Maeswoon/UNHSEDS/Engineering/2020-2021_PHANTOM/Propulsion/Banshee V1/simulation_results.JPG

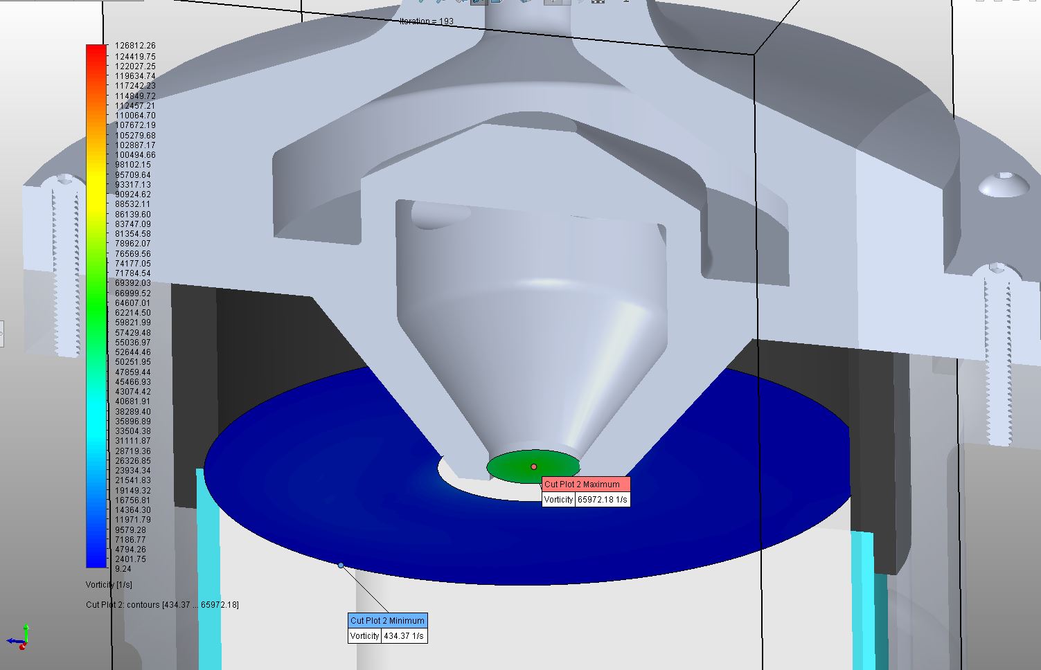
Engineering/2020-2021_PHANTOM/Propulsion/Banshee V1/simulation_results.JPG
