Maeswoon/UNHSEDS/Engineering/2019-2020_USURPER/Avionics/Board Files/Electronics Parts Render-00.JPG

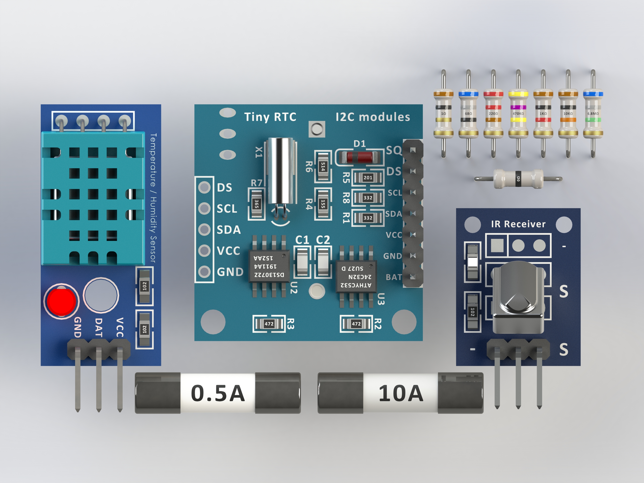
Engineering/2019-2020_USURPER/Avionics/Board Files/Electronics Parts Render-00.JPG
