Maeswoon/UNHSEDS/Engineering/2022-2023 Rocket/Avionics/README.md

# Avionics TODO (version-to-version)

- More robust connectors
- Eliminate buck converter / diagnose ramp-up issue
- Add buzzer
- Ground connection for arming switch
- Reverse-voltage protection on pyros
- Integrated pyro resistors
- Neater PCB layout
