Maeswoon/UNHSEDS/Reports and Presentations/Presentations/2019-2020/Workshops/Welding.pptx

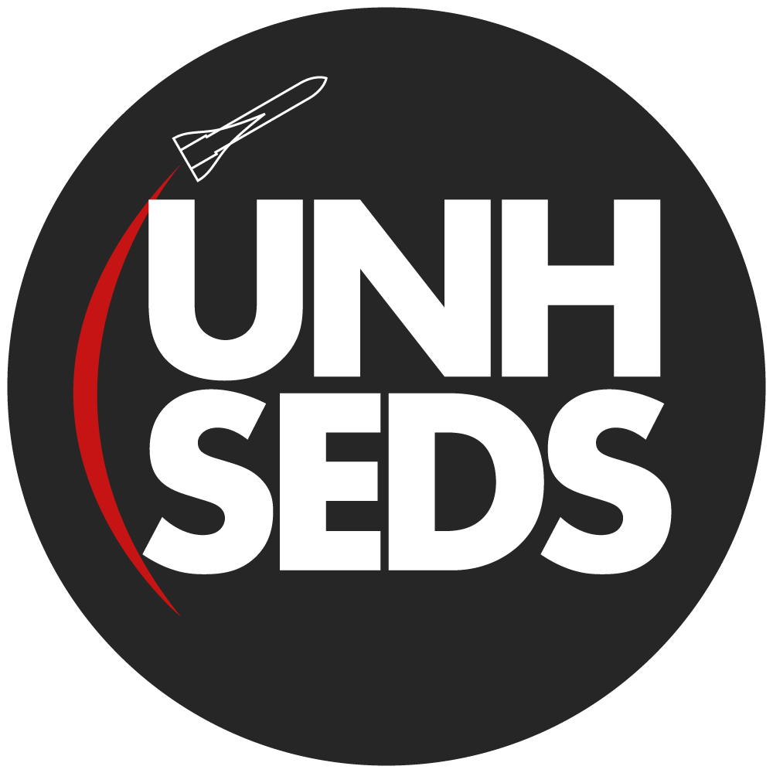
[picture p4: figure]

CEPS Engineering Organization
Welding

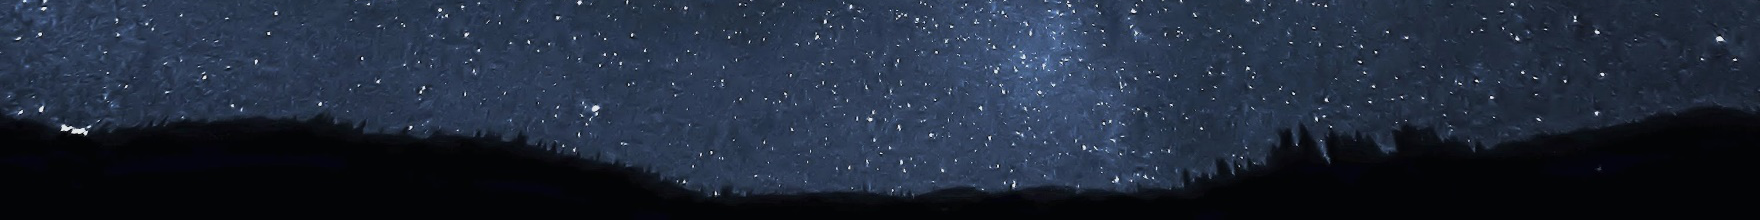
[picture p5: figure]
Image result for starry night background

University of New Hampshire
Students for the Exploration and Development of Space

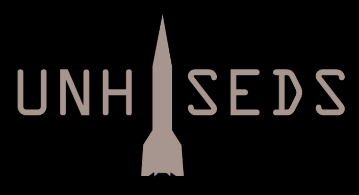
[picture p6: figure]
