Maeswoon/UNHSEDS/Reports and Presentations/Presentations/2019-2020/Intro Meeting/ME 441 Presentation.pptx

## UNH SEDS

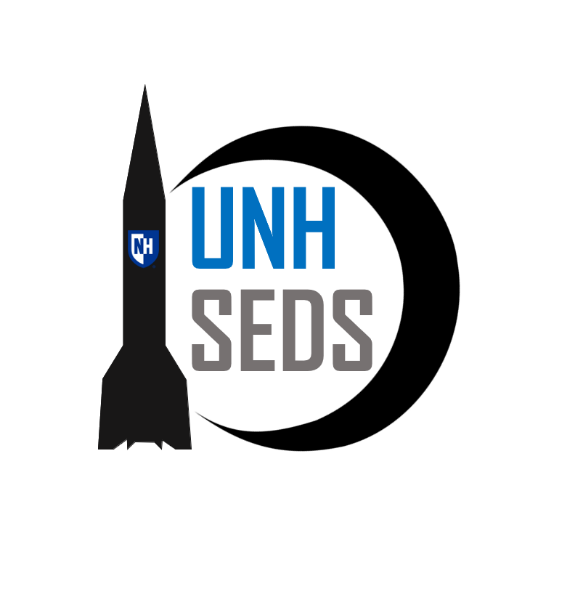
[picture p7: figure]

CEPS Engineering Organization
High Power Rocketry

University of New Hampshire
Students for the Exploration and Development of Space

## Slide 2

The Three Year Plan

Year One
2017-2018

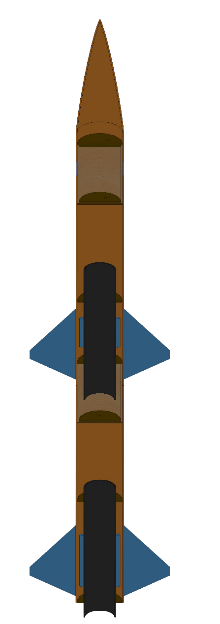
[picture p8: figure]

Hybrid Engine
Design
Manufacture
Test

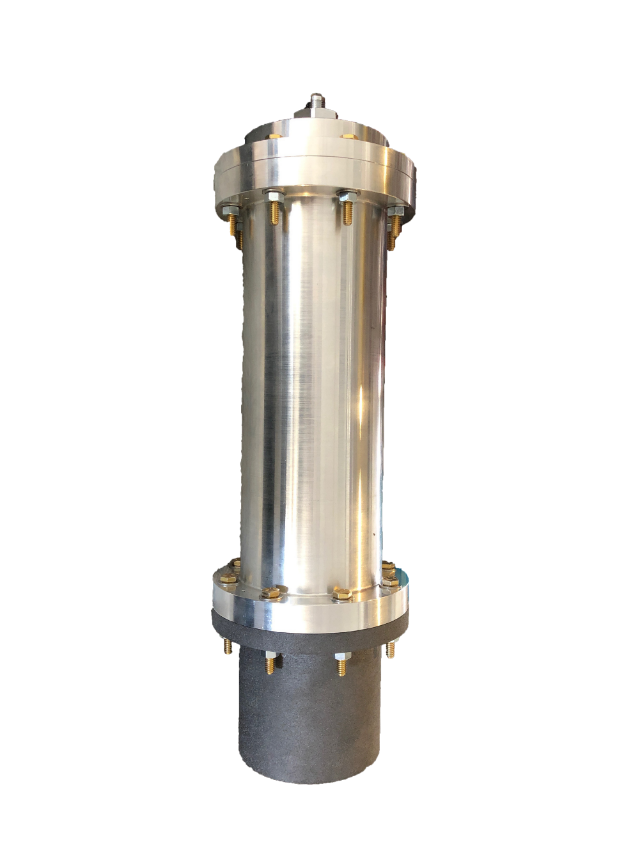
[picture p9: figure]

Runaway

Year Two

Year Three

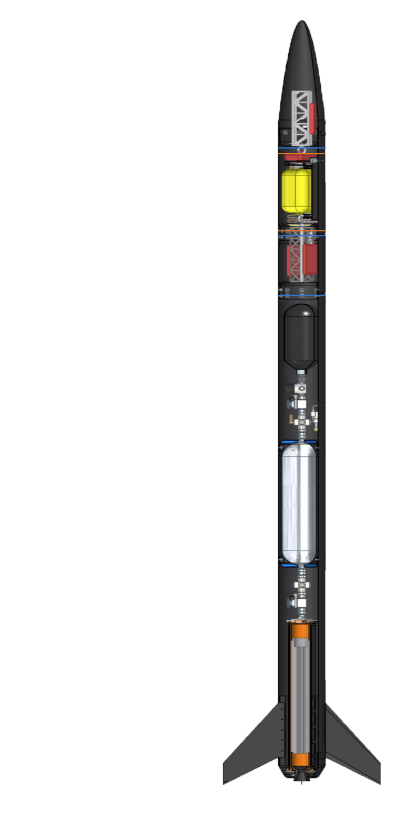
[picture p10: figure]

Rocket Building
Simulating
Launching
Optimizing

Hybrid Rocket
Engine Optimization
Rocket Integration
Competition

University of New Hampshire
Students for the Exploration and Development of Space

## Propulsion Team

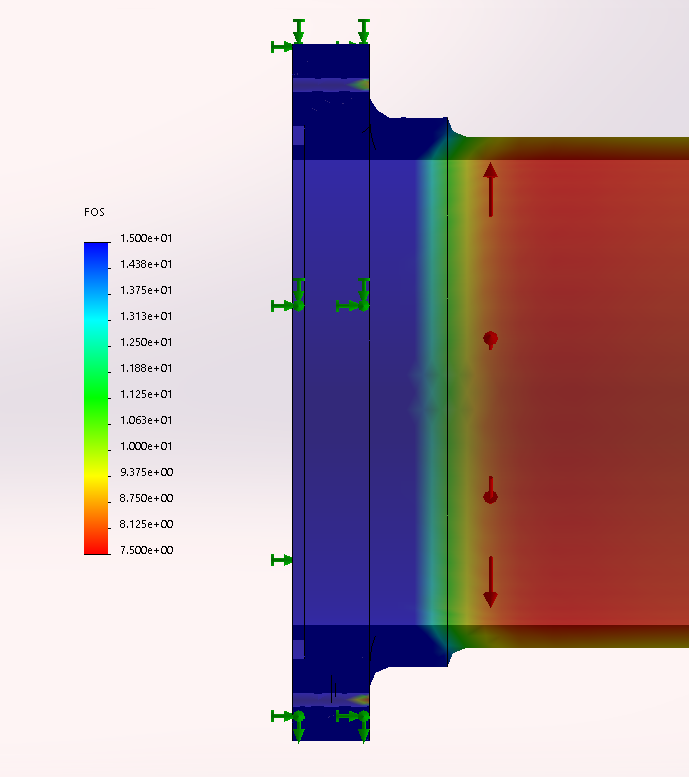
[picture p11: figure]
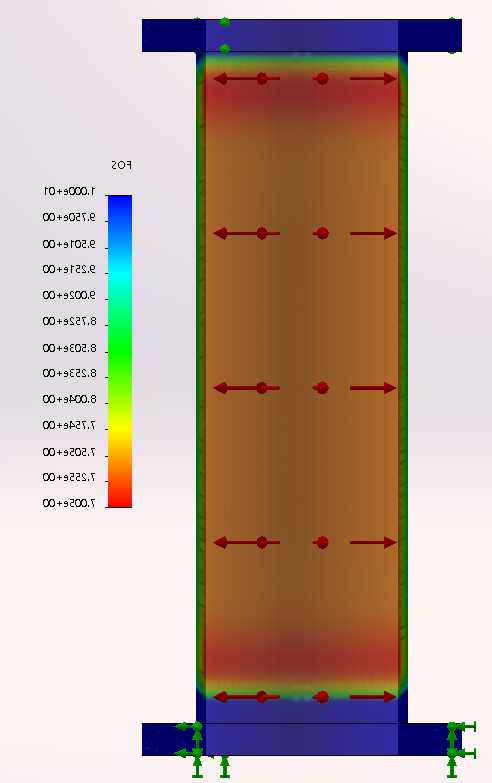
[picture p12: figure]

University of New Hampshire
Students for the Exploration and Development of Space

## Slide 4

Frame Team

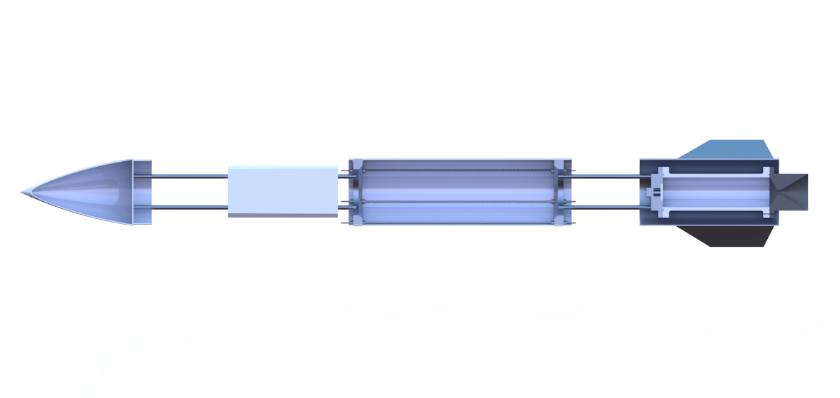
[picture p13: figure]
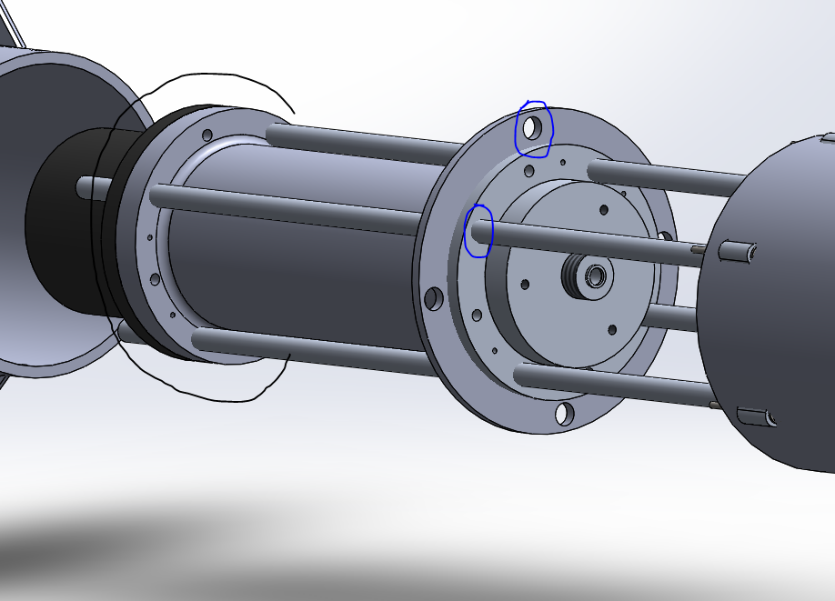
[picture p14: figure]
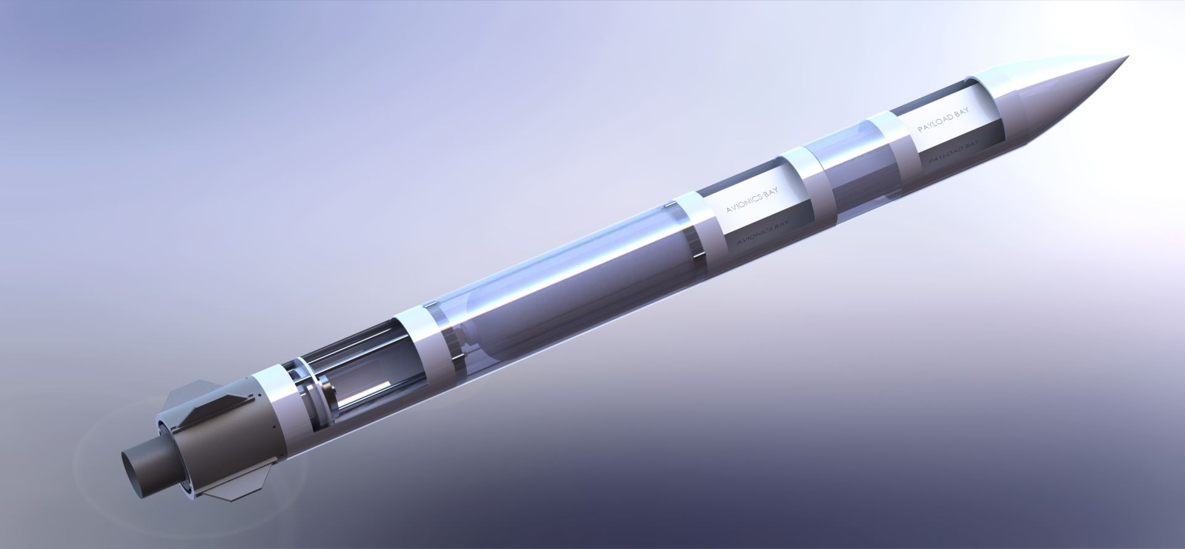
[picture p15: figure]

University of New Hampshire
Students for the Exploration and Development of Space

## Slide 5

Operations Team

- In charge of all Spaceport coordination and requirements
- Engineering integration and systems engineering
- Responsible for coordinating tests
- Safety
- Aid in all engineering-related activities

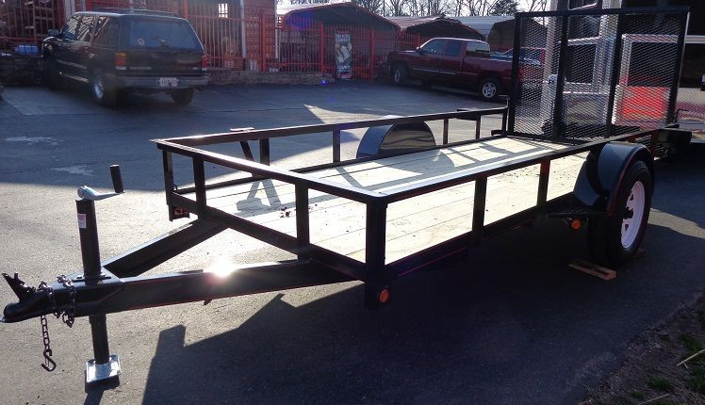
[picture p16: figure]
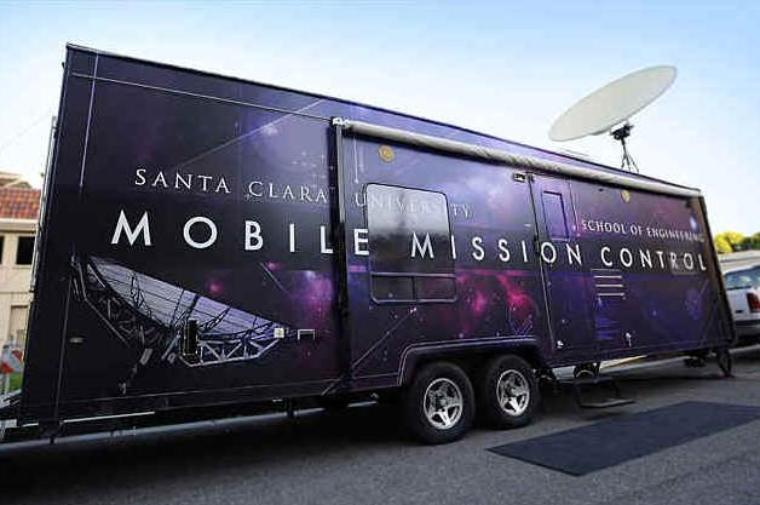
[picture p17: figure]
Image result for mobile mission control

University of New Hampshire
Students for the Exploration and Development of Space

## Slide 6

How Can You Help?

- Looking for students who’d be willing to help with CAD modeling of rocket components in frame, propulsion, and other needs that come up.
- Students interested in learning SolidWorks CAD, FEA, and FlowSimulation
- Integrate into one of our teams, given a modeling project to complete and aid our senior project.
- Good experience to integrate into a team as a freshman.
- If interested, contact me at sgj1001@wildcats.unh.edu (Silas Johnson – Mechanical Engineering Project Manager)

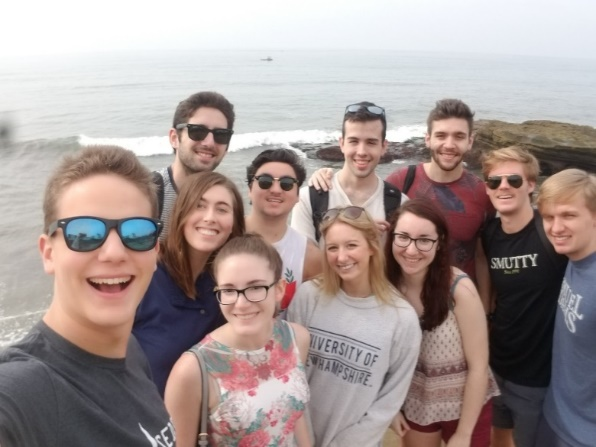
[picture p18: figure]
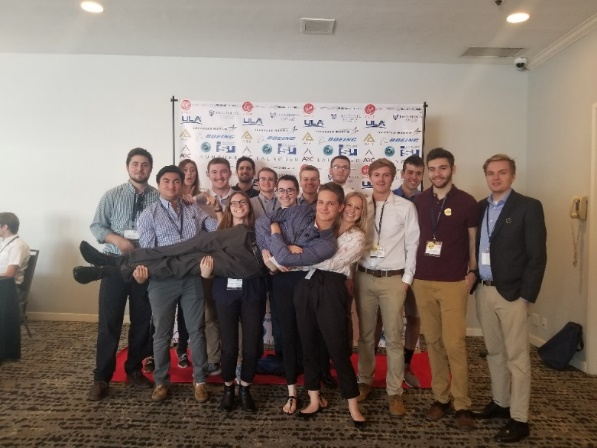
[picture p19: figure]
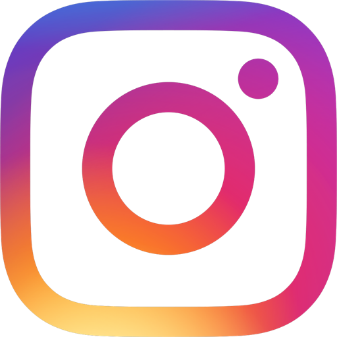
[picture p20: figure]
Image result for instagram

@unhseds

University of New Hampshire
Students for the Exploration and Development of Space

Notes: EE major too
