Maeswoon/UNHSEDS/Business/Organization/Book Club/Book Club Schedule.docx

UNH SEDS Book Club – Spring 2020

# Books to Read

1. Rocket Manual for Amateurs, 1960
2. Handbook of Model Rocketry, 1965
3. Make: High-Power Rockets, 2017

# Rocket Manual for Amateurs

Including 10 chapters, this book will take 5 weeks to read. The breakdown of chapters each week to read and be analyzed is below.

1. Chapters 1 and 2
2. Chapters 3 and 4
3. Chapters 5 and 6
4. Chapters 7 and 8
5. Chapters 9 and 10

The meeting for each week will be around 1 hour and discuss the pages thoroughly. It is expected to take notes on the pages in order to contribute to the club discussion, as it is not supposed to be a lecture.
