Maeswoon/UNHSEDS/Engineering/2019-2020_USURPER/Engineering Management/Engineer of the Week/Engineers Spring 2020.pptx

UNH SEDS

The Hungriest Engineers

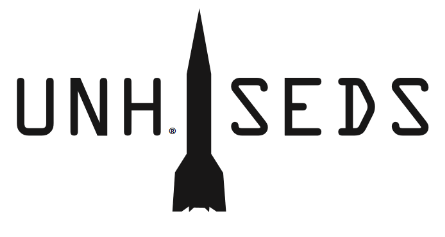
[picture p27: figure]
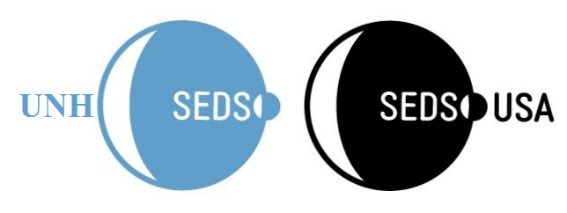
[picture p28: figure]

Spring 2020 [February]

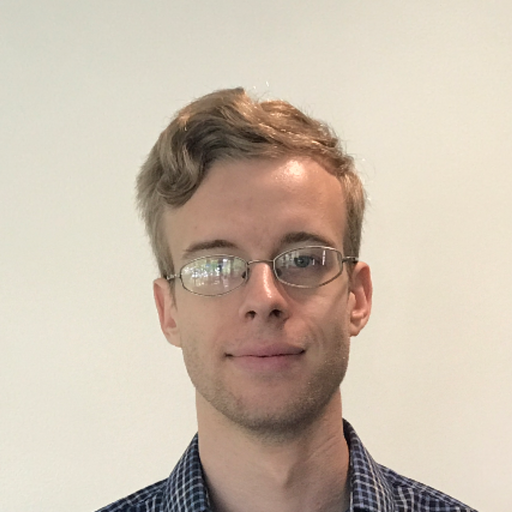
[picture p29: figure]
Profile photo for Cornelis

Cornelis Plomp

As part of the Frame team, Cornelis has done incredible and thorough work on the rocket frame. Ensuring that each of his parts is tested and proven through calculations and SOLIDWORK FEA.

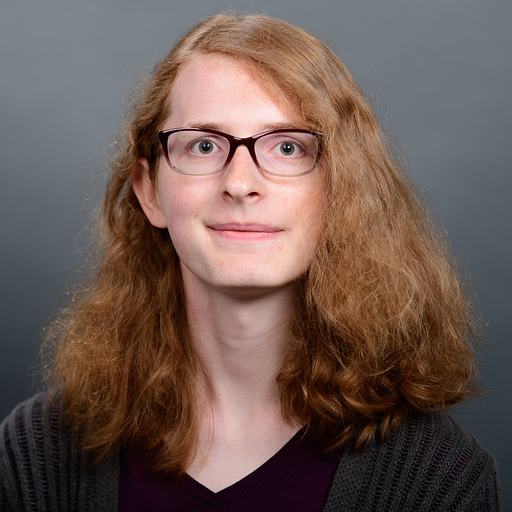
[picture p30: figure]
Profile photo for Alice Wade

Alice Wade

Alice has been a superstar since the first day that she joined SEDS. Her dedication to Frame, Finance, and the organization has been outstanding. Check out our amazing website https://unhseds.org/ curtesy of this hungry engineer!

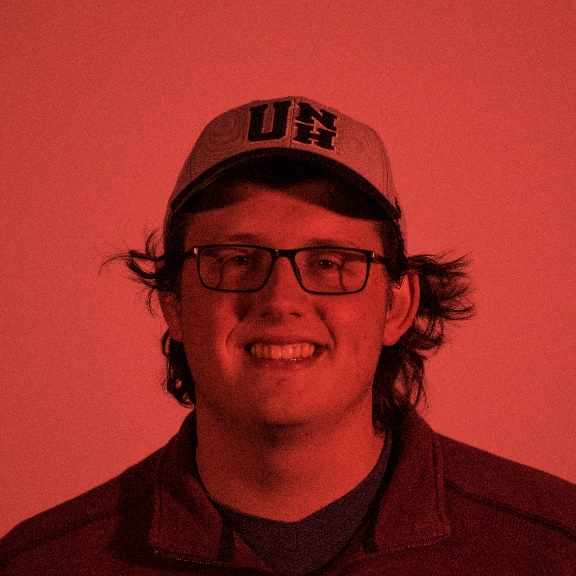
[picture p31: figure]

Jacob Harrison

As part of the Avionics team, Jacob has worked like crazy to put together our launch and control box. Writing code and testing, Jacob has been key to the first cold fire test and all our Raspberry pi projects.
