Maeswoon/UNHSEDS/Business/Organization/Official Documents/UNH SEDS/Internal Leadership Documents/Engineering Leadership/2019-2020/Engineering Leadership.pptx

## Engineering goals 2019-2020

An optimized and certified Hybrid Rocket Engine

UNH SEDS

A test-proven rocket engine gimbal system (2 year plan)

A seamless propulsion assembly with autonomous, real-time control (2021)

A well-designed and safe testing site for all operations

New Hampshire’s first Hybrid Rocket

An optimized, beautifully integrated tested rocket frame

A beautiful, yet amazingly complex flight computer system

A complete navigation, control and recovery rocket electrical system

A ROBUST payload ejection and flight recovery system

Propulsion

Frame

Avionics

Operations

## Engineering SECTION GOALS 2019-2020 Senior Design

Charlie Nitschelm

Lead Engineer

UNH SEDS

Zach Raboin

VP Propulsion

Thomas Collins

VP Frame

1. Work with every engineering team to design the best rocket frame and internal structures needed for flight including the propulsion, avionics, recovery and payload modules.
2. Manufacture the components with a well-thought out integration system for all systems with live debugging on the field ability.

Lucas Simmonds

VP Avionics

Silas Johnson

VP Operations

1. Communicate with all teams above to design, manufacture and build test equipment, procedures and plans for all testing being done.
2. Lead the project to secure an area for SEDS to base all testing on, including the development of the mobile mission control bunker.
3. Lead major sub-projects as they arise.

1. Develop, test and optimize a working Hybrid Rocket Engine, Runaway.
  a. Manufacture, test and optimize and repeat
2. Develop and test a small-scale thrust vectoring system with COTS engines
  a. Flight test with a stable rocket, unstable rocket, and a quadcopter drop test mid-air, and landing attempts.
  b. Develop, manufacture and test a hybrid gimbal system to integrate with Runaway (2 year program)

1. Develop the electrical system to power the navigation and control of the rocket.
  a. Will work closely with the gimbal project
2. Ensure that the rocket has optimum performance during testing and launch (pulling one ‘Remove Before Flight’ and turning all systems on in the rocket.
3. Design, build and test a payload to conduct scientific research (this is totally open)
4. Create a full-proof recovery system for apogee for the payload deployment and main rocket recovery.

Propulsion

Frame

Avionics

Operations

## Engineering roles 2019-2020 Senior Design 7 ME, 4 EE, 2 CS, 1 PE

Charlie Nitschelm

Lead Engineer, ME

UNH SEDS

Zach Raboin

VP Propulsion, ME

Thomas Collins

VP Frame, PE

Lucas Simmonds

VP Avionics, ME

Silas Johnson

VP Operations, ME

Andrew Masters

TVC Lead, ME, Not SP

Charlie Nitschelm

ME

Darren Otten

ME

Ben Letourneau

EE

Francesco Mikulis

CS

Silas Johnson

ME

Nathan Gunter

ME

Tom Pham

EE

Kristian Comer

CS

Megan Johnson

EE

Trevor Blampied

EE

Carly Benik

ME

Propulsion

Frame

Avionics

Operations

## Engineering roles 2019-2020

Charlie Nitschelm

Lead Engineer, ME

UNH SEDS

Charlie Nitschelm

VP Propulsion, Sr ME

Thomas Collins

VP Frame, Sr PE

Lucas Simmonds

VP Avionics, Sr ME

Silas Johnson

VP Operations, Sr ME

Andrew Masters

TVC Lead, Sr ME

Zach Raboin

Senior ME

Darren Otten

Senior ME

Ben Letourneau

Senior EE

Carly Benik

Senior ME

Francesco Mikulis

Senior CS

Ross Thyne

Senior ME

Nathan Gunter

Senior ME

Tom Pham

Senior EE

Jeffrey Grant

Freshman ME

Kristian Comer

Senior CS

Grace Johnston

Junior ME

Sohani Demian

Junior ME

Megan Johnson

Senior EE

Gabe Hannon

Freshman Math

Jake Raum

Freshman CS

Devony Whiting

Junior ME

Alice Wade

Freshman ME

Trevor Blampied

Senior EE

Hunter Sansoucie

Freshman ME

Jared Larivere

Freshman ME

Derek Goulet

Sophomore ME

Max Carpenter

Freshman ME

Matt Dodge

Junior EE

Emilie Leavitt

Freshman CE

Jessica Roberts

Freshman Physics

Elena Chan

Freshman ME

Will Macdonald

Freshman ME

Dylan Parmentier

Freshman PE

Grant Arnold

Freshman ME

Philip Deo

Freshman EE

Ian Bresnahan

Freshman Math/Chem

Coleman Stoleburg

Freshman EE
