Maeswoon/UNHSEDS/Reports and Presentations/Presentations/2019-2020/SpaceVision Presentation/SpaceVision_Journey_to_Spaceport_America.pdf

# Year 1 – 2017/2018

# Year 2 – 2018/2019

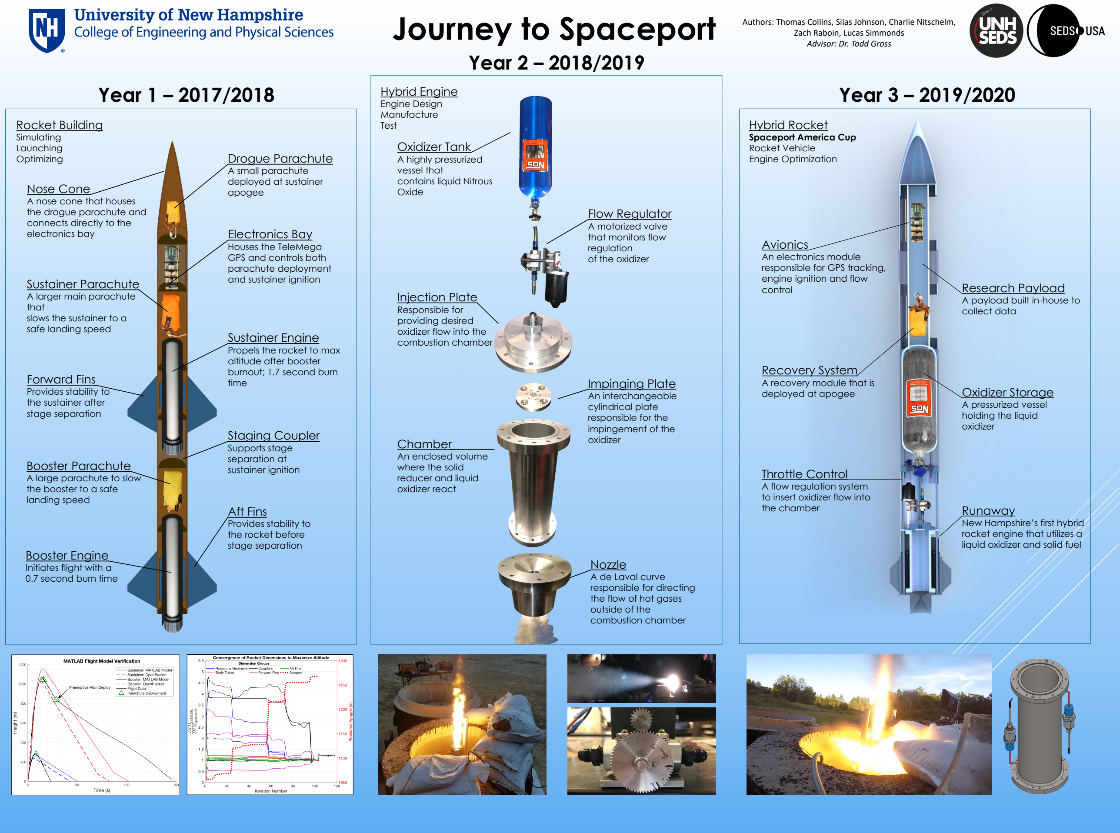
[picture p62: page 1]

Authors: Thomas Collins, Silas Johnson, Charlie Nitschelm, Zach Raboin, Lucas Simmonds Advisor: Dr. Todd Gross

# Year 3 – 2019/2020

# Journey to Spaceport

### Rocket Building

Simulating
Launching
Optimizing

### Hybrid Engine

Engine Design
Manufacture
Test | Hybrid Rocket
| Spaceport America Cup
| Rocket Vehicle
| Engine Optimization

### Oxidizer Tank

A highly pressurized
vessel that
contains liquid Nitrous
Oxide

### Flow Regulator

A motorized valve
that monitors flow
regulation
of the oxidizer

### Injection Plate

Responsible for
providing desired
oxidizer flow into the
combustion chamber

### Chamber

An enclosed volume
where the solid
reducer and liquid
oxidizer react

### Nozzle

A de Laval curve
responsible for directing
the flow of hot gases
outside of the
combustion chamber

### Impinging Plate

An interchangeable
cylindrical plate
responsible for the
impingement of the
oxidizer

### Avionics

An electronics module
responsible for GPS tracking, engine ignition and flow
control

### Recovery System

A recovery module that is
deployed at apogee

### Research Payload

A payload built in-house to collect data

### Throttle Control

A flow regulation system
to insert oxidizer flow into
the chamber | Runaway
| New Hampshire’s first hybrid
| rocket engine that utilizes a
| liquid oxidizer and solid fuel

### Oxidizer Storage

A pressurized vessel
holding the liquid
oxidizer

### Staging Coupler

Supports stage
separation at
sustainer ignition

### Booster Engine

Initiates flight with a
0.7 second burn time

### Drogue Parachute

A small parachute
deployed at sustainer
apogee

### Aft Fins

Provides stability to
the rocket before
stage separation

### Electronics Bay

Houses the TeleMega
GPS and controls both
parachute deployment
and sustainer ignition

### Sustainer Engine

Propels the rocket to max
altitude after booster
burnout; 1.7 second burn
time

### Booster Parachute

A large parachute to slow
the booster to a safe
landing speed

### Forward Fins

Provides stability to
the sustainer after
stage separation

### Sustainer Parachute

A larger main parachute
that
slows the sustainer to a
safe landing speed

### Nose Cone

A nose cone that houses
the drogue parachute and
connects directly to the
electronics bay
