Maeswoon/UNHSEDS/Engineering/2019-2020_USURPER/Payload_Recovery/Parachutes.pdf

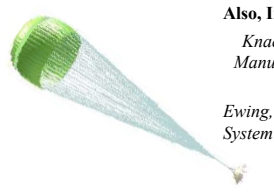
[picture p63: figure]

MAE 5930, Rocket Systems Design

# Recovery Systems: Parachutes 101

## Material taken from: Parachutes for Planetary Entry Systems Juan R. Cruz Exploration Systems Engineering Branch NASA Langley Research Center

Also, Images from:
Knacke, T. W.: Parachute Recovery Systems Design Manual, Para Publishing, Santa Barbara, CA, 1992. and
Ewing, E. G., Bixby, H.W., and Knacke, T.W.: Recovery System Design Guide, AFFDL-TR-78-151, 1978.

1

## Basic Terminology

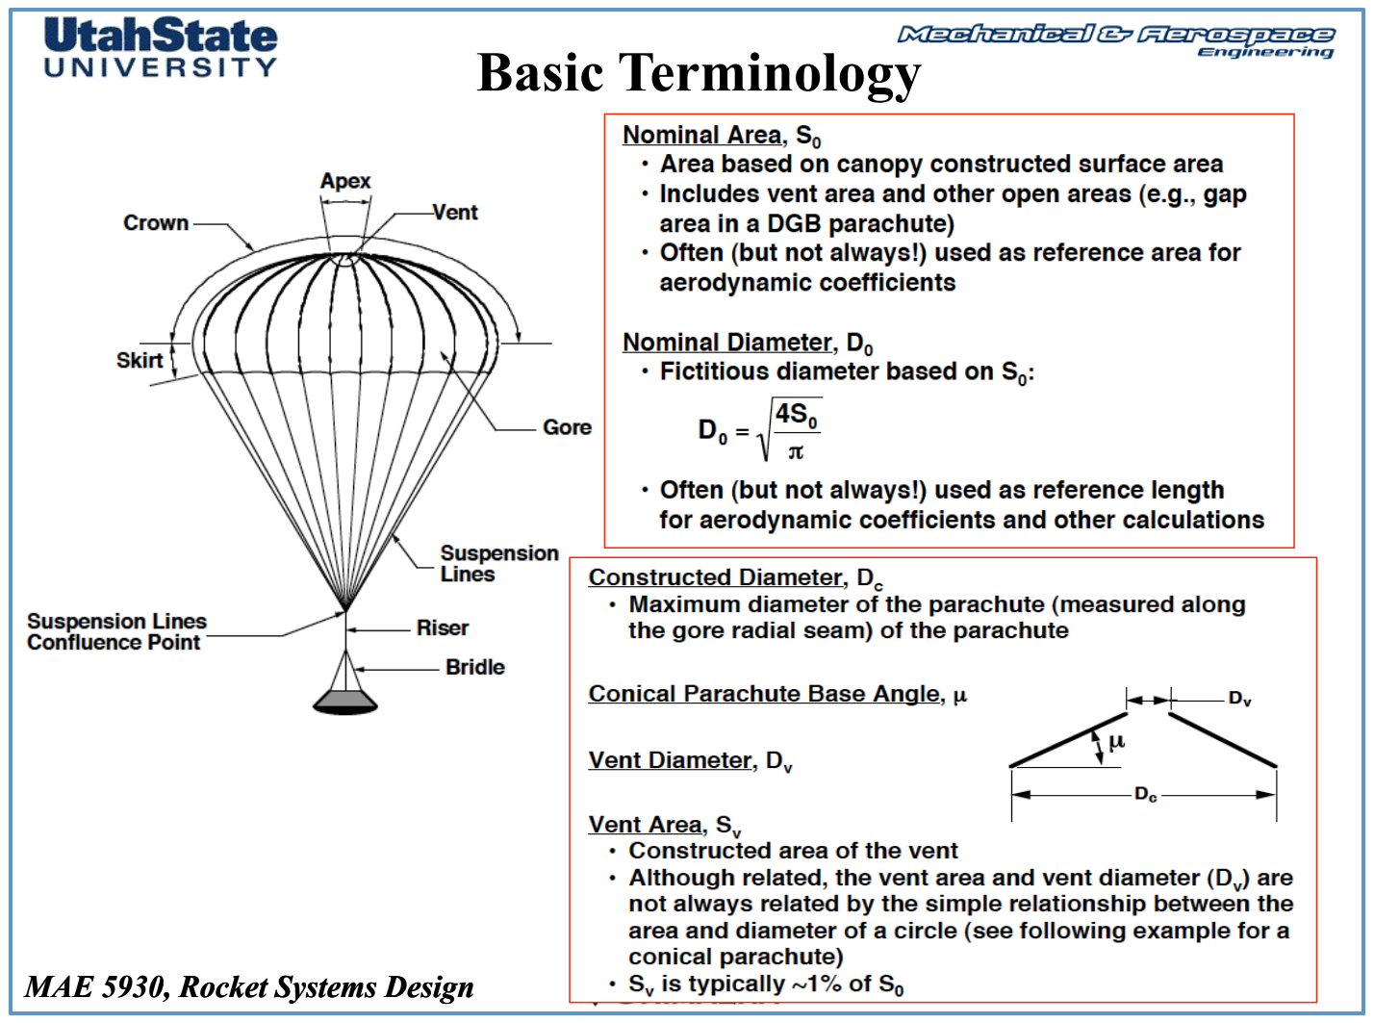
[picture p64: page 2]

MAE 5930, Rocket Systems Design | 2

## Basic Terminology (2)

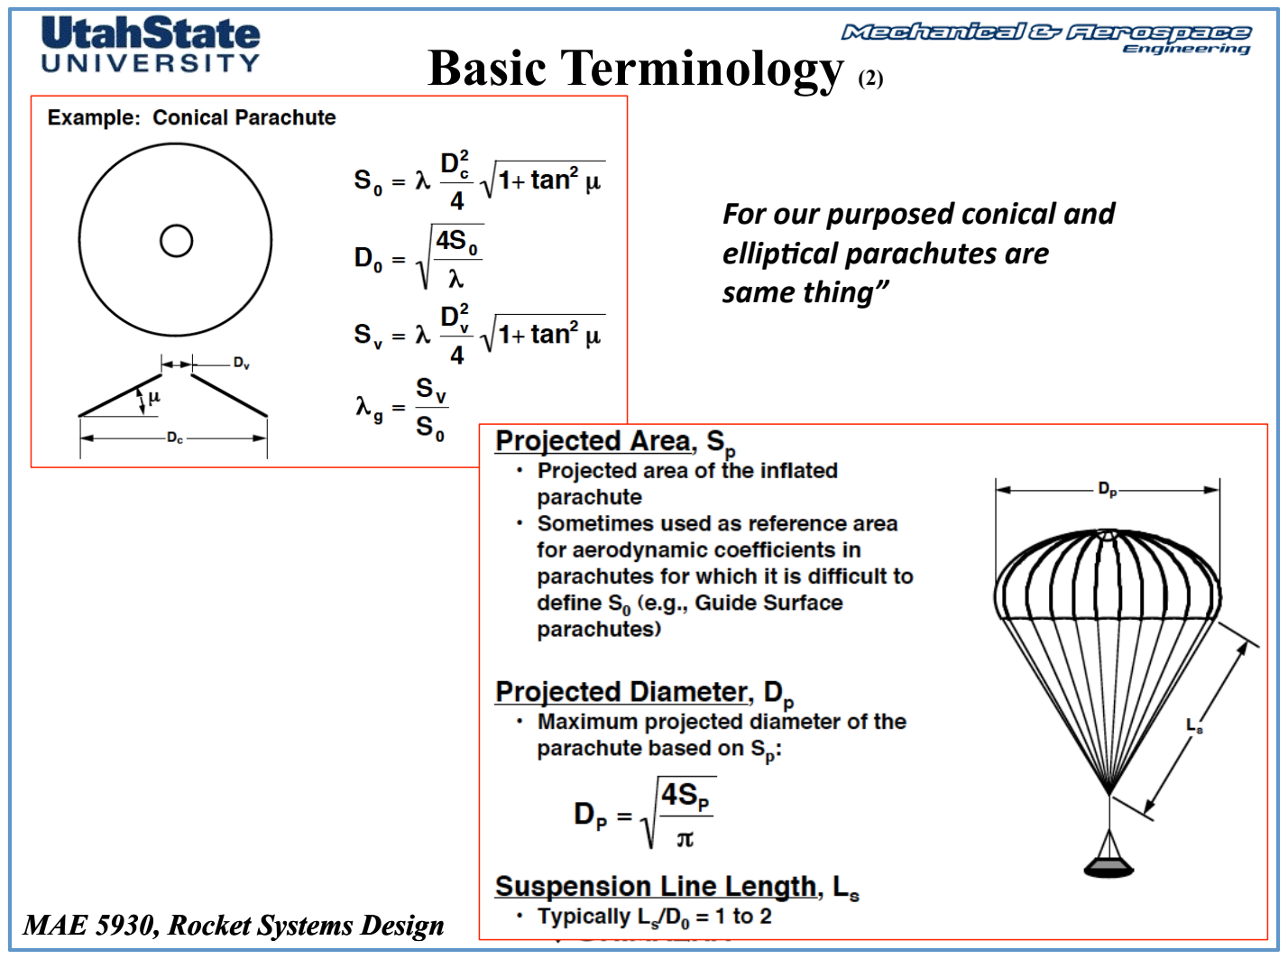
[picture p65: page 3]

MAE 5930, Rocket Systems Design | 3

For

our

purposed

conical

and
ellip/cal

parachutes

are
same

thing”

## Basic Terminology (3)

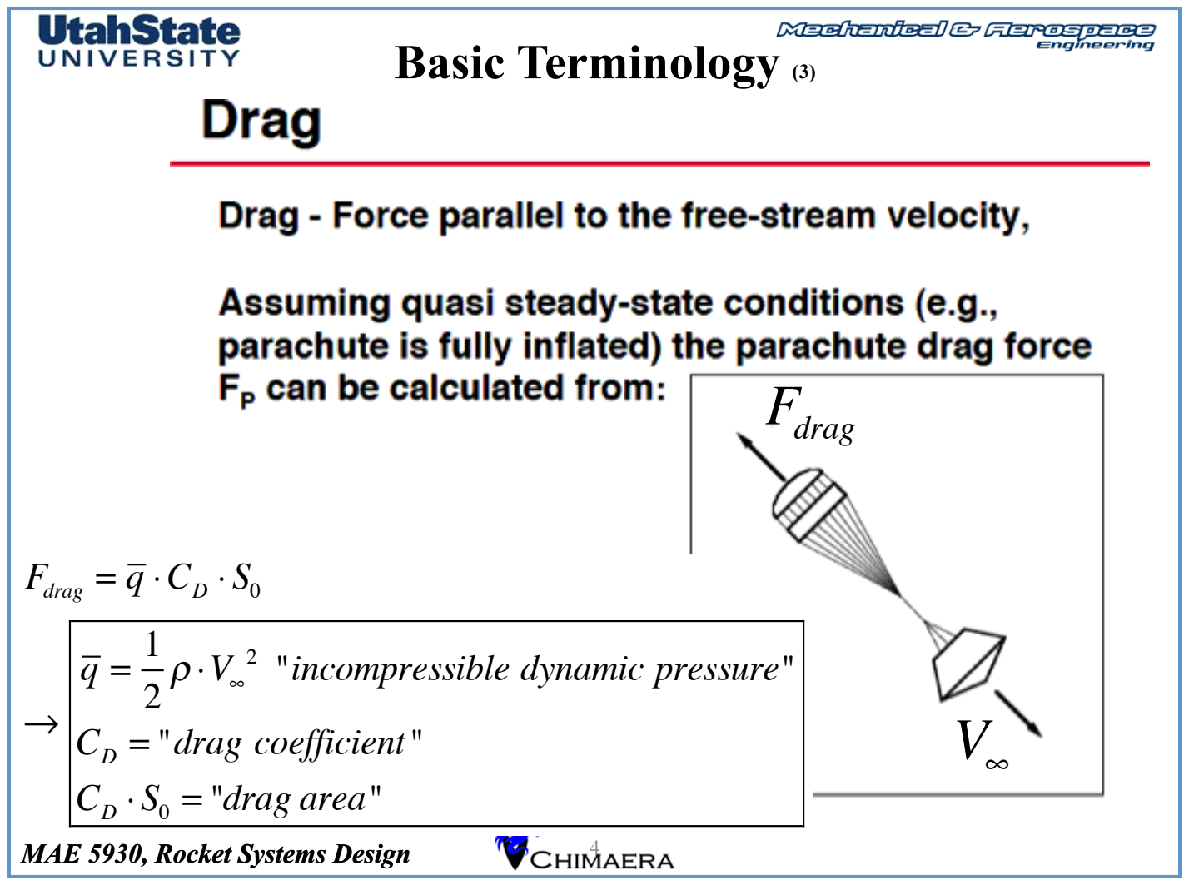
[picture p66: page 4]

MAE 5930, Rocket Systems Design | 4

Fdrag

## = q !CD ! S0

"

q =

1
2

# !V$

2 "incompressible dynamic pressure"

CD

= "drag coefficient "
CD ! S0

= "drag area"

Fdrag

V!

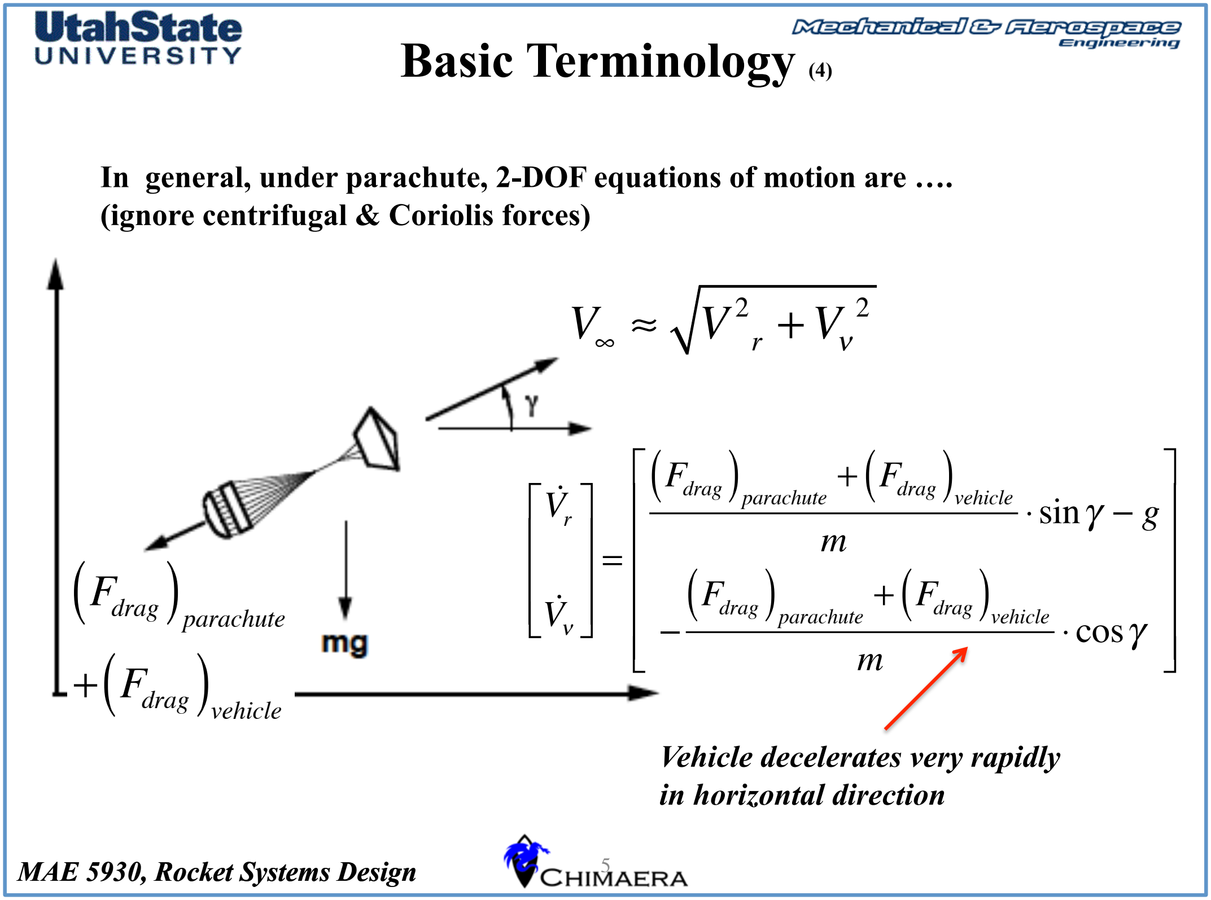
[picture p67: figure]
MAE 5930, Rocket Systems Design; Basic Terminology (4); (ignore centrifugal & Coriolis forces); (Fdrag ) parachute; +(Fdrag )vehicle; + (Fdrag )vehicle; (sin) * g; ( cos); Vehicle decelerates very rapidly in horizontal direction

In general, under parachute, 2-DOF equations of motion are ….

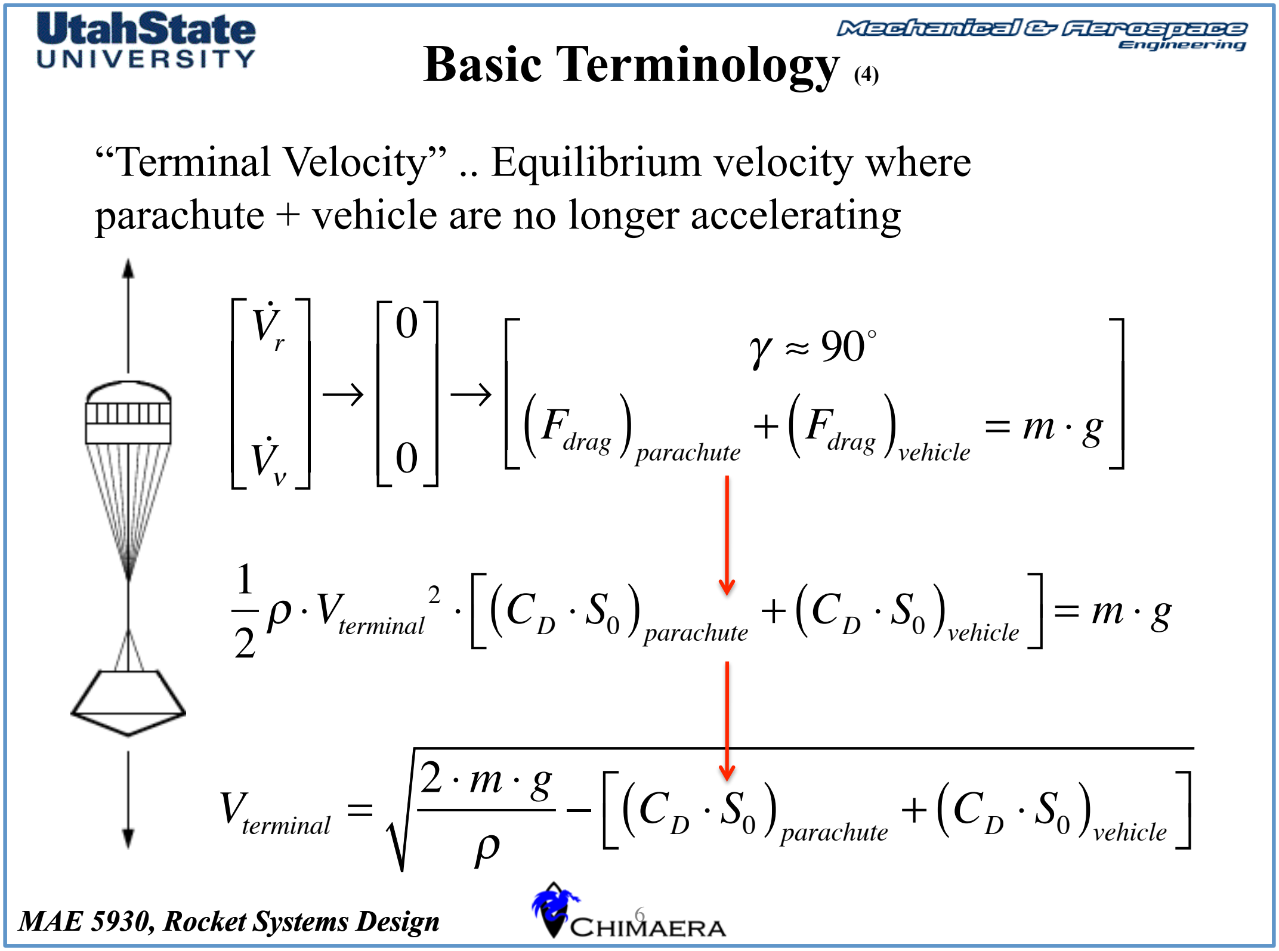
[picture p68: figure]
MAE 5930, Rocket Systems Design; Basic Terminology (4); (Fdrag ) parachute; + (Fdrag )vehicle; ! "Vterminal; 2 " CD ( " S0 ) parachute; + CD ( " S0 )vehicle; Vterminal =; 0 ) parachute; 0 )vehicle

## “Terminal Velocity” .. Equilibrium velocity where parachute + vehicle are no longer accelerating

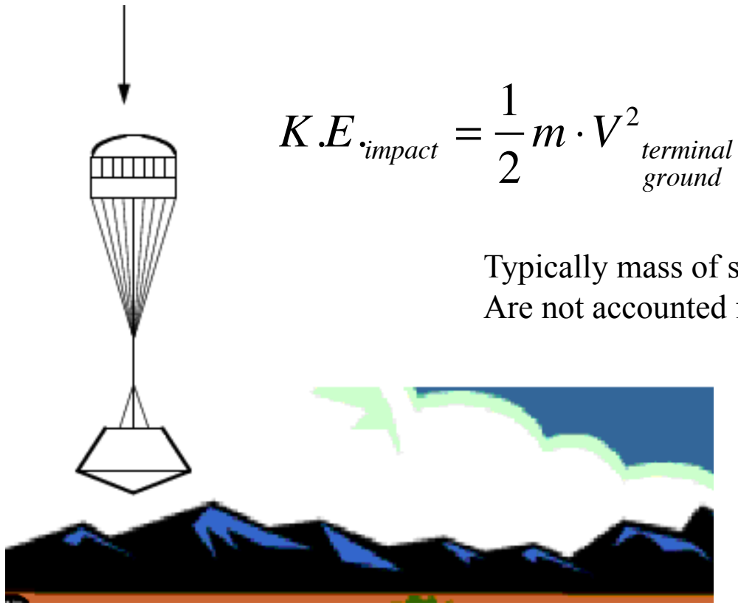
[picture p69: figure]
K.E. impact; terminal ground

MAE 5930, Rocket Systems Design | 7

## Basic Terminology (5)

## “Impact Energy” .Kinetic Energy of “hard object” striking ground

Typically mass of soft items like canopy Are not accounted for in impact energy

# Parachute Types

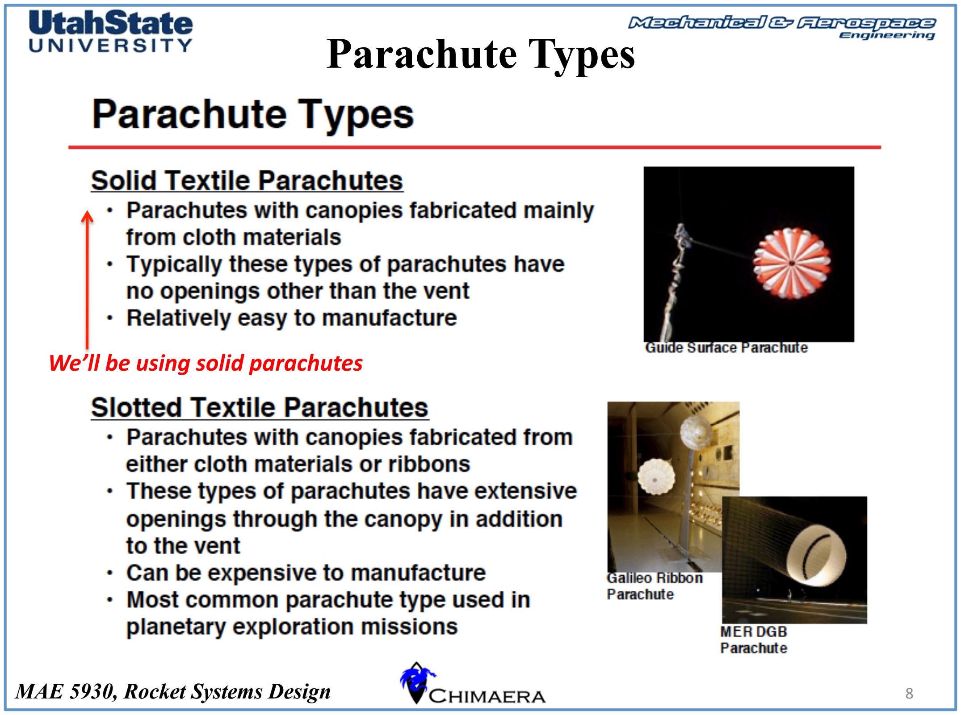
[picture p70: page 8]

MAE 5930, Rocket Systems Design
8

We’ll

be

using

solid

parachutes

# Parachute Shapes

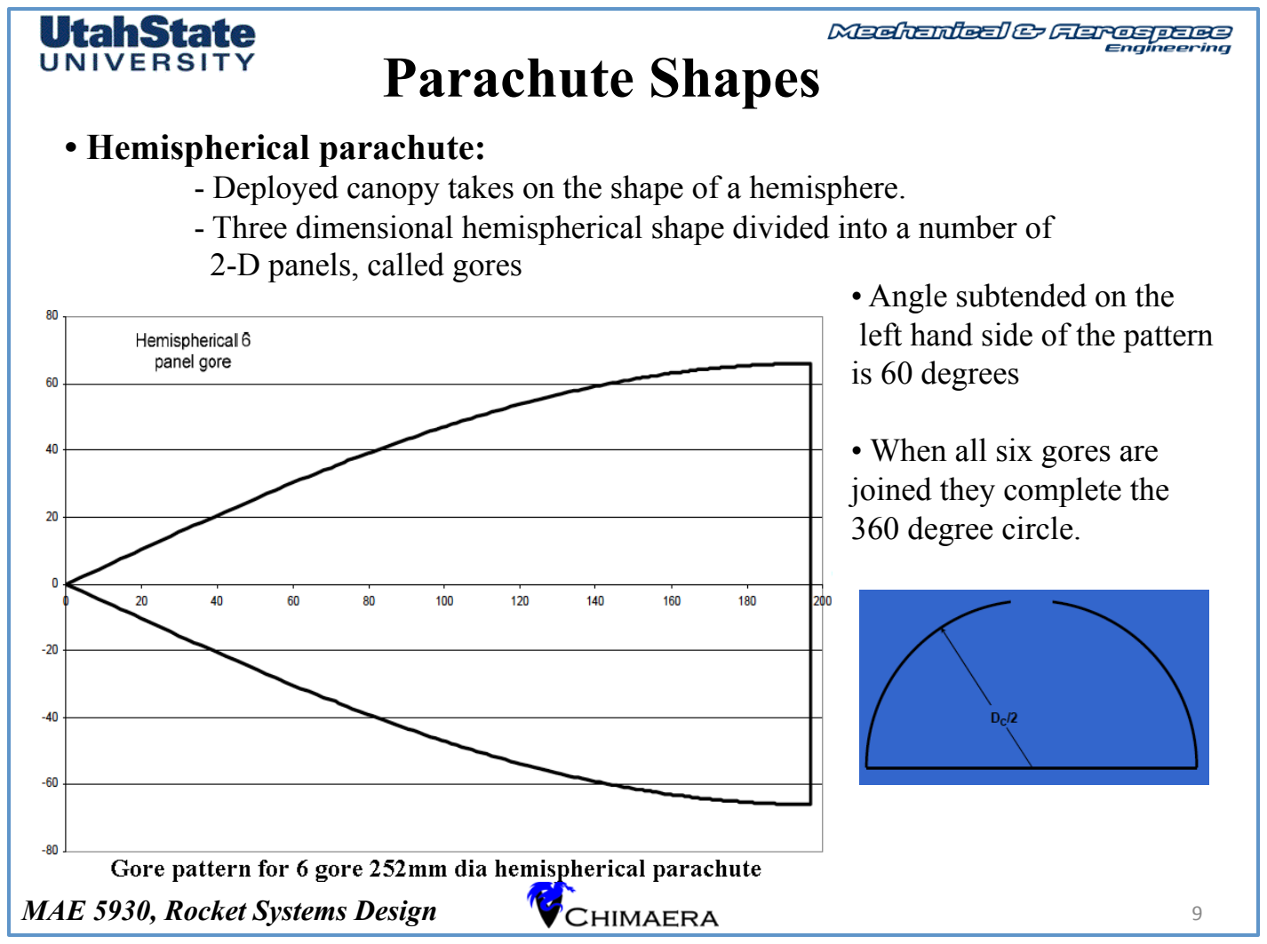
[picture p71: page 9]

MAE 5930, Rocket Systems Design
9
- Hemispherical parachute:
- Deployed canopy takes on the shape of a hemisphere.
- Three dimensional hemispherical shape divided into a number of 2-D panels, called gores
- Angle subtended on the
left hand side of the pattern is 60 degrees
- When all six gores are
joined they complete the
360 degree circle.

# Parachute Shapes (2)

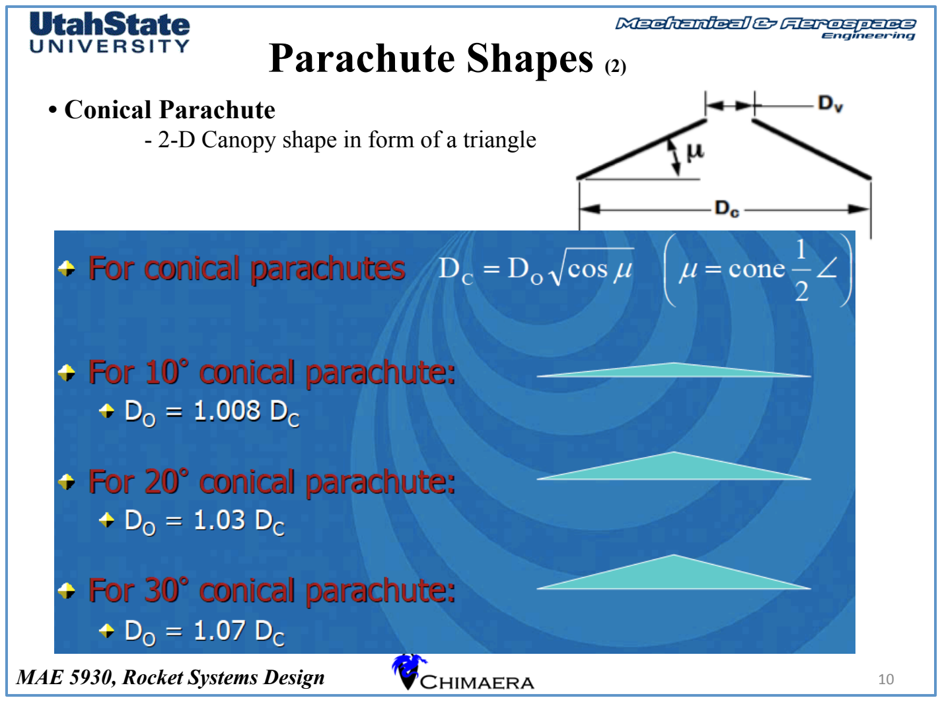
[picture p72: page 10]

MAE 5930, Rocket Systems Design
10
- Conical Parachute
- 2-D Canopy shape in form of a triangle

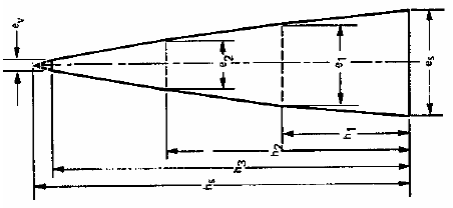
[picture p73: figure]

MAE 5930, Rocket Systems Design

# Parachute Shapes (3)

11

- Conical Parachute Gore Shape
- 2-D Canopy shape in form of a triangle
- Higher drag coefficient than hemispherical parachutes, but also less stability

# Parachute Shapes (4)

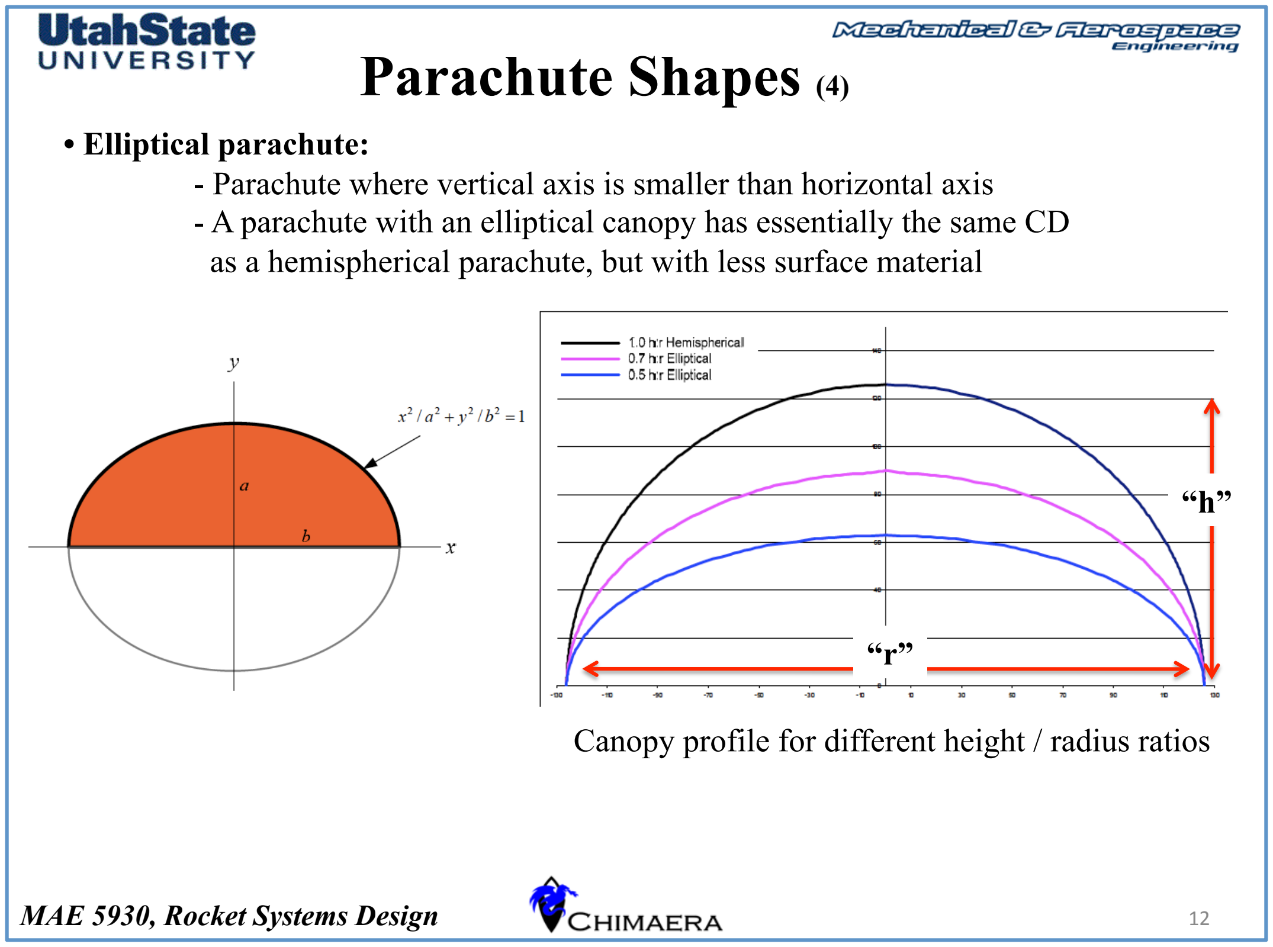
[picture p74: page 12]

MAE 5930, Rocket Systems Design
12
- Elliptical parachute:
- Parachute where vertical axis is smaller than horizontal axis
- A parachute with an elliptical canopy has essentially the same CD as a hemispherical parachute, but with less surface material

Canopy profile for different height / radius ratios

“r”

“h”

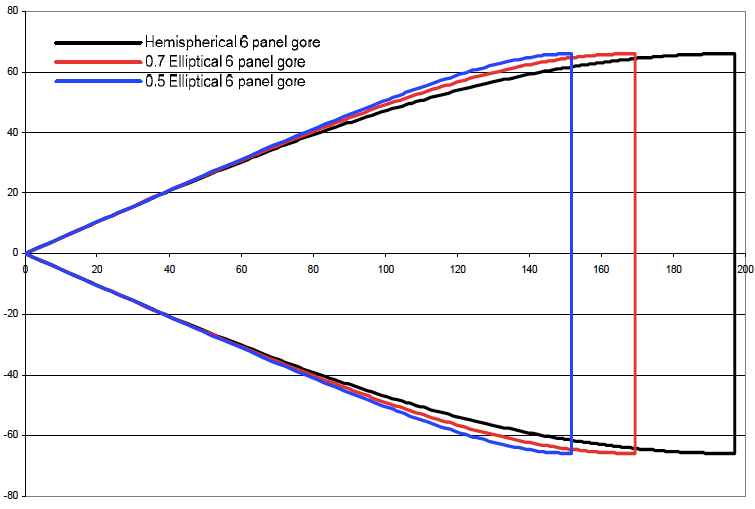
[picture p75: figure]

MAE 5930, Rocket Systems Design

# Parachute Shapes (5)

13

Comparison of gore shapes for different height : radius ratios

# Parachute Types (2)

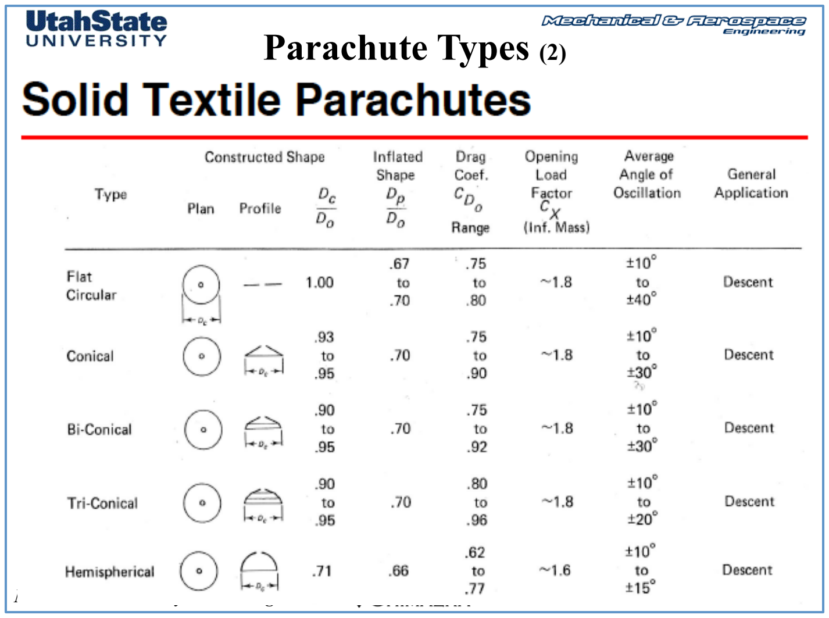
[picture p76: page 14]

MAE 5930, Rocket Systems Design
14

# Parachute Types (3)

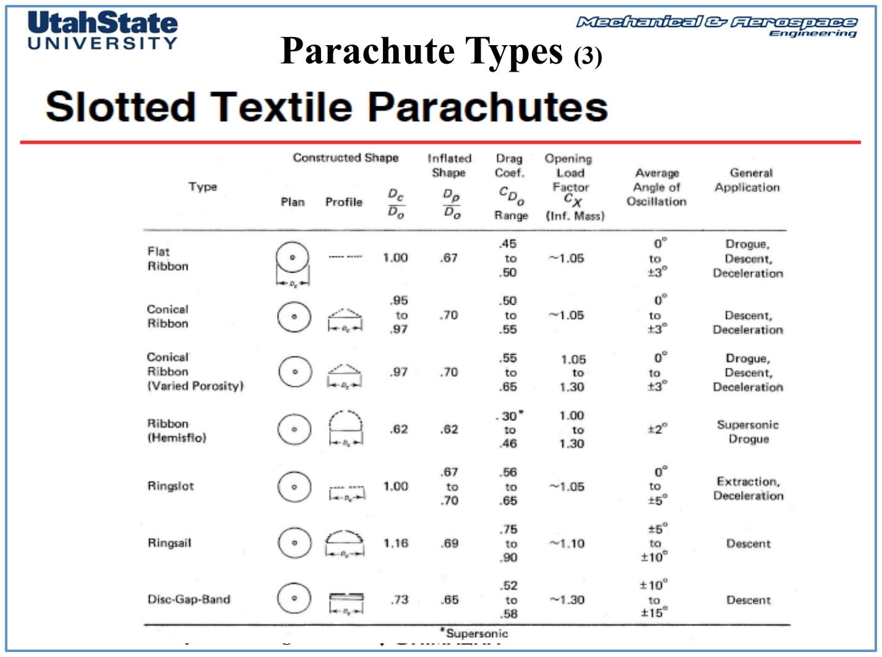
[picture p77: page 15]

MAE 5930, Rocket Systems Design
15

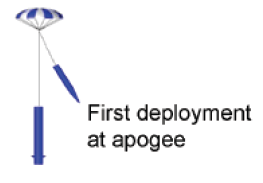
[picture p78: figure]

MAE 5930, Rocket Systems Design

# Example Calculation: Drogue Chute Terminal Velocity

16

hapogee

= hagl + hlaunch

site

=

(1609.23 + 240)meters
!! 1850meters

!apogee

= 1.0218 kg

m³

g =

µ
r

2

=

3.9860044 " 10⁵
km³
sec²
(6371+ 1.85)
2
km

2

= 9.815 m

sec²

Maximum mass at apogee : mapogee

= mlaunch ! mfuel = (14.188 ! 1.76) = 12.428kg

mapogee " g = 12.428 " 9.815 = 121.975Nt

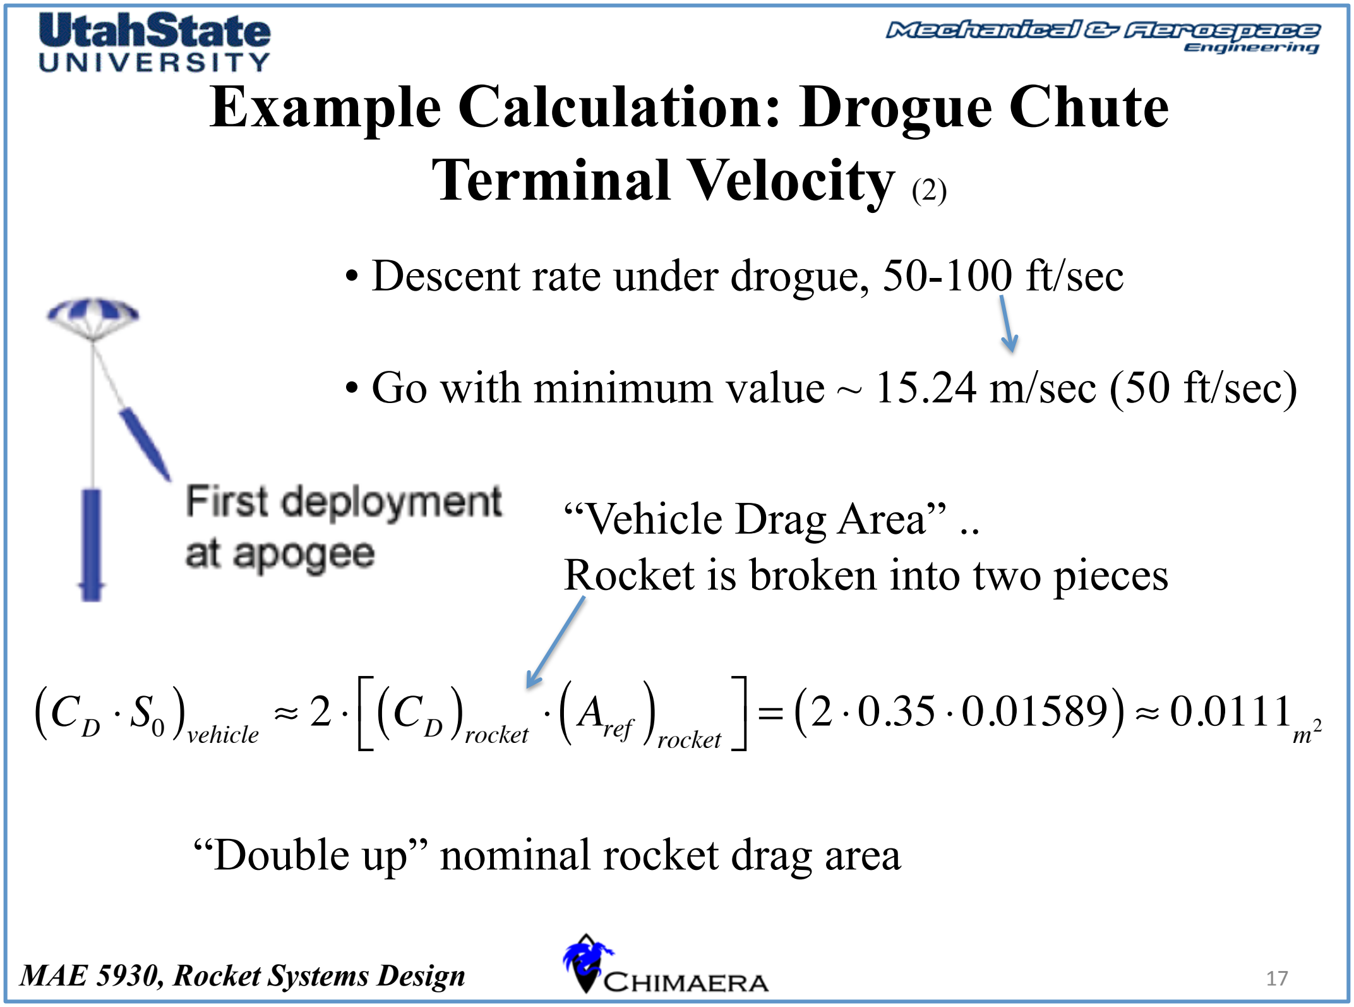
[picture p79: figure]
MAE 5930, Rocket Systems Design; Example Calculation: Drogue Chute Terminal Velocity (2); “Vehicle Drag Area” .. Rocket is broken into two pieces; CD ( ! S0 )vehicle; " 2 ! (CD )rocket !(Aref )rocket #; “Double up” nominal rocket drag area

## - Descent rate under drogue, 50-100 ft/sec

## - Go with minimum value ~ 15.24 m/sec (50 ft/sec)

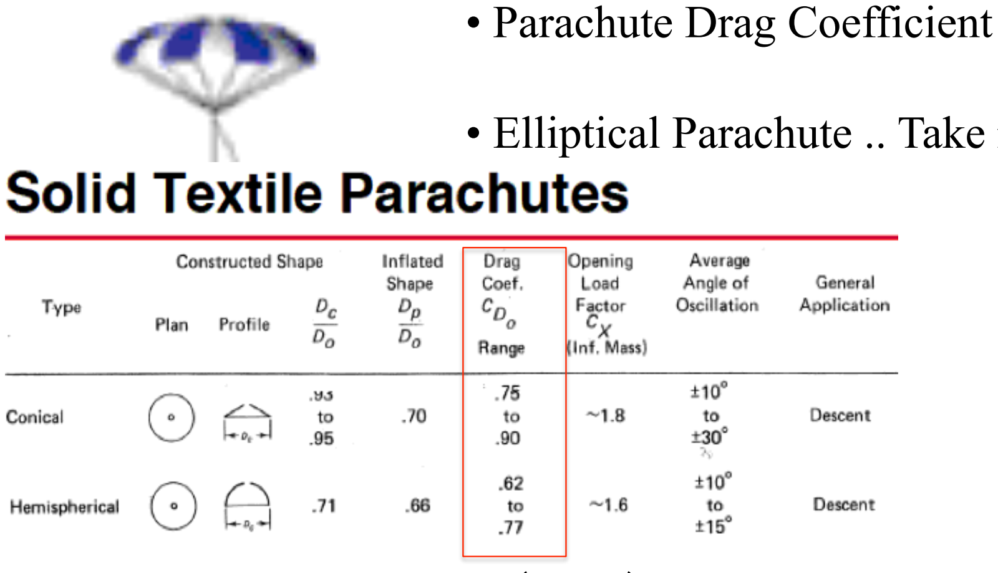
[picture p80: figure]
• Parachute Drag Coefficient

MAE 5930, Rocket Systems Design

# Example Calculation: Drogue Chute Terminal Velocity (3)

18

## - Elliptical Parachute .. Take median value

(CD )chute
! 0.76 ± 0.115

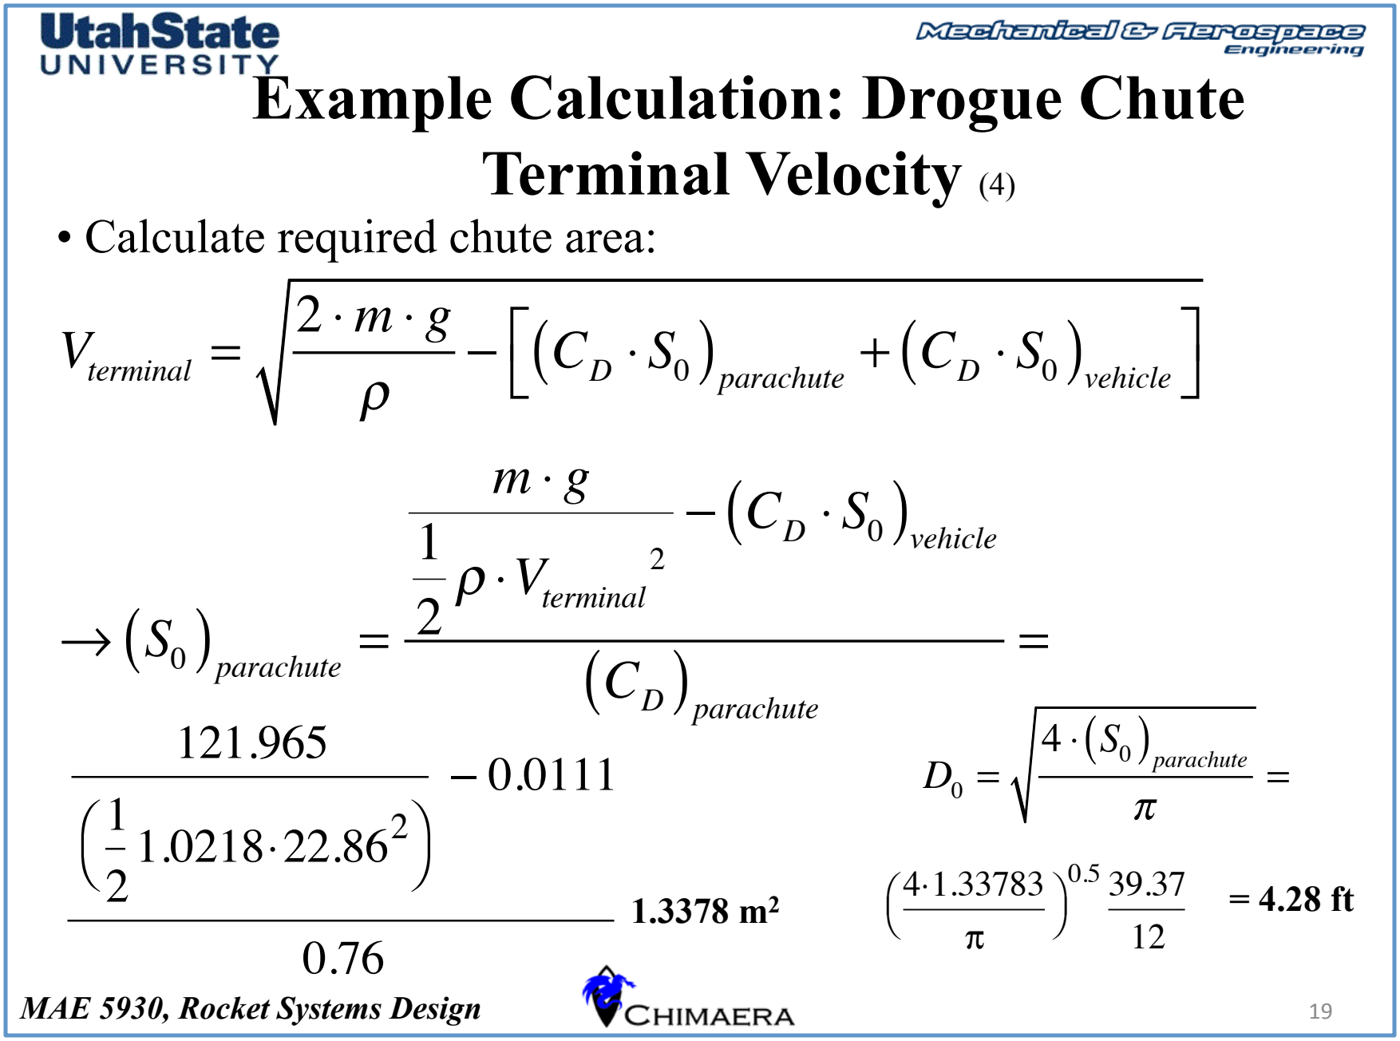
[picture p81: figure]
MAE 5930, Rocket Systems Design; Example Calculation: Drogue Chute Terminal Velocity (4); • Calculate required chute area:; Vterminal =; 2 ! m ! g " # CD ( ! S0 ) parachute; + CD ( ! S0 )vehicle; ( S( 0 ) parachute; " !Vterminal; 0 )vehicle; (CD ) parachute; 4 ! S( 0 ) parachute

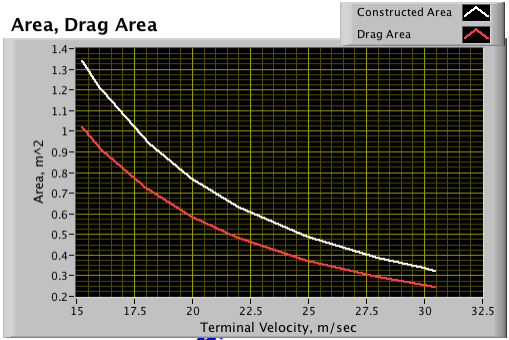
[picture p82: figure]

MAE 5930, Rocket Systems Design

# Example Calculation: Drogue Chute Terminal Velocity (5)

20

Drag Chute Areas Versus Terminal Velocity

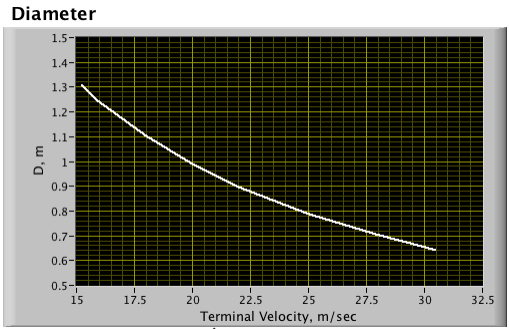
[picture p83: figure]

MAE 5930, Rocket Systems Design

# Example Calculation: Drogue Chute Terminal Velocity (6)

21

Drag Chute Diameter Versus Terminal Velocity

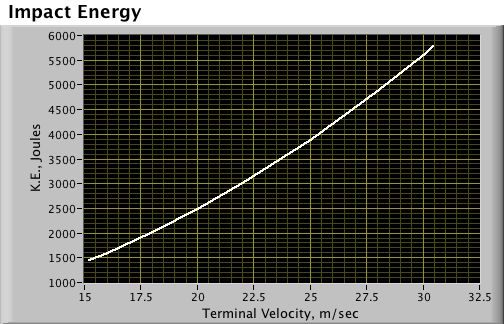
[picture p84: figure]

MAE 5930, Rocket Systems Design

# Example Calculation: Drogue Chute Terminal Velocity (7)

22

# Parachute Opening Loads

## Largest Tensile Load on Vehicle … often the Ultimate

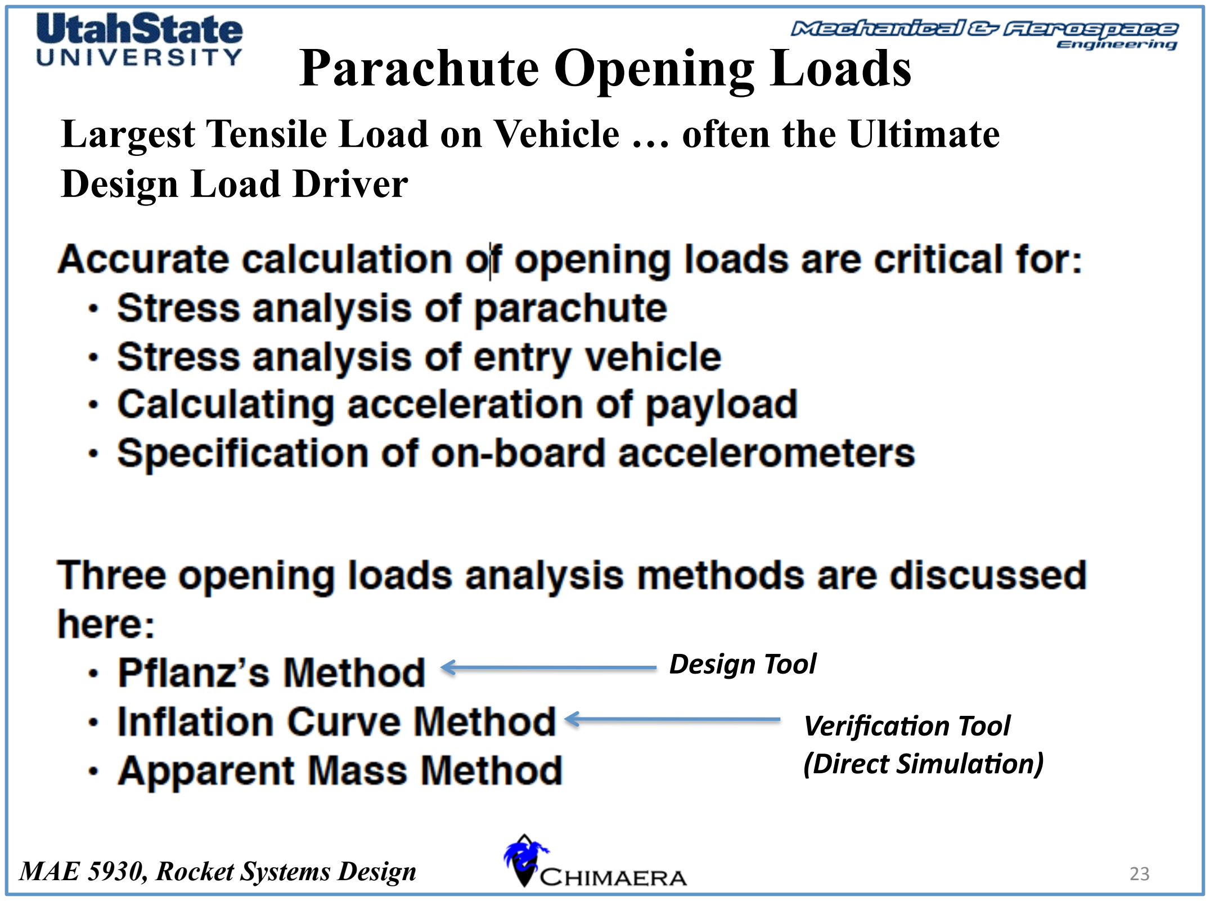
[picture p85: page 23]

MAE 5930, Rocket Systems Design
23

## Design Load Driver

Design

Tool

Verifica/on

Tool
(Direct

Simula/on)

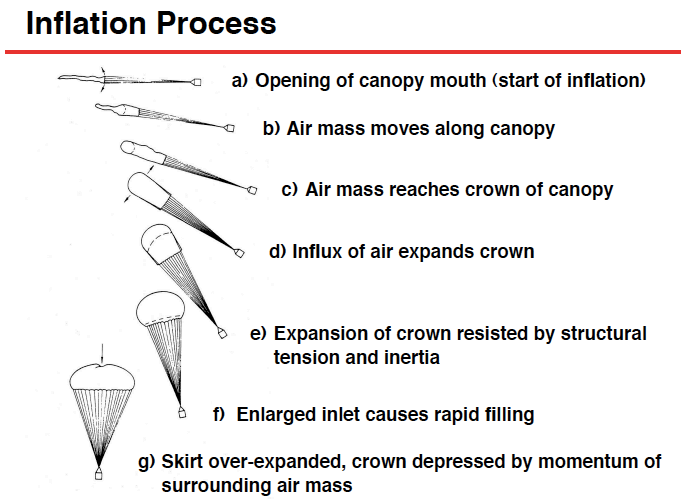
[picture p86: figure]

MAE 5930, Rocket Systems Design

# Parachute Opening Loads (2)

24

# Parachute Opening Loads (3)

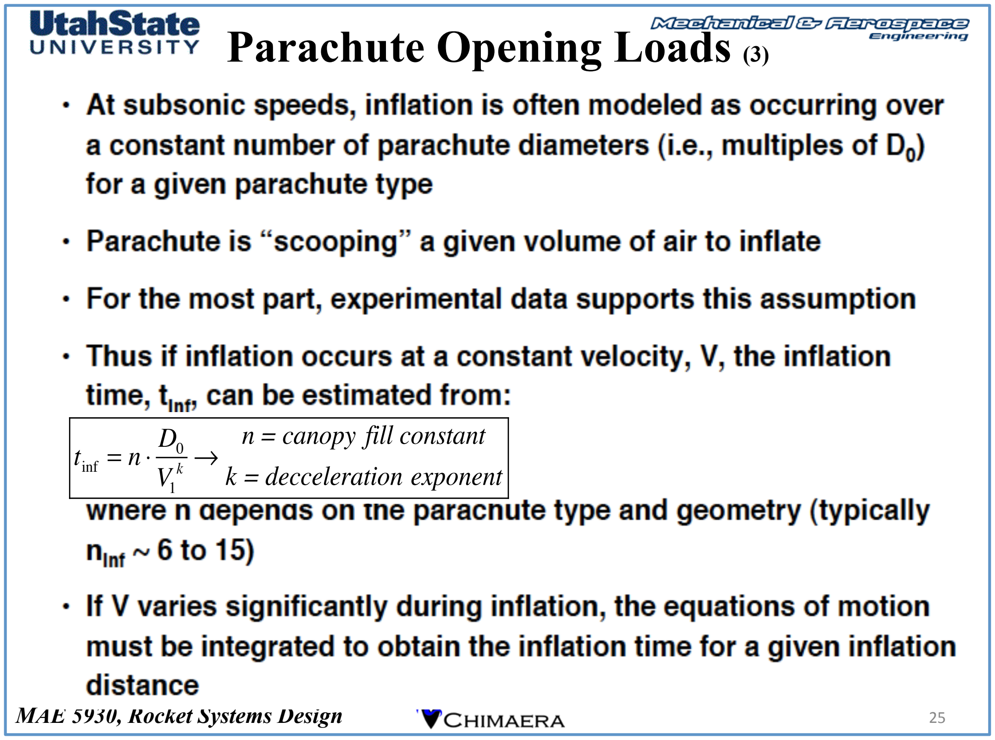
[picture p87: page 25]

MAE 5930, Rocket Systems Design
25

tinf = n !

D0
V1

k "

n = canopy fill constant
k = decceleration exponent

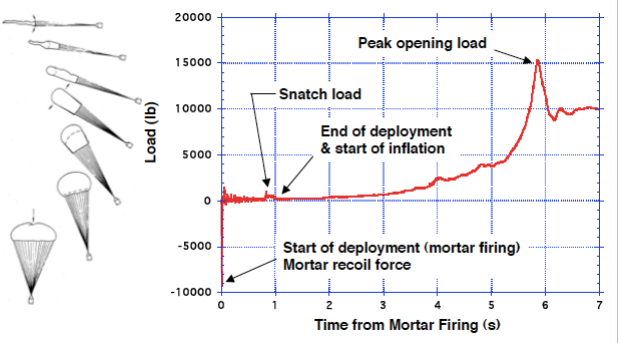
[picture p88: figure]

MAE 5930, Rocket Systems Design

# Parachute Opening Loads (4)

26

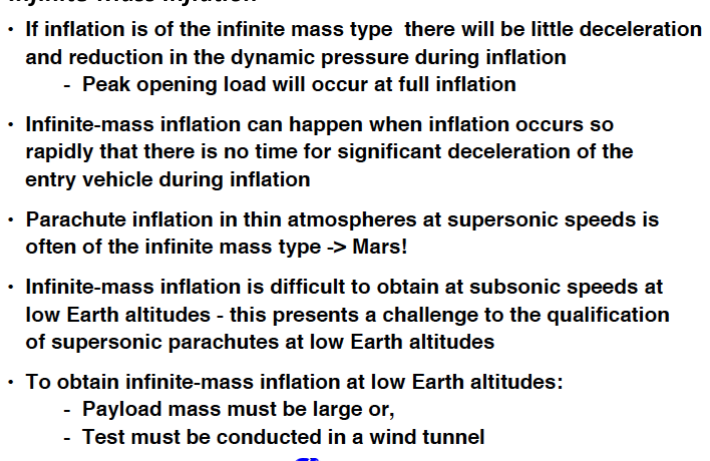
[picture p89: figure]

MAE 5930, Rocket Systems Design

# Parachute Opening Loads (5)

27

## Infinite-‐Mass

## Infla/on

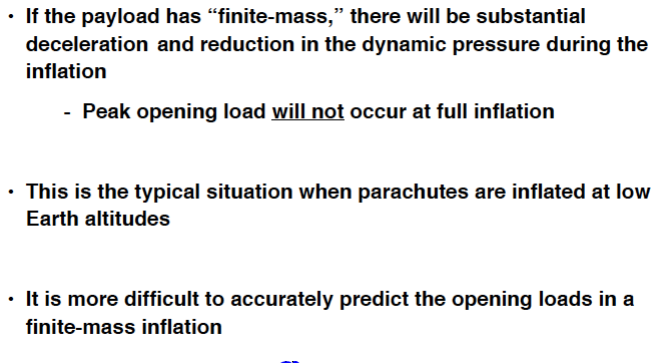
[picture p90: figure]

MAE 5930, Rocket Systems Design

# Parachute Opening Loads (6)

28

## Finite-‐Mass

## Infla/on

MAE 5930, Rocket Systems Design

# Pflanz’s Method

29

## - Pflanz' (1942):

-introduced analytical functions for the drag area

- Simple, frst-order, design book type method -Requires least knowledge of the system compared to other methods

-Assumes no gravity acceleration – limits application to shallow fight path angles at parachute deployment
- Neglects entry vehicle drag
- Yields only peak opening load
- Allows for finite mass approximation

## - Doherr (2003) extended method to account for gravity and arbitrary fight path angles

# Pflanz’s Method (2)

## = q1 ! CD ( ! S0 )!Cx ! X1

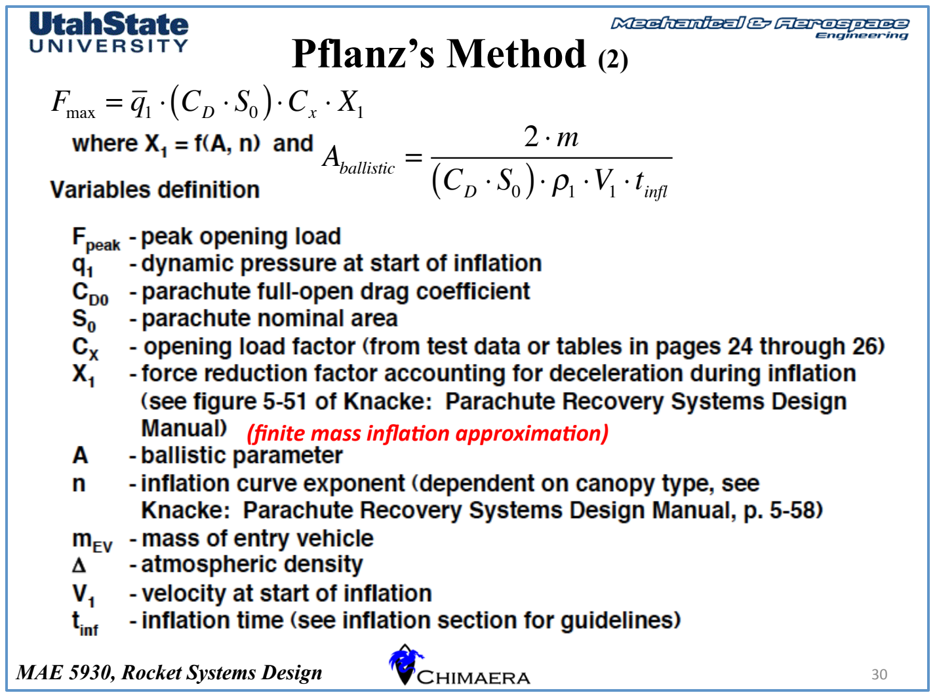
[picture p91: page 30]

MAE 5930, Rocket Systems Design
30

Fmax

Aballistic

=

2 ! m

CD ( ! S0 )! "1 !V1 !tinfl

(finite

mass

infla/on

approxima/on)

# Pflanz’s Method (3)

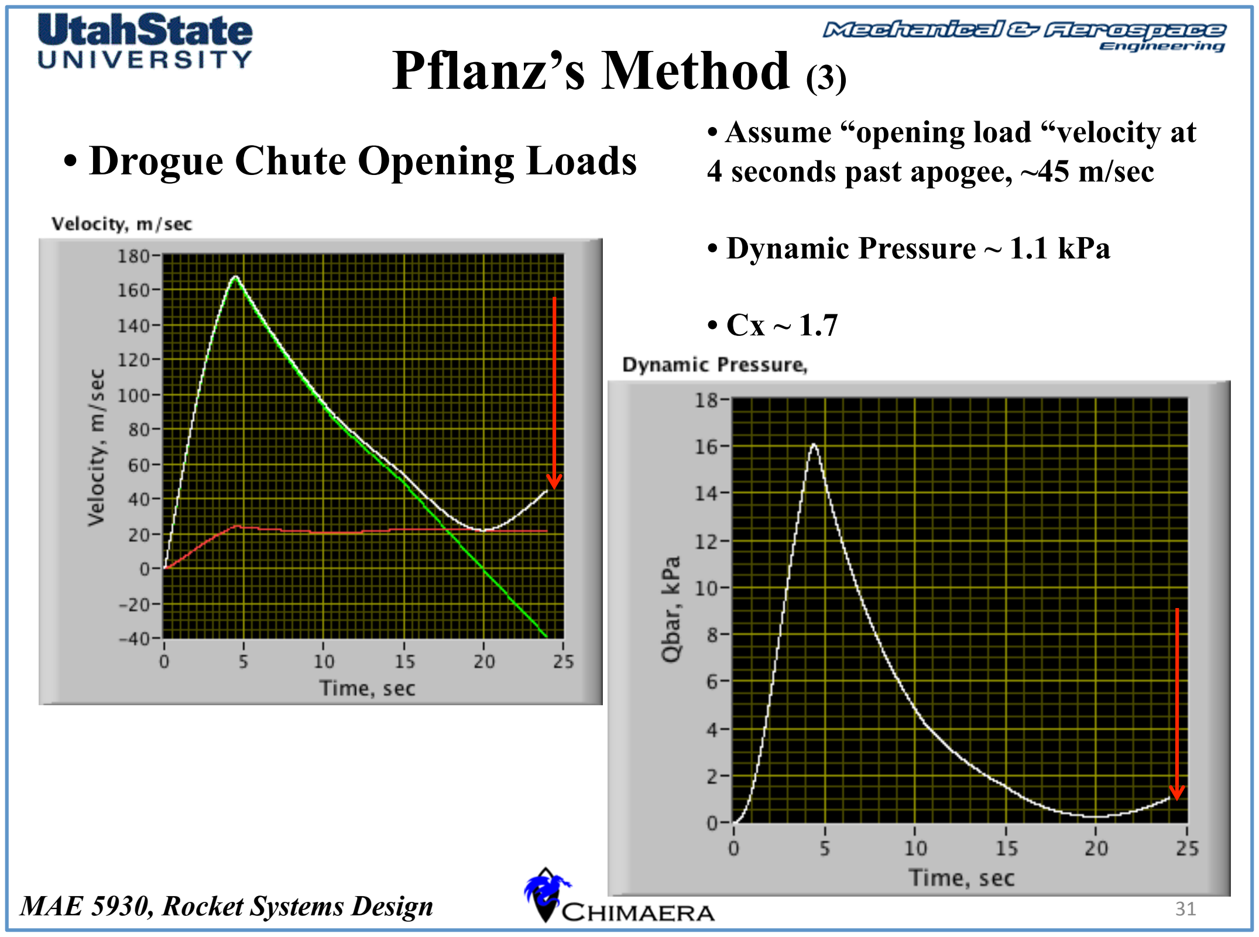
[picture p92: page 31]

MAE 5930, Rocket Systems Design
31
- Drogue Chute Opening Loads | • Assume “opening load “velocity at 4 seconds past apogee, ~45 m/sec
| • Dynamic Pressure ~ 1.1 kPa
| • Cx ~ 1.7

MAE 5930, Rocket Systems Design

# Pflanz’s Method (4)

32

tinf = n ! D0

Vopen

k "

n = canopy fill constant
k = decceleration exponent

elliptical parachute "

n # 4
k # 0.85

Subsonic Inflation time …

4 1.3378 4

! " | # $ | %

0.5
45⁰.85 tinf = | = 0.2053 sec

Aballistic

=

2 ! m

CD ( ! S0 )! "1 !V1 !tinfl

=

2!12.428
( 0.76!1.3378) 1.0218!45.0!0.2053

=

2.590

# Pflanz’s Method (5)

=

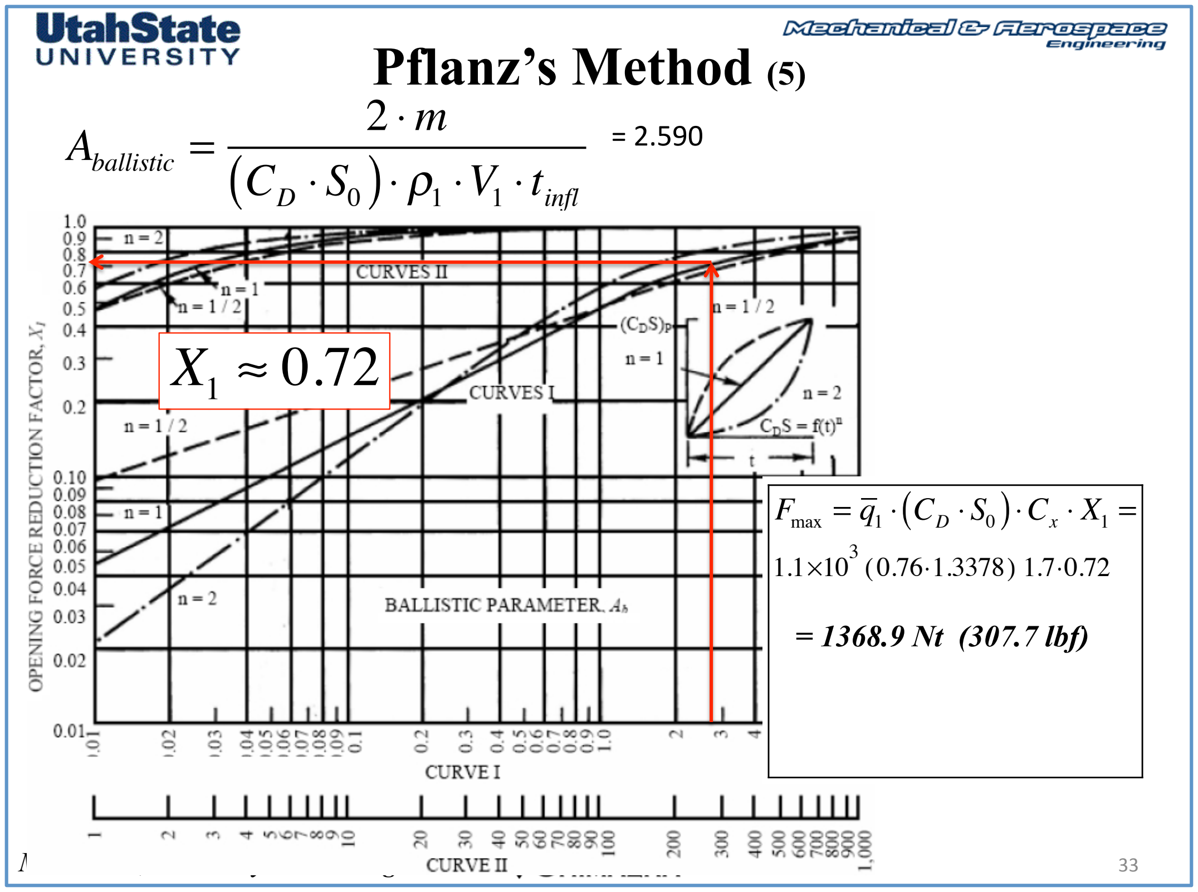
[picture p93: page 33]

MAE 5930, Rocket Systems Design
33

Aballistic

2 ! m

CD ( ! S0 )! "1 !V1 !tinfl

=

2.590

X1 ! 0.72

Fmax

### = q1 ! CD ( ! S0 )!Cx ! X1

=

1.1 3 !10 ( 0.76"1.3378) 1.7"0.72

= 1368.9 Nt (307.7 lbf)

# Pflanz’s Method (6)

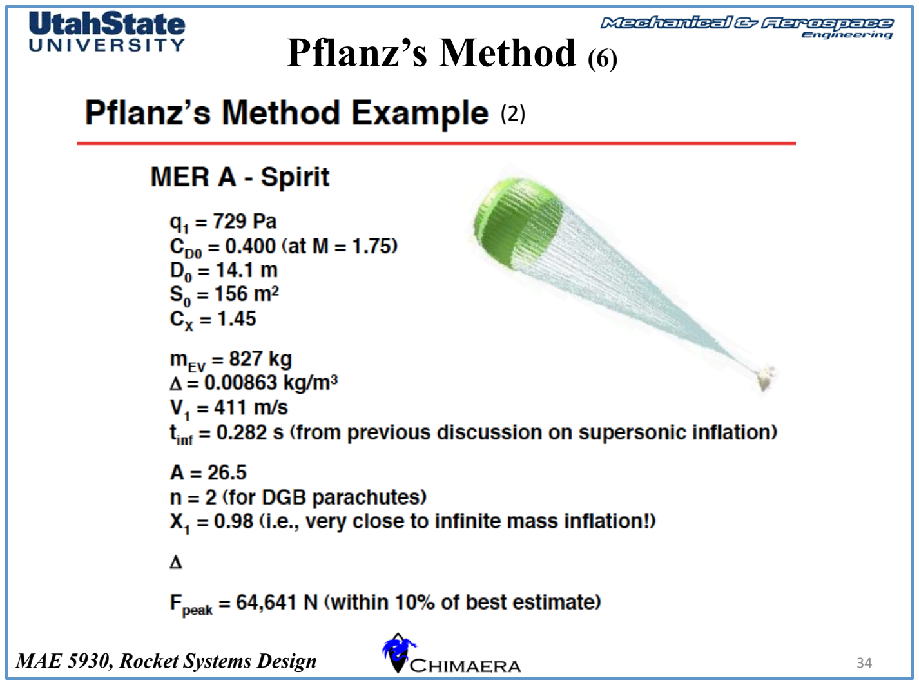
[picture p94: page 34]

MAE 5930, Rocket Systems Design
34

(2)

# Inflation Curve Method

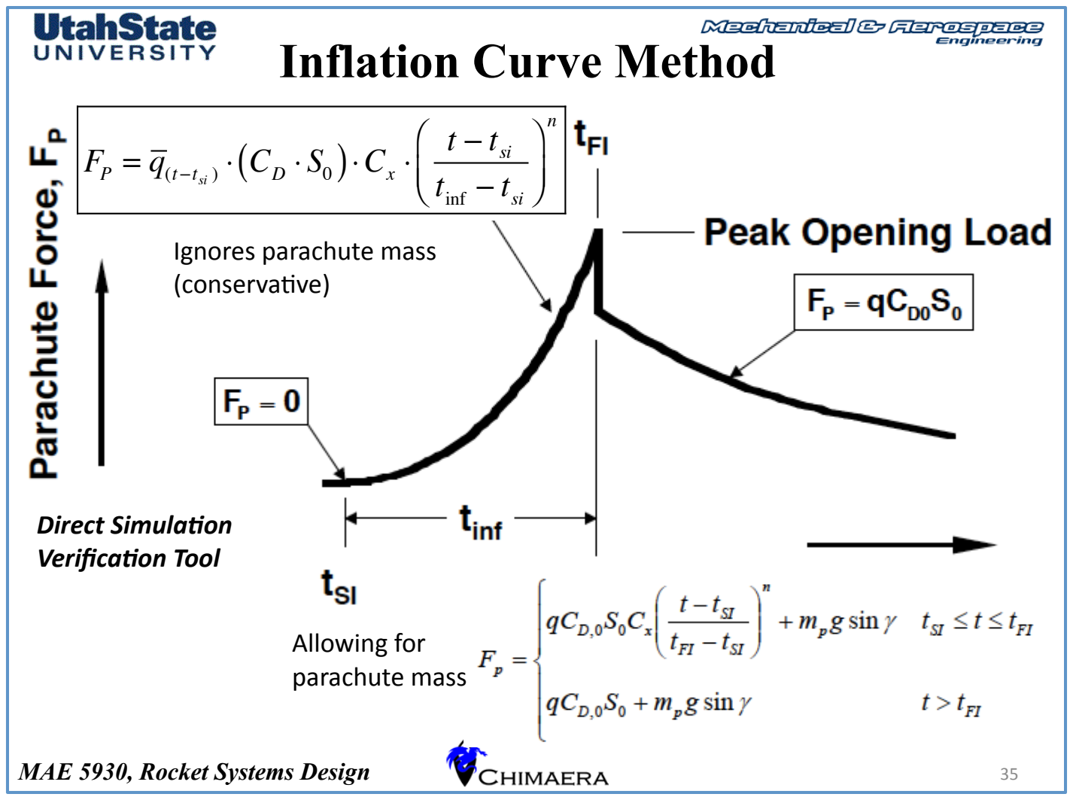
[picture p95: page 35]

MAE 5930, Rocket Systems Design
35

Direct

Simula/on
Verifica/on

Tool

FP

= q(t !tsi ) " CD ( " S0 )"Cx " t ! tsi

tinf ! tsi
$

%

&
'

(

n

Ignores

parachute

mass
(conserva?ve)

Allowing

for
parachute

mass

# Inflation Curve Method (2)

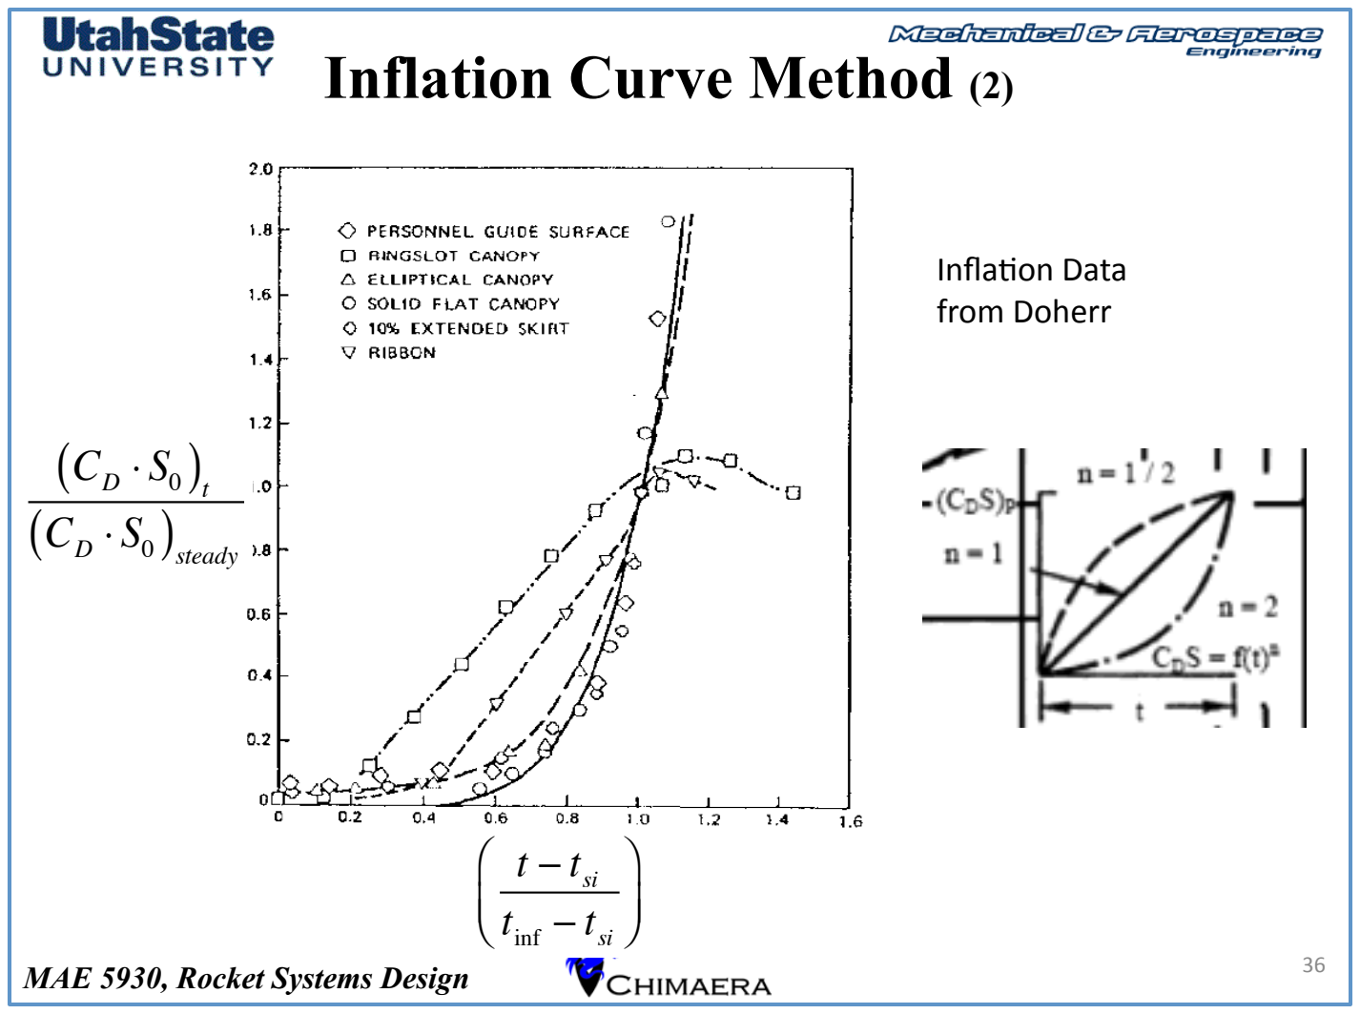
[picture p96: page 36]

MAE 5930, Rocket Systems Design

36

Infla?on

Data
from

Doherr

CD ( ! S0 )t

CD ( ! S0 )steady

t ! tsi

tinf ! tsi

"

$

%
&

'

# Questions??

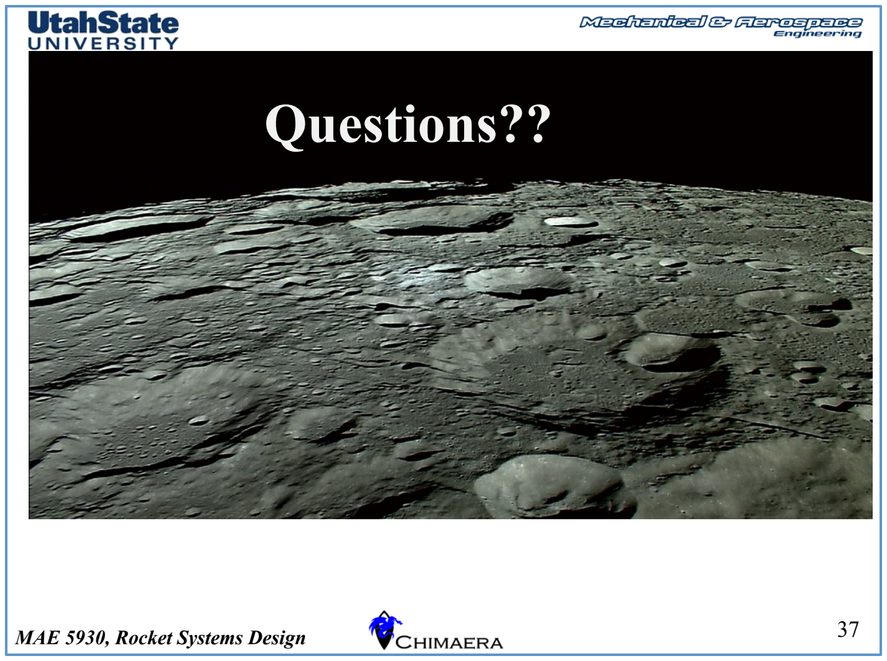
[picture p97: page 37]

MAE 5930, Rocket Systems Design | 37
