Maeswoon/UNHSEDS/Business/Finance/RESUME BOOK/PastResume/BenLetourneauResume.pdf

## Ben Letourneau

80 Newfields Rd, Exeter, NH 03833
(603) 531-3747 • bml1022@wildcats.unh.edu

EDUCATION

University of New Hampshire - Durham, NH | Expected: May 2020
Bachelor of Science: Electrical Engineering | GPA: 3.69
- Dean’s List:
- Honors - Fall 2016
- Highest Honors – Fall 2017, 2018, Spring 2019

RELEVANT COURSEWORK

SKILLS

CAMPUS & LEADERSHIP ACTIVITIES

Institute of Electrical and Electronics Engineers | Fall 2016 – Present
Chapter Member
- Regularly attend and participate in meetings focused on building professional networks and outreach to the community
STEMbassadors | Fall 2018 – Present
Member
- Go to schools throughout the state to bring STEM education to students
- Lead groups of students in completing STEM related projects
University Honors Program | Spring 2017 – Present
Member
- Attend lecture series pertaining to topics of current and relevant events

ADDITIONAL EXPERIENCE

Prime Power Inc. – Hampstead, NH | May 2019 – Present
Summer Engineering Intern
- Responsible for building, reviewing and testing military grade power supplies
Pfizer Inc. – Andover, MA | June 2018 – August 2018
Student Summer Worker
- Worked with the infrastructure engineering team on arc flash remediation and load shedding projects throughout the Andover site
Atrio Properties – Exeter, NH | June 2015 – August 2017
Property Maintenance
- Supervisor of the property maintenance team responsible for exterior and interior property maintenance at 7 rental properties
- MultiSim
- Matlab
- JAVA Programming
- Microsoft Office
- Oscilloscope
- Multimeter
- Advanced written and verbal communication skills
- Excellent problem solving skills
- Results oriented collaborator
- Strong troubleshooting of electrical problems
- Extensive experience in team oriented situations
- Highly developed time
management skills
- Calculus I, II
- Digital Systems
- Differential Equations
- Introduction to Computer Science
- Physics I, II
- Electrical Circuits
- Electronic Design
- Signals and Systems
- Electromagnetics

- Maintain files and records
