Maeswoon/UNHSEDS/Reports and Presentations/Presentations/2019-2020/Recruitment Presentation/SEDS Spring 2020 Recruitment.pptx

## UNH SEDS

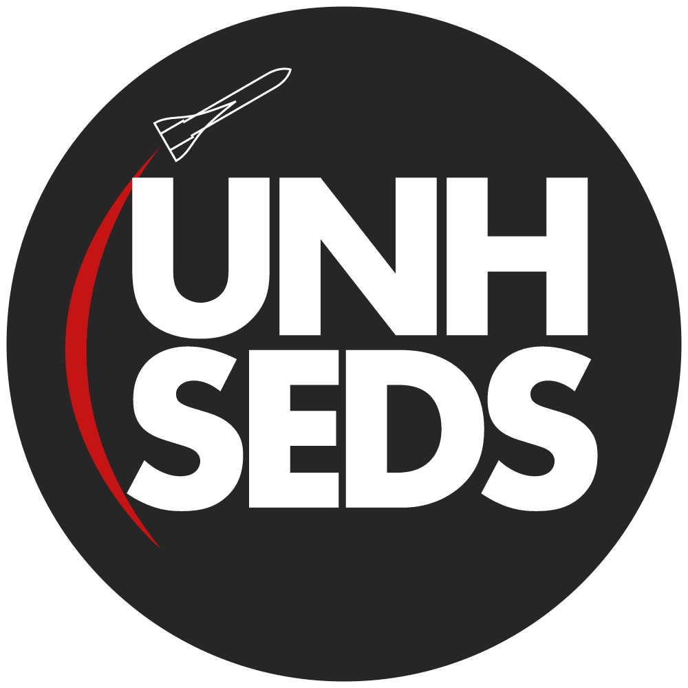
[picture p102: figure]

CEPS Engineering Organization
High Power Rocketry

University of New Hampshire
Students for the Exploration and Development of Space

## Slide 2

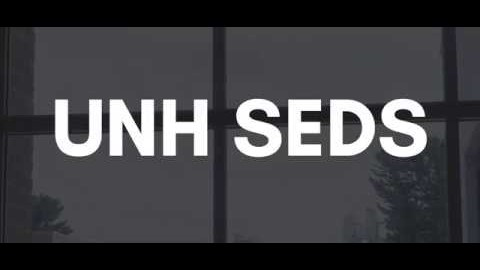
[picture p103: figure]

University of New Hampshire
Students for the Exploration and Development of Space

## Slide 3

UNH SEDS Three-Year Plan

Year Two
2018-2019

Runaway


Hybrid Engine
Design
Manufacture
Test

Year One
2017-2018


Year Three
2019-2020

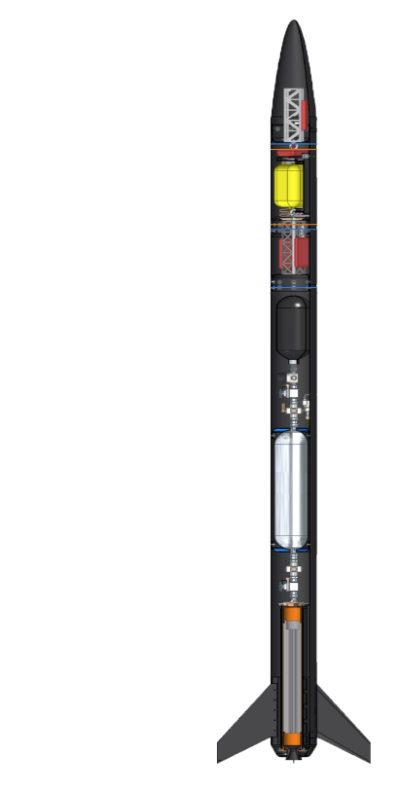
[picture p104: figure]

Rocket Building
Simulating
Launching
Optimizing

Hybrid Rocket
Engine Optimization
Rocket Integration
Competition

University of New Hampshire
Students for the Exploration and Development of Space

## Slide 4

UNH SEDS Spring 2020

Frame Propulsion Avionics Operations

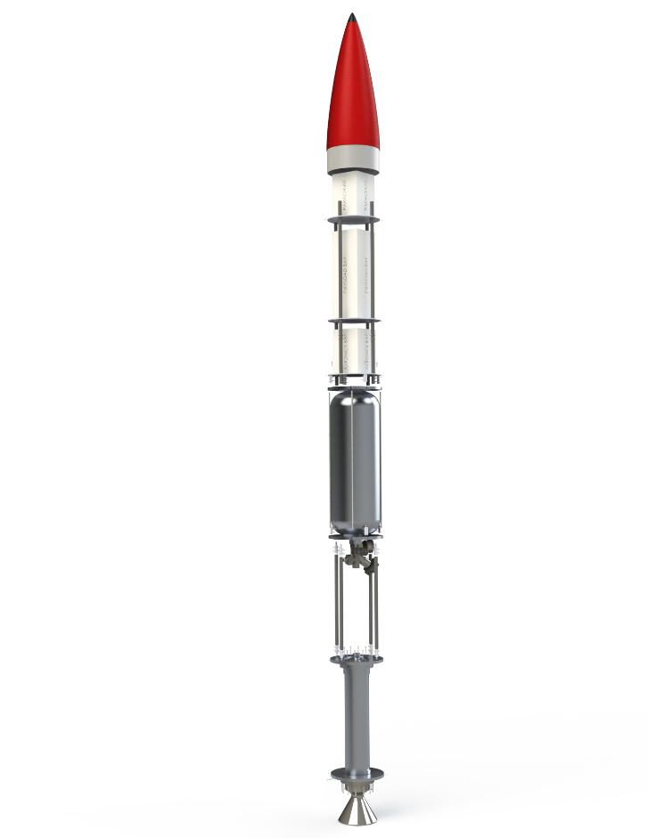
[picture p105: figure]
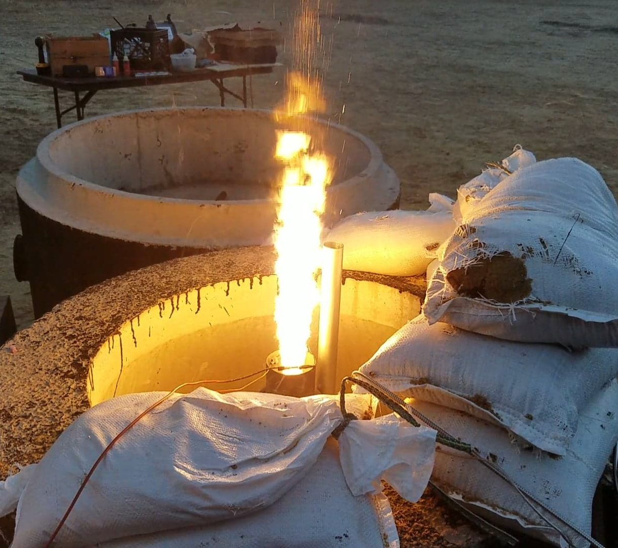
[picture p106: figure]
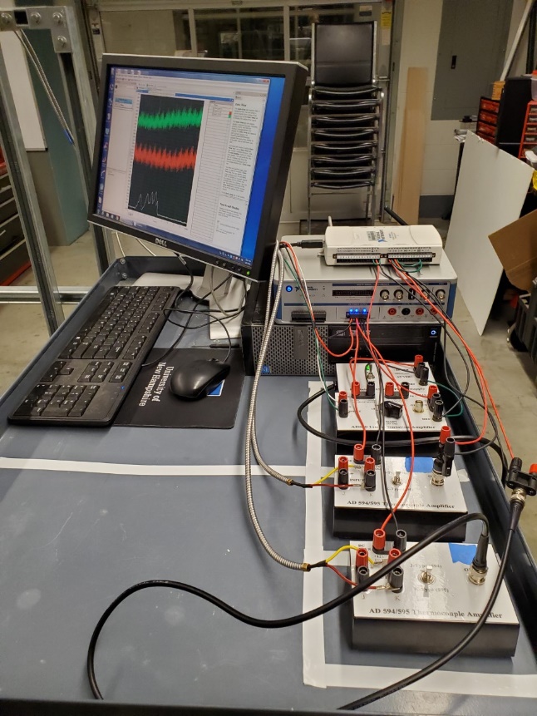
[picture p107: figure]
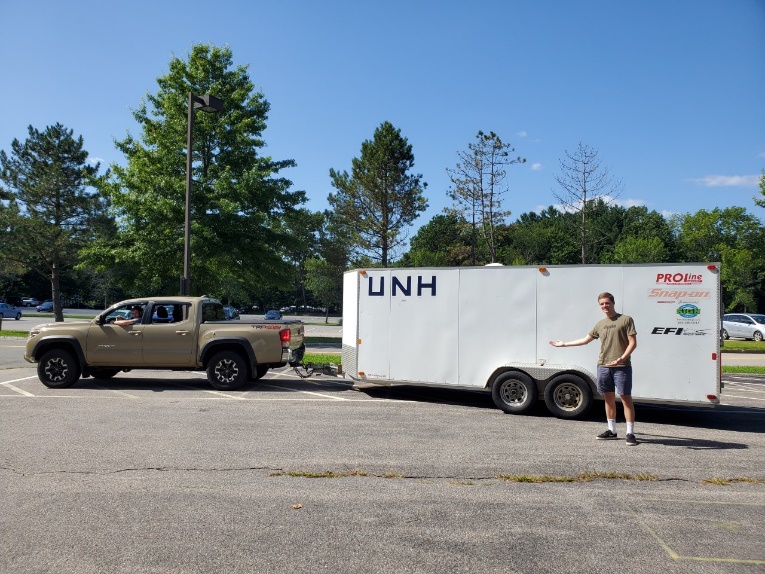
[picture p108: figure]

University of New Hampshire
Students for the Exploration and Development of Space

## Slide 5

UNH SEDS in the future

Conferences:
- Spaceport America Cup
  - June 2020 in New Mexico
  - Target Apogee 10,000 ft.
- SpaceVision
  - October 2020 in Texas
  - Annual Conference to Speak and Connect with many Aerospace Companies
Future Work:
- Thrust vectoring system
- Satellite research
- Whatever direction you want to take it!

University of New Hampshire
Students for the Exploration and Development of Space

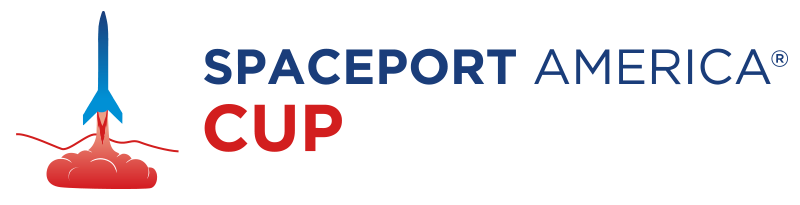
[picture p109: figure]

## Slide 6

Why Join UNH SEDS?

Passionate about Engineering and want to Apply your Knowledge?
Interested in the Aerospace Industry?
Looking to be Involved with an Organization at UNH?
Wondering what to do for a Senior Project?

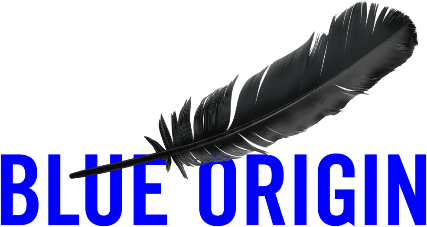
[picture p110: figure]
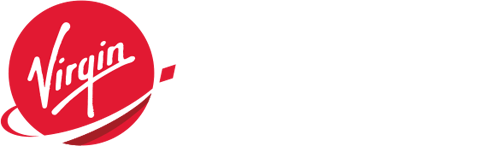
[picture p111: figure]
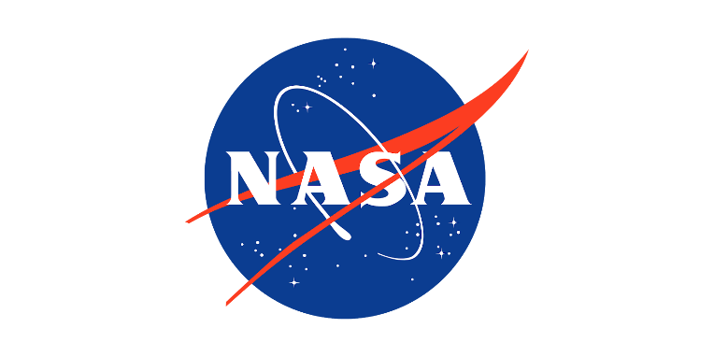
[picture p112: figure]
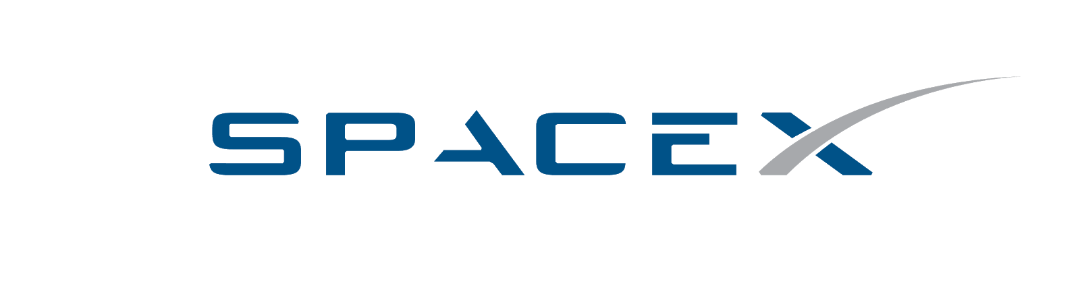
[picture p113: figure]
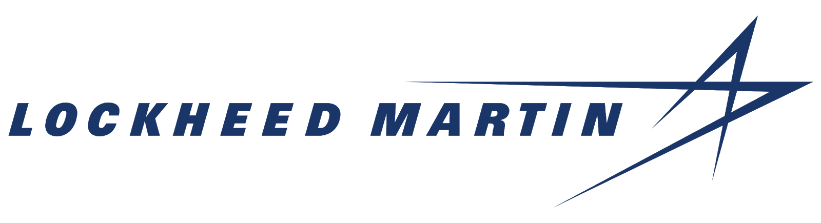
[picture p114: figure]

University of New Hampshire
Students for the Exploration and Development of Space

## Slide 7

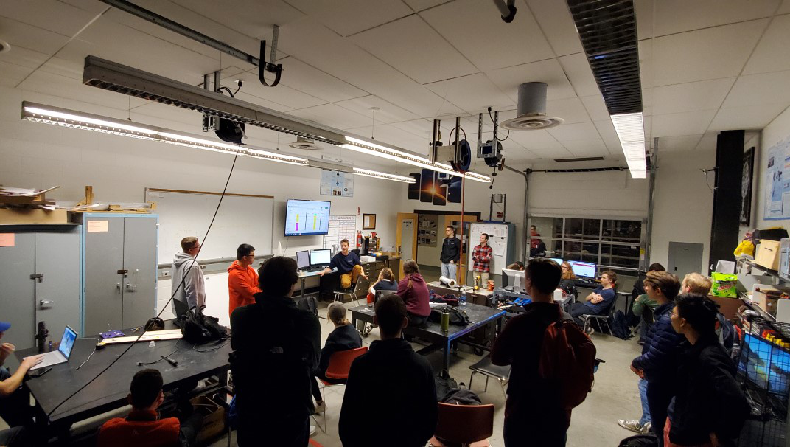
[picture p115: figure]

Join us!
Informational Meeting: Mon Jan 27th at 8pm in Kings S172

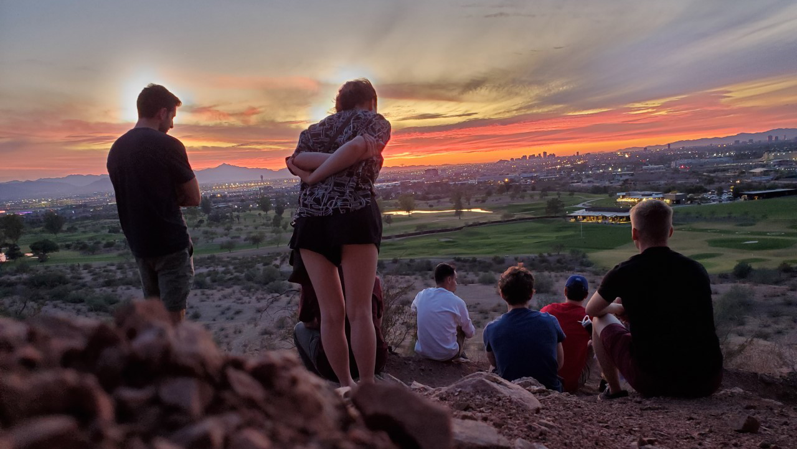
[picture p116: figure]
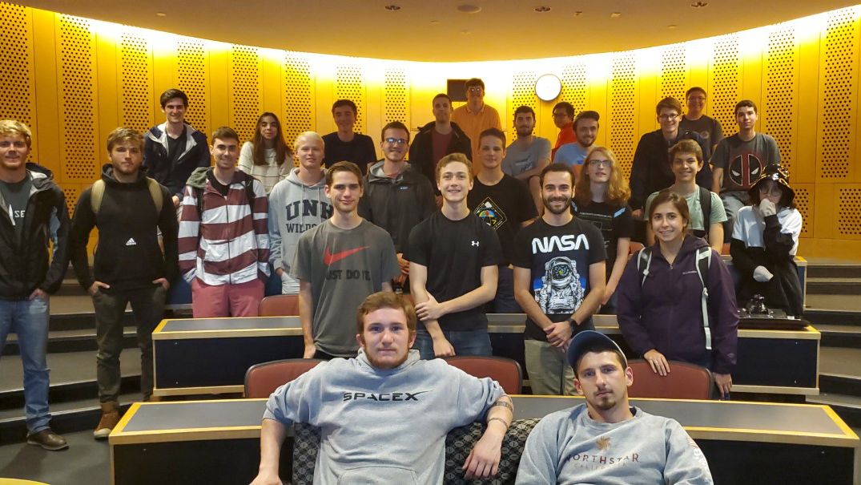
[picture p117: figure]
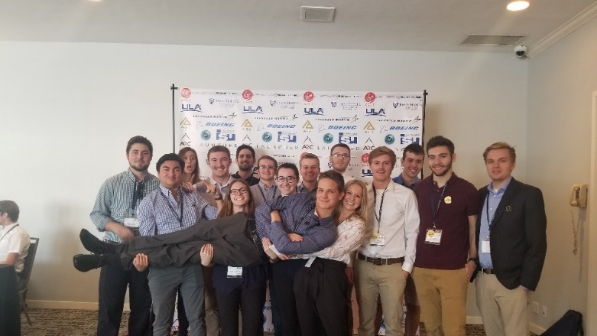
[picture p118: figure]

University of New Hampshire
Students for the Exploration and Development of Space

Notes: EE major too
