Maeswoon/UNHSEDS/Reports and Presentations/Presentations/2019-2020/Senior Designs/UNH SEDS ME Senior Project 19-20.pptx

Image result for starry night background

University of New Hampshire
Students for the Exploration and Development of Space


## Slide 2

University of New Hampshire
Students for the Exploration and Development of Space

## Slide 3

University of New Hampshire
Students for the Exploration and Development of Space
