Maeswoon/UNHSEDS/should i really do this.docx

Why should I start a club

1. There is no club at UNH that is like a family
2. There is no family that loves space
3. I want to surround myself with people who think space is the future of humanity

Why would people want to join a club

1. Want experience to decide if they like space
2. Want experience to have a chance to do space
3. Need connections.

Possible clubs – UNH SEDS?

What would SEDS do for us?

1. Provide opportunities in funding, projects and networking
2. A framework of space family in a school with no space

ADDITION 2/6/2020 : wow…
