Maeswoon/UNHSEDS/Business/Organization/Recruitment/Spring 2020 Courses.docx

PHYS 407

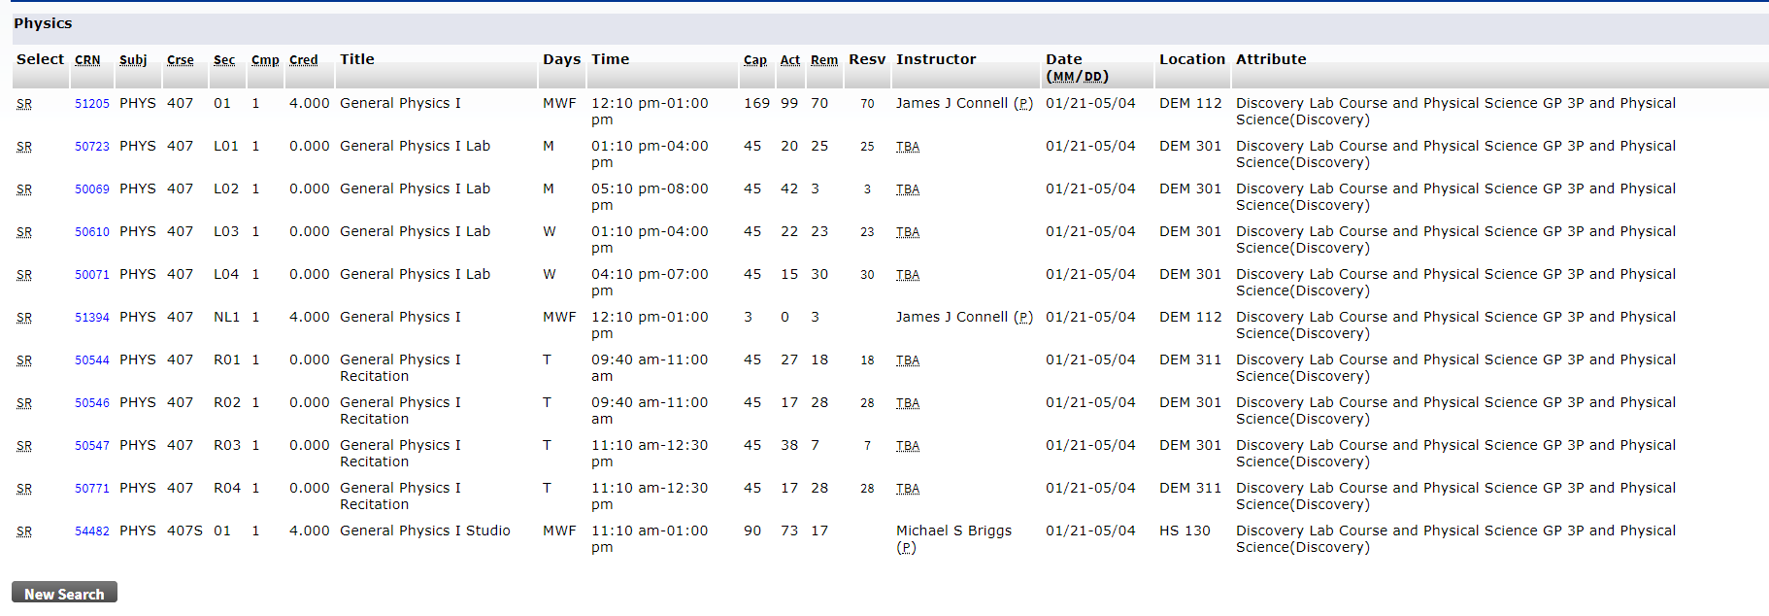
[picture p132: figure]

PHYS 408

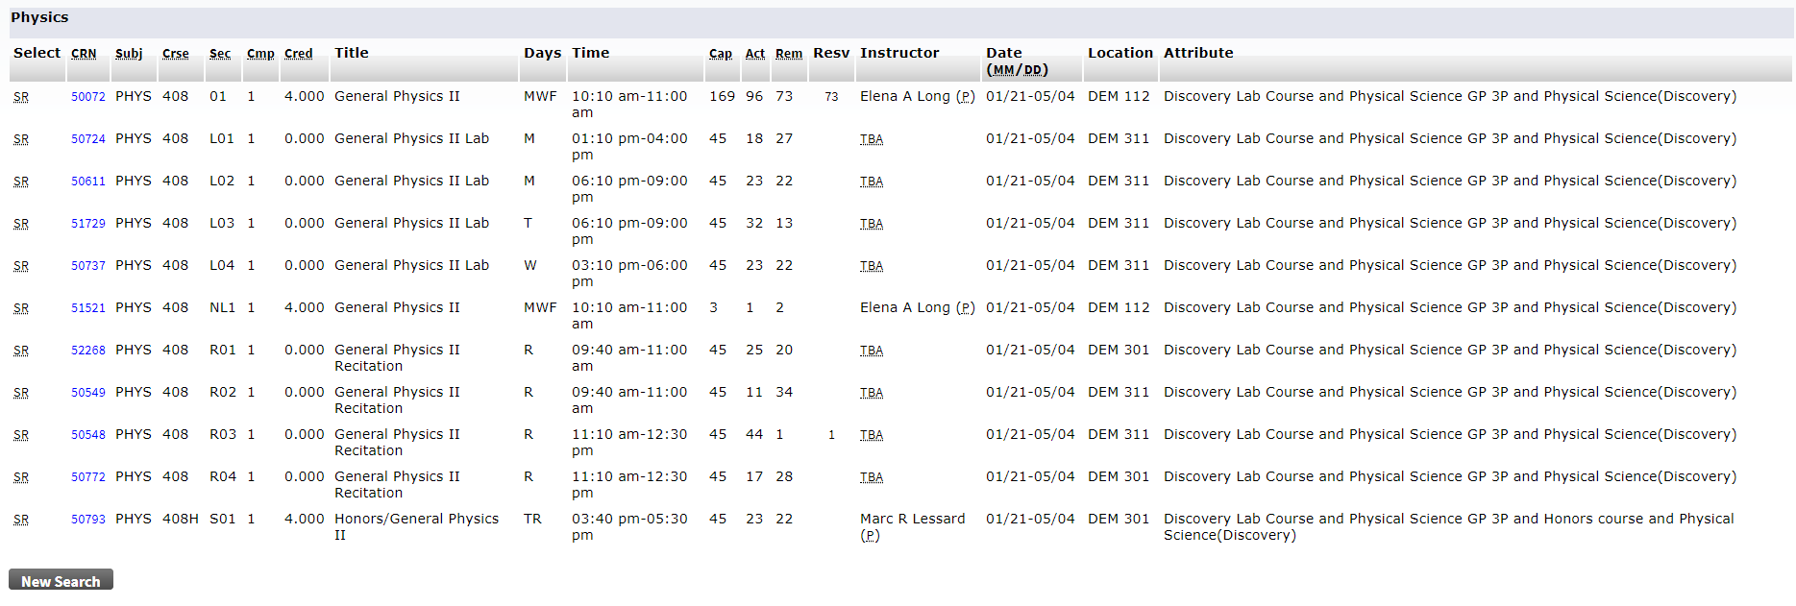
[picture p133: figure]

CHEM 405

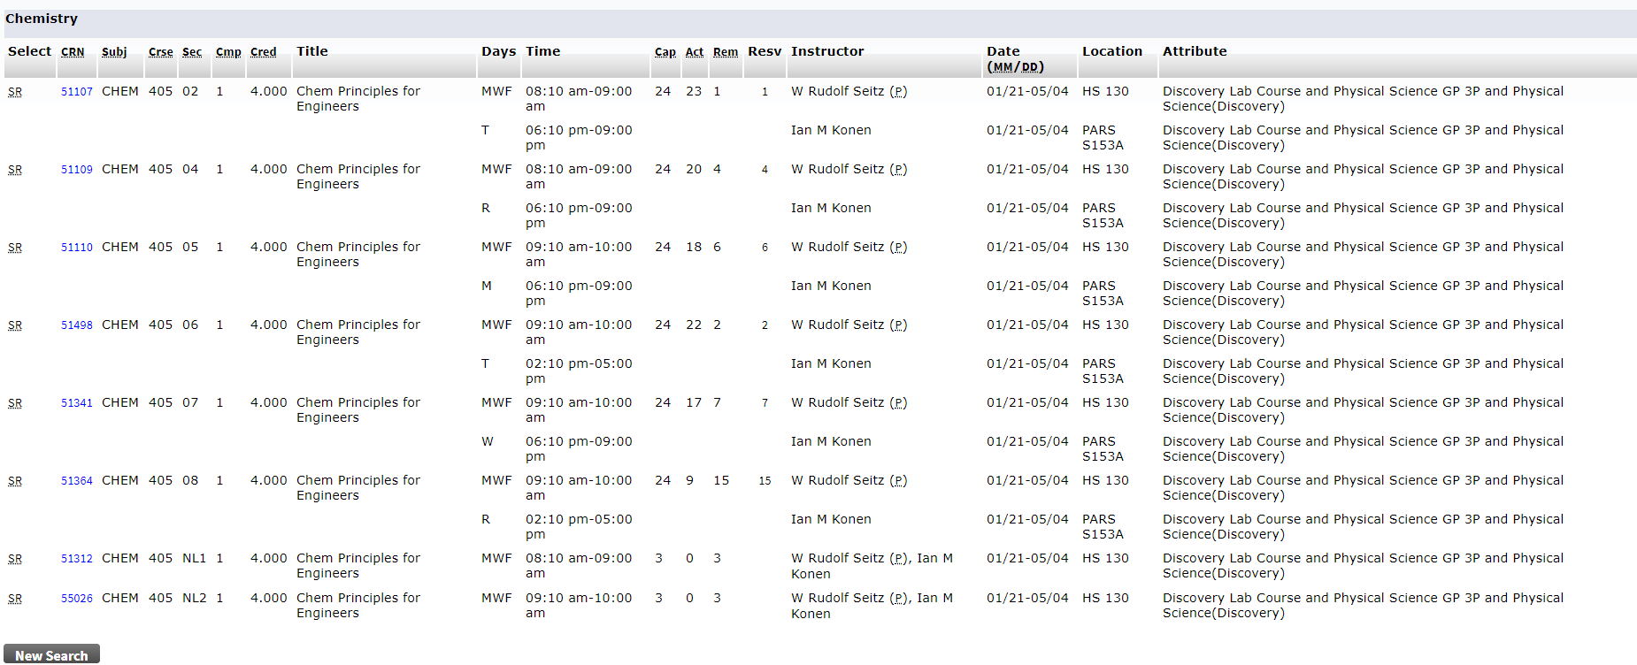
[picture p134: figure]
