Maeswoon/UNHSEDS/Business/President Achrives/Presentation/UNH SEDS Fundrasing Level.pptx

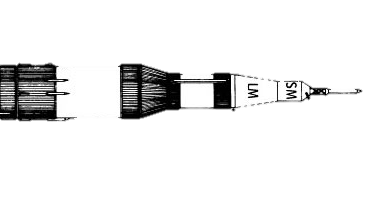
[picture p135: figure]

Finance Incentive Program

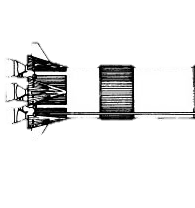
[picture p136: figure]

$5,000.00
BBQ

$8,000.00
Chicken Suit

$15,000.00
Hair Dye

$25,000.00
Tattoo

$30,000.00
Everything

Image result for starry night background

University of New Hampshire
Students for the Exploration and Development of Space
