Maeswoon/UNHSEDS/Business/Organization/BulletinBoard/Follow Us.docx

Follow Us!

@UNH SEDS

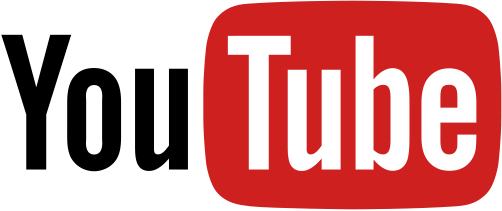
[picture p137: figure]

(https://www.youtube.com/channel/UCCGet3NkAJHD2hr-q8MuCUg)

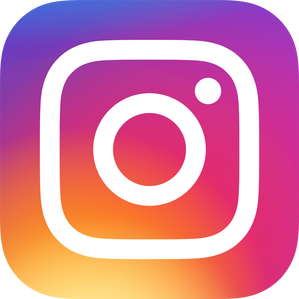
[picture p138: figure]
Image result for instagram logo
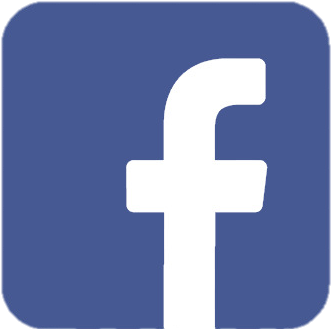
[picture p139: figure]
Related image
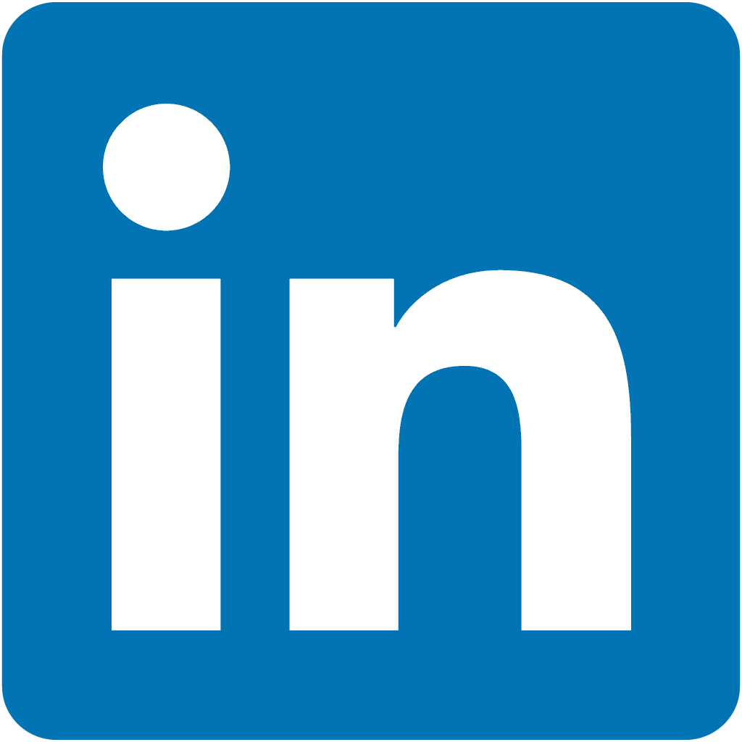
[picture p140: figure]
Image result for linkedin logo

*UNH Students for the Exploration and

Development of Space
