Maeswoon/UNHSEDS/Business/Organization/OutsideBoard/CompanyPictures.docx

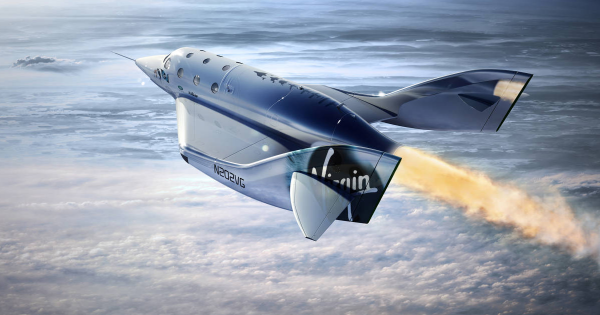
[picture p141: figure]
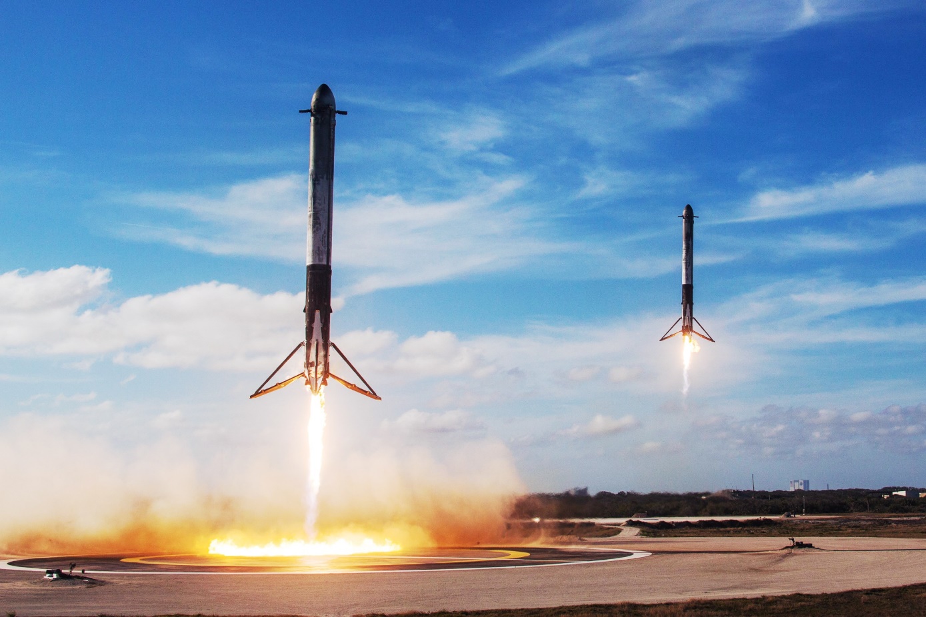
[picture p142: figure]
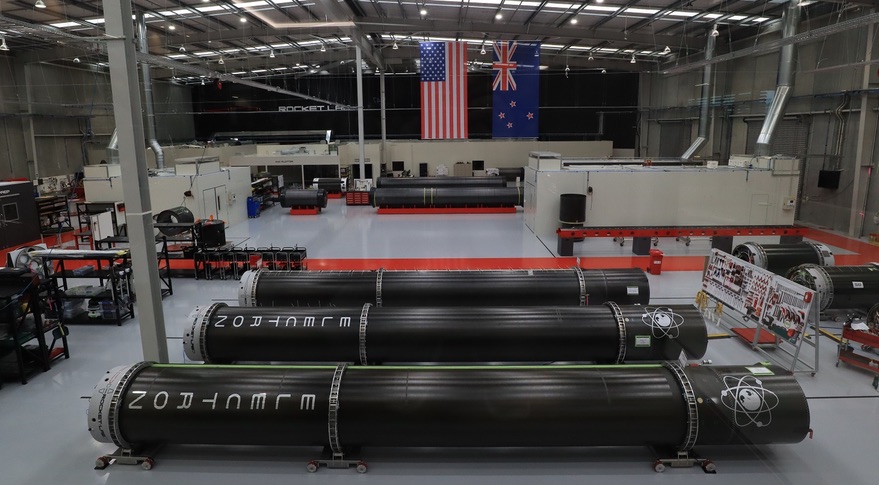
[picture p143: figure]
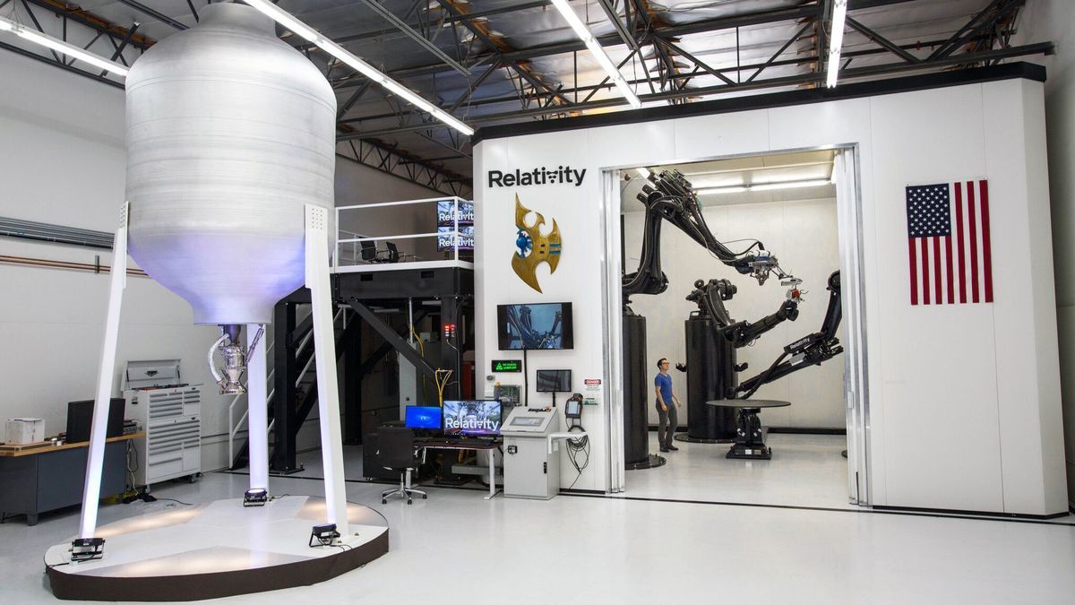
[picture p144: figure]
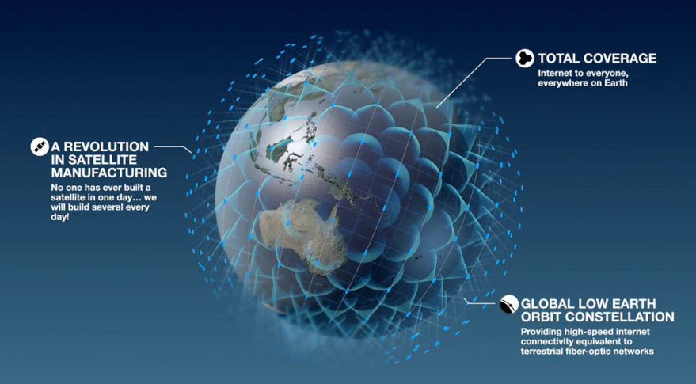
[picture p145: figure]
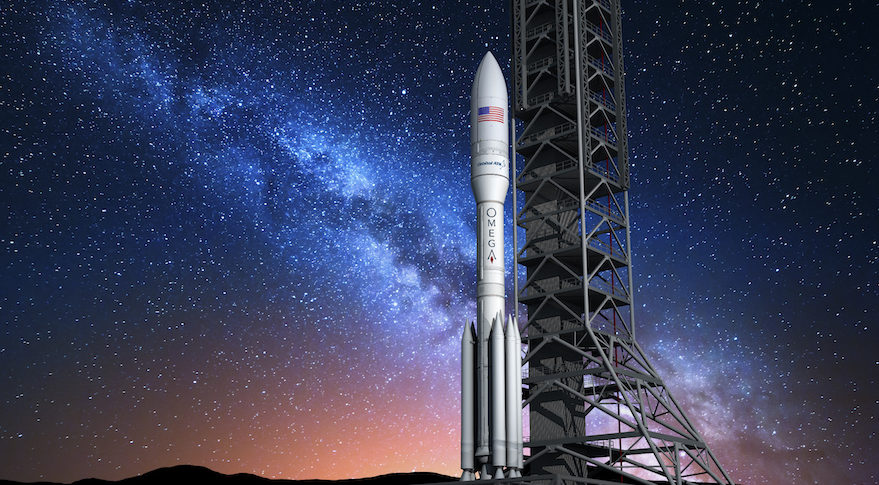
[picture p146: figure]
Image result for orbital atk
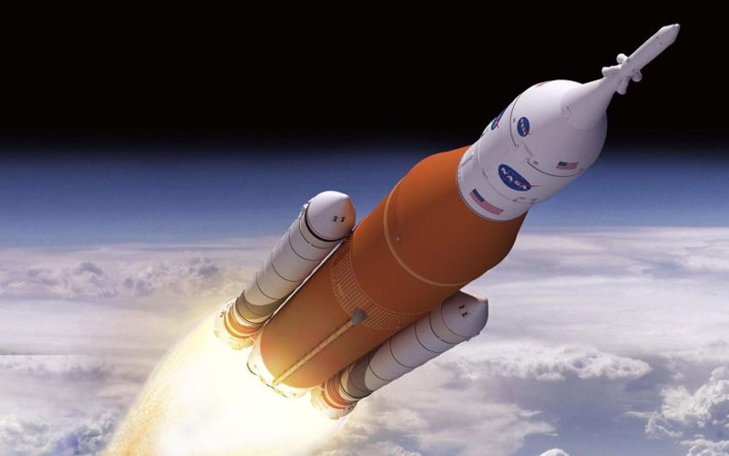
[picture p147: figure]
Image result for sls rocket
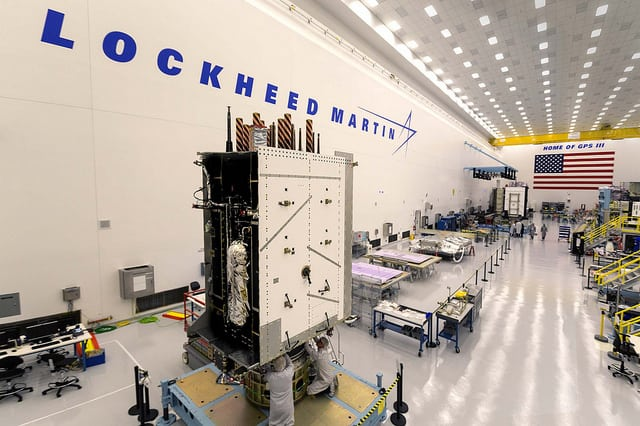
[picture p148: figure]
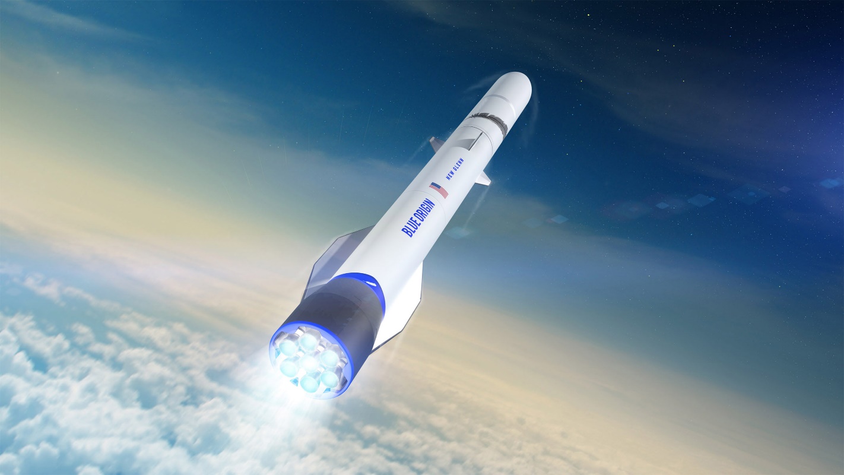
[picture p149: figure]
Image result for blue origin rocket
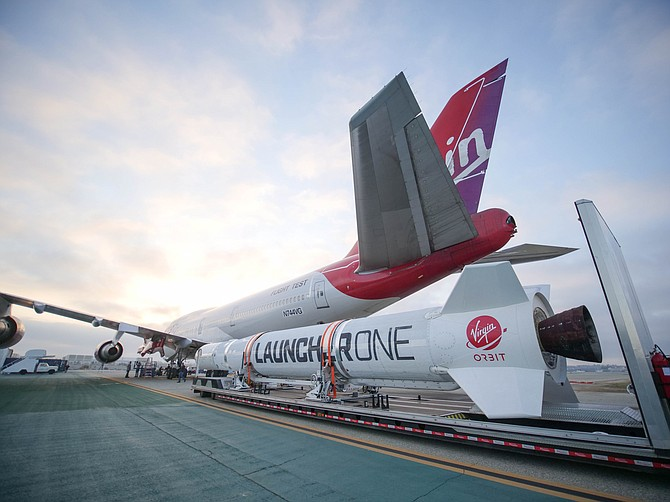
[picture p150: figure]
Image result for virgin orbit
