Maeswoon/UNHSEDS/Business/Organization/OutsideBoard/Logos.docx

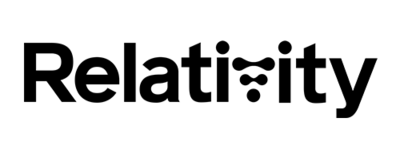
[picture p151: figure]
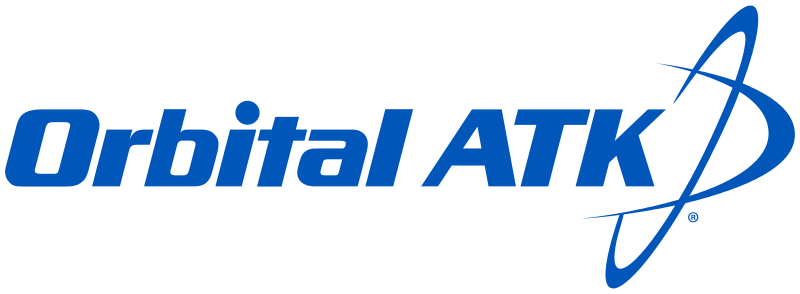
[picture p152: figure]
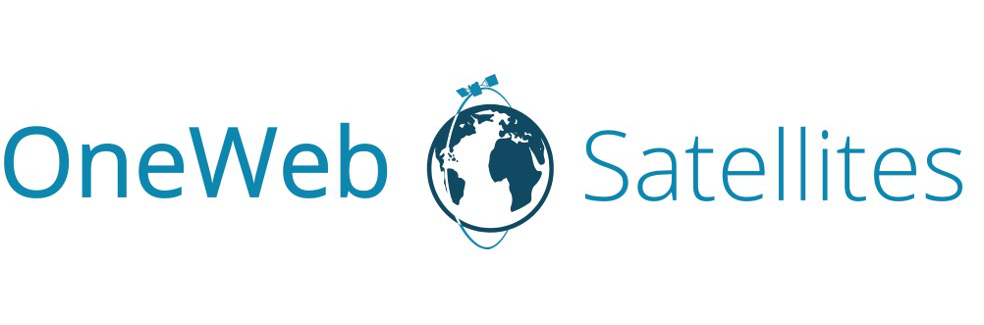
[picture p153: figure]
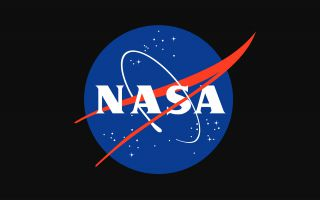
[picture p154: figure]
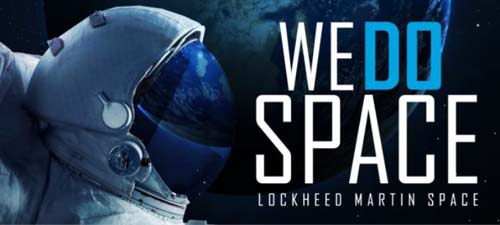
[picture p155: figure]
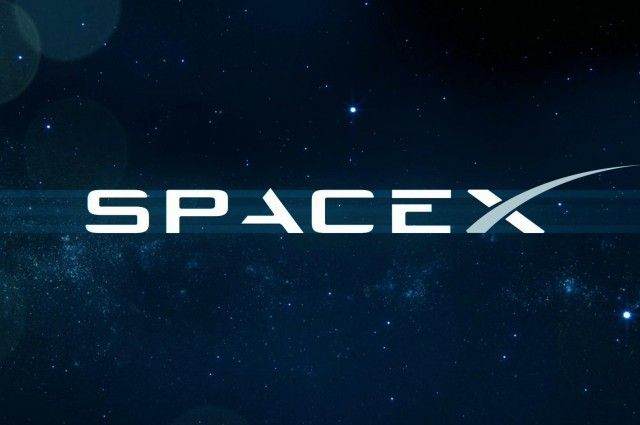
[picture p156: figure]
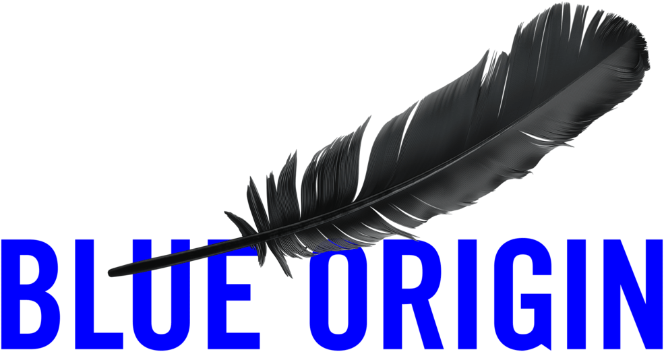
[picture p157: figure]
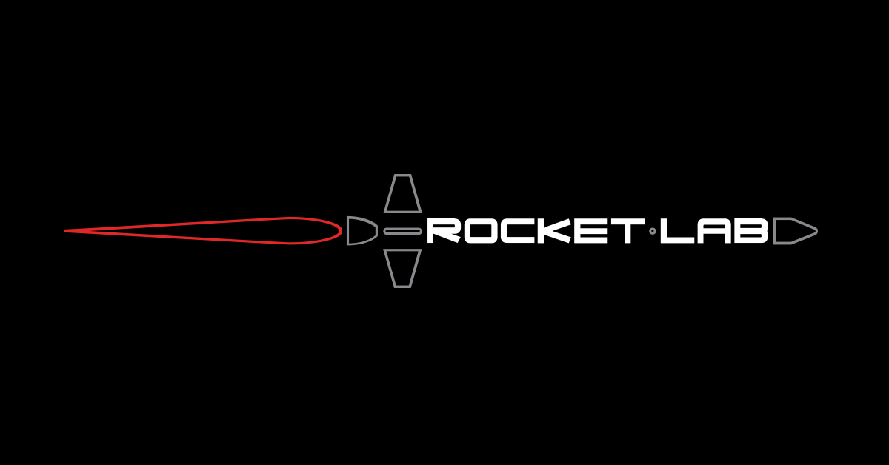
[picture p158: figure]
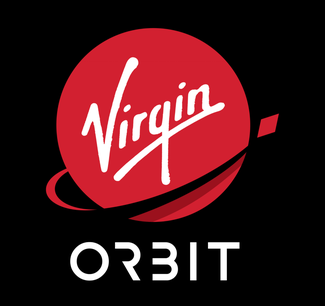
[picture p159: figure]
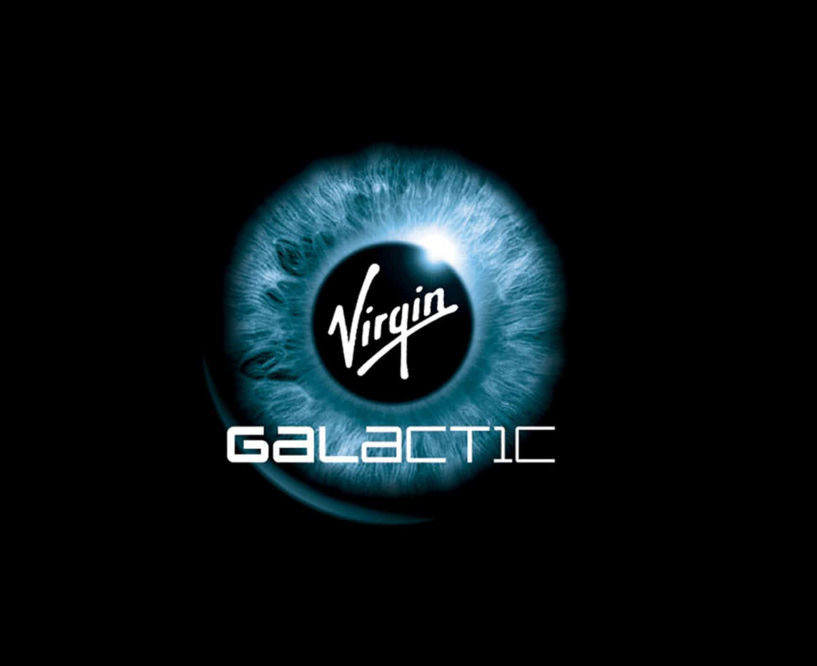
[picture p160: figure]
