Maeswoon/UNHSEDS/Business/Finance/UNH Sponsorship and Grants/CEPS/AY 20-21 Student Org Budget Requests.docx

CEPS Student Organization Budget Request

Cover Page

Budget Year 2020-2021

Date: ____10/1/2020____

Student Organization: Students for the Exploration and Development of Space

Web Site (if available): unhseds.org___

Department Affiliation: Mechanical Engineering_________________________

Student Contact Person: Alex Chesley______________________________

Contact E-mail: amc1150@wildcats.unh.edu______________________

Contact Phone Number: (603) 312-1730_______________________________

Faculty Advisor: Dr. Todd Gross___________________________

Advisor e-mail / phone: Todd.Gross@unh.edu___________________________

Budget Information:

Total Budget for organization / Project: $13,285.10 __________

Requested funds from the Dean’s Office: $4,489.45 __________

Funds received from Departments: ME: $1,200

Expecting $4,000 for Conferences/ Competitions from Departments

(Include funds received from all departments, if any)

Funds in Student Organization Account: $2,061.47 __________

(please include bank or other statement)

Student Representative Signature: ______________________________________

Faculty Advisor Signature: ___________________________________________

An explanation of the organization’s/project’s budget needs to be appended to this cover page. Included in the explanation should be, (1) how the group plans to raise funds in addition to the requests from the CEPS Dean and any CEPS departments, (2) if you are considered a student organization and receiving funds from the Student Activity Fee and (3) how many students are involved in the organization/project. Deadline for submission is September 28, 2020.

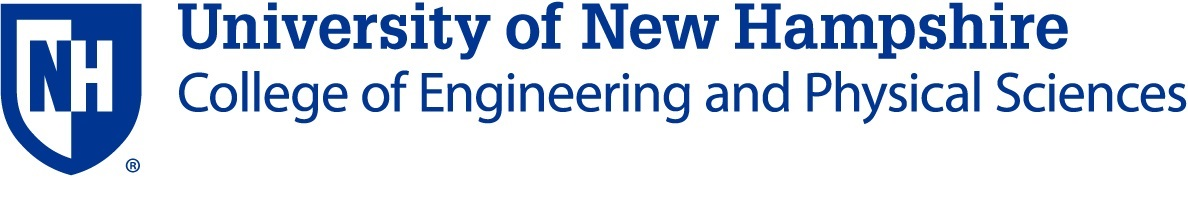
[picture p162: figure]
