Maeswoon/UNHSEDS/Business/Finance/UNH Sponsorship and Grants/CEPS/AY 19-20 Student Org Budget Requests.docx

CEPS Student Organization Budget Request

Cover Page

Budget Year 2019-2020

Date: ____9/3/2019____

Student Organization: Students for the Exploration and Development of Space

Web Site (if available): https://wildcatlink.unh.edu/organization/UNHSEDS___

Department Affiliation: Mechanical Engineering_________________________

Student Contact Person: Charlie Nitschelm______________________________

Contact E-mail: cjn1012@wildcats.unh.edu______________________

Contact Phone Number: (603) 923 – 9079_______________________________

Faculty Advisor: Dr. Todd Gross___________________________

Advisor e-mail / phone: Todd.Gross@unh.edu___________________________

Budget Information:

Total Budget for organization / Project: $32,199.99 __________

Requested funds from the Dean’s Office: $11,101.40 __________

Funds received from Departments: ME: $1,600 – EE: $1,000

Expecting $4,000 for Conferences/ Competitions from Departments

(Include funds received from all departments, if any)

Funds in Student Organization Account: ~$2,000.00 __________

(please include bank or other statement)

Student Representative Signature: ______________________________________

Faculty Advisor Signature: ___________________________________________

An explanation of the organization’s/project’s budget needs to be appended to this cover page. Included in the explanation should be, (1) how the group plans to raise funds in addition to the requests from the CEPS Dean and any CEPS departments, (2) if you are considered a student organization and receiving funds from the Student Activity Fee and (3) how many students are involved in the organization/project. Deadline for submission is September 28, 2020.
