Maeswoon/UNHSEDS/Business/Finance/UNH Sponsorship and Grants/Deans Grant/Budget Cover Page.docx

CEPS Student Organization Budget Request

Cover Page

Budget Year 2018-2019

Date: __________________

Student Organization: ____________________________________________

Web Site (if available): ____________________________________________

Department Affiliation: ____________________________________________

Student Contact Person: ____________________________________________

Contact E-mail: ____________________________________________

Contact Phone Number: ____________________________________________

Faculty Advisor: ____________________________________________

Advisor e-mail / phone: ____________________________________________

Budget Information:

Total Budget for organization / Project: ____________________

Requested funds from the Dean’s Office: ____________________

Funds received from Departments: ____________________

(Include funds received from all departments, if any)

Funds in Student Organization Account: ____________________

(please include bank or other statement)

Student Representative Signature: ______________________________________

Faculty Advisor Signature: ___________________________________________

An explanation of the organization’s/project’s budget needs to be appended to this cover page. Included in the explanation should be, (1) how the group plans to raise funds in addition to the requests from the CEPS Dean and any CEPS departments, (2) if you are considered a student organization and receiving funds from the Student Activity Fee and (3) how many students are involved in the organization/project. Deadline for submission is September 28, 2018.
