Maeswoon/UNHSEDS/Engineering/2019-2020_USURPER/Frame/SOLIDWORKS/Renders/Render Doc Durham Boat.docx

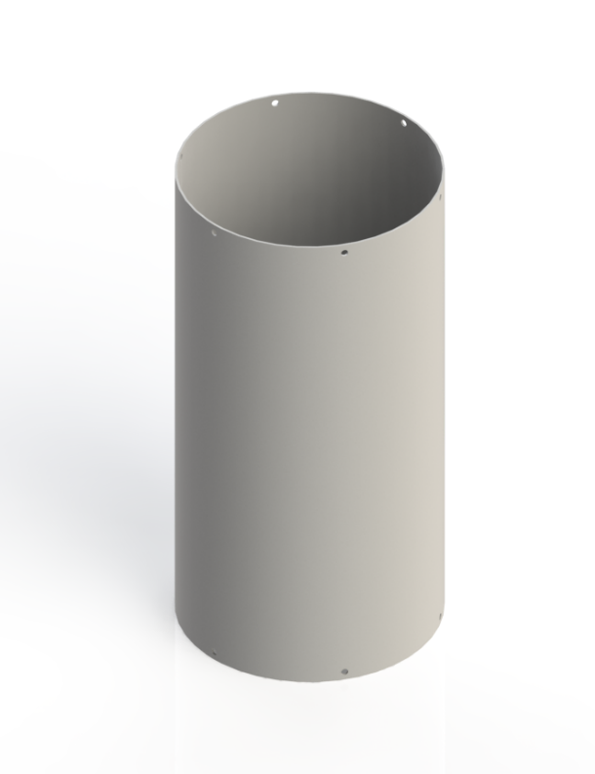
[picture p168: figure]
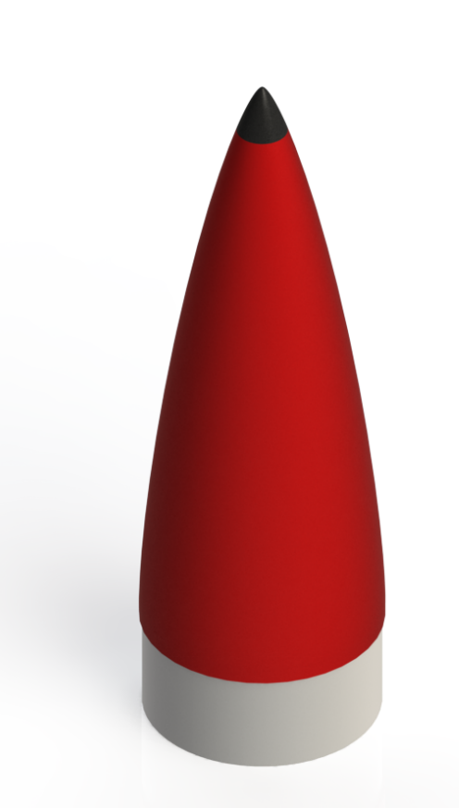
[picture p169: figure]
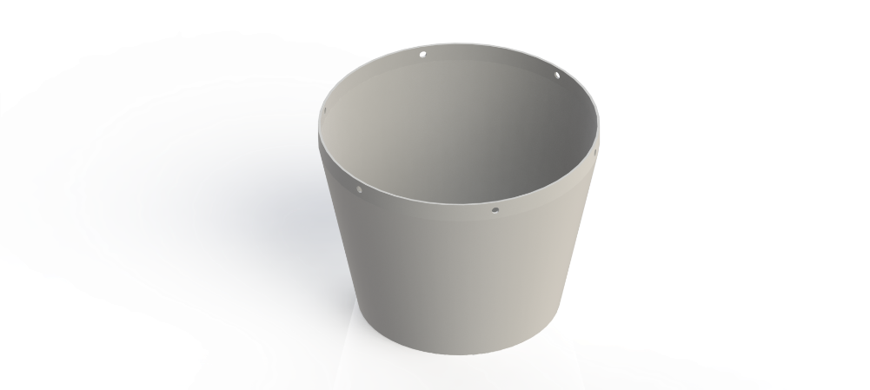
[picture p170: figure]
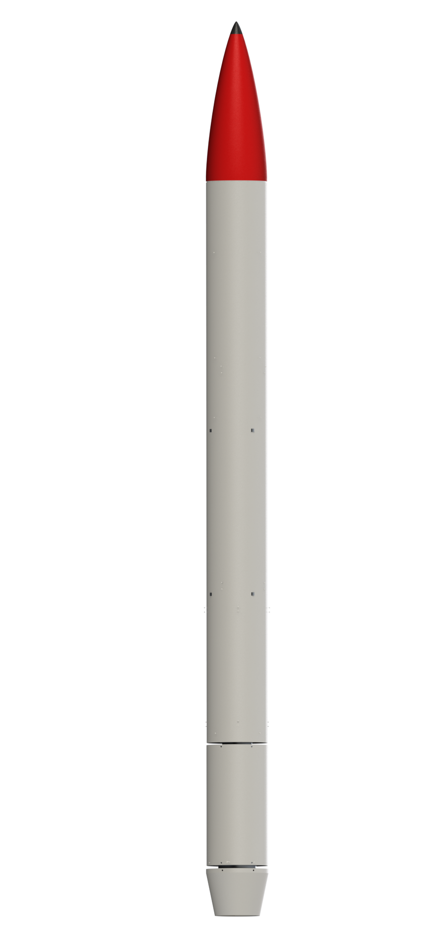
[picture p171: figure]
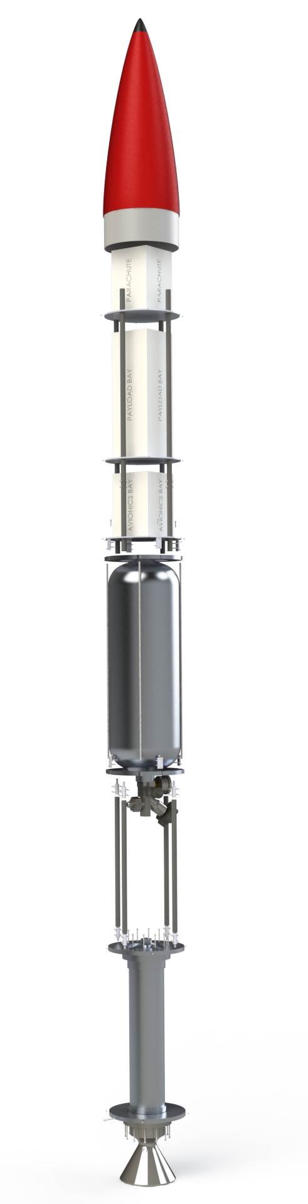
[picture p172: figure]
