Maeswoon/UNHSEDS/Business/Finance/Budgets, Packets and Templates/Packets/TURBOCAM Sponsorship Packet/TURBOCAM INC Presentation - UNH SEDS.pptx

## UNH SEDS


CEPS Engineering Organization
High Power Rocketry

University of New Hampshire
Students for the Exploration and Development of Space

## What is UNH SEDS?

- UNH SEDS (Students for the Exploration and Development of Space)
- Competing in the 2020 Spaceport America Cup Competition, located in New Mexico
- Collegiate Rocketry Organization
- Founded in the Spring of 2017

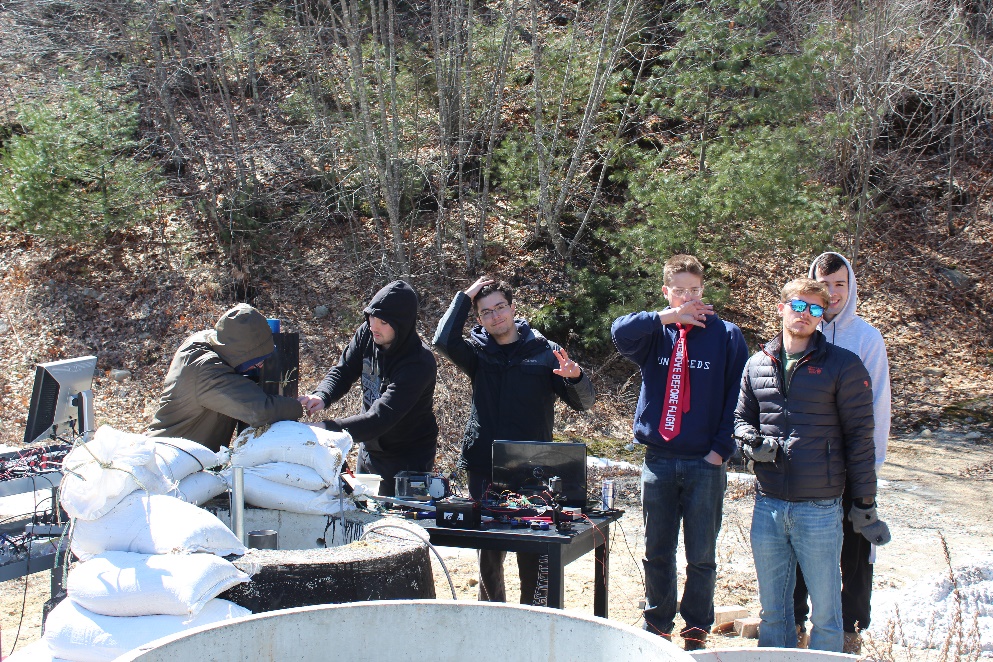
[picture p173: figure]
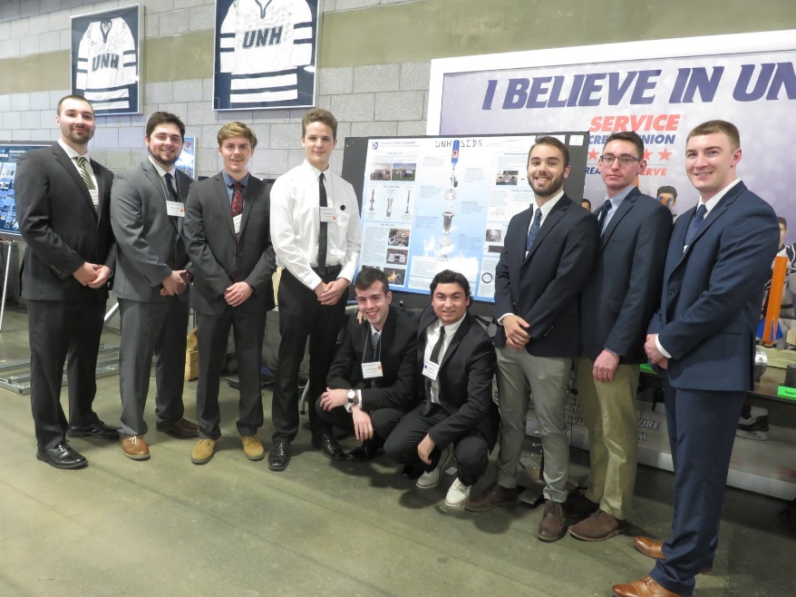
[picture p174: figure]

University of New Hampshire
Students for the Exploration and Development of Space

Notes: Seds is a naitionwide organization that allows colleges from around the world to start a chapter. Although we are allowed to do whatever we would like as an organization, they do sponsor competition for SEDS groups as well as national conferences, the next one for the beginning of November. We are a team comprised of many majors and all classes, so applying to join our team would not only be a senior project, but an interdisciplinary experience.

## Who is UNH SEDS?

Major

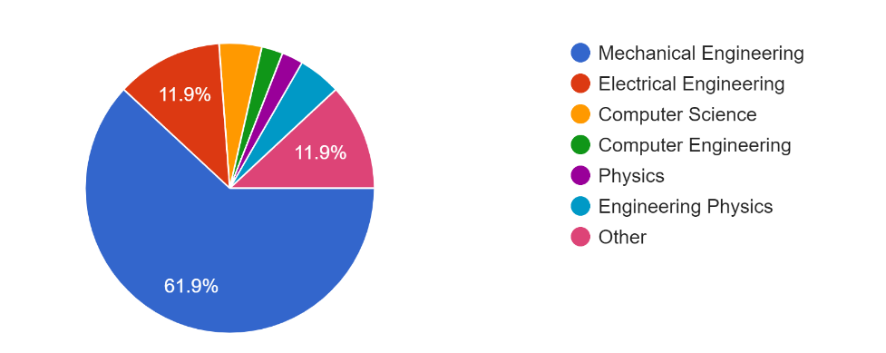
[picture p175: figure]
Forms response chart. Question title: Major . Number of responses: 42 responses.

Year

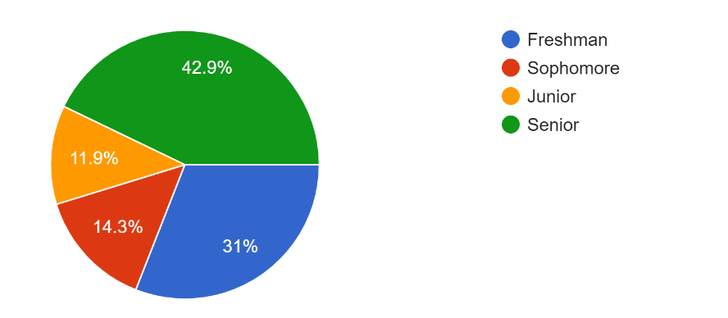
[picture p176: figure]
Forms response chart. Question title: Year. Number of responses: 42 responses.

Membership

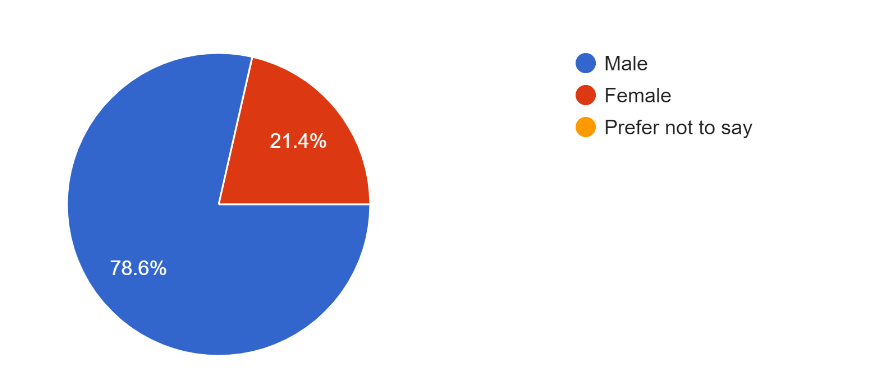
[picture p177: figure]
Forms response chart. Question title: Sex . Number of responses: 42 responses.

University of New Hampshire
Students for the Exploration and Development of Space

Notes: Seds is a naitionwide organization that allows colleges from around the world to start a chapter. Although we are allowed to do whatever we would like as an organization, they do sponsor competition for SEDS groups as well as national conferences, the next one for the beginning of November. We are a team comprised of many majors and all classes, so applying to join our team would not only be a senior project, but an interdisciplinary experience.

## Slide 4

https://www.youtube.com/channel/UCCGet3NkAJHD2hr-q8MuCUg

University of New Hampshire
Students for the Exploration and Development of Space

## Project Overview

- Students for the Exploration and Development of Space (SEDS)
  - Third year organization
  - Design and test a hybrid rocket
  - Applying rocket mechanics from last two years knowledge
- Build, test, analyze, optimize
- Spaceport America Cup - June 2020 in Las Cruces, New Mexico
  - Student researched and developed hybrid class
  - Target apogee 10,000 feet

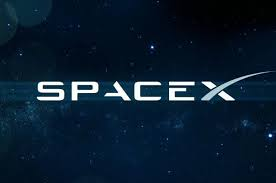
[picture p178: figure]
Image result for spacex logo
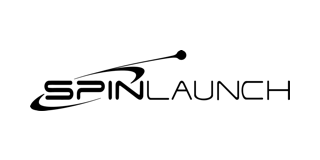
[picture p179: figure]
Related image
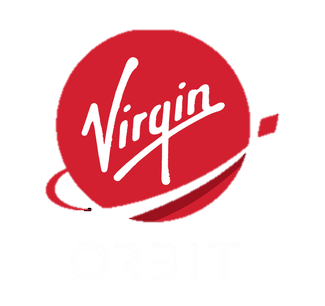
[picture p180: figure]
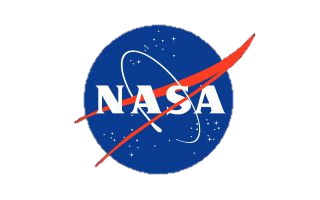
[picture p181: figure]
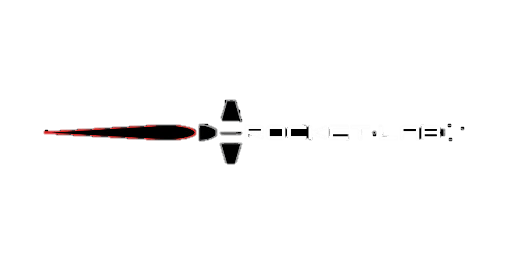
[picture p182: figure]
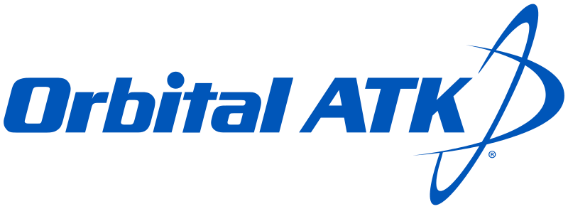
[picture p183: figure]

University of New Hampshire
Students for the Exploration and Development of Space

## SpaceVision Conference

- SEDS USA hosts a national conference every year called ‘SpaceVision’ where many of the various SEDS chapters congregate to network and listen to speakers.
- November 2019 in Arizona State University.
- November 2018, UNH SEDS brought 16 of its members to take part in the 2018 SpaceVision located in San Diego California.


University of New Hampshire
Students for the Exploration and Development of Space

## Community Engagement

University of New Hampshire
Students for the Exploration and Development of Space

SEDS Yuri’s Night!

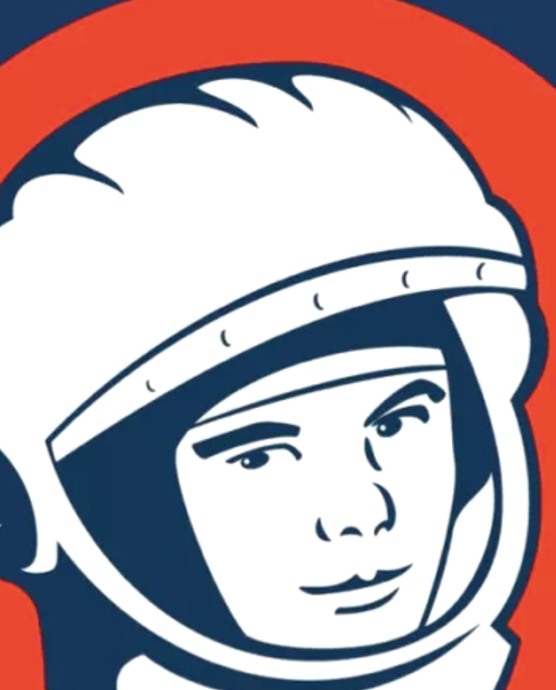
[picture p184: figure]
Image result for yuris night boston
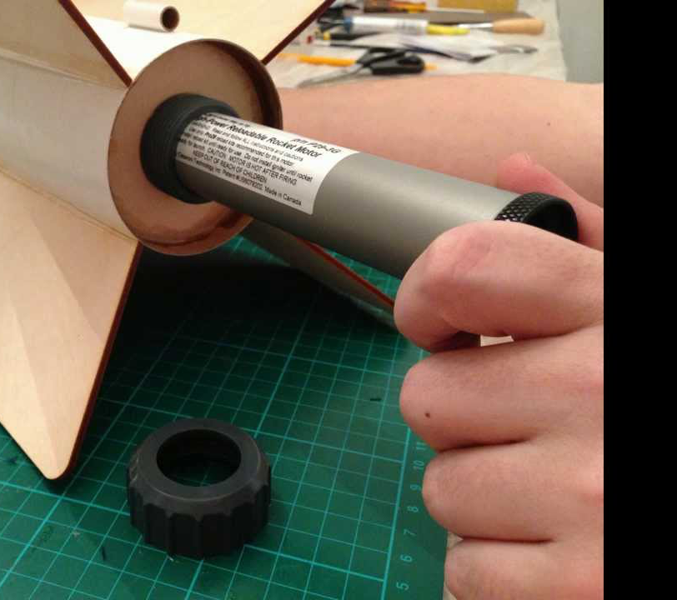
[picture p185: figure]
Image result for estes rocket building

Hybrid Rocket Presentation
Quadcopter Presentation
Matthew Isakowitz Presentation

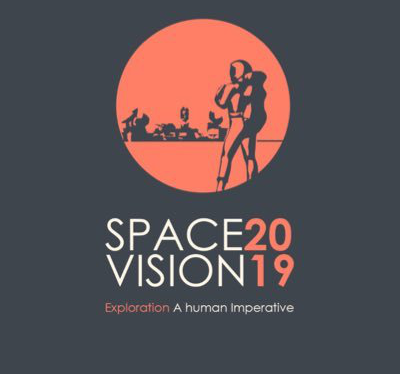
[picture p186: figure]
Image result for spacevision

Rocket Building Workshops
Aerospace Opportunity Presentations
