Maeswoon/UNHSEDS/Business/Finance/w-9 2019.pdf

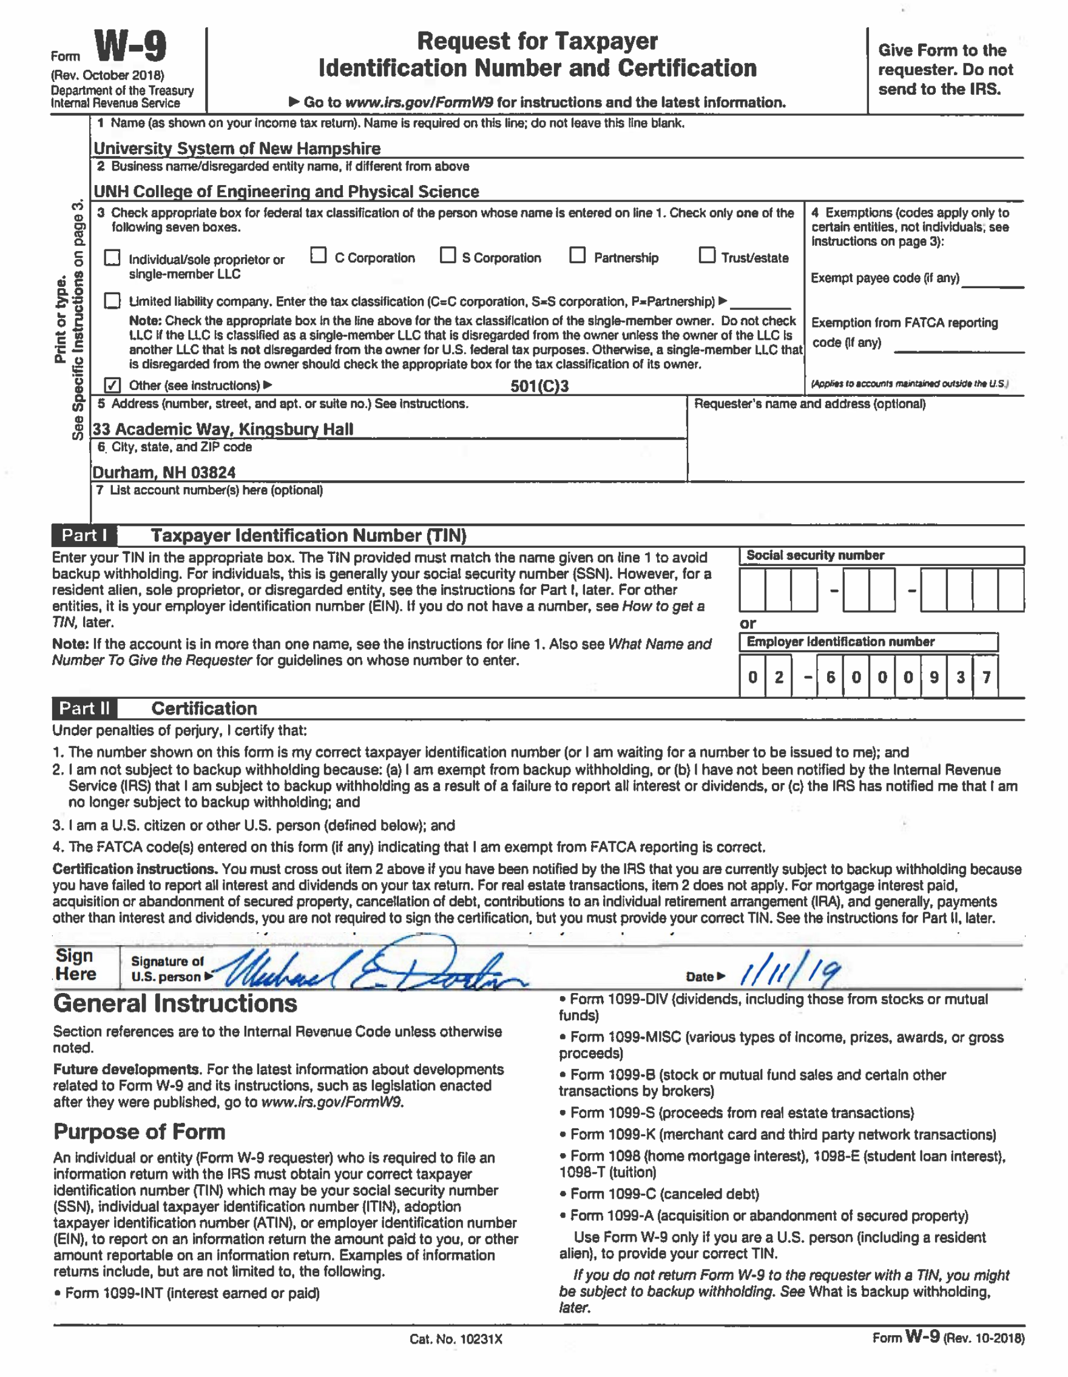
[picture p187: page 1]
