Maeswoon/UNHSEDS/Business/Finance/Sponsorship/UNH SEDS - Sponsorship Packet.pdf

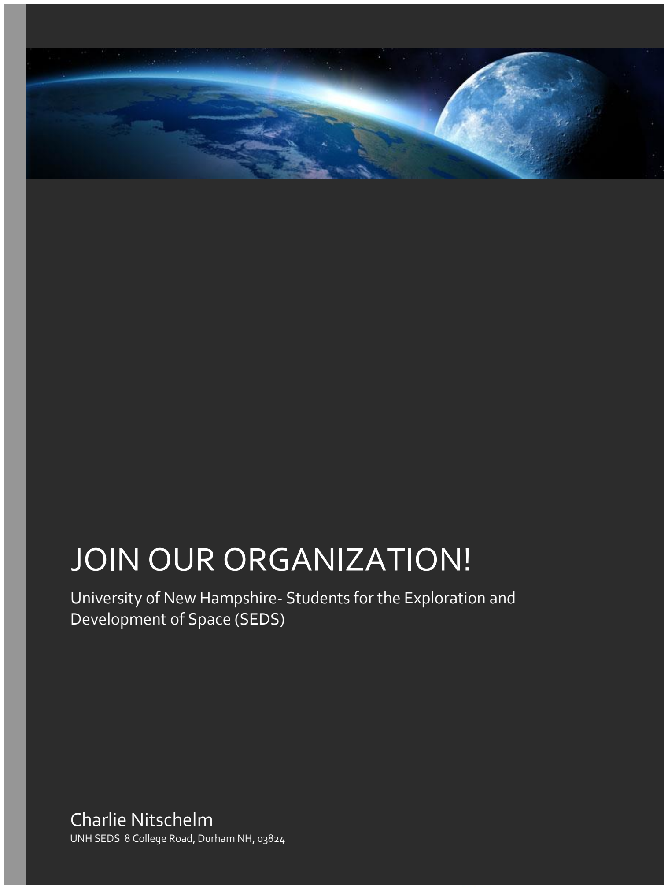
[picture p188: page 1]

0 | P a g e

# JOIN OUR ORGANIZATION!

### University of New Hampshire- Students for the Exploration and Development of Space (SEDS)

## Charlie Nitschelm

UNH SEDS 8 College Road, Durham NH, 03824

1 | P a g e

# UNH SEDS

WHO WE ARE

UNH SEDS is part of a nation-wide organization dedicated to educating students about space exploration and development. UNH SEDS designs and manufactures many engineering projects every year with the goal to give all its members a well-rounded experience, no matter the major.

Founded in February of 2017 and paired with a dedicated faculty advisor along with a committed group of students, we will only grow. As of Fall 2017, we have a committed club roster of over 15 students in four different majors.

Combined with outreach events and a large underclassmen student body, UNH SEDS has potential to grow into an even more efficient and productive organization.

FIRST YEAR GOALS

As UNH SEDS begins to grow, many non-engineering and engineering projects want to be accomplished. Although some SEDS groups across the nation have different focus areas, such as outreach or networking, UNH SEDS is dedicated to pushing the bounds of our current knowledge to design, manufacture and test a wide range of space related technologies. With the combination of determined members and the resources and connections of a nationwide organization we can expand and successfully run a student based organization.

NON-ENGINEERING GOALS

- Establish strong connection with nearby SEDS chapter at other universities.
- Participate in Space Vision hosted by a university each year to connect all nationwide SEDS chapters.
- Establish a comfortable learning environment for all members, no matter the major.
- Plan outreach events to entice more members to join the organization.

ENGINEERING GOALS

- Design, manufacture and test a high-altitude rocket to perform in the SEDS rocketry competition in April each year.
- Host monthly learning sessions to learn a new topic in the subject of astronomy, engineering or business.
- Begin to plan on how we will code, build and manufacture a CubeSat (Named CubeCat of course!).

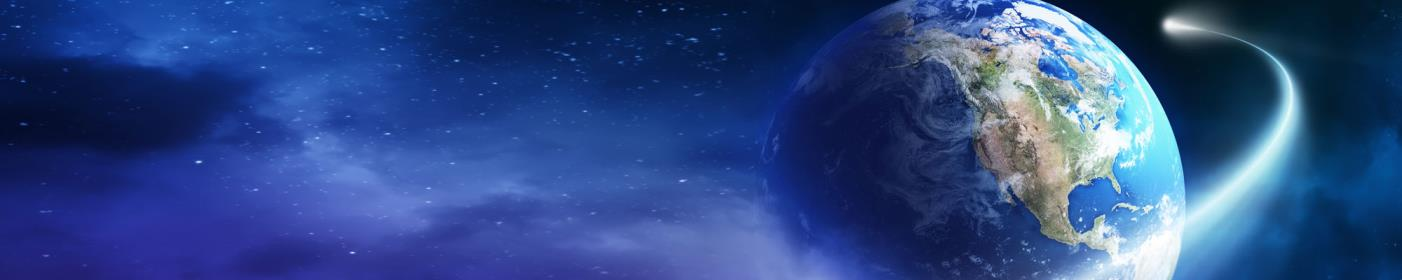
[picture p189: figure]

2 | P a g e

SPONSORSHIP OPPORTUNITIES

Beyond the support provided by the CEPS deans office, UNH SEDS relies heavily on donations from individuals and businesses. Monetary donations are used to purchase and maintain shop equipment, purchase parts, and pay for business and travel expenses. In addition to monetary donations material goods, discounts, and services are also accepted. Service donations allow our team to have professional fabrication beyond the capabilities of our machine shop. Your support demonstrates your commitment to providing aspiring students with invaluable experience and education in a real-world project-based organization as they prepare to move from university work to a job in the industry.

SPONSOR PACKAGES

BRONZE $100-$999

- Advertising at school and local events
- Team shirt logo ¼ the size of platinum
- Team member’s contacts for recruitment
- Logo on the team website

GOLD $2,500-$4,999

- Silver package, plus
- Logo ½ the size of platinum on engineering projects
- Monthly mentions on Facebook and LinkedIn
- Thank you plaque sent at the end of the school year

SILVER $1,000-$2,500

- Bronze package, plus
- Team shirt logo ½ the size of platinum
- Logo ¼ the size of platinum on engineering projects
- Framed picture of all completed projects

PLATINUM $5,000+

- Gold package, plus
- Largest logo on team shirt
- Largest logo on all engineering projects
- Invited to all outreach events with free admission
