Maeswoon/UNHSEDS/Business/Finance/UNH Sponsorship and Grants/Alumni Grant/Application.pdf

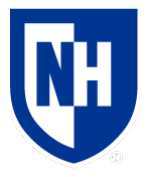
[picture p190: figure]

## 2018-2019 UNH Alumni Association Student Grant Application Form

Award Amount - $3,000 maximum

Deadline:
Application submissions:

End of day February 4, 2019
Email a single pdf to: corena.garnas@unh.edu
- If possible provide all answers in this application, but attach any additional exhibits or supporting information where necessary.
- The application must be typed and filled out completely. Late submissions will not be accepted.
- All grant writers are strongly encouraged to consult with staff of the Connors Writing Center
when developing proposals: Room 329 of the Diamond Library (https://www.unh.edu/writing/cwc).

APPLICANT’S NAME: Ross Thyne

APPLICANT’S YEAR AT UNH: Junior

APPLICANT’S EMAIL: rdt1002@wildcats.unh.edu

ORGANIZATION: Students for the Exploration and Development of Space
Or confirm if you are applying as an individual
(Please spell out acronym)

Total Amount of Funds Requested: $2,554.00
(A complete and detailed budget for this proposal must be attached)
1. Please note the desired work start date for you or your organization under this grant so we can fund in a timely manner. Funds are requested as soon as they are available. Funds will be going towards sustaining the ongoing engineering efforts of the club.
2. Please describe what you and/or your organization does or intends to do, and how this will fulfill the mission of the UNH Alumni Association Grant (see UNH Alumni Association Student Grant Committee Charter): Our club is currently, designing, fabricating, and testing our own hybrid rocket engine and rocket for use as a senior design project and for a national rocketry competition. Whereas the charter seeks to fund, "extracurricular activities and/or extraordinary student needs that otherwise would not be provided for," our request seeks to empower the students of this group to work on projects that would otherwise be too expensive to sustain without outside funding.

3. Please briefly describe your project proposal; this is the synopsis that will be given to the committee making the funding decisions. (Attach additional page(s) as necessary): The purpose of this project is to provide students in our group the opportunity to design, manufacture and test their own self made hybrid rocket engines. We currently have our first prototype made with a diameter of 6 inches. Rocket science is experimental, and each test lets us dive deep into the physics on what makes an engine produce thrust. With each test, we are given the data to converge on the most optimized geometry possible. With each test, come material, manufacturing and testing costs. The funds we are requesting from this grant would enable us to continue our work and learn more about rocketry, as it is all of our dreams to one day work for the top aerospace companies in the country. Each test and launch we have done have become more and more popular for UNH students to attend. If we are able to continue our work with your donation, we can continue this trend and inspire and teach UNH students that miracle of rocketry, and the importance of space exploration.
4. Please explain how the outcome of your work as an individual or organization will fulfill the mission of the grant provided by the UNH Alumni Association Grant Committee which is to enrich the student experience at UNH and help promote UNH nationally and internationally. The purpose of this club and its activities is to promote a love for space, science, engeineering, and mathematics. Through use of the requested funds, students in our group will have a chance to apply things that they are learning inside the classroom to projects outside of the classroom, which may have been the inspiring factor for us to become engineers in the first place. Beyond the obvious technical and hands on experience that students gain within the club, our efforts have been directly translated to opportunities outside of UNH. Many students in our club have transferred their work to jobs and careers, citing their club experience as the deciding factor in their hiring process. The club also competes in national competitions, promoting UNH across the country as a flagship school of sciences.
5. Do you or does your organization receive any funds from UNH or the Student Activity Fee Committee? If so, please provide the source, amount and nature (i.e., one-time or budgeted) of those funds. Are you contributing any of these funds to this project? Why or Why not? $3500 UNH $1625 SAFC All of these funds, less those allocated for the purpose of outreach, are being applied to this project. As a relatively new club at the University, we are starting with larger group based projects that involve every member in some capacity. As a result of that, most of our funds our directed singularly into one endeavor, albeit a complex one.

6. What sources and amounts of other non-UNH financial and/or non-financial support have you or your organization requested for this proposal: Our organization has made sponsorship agreements with various local business that has awarded us approximately $3,500 in funding so far. On top of that, we receive some free machining hours at Turbocam International.
7. What is the number of students served by this proposal (directly & indirectly): 45
8. If only partial funding was awarded, would your proposal remain viable? | Yes | [x] No

Please remember to include the following information in your proposal:

1. Proposal for the use of funds – include all program specifics and a timeline.
2. Budget – a detailed budget is required for the proposal to be considered
3. Any background information that would inform the Grant Committee about your organization and its purpose.

Applicant’s Signature:

Date:

Students & Student Groups must have a Faculty or Administrative Sponsor Signature.

Sponsor’s name:

Sponsor’s signature: | Date:

Sponsor’s phone:

Sponsor’s comments:
