Maeswoon/UNHSEDS/Engineering/Propulsion/Concept/Simulations/FlightSimData.csv

# Time (s) | Altitude (ft) | Total velocity (ft/s) | Air temperature (°F) | Air pressure (psi)
0.002 | -0 | 0.059 | 59 | 14.696
0.004 | -0 | 0.05 | 59 | 14.696
0.006 | -0 | 0.04 | 59 | 14.696
0.008 | -0 | 0.031 | 59 | 14.696
0.01 | -0 | 0.021 | 59 | 14.696
0.012 | -0 | 0.012 | 59 | 14.696
0.014 | -0 | 0.002 | 59 | 14.696
0.016 | 0 | 0.008 | 59 | 14.696
0.018 | 0 | 0.025 | 59 | 14.696
0.02 | 0 | 0.051 | 59 | 14.696
0.022 | 0 | 0.088 | 59 | 14.696
0.024 | 0 | 0.134 | 59 | 14.696
0.026 | 0.001 | 0.189 | 59 | 14.696
0.028 | 0.001 | 0.254 | 59 | 14.696
0.03 | 0.002 | 0.329 | 59 | 14.696
0.032 | 0.003 | 0.413 | 59 | 14.696
0.034 | 0.003 | 0.507 | 59 | 14.696
0.036 | 0.005 | 0.61 | 59 | 14.696
0.038 | 0.006 | 0.723 | 59 | 14.696
0.04 | 0.007 | 0.845 | 59 | 14.696
0.042 | 0.009 | 0.978 | 59 | 14.696
0.044 | 0.011 | 1.119 | 59 | 14.696
0.046 | 0.014 | 1.271 | 59 | 14.696
0.048 | 0.017 | 1.432 | 59 | 14.696
0.05 | 0.02 | 1.602 | 59 | 14.696
0.052 | 0.023 | 1.782 | 59 | 14.696
0.054 | 0.027 | 1.972 | 59 | 14.696
0.056 | 0.031 | 2.171 | 59 | 14.696
0.058 | 0.035 | 2.38 | 59 | 14.696
0.06 | 0.04 | 2.599 | 59 | 14.696
0.062 | 0.046 | 2.827 | 59 | 14.696
0.064 | 0.052 | 3.065 | 59 | 14.696
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
