Maeswoon/UNHSEDS/Engineering/Propulsion/Concept/Simulations/HRAP_SimData_v1.0.csv

Time (s) | Thrust (N) | Oxidizer Tank Pressure (kPa) | Combustion Chamber Pressure (kPa) | Injector Pressure Drop (kPa) | Oxidizer Mass (kg) | Fuel Mass (kg) | Oxidizer Mass Flow Rate (kg/s) | Fuel Mass Flow Rate (kg/s) | Exhaust Mass Flow Rate (kg/s) | Oxidizer to Fuel Ratio | Grain ID (cm) | Regression Rate (mm/s)
0 | 0 | 4136.84 | 101.325 | 0 | 5.2519327 | 1.42336 | 0 | 0 | 0 | 0 | 6.096 | 0
0.001 | 0 | 4136.84 | 156.03804 | -1.1503587 | 5.2471255 | 1.4228195 | 4.807161 | 0.54047346 | 0.078054473 | 8.8943516 | 6.0980576 | 0.01028779
0.002 | 0 | 4135.6896 | 210.21261 | -1.1346858 | 5.2423516 | 1.4222811 | 4.7739725 | 0.53837935 | 0.12005104 | 8.8673024 | 6.1001065 | 0.010244471
0.003 | 0 | 4134.5549 | 263.77561 | -1.1270589 | 5.2376107 | 1.4217448 | 4.7408781 | 0.53628497 | 0.16154427 | 8.8402219 | 6.1021467 | 0.010201191
0.004 | 53.31276 | 4133.4279 | 316.68683 | -1.1194015 | 5.2329028 | 1.4212106 | 4.7079208 | 0.534193 | 0.20249182 | 8.8131458 | 6.1041783 | 0.010158
0.005 | 136.01057 | 4132.3085 | 368.92236 | -1.1117804 | 5.2282276 | 1.4206785 | 4.6751284 | 0.53210523 | 0.24287614 | 8.7860973 | 6.1062013 | 0.010114932
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
