Maeswoon/UNHSEDS/Business/Finance/UNH Sponsorship and Grants/SAFC/SAFC_UNH_SEDS_Proposal_SpaceVision_2019.xlsx

 |  |  |  |  | Organization Name |  | Event Name
 |  |  |  |  | UNH SEDS |  | SpaceVision
 |  |  |  |  | Event Date: | November 7th | Location: |  | Tempe, AZ
 |  |  |  |  | Time: |  | PPR Due: |  | November 21st
Proposed Expenses |  |  |  |  | Amount | Amended Expenses |  |  |  |  | Amount
SpaceVision
Airplane Ticket |  |  |  |  | $8432
Hotel Housing (3 Nights) |  |  |  |  | $2175
Admission to the SEDS Conference |  |  |  |  | $1795
Food and General Travel |  |  |  |  | $1350
Total Expenses |  |  |  |  | 13752.00 | Total Expenses: |  |  |  |  | 0.00
Attendance: |  |  |  |  |  | Attendance:
Students | 20 | @ | $414 | = | $8280 | Students | 0 | @ | $0 | = | $0
Non-Students | - | @ | $0 | = | $0 | Non-Students | 0 | @ | $0 | = | $0
Additional Revenue |  |  |  |  | $4175 | Additional Revenue
Total Revenue |  |  |  |  | $12455 | Total Revenue |  |  |  |  | $0
Total SAF Subsidy |  |  |  |  | $1297 | Total SAF Subsidy |  |  |  |  | $0.00
Cost Per Student |  |  |  |  | $64.85 | Cost Per Student |  |  |  |  | #DIV/0!
Organization/Event Information
Primary Contact: | Charlie Nitschelm |  |  |  |  | Secondary Contact: | Ross Thyne
Email: | cjn1012@wildcats.unh.edu |  |  |  |  | Email: | rdt1002@wildcats.unh.edu
Notice: The Post-Programming Report for this event is due two weeks after the event has concluded, or until all receipts have come in. Please email SAF.CFO1@unh.edu or SAF.CFO2@unh.edu if you have any questions about the Proposal or PPR process.
