Maeswoon/UNHSEDS/Archive/Reports and Presentations/Reports/2018-2019/Spaceport Attempt/Fall 2018/Entry_Form_UNHSEDS.xlsx

 |  | Spaceport America Cup Intercollegiate Rocket Engineering Competition Entry Form & Progress Update
Color Key |  |  | SRAD = Student Researched and Designed |  |  |  |  |  | v19.1
IMPOTANT CHANGE EFFECTIVE IMMEDIATELY FOR SA CUP 2019 EVENT All inputs are mandatory for all submitions of this document. We undestand some data may change over time, this is completely acceptable.
Feel free to add additional commanets where needed, and be sure to fill out the last page. Treat the last page as a "cover letter" for your project.
Date Submitted: |  | 2018-11-11
 |  |  |  |  |  | Country: | United States of America
 | Team ID: |  | * You will receive your Team ID after you submit your 1st project entry form. |  |  | State or Province: | New Hampshire
 |  |  |  |  |  |  | State or Province is for US and Canada
Team Information
Rocket/Project Name: |  |  | Runaway
Student Organization Name |  |  | University of New Hampshire: Students for the Exploration and Development of Space
College or University Name: |  |  | University of New Hampshire
Preferred Informal Name: |  |  | UNH SEDS
Organization Type: |  |  | Club/Group
Project Start Date |  |  | 2018-09-01 |  |  |  | *Projects are not limited on how many years they take*
Category: |  |  | 10k – SRAD – Hybrid/Liquid & Other
Member |  | Name |  |  | Email |  |  | Phone
Student Lead |  | Charlie Nitschelm |  |  | cjn1012@wildcats.unh.edu |  |  | 603-923-9079
Alt. Student Lead |  | Thomas Collins |  |  | twc1001@wildcats.unh.edu |  |  | 603-828-9643
Faculty Advisor |  | Todd Gross |  |  | todd.gross@unh.edu |  |  | 603-862-2445
Alt. Faculty Adviser
For Mailing Awards:
Payable To: |  | University of New Hampshire: Students for the Exploration and Development of Space
Address Line 1: |  | 33 Acedemic Way, Room W101, Durham NH 03824
Address Line 2:
Address Line 3:
Address Line 4:
Address Line 5:
Demographic Data |  |  |  |  |  | STEM Outreach Events
This is all members working with your project including those not attending the event. This will help ESRA and Spaceport America promote the event and get more sponsorships and grants to help the teams and improve the event. |  |  |  |  |  | We will be hosting model rocketry programs for K-8 next semester during school.
Number of team members
High School | 0 |  | Male | 22
Undergrad | 25 |  | Female | 4
Masters | 1 |  | Veterans | 0
PhD | 0 |  | NAR or Tripoli | 1
Just a reminder the you are not required to have a NAR, Tripoli member on your team. If your country has an equivelant organization to NAR or Tripoli, you can cant them in the NAR or Tripoli box. CAR from Canada is an example.
Rocket Information
Overall rocket parameters:
 |  |  | Measurement |  | Additional Comments (Optional)
Airframe Length (inches): |  |  |  |  | Rocket dimensions are TBD
Airframe Diameter (inches):
Fin-span (inches):
Vehicle weight (pounds):
Propellent weight (pounds):
Payload weight (pounds):
Liftoff weight (pounds):
Number of stages: |  |  | 1
Strap-on Booster Cluster:
Propulsion Type: |  |  | Hybrid
Propulsion Manufacturer: |  |  | Combination
Kinetic Energy Dart:
Propulsion Systems: (Stage: Manufacturer, Motor, Letter Class, Total Impulse)
1st Stage: SRAD Hybrid, XX pounds of HTPB and YY pounds of nitrous oxide, L Class (estimated), (~7,500)
Total Impulse of all Motors: |  |  | ~7,500 |  | (Ns)
Predicted Flight Data and Analysis
The following stats should be calculated using rocket trajectory software or by hand.
Pro Tip: Reference the Barrowman Equations, know what they are, and know how to use them.
 |  |  |  |  | Measurement |  | Additional Comments (Optional)
Launch Rail: |  |  |  |  | ESRA Provide Rail
Rail Length (feet): |  |  |  |  | 17
Liftoff Thrust-Weight Ratio: |  |  |  |  |  |  | All rocket characteristics are TBD
Launch Rail Departure Velocity (feet/second):
Minimum Static Margin During Boost:
Maximum Acceleration (G):
Maximum Velocity (feet/second):
Target Apogee (feet AGL): |  |  |  |  | 10K
Predicted Apogee (feet AGL):
Payload Information
Payload Description:
We are in the process of exploring ideas to research and make practical use of our payload. Current ideas are measurements in pressure with respect to altitude, and atmosphere composistion with respect to altitude.
Recovery Information
In order to ensure safe recovery of the rocket, a parachute will be deployed at apogee. Dual deploy will be considered if recovery would be an issue if the descent speed is too slow.
Planned Tests |  |  |  |  | * Please keep brief
Date | Type | Description |  |  |  | Status | Comments
2018-12-01 | Ground | Cold Static Test Fire |  |  |  | TBD | In process of manufacturing the injector
2018-12-08 | Ground | Hot Static Test Fire |  |  |  | TBD | In process of building the test rig
Any other pertinent information:
The SEDS program at the University of New Hampshire focuses mainly on rocketry. Although this club is fairly new, it has accomplished quite a bit. It started by creating simple single stage rockets to develop skills and a better understanding on how to simulate, create and optimize rockets. Once many simple single stage rockets had successfully launchedwith recovery we wanted to further challenge ourselves by graduating into multistage rockets. In the Fall of 2018 our multistage rocket had a successful launch. In search of a new challenge, we decided to design and manufacture our own hybrid rocket engine. During the end of 2018, a series of static test fires will be analyzed and studied to perfect the performance of the engine. Also, simulations and models will be created using the data from those static test fires to predict our flight. In the spring, optimizing the engine and finalizing the rocket design will be the final goal to complete our hybrid rocket. Competing in the Spaceport America cup will be a great experience.
 |  |  |  |  | End of File
