Maeswoon/UNHSEDS/Archive/Reports and Presentations/Reports/2017-2018/USRC 2018/Launch Report/Aether4 Simulation/USRC_TeleMega_Flight_Data.csv

#version | serial | flight | call | time | rssi | lqi | state | state_name | acceleration | pressure | altitude | height | accel_speed | baro_speed | temperature | drogue_voltage | main_voltage | battery_voltage | accel_x | accel_y | accel_z | gyro_x | gyro_y | gyro_z | mag_x | mag_y | mag_z | tilt | pyro | igniter_a | igniter_b | igniter_c | igniter_d | connected | locked | nsat | latitude | longitude | altitude | year | month | day | hour | minute | second | pad_dist | pad_range | pad_az | pad_el | pdop | hdop | vdop | sat01 | sat02 | sat03 | sat04 | sat05 | sat06 | sat07
6 | 4225 | 18 | Aether4 | -1.77 | -85 | 7 | 3 | boost | -0.00 | 101289.00 | 3.00 | -1.25 | 0.00 | 0.00 | 27.5 | 4.02 | 0.00 | 4.05 | 10.01 | 0.41 | 0.20 | 0.18 | 1.10 | -0.61 | -0.08 | -0.19 | 0.05 | 4.00 | 4.03 | 0.00 | 4.02 | 0.00 | 0.00 | 1 | 1 | 4 | 43.3191798 | -70.8913700 | 83.0 | 2018 | 9 | 29 | 15 | 57 | 56 | 0 | 0 | 140 | 0 | 4.3 | 2.0 | 3.8 | 0 | 0 | 0 | 0 | 0 | 0 | 0
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
