Maeswoon/UNHSEDS/Archive/Engineering/2018-2019/Project Runaway/Cold Test/NEW Injector designs/1/Flow Trajectories 1.xlsx

disk_design_5.SLDPRT [Shower Design]
Velocity (Y) [m/s]
Trajectory Length [m] | Flow Trajectories 1_1
-0.002084806866 | -910.0249516
-0.002043323849 | -909.9848048
-0.002003340215 | -909.9461135
-0.001963356581 | -909.9074266
-0.001923372948 | -909.868744
-0.001883389314 | -909.8300658
-0.00184340568 | -909.7913918
-0.001803422047 | -909.7527222
-0.001763438413 | -909.7140568
-0.001723454779 | -909.6753957
-0.001683471146 | -909.6367388
-0.001639488401 | -909.5860424
-0.001595502198 | -909.4567217
-0.001551515996 | -909.3274178
-0.001507529793 | -909.1981309
-0.001463543591 | -909.0688607
-0.001419557389 | -908.9396075
-0.001375571186 | -908.810371
-0.001331584984 | -908.6811514
-0.001287598781 | -908.5519486
-0.001243612579 | -908.4227626
-0.001199626376 | -908.2935933
-0.001155640081 | -908.1224347
-0.001111653778 | -907.9474914
-0.001067667475 | -907.7725714
-0.001023681171 | -907.5976749
-0.0009796948679 | -907.4228019
-0.0009357085645 | -907.2479525
-0.0008917222611 | -907.0731268
-0.0008477359576 | -906.8983248
-0.0008037496541 | -906.7235466
-0.0007597633506 | -906.5487924
-0.0007197758024 | -906.3901696
-0.0006757894996 | -906.2158046
-0.0006318031968 | -906.0414616
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
