Maeswoon/UNHSEDS/Business/Finance/Budgets, Packets and Templates/Packets/PicturesForFinancePacket/20181103_133818.jpg

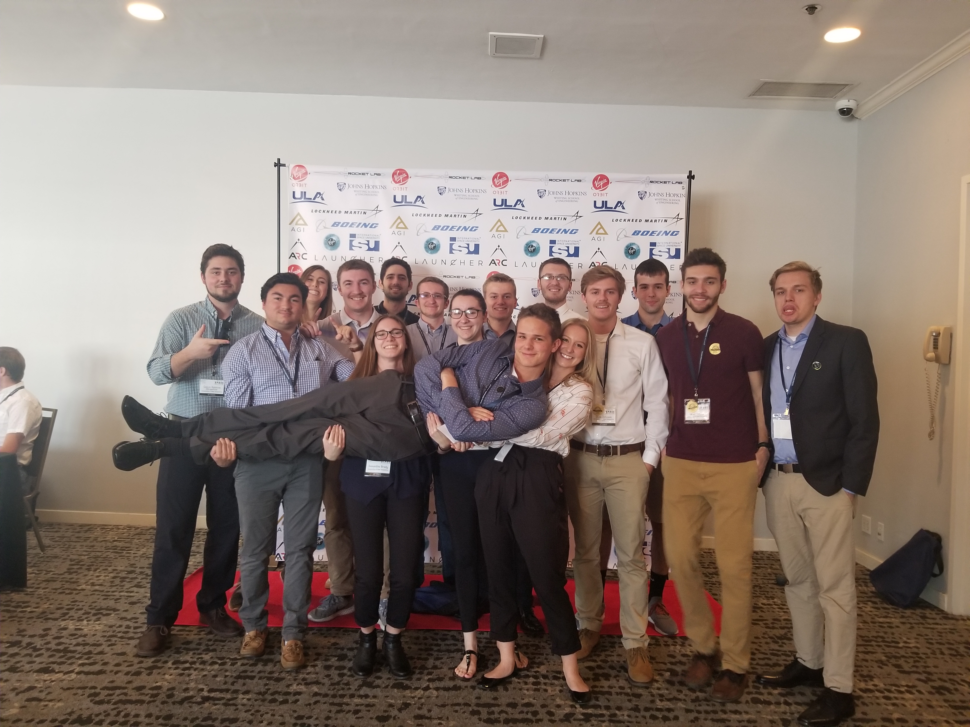
Business/Finance/Budgets, Packets and Templates/Packets/PicturesForFinancePacket/20181103_133818.jpg
