Maeswoon/UNHSEDS/Business/Finance/Budgets, Packets and Templates/Packets/PicturesForFinancePacket/42792509_1927373774014195_8434479345937940480_o.jpg

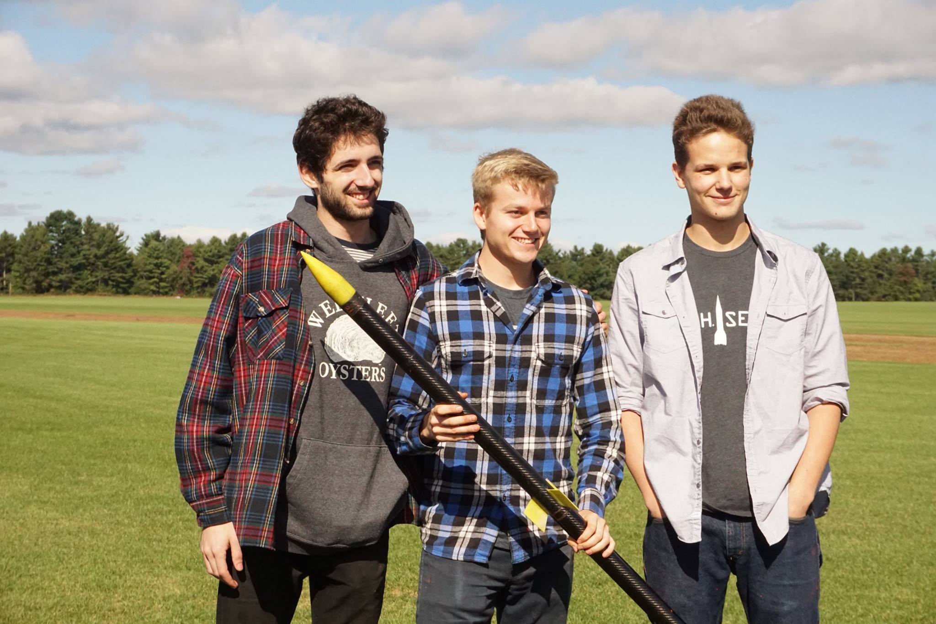
Business/Finance/Budgets, Packets and Templates/Packets/PicturesForFinancePacket/42792509_1927373774014195_8434479345937940480_o.jpg
