Maeswoon/UNHSEDS/Business/Finance/Budgets, Packets and Templates/Packets/PicturesForFinancePacket/42823309_1927374520680787_939415051075321856_o.jpg

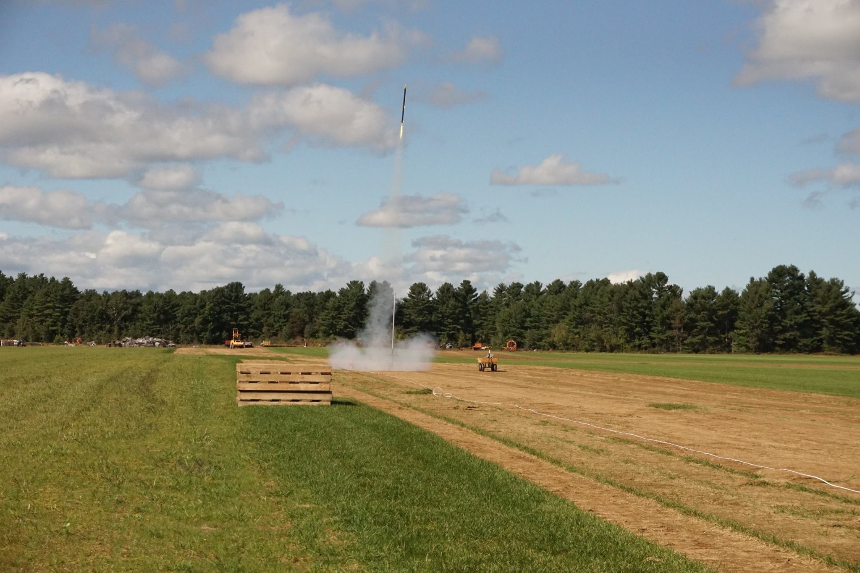
Business/Finance/Budgets, Packets and Templates/Packets/PicturesForFinancePacket/42823309_1927374520680787_939415051075321856_o.jpg
