Maeswoon/UNHSEDS/Business/Finance/Budgets, Packets and Templates/Packets/PicturesForFinancePacket/44468154_2189846604586296_8867727226959822848_n.jpg

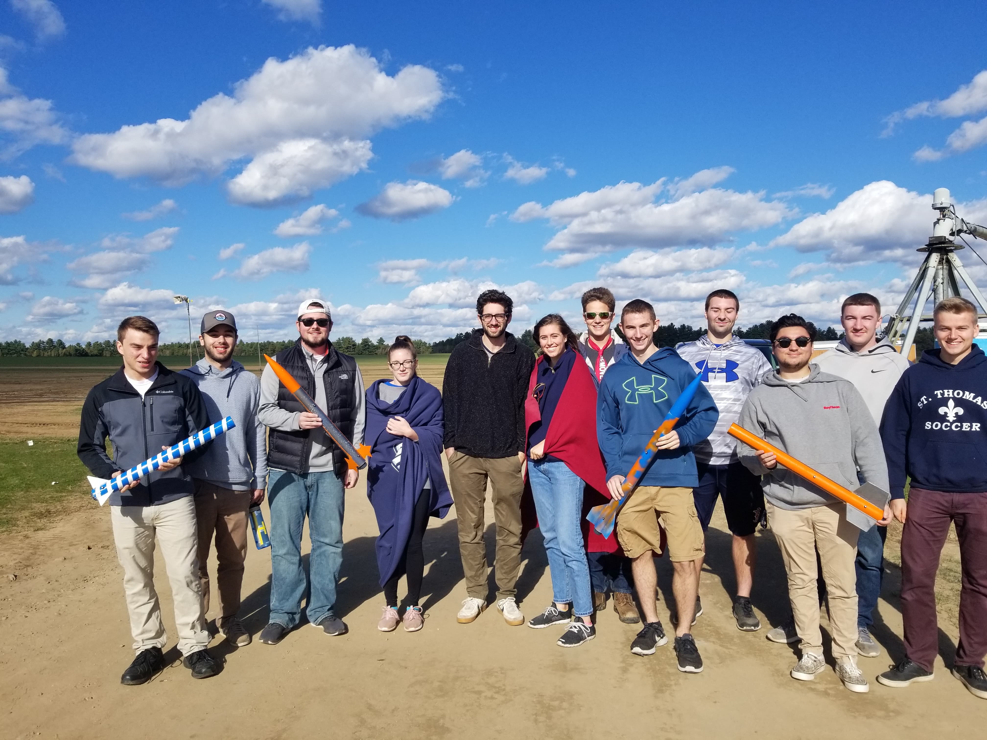
Business/Finance/Budgets, Packets and Templates/Packets/PicturesForFinancePacket/44468154_2189846604586296_8867727226959822848_n.jpg
