Maeswoon/UNHSEDS/Business/Finance/Budgets, Packets and Templates/Packets/PicturesForFinancePacket/h6XaNKVI_400x400.jpg

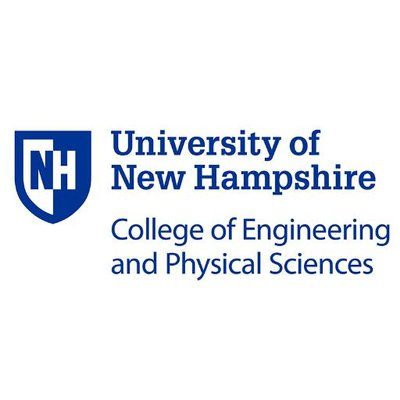
Business/Finance/Budgets, Packets and Templates/Packets/PicturesForFinancePacket/h6XaNKVI_400x400.jpg
