Maeswoon/UNHSEDS/Business/Organization/OutsideBoard/Companies/NASA.jpg

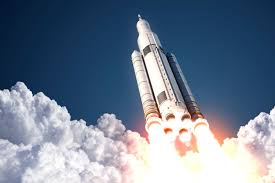
Business/Organization/OutsideBoard/Companies/NASA.jpg
