Maeswoon/UNHSEDS/Business/Organization/OutsideBoard/Companies/Northrop.jpg

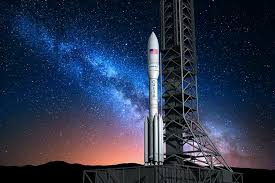
Business/Organization/OutsideBoard/Companies/Northrop.jpg
