Maeswoon/UNHSEDS/Business/Organization/OutsideBoard/Companies/VirginOrbit.jpg

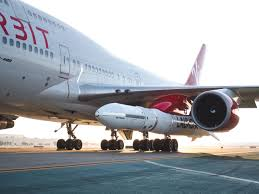
Business/Organization/OutsideBoard/Companies/VirginOrbit.jpg
