Maeswoon/UNHSEDS/Business/Organization/OutsideBoard/Pictures/20190208_010846000_iOS.png

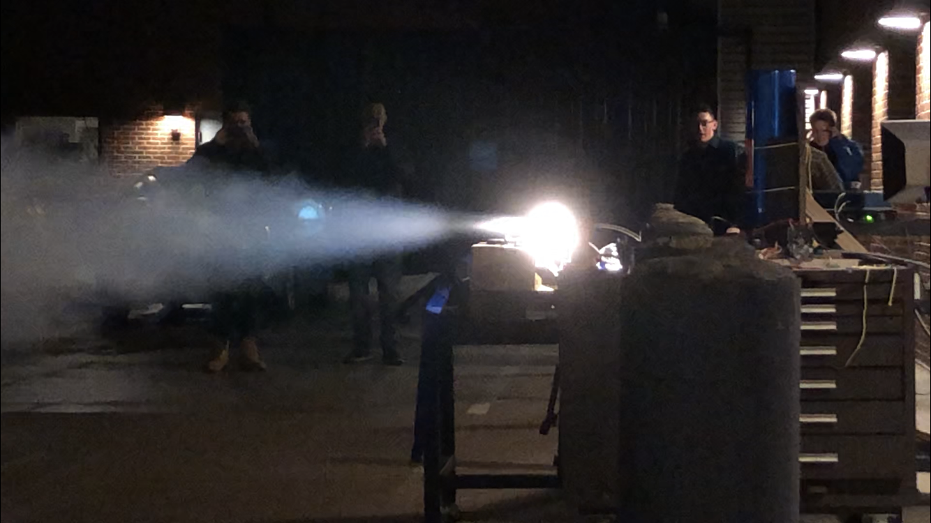
Business/Organization/OutsideBoard/Pictures/20190208_010846000_iOS.png
