Maeswoon/UNHSEDS/Business/Organization/OutsideBoard/Pictures/20190306_184455468_iOS.jpg

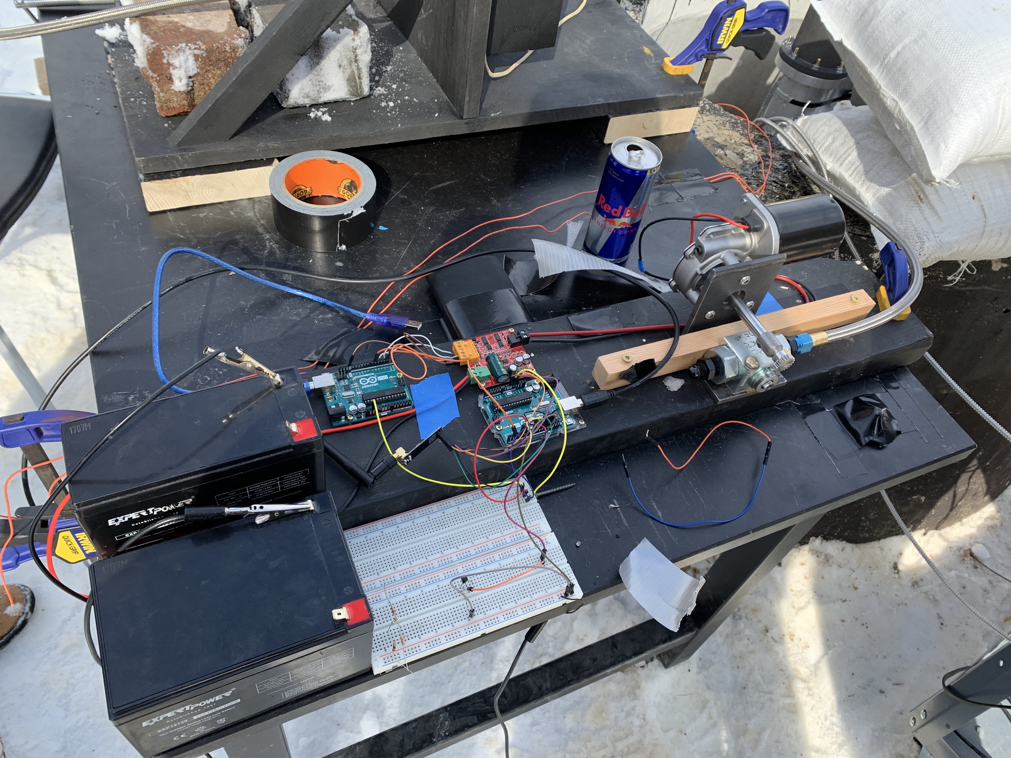
Business/Organization/OutsideBoard/Pictures/20190306_184455468_iOS.jpg
