Maeswoon/UNHSEDS/Business/President Achrives/Simulations/aether4model.png

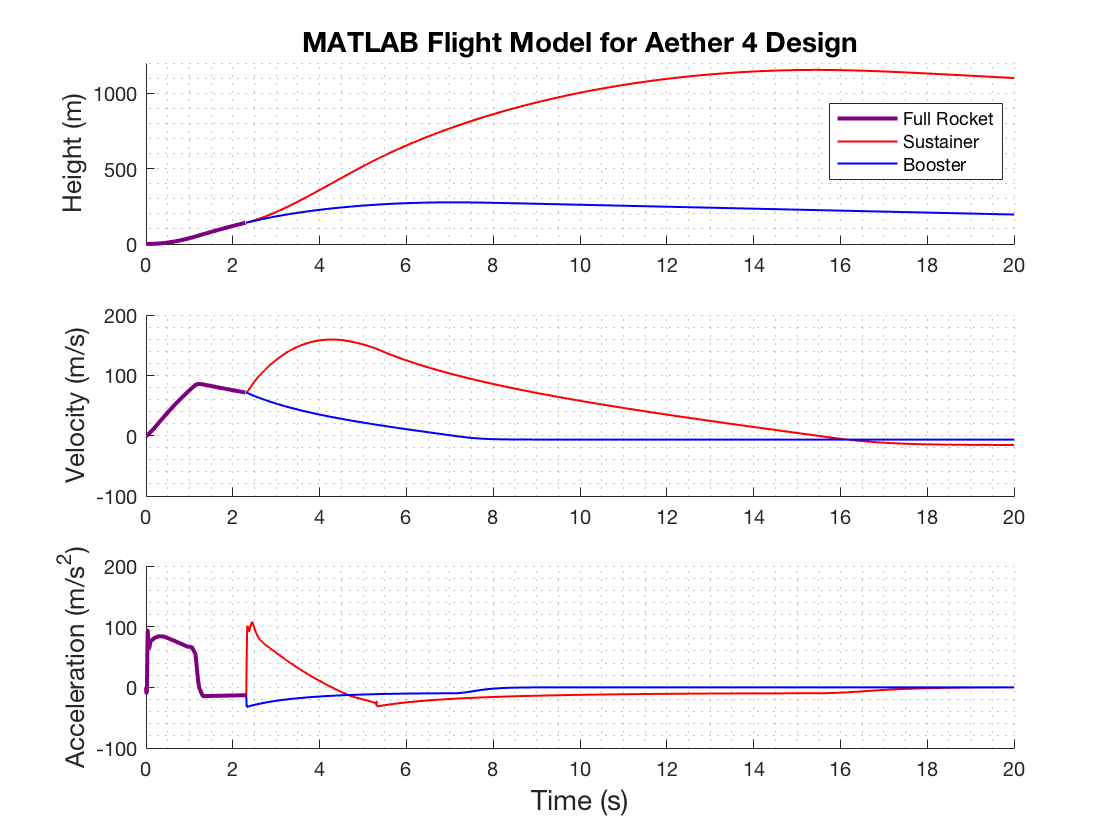
Business/President Achrives/Simulations/aether4model.png
