Maeswoon/UNHSEDS/Business/President Achrives/Simulations/cal.png

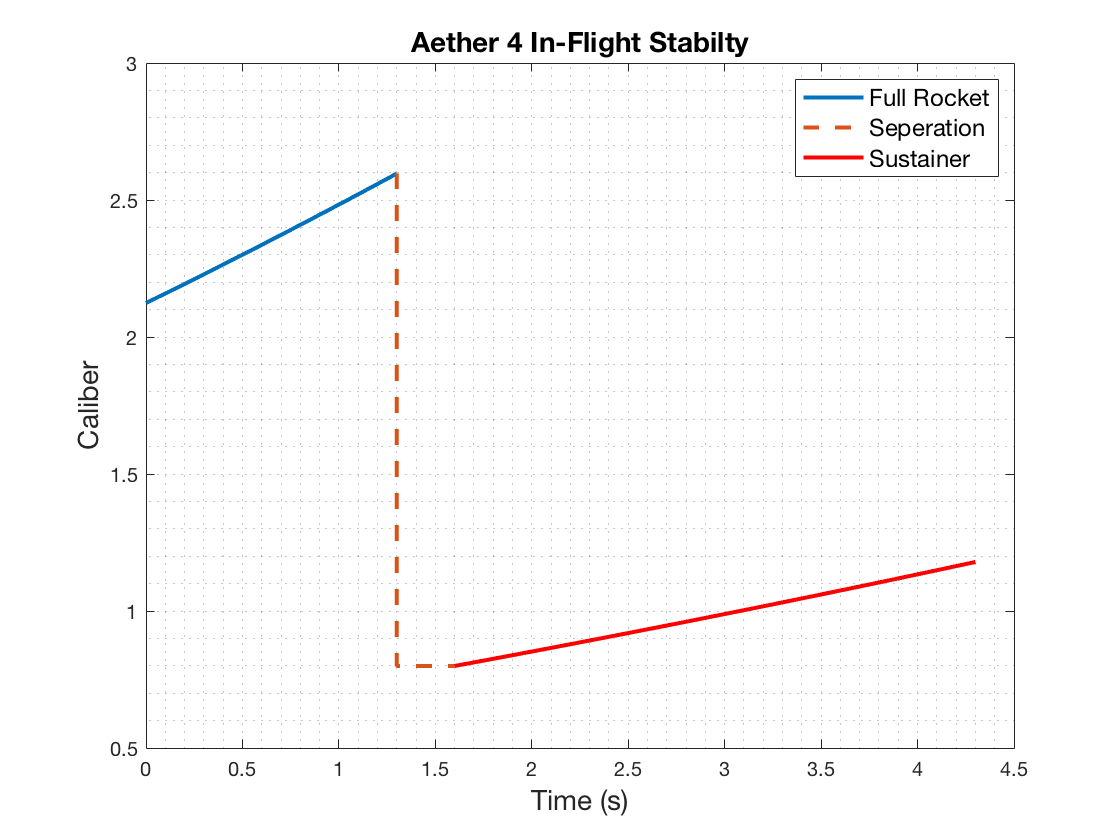
Business/President Achrives/Simulations/cal.png
