Maeswoon/UNHSEDS/Engineering/2018-2019/Project Gimbal/Gimbal 4-2-2019/actuator/Firgelli L16.png

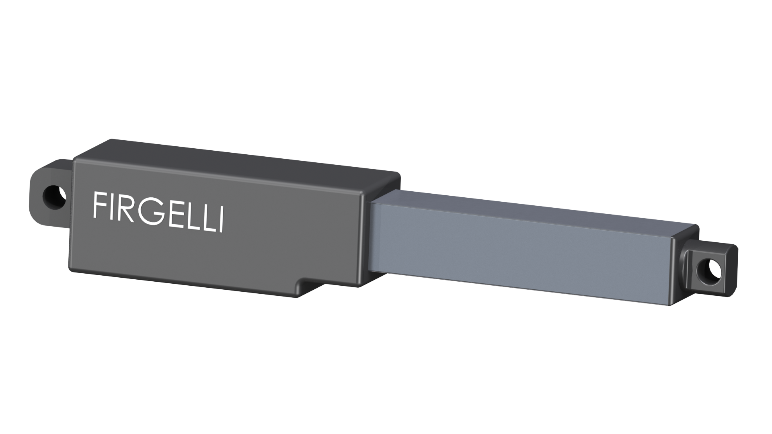
Engineering/2018-2019/Project Gimbal/Gimbal 4-2-2019/actuator/Firgelli L16.png
