Maeswoon/UNHSEDS/Engineering/2019-2020_USURPER/Avionics/Board Files/Adjust Jumper Wire Length SolidWorks.jpg

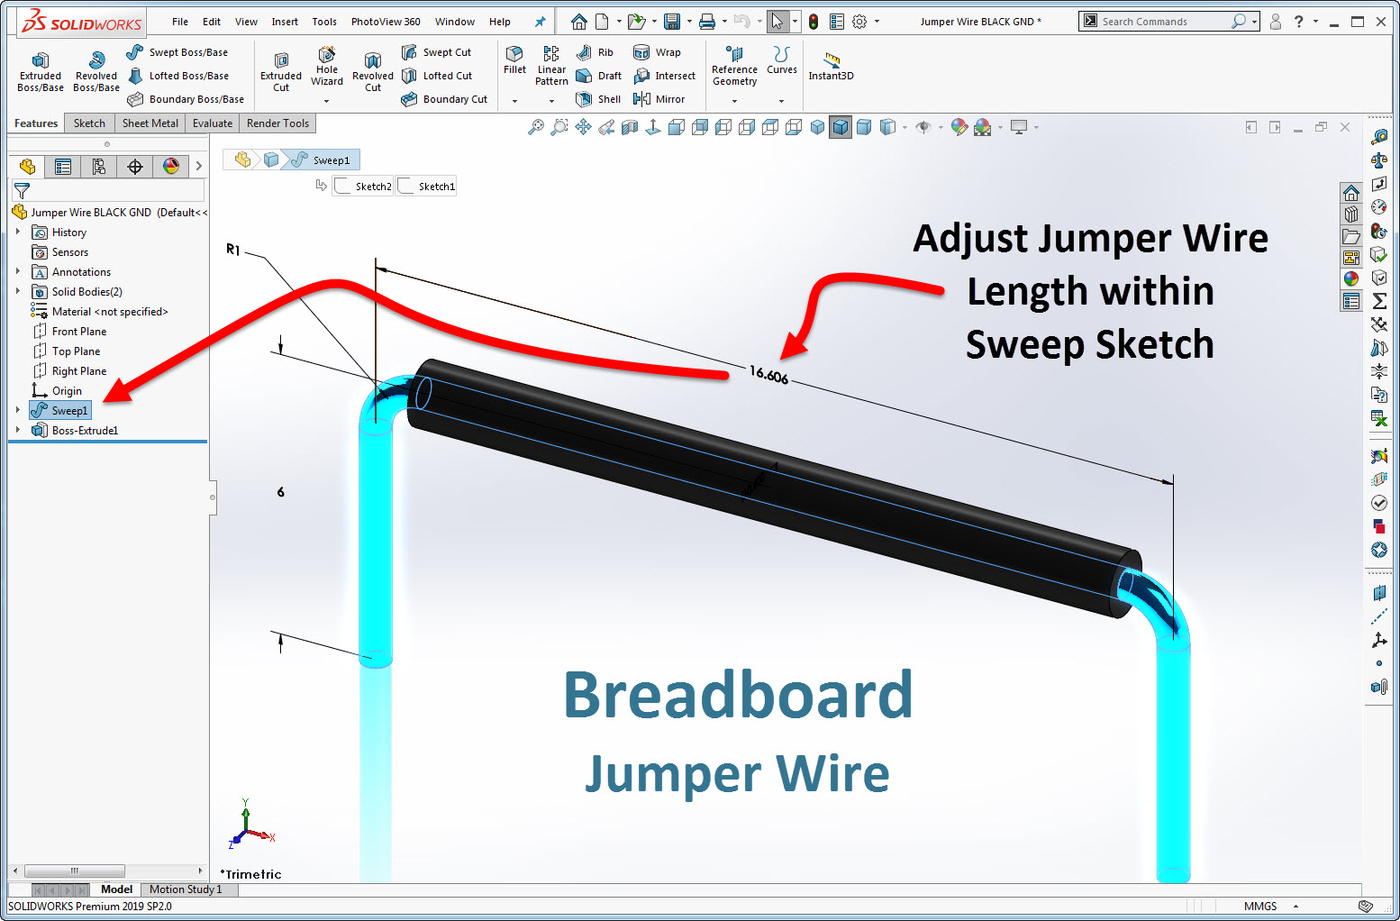
Engineering/2019-2020_USURPER/Avionics/Board Files/Adjust Jumper Wire Length SolidWorks.jpg
