Maeswoon/UNHSEDS/Engineering/2019-2020_USURPER/Avionics/Board Files/Arduino MEGA 2560 R3 Image-2.jpg

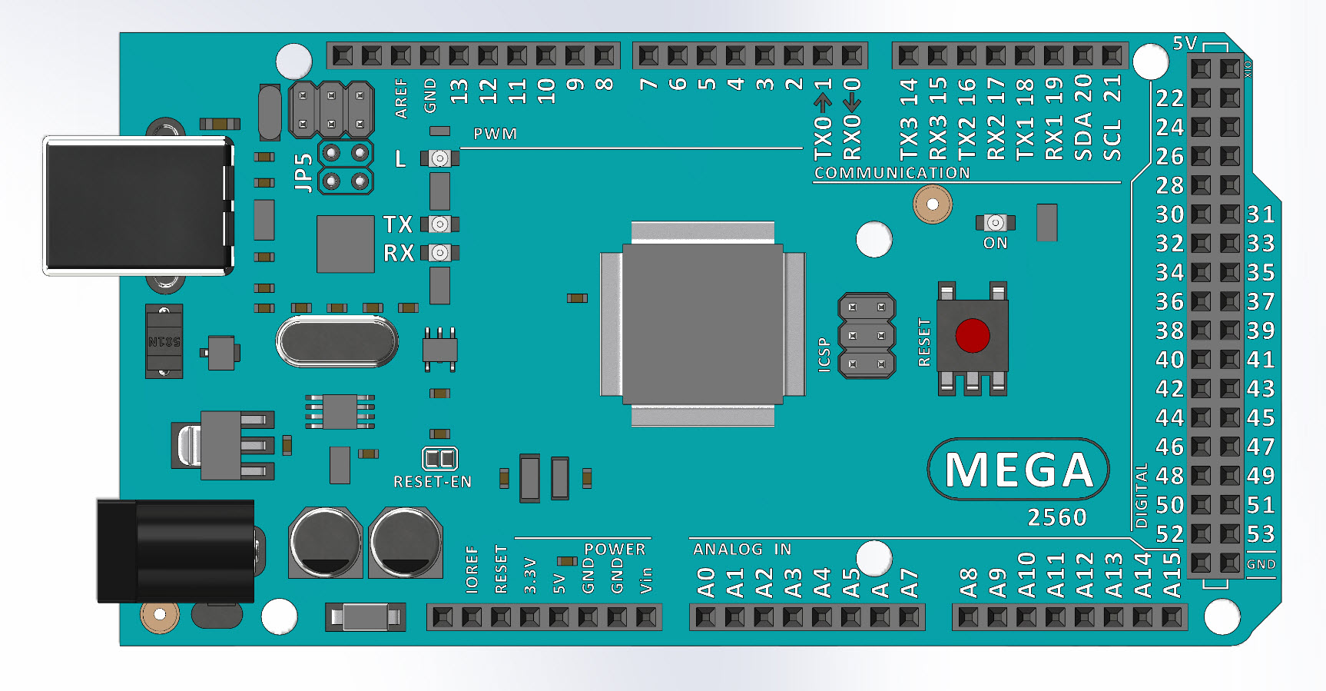
Engineering/2019-2020_USURPER/Avionics/Board Files/Arduino MEGA 2560 R3 Image-2.jpg
