Maeswoon/UNHSEDS/Engineering/2019-2020_USURPER/Avionics/Board Files/Arduino Modules Render-01.JPG

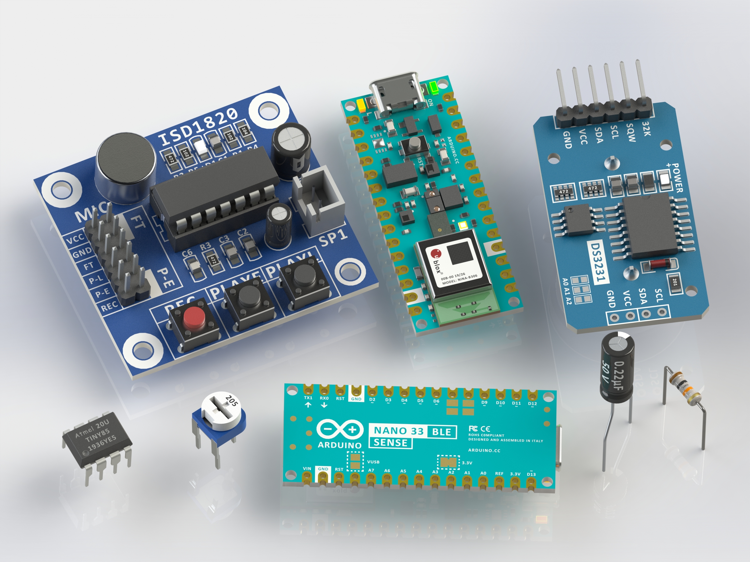
Engineering/2019-2020_USURPER/Avionics/Board Files/Arduino Modules Render-01.JPG
