Maeswoon/UNHSEDS/Engineering/2019-2020_USURPER/Avionics/Board Files/Arduino Modules SolidWorks.jpg

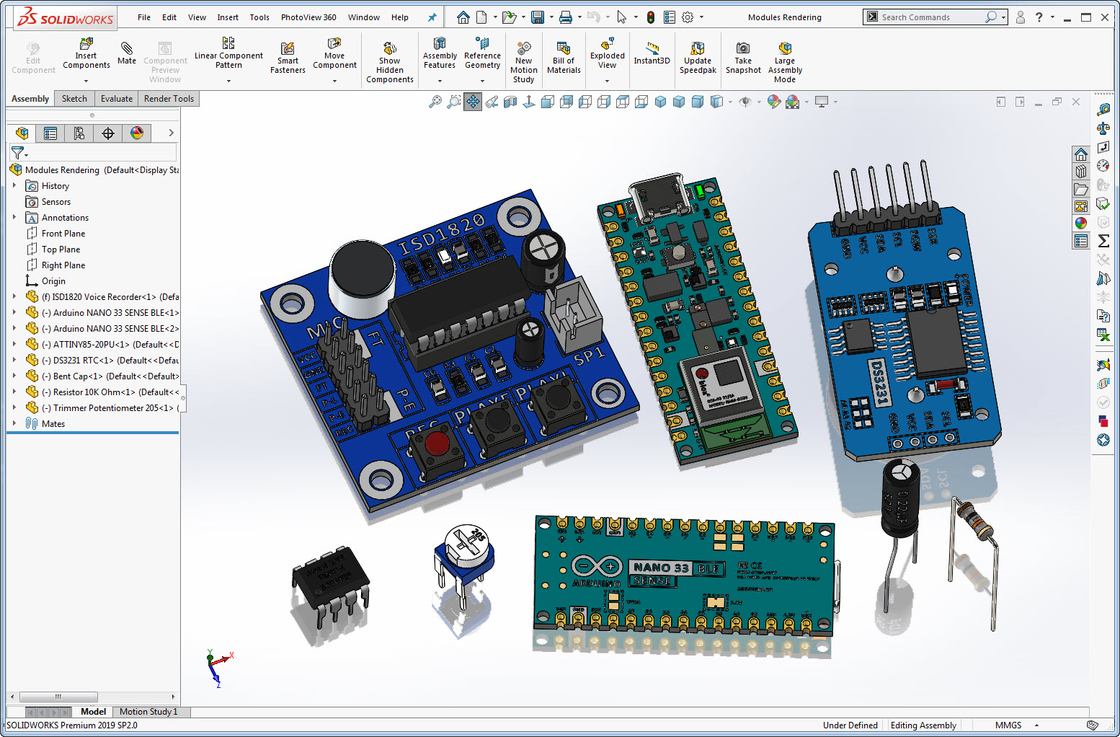
Engineering/2019-2020_USURPER/Avionics/Board Files/Arduino Modules SolidWorks.jpg
