Maeswoon/UNHSEDS/Engineering/2019-2020_USURPER/Avionics/Board Files/Arduino NANO 33 SENSE BLE FRONT.JPG

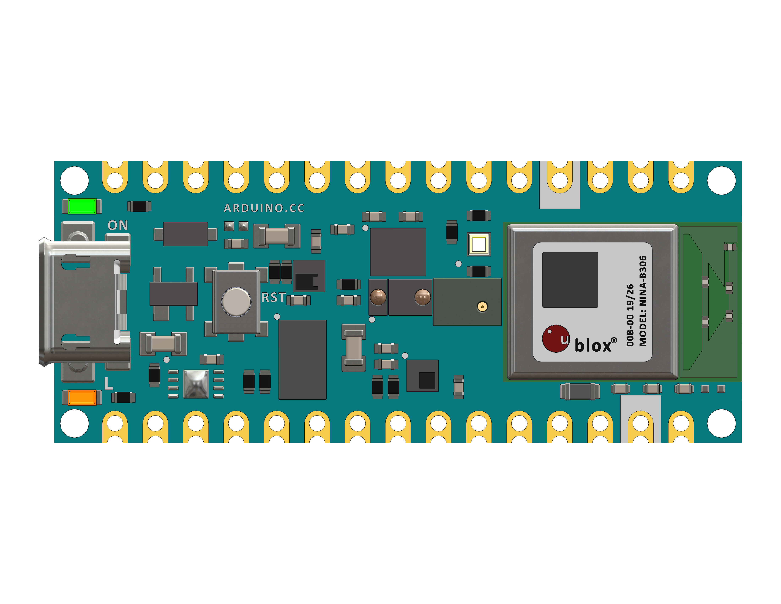
Engineering/2019-2020_USURPER/Avionics/Board Files/Arduino NANO 33 SENSE BLE FRONT.JPG
