Maeswoon/UNHSEDS/Engineering/2019-2020_USURPER/Avionics/Board Files/Arduino NANO 33 SENSE BLE Render-01.JPG

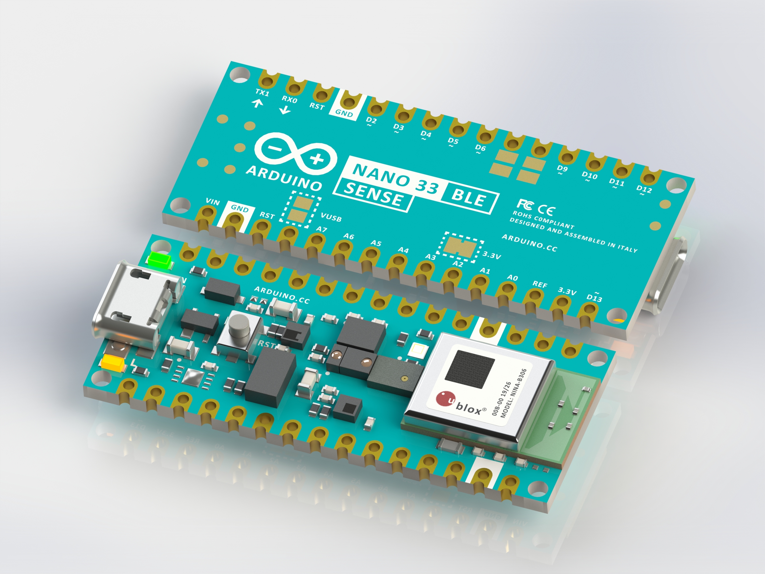
Engineering/2019-2020_USURPER/Avionics/Board Files/Arduino NANO 33 SENSE BLE Render-01.JPG
