Maeswoon/UNHSEDS/Engineering/2019-2020_USURPER/Avionics/Board Files/Arduino UNO R3 PNG.PNG

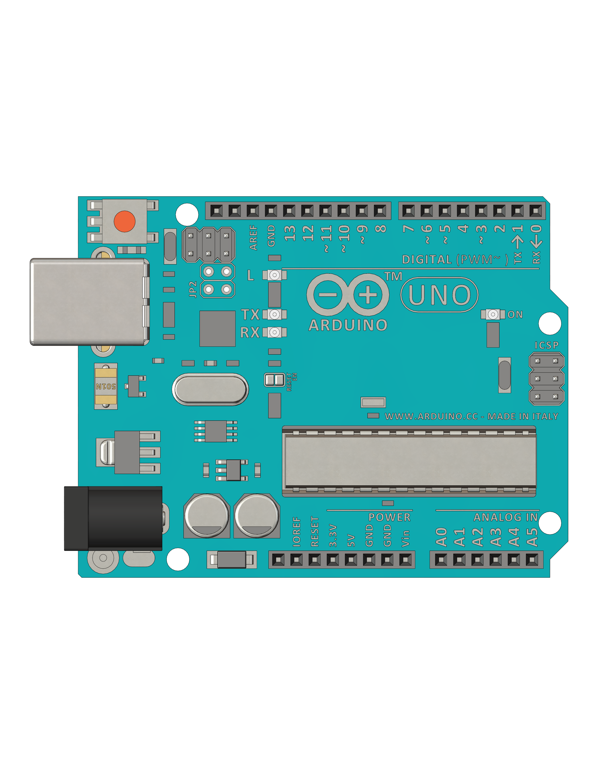
Engineering/2019-2020_USURPER/Avionics/Board Files/Arduino UNO R3 PNG.PNG
