Maeswoon/UNHSEDS/Engineering/2019-2020_USURPER/Avionics/Board Files/ATMEGA328-PU 28-PIN DIP IC Socket.JPG

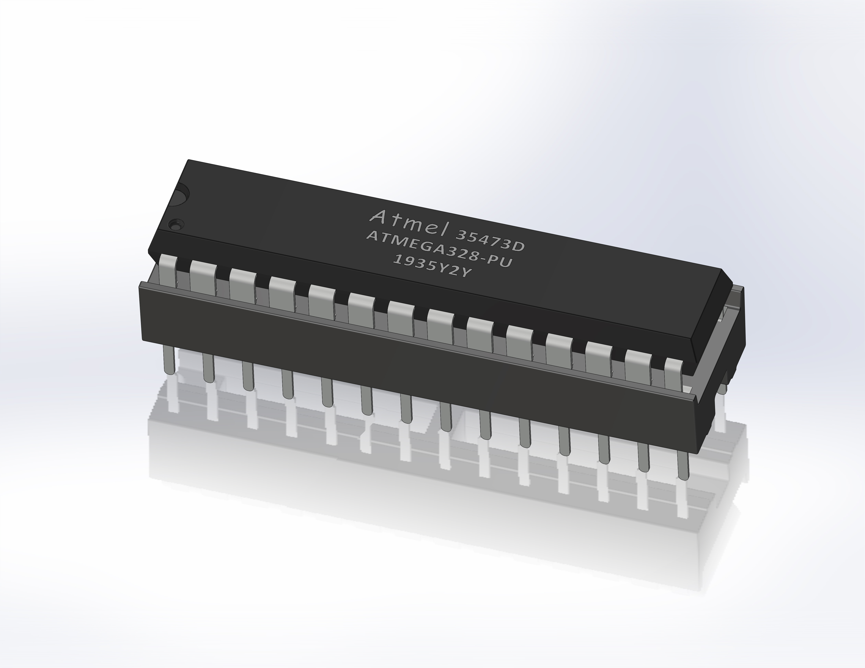
Engineering/2019-2020_USURPER/Avionics/Board Files/ATMEGA328-PU 28-PIN DIP IC Socket.JPG
