Maeswoon/UNHSEDS/Engineering/2019-2020_USURPER/Avionics/Board Files/ATMEGA328-PU Chip for Arduino.JPG

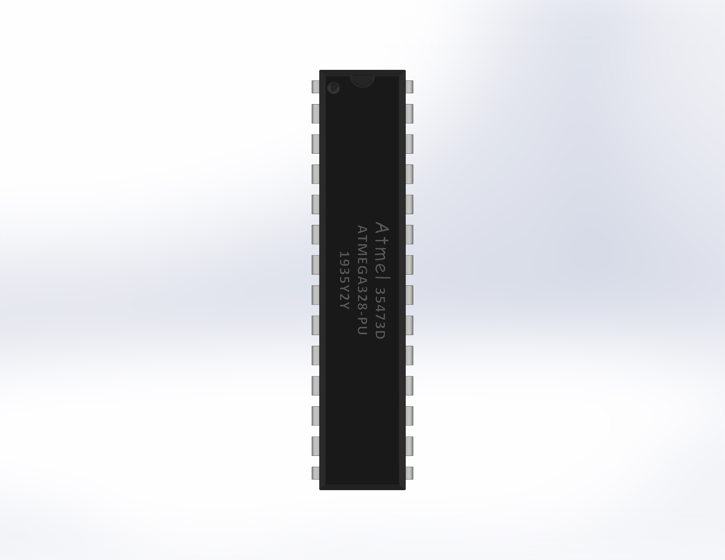
Engineering/2019-2020_USURPER/Avionics/Board Files/ATMEGA328-PU Chip for Arduino.JPG
