Maeswoon/UNHSEDS/Engineering/2019-2020_USURPER/Avionics/Board Files/DHT11 Temp-Humidity Sensor Render-1.JPG

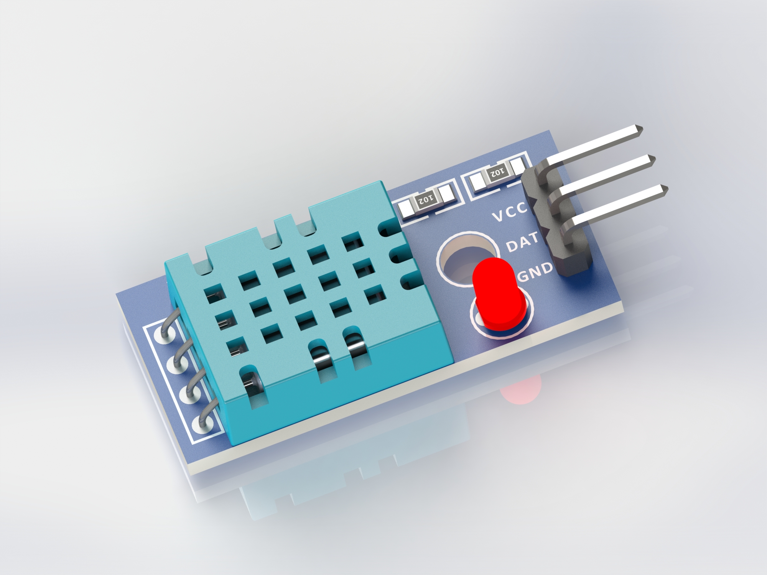
Engineering/2019-2020_USURPER/Avionics/Board Files/DHT11 Temp-Humidity Sensor Render-1.JPG
