Maeswoon/UNHSEDS/Engineering/2019-2020_USURPER/Avionics/Board Files/DS3231 RTC Render-04.JPG

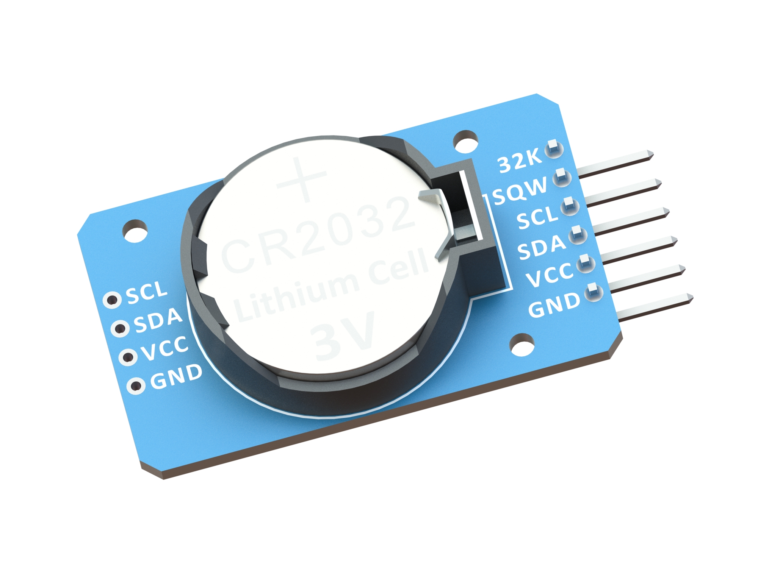
Engineering/2019-2020_USURPER/Avionics/Board Files/DS3231 RTC Render-04.JPG
