Maeswoon/UNHSEDS/Engineering/2019-2020_USURPER/Avionics/Board Files/GrabCAD Resistor Color Band Codes.jpg

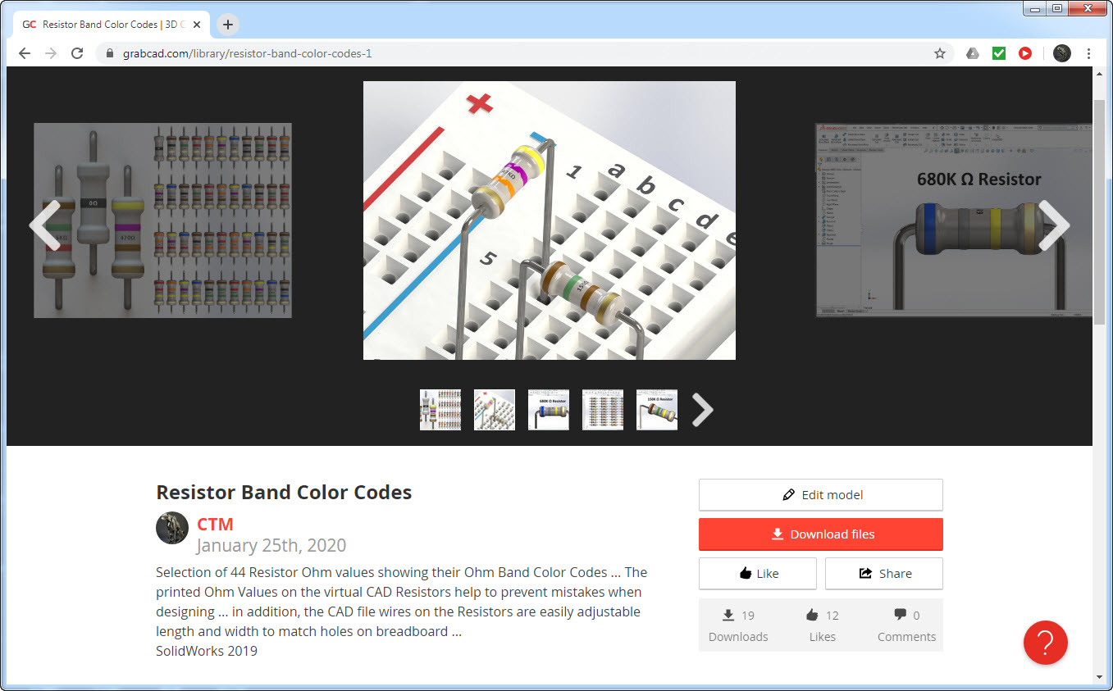
Engineering/2019-2020_USURPER/Avionics/Board Files/GrabCAD Resistor Color Band Codes.jpg
