Maeswoon/UNHSEDS/Engineering/2019-2020_USURPER/Avionics/Board Files/Hand Wheel CNC Encoder SolidWorks CAD.jpg

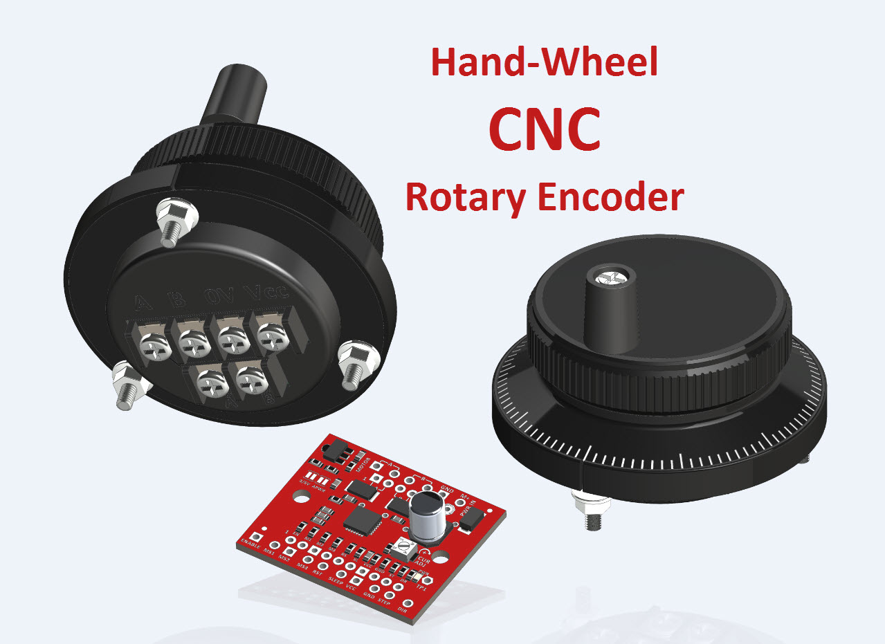
Engineering/2019-2020_USURPER/Avionics/Board Files/Hand Wheel CNC Encoder SolidWorks CAD.jpg
