Maeswoon/UNHSEDS/Engineering/2019-2020_USURPER/Avionics/Board Files/HX1838 IR Receiver Render-01.JPG

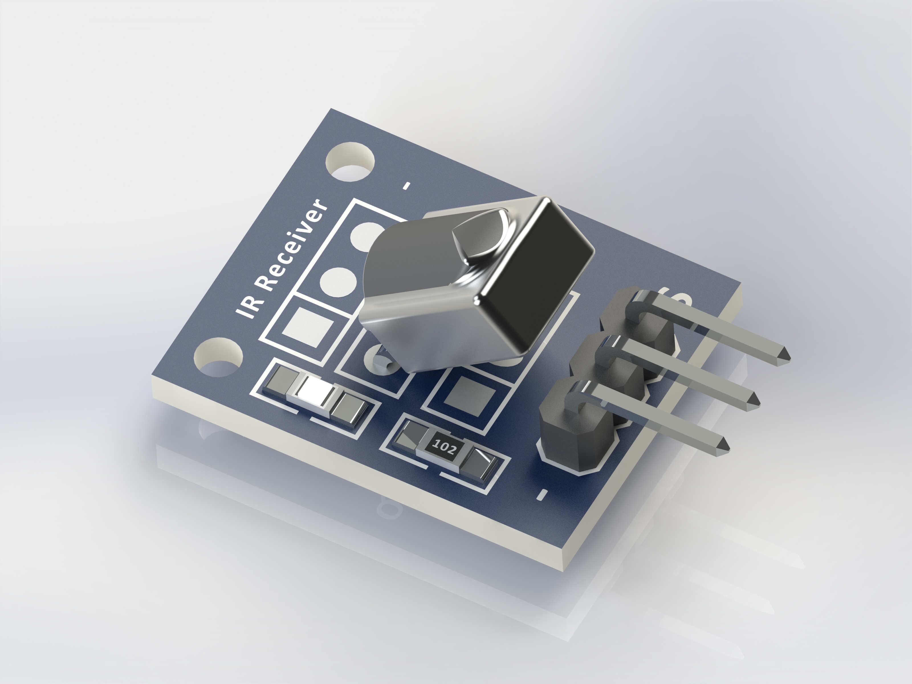
Engineering/2019-2020_USURPER/Avionics/Board Files/HX1838 IR Receiver Render-01.JPG
