Maeswoon/UNHSEDS/Engineering/2019-2020_USURPER/Avionics/Board Files/ISD1820 Voice Recorder Render-02.JPG

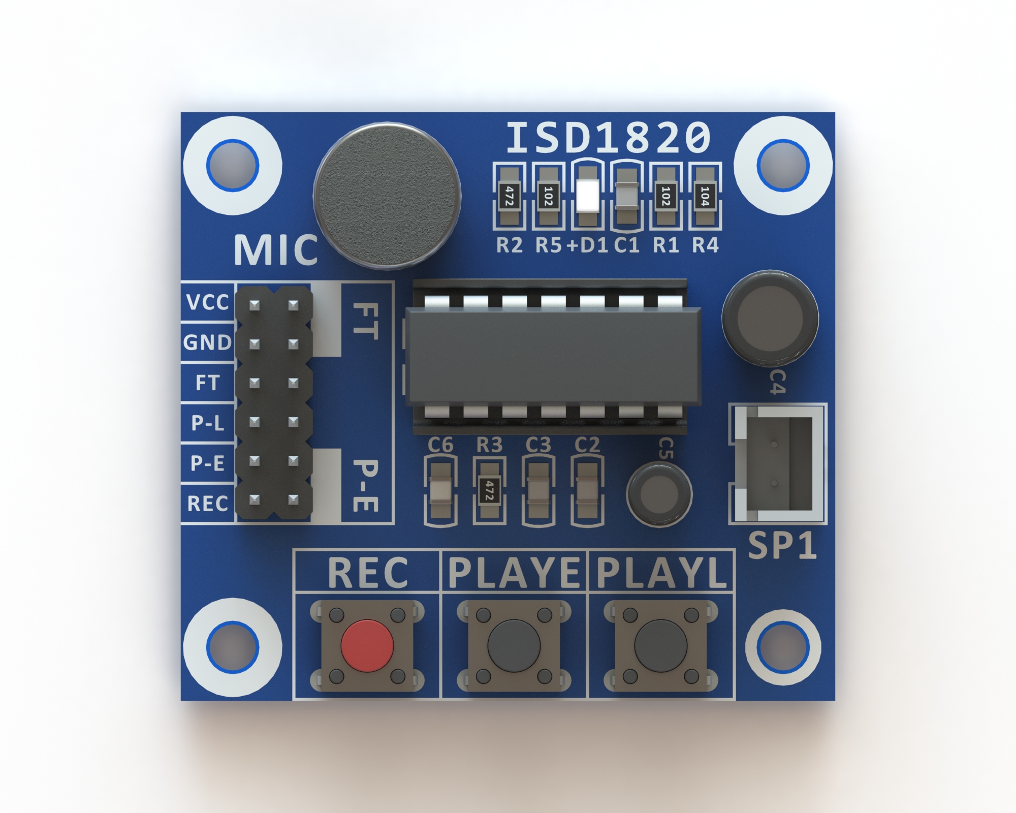
Engineering/2019-2020_USURPER/Avionics/Board Files/ISD1820 Voice Recorder Render-02.JPG
