Maeswoon/UNHSEDS/Engineering/2019-2020_USURPER/Avionics/Board Files/JPEG Arduino UNO R3.jpg

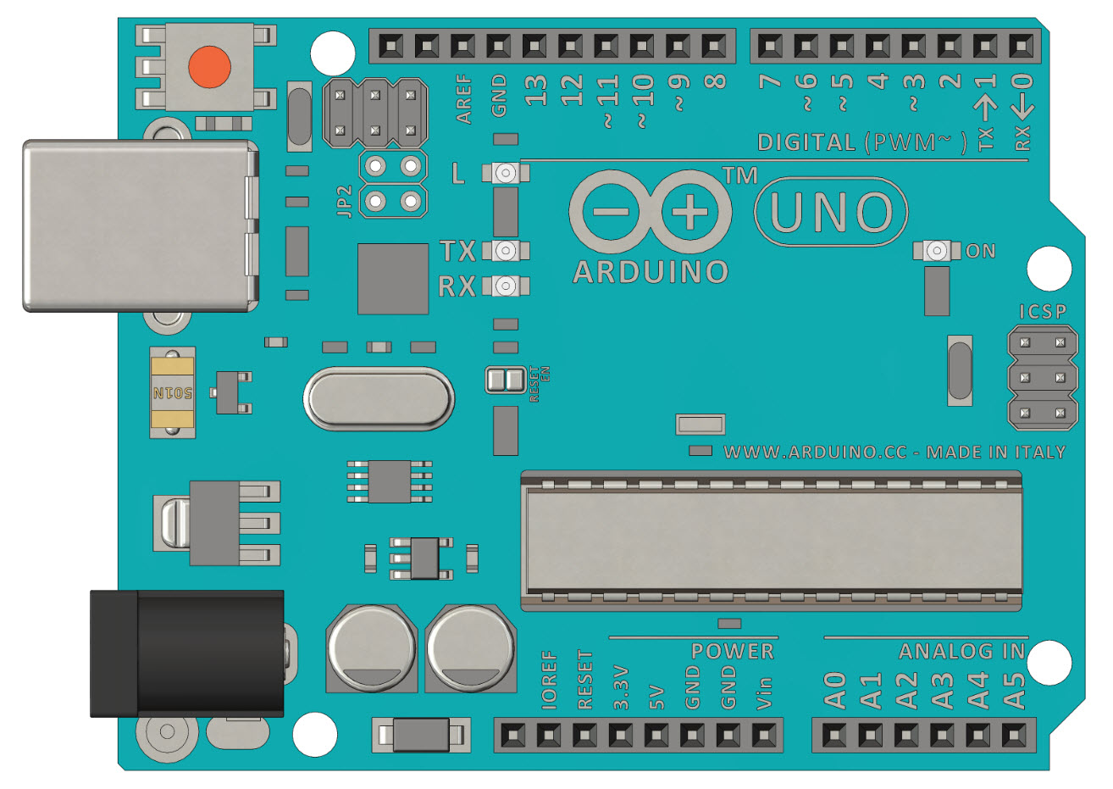
Engineering/2019-2020_USURPER/Avionics/Board Files/JPEG Arduino UNO R3.jpg
