Maeswoon/UNHSEDS/Engineering/2019-2020_USURPER/Avionics/Board Files/LED Module 8x8 MAX7219.JPG

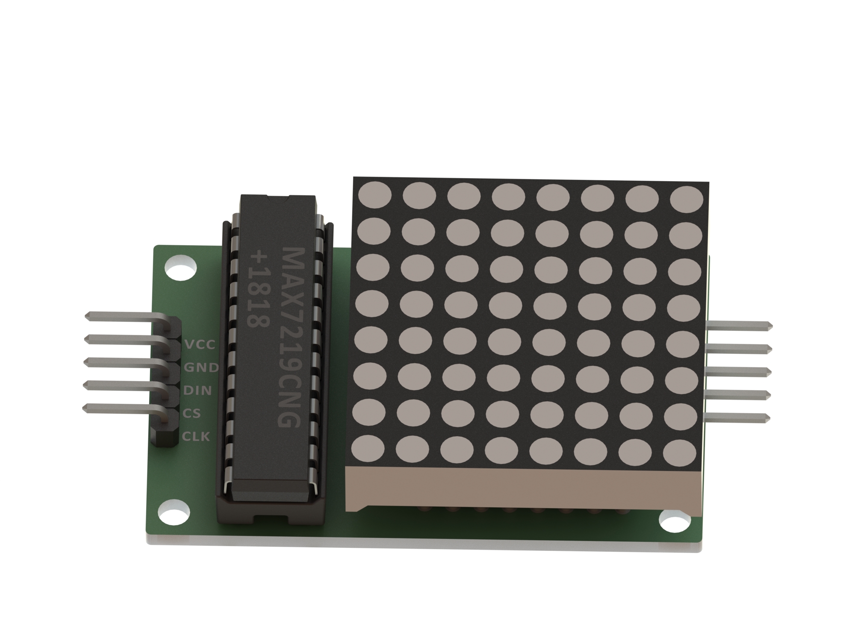
Engineering/2019-2020_USURPER/Avionics/Board Files/LED Module 8x8 MAX7219.JPG
