Maeswoon/UNHSEDS/Engineering/2019-2020_USURPER/Avionics/Board Files/MPU-6050 Render-01.JPG

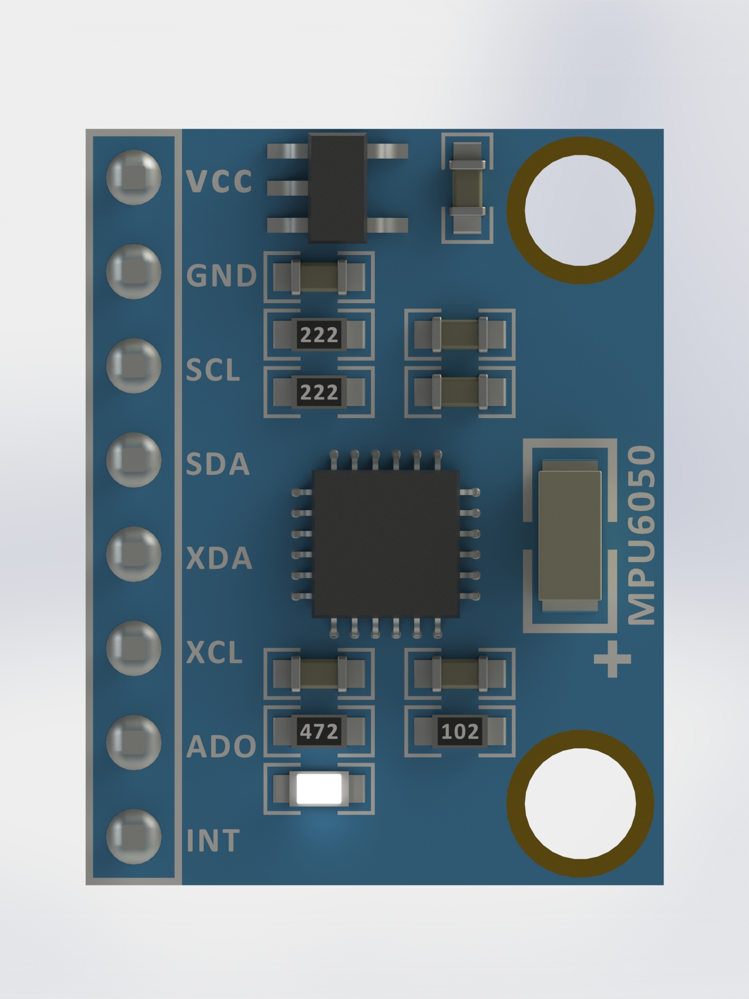
Engineering/2019-2020_USURPER/Avionics/Board Files/MPU-6050 Render-01.JPG
