Maeswoon/UNHSEDS/Engineering/2019-2020_USURPER/Avionics/Board Files/Relay Module Render-02.JPG

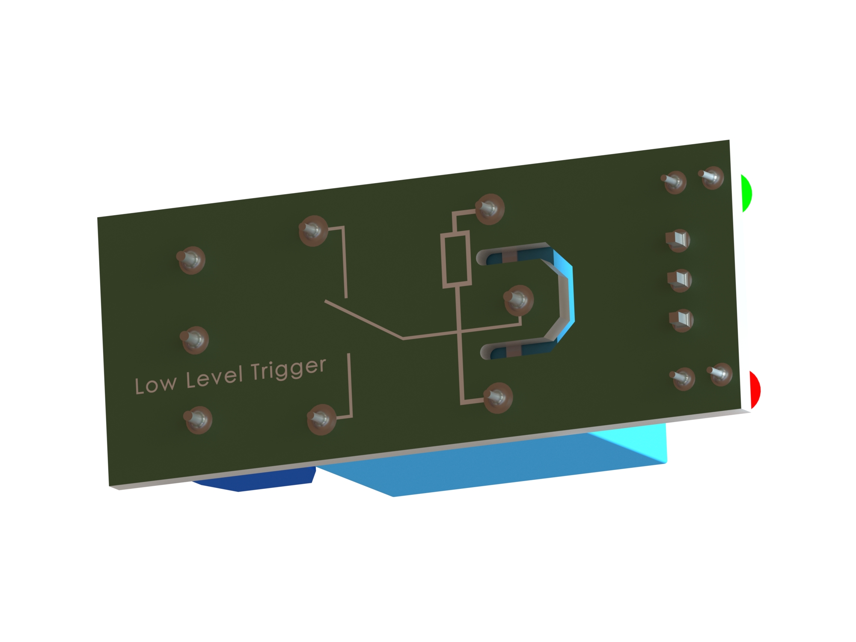
Engineering/2019-2020_USURPER/Avionics/Board Files/Relay Module Render-02.JPG
