Maeswoon/UNHSEDS/Engineering/2019-2020_USURPER/Avionics/Board Files/Resistor 0 Ohm Render-01.JPG

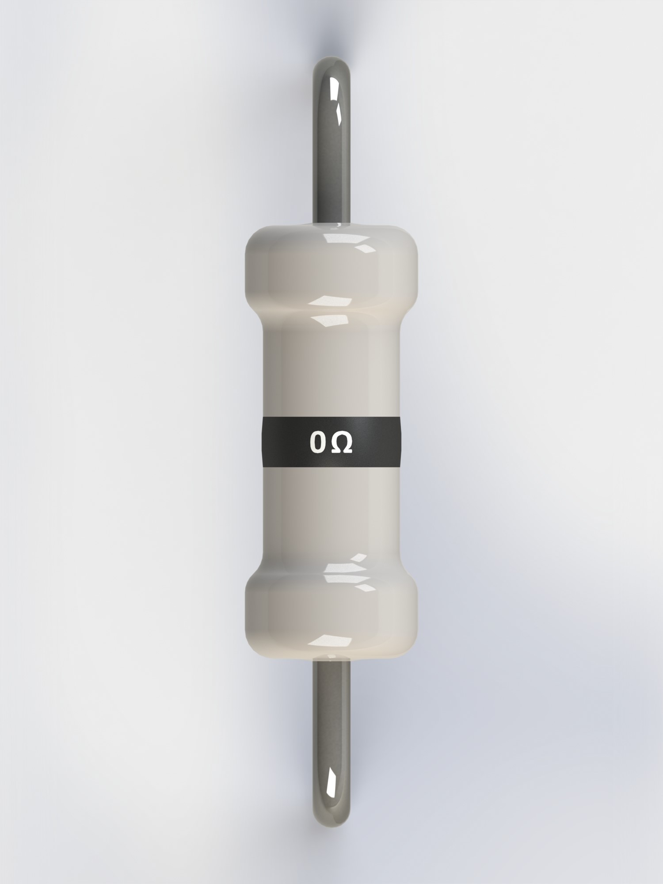
Engineering/2019-2020_USURPER/Avionics/Board Files/Resistor 0 Ohm Render-01.JPG
