Maeswoon/UNHSEDS/Engineering/2019-2020_USURPER/Avionics/Board Files/Resistor 150K Ohm SolidWorks.jpg

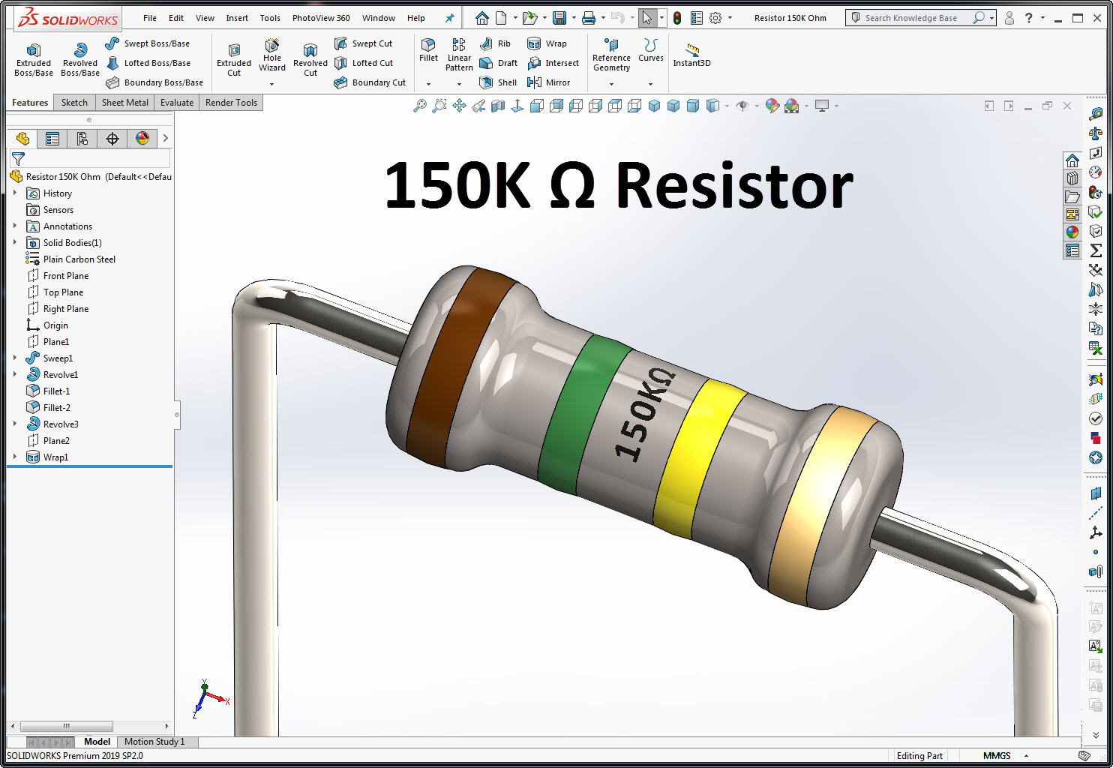
Engineering/2019-2020_USURPER/Avionics/Board Files/Resistor 150K Ohm SolidWorks.jpg
