Maeswoon/UNHSEDS/Engineering/2019-2020_USURPER/Avionics/Board Files/Resistor 680K Ohm Resistor SolidWorks.jpg

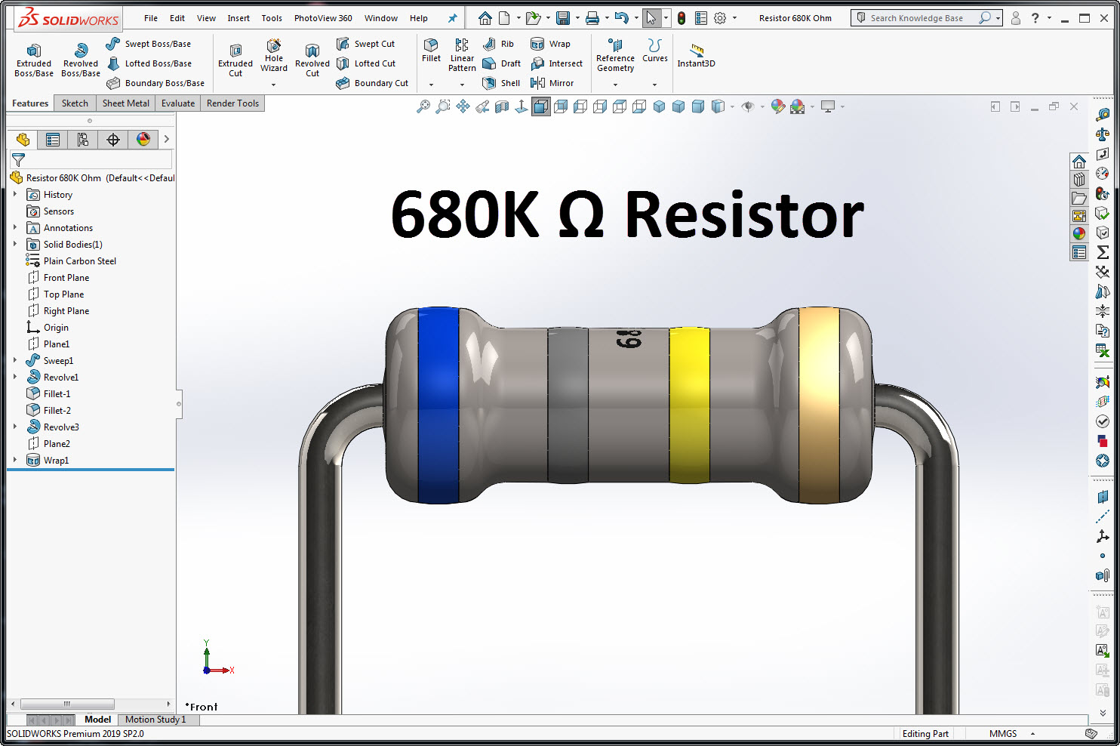
Engineering/2019-2020_USURPER/Avionics/Board Files/Resistor 680K Ohm Resistor SolidWorks.jpg
