Maeswoon/UNHSEDS/Engineering/2019-2020_USURPER/Avionics/Board Files/Resistor Color Band Codes JPEG-1.JPG

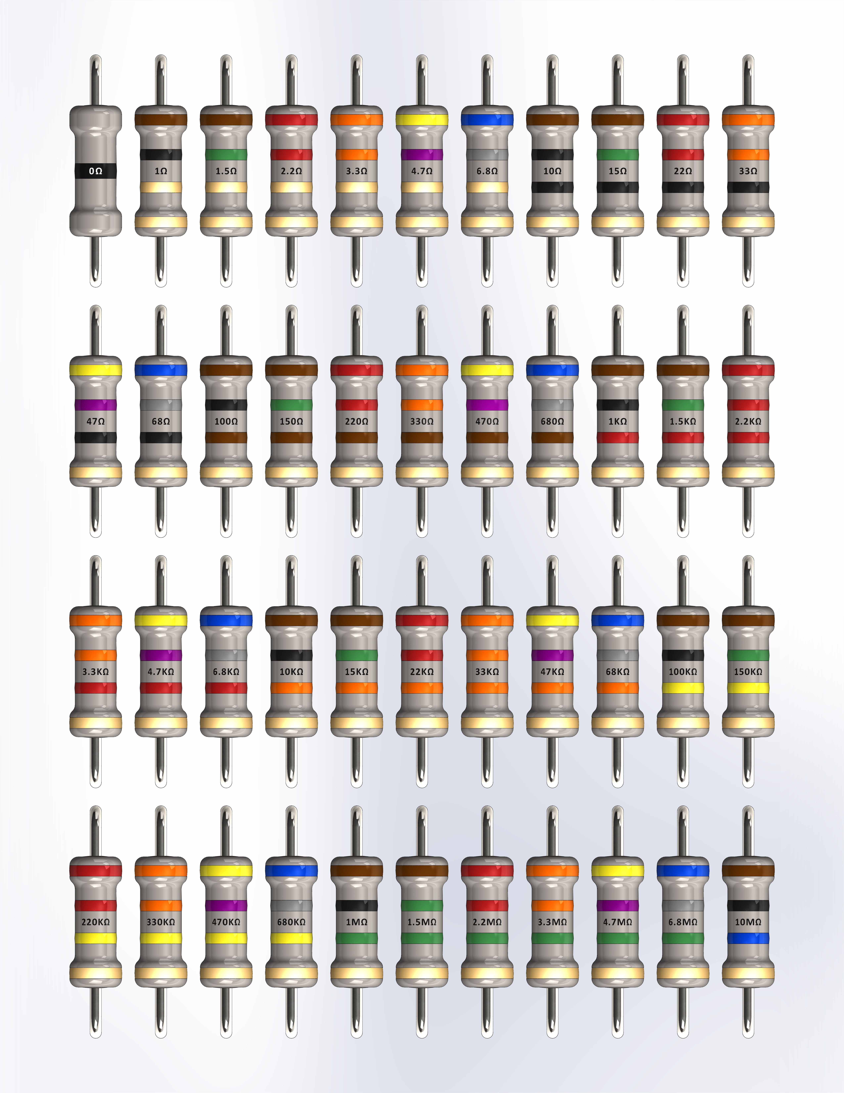
Engineering/2019-2020_USURPER/Avionics/Board Files/Resistor Color Band Codes JPEG-1.JPG
