Maeswoon/UNHSEDS/Engineering/2019-2020_USURPER/Avionics/Board Files/Resistors Close-1.JPG

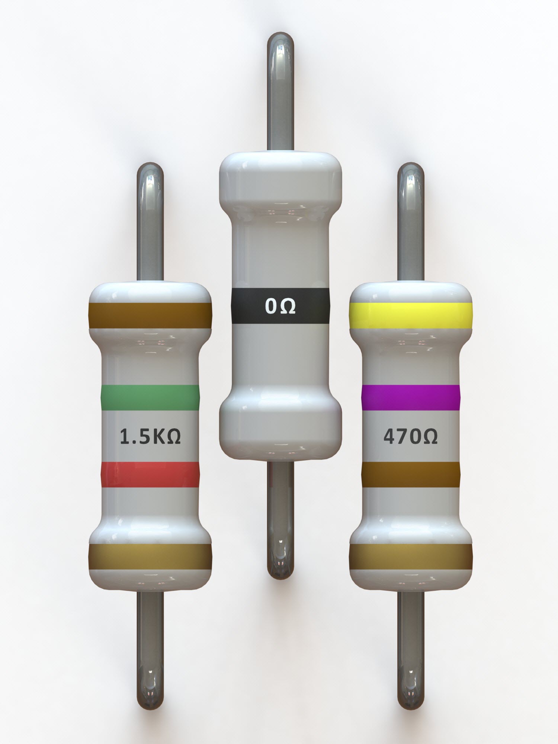
Engineering/2019-2020_USURPER/Avionics/Board Files/Resistors Close-1.JPG
