Maeswoon/UNHSEDS/Engineering/2019-2020_USURPER/Avionics/Board Files/Resistors on Breadboard.JPG

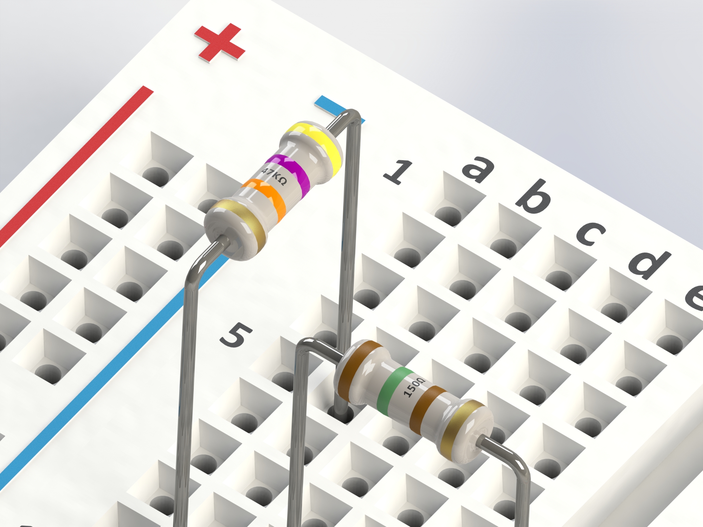
Engineering/2019-2020_USURPER/Avionics/Board Files/Resistors on Breadboard.JPG
