Maeswoon/UNHSEDS/Engineering/2019-2020_USURPER/Avionics/Board Files/Rotary Switch Rendering-1.JPG

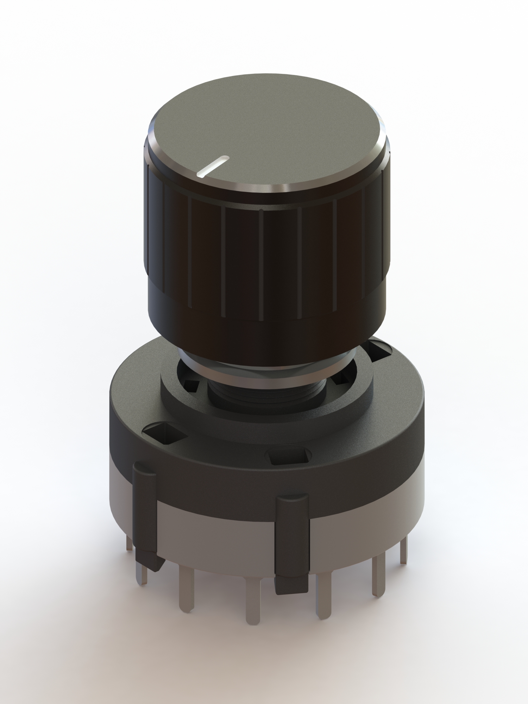
Engineering/2019-2020_USURPER/Avionics/Board Files/Rotary Switch Rendering-1.JPG
