Maeswoon/UNHSEDS/Engineering/2019-2020_USURPER/Avionics/Board Files/TINY85 8-PIN DIP IC Socket.JPG

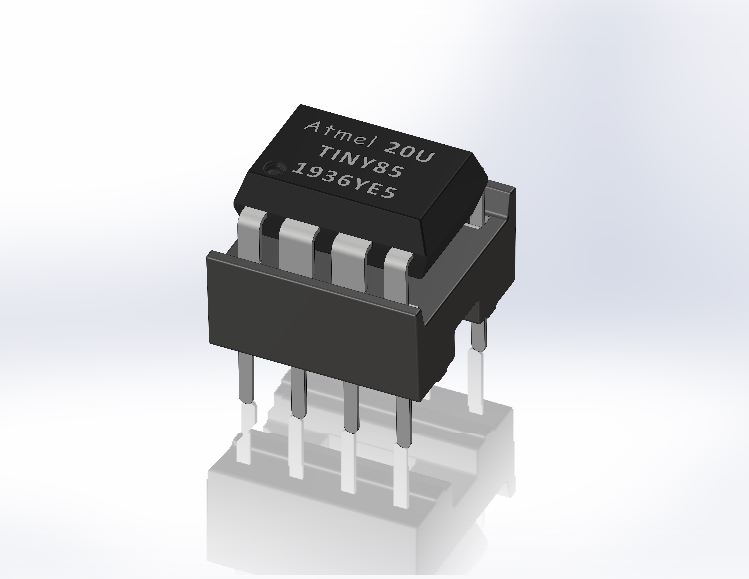
Engineering/2019-2020_USURPER/Avionics/Board Files/TINY85 8-PIN DIP IC Socket.JPG
