Maeswoon/UNHSEDS/Engineering/2019-2020_USURPER/Avionics/Board Files/Tiny RTC I2C DS1307 Render-03.JPG

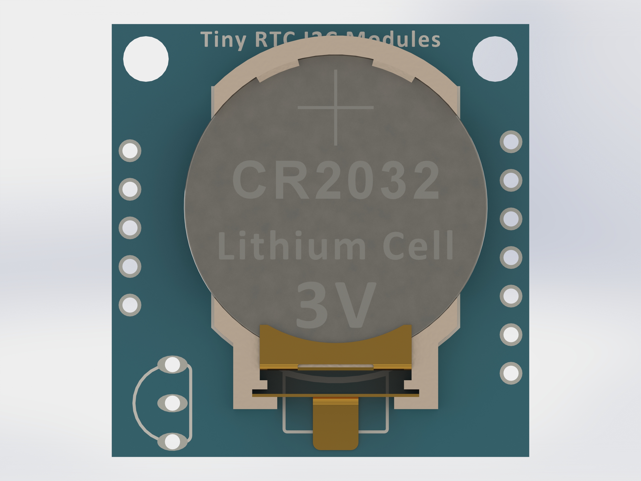
Engineering/2019-2020_USURPER/Avionics/Board Files/Tiny RTC I2C DS1307 Render-03.JPG
