Maeswoon/UNHSEDS/Engineering/2019-2020_USURPER/Engineering Management/Engineer of the Week/Engineers.png

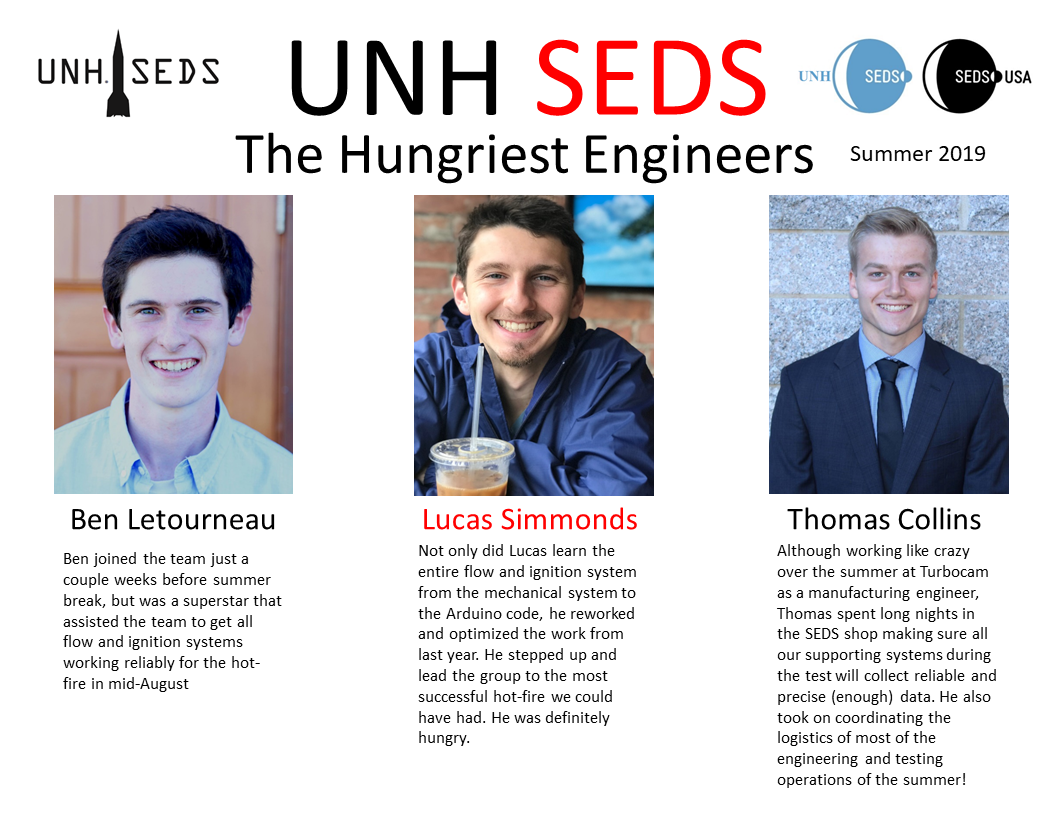
Engineering/2019-2020_USURPER/Engineering Management/Engineer of the Week/Engineers.png
