Maeswoon/UNHSEDS/Engineering/2019-2020_USURPER/Frame/CATO_Hybrid Files/Frame/Solidworks Files/Carbon Fiber Properties.PNG

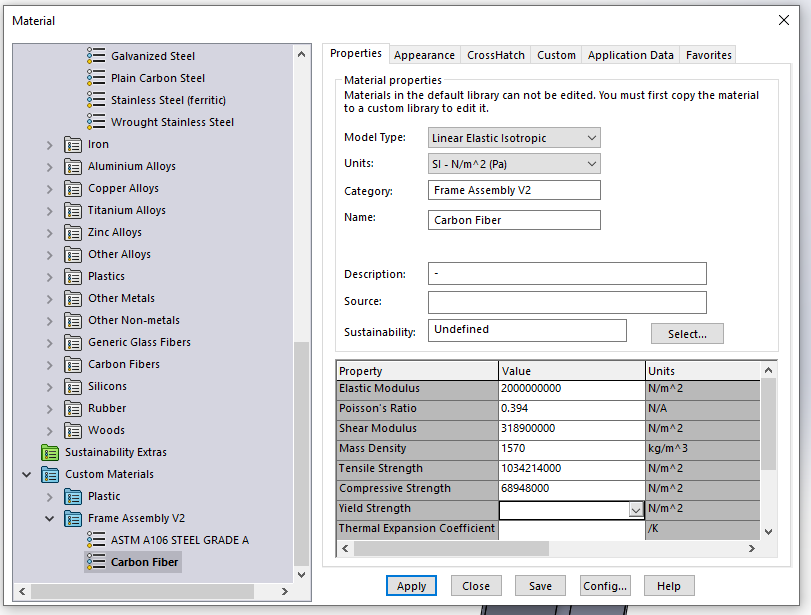
Engineering/2019-2020_USURPER/Frame/CATO_Hybrid Files/Frame/Solidworks Files/Carbon Fiber Properties.PNG
