Maeswoon/UNHSEDS/Engineering/2019-2020_USURPER/Frame/Reports/StructureFOS1.JPG

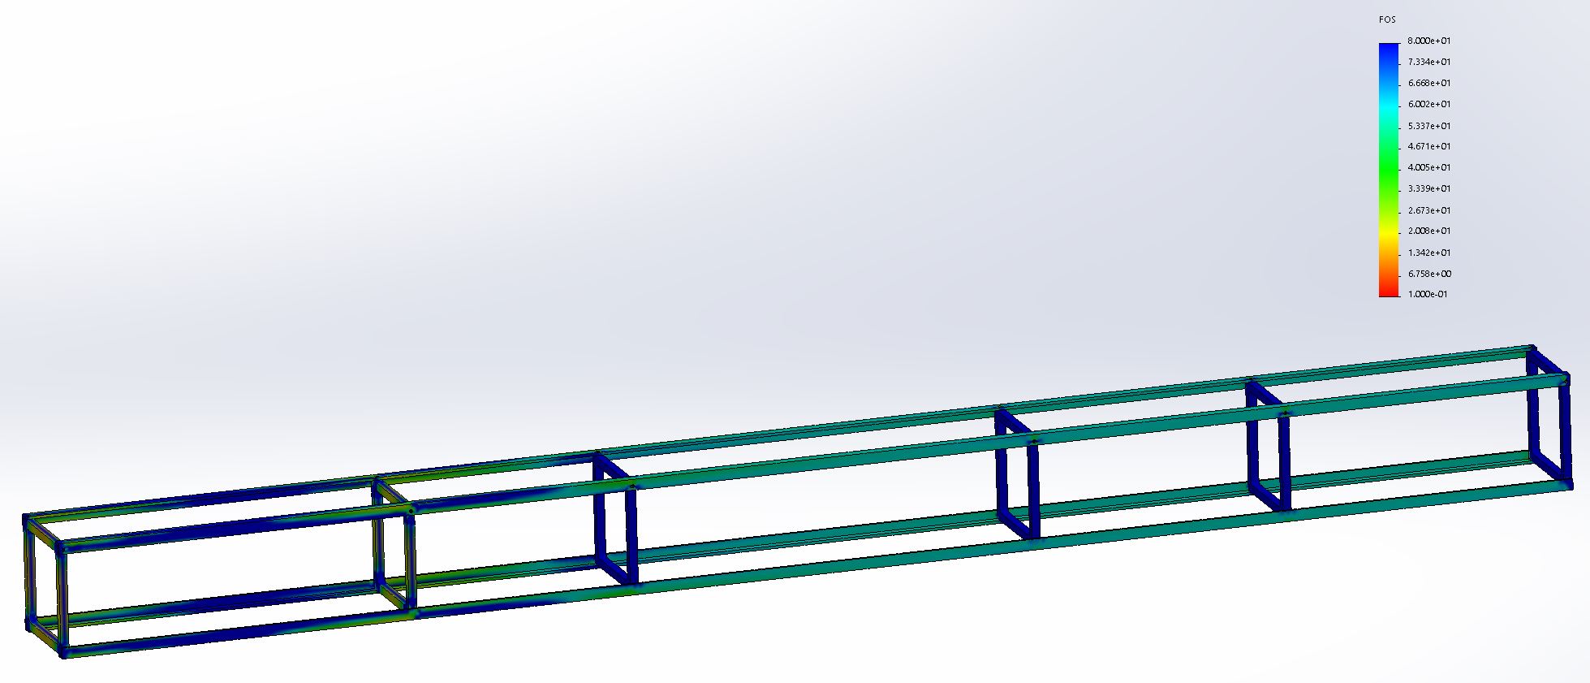
Engineering/2019-2020_USURPER/Frame/Reports/StructureFOS1.JPG
