Maeswoon/UNHSEDS/Engineering/2019-2020_USURPER/Frame/Reports/StructureFOS2.JPG

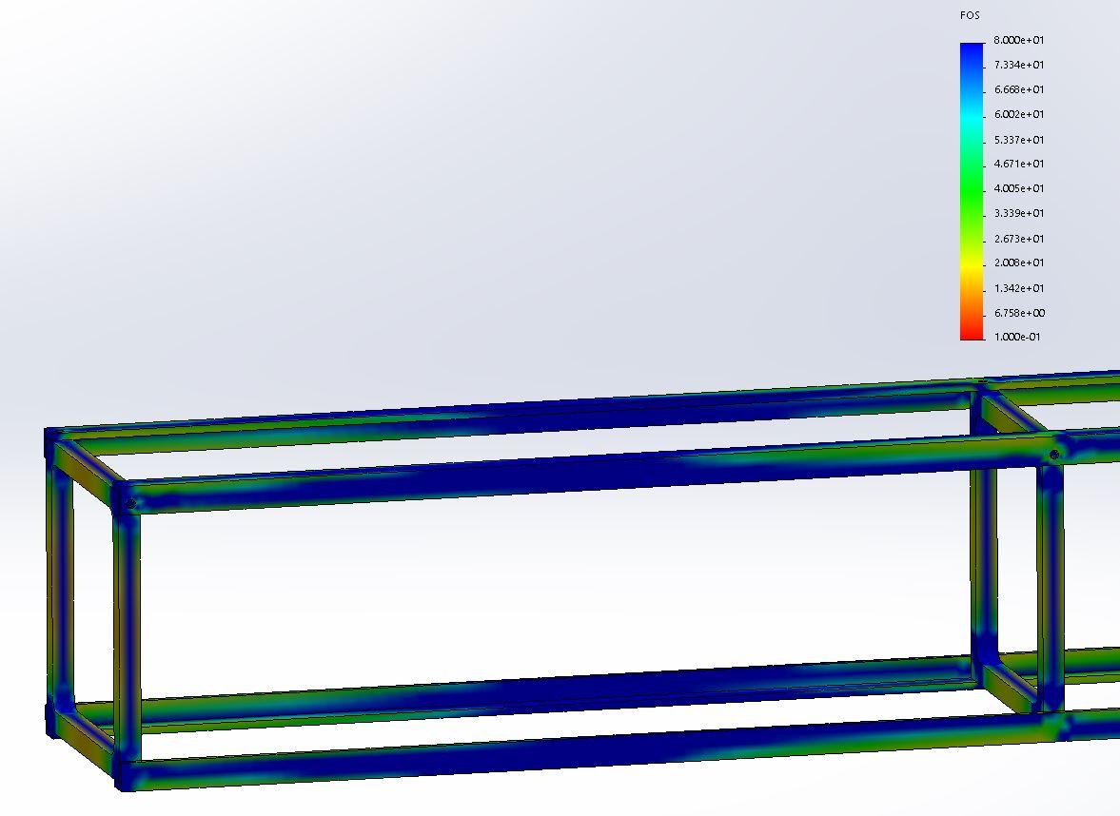
Engineering/2019-2020_USURPER/Frame/Reports/StructureFOS2.JPG
