Maeswoon/UNHSEDS/Engineering/2019-2020_USURPER/Frame/Reports/StructureStress.JPG

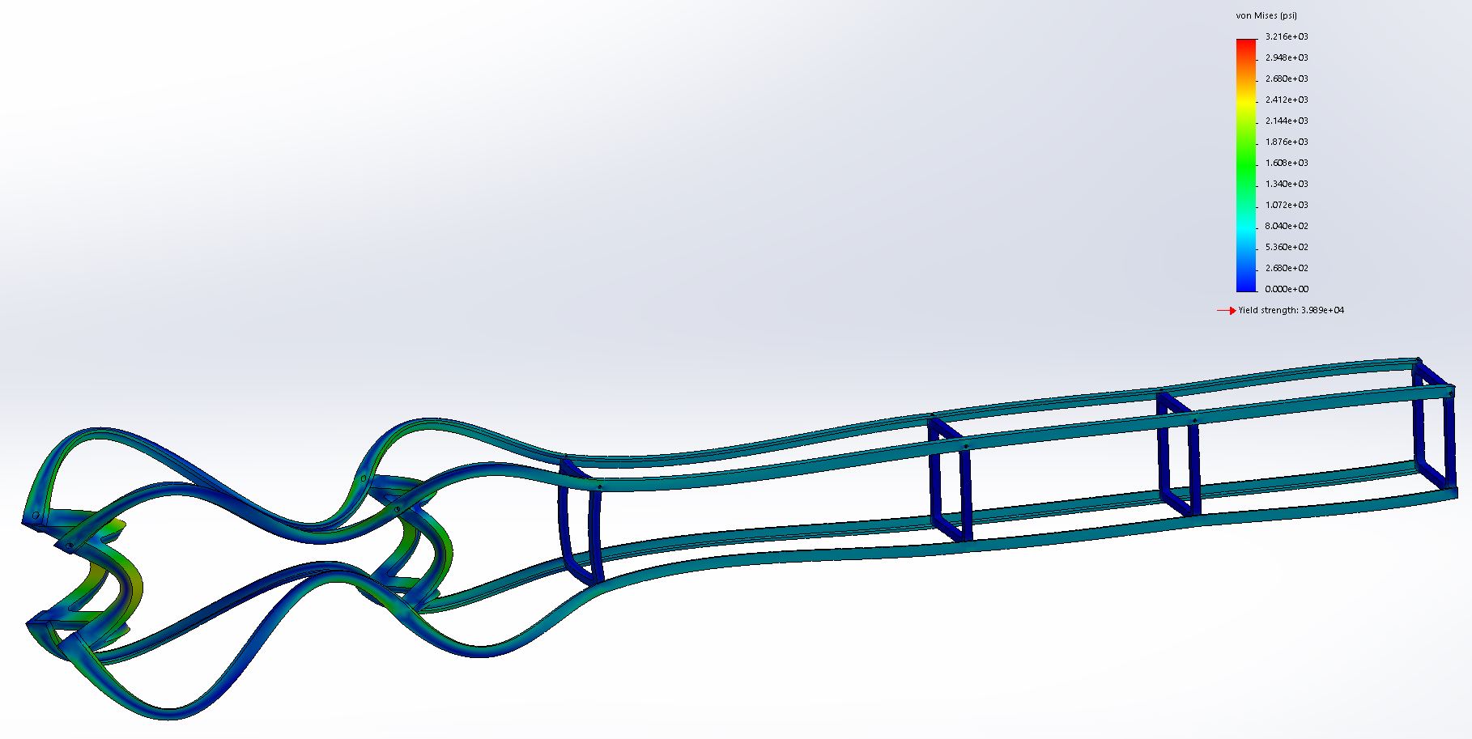
Engineering/2019-2020_USURPER/Frame/Reports/StructureStress.JPG
