Maeswoon/UNHSEDS/Engineering/2019-2020_USURPER/Frame/SOLIDWORKS/Renders/Exterior Frame.png

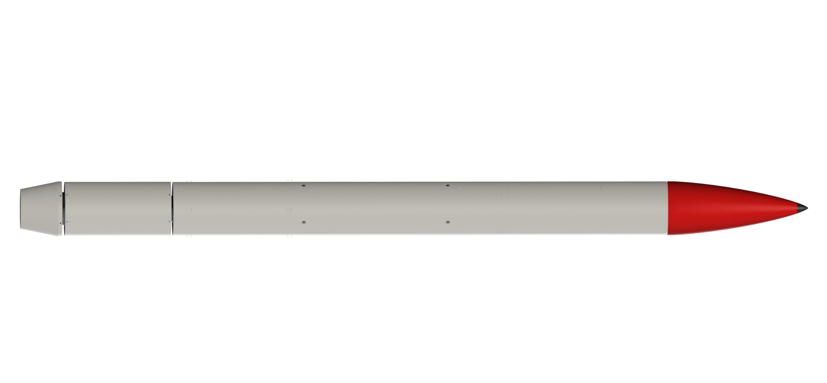
Engineering/2019-2020_USURPER/Frame/SOLIDWORKS/Renders/Exterior Frame.png
