Maeswoon/UNHSEDS/Engineering/2019-2020_USURPER/Frame/SOLIDWORKS/Renders/Nose Cone.png

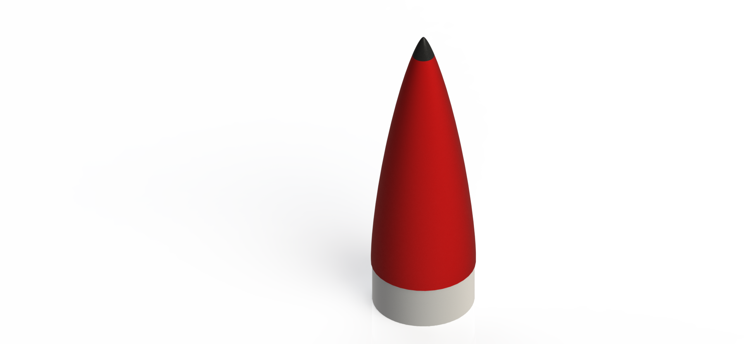
Engineering/2019-2020_USURPER/Frame/SOLIDWORKS/Renders/Nose Cone.png
