Maeswoon/UNHSEDS/Engineering/2019-2020_USURPER/Frame/SOLIDWORKS/Renders/USURPER Render V2.png

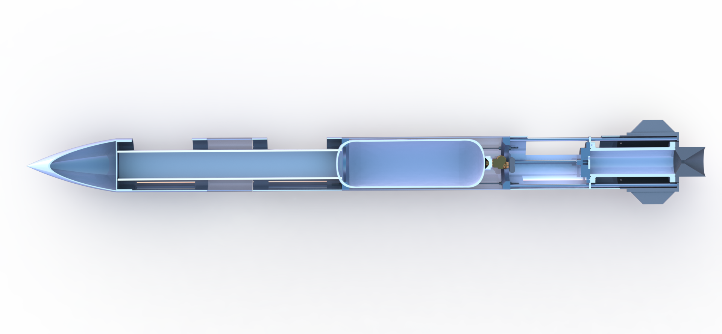
Engineering/2019-2020_USURPER/Frame/SOLIDWORKS/Renders/USURPER Render V2.png
