Maeswoon/UNHSEDS/Engineering/2019-2020_USURPER/Frame/SOLIDWORKS/SOLIDWORKS Simulations/Nose Cone/12in Ogive Pressure.png

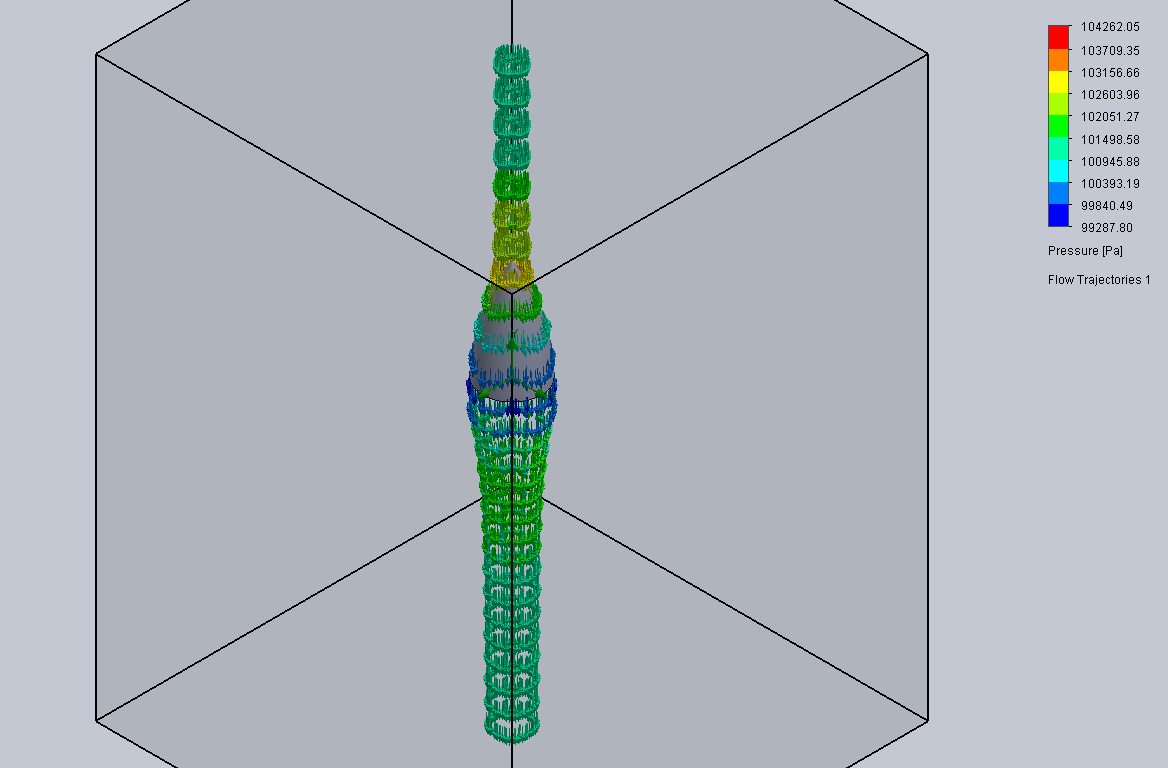
Engineering/2019-2020_USURPER/Frame/SOLIDWORKS/SOLIDWORKS Simulations/Nose Cone/12in Ogive Pressure.png
