Maeswoon/UNHSEDS/Engineering/2019-2020_USURPER/Frame/SOLIDWORKS/SOLIDWORKS Simulations/Rods/Factor of Safety Support Rod Structure.JPG

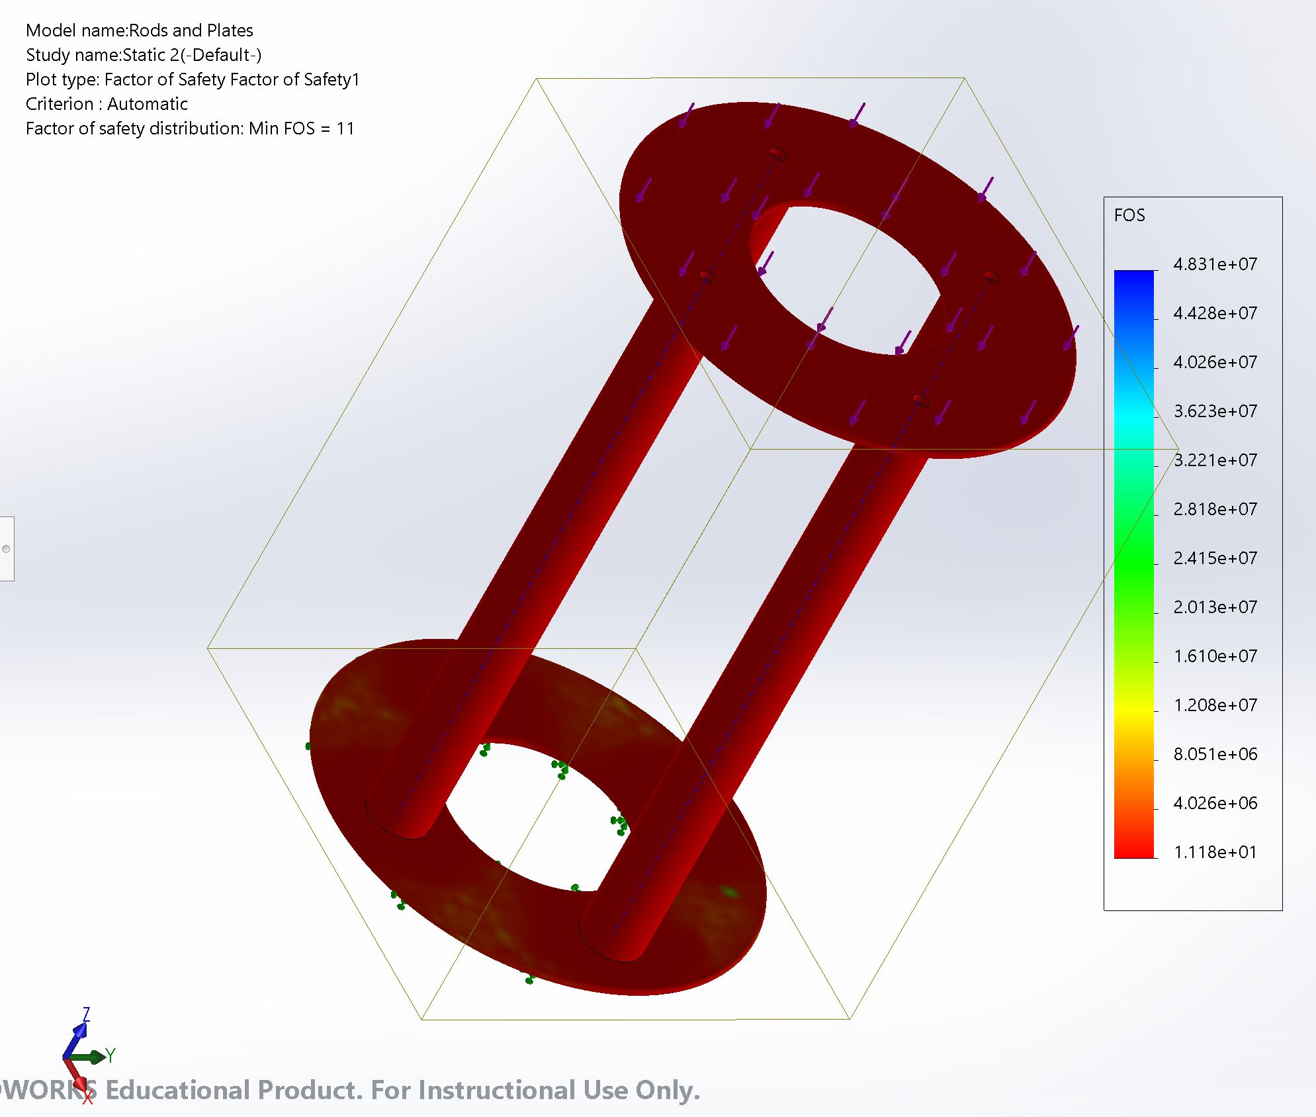
Engineering/2019-2020_USURPER/Frame/SOLIDWORKS/SOLIDWORKS Simulations/Rods/Factor of Safety Support Rod Structure.JPG
