Maeswoon/UNHSEDS/Engineering/2019-2020_USURPER/Frame/SOLIDWORKS/SOLIDWORKS Simulations/Rods/Mass Properties of Rod Support Structure.JPG

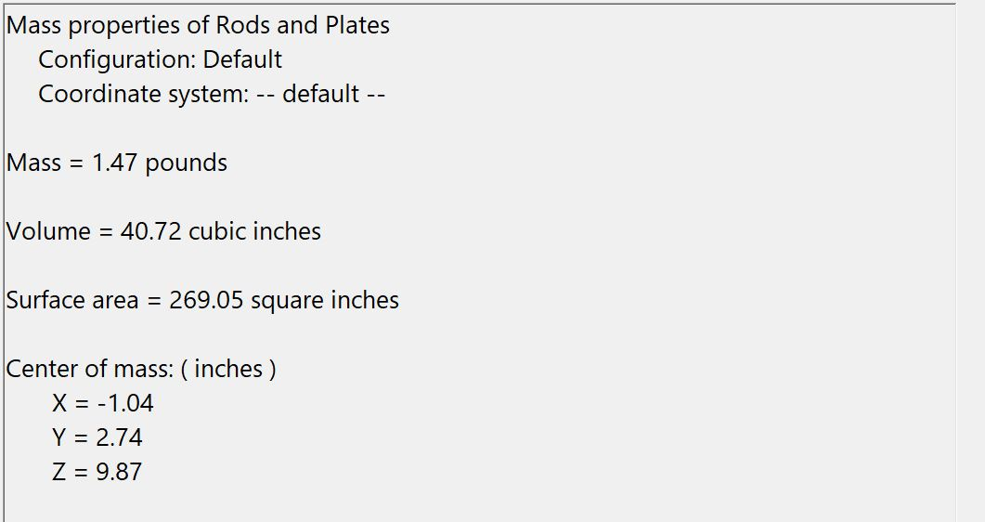
Engineering/2019-2020_USURPER/Frame/SOLIDWORKS/SOLIDWORKS Simulations/Rods/Mass Properties of Rod Support Structure.JPG
