Maeswoon/UNHSEDS/Engineering/2019-2020_USURPER/Other/Rocket Simulation/GraphforURC.png

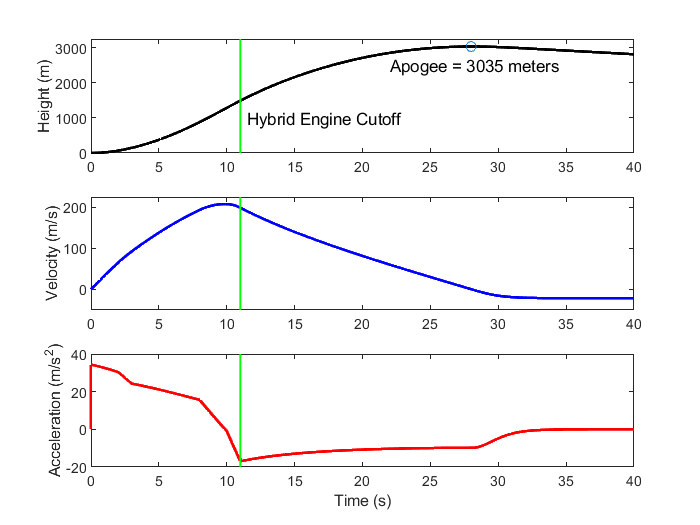
Engineering/2019-2020_USURPER/Other/Rocket Simulation/GraphforURC.png
