Maeswoon/UNHSEDS/Engineering/2019-2020_USURPER/Other/Rocket Simulation/untitled.png

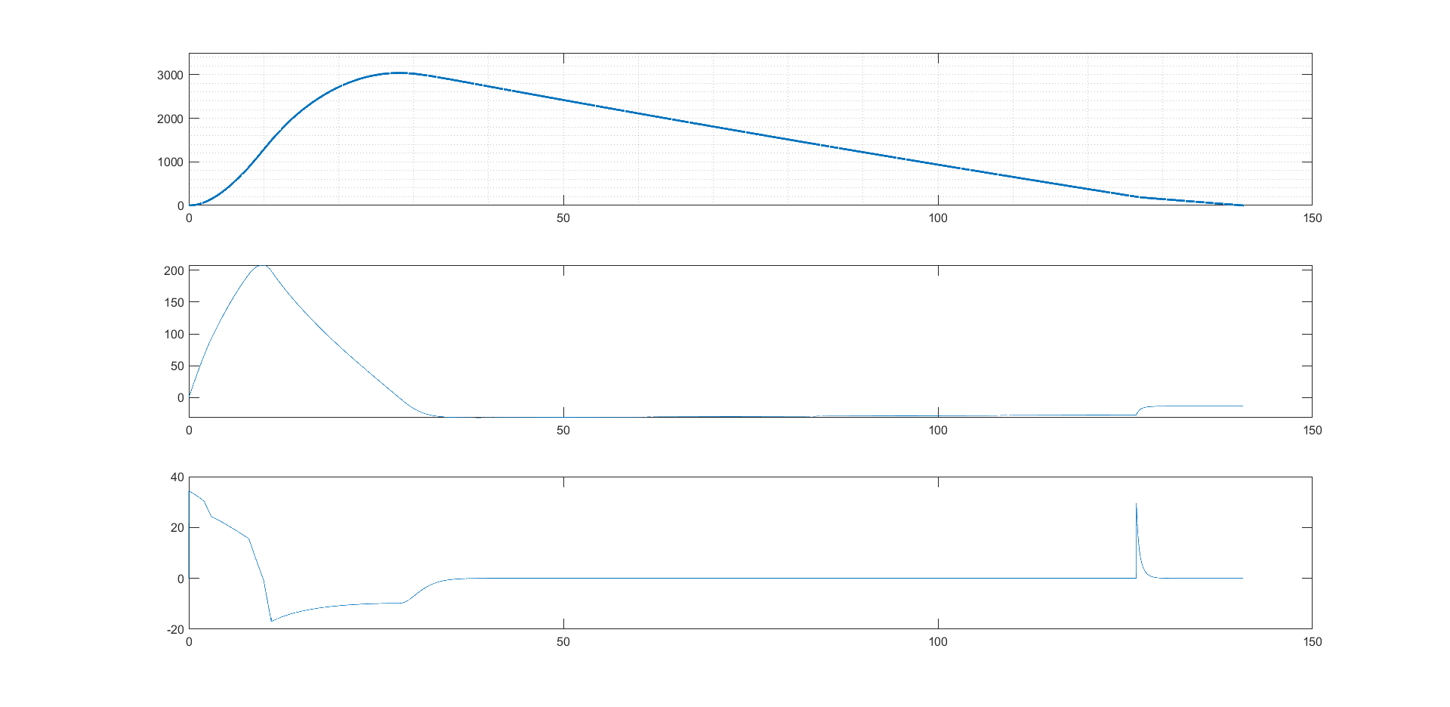
Engineering/2019-2020_USURPER/Other/Rocket Simulation/untitled.png
