Maeswoon/UNHSEDS/Engineering/2019-2020_USURPER/Propulsion/Avionic Propulsion/Flow Regulation/Digital Switch for Solenoid.PNG

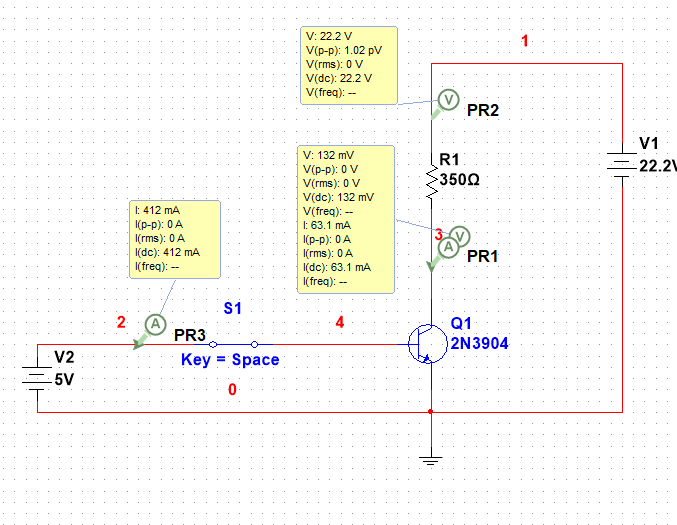
Engineering/2019-2020_USURPER/Propulsion/Avionic Propulsion/Flow Regulation/Digital Switch for Solenoid.PNG
