Maeswoon/UNHSEDS/Engineering/2019-2020_USURPER/Propulsion/Avionic Propulsion/Flow Regulation/Runaway V2 Block Diagram.png

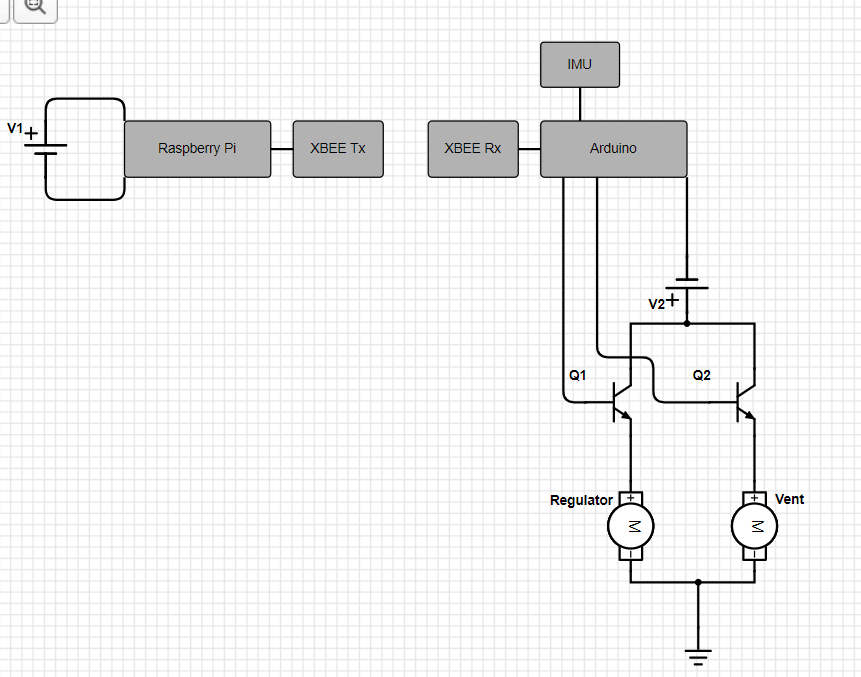
Engineering/2019-2020_USURPER/Propulsion/Avionic Propulsion/Flow Regulation/Runaway V2 Block Diagram.png
