Maeswoon/UNHSEDS/Engineering/2019-2020_USURPER/Propulsion/Avionic Propulsion/Flow Regulation/V1 Flow Regulation Ignition Circuit.PNG

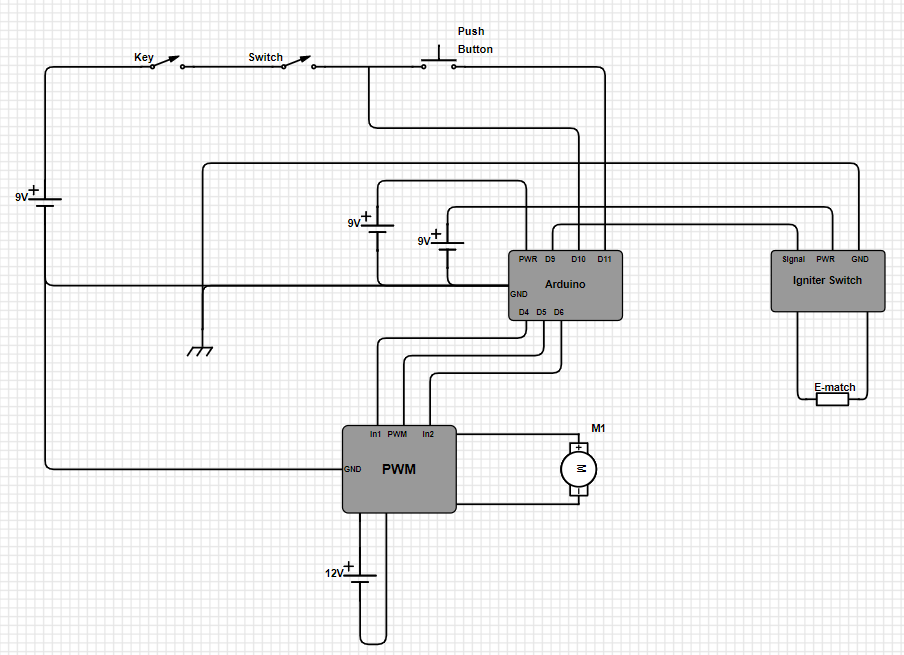
Engineering/2019-2020_USURPER/Propulsion/Avionic Propulsion/Flow Regulation/V1 Flow Regulation Ignition Circuit.PNG
