Maeswoon/UNHSEDS/Engineering/2020-2021_PHANTOM/Frame/Active Frame V2/NewNosTank/5.JPG

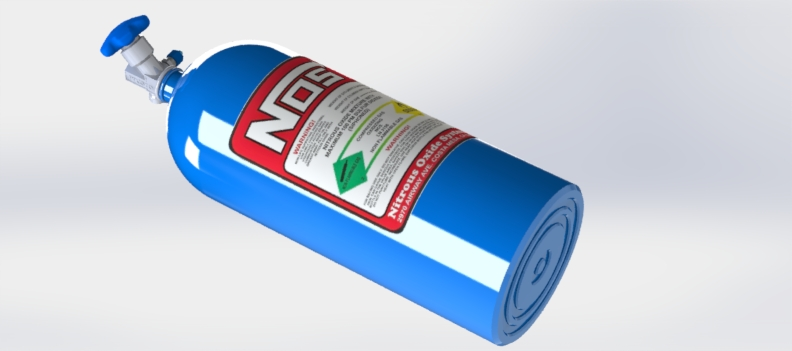
Engineering/2020-2021_PHANTOM/Frame/Active Frame V2/NewNosTank/5.JPG
