Maeswoon/UNHSEDS/Engineering/2020-2021_PHANTOM/Frame/Active Frame V2/NewNosTank/efi-nitrous-system.jpg

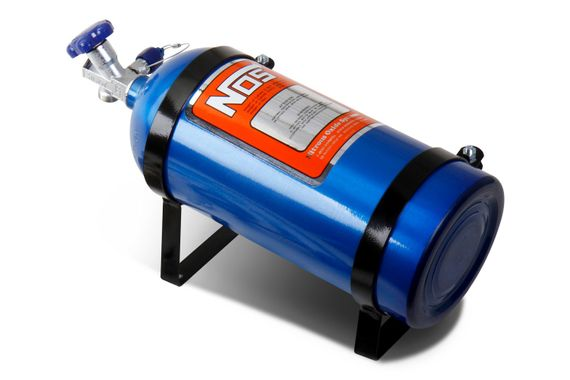
Engineering/2020-2021_PHANTOM/Frame/Active Frame V2/NewNosTank/efi-nitrous-system.jpg
