Maeswoon/UNHSEDS/Engineering/2020-2021_PHANTOM/Frame/Active Frame V2/NewNosTank/IMG_0616_zps8qw4sbiz.jpg

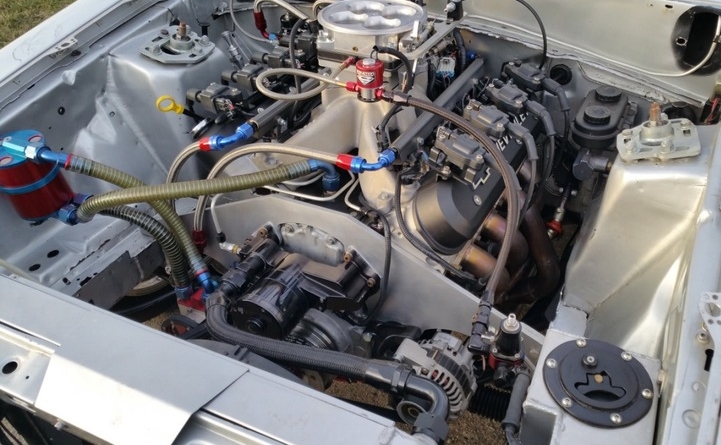
Engineering/2020-2021_PHANTOM/Frame/Active Frame V2/NewNosTank/IMG_0616_zps8qw4sbiz.jpg
