Maeswoon/UNHSEDS/Engineering/2020-2021_PHANTOM/Frame/Active Frame V2/NewNosTank/IPD_VOLVO_C30_NOS_TANKS.jpg

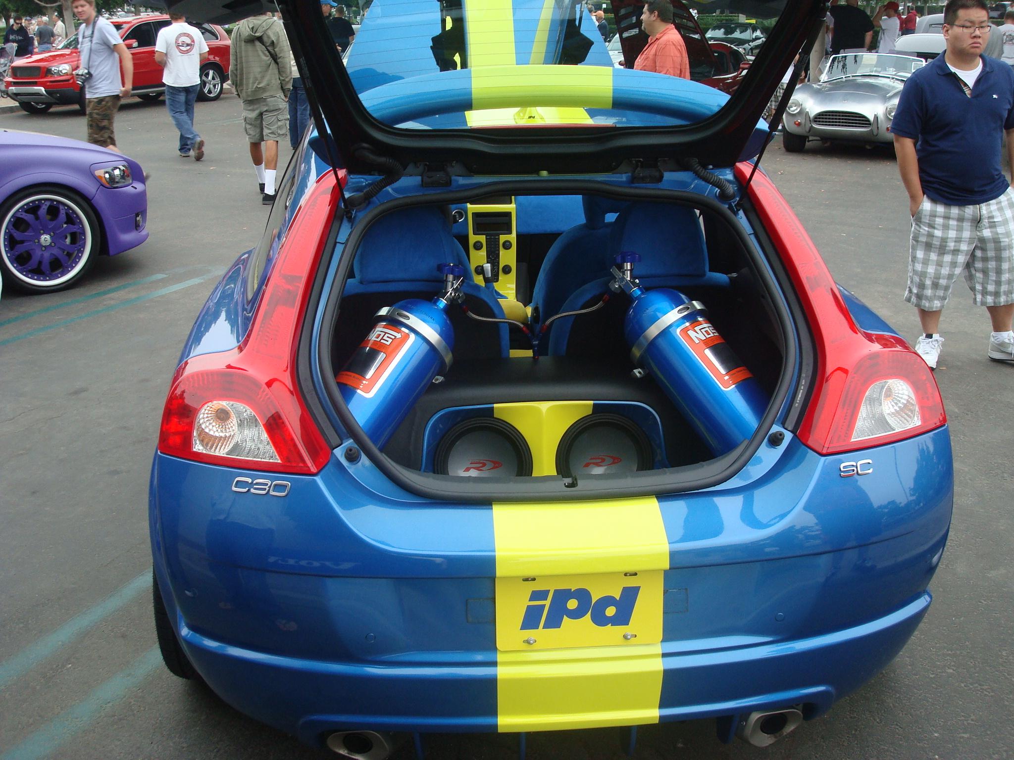
Engineering/2020-2021_PHANTOM/Frame/Active Frame V2/NewNosTank/IPD_VOLVO_C30_NOS_TANKS.jpg
