Maeswoon/UNHSEDS/Engineering/2020-2021_PHANTOM/Frame/Active Frame V2/NewNosTank/Kit NOS 1.jpg

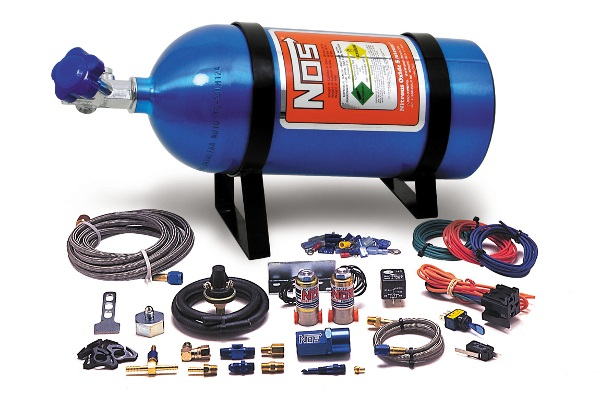
Engineering/2020-2021_PHANTOM/Frame/Active Frame V2/NewNosTank/Kit NOS 1.jpg
