Maeswoon/UNHSEDS/Engineering/2020-2021_PHANTOM/Frame/Active Frame V2/NewNosTank/new nitro.png

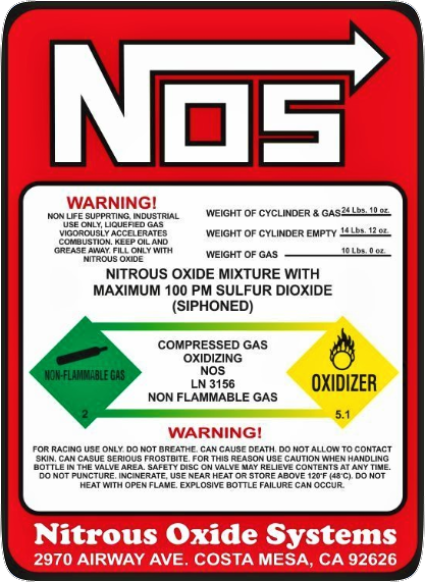
Engineering/2020-2021_PHANTOM/Frame/Active Frame V2/NewNosTank/new nitro.png
