Maeswoon/UNHSEDS/Engineering/2020-2021_PHANTOM/Frame/Active Frame V2/NewNosTank/NOS_Bottle.jpg

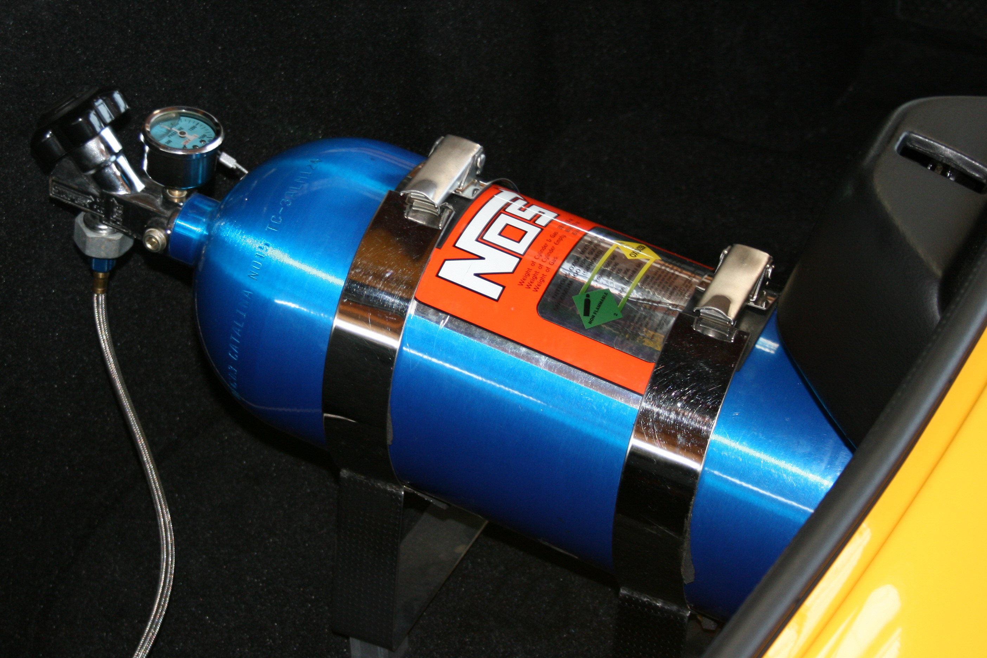
Engineering/2020-2021_PHANTOM/Frame/Active Frame V2/NewNosTank/NOS_Bottle.jpg
