Maeswoon/UNHSEDS/Engineering/2020-2021_PHANTOM/Frame/Active Frame V2/NewNosTank/pelados_cine_accion_columna_de_logan_diesel_Johnson_statham_05_Tierra_Freak_Tierrafreak.com_.ar copia.jpg

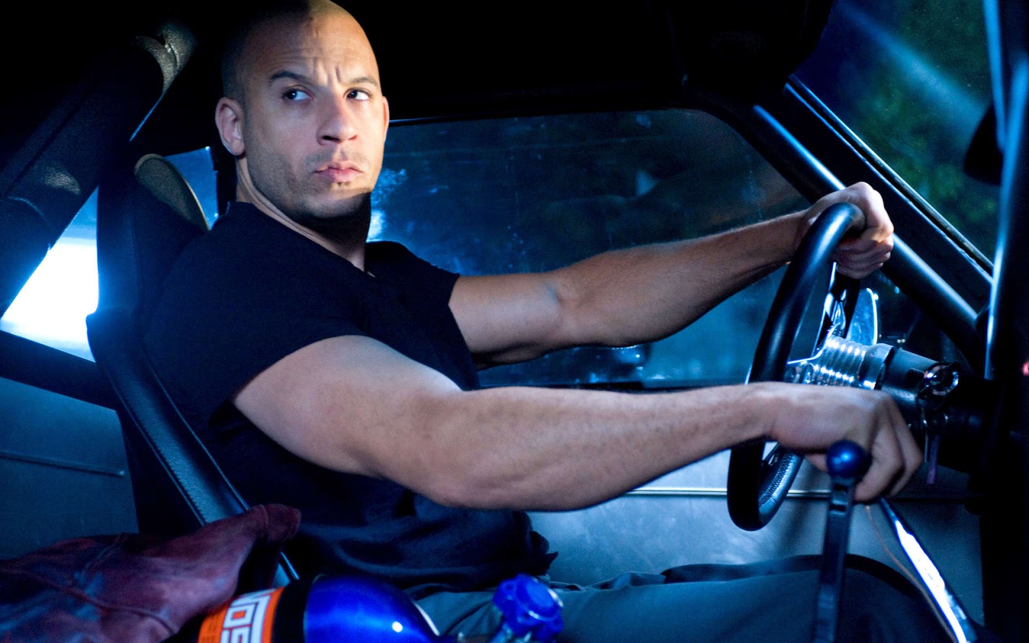
Engineering/2020-2021_PHANTOM/Frame/Active Frame V2/NewNosTank/pelados_cine_accion_columna_de_logan_diesel_Johnson_statham_05_Tierra_Freak_Tierrafreak.com_.ar copia.jpg
