Maeswoon/UNHSEDS/Engineering/2020-2021_PHANTOM/Frame/Active Frame V2/NewNosTank/SH_8265-1200x800.jpg

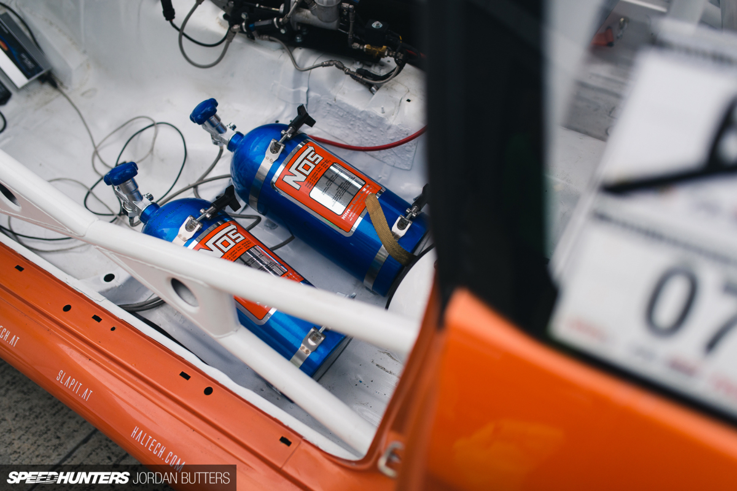
Engineering/2020-2021_PHANTOM/Frame/Active Frame V2/NewNosTank/SH_8265-1200x800.jpg
