Maeswoon/UNHSEDS/Engineering/2020-2021_PHANTOM/Frame/Active Frame V2/NewNosTank/single-bottle.jpg

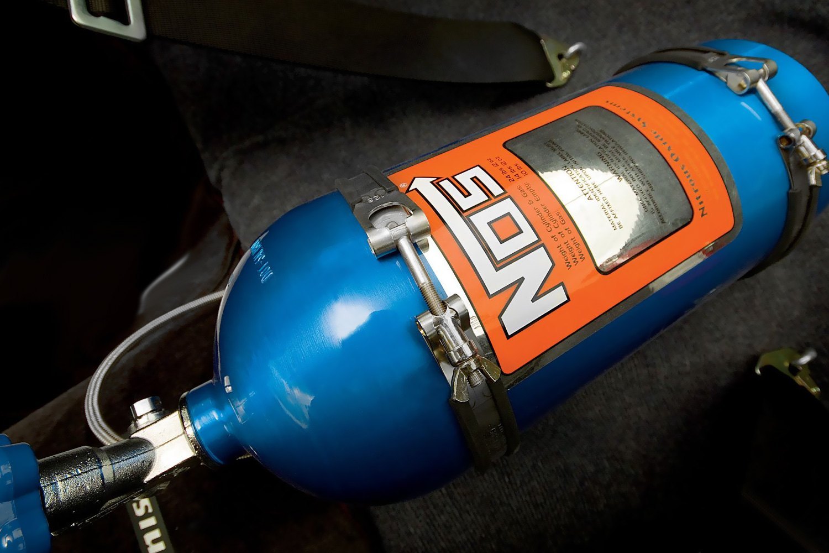
Engineering/2020-2021_PHANTOM/Frame/Active Frame V2/NewNosTank/single-bottle.jpg
