Maeswoon/UNHSEDS/Engineering/2020-2021_PHANTOM/Propulsion/Banshee V1/Combustion Chamber Aluminum Properties.jpg

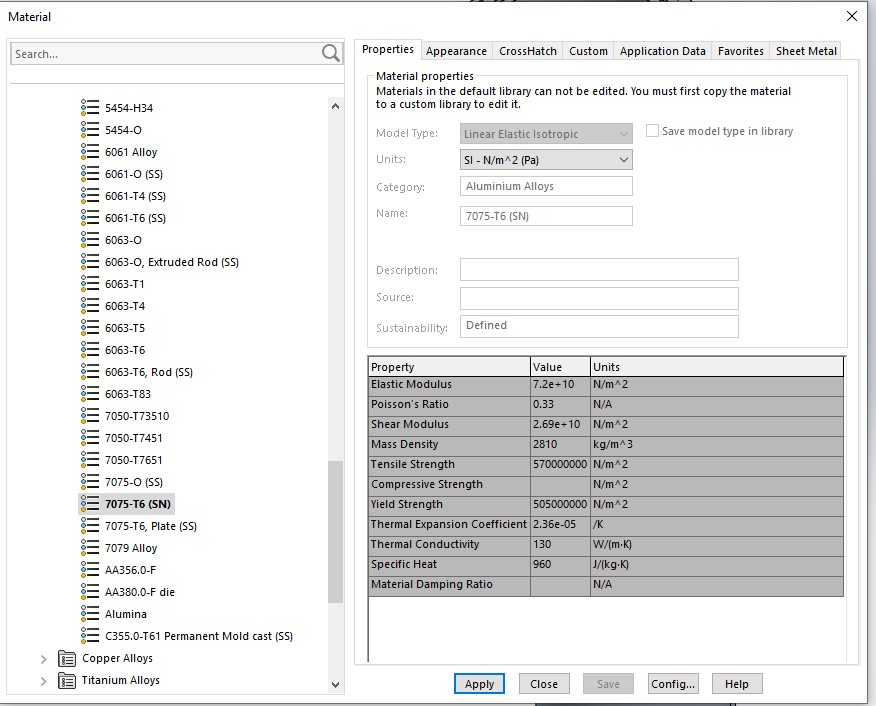
Engineering/2020-2021_PHANTOM/Propulsion/Banshee V1/Combustion Chamber Aluminum Properties.jpg
