Maeswoon/UNHSEDS/Engineering/2020-2021_PHANTOM/Propulsion/Banshee V1/Nozzle Stainless Steel Properties.jpg

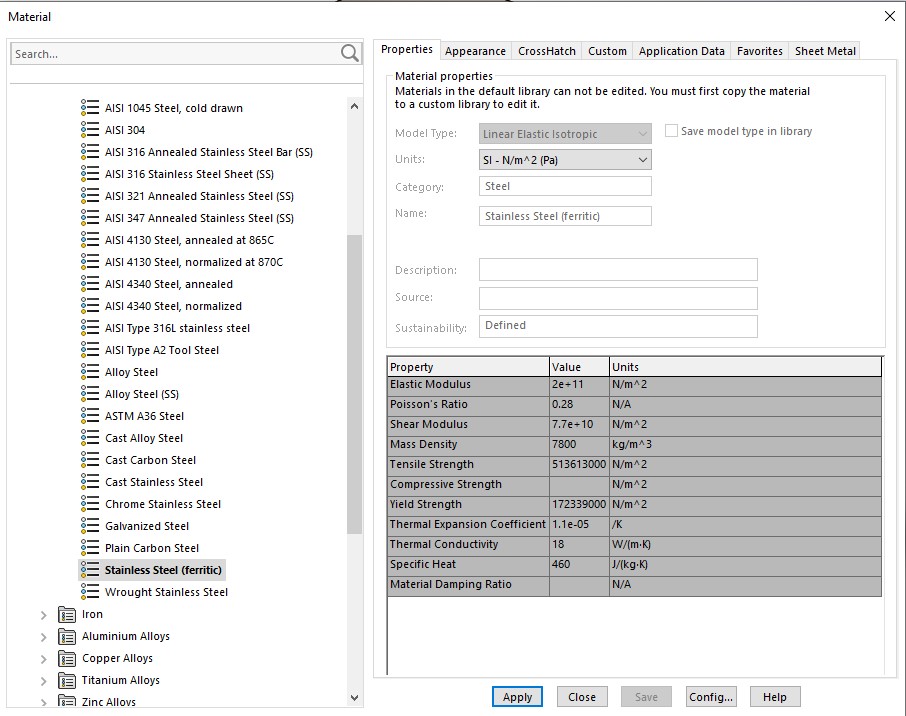
Engineering/2020-2021_PHANTOM/Propulsion/Banshee V1/Nozzle Stainless Steel Properties.jpg
