Maeswoon/UNHSEDS/Engineering/2020-2021_PHANTOM/Propulsion/Banshee V1/ShowerheadDifferential.jpg

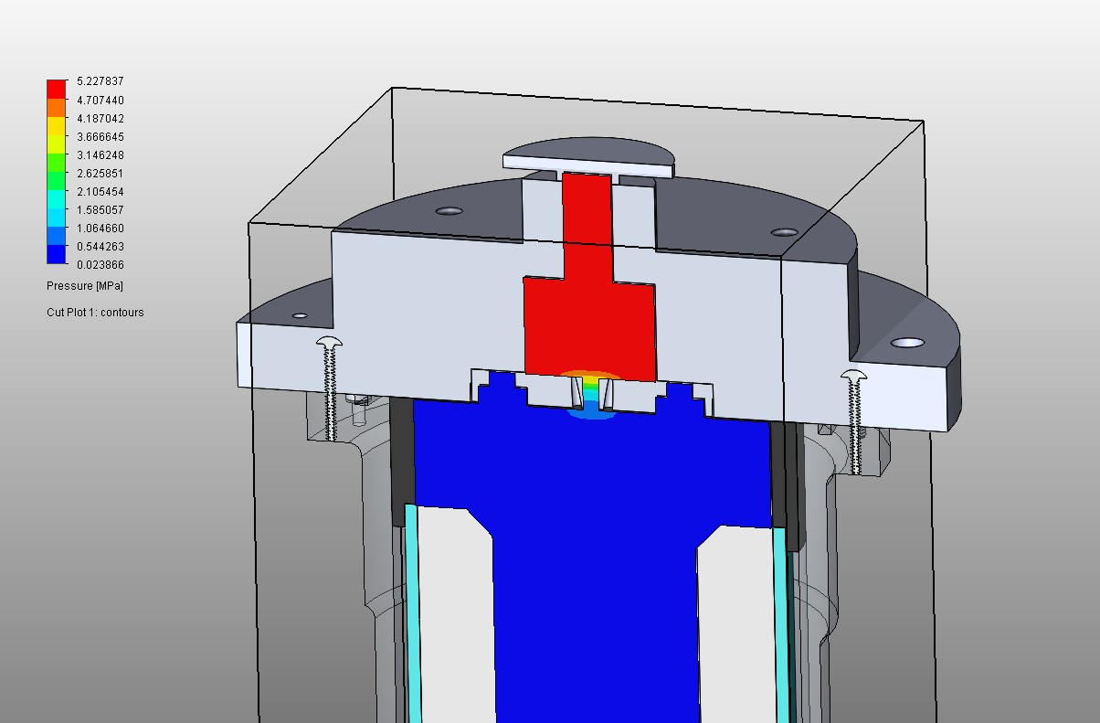
Engineering/2020-2021_PHANTOM/Propulsion/Banshee V1/ShowerheadDifferential.jpg
