Maeswoon/UNHSEDS/Engineering/2020-2021_PHANTOM/Propulsion/Banshee V1/Swirl_Pipes.jpg

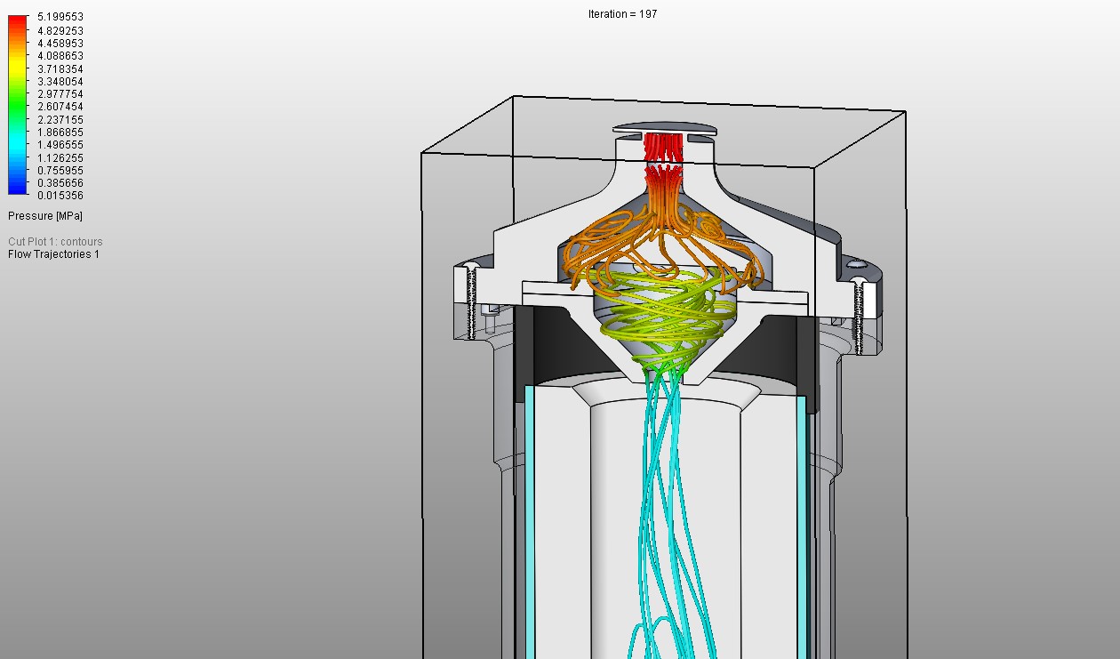
Engineering/2020-2021_PHANTOM/Propulsion/Banshee V1/Swirl_Pipes.jpg
