Maeswoon/UNHSEDS/Engineering/2021-2022_EUROPA/TITAN Frame/Internal Frame Comb V2-Launch_stresses/Grace_pic.PNG

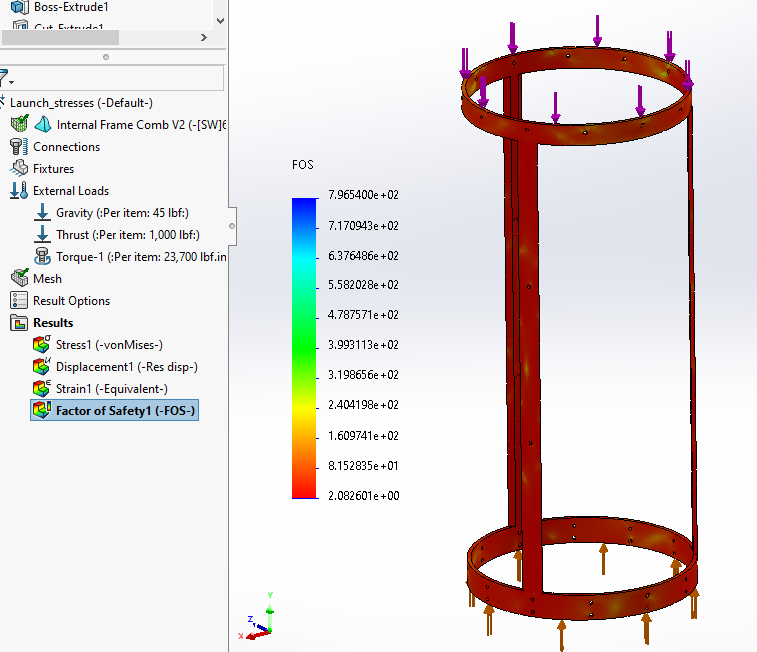
Engineering/2021-2022_EUROPA/TITAN Frame/Internal Frame Comb V2-Launch_stresses/Grace_pic.PNG
