Maeswoon/UNHSEDS/Engineering/2022-2023 Rocket/Sims/Capture.JPG

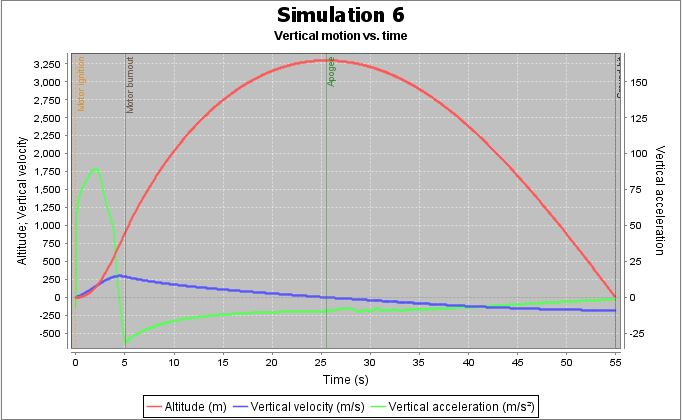
Engineering/2022-2023 Rocket/Sims/Capture.JPG
