Maeswoon/UNHSEDS/Reports and Presentations/Presentations/full_render.JPG

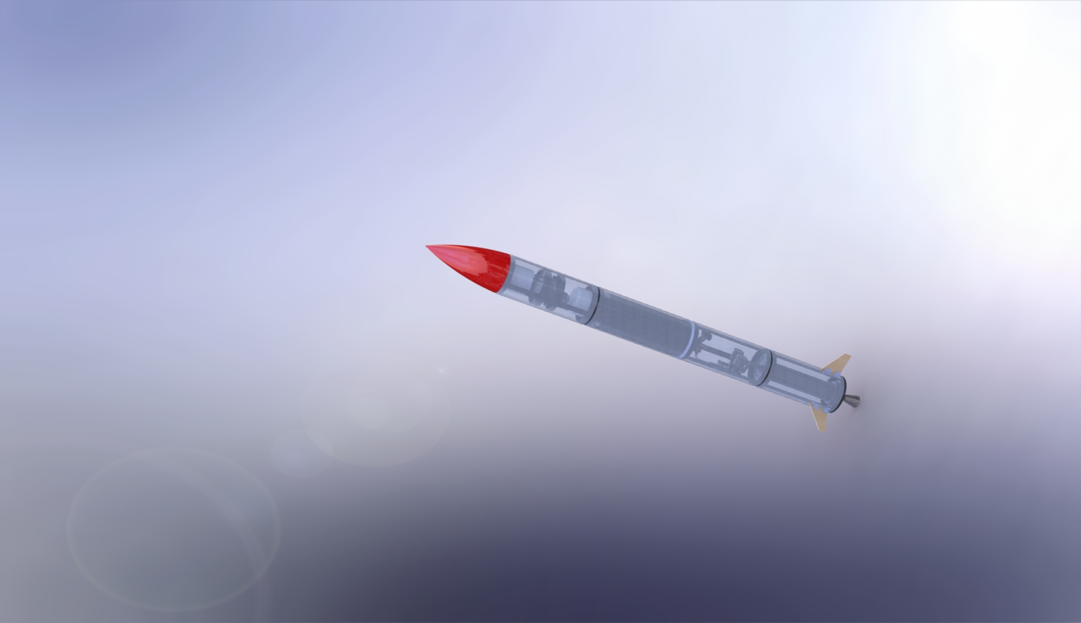
Reports and Presentations/Presentations/full_render.JPG
