Maeswoon/UNHSEDS/Engineering/2019-2020_USURPER/Frame/SOLIDWORKS/Parts/Misc Parts/Fin stuff/CutterSettings.txt

Use the DWG file
10% speed
max power
500 hz
run twice
clean edges w/ paper towel
