Maeswoon/UNHSEDS/Business/Finance/Budgets, Packets and Templates/Budgets/2019-2020/SEDSBudget&OrderForm_2019-2020.xlsx

Sheet: Tracking
Known SEDS-Sponsors | Responsible | Status | Notes | Companies | Responsible | Status | Notes | Personal Companies | Responsible | Status | Notes
80/20 Inc. | Carly Benik | Contacted |  | Hitchiner | Silas Johnson | Accepted! |  | Rocket Lab | Charlie Nitschelm | Accepted! | donated 500!
ANSYS | Lucas Simmonds | Contacted | Fred Phillips NH Sales Rep 978-610-4800 | Advanced Machine Technology | Thomas Pham | Contacted |  | Additive Rocket Coorporation | Charlie Nitschelm | Accepted! | Very reduced cost printing and post-machining services! help with design for printing as well!
Arotech | Lucas Simmonds | Contacted | contacted by email | Apex Plastics | Thomas Pham | Contacted |  | Seneca Machine | Charlie Nitschelm | Accepted! | they can do our nozzle!! will be of great help this year
Cryoquip | Carly Benik | Contacted |  | Aviation Technology Inc | Lucas Simmonds | Contacted | contacted kboyer@aviationtec.com | New England Wire Technologies | Trevor Blampied | Accepted!
National College Resources Foundation | Darren Otten | Contacted |  | Boston Welding & Design, INC. | Thomas Pham | Contacted |  | Waldron Engineering | Ben Letourneau | Accepted! | 250
Parabilis Space Technologies | Tom Pham | Contacted |  | Cohen Steel | Thomas Pham | Contacted |  | Hitchiner Manufacturing | Silas Johnson | Accepted! | Donated last year
GPI Prototype & Manufacturing Services Inc. | Darren Otten | Follow-Up |  | ControlAir, inc. | Thomas Pham | Contacted |  | Best Machine/Woodman Arms | Darren Otten | Accepted! | I have abililty to go in and make parts to help expedite lead times Only have access to their mills because they have limited amount of turning centers and those are always tied up
HP | Megan Johnson | Follow-Up |  | Dynomite Dynamometer | Phillip Deo | Contacted |  | The Stage | Carly Benik | Accepted! | 1000 dollars!
Intel | Megan Johnson | Follow-Up |  | G&A Machine | Thomas Pham | Contacted |  | Turbocam International | Thomas Collins | Accepted! | gave 500!
Metal Technology | Darren Otten | Follow-Up |  | GT Advanced Technologies | Carly Benik | Contacted |  | NH NASA Space Grant | Thomas Collins | Contacted | Follow up 10/3
Sentech | Darren Otten | Follow-Up |  | Lewis and Saunders | Megan Johnson | Contacted |  | Mentis Sciences | Silas Johnson | Contacted | Possibly manufacturing services
Friends of Amateur Rocketry | Grace Johnston | Needs Action |  | Millennium Precision LLC | Megan Johnson | Contacted |  | lockheed martin | Trevor Blampied | Contacted
Qualcomm | Tom Pham | Needs Action |  | Pelham Plastics | Megan Johnson | Contacted |  | Raytheon | Trevor Blampied | Contacted | Nate Sampo & Al Hart (alan.m.hart@raytheon.com)
Tecplot | Silas Johnson | Needs Action |  | ProtoPart, inc. | Thomas Pham | Contacted |  | Sig Sauer | Zach Raboin | Contacted | Andrew Masters: My room mate works here as an engineer in R&D, LMK if you would like me to talk to him.
BAE | Andrew Masters | Talking | Andrew and Kevin are talking with friends at BAE, Recontact on Jan 1st after their funding group has reorganized | RealPower, inc. | Thomas Pham | Contacted |  | Terrafugia | Carly Benik | Contacted
Cadence | Darren Otten | Talking | UNH already has some of their software packages | Timken Super Precision | Carly Benik | Contacted |  | NCS Global | Emilie Leavitt | Follow-Up
 |  |  |  | Tyco | Trevor Blampied | Contacted |  | Hydrocomp | Grace Johnston | Needs Action
 |  |  |  | AccuRounds | Nathan Gunter | Contacted |  | Flight Coffee | Silas Johnson | Needs Action | Coffee shop in dover, likes flight
Advanced Machine Technology | Jeffrey Grant | Contacted | amt.co@comcast.net | Advantage Plastic Products | Nathan Gunter | Contacted |  | BAE | Trevor Blampied | Needs Action | Ashley Pratt - 6035331680 - Sales @ BAE, need to talk with adrew and kevin first
Aviation Technology Inc | Jeffrey Grant | Contacted | Sales@avitechusa.com | BittWare, inc | Nathan Gunter | Contacted |  | Durham Boat | Andrew Masters | Needs Action | Will probably let us use their facilities for carbon composite
Harmonic Drive | Jeffrey Grant | Follow-Up | Dad works here | Bronze Craft | Nathan Gunter | Contacted |  | Prototek | Alice Wade | Needs Action
Cohen Steel | Charlie Nitschelm | Accepted! | info@cohensteel.com | Custom Composite Technologies | Nathan Gunter | Contacted |  | SilverTech | Alice Wade | Contacted
ControlAir, inc. |  | Needs Action | dfournier@ControlAir.com | Elbit Systems | Nathan Gunter | Contacted |  | GE Aviation | Zach Raboin | Talking | asked for final request to show to finance
GT Advanced Technologies |  | Needs Action | info@gtat.com | Freudenberg | Nathan Gunter | Contacted |  | Aerospace Corporation | Charlie Nitschelm | Talking | followed up again 10/13
ESCA Inc. | Alice Wade | Rejected | Company is inactive | S&S Machine | Derek Goulet | Contacted |  | Revision Military | Lucas Simmonds | Talking
Portsmouth Naval Shipyard | Alex Chelsey | Contacted |  | Stone Ridge Control Devices | Carly Benik | Contacted | Contacted Dan O'Connell | Conected Office Technologies | Andrew Masters | Talking | Company that sells printers, but they would probably give 500-1000 if we put the word "toner" on the rocket somwhere
ProtoPart, inc. | Jeffrey Grant | Contacted | info@protopart.com | TMC Fall Machine Co., Inc. | Hassan Al-Jewad | Contacted |  | Westinghouse Electric Comapany | Ross Thyne | Accepted! | 5000
Sierra Nevada Corporation | Alice Wade | Needs Action | sarahmarisacarty@gmail.com | Ty-Flot inc. | Carly Benik | Contacted |  | GKN Aerospace | Lucas Simmonds | Talking
Prototek | Alice Wade | Needs Action | info@prototek.com | Vaupell Rapid Solutions | Eli Duggan | Follow-Up |  | Form3D | Andrew Masters | Talking | May be interested in printing inconel or titanium parts for us
Enventure | Alex Chesley | Contacted | info@enventure.com | Wakefield-Vette | Carly Benik | Contacted |  | Teledyne Marine | Silas Johnson | Talking | Have a contact
Applied Tool & Design | Alex Chesley | Contacted | joe@atdllc.com | Wayne Towle Master Finishing & Restoration | Eli Duggan | Follow-Up |  | Fusion3 | Ross Thyne | Talking
Hoyle Tanner Associates | Alice Wade | Needs Action | wdavidson@hoyletanner.com | Willseal | Derek Goulet | Contacted |  | DELL EMC | Kristian Comer | Talking | Know one the head architechts of their new Mid-teir storage solution
TTI Inc | Alice Wade | Needs Action | (978) 851-2000 | Uraseal, Inc. | Derek Goulet | Contacted |  | NH iPhone Repair | Alice Wade | Talking | Somewhat know the CEO
Amphenol |  | Needs Action | https://www.amphenol.com/contact/index | Raco Manufacturing & Engineering | Derek Goulet | Contacted |  | Proampac | Max Carpenter | Accepted!
Harvey Building Products |  | Needs Action | 800-598-5400 | Generator Connection | Jessica Roberts | Contacted
Labsphere, Inc |  | Needs Action | 603-927-4266 | Continental ContiTech | Jessica Roberts | Contacted
Velcro Companies | Charlie Nitschelm | Contacted | marketing@velcro.com | GE | Trevor Blampied | Contacted
Wilcox Industries Corp | Charlie Nitschelm | Contacted | https://www.facebook.com/Wilcox-Industries-Corp-451458001557819/
Bottomline Technologies | Charlie Nitschelm | Needs Action | https://www.linkedin.com/in/christine-nurnberger-a24ab71/ | Pumpkin Space Systems | Trevor Blampied | Contacted
Harvey Performance | Alice Wade | Needs Action | info@harveyperformance.com | SSL | Trevor Blampied | Contacted
Beswick Engineering | Jeffrey Grant | Contacted | https://www.beswick.com/contact/ | Solidscape, inc. | Emilie Leavitt | Follow-Up
Ferrotec | Alice Wade | Needs Action | (603) 472-6800 | KMC Systems, inc. | Ben Letourneau | Follow-Up
RTD Tech | Alex Chesley | Needs Action | (603) 692-5978 | Marmon Aerospace & Defense | Ben Letourneau | Follow-Up
 |  |  |  | MicroDAQ | Ben Letourneau | Follow-Up
 |  |  |  | Nanocomp Technologies | Ben Letourneau | Follow-Up
 |  |  |  | Thermal Dynamics | Megan Johnson | Follow-Up
 |  |  |  | TST Hydraulics, inc. | Megan Johnson | Follow-Up
 |  |  |  | Veloxion | Megan Johnson | Follow-Up
 |  |  |  | Whelen Engineering | Ben Letourneau | Follow-Up
 |  |  |  | QA Technology Company Inc. | Ben Letourneau | Follow-Up
 |  |  |  | New Hampshire Materials Lab | Ben Letourneau | Follow-Up
 |  |  |  | Globaltek Components | Ben Letourneau | Follow-Up
 |  |  |  | Bottomline Technologies | Ben Letourneau | Follow-Up
 |  |  |  | Choice Metals | Lucas Simmonds | Needs Action
 |  |  |  | Geokon | Grace Johnston | Needs Action
 |  |  |  | MakeWay Machine. Inc. | Carly Benik | Needs Action
 |  |  |  | Moore Nanotech | Megan Johnson | Needs Action
 |  |  |  | NextEra Energy - Seabrook Station | Thomas Collins | Needs Action
 |  |  |  | Wright-Pierce | Lucas Simmonds | Needs Action
 |  |  |  | Pentair | Lucas Simmonds | Needs Action
 |  |  |  | HoneyWell | Thomas Collins | Needs Action
 |  |  |  | Derry Cycle | Nathan Gunter | Needs Action
 |  |  |  | Genesys Aerosystems | Nathan Gunter | Needs Action
 |  |  |  | KRAN Design | Ross Thyne | Needs Action
 |  |  |  | New England CNC Inc. | Ross Thyne | Needs Action | can't find email, need to call when they are open
 |  |  |  | New England Welding, INC. | Ross Thyne | Needs Action
 |  |  |  | Nugent Patterns | Ross Thyne | Needs Action | media.relations@ nexteraenergyresources.com / Janet Ball
 |  |  |  | Precise Technologies Inc. | Ross Thyne | Needs Action
 |  |  |  | Pro Axis Machining | Ross Thyne | Needs Action
 |  |  |  | Robinson Precision Tool | Max Carpenter | Needs Action
 |  |  |  | Defense Manufacturers, Inc. |  | Needs Action
 |  |  |  | Fibre Glast Developments Corporation | Thomas Collins | Rejected | No direct sponsorship, advice and some discount
 |  |  |  | Keystone Precision | Zach Raboin | Rejected | too busy to help right now :/
 |  |  |  | Cirtronics | Nathan Gunter | Talking
 |  |  |  | General Dynamics Electric Boat | Lucas Simmonds | Talking | Contact for EB in CT
 |  |  |  | L3 Warrior Systems | Zach Raboin | Talking | Doesn't look good for sponsorship :/
 |  |  |  | S & H Engineering | Megan Johnson | Talking
 |  |  |  | Soller composites | Thomas Collins | Talking | john@sollercomposites.com
 |  |  |  | Northern Composites | Thomas Collins | Talking | No direct sponsorship due to competition conflict
 |  |  |  | Albany Composites | Thomas Collins | Talking | Talking to two reps
 |  |  |  | Holley | Thomas Collins | Talking | Transfered to Charlie
 |  |  |  | Advanced Automation LLC | Zach Raboin | Talking | interested in providing services for us. trying to plan a tour
 |  |  |  | Dimension Data/NTT | Zach Raboin | Talking | it's complicated
 |  |  |  |  |  | Needs Action
 |  |  |  |  |  | Needs Action
 |  |  |  |  |  | Needs Action
 |  |  |  |  |  | Needs Action
 |  |  |  |  |  | Needs Action
 |  |  |  |  |  | Needs Action
 |  |  |  |  |  | Needs Action
 |  |  |  |  |  | Needs Action
 |  |  |  |  |  | Needs Action
 |  |  |  |  |  | Needs Action
 |  |  |  |  |  | Needs Action
 |  |  |  |  |  | Needs Action
 |  |  |  |  |  | Needs Action
 |  |  |  |  |  | Needs Action
 |  |  |  |  |  | Needs Action
 |  |  |  |  |  | Needs Action
 |  |  |  |  |  | Needs Action
 |  |  |  |  |  | Needs Action
 |  |  |  |  |  | Needs Action
 |  |  |  |  |  | Needs Action
 |  |  |  |  |  | Needs Action
 |  |  |  |  |  | Needs Action
 |  |  |  |  |  | Needs Action
 |  |  |  |  |  | Needs Action
 |  |  |  |  |  | Needs Action
 |  |  |  |  |  | Needs Action
 |  |  |  |  |  | Needs Action
 |  |  |  |  |  | Needs Action
 |  |  |  |  |  | Needs Action
 |  |  |  |  |  | Needs Action
 |  |  |  |  |  | Needs Action
 |  |  |  |  |  | Needs Action
 |  |  |  |  |  | Needs Action
 |  |  |  |  |  | Needs Action
 |  |  |  |  |  | Needs Action
 |  |  |  |  |  | Needs Action
 |  |  |  |  |  | Needs Action
 |  |  |  |  |  | Needs Action
 |  |  |  |  |  | Needs Action
 |  |  |  |  |  | Needs Action
 |  |  |  |  |  | Needs Action
 |  |  |  |  |  | Needs Action
 |  |  |  |  |  | Needs Action
 |  |  |  |  |  | Needs Action
 |  |  |  |  |  | Needs Action
 |  |  |  |  |  | Needs Action
 |  |  |  |  |  | Needs Action
 |  |  |  |  |  | Needs Action
 |  |  |  |  |  | Needs Action
 |  |  |  |  |  | Needs Action
 |  |  |  |  |  | Needs Action
 |  |  |  |  |  | Needs Action
 |  |  |  |  |  | Needs Action
 |  |  |  |  |  | Needs Action
 |  |  |  |  |  | Needs Action
 |  |  |  |  |  | Needs Action
 |  |  |  |  |  | Needs Action
 |  |  |  |  |  | Needs Action
 |  |  |  |  |  | Needs Action
 |  |  |  |  |  | Needs Action
 |  |  |  |  |  | Needs Action
 |  |  |  |  |  | Needs Action
 |  |  |  |  |  | Needs Action
 |  |  |  |  |  | Needs Action
 |  |  |  |  |  | Needs Action
 |  |  |  |  |  | Needs Action
 |  |  |  |  |  | Needs Action
 |  |  |  |  |  | Needs Action
 |  |  |  |  |  | Needs Action
 |  |  |  |  |  | Needs Action
 |  |  |  |  |  | Needs Action
 |  |  |  |  |  | Needs Action
 |  |  |  |  |  | Needs Action
 |  |  |  |  |  | Needs Action
 |  |  |  |  |  | Needs Action
 |  |  |  |  |  | Needs Action
 |  |  |  |  |  | Needs Action
 |  |  |  |  |  | Needs Action
 |  |  |  |  |  | Needs Action
 |  |  |  |  |  | Needs Action
 |  |  |  |  |  | Needs Action
 |  |  |  |  |  | Needs Action
 |  |  |  |  |  | Needs Action
 |  |  |  |  |  | Needs Action
 |  |  |  |  |  | Needs Action
 |  |  |  |  |  | Needs Action
 |  |  |  |  |  | Needs Action
 |  |  |  |  |  | Needs Action
 |  |  |  |  |  | Needs Action
 |  |  |  |  |  | Needs Action
 |  |  |  |  |  | Needs Action
 |  |  |  |  |  | Needs Action
 |  |  |  |  |  | Needs Action
 |  |  |  |  |  | Needs Action
 |  |  |  |  |  | Needs Action
 |  |  |  |  |  | Needs Action
 |  |  |  |  |  | Needs Action
 |  |  |  |  |  | Needs Action
 |  |  |  |  |  | Needs Action
 |  |  |  |  |  | Needs Action
 |  |  |  |  |  | Needs Action
 |  |  |  |  |  | Needs Action
 |  |  |  |  |  | Needs Action
 |  |  |  |  |  | Needs Action
 |  |  |  |  |  | Needs Action
 |  |  |  |  |  | Needs Action
 |  |  |  |  |  | Needs Action
 |  |  |  |  |  | Needs Action
 |  |  |  |  |  | Needs Action

Sheet: Current Budget
Date: | Item: | Funds (+): | Expenses (-): | Total: | Notes: | Reimbursement: | Item(s): | Amount: | Done?
2019-08-02 | Starting Balance | ------------------ | -------------------- | $563.38 | Funding: $26241.63 | Charlie Nitschelm | O-ring Pack | $14.91 | FALSE
2019-08-02 | Donation - ME Department | $1600.00 |  | $2163.38 | Expenses: $20585.36 | Charlie Nitschelm | aluminum powder | $16.99 | FALSE
2019-08-05 | Amazon - Relay Module |  | $30.72 | $2132.66 |  |  |  |  | FALSE
2019-08-17 | Digikey - Connectors/Cables |  | $59.76 | $2072.90 |  |  |  |  | FALSE
2019-09-11 | DHop - Kick Off Meeting Pizza |  | $132.37 | $1940.53 |  |  |  |  | FALSE
2019-09-13 | Apogee - Project Supplies |  | $330.26 | $1610.27 |  |  |  |  | FALSE
2019-09-17 | Donation - SEDS Foundation | $1200.00 |  | $2810.27 |  |  |  |  | FALSE
2019-09-17 | Deans Office Contribution | $3500.00 |  | $6310.27 |  |  |  |  | FALSE
2019-09-19 | Donation - Waldron Engineering | $250.00 |  | $6560.27 |  |  |  |  | FALSE
2019-09-23 | Online Metals - Stainless Steel |  | $496.50 | $6063.77 |  |  |  |  | FALSE
2019-09-23 | Aubuchon - Epoxy/Paint/Tape |  | $45.83 | $6017.94 |  |  |  |  | FALSE
2019-09-26 | Todds Touch - Nitrous Oxide Refill |  | $128.00 | $5889.94 |  |  |  |  | FALSE
2019-09-26 | Adafruit - Screen/Cord/Keyboard |  | $203.85 | $5686.09 |  |  |  |  | FALSE
2019-09-26 | Mouser Electronics - Ziggbee Modules |  | $73.11 | $5612.98 |  |  |  |  | FALSE
2019-09-26 | Digikey - Switchkey |  | $42.03 | $5570.95 |  |  |  |  | FALSE
2019-09-26 | Amazon - Rasberry Pi/Briefcase |  | $114.58 | $5456.37
2019-10-05 | Amazon - Relay Module |  | $6.99 | $5449.38
2019-10-09 | Donation - ME Department SV | $1200.00 |  | $6649.38
2019-10-10 | Donation - Anonymous | $500.00 |  | $7149.38
2019-10-16 | Donation - Todd Gross | $333.33 |  | $7482.71
2019-10-18 | SparkFun - Xbee Explorer USB |  | $58.56 | $7424.15
2019-10-23 | Donation - Turbocam | $500.00 |  | $7924.15
2019-10-25 | Donation - Physics Department | $300.00 |  | $8224.15
2019-10-28 | Expedia - Carly Flight |  | $501.58 | $7722.57
2019-11-01 | Donation - SAFC | $1300.00 |  | $9022.57
2019-11-01 | Donation - ECE Department | $500.00 |  | $9522.57
2019-11-11 | SpaceVision Hotels |  | $2522.13 | $7000.44
2019-11-12 | SwageLok - Indicator Valve Switch |  | $116.46 | $6883.98
2019-11-13 | Holley - Carbon Fiber Nitrous Tank |  | $724.95 | $6159.03
2019-11-13 | Donation - GKN Aerospace | $1000.00 |  | $7159.03
2019-11-14 | Donation - Stage Resteraunt | $1000.00 |  | $8159.03
2019-11-14 | Donation - Hitchiner Manufacturing | $200.00 |  | $8359.03
2019-11-14 | McMaster - O-Ring Pack #1 |  | $20.97 | $8338.06
2019-11-15 | SwageLok - Flow Regulation |  | $991.22 | $7346.84
2019-11-19 | Market Basket - Wax Paper |  | $2.99 | $7343.85
2019-11-20 | Hobby Lobby - Estes Engines |  | $38.94 | $7304.91
2019-11-22 | Apogee - TVC Supplies |  | $352.08 | $6952.83
2019-11-23 | McMaster - O-Ring Pack #2 |  | $14.91 | $6937.92
2019-11-25 | Donation - GZA (GE Aviation) | $3000.00 |  | $9937.92
2019-11-25 | Hannaford - Barbecue Food |  | $111.60 | $9826.32
2019-11-25 | Philbrook Cafe - Barbecue Food |  | $8.58 | $9817.74
2019-12-04 | Adafruit - IMU |  | $77.73 | $9740.01
2019-12-04 | McMaster - 1' Delrin Rod |  | $11.86 | $9728.15
2019-12-10 | Donation - Math Department | $200.00 |  | $9928.15
2019-12-10 | Adafruit - 2.4GHz Antennas |  | $25.73 | $9902.42
2019-12-10 | Amazon - 1' HDMI Cable |  | $5.94 | $9896.48
2019-12-10 | MaxAmps - 22.2V Lipo Battery |  | $109.94 | $9786.54
2019-12-11 | ESRA - Spaceport Registration |  | $200.00 | $9586.54
2019-12-12 | Donation - CS Department | $300.00 |  | $9886.54
2019-12-16 | McMaster - Runaway V2 and Frame |  | $1048.77 | $8837.77
2019-12-16 | Automation Direct Pressure Sensor |  | $123.00 | $8714.77
2019-12-16 | Todds Touch - Nitrous Oxide Refill |  | $102.00 | $8612.77
2019-12-16 | Technical Glass Product - SiO2 Insert |  | $95.45 | $8517.32
2019-12-23 | Donation - SEDS USA | $500.00 |  | $9017.32
2020-01-09 | SpaceVision Member Reimbursement |  | $3000.00 | $6017.32
2020-01-14 | Swagelok - Supplies |  | $444.63 | $5572.69
2020-01-14 | Online Metals - Aluminum for Chamber |  | $673.69 | $4899.00
2020-01-14 | Conax - Temperature Sensor |  | $195.56 | $4703.44
2020-01-17 | McMaster - Aluminum Return (12/16) | $775.48 |  | $5478.92
2020-01-21 | Swagelok - Tube Fittings |  | $193.51 | $5285.41
2020-01-23 | LOC Presicion - 30" Cardboard Tube |  | $55.26 | $5230.15
2020-01-23 | McMaster - Frame Angle Stock |  | $61.46 | $5168.69
2020-01-27 | Graphite Store - Graphite Insert |  | $74.44 | $5094.25
2020-01-27 | Donation - Parent's Association | $2000.00 |  | $7094.25
2020-01-28 | Adafruit - Altitude Sensor |  | $24.40 | $7069.85
2020-01-29 | Sainsmart - Xbee/Arduino Shield |  | $30.99 | $7038.86
2020-01-30 | Metal Depot - Frame 8' Angle Stock |  | $193.62 | $6845.24
2020-01-31 | DHOP - Info Meeting Pizza |  | $137.81 | $6707.43
2020-02-01 | McMaster - Various Projects |  | $118.46 | $6588.97
2020-02-02 | Home Depot - 6 Gallon Compressor |  | $154.09 | $6434.88
2020-02-03 | Candle Making Supplies - Paraffin Wax |  | $48.45 | $6386.43
2020-02-04 | Amazon - 1/8" NPT Female to 10-32 |  | $33.63 | $6352.80
2020-02-05 | Holley - NOS/Co2 Tank Fittings |  | $54.01 | $6298.79
2020-02-06 | Swagelok - Valves |  | $858.06 | $5440.73
2020-02-03 | Swagelok - Tube Fittings |  | $63.67 | $5377.06
2020-02-03 | DHOP - MIT Speaker Meeting |  | $88.52 | $5288.54
2020-02-05 | Mcmaster - Prop order |  | $18.82 | $5269.72
2020-02-06 | Pegasus - Metal Strut Clamp |  | $52.97 | $5216.75
2020-02-06 | McMaster - Frame Plates |  | $104.31 | $5112.44
2020-02-07 | Hannaford - Hackathon Supplies |  | $16.88 | $5095.56
2020-02-11 | Swagelok - Flow Regulation |  | $279.66 | $4815.90
2020-02-13 | DrillandCutters - Drill Bits |  | $26.55 | $4789.35
2020-02-13 | Apogee - Frame Body Tube |  | $234.02 | $4555.33
2020-02-13 | Apogee - Refund for Shipping | $12.46 |  | $4567.79
2020-02-14 | MSC - 1/32" Carbide Jobber Drill |  | $13.84 | $4553.95
2020-02-14 | MSC - 1/64" Drill Bit |  | $19.29 | $4534.66 | shipping not included
2020-02-14 | Home Depot - Parafin Molding Tubes |  | $131.78 | $4402.88
2020-02-17 | Donation - Proampac | $300.00 |  | $4702.88
2020-02-18 | McMaster - Aluminum for Nosecone |  | $33.21 | $4669.67
2020-02-19 | Farmington HOP - Pizza for Seneca |  | $45.44 | $4624.23
2020-02-20 | McMaster - Frame plate and bolts |  | $38.89 | $4585.34
2020-02-20 | Amazon - Fiberglass Molding Paste |  | $18.49 | $4566.85
2020-02-20 | Swagelok - Project Supplies |  | $129.55 | $4437.30
2020-02-20 | Swagelok - Project Supplies |  | $112.20 | $4325.10
2020-02-20 | Swagelok - Valve Return | $570.36 |  | $4895.46
2020-02-24 | McMaster - Delrin for Parrafin |  | $70.03 | $4825.43
2020-02-26 | Fruity Chutes - Recovery |  | $856.18 | $3969.25
2020-02-26 | McMaster - Threaded Rod |  | $12.65 | $3956.60
2020-02-26 | McMaster - L-Key |  | $14.75 | $3941.85
2020-02-27 | Home Depot - PVC Connectors |  | $15.25 | $3926.60
2020-02-28 | McMaster - Bracket and O-Ring |  | $23.16 | $3903.44
2020-03-04 | McMaster - Aluminum Pipe Fitting |  | $23.68 | $3879.76
2020-03-04 | UNH GSS - Postage Return |  | $7.13 | $3872.63
2020-03-04 | Shipping |  | $7.14 | $3865.49 | Return Pres sensor
2020-03-05 | Todds Touch - Nitrous Oxide Refill |  | $119.00 | $3746.49 | 14Lb_NOS
2020-03-05 | Apogee - Model rocket things |  | $149.67 | $3596.82
2020-03-12 | Online metals - Aluminum sheets |  | $67.34 | $3529.48
2020-03-12 | Mcmaster - U-bolts |  | $9.83 | $3519.65
2020-05-19 | Seneca - V2 Machining |  | $2500.00 | $1019.65
 |  |  |  | $1019.65
 |  |  |  | $1019.65
 |  |  |  | $1019.65
 |  |  |  | $1019.65
 |  |  |  | $1019.65
 |  |  |  | $1019.65
 |  |  |  | $1019.65
 |  |  |  | $1019.65
 |  |  |  | $1019.65
 |  |  |  | $1019.65
 |  |  |  | $1019.65
 |  |  |  | $1019.65
 |  |  |  | $1019.65
 | Donation - ME Department | $200.00 |  | $1219.65
 |  |  |  | $1219.65
 |  |  |  | $1219.65
 | Donation - Westinghouse Electric | $5000.00 |  | $6219.65
 |  |  |  | $6219.65
 |  |  |  | $6219.65
 |  |  |  | $6219.65
 |  |  |  | $6219.65
 |  |  |  | $6219.65
 |  |  |  | $6219.65
 |  |  |  | $6219.65
 |  |  |  | $6219.65
 |  |  |  | $6219.65
 |  |  |  | $6219.65
 |  |  |  | $6219.65
 |  |  |  | $6219.65
 |  |  |  | $6219.65
 |  |  |  | $6219.65
 |  |  |  | $6219.65
 |  |  |  | $6219.65
 |  |  |  | $6219.65
 |  |  |  | $6219.65
 |  |  |  | $6219.65
 |  |  |  | $6219.65
 |  |  |  | $6219.65
 |  |  |  | $6219.65
 |  |  |  | $6219.65
 |  |  |  | $6219.65
 |  |  |  | $6219.65
 |  |  |  | $6219.65
 |  |  |  | $6219.65

Sheet: Expected Budget
Section: | Item: | Cost: | Totals: | Description:
Propulsion | SwageLok Flow Regulation | $1100.00 | $7225.00
 | Carbon Fiber Nutritious Oxide Tank | $725.00
 | Stainless Steel Nozzle | $600.00
 | Nutritious Oxide Refills | $650.00
 | Runaway V2 Hardware | $2500.00
 | Runaway V3 Hardware | $1400.00
 | HTPB Rubber Fuel | $250.00
Frame | Fiberglass Shell | $1250.00 | $2150.00
 | Internal Support Structure | $400.00
 | Nose Cone | $250.00
 | Fins | $250.00
Avionics | Parachutes | $750.00 | $2200.00
 | Flight Hardware | $650.00
 | Briefcase Equipment | $300.00
 | Hotfire Test Equipment | $500.00
Thrust Vectoring | Supporting Quadcopter Equipment | $350.00 | $1350.00
 | Test Rocket Materials | $250.00
 | Consumable Engines | $200.00
 | TVC Electronics and Hardware | $550.00
Operations | Test Bunker/Trailer Materials | $2500.00 | $3000.00
 | Horizontal Test Stand | $500.00
Conferences | SpaceVision | $5400.00 | $9400.00
 | SpacePort America Cup | $4000.00
Business | Food for Meetings and Events | $500.00 | $6700.00
 | Banquet | $1200.00
 | Savings | $5000.00
Miscellaneous | Shop Organization | $500.00 | $1000.00
 | Shop Decoration | $250.00
 | Tools | $250.00
Cumulative Totals | Propulsion | $7225.00 | $33025.00
 | Frame | $2150.00
 | Avionics | $2200.00
 | Thrust Vectoring | $1350.00
 | Operations | $3000.00
 | Conferences | $9400.00
 | Business | $6700.00
 | Miscellaneous | $1000.00

Sheet: Order Form
Responsible: | Item: | Vendor: | Quantity: | Price: | Shipping: | Total: | Purchased: | Reason: | Link:
Zach Raboin | Strut-Mount Metal Routing Clamp 304 Stainless Steel, 3/8" ID, 1/16" Thick | McMaster | 3 | $2.80 | $8.13 | $16.53 | Received | Down size engine so we need smaller clamps for horizontal TS | https://www.mcmaster.com/3115t028
Zach Raboin | Aluminum Threaded Rod - 5/16"-18 Thread Size, 1 Foot Long | McMaster | 1 | $2.29 | $0.00 | $2.29 | Received | Pressure sensor incorporation | https://www.mcmaster.com/94435a518
Thomas Collins | Aluminum Frame Plates | McMaster | 4 | $21.68 | $17.59 | $104.31 | Received | Support Structure | https://www.mcmaster.com/8975k213-8975K441
Zach Raboin | 3 1/8" Metal Strut Routing Clamps | McMaster | 3 | $2.71 | $0.00 | $8.13 | Received | Chamber Clamps | https://www.mcmaster.com/catalog/126/1702
Thomas Collins | Body Tube | Apogee Rocket Comp. | 2 | $73.27 |  | $146.54 | Received | Rocket Body Tube | https://www.apogeerockets.com/Building_Supplies/Body_Tubes/High_Power_Tubes/7-51in_LOC_Body_Tube
Charlie Nitschelm | PVC piping, steel pipe, steel cap, copper pipe, metal l bracket | Home Depot | 1 | $131.78 |  | $131.78 | Received
Cornelis Plomp | 6"x6"x.5" aluminum square | McMaster | 1 | $16.45 |  | $16.45 | Received | Recovery bay plate | https://www.mcmaster.com/8975k219-9246K493
Nathan Gunter | Buttonhead screws Zinc-Plated pack of 50, 6-32 Thread, 1/2" Long | McMaster | 1 | $11.46 |  | $11.46 | Received | Frame | https://www.mcmaster.com/91306a324
Nathan Gunter | Steel Eyebolt with Shoulder | McMaster | 1 | $3.21 |  | $3.21 | Received | Parachute | https://www.mcmaster.com/3014t45
Zach Raboin | 5" diameter x 2" long Delrin round stock | McMaster | 1 | $50.67 |  | $50.67 | Received | Grain Mold Base | https://www.mcmaster.com/8582k34
Zach Raboin | 1" diameter x 2 feet long Delrin round stock | McMaster | 1 | $9.44 |  | $9.44 | Received | Grain Mold | https://www.mcmaster.com/8572k61/
Silas Johnson | Unistrut U fitting | McMaster | 2 | $3.84 |  | $7.68 | Ordered | Test stand | https://www.mcmaster.com/33125T65
Charlie Nitschelm | O-rings extra | Mcmaster | 1 | $8.67 |  | $8.67 | Ordered | extra engine orings | https://www.mcmaster.com/1283n74
Cornelis Plomp | Aluminum plates | Onlinemetals.com | 3 | $17.48 | $14.90 | $67.34 | Ordered | Recovery bay walls (Mcmaster doesn't have size) | https://www.onlinemetals.com/en/buy/aluminum/0-063-aluminum-sheet-6061-t6/pid/1242
Alex Chesley | Return Shipping | Automationdirect.com | 1 | $7.13 |  | $7.13 | Ordered | Returning Sensor
Cornelis Plomp | Centering rings | Apogee Rocket Comp. | 3 | $5.19 |  | $15.57 | Ordered | Model rocket group | https://www.apogeerockets.com/Building_Supplies/Centering_Rings/For_54mm_Body_Tubes/Centering_Rings_29mm_LOC_to_54mm
Cornelis Plomp | G54 Engine | Apogee Rocket Comp. | 1 | $29.46 |  | $29.46 | Ordered | Model rocket group | https://www.apogeerockets.com/Rocket_Motors/Cesaroni_Propellant_Kits/29mm_Motors/3-Grain_Motors/Cesaroni_P29-3G_Red_Lightning_G54
Cornelis Plomp | Body tubes | Apogee Rocket Comp. | 3 | $9.78 | $75.30 | $104.64 | Ordered | Model rocket group | https://www.apogeerockets.com/Building_Supplies/Body_Tubes/High_Power_Tubes/54mm_LOC_Body_Tube
Alex Chesley | Nitrouse | Todds Touch | 1 | $119.00 |  | $119.00 | Received | Fill Tanks
Nicholas Muche | Toggle switch brief case power | Amazon | 1 | $6.69 |  | $6.69 |  | Launch control module | https://www.amazon.com/Rocker-Switch-Household-Appliances-MXRS/dp/B07L9JWVVR
Cornelis Plomp | Galvanized Steel U-Bolt | McMaster | 2 | $1.51 | $6.81 | $9.83 | Ordered | Launch control module | https://www.mcmaster.com/2936t48
Charlie Nitschelm | Diamond Sand Paper | Mcmaster | 1 | $28.90 |  | $28.90 |  | to polish and sand to size glass | https://www.mcmaster.com/4023a12
 |  |  |  |  |  | $0.00
 |  |  |  |  |  | $0.00
 |  |  |  |  |  | $0.00
 |  |  |  |  |  | $0.00
 |  |  |  |  |  | $0.00
 |  |  |  |  |  | $0.00
 |  |  |  |  |  | $0.00
 |  |  |  |  |  | $0.00
 |  |  |  |  |  | $0.00
 |  |  |  |  |  | $0.00
 |  |  |  |  |  | $0.00
 |  |  |  |  |  | $0.00
 |  |  |  |  |  | $0.00
 |  |  |  |  |  | $0.00
 |  |  |  |  |  | $0.00
 |  |  |  |  |  | $0.00
 |  |  |  |  |  | $0.00
 |  |  |  |  |  | $0.00
 |  |  |  |  |  | $0.00
 |  |  |  |  |  | $0.00
 |  |  |  |  |  | $0.00
 |  |  |  |  |  | $0.00
 |  |  |  |  |  | $0.00
 |  |  |  |  |  | $0.00
 |  |  |  |  |  | $0.00
 |  |  |  |  |  | $0.00
 |  |  |  |  |  | $0.00
 |  |  |  |  |  | $0.00
 |  |  |  |  |  | $0.00
 |  |  |  |  |  | $0.00
 |  |  |  |  |  | $0.00
 |  |  |  |  |  | $0.00
 |  |  |  |  |  | $0.00

Sheet: Company Sponsors
Sponsors: | Responsible: | Address: | Email: | Contact Name: | Phone Number: | Method of Contact: | Donation: | Services Value: | Services Given: | Totals:
Seneca | Charlie Nitschelm | 317 Main St. Farmington, NH | justin@senecamachine.com | Justin - Owner |  | Email | $0.00 | $1000.00 | Nozzle machining | Services Total: $2650
Hitchiner | Silas Johnson | 594 Elm St. Milford, NH |  |  |  |  | $200.00 | $0.00 |  | Monetary Total: $12250
Additive Rocket Coorporation | Charlie Nitschelm | look online, they moving soon |  | Kyle, Founder, CTO | 1 714-330-7603 | Email | $0.00 | $0.00 | printing if needed | School Total: $9633.33
New England Wire Technologies | Trevor Blampied | 130 N Main St, Lisbon, NH |  |  |  |  | $0.00 | $400.00 | custom wire!\ | Cumulative Total: $24533.33
Waldron Engineering | Ben Letourneau | 37 Industrial Drive, Suite G-1, Exeter, NH | twaldron@waldron.com | Terry Waldron |  | Personal Contact | $250.00 | $0.00
Best Machine/Woodman Arms | Darren Otten |  |  |  |  |  | $0.00 | $0.00 | Darren can use machines
Stage Restaraunt | Carly Benik | 30 Central Square Keene, NH |  |  |  | Personal Contact | $1000.00 | $0.00
Advanced Automation LLC | Zach Raboin | 300 Constitution Ave. Portsmouth, NH | ktierney@advautomation.us | Kyle Tierney | 732-245-5654 | Email/Phone | $0.00 | $250.00 | Machining, waterjet, tube bending, and 3D printing
Rocket Lab | Charlie Nitschelm | Aukland, New Zealand | m.bailey@rocketlab.co.nz | Morgan Bailey |  | Email | $500.00 | $0.00
Turbocam | Thomas Collins | 607 Calef Hwy #200, Barrington, NH 03825 | Suzie.Noronha@turbocam.com | Suzie Noronha | NA | Email | $500.00 | $1000.00 | Reilly can use machines
SEDS USA | Alice Wade | Plano, TX | chair@seds.org |  |  | Grant Application | $500.00 | $0.00
GKN Aerospace | Lucas Simmonds | 1000 Corporate Row, Cromwell CT 06416 | susan.stgermain@usa.gknaerospace.com | Susan St. Germain |  | Personal Contact | $1000.00 | $0.00
Westinghouse Electric | Ross Thyne |  |  |  |  | Personal Contact | $5000.00 | $0.00
GE Aviation (GZA) | Zach Raboin | 31 Industrial Park Dr, Hooksett, NH 03106 | robert.swan@ge.com | Rob Swan |  | Personal Contact | $3000.00 | $0.00
ProAmpac | Max Carpenter | Cincinnati, OH | Kristy.Paulin@Proampac.com | Kristy Paulin |  | Email | $300.00 | $0.00
Cohen Steel | Alice Wade |  | kristin@cohensteel.com | Kristin Poslusny |  | Email | $0.00 |  | Permission to browse their scrap

Sheet: School Sponsors
Sponsors: | Responsible: | Address: | Email: | Contact Name: | Phone Number: | Contacted By: | Donation: | Total:
UNH Deans Office | Charlie Nitschelm |  | sharon.mccrone@unh.edu | Sharon McCrone |  | Email | $3500.00 | $3500.00
Parent's Grant | Alice Wade |  | lynn.beaver@unh.edu | Lynn Beaver |  | Grant Application | $2000.00 | $5500.00
SAFC | Alice Wade |  | saf.chair@unh.edu | Gareth |  | Meeting | $1300.00 | $6800.00
UNH ME | Charlie Nitschelm |  | chris.white@unh.edu | Prof White |  | Email | $1200.00 | $8000.00
UNH EE/CE | Charlie Nitschelm |  | kent.chamberlin@unh.edu | Prof Chamberlin |  | Email | $500.00 | $8500.00
UNH Physics | Charlie Nitschelm |  | karsten.pohl@unh.edu | Prof Pohl |  | Email | $300.00 | $8800.00
UNH CS | Charlie Nitschelm |  | radim.bartos@unh.edu | Prof Bartos |  | Email | $300.00 | $9100.00
UNH Math | Charlie Nitschelm |  | karen.graham@unh.edu | Prof Graham |  | Email | $200.00 | $9300.00
Todd Gross | Nobody? |  | todd.gross@unh.edu | Prof Gross |  | Email | $333.33 | $9633.33
 |  |  |  |  |  |  |  | $9633.33
 |  |  |  |  |  |  |  | $9633.33
 |  |  |  |  |  |  |  | $9633.33
 |  |  |  |  |  |  |  | $9633.33
 |  |  |  |  |  |  |  | $9633.33
 |  |  |  |  |  |  |  | $9633.33
 |  |  |  |  |  |  |  | $9633.33
 |  |  |  |  |  |  |  | $9633.33
 |  |  |  |  |  |  |  | $9633.33
 |  |  |  |  |  |  |  | $9633.33 | For Spacevision | Spent | 2382.55
 |  |  |  |  |  |  |  | $9633.33 | 2000 | 1429.53 | 3 hotel room
 |  |  |  |  |  |  |  | $9633.33 |  | 953.02 | 2 hotel room
 |  |  |  |  |  |  |  | $9633.33 |  | 1440 | Reimburing all for registration (not thomas, andrew, kevin)
 |  |  |  |  |  |  |  | $9633.33 |  | 1500 | 50 dollar stipend for food
 |  |  |  |  |  |  |  | $9633.33
 |  |  |  |  |  |  |  | $9633.33
 |  |  |  |  |  |  |  | $9633.33
 |  |  |  |  |  |  |  | $9633.33 |  | 5322.55
 |  |  |  |  |  |  |  | $9633.33 | -3322.55
 |  |  |  |  |  |  |  | $9633.33
 |  |  |  |  |  |  |  | $9633.33
 |  |  |  |  |  |  |  | $9633.33
 |  |  |  |  |  |  |  | $9633.33
 |  |  |  |  |  |  |  | $9633.33
 |  |  |  |  |  |  |  | $9633.33
 |  |  |  |  |  |  |  | $9633.33
 |  |  |  |  |  |  |  | $9633.33
 |  |  |  |  |  |  |  | $9633.33
 |  |  |  |  |  |  |  | $9633.33
 |  |  |  |  |  |  |  | $9633.33
 |  |  |  |  |  |  |  | $9633.33
 |  |  |  |  |  |  |  | $9633.33
 |  |  |  |  |  |  |  | $9633.33
 |  |  |  |  |  |  |  | $9633.33
 |  |  |  |  |  |  |  | $9633.33
 |  |  |  |  |  |  |  | $9633.33
 |  |  |  |  |  |  |  | $9633.33
 |  |  |  |  |  |  |  | $9633.33
 |  |  |  |  |  |  |  | $9633.33
 |  |  |  |  |  |  |  | $9633.33
 |  |  |  |  |  |  |  | $9633.33

Sheet: Newsletter
Name: | Email: | Affiliation: | Note:
William Collins | ncabill@hotmail.com | Parent/Relative
Suzie Noroha | Suzie.Noronha@turbocam.com | Sponsor
Shawn Latulippe | sel1034@wildcats.unh.edu | TNH Writer
Todd Gross | todd.gross@unh.edu | Professor
Stephanie Langlois | stefanie.langlois@unh.edu | Supporter
Kenneth Madore | kenneth.madore@swagelok.com | Swagelok Guy
Pamerla Sweezy | pamela.sweezy@swagelok.com | Swagelok Assistant
Sheri Millete | sheri.millette@unh.edu | Finance CEPS
Kelly Danforth | kelly.danforth@unh.edu | ME Office Assitant
Lizzy McCarthy | emm1071@wildcats.unh.edu | ME Student Office Assistant
Pamela Lovejoy | pamela.lovejoy@unh.edu | ME Office Assitant
Sharon McCrone | sharon.mccrone@unh.edu | Assosciate Dean of CEPS
Jeanne Sokolowski | jeanne.sokolowski@unh.edu | Director of National Fellowships UNH
Tony Puntin | anthony.puntin@unh.edu | Professor, Senior Design
Jody Record | jody.record@unh.edu | UNH Today Reporter
Lara Gengarelly | lara.gengarelly@unh.edu | Science Education
Stephanie Whitney | stephanie.whitney@unh.edu | Career Director CEPS
Sheldon Parent | sheldon.parent@unh.edu | IT CEPS, big helper
Nate Hastings | nate.hastings@unh.edu | Coordinator of Student Organizations
Kelly Shaw | kelly.shaw@unh.edu | Business Services assistant ceps
Karsten Pohl | karsten.pohl@unh.edu | Physics Head
Karen Graham | karen.graham@unh.edu | Math Head
Kristen Butterfield | kristen.butterfield@unh.edu | Honors Program Head
Justin Mciver | justin@senecamachine.com | Seneca Machines
Ivo Nedyalkov | ivo.nedyalkov@unh.edu | Professor
Morgan Bailey | m.bailey@rocketlab.co.nz | Rocket Lab
Radim Bartos | radim.bartos@unh.edu | CS Head
Angela Couture | angela.couture@aero.org | Aerospace Coorporation
Kent Champberlin | kent.chamberlin@unh.edu | EE/CE Head
Chris White | chris.white@unh.edu | ME Head
Scott Campbell | scott.campbell@unh.edu | Machinist
Kevan Carpanter | kevan.carpenter@unh.edu | Head of TSC CEPS
Kyle Adriany | kyle@arc-engines.com | ARC
Keith Violette | airrocketworks@gmail.com | Supporter
Laura Haight | laura.haight@unh.edu | CEPS Deans Office
Andy Glode | andy.glode@unh.edu | EHS Head
Tiffany Farina |  | CEPS BSC | Email Error
Kate Roberts | kate.roberts@unh.edu | Director of Financial Services
Megan Brunelle | megan.brunelle@unh.edu | University Advancement, U-day organzier
Brooks Payette | brooks.payette@unh.edu | CEPS Outreach
Brad Kinsey | brad.kinsey@unh.edu | Professor ME, Manufacturing
Carole Berry |  | Adminstrative Manager | Retired
Taylor Sievers | taylor.sievers@unh.edu | PodCats
Ron Okeefe | ronald.o'keefe@unh.edu | Police, hot fires
Rebecca Leitt | rebecca.leitt@unh.edu | Supporter | Email Error
Courtney Kapral | ckapral@northerncomposites.com | Northern Composites
Lauren Foxall | lauren.foxall@unh.edu | EE office assistant
Kevin Surette | epm234@comcast.net | Eastern Precision Machining
Diane Stack | stack_diane@wblake.com | Whitney Blake Company
Guy Wadsworth | guywad@charter.net | Rocketry Hobby
Tim Sullivan | tim_sullivan@hitchiner.com | Hitchiner Engineer
Kathleen Doyle | info@aries-eng.com | Aries Engineering, company could sponsor soon
Jessuca Pechtel | jpechtel@nhml.com | Potential company sponsor
David Heirtzler | david.heirtzler@unh.edu | Nasa student grant person
Infinate Imaging | finance@infiniteimaging.com | Past sponsor
Christine Speranza | christine.speranza@unh.edu | UNH Takeover | Email Error
Stephen Eisenhaure | stephen.eisenhaure@unh.edu | office of woodlands and trees and shit | Nice title
Heather Macneill | heather.macneill@unh.edu | Makerspace Head
Bdale Garbee | bdale@gag.com | Telemega Maker
Gloria Robinson | gloria@amwprox.com | AMW person
MayWin Thein | may-win.thein@unh.edu | Professor ME
Ryan Courtright | ryan.courtright@unh.edu | Dairy, deals with fields
Mark McConnell | mark.mcconnell@unh.edu | First SEDS Advisor
Wayne Jones | wayne.jones@unh.edu | Past Dean of CEPS
Doke Collins | collinshees@gmail.com | Parent/Relative
William Wade | ncwades@bellsouth.net | Parent/Relative
Andy Nitschelm | anitschelm@hotmail.com | Parent/Relative
Robin Dite | robin.dite@gmail.com | Parent/Relative
Brenda Whitmore | brenda.whitmore@unh.edu | Facilities
Brad Manning | brad.manning@unh.edu | Director EHS
Paul Chaloux | paul.chaloux@unh.edu | Facilities
Doug Benecks | doug.bencks@unh.edu | University Architect
Hannah Ozek | hfo1002@wildcats.unh.edu | Random Student - do not unsubscribe
Mike Locke | mike.locke@unh.edu | UNH Olson Center
Lena Downes | Lmdownes@mit.edu | MIT Grad Student Aero/Astro
Scott Ballentine | scott.ballentine@swagelok.com | Swagelok Rep
Greg Tucket | Gregtucker@comcast.net | CEO of Proampac
Susan St. Germain | susan.stgermain@usa.gknaerospace.com | Parent/Relative
