Maeswoon/UNHSEDS/Business/Finance/UNH Sponsorship and Grants/CEPS/Budgets 2020-2021.xlsx

Sheet: 2019-2020
UNH SEDS 2020-2021 Budget - Full
 |  |  | Team swag is important, and helps a great deal to unify the team, and provide a lasting affect on our graduates.
UNH SEDS Swag (Apparel)
Member T-Shirts (15) | $247.50
Member Sweatshirts (10) | $317.60
Total Club Expenses |  | $565.10
 |  |  | This is our primary engineering goal which will incoroporate every member of the organization. Most of our funds are for raw material, as we have many connections within industry (close and far away!) that want to support us with machining time that we simply don't have access to within the school.
UNH Hybrid Rocket
Electronic Navigation Components | $250.00
Parachutes | $100.00
Frame Support Material | $400.00
Frame Body Shell | $1000.00
Flow Regulator | $150.00
Nitrous Oxide Refills | $900.00
HTPB Rubber Fuel | $350.00
Stainless Steel Nozzle | $600.00
Combustion Chamber and Injector | $6000.00
Misc. Rocket Hardware | $1500.00
Payload | $1000.00
Total Club Expenses |  | $12250.00
 |  |  | Safety comes first, and we are in need of a professional, presentable and secure location to control and maintain our hot-fire tests. The team as a whole will be tasked with construction.
Hot-Fire Safety Structures
Structure Material | $150.00
Shielding | $150.00
Fire Extinguisher | $70.00
First Aid Kit (Field) | $100.00
Total Club Expenses |  | $470.00
Budget Totals
Apparel |  | $565.10
Engineering |  | $12250.00
Safety |  | $470.00
UNH SEDS Total Budget |  | $13285.10
Received Sponsorship (9/30)
Previous Year Balance | $561.47
ME Senior Project | $1200.00
ProAmpac | $300.00
Addiditive Rocket Coorporation
"Very Reduced Inconel 718 Printing and Post-Machining Services" | TBD
Seneca Machine
Reduced General Machining Costs | TBD
New England Wire Technologies
Westinghouse Electric Corporation
Donation Pending Authorization | TBD
Total Current Sponsorship |  | $2061.47

Sheet: CEPS Grant Request
UNH SEDS 2019-2020 CEPS Request
SEDS-Sponsored and Planned Conference
SpaceVision Networking Event (Tempe, AZ) (20 Members in Attendence)
Airplane Ticket and General Travel | $7956.40
Hotel Housing (3 Nights) | $1605.00
Admission to the SEDS Conference | $1540.00
Total Membership Expenses |  | $11101.40
Price per Student |  | $555.07
