Maeswoon/UNHSEDS/Business/Finance/UNH Sponsorship and Grants/Alumni Grant/Budget.xlsx

Product | Quantity | Cost | Total
Combustion Chamber | 3 | $180.00 | $540.00
Injector Plate | 3 | $110.00 | $330.00
Nozzle | 3 | $200.00 | $600.00
Oxidizer (NOS) | 4 | $130.00 | $520.00
Fuel (HTPB) | 3 | $188.00 | $564.00
 |  | Working Total | $2554.00
