Maeswoon/UNHSEDS/Business/Finance/Budgets, Packets and Templates/Budgets/2017-2019/Budget Sheet.xlsx

BLUETUBE
G54 Engine x3 | $68.28
G125 Engine x3 | $68.28
Fiber Glass Sheet | $80.00
Smaller Terminals | $10.00 | Nah
CARBON FIBER
Nose Cone Manufacturing | $350.00
Carbon Fiber Body Tube 2x 72 inch | $346.00
Carbon Fiber Coupler 36 inch | $175.00
Carbon Fiber Engine Tube 72 inch | $134.00
Carbon Fiber Sheet 1/8 inch 2x 12x12inch | $196.00
I204 Engine x3 | $127.26
H399 Engine x3 | $108.63
BOTH
Rail Buttons x4
Kevlar 100 feet | $97.00
Parachute Drogue, Main and Booster x2 | $120.00
Epoxy | $40.00
2 Battery for TeleMega | $21.82
Ignitors | $60.00
Lithium Battery | $30.00
Switch | $15.00
Miscellaneous Purchases | $200.00
SHIPPING
Shipping | $200.00
HAZMAT Engine Shipping | $64.20
TOTAL | $2511.47
