Maeswoon/UNHSEDS/Engineering/2018-2019/Project Field Safety/Costs.xlsx

Item | Amount | Cost
Sand | 14 dollars per ton - Brox industries | $504
Bags | 2000 | $608
 | 1600 sand bags * 45 lbs = 72000 lbs (upper end)
Beams | 6 beams | $258
Misc 2x4s, shovels, supplies |  | $250
 | •Control Center – 808 Bags
 | •Launch Pad – 750 Bags
 | •TOTAL: 1,558 Bags of Sand | Total = $1620
