Maeswoon/UNHSEDS/Business/Finance/UNH Sponsorship and Grants/Parents Association Grant/Budget 2018-2019.xlsx

 | UNH SEDS 2018-2019 Parents Foundation Budget
 | Cost | Total
Operating Expenses
Engineering
Electronics for Guidence | $600.00
Launch Pad Components | $400.00
Total Engineering Expenses |  | $1000.00
Outreach
Club Stickers/Pens | $150.00
Model Rocket Program (8-15 Year Olds) | $750.00
Phases of the Moon Activity | $150.00
Constellation Activty (6-10 Year Olds) | $150.00
Exoplanet Activity (8-14 Year Olds) | $600.00
Astronaut Glove Box Activty (6-12 Year Olds) | $250.00
Snacks during Outreach Events | $200.00
Total Membership Expenses |  | $2250.00
Club Administration
Club T-Shirts/Polos | $750.00
Total Club Adminstration Expenses |  | $750.00
Total Operating Expenses |  | $4000.00
