Maeswoon/UNHSEDS/Business/Finance/UNH Sponsorship and Grants/Deans Grant/Budget 2018-2019.xlsx

 | UNH SEDS 2018-2019 Budget
 | Cost | Total
Income
Fundraising Income
Company Sponsorship | $0.00
Individual Donation | $500.00
Total Fund Raising Income as of 9/27/2018 |  | $500.00
Operating Expenses
Engineering
Static Test Fire Components | $1500.00
Electronics for Guidence | $600.00
Hybrid Engine Components | $3000.00
CNC Manufacturing Costs | $1000.00
Launch Pad Components | $100.00
Medium Power Rocket Components | $1000.00
Hybrid Rocket Hardware | $3000.00
Miscellaneous Expenses | $500.00
Total Engineering Expenses |  | $10700.00
Outreach
Club Stickers/Pens | $150.00
Model Rocket Program (8-15 Year Olds) | $250.00
Phases of the Moon Activity | $50.00
Constellation Activty (6-10 Year Olds) | $50.00
Exoplanet Activity (8-14 Year Olds) | $400.00
Astronaut Glove Box Activty (6-12 Year Olds) | $100.00
Snacks during Outreach Events | $200.00
Total Membership Expenses |  | $1200.00
Club Administration
Club T-Shirts | $300.00
Total Club Adminstration Expenses |  | $300.00
SpaceVision Networking Event (San Diego, CA)
(16 Members in Attendence)
Airplane Ticket and General Travel | $5000.00
Hotel Housing (3 Nights) | $1000.00
Admission to the SEDS Conference | $750.00
Total Membership Expenses |  | $6750.00
Total Operating Expenses |  | $18450.00
Expected Contributions
Outside Sponsorship |  | $8000.00
ME Department |  | $3450.00
EE/CE Department |  | $1000.00
CEPS Deans |  | $2000.00
Parents Foundation |  | $4000.00
Total of Expenses and Contributions |  | $0.00
