Maeswoon/UNHSEDS/Business/Finance/Budgets, Packets and Templates/Packets/TURBOCAM Sponsorship Packet/UNH SEDS Company Sponsorship Contact.xlsx

Sheet: Tracking
Known SEDS-Sponsors | Responsible | Status | Notes | Other Companies | Responsible | Status | Notes | Personal Companies | Responsible | Status | Notes
AIAA | Thomas Collins | Contacted |  | Advanced Machine Technology | Thomas Pham | Contacted |  | SpaceX | Charlie Nitschelm | Talking | Emailed my contact about it. Low chance.
ZipCar | Thomas Collins | Rejected |  | Apex Plastics | Thomas Pham | Contacted |  | GE Aviation | Zach Raboin | Talking | asked for final request to show to finance
SOLIDWORKS | Zach Raboin | Contacted | sent in a form for educational parternship... anyone have a contact? | Aviation Technology Inc | Lucas Simmonds | Contacted | contacted kboyer@aviationtec.com | Rocket Lab | Charlie Nitschelm | Contacted | sent follow upop with lars, hoping to hear back this week
Parabilis Space Technologies | Tom Pham | Contacted |  | Boston Welding & Design, INC. | Thomas Pham | Contacted |  | Virgin Orbit | Charlie Nitschelm | Contacted | will send a follow up later... contacting sirisha
ANSYS | Lucas Simmonds | Contacted | Fred Phillips NH Sales Rep 978-610-4800 | Cannon Mountain | Silas Johnson | Needs Action |  | Virgin Galactic | Charlie Nitschelm | Contacted | this is wit Sirisha too
Cryoquip | Carly Benik | Needs Action |  | Choice Metals | Lucas Simmonds | Needs Action |  | The Spaceship Company | Charlie Nitschelm | Rejected
Friends of Amateur Rocketry | Grace Johnston | Needs Action |  | Cirtronics | Grace Johnston | Needs Action |  | Pratt & Whitney | Charlie Nitschelm | Contacted
HP | Megan Johnson | Contacted |  | Cohen Steel | Thomas Pham | Contacted |  | Aerospace Corporation | Charlie Nitschelm | Contacted | in contact with executive of iLab, part of aerospace
BAE | Andrew Masters | Talking | Andrew and Kevin are talking with friends at BAE | ControlAir, inc. | Thomas Pham | Contacted |  | Additive Rocket Coorporation | Charlie Nitschelm | Accepted! | Very reduced cost printing and post-machining services! help with design for printing as well!
Intel | Megan Johnson | Contacted |  | Dynomite Dynamometer | Grace Johnston | Needs Action |  | NH NASA Space Grant | Thomas Collins | Contacted
Arotech | Lucas Simmonds | Contacted | contacted by email | Fibre Glast Developments Corporation | Thomas Collins | Rejected |  | Seneca Machine | Charlie Nitschelm | Accepted! | they can do our nozzle!! will be of great help this year
80/20 Inc. | Carly Benik | Contacted |  | G&A Machine | Thomas Pham | Contacted |  | Hydrocomp | Grace Johnston | Needs Action
Qualcomm | Tom Pham | Needs Action |  | General Dynamics Electric Boat | Lucas Simmonds | Contacted | Contact for EB in CT | Turbocam International | Thomas Collins | Talking | Meeting end of Sept to discuss financial assistance / machining
Tecplot | Silas Johnson | Needs Action |  | Geokon | Grace Johnston | Needs Action |  | New England Wire Technologies | Trevor Blampied | Accepted!
Sentech | Darren Otten | Needs Action |  | GT Advanced Technologies | Carly Benik | Needs Action |  | Revision Military | Lucas Simmonds | Contacted
Xometry | Darren Otten | Needs Action |  | Hitchiner | Silas Johnson | Accepted! |  | Waldron Engineering | Ben Letourneau | Accepted!
National College Resources Foundation | Darren Otten | Needs Action |  | Incite Innovation | Lucas Simmonds | Contacted | Contacted through LinkedIn | Conected Office Technologies | Andrew Masters | Talking | Company that sells printers, but they would probably give 500-1000 if we put the word "toner" on the rocket somwhere
Gosco Valves | Darren Otten | Needs Action |  | Kimball Physics | Megan Johnson | Contacted |  | Hitchiner Manufacturing | Silas Johnson | Accepted! | Donated last year
Metal Technology | Darren Otten | Needs Action |  | KMC Systems, inc. | Ben Letourneau | Contacted |  | Flight Coffee | Silas Johnson | Needs Action | Coffee shop in dover, likes flight
GPI Prototype & Manufacturing Services Inc. | Darren Otten | Needs Action |  | L3 Warrior Systems | Zach Raboin | Talking | Doesn't look good for sponsorship :/ | Mentis Sciences | Silas Johnson | Contacted | Possibly manufacturing services
Cadence | Darren Otten | Needs Action |  | Lewis and Saunders | Megan Johnson | Contacted |  | Exothermics Inc | Silas Johnson | Contacted
 |  |  |  | MakeWay Machine. Inc. | Carly Benik | Needs Action |  | NASA/DOD | Silas Johnson | Contacted | Possibly printing services for small parts/ funding for a nosecone or materials at mentis
 |  |  |  | Marmon Aerospace & Defense | Ben Letourneau | Contacted |  | HydroComp, Inc. | Grace Johnston | Needs Action
 |  |  |  | MicroDAQ | Ben Letourneau | Contacted |  | lockheed martin | Trevor Blampied | Contacted
 |  |  |  | Millennium Precision LLC | Megan Johnson | Contacted |  | BAE | Trevor Blampied | Needs Action | Ashley Pratt - 6035331680 - Sales @ BAE, need to talk with adrew and kevin first
 |  |  |  | Mitee Bite | Grace Johnston | Needs Action |  | Raytheon | Trevor Blampied | Contacted | Nate Sampo & Al Hart (alan.m.hart@raytheon.com)
 |  |  |  | Moore Nanotech | Megan Johnson | Needs Action |  | DECA | Trevor Blampied | Needs Action
 |  |  |  | Nanocomp Technologies | Ben Letourneau | Contacted |  | Westinghouse Electric Comapany | Ross Thyne | Talking | Will hear back by Friday about sponsorship -- what friday??????
 |  |  |  | New Hampshire Plastic, inc. | Thomas Collins | Contacted | customerservice@nhplastics.com | Noble Coffee | Andrew Masters | Rejected
 |  |  |  | NextEra Energy - Seabrook Station | Thomas Collins | Needs Action | media.relations@ nexteraenergyresources.com / Janet Ball | GKN Aerospace | Lucas Simmonds | Contacted
 |  |  |  | Pelham Plastics | Megan Johnson | Contacted |  | GE Additive | Charlie Nitschelm | Contacted | waiting to hear back
 |  |  |  | ProtoPart, inc. | Thomas Pham | Contacted |  | Form3D | Andrew Masters | Talking | May be interested in printing inconel or titanium parts for us
 |  |  |  | Raytheon |  | Needs Action | Someone has another contact other than blatti? Yes, i contacted al hart at raythoen -trevor | Teledyne Marine | Silas Johnson | Talking | Have a contact
 |  |  |  | RealPower, inc. | Thomas Pham | Contacted |  | AutoDesk | Andrew Masters | Needs Action
 |  |  |  | S & H Engineering | Megan Johnson | Contacted |  | Fusion3 | Ross Thyne | Contacted
 |  |  |  | Soller composites | Thomas Collins | Talking | john@sollercomposites.com | Sig Sauer | Zach Raboin | Contacted | Andrew Masters: My room mate works here as an engineer in R&D, LMK if you would like me to talk to him
 |  |  |  | Swagelok | Lucas Simmonds | Needs Action |  | NextStep Bionics | Ross Thyne | Contacted
 |  |  |  | Thermal Dynamics | Megan Johnson | Contacted |  | SilverTech | Alice Wade | Rejected
 |  |  |  | Timken Super Precision | Carly Benik | Contacted |  | Pfizer | Ben Letourneau | Needs Action
 |  |  |  | TST Hydraulics, inc. | Megan Johnson | Contacted |  | New Hampshire Oncology | Silas Johnson | Contacted
 |  |  |  | Veloxion | Megan Johnson | Contacted |  | Markem-Imaje | Carly Benik | Needs Action
 |  |  |  | Whelen Engineering | Ben Letourneau | Contacted |  | Durham Boat | Andrew Masters | Needs Action | Will probably let us use their facilities for carbon composite
 |  |  |  | Velcro | Grace Johnston | Needs Action |  | HTS Engineering | Andrew Masters | Needs Action | Close friend works here, very big engineering firm
 |  |  |  | Wright-Pierce | Lucas Simmonds | Needs Action |  | DELL EMC | Kristian Comer | Needs Action | Know one the head architechts of their new Mid-teir storage solution
 |  |  |  | Tyco | Trevor | Contacted |  | The Co8 Group | Kirstian Comer | Needs Action | Know the founder
 |  |  |  | Safran Aerospace Composites | Zach Raboin | Needs Action | struggling to find where to send our info | TFMoran | Alice Wade | Contacted | Know the CFO
 |  |  |  | QA Technology Company Inc. | Ben Letourneau | Contacted |  | NH iPhone Repair | Alice Wade | Contacted | Somewhat know the CEO
 |  |  |  | Pentair | Lucas Simmonds | Needs Action |  | Heritage Wholesalers/Metro Roofing | Kristian Comer | Needs Action
 |  |  |  | Northern Composites | Thomas Collins | Contacted | ckapral@northerncomposites.com
 |  |  |  | New Hampshire Materials Lab | Ben Letourneau | Contacted
 |  |  |  | Globaltek Components | Ben Letourneau | Contacted
 |  |  |  | Bottomline Technologies | Ben Letourneau | Contacted
 |  |  |  | Albany Composites | Thomas Collins | Contacted | heather.kralik@albint.com / Amer-AEC-WebAccountManagers@albint.com
 |  |  |  | Deca | Trevor Blampied | Contacted | cindy@deca.org
 |  |  |  | HoneyWell | Thomas Collins | Needs Action
 |  |  |  | Holley | Thomas Collins | Needs Action
 |  |  |  | Advanced Automation LLC | Zach Raboin | Talking | interested in providing services for us. trying to plan a tour
 |  |  |  | OMNI Services | Zach Raboin | Contacted | emailed my connection
 |  |  |  | Dimension Data/NTT | Zach Raboin | Talking | it's complicated
 |  |  |  | deka | Trevor Blampied | Contacted
 |  |  |  | Keystone Precision | Zach Raboin | Rejected | too busy to help right now :/
 |  |  |  | AccuRounds | Nathan Gunter | Needs Action
 |  |  |  | Advantage Plastic Products | Nathan Gunter | Needs Action
 |  |  |  | BittWare, inc | Nathan Gunter | Needs Action
 |  |  |  | Bronze Craft | Nathan Gunter | Needs Action
 |  |  |  | Custom Composite Technologies | Nathan Gunter | Needs Action
 |  |  |  | Derry Cycle | Nathan Gunter | Needs Action
 |  |  |  | Elbit Systems | Nathan Gunter | Needs Action
 |  |  |  | Freudenberg | Nathan Gunter | Needs Action
 |  |  |  | Genesys Aerosystems | Nathan Gunter | Needs Action
 |  |  |  | KRAN Design | Ross Thyne | Needs Action
 |  |  |  | New England CNC Inc. | Ross Thyne | Needs Action
 |  |  |  | New England Welding, INC. | Ross Thyne | Needs Action
 |  |  |  | Nugent Patterns | Ross Thyne | Needs Action
 |  |  |  | Precise Technologies Inc. | Ross Thyne | Needs Action
 |  |  |  | Pro Axis Machining | Ross Thyne | Needs Action
 |  |  |  | Robinson Precision Tool |  | Needs Action
 |  |  |  | S&S Machine |  | Needs Action
 |  |  |  | Solidscape, inc. |  | Needs Action
 |  |  |  | Stone Ridge Control Devices |  | Needs Action
 |  |  |  | TMC Fall Machine Co., Inc. |  | Needs Action
 |  |  |  | Ty-Flot inc. |  | Needs Action
 |  |  |  | Vaupell Rapid Solutions |  | Needs Action
 |  |  |  | Wakefield-Vette |  | Needs Action
 |  |  |  | Wayne Towle Master Finishing & Restoration |  | Needs Action
 |  |  |  | Willseal |  | Needs Action
 |  |  |  | Uraseal, Inc. |  | Needs Action
 |  |  |  | Raco Manufacturing & Engineering |  | Needs Action
 |  |  |  | Generator Connection |  | Needs Action
 |  |  |  | Defense Manufacturers, Inc. |  | Needs Action
 |  |  |  | Continental ContiTech |  | Needs Action
 |  |  |  | GE | Trevor Blampied | Contacted
 |  |  |  | Millennium Space Systems | Trevor Blampied | Contacted
 |  |  |  | Pumpkin Space Systems | Trevor Blampied | Contacted
 |  |  |  | SSL | Trevor Blampied | Contacted
 |  |  |  |  |  | Needs Action
 |  |  |  |  |  | Needs Action
 |  |  |  |  |  | Needs Action
 |  |  |  |  |  | Needs Action
 |  |  |  |  |  | Needs Action
 |  |  |  |  |  | Needs Action
 |  |  |  |  |  | Needs Action
 |  |  |  |  |  | Needs Action
 |  |  |  |  |  | Needs Action
 |  |  |  |  |  | Needs Action
 |  |  |  |  |  | Needs Action
 |  |  |  |  |  | Needs Action
 |  |  |  |  |  | Needs Action
 |  |  |  |  |  | Needs Action
 |  |  |  |  |  | Needs Action
 |  |  |  |  |  | Needs Action
 |  |  |  |  |  | Needs Action
 |  |  |  |  |  | Needs Action
 |  |  |  |  |  | Needs Action
 |  |  |  |  |  | Needs Action
 |  |  |  |  |  | Needs Action
 |  |  |  |  |  | Needs Action
 |  |  |  |  |  | Needs Action
 |  |  |  |  |  | Needs Action
 |  |  |  |  |  | Needs Action
 |  |  |  |  |  | Needs Action
 |  |  |  |  |  | Needs Action
 |  |  |  |  |  | Needs Action
 |  |  |  |  |  | Needs Action
 |  |  |  |  |  | Needs Action
 |  |  |  |  |  | Needs Action
 |  |  |  |  |  | Needs Action
 |  |  |  |  |  | Needs Action
 |  |  |  |  |  | Needs Action
 |  |  |  |  |  | Needs Action
 |  |  |  |  |  | Needs Action
 |  |  |  |  |  | Needs Action
 |  |  |  |  |  | Needs Action
 |  |  |  |  |  | Needs Action
 |  |  |  |  |  | Needs Action
 |  |  |  |  |  | Needs Action
 |  |  |  |  |  | Needs Action
 |  |  |  |  |  | Needs Action
 |  |  |  |  |  | Needs Action
 |  |  |  |  |  | Needs Action
 |  |  |  |  |  | Needs Action
 |  |  |  |  |  | Needs Action
 |  |  |  |  |  | Needs Action
 |  |  |  |  |  | Needs Action
 |  |  |  |  |  | Needs Action
 |  |  |  |  |  | Needs Action
 |  |  |  |  |  | Needs Action
 |  |  |  |  |  | Needs Action
 |  |  |  |  |  | Needs Action
 |  |  |  |  |  | Needs Action
 |  |  |  |  |  | Needs Action
 |  |  |  |  |  | Needs Action
 |  |  |  |  |  | Needs Action
 |  |  |  |  |  | Needs Action
 |  |  |  |  |  | Needs Action
 |  |  |  |  |  | Needs Action
 |  |  |  |  |  | Needs Action
 |  |  |  |  |  | Needs Action
 |  |  |  |  |  | Needs Action
 |  |  |  |  |  | Needs Action
 |  |  |  |  |  | Needs Action
 |  |  |  |  |  | Needs Action
 |  |  |  |  |  | Needs Action
 |  |  |  |  |  | Needs Action
 |  |  |  |  |  | Needs Action
 |  |  |  |  |  | Needs Action
 |  |  |  |  |  | Needs Action
 |  |  |  |  |  | Needs Action
 |  |  |  |  |  | Needs Action
 |  |  |  |  |  | Needs Action
 |  |  |  |  |  | Needs Action
 |  |  |  |  |  | Needs Action
 |  |  |  |  |  | Needs Action
 |  |  |  |  |  | Needs Action
 |  |  |  |  |  | Needs Action
 |  |  |  |  |  | Needs Action
 |  |  |  |  |  | Needs Action
 |  |  |  |  |  | Needs Action
 |  |  |  |  |  | Needs Action
 |  |  |  |  |  | Needs Action
 |  |  |  |  |  | Needs Action
 |  |  |  |  |  | Needs Action
 |  |  |  |  |  | Needs Action
 |  |  |  |  |  | Needs Action
 |  |  |  |  |  | Needs Action
 |  |  |  |  |  | Needs Action
 |  |  |  |  |  | Needs Action
 |  |  |  |  |  | Needs Action
 |  |  |  |  |  | Needs Action
 |  |  |  |  |  | Needs Action
 |  |  |  |  |  | Needs Action
 |  |  |  |  |  | Needs Action
 |  |  |  |  |  | Needs Action
 |  |  |  |  |  | Needs Action
 |  |  |  |  |  | Needs Action
 |  |  |  |  |  | Needs Action
 |  |  |  |  |  | Needs Action
 |  |  |  |  |  | Needs Action
 |  |  |  |  |  | Needs Action
 |  |  |  |  |  | Needs Action
 |  |  |  |  |  | Needs Action
 |  |  |  |  |  | Needs Action
 |  |  |  |  |  | Needs Action
 |  |  |  |  |  | Needs Action
 |  |  |  |  |  | Needs Action

Sheet: Company Sponsors
Sponsors: | Responsible: | Address: | Email: | Contact Name: | Phone Number: | Method of Contact: | Donation: | Services Given: | Total: | Comment:
Seneca | Charlie Nitschelm |  | justin@senecamachine.com | Justin - Owner |  | Email | $0.00 | Machining | $0.00
 |  |  |  |  |  |  |  |  | $0.00
 |  |  |  |  |  |  |  |  | $0.00
 |  |  |  |  |  |  |  |  | $0.00
 |  |  |  |  |  |  |  |  | $0.00
 |  |  |  |  |  |  |  |  | $0.00
 |  |  |  |  |  |  |  |  | $0.00
 |  |  |  |  |  |  |  |  | $0.00
 |  |  |  |  |  |  |  |  | $0.00
 |  |  |  |  |  |  |  |  | $0.00
 |  |  |  |  |  |  |  |  | $0.00
 |  |  |  |  |  |  |  |  | $0.00
 |  |  |  |  |  |  |  |  | $0.00
 |  |  |  |  |  |  |  |  | $0.00
 |  |  |  |  |  |  |  |  | $0.00
 |  |  |  |  |  |  |  |  | $0.00
 |  |  |  |  |  |  |  |  | $0.00
 |  |  |  |  |  |  |  |  | $0.00
 |  |  |  |  |  |  |  |  | $0.00
 |  |  |  |  |  |  |  |  | $0.00
 |  |  |  |  |  |  |  |  | $0.00
 |  |  |  |  |  |  |  |  | $0.00
 |  |  |  |  |  |  |  |  | $0.00
 |  |  |  |  |  |  |  |  | $0.00
 |  |  |  |  |  |  |  |  | $0.00
 |  |  |  |  |  |  |  |  | $0.00
 |  |  |  |  |  |  |  |  | $0.00
 |  |  |  |  |  |  |  |  | $0.00
 |  |  |  |  |  |  |  |  | $0.00
 |  |  |  |  |  |  |  |  | $0.00
 |  |  |  |  |  |  |  |  | $0.00
 |  |  |  |  |  |  |  |  | $0.00
 |  |  |  |  |  |  |  |  | $0.00
 |  |  |  |  |  |  |  |  | $0.00
 |  |  |  |  |  |  |  |  | $0.00
 |  |  |  |  |  |  |  |  | $0.00
 |  |  |  |  |  |  |  |  | $0.00
 |  |  |  |  |  |  |  |  | $0.00
 |  |  |  |  |  |  |  |  | $0.00
 |  |  |  |  |  |  |  |  | $0.00
 |  |  |  |  |  |  |  |  | $0.00
 |  |  |  |  |  |  |  |  | $0.00
 |  |  |  |  |  |  |  |  | $0.00
 |  |  |  |  |  |  |  |  | $0.00
 |  |  |  |  |  |  |  |  | $0.00
 |  |  |  |  |  |  |  |  | $0.00
 |  |  |  |  |  |  |  |  | $0.00
 |  |  |  |  |  |  |  |  | $0.00
 |  |  |  |  |  |  |  |  | $0.00

Sheet: School Sponsors
Sponsors: | Responsible: | Address: | Email: | Contact Name: | Phone Number: | Contacted By: | Donation: | Total: | Comment:
UNH Deans Office | Charlie Nitschelm |  | sharon.mccrone@unh.edu | Sharon |  | Email | $3500.00 | $3500.00 | For Spacevision $2500 and $1000 for general
 |  |  |  |  |  |  |  | $3500.00
 |  |  |  |  |  |  |  | $3500.00
 |  |  |  |  |  |  |  | $3500.00
 |  |  |  |  |  |  |  | $3500.00
 |  |  |  |  |  |  |  | $3500.00
 |  |  |  |  |  |  |  | $3500.00
 |  |  |  |  |  |  |  | $3500.00
 |  |  |  |  |  |  |  | $3500.00
 |  |  |  |  |  |  |  | $3500.00
 |  |  |  |  |  |  |  | $3500.00
 |  |  |  |  |  |  |  | $3500.00
 |  |  |  |  |  |  |  | $3500.00
 |  |  |  |  |  |  |  | $3500.00
 |  |  |  |  |  |  |  | $3500.00
 |  |  |  |  |  |  |  | $3500.00
 |  |  |  |  |  |  |  | $3500.00
 |  |  |  |  |  |  |  | $3500.00
 |  |  |  |  |  |  |  | $3500.00
 |  |  |  |  |  |  |  | $3500.00
 |  |  |  |  |  |  |  | $3500.00
 |  |  |  |  |  |  |  | $3500.00
 |  |  |  |  |  |  |  | $3500.00
 |  |  |  |  |  |  |  | $3500.00
 |  |  |  |  |  |  |  | $3500.00
 |  |  |  |  |  |  |  | $3500.00
 |  |  |  |  |  |  |  | $3500.00
 |  |  |  |  |  |  |  | $3500.00
 |  |  |  |  |  |  |  | $3500.00
 |  |  |  |  |  |  |  | $3500.00
 |  |  |  |  |  |  |  | $3500.00
 |  |  |  |  |  |  |  | $3500.00
 |  |  |  |  |  |  |  | $3500.00
 |  |  |  |  |  |  |  | $3500.00
 |  |  |  |  |  |  |  | $3500.00
 |  |  |  |  |  |  |  | $3500.00
 |  |  |  |  |  |  |  | $3500.00
 |  |  |  |  |  |  |  | $3500.00
 |  |  |  |  |  |  |  | $3500.00
 |  |  |  |  |  |  |  | $3500.00
 |  |  |  |  |  |  |  | $3500.00
 |  |  |  |  |  |  |  | $3500.00
 |  |  |  |  |  |  |  | $3500.00
 |  |  |  |  |  |  |  | $3500.00
 |  |  |  |  |  |  |  | $3500.00
 |  |  |  |  |  |  |  | $3500.00
 |  |  |  |  |  |  |  | $3500.00
 |  |  |  |  |  |  |  | $3500.00
 |  |  |  |  |  |  |  | $3500.00
