Maeswoon/UNHSEDS/Business/Finance/Outside Sponsorship and Grants/Companies/2018-2019/Company Brainstorm.xlsx

Sheet: Original Sponsor List
 | Company Name | Phone Number | Secondary Phone Number | Email | Secondary Email (If Given) | Contact Name for EMAIL | Information | LinkedIn/WebForm | Column1
no | Aavid Thermalloy | 1-603-224-9988 |  |  |  |  |  | https://www.aavid.com/contact/contact-form
voicemail | AccuRounds | 508-587-3500 (Company) |  | jbarry@accurounds.com |  | Joe Barry
no | Advanced Design Manufacturing | 603.430.7573 |  | sales@advanceddesign.com |  | Advanced Design Manufacturing
voicemail | Advanced Machine Technology | (603) 425-7417 |  |  |  |  | Their website is dead
voicemail | Advantage Plastic Products | (603) 227-9540
voicemail | Albany Composits | 1-603-330-5800 | 603.330.2426 | brady.stewart@albint.com | paul.terry@albint.com | travis.burchett@albint.com
no | All Cape Welding | (508) 771-2117 |  | info@allcapewelding.com
voicemail | Allegro | 978-264-6600 |  | loren@allegrosoft.com |  | Mr. Loren Shade
no | AMS Oil | 1-800-230-0520 |  | dconsalvo@comcast.net |  | Dave Consalvo
voicemail | Apex Plastics | 800.467.4640 |  |  |  |  |  | http://www.apexplastics.com/contact-apex-plastics
voicemail | ASME Northern New England Section | 212-591-7783 |  | peroj@asme.org
no | Astronics AeroSat | (603) 879-0205 |  | Aerosat.Info@astronics.com
voicemail | Aviation Technology Inc | (603) 666-0200 |  | Sales@avitechusa.com
no | Avid Thermalloy | 603-224-9988 | 603-528-3400 | sales.na@aavid.com
voicemail | Back Bay Customs | (207) 878 – 8542 |  | BackBayCustomsInfo@gmail.com
no | BAE Systems | (603) 232-8221
voicemail | BASF Corporation | (973) 245-6405 | 1-973-245-6000 | john.schmidt@basf.com | (973) 245-6405 | John C. Schmidt
voicemail | BittWare, inc | +1 603.226.0404 |  | mweddle@bittware.com |  | Marcus Weddle
Call back later | BMW of Stratham | 603-772-0000 | (888) 698-3082 | kconnor@iramotorgroup.com |  | Ken Connor
email | Boston Welding & Design, INC. | (781) 932-0035 |  | RobertDiorio@bostonwelding.com |  | Robert Diorio
Charlie will reach out | Bottomline Technologies | Charlie |  |  |  |  | Charlie will contact personally
voicemail | Brett Cairns Realty | (250) 898-3348 | Why is this on the list.. they're canadian
voicemail | Bronze Craft | (800) 488-7747 |  | j.bernard@bronzecraft.com | jimlajeunesse@bronzecraft.com | Jim Bernard
no | Burndy | 800-346-4175
voicemail | Cannon Mountain | 603-823-7722 ext. 789 |  | gregory.keeler@dred.nh.gov |  | Greg Keeler
Waiting | CEPS | In person |  |  |  |  | BUDGET FORM DUE END SEPTEMBER
email | Chevrolet | (603) 609- 1900 |  |  |  |  |  | http://www.doverchevrolet.com/ContactUsForm
email | Choice Metals | 603-626-5500 |  | sales@choicemet.com
voicemail | Cirtronics | (603) 249-9190 |  | sgronvall@cirtronics.com |  |  |  | https://www.linkedin.com/in/stephanie-gronvall-b671295/ | Dan
No | Cobham | 603-775-5200 |  |  |  | Richard Ball
voicemail | Cohen Steel | 603-225-2047 |  | info@cohensteel.com
Send email back | Composite Envisions LLC | 715-842-0101 |  | cthorson@compositeenvisions.com |  | Jake
voicemail | Continental ContiTech | 888-899-6354 |  | mailservice@contitech.de
no | Continental Tire | 800-847-3349 |  | consumerinfo@conti-na.com
voicemail | ControlAir, inc. | (603) 886-9400 |  | dbanks@controlair.com
email | Cor-Met | (810) 227-0004 |  | sales@cor-met.com
no | Craftsman | 888-331-4569
email | Custom Composite Technologies | 207-841-7112 |  |  |  | Steve Hassett
Voicemail | Custom Welding & Fabrication, Inc | 603-942-5170
No | Daystar, Inc. | 603-766-5924 |  |  |  | Anne Brown
No | DEC- Consulting Co, LLC | 603-540-5346 |  |  |  |  |  | https://www.linkedin.com/in/raymond-bourcier-78739214/
Call back in 2 weeks | Defense Manufacturers, Inc. | 603-743-4333
Call Wednesday | Derry Cycle | 603-425-6222 |  | salesdept@derrycycle.com
No | Diamon Casting | (603) 465-2263 |  | denise@diamondcasting.com
no | Diamond Casting and Machine Co. (David) | 603) 465-2263 |  |  |  | David?
voicemail | DiscountSteel.com | 612-522-5956 | 1-800-522-5950
email | Durham Boat | 603-659-7575 , |  | sales@durhamboat.com |  | Henry Palmer | - director of marketing and sales for rowing sculls.
no | Dynojet | 800-992-4993
they took our email | Dynomite Dynamometer | 866-396-6648 |  | sales@land-and-sea.com
no | DynoTune Powersports (hudson MA.) | (978) 310-7737 | 508-375-8195 |  |  | Dean Hoffman | has a sales liscence, i assume hes the owner
voicemail | EFI Express | 603-413-6713 |  |  |  | Mark
 | Elbit Systems | Have LinkedIn |  | info@elbitsystems.com |  |  | Marketing Director | https://www.linkedin.com/in/margie-stacy-1a8205b/ | Charlie
no | Enventure | 603-766-4960 |  | info@enventure.com |  | Rumela
voicemail | Factory Connection | 603-664-2221
no | Fastenal | 603-524-6100 |  | jhalsey@fastenal.com | joelliot@fastenal.com
no |  | 603-742-4680 |  |  |  | Deb Cuthbertson/Tiffany Melanson
email | Fibre Glast Developments Corporation | 800-838-8984 |  | customerservice@fibreglast.com
no | FLIR Systems, inc. | Have LinkedIn |  |  |  |  |  | https://www.linkedin.com/in/travis-merrill-ba08471/
no | Form 3D Solutions | 603-534-2074 |  | joe.gabriel@form3ds.com |  | Joseph Gabriel
voicemail | Freudenberg | 1-734-354-5505 |  | indira.sadikovic@fnacc.com |  | Indira Sadikovic
call bedford? | FW Webb Company | 603-749-3100
voicemail | G&A Machine | (603) 894-6965
voicemail | GE Aviation | (603) 666-8300 |  | gefoundation@ge.com
voicemail | GE Aviation - Hooksett | 603-472-4488 |  |  |  | Doug Folsom - General Manager
voicemail | General Dynamics Electric Boat | 860-433-6510 |  | aleigh@gdeb.com |  | Anna Leigh
got email | Generator Connection | 603-664-4004 |  | wayne@generatorconnection.com
voicemail | Geokon | 603-448-1562
Got email | Globaltek Components | 603-652-8033 |  | info@globaltekcomp.com |  | Sue Dumais
voicemail | Goodyear, Inc | (330) 796-2121
voicemail | Goss International | 1-603-749-6600 |  | info@gossinternational.com
no | Granite State Welding | (603) 548-9625 |  |  |  | todd therien - owner
voicemail | GT Advanced Technologies | 1(406) 532-0120 |  | polysilicon@gtat.com |  | CFO Raja Bal |  | Linkedin: https://www.linkedin.com/in/rajabal/
no | Hexcel Corporation | 203-352-6800 |  |  |  | Potential Carbon Fiber Sponsor
voicemail | Hitchiner | (603) 673-1100 |  |  |  | Joe Seliga - market development manager
voicemail | Hitchiner | 603-581-8277 |  |  |  | Tom Beaulieu
voicemail | Hoonigan Racing | (310) 407-0344 |  |  |  | Brian Scotto - chief brand officer, handles marketing
non working number | Hoosier Tires | 1-574-784-2385 |  | info@hoosiertire.com
cannot sponsor UNH | Hutchinson | 603-772-2550 |  | Clint.Dowd@hutchinsonna.com |  | Clint Dowd
voicemail | HydroComp Inc. | 603-868-3344 |  | info@hydrocompinc.com
no | Hypotherm | Have LinkedIn |  |  |  |  |  | https://www.hypertherm.com/en-US/contact-us/?region=NART#form=human-resources-careers
voicemail | Incite Innovation | 413-382-0210 |  |  |  | John Kirwan
voicemail | Infinite Imaging (Portsmouth, NH) | 603-436-3030 |  | info@infiniteimaging.com |  | Robert Loch
no | Intellitek | Have LinkedIn |  |  |  |  |  | https://www.intellitec.com/index.php/contact
no | Jackson Bond Enterprises LLC | 603-742-2350 |  | info@jacksonbondllc.com
no | JMD Industries | 603-882-3189 |  |  |  | James DeDeus | President of JMD Industries | linkedin.com/in/james-dedeus-17343453/ *
no | Johnstone Supply of Braintree | 781-356-1664
no | JRL Enterprises Inc. | 504-263-1380 |  |  |  | John R Lee |  |  | Jay
voicemail | Kimball Physics | (603) 878-1616
no | Kinetic Tuning | 603-329-6083
no | Kingsley Automotive Machine | (603) 889-3844
voicemail | KMC Systems, inc. | 866-742-0442 |  |  |  |  |  | http://www.kmcsystems.com/contact
voicemail | KRAN Design | 603-898-3467
voicemail | L3 Warrior Systems | 603-626-4800 |  | Service.Insight@L-3com.com |  | Jon Piatt - director of makreting and sales
voicemail | Lewis and Saunders | 6035275514 |  | slempke@lewisandsaunders.com | derek.hind@titeflex.com | Shannon Lempke | Derek Hind
voicemail | Liberty Mutual Insurance | 603-749-2600 | 1-603-431-3350 x52226 |  |  | Brooks Stevens | Jonathan Burns
Will message on LI | Loon Mountain/Boyne Resorts | Have LinkedIn |  | mmahar@loonmtn.com
Will message on LI | Mac Tools | Have LinkedIn |  |  |  |  |  | https://www.linkedin.com/in/robyn-perry-b7811b93/
no | MadgeTech, inc. | (603) 456-2011
voicemail | MakeWay Machine. Inc. | 603-474-5250 |  | shop@makewaymachine.com | donna@makewaymachine.com | Russel Drenkhahn
voicemail | Market Basket | 603 474-5250 |  | contact@mydemoulas.net |  | Greg Packard
voicemail | Marmon Aerospace & Defense | (603) 622-3500 |  |  |  |  |  | http://www.marmon-ad.com/contact-us
Grace | Matneys Models | 734-848-8195 | 603-430-2160 | info2011@matneymodels.com |  | Foam Cores
voicemail | MicroDAQ | 603-746-5524
no | Micronics Inc. USA-World Headquarters | 866-481-3694 |  | info@micronicsinc.com |  | Chad
CALL TOMORROW | Midway Motorcars | 603-749-0010 |  | midwayracingteam@ttlc.net |  | Bob Demers
got email | Millennium Precision LLC | 603-974-1529 |  | Josh@millsprecision.com |  | Josh Mills
email | Mitee Bite | 603-539-4538 | (603) 842-6058 | dave@miteebite.com |  | David Bishop | John Demers
voicemail | Moore Nanotech | (603) 352-3030 |  |  |  |  | Machining
voicemail | Nanocomp Technologies | (603) 442-8992 |  |  |  |  | Chemical Industry
voicemail | New England CNC Inc. | 203-288-8241 |  | newenglandcnc@comcast.net | sales@newenglandcnc.com
voicemail | New England Welding, INC. | 508-580-2024 |  |  |  | Ken McIntire | dude on phone said voicemail was to eric
no | New Hampshire Ball Bearings, Inc. | 603-924-3311 |  | mproctor@nhbb.com |  | Marcus J. Proctor
expecting call from tim | New Hampshire Materials Lab | 603-692-4110 |  | info@nhml.com |  | Tim Kenney
voicemail | New Hampshire Plastic, inc. | (800) 258-3036 |  | customerservice@nhplastics.com
voicemail | NextEra Energy - Seabrook Station | 603-474-9521 |  | media.relations@nexteraenergyresources.com |  | Sarah Gebo
voicemail | NH Motor Speedway | 603-783-4931
voicemail | Northern Composites | (603) 926-1910 |  | sbresnahan@northerncomposites.com |  | Sean Bresnahan
voicemail | Nugent Patterns | (603)528-0141 |  | dave@nugentpatterns.com
voicemail | Ossipee Mountain Electronics | 603-476-5581 ext. 109 |  | steph@omesbs.com |  | Stephanie Porusta
Customer service redirect | Parker-Hannifin Watts Fluid | (207) 439-9511
company directory | PCC Structurals Inc. | 603-286-5200 |  | jdurand@pccstructurals.com | bwinders@pccstructurals.com
Will message on LI | Pelham Plastics | has linkedin; Ray Pellerin
voicemail | Pentair | (603) 749-1610
got email | Phoenix Precast Products | 602-569-6090 |  | sales@phoenixprecastproducts.com
 | Pratt & Whitney | (207) 676-4100 |  | michael.brucskotter@pw.utc.com | michael.newsky@pw.utc.com | Mike Bruskotter/Mike Newsky | *Nick will speak with Newsky
got email | Precise Technologies Inc. | (727) 535-5594 |  | hr@precisetechnologies.net | generalinfo@precisetechnologies.net |  |  |  | Nick
voicemail | Primed Performance LLC | (617) 329-9864
 | Primed Performance LLC | 617-329-9864
CALL TOMORROW | Pro Axis Machining | (603) 595-1616 |  |  |  |  | *Robert Dufour | https://www.linkedin.com/in/robert-dufour-b45aaaa6/
no | Proto Labs | 877-479-3680 |  | austin.rennich@protolabs.com |  | Austin Rennich
voicemail | ProtoPart, inc. | (603) 883-6531 | (603) 883-6531 | info@protopart.com
This is Eversource??? | Public Service of NH | 1-800-662-7764 |  |  |  | Catalina Celentano
Needs somthing in witing | QA Technology Company Inc. | 603-926-1193 |  | cmarcucci@qatech.com |  | Carl Marcucci
no | R&L Engines | (603)-742-8812
No | R.I. Welding & Fabricating Co. | 401-331-1355 |  | office@riwelding.com |  | Welding, maybe stock
voicemail | Raco Manufacturing & Engineering | 603-436-6962
"unable to take calls" | RAPID Manufactiuring | (603)-595-1400 | (603)-821-5200 |  |  |  |  | https://www.linkedin.com/in/jacobsjay/
voicemail | Raytheon | (781)-522-3000 |  |  |  |  | *Nemr will be in contact w/ his father
voicemail | RealPower, inc. | (603)-593-5346
voicemail | Robinson Precision Tool | (603) 889-1625 |  |  |  |  | *number for Dana Robinson
no | Rock Shox | 312-664-8800 | 1-312-664-8800
voicemail | Ruger | 603-865-2317 | 336-949-5200 | rdennis@ruger.com |  |  |  | https://www.linkedin.com/in/richardkdennisjr/
got email | S & H Engineering | 978-256-7231 |  | mail@s-and-h.com
got email | S&S Machine | (603)-204-5542 |  | sales@ssmachinenh.com
EMAIL NO PHONE NUMBER | Safran Aerospace Composites | ---- |  | charles.soret@safrangroup.com |  | Charles Soret | Press and Media Officer |  | Morgan
out of donation money, call back early next year | Safran Aerospace Composites | (603) 330-7200 |  | snecma.csc@snecma.fr
no dontation program | Segway, LLC | 603.222.6000 |  | brian.buccella@segway.com |  | Brian Buccella | (Vice President, Business Development and Marketing)
customer service line | Service credit union | 1.800.936.7730 |  | scu@servicecu.org |  |  | Service Credit Union at UNH
don't call | Shell | Have LinkedIn |  |  |  |  |  | Need to fill out application for grant (we have a good chance of getting it) link to elgibility, application info etc. : http://www.shell.us/sustainability/request-for-a-grant-from-shell.html
got email | Sig Sauer | 603-610-3000
got email | Sig Sauer | 603-610-3000 |  |  |  |  | Sig Sauer in Epping | http://www.sigsaueracademy.com
got email | Snap-On | 877-740-1900
voicemail | Solidscape, inc. | +1 603-429-9700 ext. 239 |  | wdahl@solid-scape.com |  | Bill Dahl | Vice President, Products and Marketing | https://www.linkedin.com/in/billdahl1
voicemail | SolidWorks | 1-310-309-2854 | 1-800-693-9000 | Matthew.Derov@3ds.com |  | Matthew Derov
voicemail | Soller composites | 1 (603) 671 7016 |  |  |  |  | Small Company only phone number
Universit program. discounts and free shipping through unh purchasing services | Spectex | 603.330.3334 |  |  |  |  | Small Company only phone number
non-working number | Steward Partners Global Advisory | 603-427-8858 |  | John.Pappas@StewardPartners.com |  | John Pappas
voicemail | Stone Ridge Control Devices | (248) 489-9300 |  | sales@stoneridge.com |  |  |  |  | Reilly
voicemail | Stone Ridge Control Devices | 781-830-0340 |  | info@stoneridgeproperties.com
didn't pick up | Sub5 Race Mangement | 603-617-8509 | 603.899.3210 |  |  | Dave Abbett
voicemail | Subaru | (888) 726-6641 |  |  |  |  |  | jplante@tricitysubaru.com
no | Sullivan Tire - Epping | 603-778-0516 | (603) 742-5054
no | Sweeney Metal Fabricators | (603) 881-8720 |  | csweeney@sweeneymetal.com |  | Chris Sweeney | Director of Operations | https://www.linkedin.com/in/chris-sweeney-13758212
no | Taylor Racing | 800.922.4327 |  |  |  |  |  | https://www.taylor-race.com/contact-us
voicemail | Team O'Neil Rally School | 603-444-4488 |  | info@teamoneil.com
got email | Textreme | 4633 340 18 00 | For Lori Herron +1 925 872 5659 | contact@textreme.com | Lori Herron's email: cant find | NO contact name for email | if calling Lori Herren she is the sales manager for North american aerospace section | https://www.linkedin.com/in/lori-herren-66a39b43
 | The Whiting-Turner Contracting Company | 203-538-6047 |  | robert.omeara@whiting-turner.com
voicemail | Thermal Dynamics | (603) 298-5711 | 1-866-279-2628 |  |  |  |  |  | Chris
not availble | Thompson Investment Casting | 603-330-8670 |  | mhaley@ticasting.com
voicemail | Timken Aerospace | (234) 262-3000
voicemail | Timken Super Precision | (234) 262-3000 |  |  |  |  |  | http://www.timken.com/contact-general/
no operator | Titeflex | 603-524-2064
voicemail | TMC Fall Machine Co., Inc. | 603-750-7100
not availble | TNT Precision LLC | (603) 595-6813 |  | sales@tntprecision.com
no | Tritech Engineering Corp. | 603-742-8107 |  | rjs@tritecheng.com
Call again M-TR 8-11am | TST Hydraulics, inc. | 1-800-892-6125 |  |  |  |  |  | http://www.tsthydraulics.com/contact/
 | Tucker Engineering | (978) 532-5900 |  | info@tuckereng.com
Dont call | Turbocam International | (603) 905-0200 |  |  |  |  | Reilly: will ask boss in person
Dont call | Turbocam International | 1-603-905-0200 |  | greatpeople@turbocam.com
voicemail | Tyco | 978-577-4000
voicemail | Ty-Flot inc. | (603) 669-5169 |  | info@ty-flot.com
voicemail | Uraseal, Inc. | 603-749-1004 |  |  |  | John Burnham |  | Online Contact Form
voicemail | Vaupell Rapid Solutions | 603-577-9970 |  |  |  |  |  | http://www.vaupell.com/contact/
voicemail | Velcro | 800-225-0180
email | Veloxion | 603-889-6871 |  |  |  | Steven Robinson | President | linkedin.com/in/steverrobinson/
number disconnected | Vibro-Meter, Inc. | 603-669-0940
no | VR3 Engineering | 1-519-273-6660 |  | dvanraay@vr3.ca |  | cartesian stock cutting
voicemail | Wakefield-Vette | (603) 635-2800 |  |  |  |  |  | http://www.wakefield-vette.com/company/contact/contact-us.aspx
customer service line only | Waste Management of NH | 603-332-2386 |  |  |  | Steve Cates
they are calling me back | Wayne Towle Master Finishing & Restoration | (781) 449-1313 |  | Info@WayneTowle.com
no | Wells Fargo | 1 (800) 869-3557 |  |  |  |  |  |  | Ross
send info package | Whelen Engineering | 603-826-4005 |  | bbouchard@whelen.com |  | Robert Bouchard
no univerity donations | Wilcox | 603-431-1331
gave email | Willseal | 800.274.2813 |  | custserv@willseal.com
voicemail | Wright-Pierce | 603-570-7103 |  | connie.taggart@wright-pierce.com
voicemail | WTC Granite Industries | 603-444-6724 |  | info@wotrco.com
voicemail | Yamaha Sport | 800-962-7926 |  |  |  | Eric Miller | District manager | linkedin.com/in/eric-miller-45a5aa6

Sheet: Company List
Company | Number | Email
AccuRounds | 508-587-3500 (Company) | jbarry@accurounds.com
Advanced Machine Technology | (603) 425-7417
Advantage Plastic Products | (603) 227-9540
Albany Composits | 1-603-330-5800 | brady.stewart@albint.com
Allegro | 978-264-6600 | loren@allegrosoft.com
Apex Plastics | 800.467.4640
ASME Northern New England Section | 212-591-7783 | peroj@asme.org
Aviation Technology Inc | (603) 666-0200 | Sales@avitechusa.com
Back Bay Customs | (207) 878 – 8542 | BackBayCustomsInfo@gmail.com
BASF Corporation | (973) 245-6405 | john.schmidt@basf.com
BittWare, inc | +1 603.226.0404 | mweddle@bittware.com
BMW of Stratham | 603-772-0000 | kconnor@iramotorgroup.com
Boston Welding & Design, INC. | (781) 932-0035 | RobertDiorio@bostonwelding.com
Bottomline Technologies | Charlie
Brett Cairns Realty | (250) 898-3348
Bronze Craft | (800) 488-7747 | j.bernard@bronzecraft.com
Cannon Mountain | 603-823-7722 ext. 789 | gregory.keeler@dred.nh.gov
CEPS | In person
Chevrolet | (603) 609- 1900
Choice Metals | 603-626-5500 | sales@choicemet.com
Cirtronics | (603) 249-9190 | sgronvall@cirtronics.com
Cohen Steel | 603-225-2047 | info@cohensteel.com
Composite Envisions LLC | 715-842-0101 | cthorson@compositeenvisions.com
Continental ContiTech | 888-899-6354 | mailservice@contitech.de
ControlAir, inc. | (603) 886-9400 | dbanks@controlair.com
Cor-Met | (810) 227-0004 | sales@cor-met.com
Custom Composite Technologies | 207-841-7112
Custom Welding & Fabrication, Inc | 603-942-5170
Defense Manufacturers, Inc. | 603-743-4333
Derry Cycle | 603-425-6222 | salesdept@derrycycle.com
DiscountSteel.com | 612-522-5956
Durham Boat | 603-659-7575 , | sales@durhamboat.com
Dynomite Dynamometer | 866-396-6648 | sales@land-and-sea.com
EFI Express | 603-413-6713
Elbit Systems | Have LinkedIn | info@elbitsystems.com
Factory Connection | 603-664-2221
Fibre Glast Developments Corporation | 800-838-8984 | customerservice@fibreglast.com
Freudenberg | 1-734-354-5505 | indira.sadikovic@fnacc.com
G&A Machine | (603) 894-6965
GE Aviation | (603) 666-8300 | gefoundation@ge.com
GE Aviation - Hooksett | 603-472-4488
General Dynamics Electric Boat | 860-433-6510 | aleigh@gdeb.com
Generator Connection | 603-664-4004 | wayne@generatorconnection.com
Geokon | 603-448-1562
Globaltek Components | 603-652-8033 | info@globaltekcomp.com
Goodyear, Inc | (330) 796-2121
Goss International | 1-603-749-6600 | info@gossinternational.com
GT Advanced Technologies | 1(406) 532-0120 | polysilicon@gtat.com
Hitchiner | (603) 673-1100
Hitchiner | 603-581-8277
Hoonigan Racing | (310) 407-0344
HydroComp Inc. | 603-868-3344 | info@hydrocompinc.com
Incite Innovation | 413-382-0210
Infinite Imaging (Portsmouth, NH) | 603-436-3030 | info@infiniteimaging.com
Kimball Physics | (603) 878-1616
KMC Systems, inc. | 866-742-0442
KRAN Design | 603-898-3467
L3 Warrior Systems | 603-626-4800 | Service.Insight@L-3com.com
Lewis and Saunders | 6035275514 | slempke@lewisandsaunders.com
Liberty Mutual Insurance | 603-749-2600
Loon Mountain/Boyne Resorts | Have LinkedIn | mmahar@loonmtn.com
Mac Tools | Have LinkedIn
MakeWay Machine. Inc. | 603-474-5250 | shop@makewaymachine.com
Market Basket | 603 474-5250 | contact@mydemoulas.net
Marmon Aerospace & Defense | (603) 622-3500
MicroDAQ | 603-746-5524
Midway Motorcars | 603-749-0010 | midwayracingteam@ttlc.net
Millennium Precision LLC | 603-974-1529 | Josh@millsprecision.com
Mitee Bite | 603-539-4538 | dave@miteebite.com
Moore Nanotech | (603) 352-3030
Nanocomp Technologies | (603) 442-8992
New England CNC Inc. | 203-288-8241 | newenglandcnc@comcast.net
New England Welding, INC. | 508-580-2024
New Hampshire Materials Lab | 603-692-4110 | info@nhml.com
New Hampshire Plastic, inc. | (800) 258-3036 | customerservice@nhplastics.com
NextEra Energy - Seabrook Station | 603-474-9521 | media.relations@nexteraenergyresources.com
NH Motor Speedway | 603-783-4931
Northern Composites | (603) 926-1910 | sbresnahan@northerncomposites.com
Nugent Patterns | (603)528-0141 | dave@nugentpatterns.com
Ossipee Mountain Electronics | 603-476-5581 ext. 109 | steph@omesbs.com
Pelham Plastics | has linkedin; Ray Pellerin
Pentair | (603) 749-1610
Phoenix Precast Products | 602-569-6090 | sales@phoenixprecastproducts.com
Pratt & Whitney | (207) 676-4100 | michael.brucskotter@pw.utc.com
Precise Technologies Inc. | (727) 535-5594 | hr@precisetechnologies.net
Primed Performance LLC | (617) 329-9864
Pro Axis Machining | (603) 595-1616
ProtoPart, inc. | (603) 883-6531 | info@protopart.com
QA Technology Company Inc. | 603-926-1193 | cmarcucci@qatech.com
Raco Manufacturing & Engineering | 603-436-6962
Raytheon | (781)-522-3000
RealPower, inc. | (603)-593-5346
Robinson Precision Tool | (603) 889-1625
Ruger | 603-865-2317 | rdennis@ruger.com
S & H Engineering | 978-256-7231 | mail@s-and-h.com
S&S Machine | (603)-204-5542 | sales@ssmachinenh.com
Safran Aerospace Composites | ---- | charles.soret@safrangroup.com
Safran Aerospace Composites | (603) 330-7200 | snecma.csc@snecma.fr
Sig Sauer | 603-610-3000
Sig Sauer | 603-610-3000
Snap-On | 877-740-1900
Solidscape, inc. | +1 603-429-9700 ext. 239 | wdahl@solid-scape.com
SolidWorks | 1-310-309-2854 | Matthew.Derov@3ds.com
Soller composites | 1 (603) 671 7016
Stone Ridge Control Devices | 781-830-0340 | info@stoneridgeproperties.com
Stone Ridge Control Devices | (248) 489-9300 | sales@stoneridge.com
Subaru | (888) 726-6641
Team O'Neil Rally School | 603-444-4488 | info@teamoneil.com
Textreme | 4633 340 18 00 | contact@textreme.com
Thermal Dynamics | (603) 298-5711
Timken Aerospace | (234) 262-3000
Timken Super Precision | (234) 262-3000
TMC Fall Machine Co., Inc. | 603-750-7100
TST Hydraulics, inc. | 1-800-892-6125
Turbocam International | 1-603-905-0200 | greatpeople@turbocam.com
Tyco | 978-577-4000
Ty-Flot inc. | (603) 669-5169 | info@ty-flot.com
Uraseal, Inc. | 603-749-1004
Vaupell Rapid Solutions | 603-577-9970
Velcro | 800-225-0180
Veloxion | 603-889-6871
Wakefield-Vette | (603) 635-2800
Wayne Towle Master Finishing & Restoration | (781) 449-1313 | Info@WayneTowle.com
Whelen Engineering | 603-826-4005 | bbouchard@whelen.com
Willseal | 800.274.2813 | custserv@willseal.com
Wright-Pierce | 603-570-7103 | connie.taggart@wright-pierce.com
WTC Granite Industries | 603-444-6724 | info@wotrco.com
Yamaha Sport | 800-962-7926

Sheet: Distant Company
Company Name | Address | Phone Number | Email
AccuRounds | 74 Bodwell St, Avon, MA 02322 | (508) 587-3500 | jbarry@accurounds.com
Advanced Machine Technology | 33 Londonderry Rd # 13, Londonderry, NH 03053 | (603) 425-7417
Advantage Plastic Products | 38 Henniker St, Concord, NH 03301 | (603) 227-9540
Apex Plastics | 39 Bridge St, Nashua, NH 03060 | (603) 594-8787
Aviation Technology Inc | 45 Londonderry Turnpike #5, Hooksett, NH 03106 | (603) 666-0200 | Sales@avitechusa.com
BittWare, inc | 45 S Main St, Concord, NH 03301 | (603) 226-0404 | mweddle@bittware.com
Boston Welding & Design, INC. | 7 Micro Dr, Woburn, MA 01801 | (781) 932-0035 | RobertDiorio@bostonwelding.com
Bronze Craft | 37 Will St, Nashua, NH 03060 | (800) 488-7747 | j.bernard@bronzecraft.com
Cannon Mountain |  |  | gregory.keeler@dred.nh.gov
Choice Metals | 36 Cote Ave, Goffstown, NH 03045 | (603) 626-5500 | sales@choicemet.com
Cirtronics | 528 Route 13 South Milford, NH 03055 |  | sgronvall@cirtronics.com
Cohen Steel | 10 Basin St, Concord, NH 03301 | (603) 225-2047 | info@cohensteel.com
ControlAir, inc. | 8 Columbia Dr, Amherst, NH 03031 | (603) 886-9400 | dbanks@controlair.com
Custom Composite Technologies | 15 Wing Farm Pkwy, Bath, ME 04530 | (207) 442-7007
Derry Cycle | 44 Crystal Ave, Derry, NH 03038 | (603) 425-6222 | salesdept@derrycycle.com
Dynomite Dynamometer | 25 Henniker Street; Concord, NH 03301-8528 USA (https://www.dynomitedynamometer.com/corporate/directions.htm) |  | sales@land-and-sea.com
Elbit Systems | 220 Daniel Webster Hwy, Merrimack, NH 03054 | (603) 889-2500 | info@elbitsystems.com
Fibre Glast Developments Corporation | ohio | (800) 821-3283 | customerservice@fibreglast.com
Freudenberg | 3308, 50 Ammon Dr, Manchester, NH 03103 | (603) 669-4050 | indira.sadikovic@fnacc.com
G&A Machine | 168 Lawrence Rd, Salem, NH 03079 | (603) 894-6965
GE Aviation | 31 Industrial Park Dr, Hooksett, NH 03106 | (603) 666-8300 | gefoundation@ge.com
General Dynamics Electric Boat | 2073 NH-28, Deering, NH 03244 |  | aleigh@gdeb.com
Geokon | 48 Spencer St, Lebanon, NH 03766 | (603) 448-1562
GT Advanced Technologies | 20 Trafalgar Square, Nashua, NH 03063 | (603) 883-5200 | polysilicon@gtat.com
Hitchiner | 594 Elm St, Milford, NH 03055 | (603) 673-1100
Incite Innovation | 1500 Main St, Springfield, MA 01103 | (413) 382-0210
Kimball Physics | 311 Kimball Hill Rd, Wilton, NH 03086 | (603) 878-1616
KMC Systems, inc. | 220 Daniel Webster Hwy, Merrimack, NH 03054 | (866) 742-0442
KRAN Design | 153 Main St, Salem, NH 03079 | (603) 898-3467
L3 Warrior Systems | 9 Akira Way, Londonderry, NH 03053 |  | Service.Insight@L-3com.com
Lewis and Saunders | 144 Lexington Dr, Laconia, NH 03246 | (603) 528-1871 | slempke@lewisandsaunders.com
MakeWay Machine. Inc. | 41 Washington St, Seabrook, NH 03874 |  | shop@makewaymachine.com
Marmon Aerospace & Defense | 680 Hayward St, Manchester, NH 03103 | (603) 622-3500
MicroDAQ | 879 Maple St, Contoocook, NH 03229 | (603) 746-5524
Millennium Precision LLC | 234 Abby Rd, Manchester, NH 03103 | (603) 644-1555 | Josh@millsprecision.com
Mitee Bite | 340 NH-16B, Center Ossipee, NH 03814 | (603) 539-4538 | dave@miteebite.com
Moore Nanotech | 230 Old Homestead Hwy, Swanzey, NH 03446 | (603) 352-3030
Nanocomp Technologies | 57 Daniel Webster Hwy, Merrimack, NH 03054 | (603) 442-8992
New England CNC Inc. | 46 Manila Ave, Hamden, CT 06514 | (203) 288-8241 | newenglandcnc@comcast.net
New England Welding, INC. | 145 Bodwell St # J, Avon, MA 02322 | (508) 580-2024
New Hampshire Plastic, inc. | 1 Bouchard St, Manchester, NH 03103 | (603) 669-8523 | customerservice@nhplastics.com
NextEra Energy - Seabrook Station | 626 Lafayette Rd, Seabrook, NH 03874 |  | media.relations@nexteraenergyresources.com
Nugent Patterns | 575 Province Road Laconia, NH 03246 | (603) 528-0141 | dave@nugentpatterns.com
Pelham Plastics | 42 Dick Tracy Dr, Pelham, NH 03076 | (603) 886-7226
Pratt & Whitney | 113 Wells St, North Berwick, ME 03906 | (207) 676-4100 | michael.brucskotter@pw.utc.com
Precise Technologies Inc. | 10 Manor Pkwy #3, Salem, NH 03079 | (603) 893-7600 | hr@precisetechnologies.net
Pro Axis Machining | 25 Front St, Nashua, NH 03064 | (603) 595-1616
ProtoPart, inc. | 71 Pine Rd # F, Hudson, NH 03051 | (603) 883-6531
Raytheon | 235 Presidential Way, Woburn, MA 01801 | (339) 645-6000
RealPower, inc. | Jaffrey, NH | (603) 593-5346
Robinson Precision Tool | 315 Derry St # 15, Hudson, NH 03051 | (603) 889-1625
S & H Engineering | 248 Mill Rd, Chelmsford, MA 01824 | (978) 256-7231 | mail@s-and-h.com
S&S Machine | 11 Caldwell Dr, Amherst, NH 03031 | (603) 204-5542 | sales@ssmachinenh.com
Solidscape, inc. | 316 Daniel Webster Hwy, Merrimack, NH 03054 | (603) 429-9700 | wdahl@solid-scape.com
Soller composites | 55 Industrial Park Dr, Franklin, NH 03235 | (603) 671-7016
Stone Ridge Control Devices | 300 Dan Rd, Canton, MA 02021 | (781) 830-0340 | info@stoneridgeproperties.com
Stone Ridge Control Devices | 36 Lane Rd, Derry, NH 03038 | (603) 434-2097 | sales@stoneridge.com
Thermal Dynamics | 82 Benning St, West Lebanon, NH 03784 | (603) 298-5711
Timken Super Precision | 7 Optical Ave, Keene, NH 03431 | (603) 352-0310
TMC Fall Machine Co., Inc. | 10 Willand Dr, Somersworth, NH 03878 | (603) 750-7100
TST Hydraulics, inc. | 20 Continental Blvd, Merrimack, NH 03054 | (603) 670-9977
Ty-Flot inc. | 305 Massabesic St, Manchester, NH 03103 | (603) 669-5169 | info@ty-flot.com
Vaupell Rapid Solutions | 20 Executive Dr, Hudson, NH 03051 | (603) 577-9970
Veloxion | 1 Industrial Dr, Pelham, NH 03076 | (603) 889-6871
Wakefield-Vette | 33 Bridge St, Pelham, NH 03076 | (603) 635-2800
Wayne Towle Master Finishing & Restoration | 166 Crescent Rd, Needham Heights, MA 02494 | (781) 449-1313 | Info@WayneTowle.com
Whelen Engineering |  | (603) 826-4005 | bbouchard@whelen.com
Willseal | 34 Executive Dr, Hudson, NH 03051 | (800) 274-2813 | custserv@willseal.com

Sheet: Local Company
Company Name | Address | Number | Email | Notes, Who Went
Velcro | 330 New Rochester Road, Somersworth, NH 03878 | (603) 692-0398
Wright-Pierce | 230 Commerce Way #302, Portsmouth, NH 03801 |  | connie.taggart@wright-pierce.com
Uraseal, Inc. | 1 Washington St, Dover, NH 03820
Tyco | 100 Piscataqua Dr, Newington, NH 03801
Turbocam International | In Person (Reilly and Charlie)
Safran Aerospace Composites | 85 Innovation Dr, Rochester, NH 03867 | (603) 330-7200 | charles.soret@safrangroup.com
Safran Aerospace Composites | 85 Innovation Dr, Rochester, NH 03867 |  | snecma.csc@snecma.fr
Raco Manufacturing & Engineering | 1275 Maplewood Ave # 24, Portsmouth, NH 03801
QA Technology Company Inc. | 110 Towle Farm Rd, Hampton, NH 03842 |  | cmarcucci@qatech.com
Pentair | 47 Crosby Rd, Dover, NH 03820
Northern Composites | 102 Tide Mill Rd # 12, Hampton, NH 03842 |  | sbresnahan@northerncomposites.com
New Hampshire Materials Lab | 22 Interstate Dr, Somersworth, NH 03878 |  | info@nhml.com
Infinite Imaging (Portsmouth, NH) | 933 Islington St, Portsmouth, NH 03801 |  | info@infiniteimaging.com
HydroComp Inc. | 15 Newmarket Rd, Durham, NH 03824 |  | info@hydrocompinc.com | Silas and Charlie, took PDF. Grace should follow up soon.
Globaltek Components | 74 Industrial Park Dr, Dover, NH 03820 |  | info@globaltekcomp.com
Goss International | 121 Technology Dr, Durham, NH 03824 |  | info@gossinternational.com
Generator Connection | 1057 Calef Hwy, Barrington, NH 03825 | (603) 664-4004 | wayne@generatorconnection.com
Defense Manufacturers, Inc. | 44 Maple St, Dover, NH 03820 | (603) 740-9818
Continental ContiTech | 35 Industrial Way, Rochester, NH 03867 | (603) 692-6300 | mailservice@contitech.de
Bottomline Technologies | 325 Corporate Dr, Portsmouth, NH 03801 | (603) 436-0700
BMW of Stratham | 71 Portsmouth Ave, Stratham, NH 03885 | (603) 772-0000 | kconnor@iramotorgroup.com
Back Bay Customs | 800 Central Ave, Dover, NH 03820 |  | BackBayCustomsInfo@gmail.com
Allegro | 282 W Knox Marsh Rd, Madbury, NH 03823 | (603) 743-3559 | loren@allegrosoft.com
Albany Composits | 112 Airport Dr, Rochester, NH 03867 |  | brady.stewart@albint.com
Goss International | 121 Technology Dr, Durham, NH 03824 |  | info@gossinternational.com | Need to set an appointment over phone or online
Pentair | 47 Crosby Rd, Dover, NH 03820
Uraseal, Inc. | 1 Washington St, Dover, NH 03820
Back Bay Customs | 800 Central Ave, Dover, NH 03820 |  | BackBayCustomsInfo@gmail.com
Globaltek Components | 74 Industrial Park Dr, Dover, NH 03820 |  | info@globaltekcomp.com
