Maeswoon/UNHSEDS/Engineering/2019-2020_USURPER/Avionics/Board Files/Breadboard Components SolidWorks.JPG

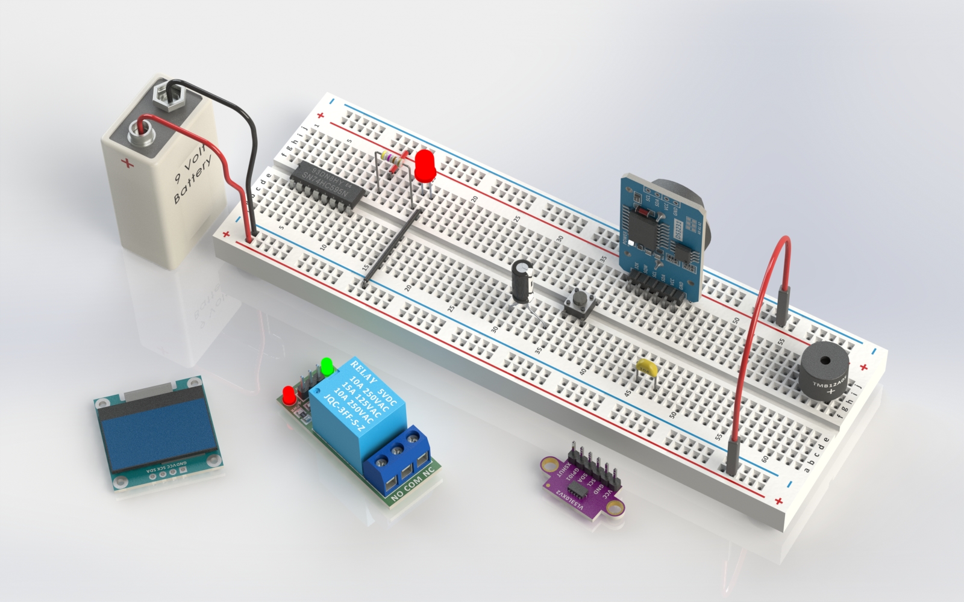
Engineering/2019-2020_USURPER/Avionics/Board Files/Breadboard Components SolidWorks.JPG
