Maeswoon/UNHSEDS/Engineering/2019-2020_USURPER/Avionics/Board Files/Breadboard SolidWorks Components.JPG

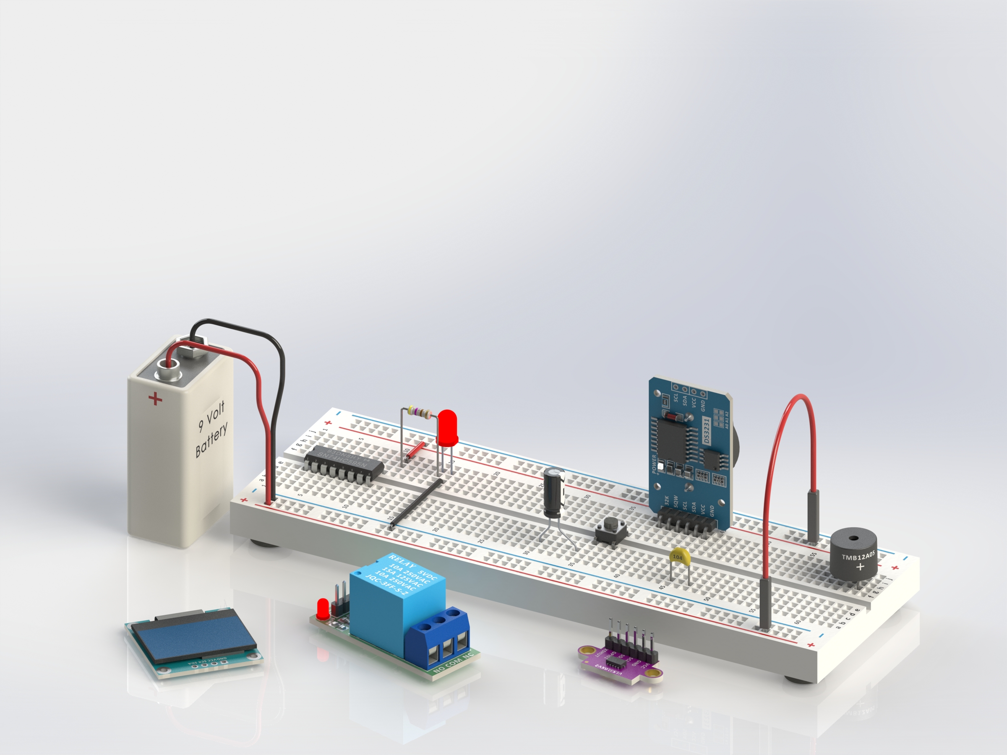
Engineering/2019-2020_USURPER/Avionics/Board Files/Breadboard SolidWorks Components.JPG
