Maeswoon/UNHSEDS/Engineering/2019-2020_USURPER/Avionics/Board Files/Electronics Parts Render-01.JPG

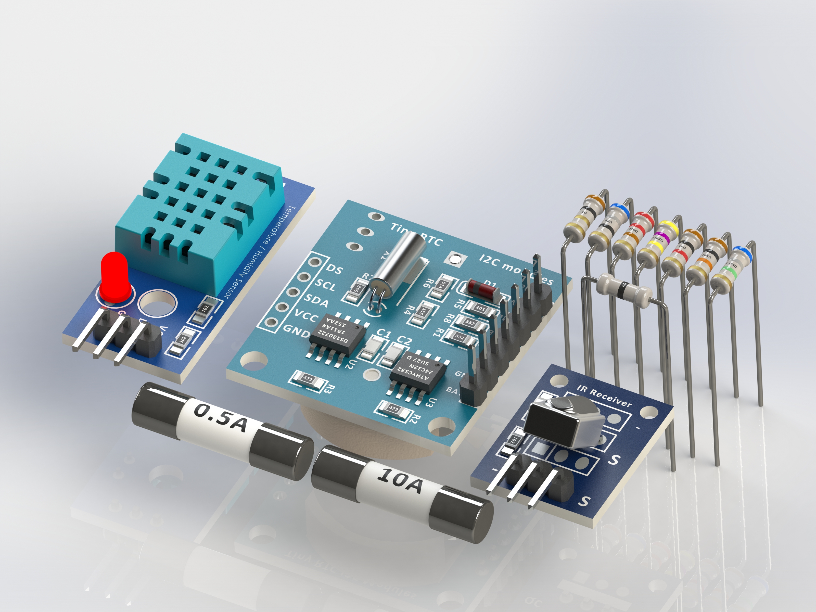
Engineering/2019-2020_USURPER/Avionics/Board Files/Electronics Parts Render-01.JPG
