Maeswoon/UNHSEDS/Engineering/2019-2020_USURPER/Avionics/Board Files/GrabCAD Components to Download.jpg

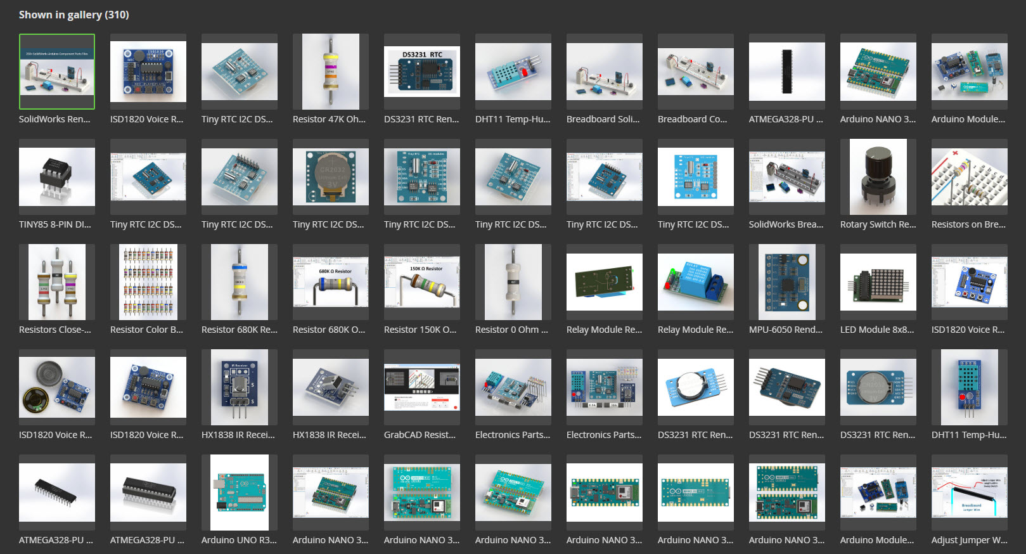
Engineering/2019-2020_USURPER/Avionics/Board Files/GrabCAD Components to Download.jpg
