Maeswoon/UNHSEDS/Engineering/2019-2020_USURPER/Avionics/Board Files/SolidWorks Breadboard Components.jpg

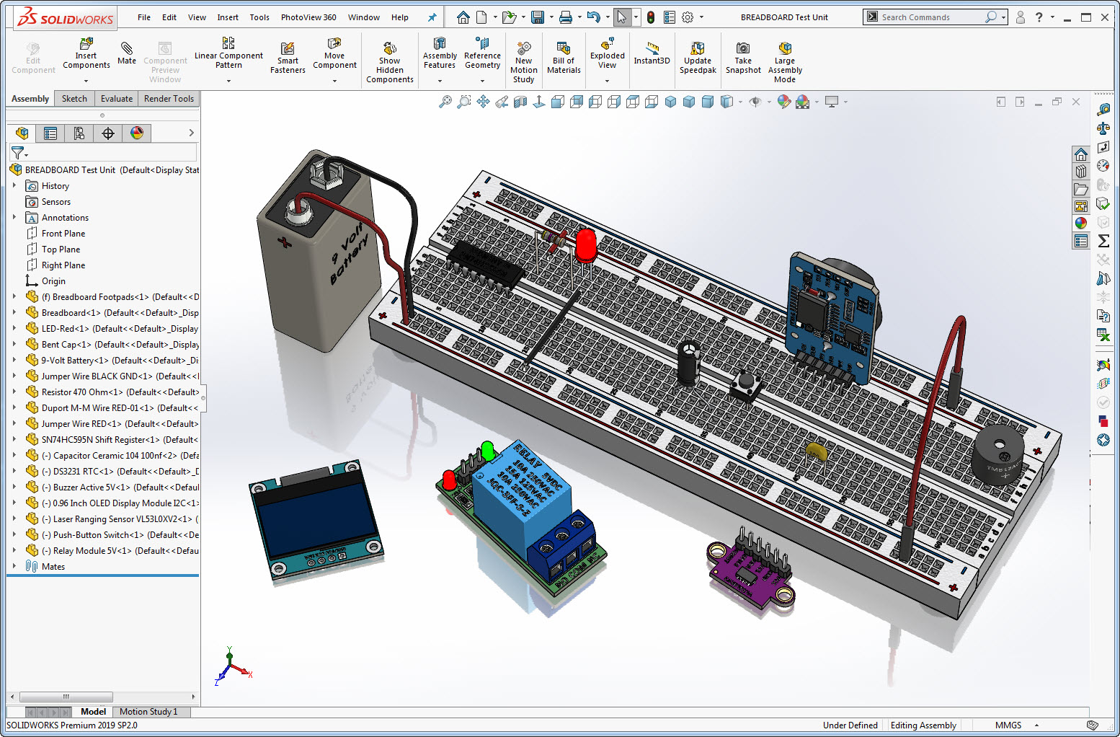
Engineering/2019-2020_USURPER/Avionics/Board Files/SolidWorks Breadboard Components.jpg
