Maeswoon/UNHSEDS/Engineering/2019-2020_USURPER/Avionics/Board Files/SolidWorks Rendering Electroinic Components.jpg

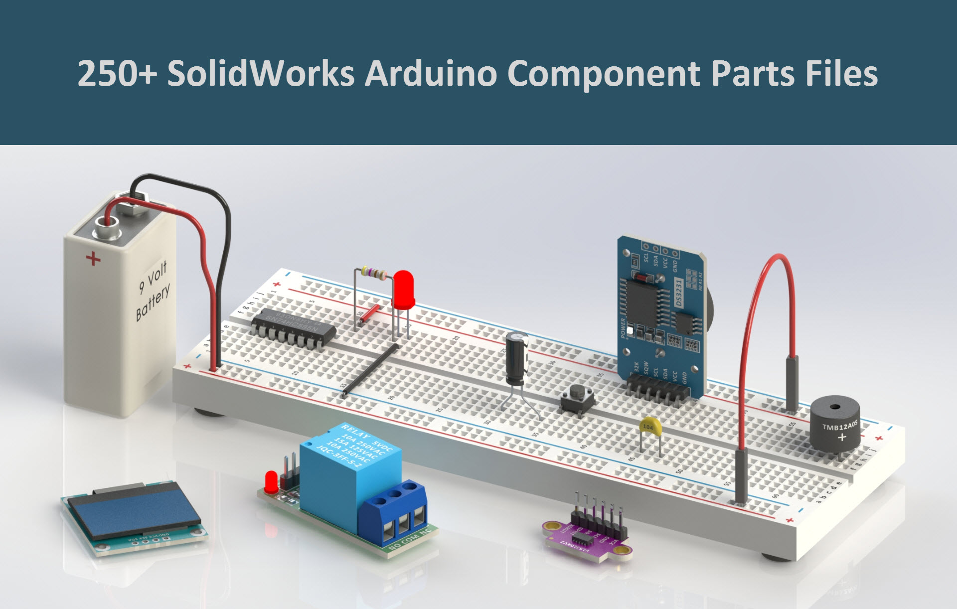
Engineering/2019-2020_USURPER/Avionics/Board Files/SolidWorks Rendering Electroinic Components.jpg
