Maeswoon/UNHSEDS/Engineering/2019-2020_USURPER/Frame/SOLIDWORKS/Parts/Frame V4/2.7.2020/PlateFOS.JPG

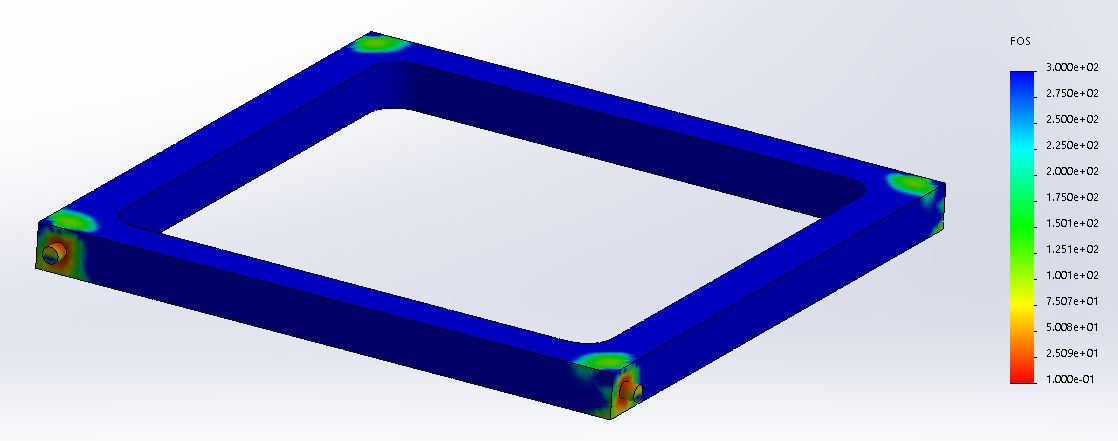
Engineering/2019-2020_USURPER/Frame/SOLIDWORKS/Parts/Frame V4/2.7.2020/PlateFOS.JPG
