Maeswoon/UNHSEDS/Engineering/2019-2020_USURPER/Frame/SOLIDWORKS/Parts/Misc Online Cad Files/2936T480_GALV STL MCMASTER 3_8ths U-BOLT-Static 1/2936T480_GALV STL MCMASTER 3_8ths U-BOLT-Strain.jpg

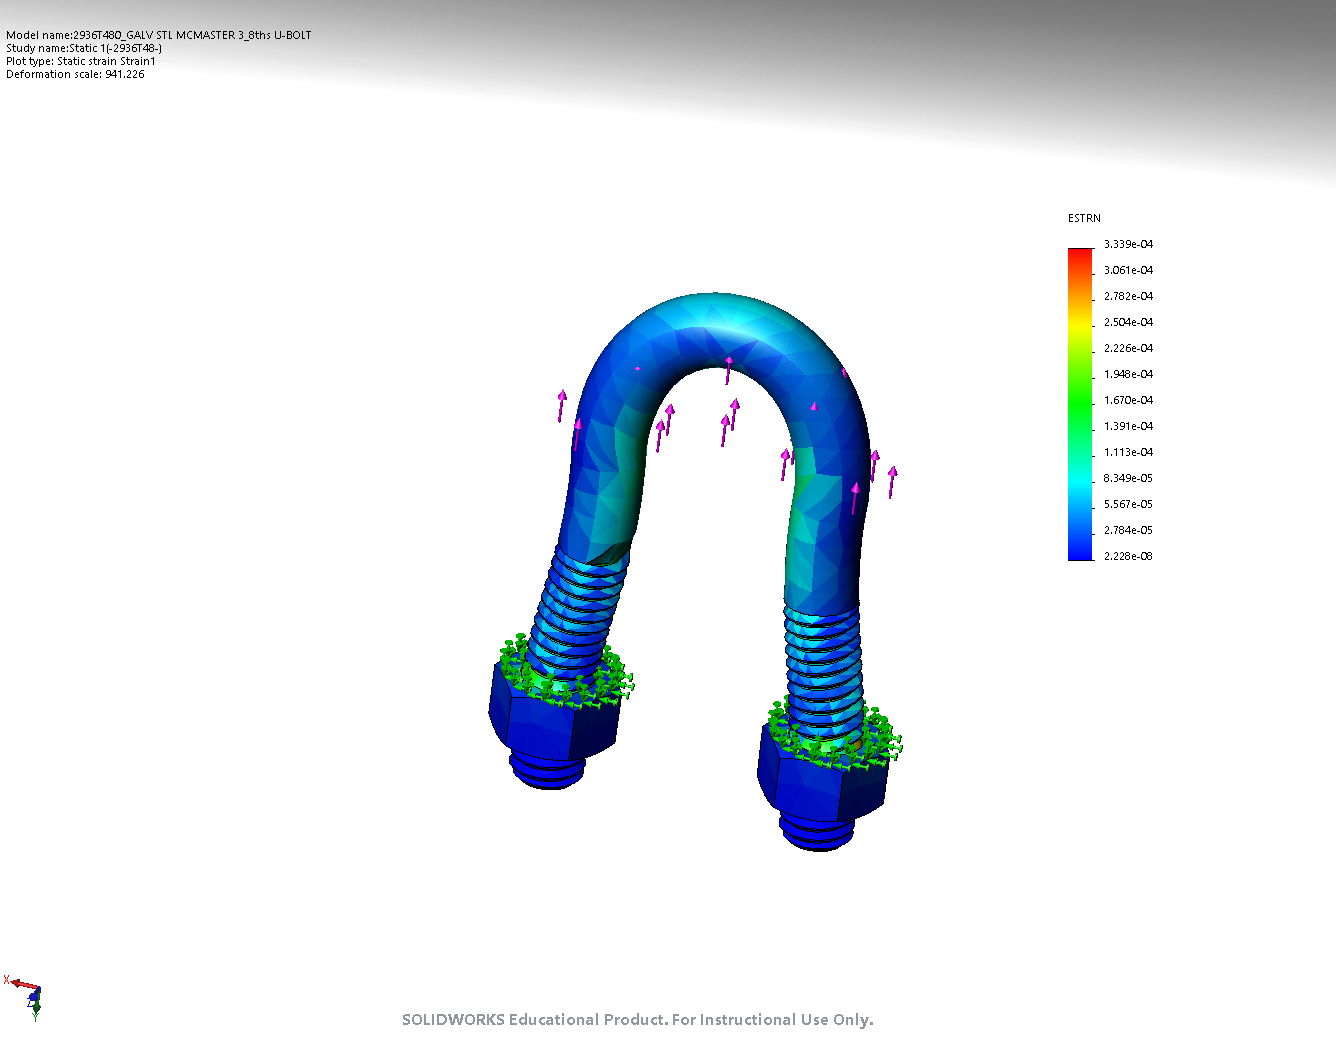
Engineering/2019-2020_USURPER/Frame/SOLIDWORKS/Parts/Misc Online Cad Files/2936T480_GALV STL MCMASTER 3_8ths U-BOLT-Static 1/2936T480_GALV STL MCMASTER 3_8ths U-BOLT-Strain.jpg
