Maeswoon/UNHSEDS/Engineering/2019-2020_USURPER/Frame/SOLIDWORKS/Parts/Misc Online Cad Files/91251A157_BLACK-OXIDE ALLOY STEEL SOCKET HEAD SCREW 6_32-Static 1/Disp.PNG

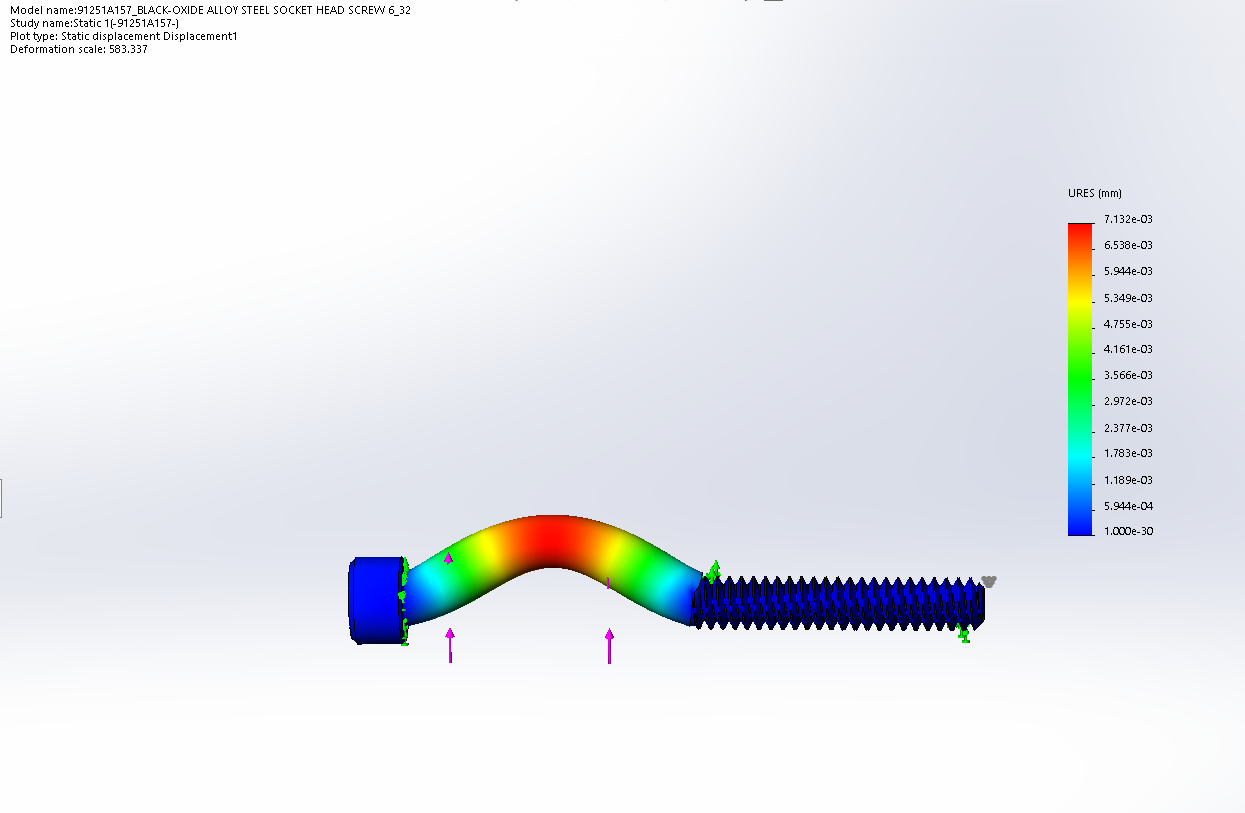
Engineering/2019-2020_USURPER/Frame/SOLIDWORKS/Parts/Misc Online Cad Files/91251A157_BLACK-OXIDE ALLOY STEEL SOCKET HEAD SCREW 6_32-Static 1/Disp.PNG
