Maeswoon/UNHSEDS/Engineering/2019-2020_USURPER/Frame/SOLIDWORKS/Parts/Misc Parts/Fin stuff/Fin.PNG

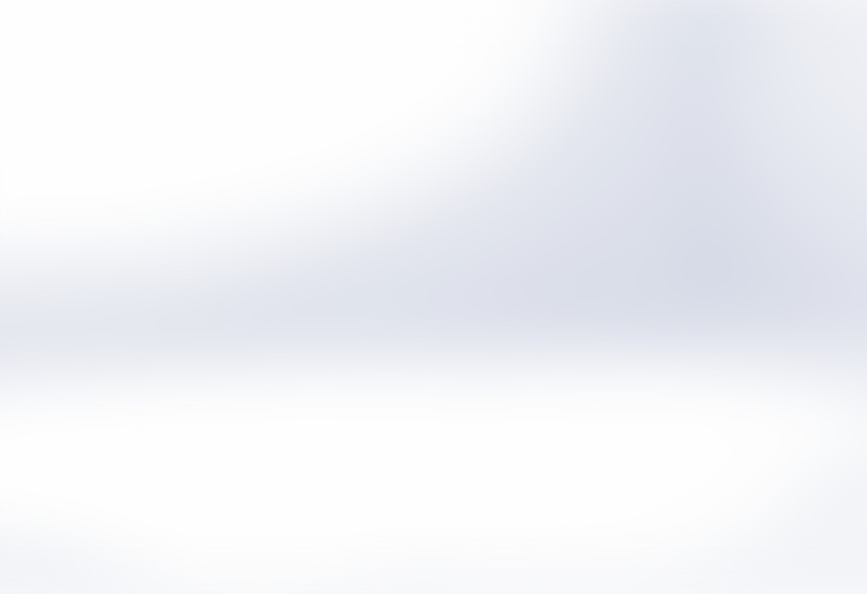
Engineering/2019-2020_USURPER/Frame/SOLIDWORKS/Parts/Misc Parts/Fin stuff/Fin.PNG
