Maeswoon/UNHSEDS/Engineering/2018-2019/Project Gimbal/Gimbal 32919/actuator/Firgelli L16 50mm Assembly.IGS

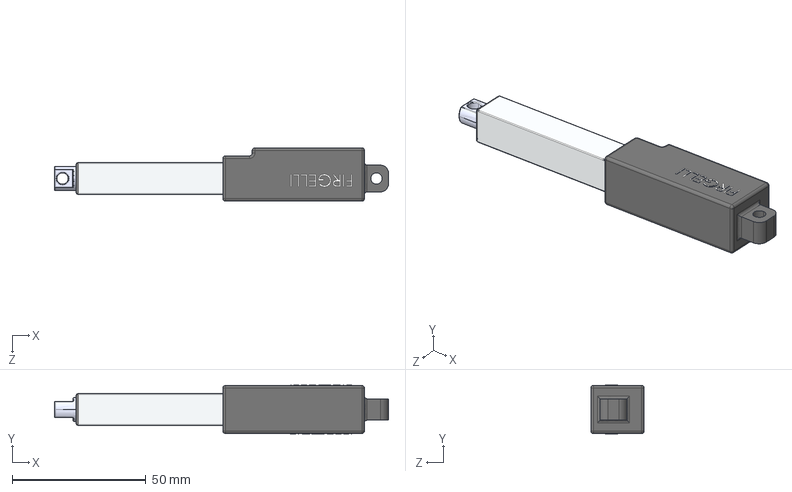
[picture p327: CAD file, 2019-02-25]
Engineering/2018-2019/Project Gimbal/Gimbal 32919/actuator/Firgelli L16 50mm Assembly.IGS
125.0 x 18.2 x 20.0 mm
