Maeswoon/UNHSEDS/Engineering/2019-2020_USURPER/Frame/SOLIDWORKS/Assemblies/Fin Assembly/Fin Assembly1.SLDASM

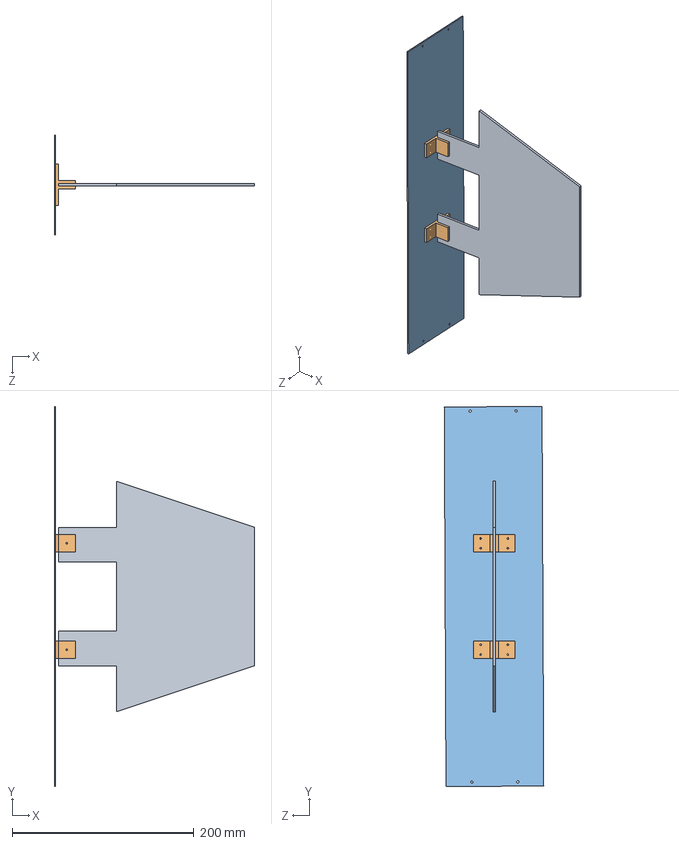
[picture p328: CAD file, 2020-03-10]
Engineering/2019-2020_USURPER/Frame/SOLIDWORKS/Assemblies/Fin Assembly/Fin Assembly1.SLDASM
220.7 x 418.3 x 109.5 mm
FinTest
