Maeswoon/UNHSEDS/Engineering/2019-2020_USURPER/Frame/SOLIDWORKS/Assemblies/Frame Assembly/Frame Assembly V4/V4.SLDASM

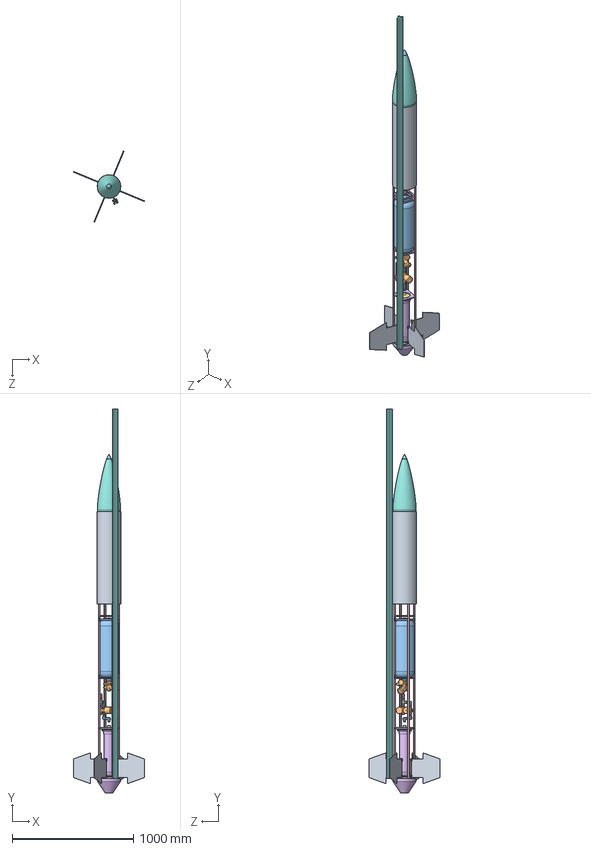
[picture p329: CAD file, 2020-04-24]
Engineering/2019-2020_USURPER/Frame/SOLIDWORKS/Assemblies/Frame Assembly/Frame Assembly V4/V4.SLDASM
589.4 x 3169.6 x 589.4 mm
7.51in Brown Kraft Paper
NOS tank cap
NO2_Tank GoogleDrive
NozzleBase
ThroatInsert
Aluminum Combustion Chamber
Injector Plate
Von Karman NoseCone
NoseCone Coupler
Von Karman NoseCone Base
Von Karman NoseCone Tip
3014T450_STEEL EYEBOLT WITH SHOULDER - FOR LIFTING
6061 1.8 Full Frame Test
Square Injection Plate Support
Square Nozzle Plate Support
LargeRecoveryPlate x 3
LargeRecoveryPlateWireHole
Recovery Interface Plate
RaptorMockup x 4
2936T480_GALV STL MCMASTER 3_8ths U-BOLT x 2
RecoveryTopPlate
Square Support x 5
MainChute
DrogueChute
.25-20 90 degree nut
SwagelokValve x 3
SwagelokElbow x 3
SwagelokTee
SwagelokTubeToThread
Tapered base mold
RailButton
Rail
Fin x 4
FinHolder x 4
FinHolderPin x 4
FinHolderPinHole x 4
