Maeswoon/UNHSEDS/Engineering/2019-2020_USURPER/Frame/SOLIDWORKS/Assemblies/No2 Tank Structure Assembly/Test Assembly.SLDASM

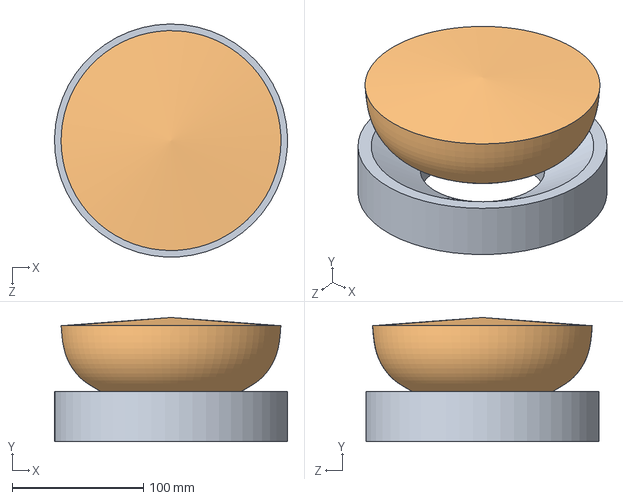
[picture p330: CAD file, 2019-12-09]
Engineering/2019-2020_USURPER/Frame/SOLIDWORKS/Assemblies/No2 Tank Structure Assembly/Test Assembly.SLDASM
177.7 x 94.6 x 177.7 mm
No2 Tank Coupler
NOS Bottle_PatchedModel Top model
