Maeswoon/UNHSEDS/Engineering/2019-2020_USURPER/Frame/SOLIDWORKS/Parts/Frame V4/1.25.2020/6061 1.8 Full Frame Test.SLDPRT

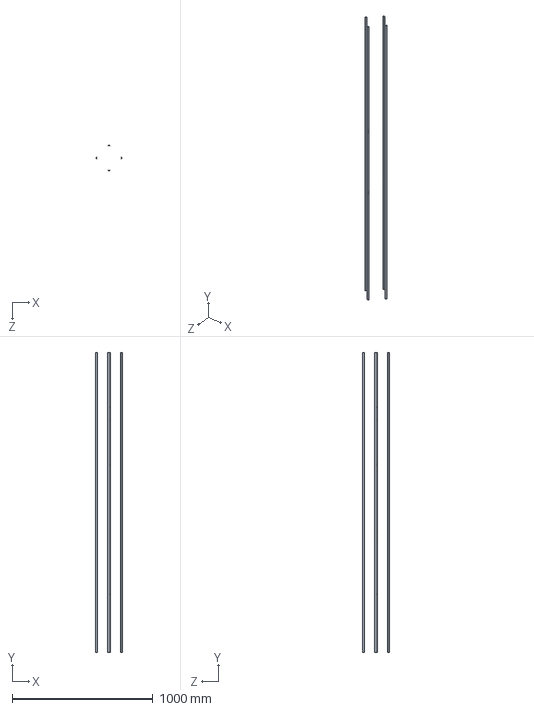
[picture p331: CAD file, 2020-03-09]
Engineering/2019-2020_USURPER/Frame/SOLIDWORKS/Parts/Frame V4/1.25.2020/6061 1.8 Full Frame Test.SLDPRT
189.5 x 2133.6 x 189.5 mm
