Maeswoon/UNHSEDS/Engineering/2019-2020_USURPER/Frame/SOLIDWORKS/Assemblies/No2 Tank Structure Assembly/No2 Tank Support Structure Assmebly V3.SLDASM

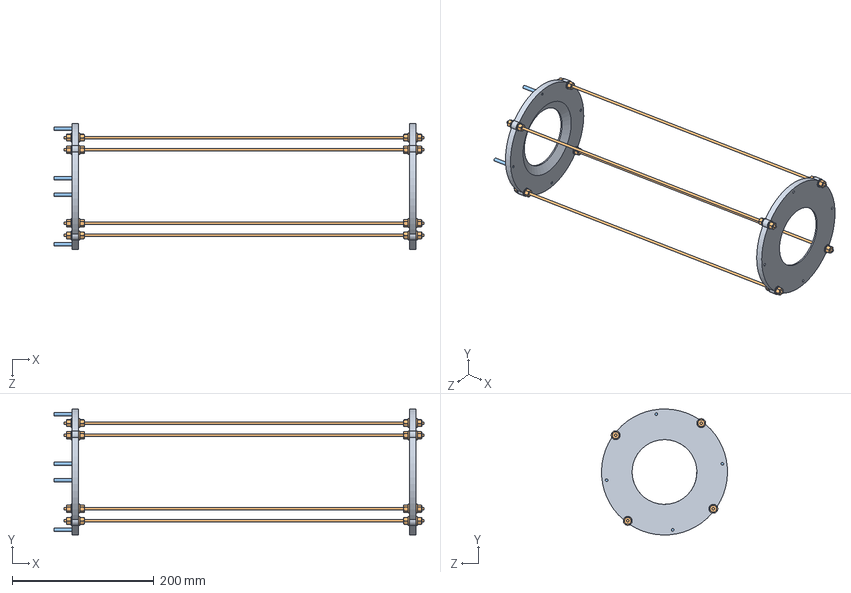
[picture p332: CAD file, 2019-12-09]
Engineering/2019-2020_USURPER/Frame/SOLIDWORKS/Assemblies/No2 Tank Structure Assembly/No2 Tank Support Structure Assmebly V3.SLDASM
522.2 x 177.7 x 177.7 mm
NO2 Tank Support Ring x 2
Joined Nut and Bolt 0.190 Rod x 4
Basic Aluminum Rod x 4
