Maeswoon/UNHSEDS/Engineering/2019-2020_USURPER/Frame/SOLIDWORKS/Assemblies/Frame Assembly/Frame Assembly V4/V4 Frame Support Strucutre Test.SLDASM

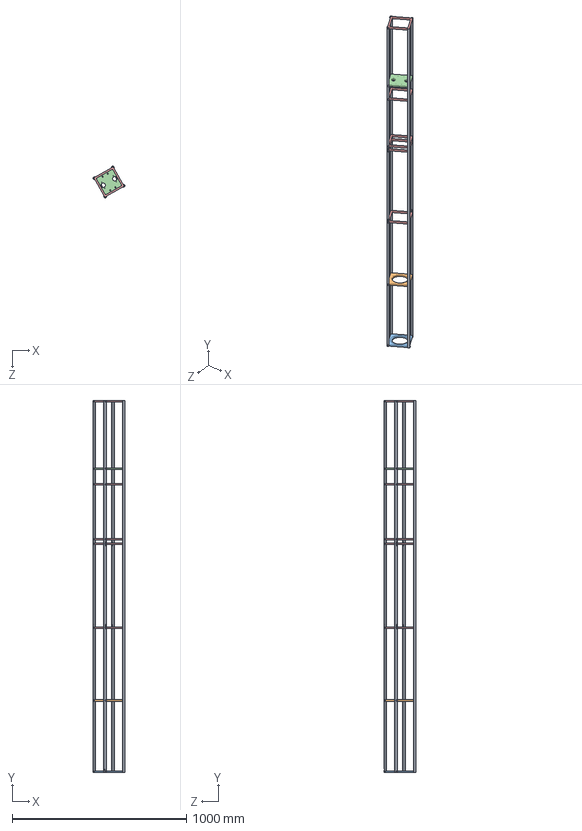
[picture p334: CAD file, 2020-02-21]
Engineering/2019-2020_USURPER/Frame/SOLIDWORKS/Assemblies/Frame Assembly/Frame Assembly V4/V4 Frame Support Strucutre Test.SLDASM
183.0 x 2133.6 x 183.0 mm
6061 1.8 Full Frame Test
Square Injection Plate Support
Square Nozzle Plate Support
Recovery Interface Plate
Square Support x 5
6-32BoltAssembly x 32
