Maeswoon/UNHSEDS/Engineering/2019-2020_USURPER/Frame/SOLIDWORKS/Parts/Frame V4/1.25.2020/7075 1.16 Full Frame with Top Structure Test.SLDPRT

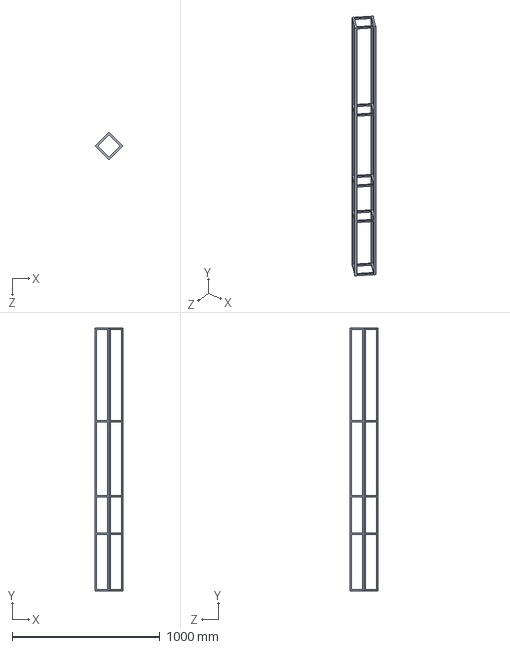
[picture p335: CAD file, 2020-01-30]
Engineering/2019-2020_USURPER/Frame/SOLIDWORKS/Parts/Frame V4/1.25.2020/7075 1.16 Full Frame with Top Structure Test.SLDPRT
187.1 x 1778.0 x 187.1 mm
