Maeswoon/UNHSEDS/Engineering/2019-2020_USURPER/Frame/SOLIDWORKS/Parts/Frame V4/1.21.2020/Von Karman Assembly.SLDASM

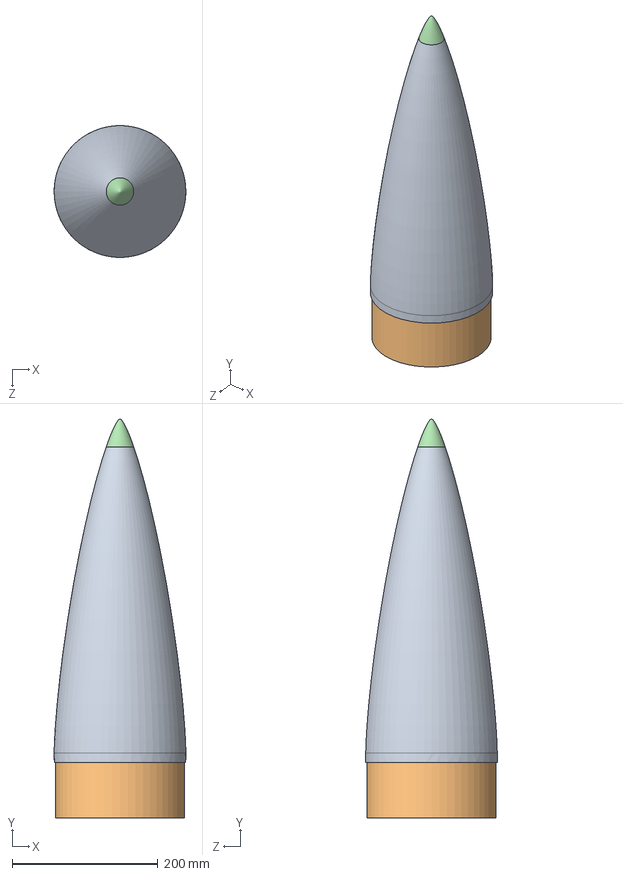
[picture p336: CAD file, 2019-12-19]
Engineering/2019-2020_USURPER/Frame/SOLIDWORKS/Parts/Frame V4/1.21.2020/Von Karman Assembly.SLDASM
181.0 x 547.7 x 181.0 mm
Von Karman NoseCone
NoseCone Coupler
Von Karman NoseCone Base
Von Karman NoseCone Tip
3014T450_STEEL EYEBOLT WITH SHOULDER - FOR LIFTING
