Maeswoon/UNHSEDS/Engineering/2021-2022_EUROPA/TITAN Frame/MainChute.SLDPRT

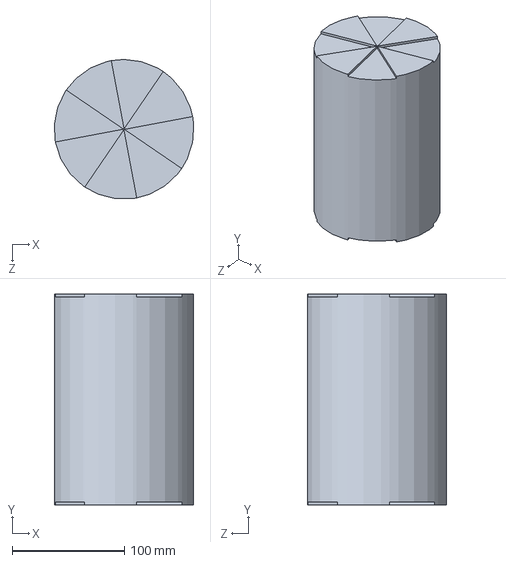
[picture p337: CAD file, 2022-10-18]
Engineering/2021-2022_EUROPA/TITAN Frame/MainChute.SLDPRT
124.2 x 188.0 x 124.0 mm
