Maeswoon/UNHSEDS/Engineering/2018-2019/Gimbal Master/Assem1.SLDASM

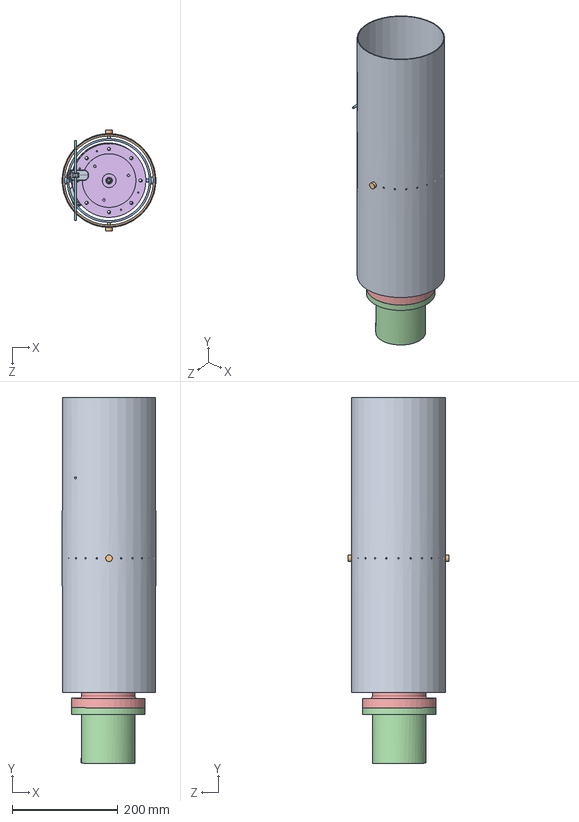
[picture p338: CAD file, 2019-02-27]
Engineering/2018-2019/Gimbal Master/Assem1.SLDASM
177.8 x 693.7 x 190.5 mm
Enforcement Ring
Gimbal Ring
Nozzle
Combustion Chamber TST1
Injector EXP9A with holes for slide hammer mount
Injector EXP9A Gas Director
Peg
p16_50mm_in x 2
Body Tube Peg 2 x 2
Gimbal to Engine Pin x 2
