Maeswoon/UNHSEDS/Engineering/2018-2019/Project Gimbal/Gimbal 4-2-2019/Gimbal assembly 2.SLDASM

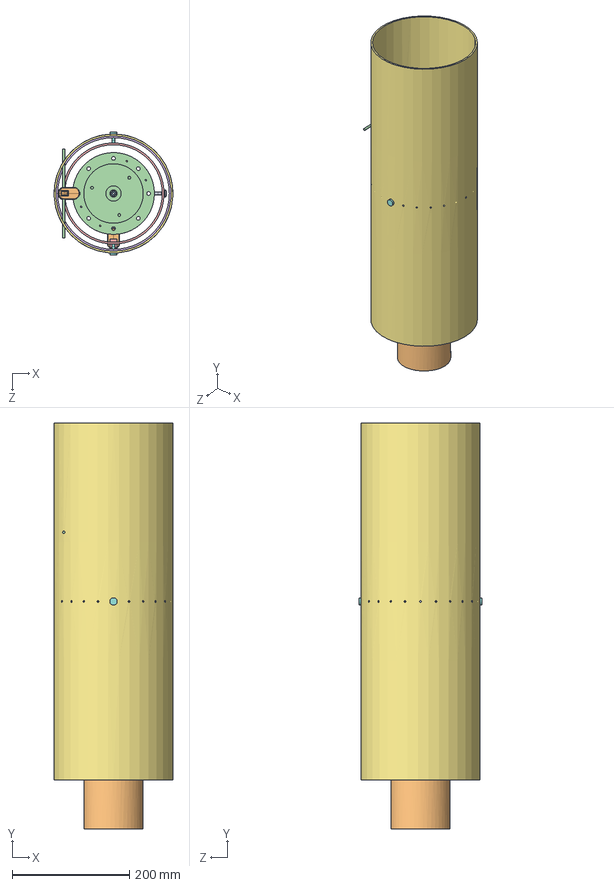
[picture p339: CAD file, 2019-04-03]
Engineering/2018-2019/Project Gimbal/Gimbal 4-2-2019/Gimbal assembly 2.SLDASM
203.2 x 693.4 x 210.8 mm
Combustion Chamber TST1
Nozzle
Injector EXP9A Gas Director
Injector EXP9A with holes for slide hammer mount
gimbal ring 2
Body tube 2
Body Tube Peg 2 x 2
Gimbal to Engine Pin x 2
Mounting Bracket
p16_50mm_in x 2
Peg2
Mounting bracket 2
rod
Mounting Bracket 3
fake extension
