Maeswoon/UNHSEDS/Engineering/2022-2023 Rocket/Frame/RocketAssemblyV2.SLDASM

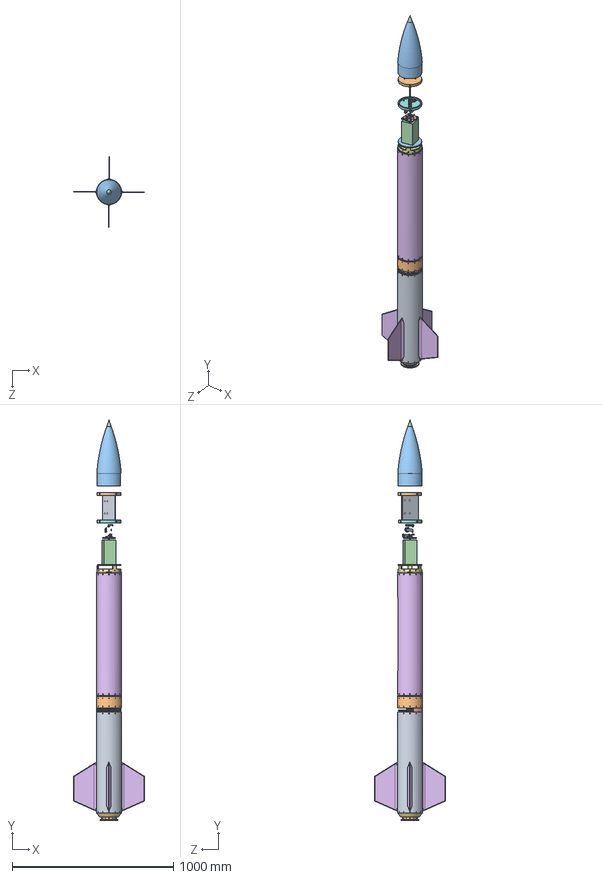
[picture p340: CAD file, 2023-04-05]
Engineering/2022-2023 Rocket/Frame/RocketAssemblyV2.SLDASM
441.2 x 2483.5 x 441.2 mm
Engine Segment
Nosecone
Nosecone tip
EG.IJ.Coupler
Fins x 4
Nozzle coupler MC
Impinging plate
Insulation
Nozzle Retainer
NozzleSimSemi
Parafin Wax Model
CustomNosTank-BlkhdBottom-Vers2
CustomNosTank-Tube
CustomNosTank-BlkhdTop-Vers3
AvBayBottomPlate
AvBaySled
AvBayTopPlate
Housing BaseV2
Electronics Housing
Camera Mounting Plate
Screw for Lens Holder x 6
Lens
Lens Cushion
Joint Screw
Joint
Back Cushion
Black Rubber Washer x 2
Rubber Washer x 4
Pivot Rod
Button Spring x 2
Button x 2
Button Fastening Washer x 2
Flat Mount
Clamp
Clamp Clip
Joint Nut
EngineCouplerInsulation
