Maeswoon/UNHSEDS/Engineering/2021-2022_EUROPA/Propulsion/New Engine Components/SolidWorks/Nozzle Extension.SLDASM

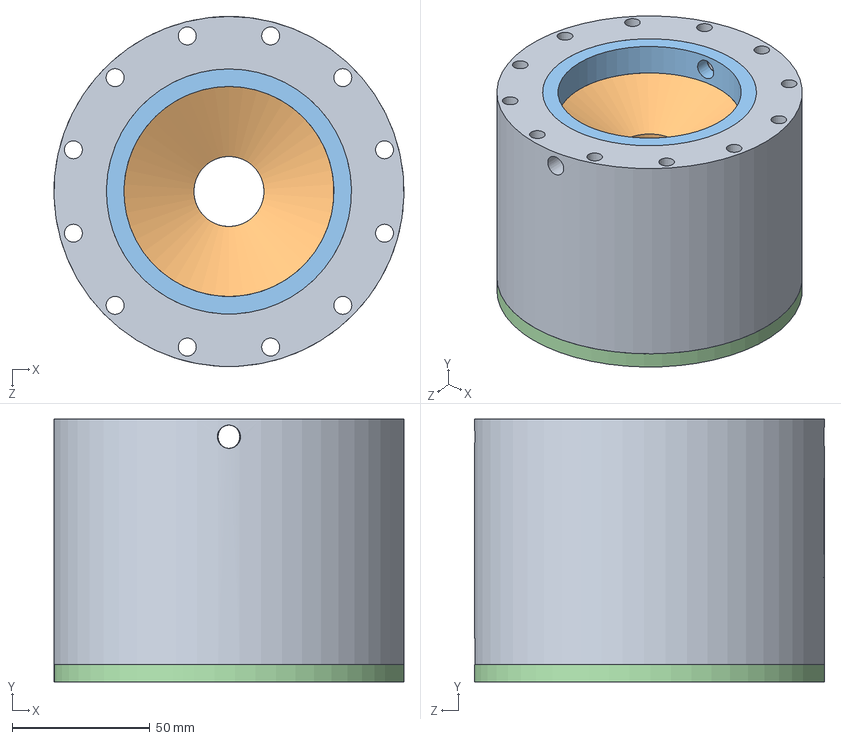
[picture p341: CAD file, 2022-02-10]
Engineering/2021-2022_EUROPA/Propulsion/New Engine Components/SolidWorks/Nozzle Extension.SLDASM
127.0 x 95.2 x 127.0 mm
Combustion Chamber Nozzle Ext
New Nozzle
Graphite Ring
Steel Retaining Ring
