Maeswoon/UNHSEDS/Engineering/2022-2023 Rocket/Payload/SolidWorks/Final_Payload.SLDASM

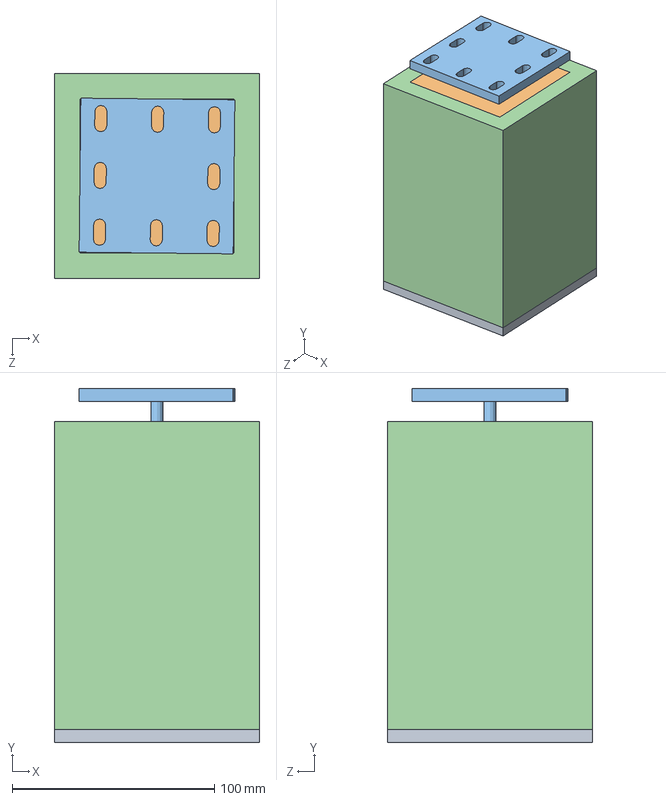
[picture p342: CAD file, 2023-03-29]
Engineering/2022-2023 Rocket/Payload/SolidWorks/Final_Payload.SLDASM
101.6 x 175.1 x 101.6 mm
Housing Base
Electronics Housing
Camera Mounting Plate
6546K865_Multipurpose 6061 Aluminum Rectangular Tube
