Maeswoon/UNHSEDS/Engineering/2018-2019/Gimbal Master/Entire Engine.SLDASM

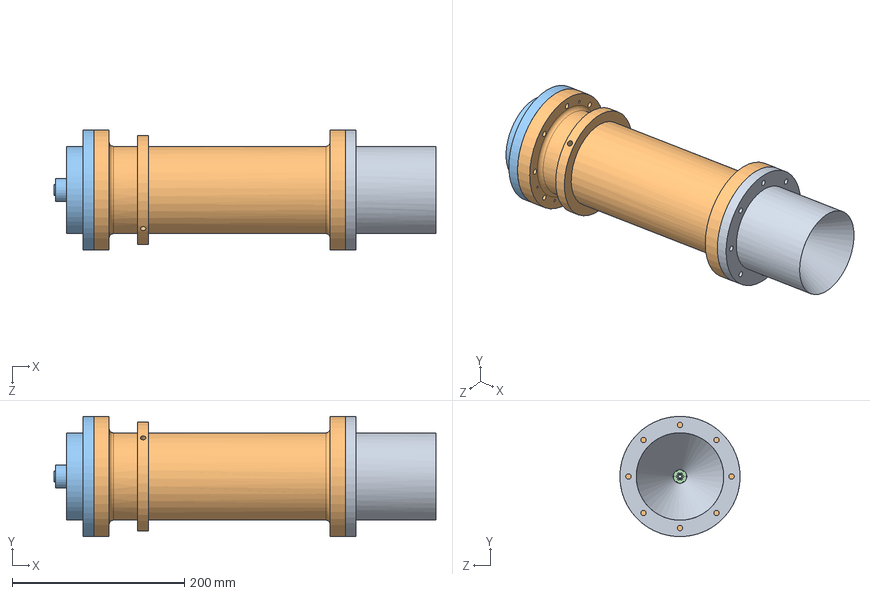
[picture p343: CAD file, 2019-02-26]
Engineering/2018-2019/Gimbal Master/Entire Engine.SLDASM
443.8 x 139.7 x 139.7 mm
Nozzle
Combustion Chamber TST1
Injector EXP9A with holes for slide hammer mount
Injector EXP9A Gas Director
