Maeswoon/UNHSEDS/Engineering/2019-2020_USURPER/Frame/SOLIDWORKS/Parts/Misc Online Cad Files/User Library-Gas Bottle Assby.sldasm

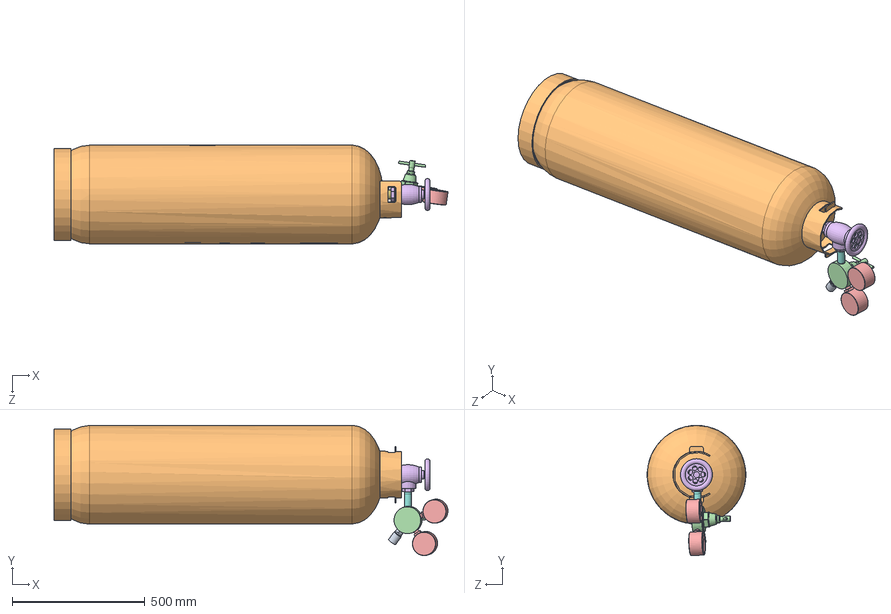
[picture p344: CAD file, 2019-09-09]
Engineering/2019-2020_USURPER/Frame/SOLIDWORKS/Parts/Misc Online Cad Files/User Library-Gas Bottle Assby.sldasm
1482.3 x 489.9 x 370.8 mm
User Library-Gas Bottle Assby_Welds_1
User Library-Gas Bottle Assby_Gas Cylinder
User Library-Gas Bottle Assby_1
User Library-Gas Bottle Assby_RegulatorBody
User Library-Gas Bottle Assby_RegulatorGauge x 2
User Library-Gas Bottle Assby_90deg Gas Valve - 1in
User Library-Gas Bottle Assby_1-1
User Library-Gas Bottle Assby_3_4-75
User Library-Gas Bottle Assby_3_4-3_4
