Maeswoon/UNHSEDS/Engineering/2020-2021_PHANTOM/Propulsion/Banshee V1/Banshee V1 Assembly w Glass Insert.SLDASM

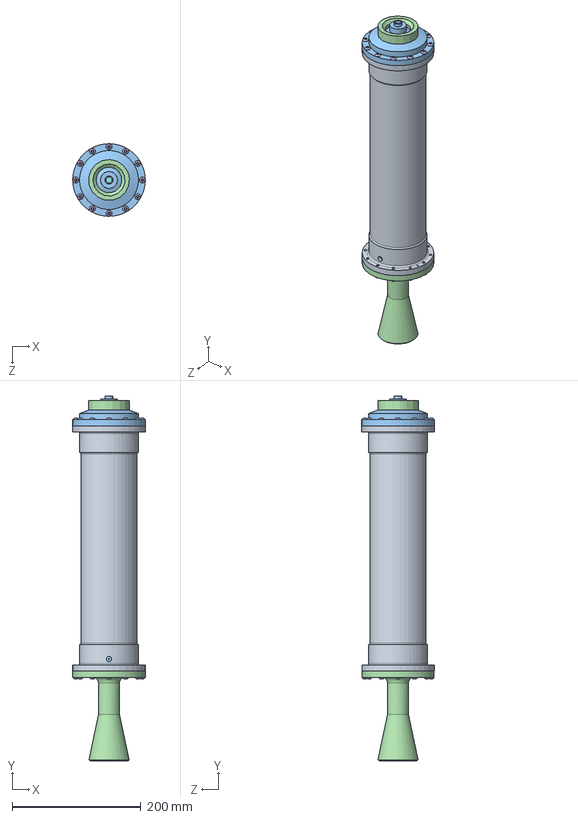
[picture p345: CAD file, 2021-03-29]
Engineering/2020-2021_PHANTOM/Propulsion/Banshee V1/Banshee V1 Assembly w Glass Insert.SLDASM
112.7 x 566.7 x 112.7 mm
Combustion Chamber w Insert
Glass Insert 310 mm
Injector Port
Nozzle Base
Throat Insert
10-32 92949A269 18-8 SS BUTTON HEAD HEX DRIVE SCREW x 24
Dowel Pin x 4
Swirl Atomizer
Oxidizer Plate
Graphite Insert Top
Graphite Insert Bottom
HTPB Fuel Grain
