Maeswoon/UNHSEDS/Engineering/2021-2022_EUROPA/Propulsion/Banshee V1/Banshee V1 Assembly w showerhead.SLDASM

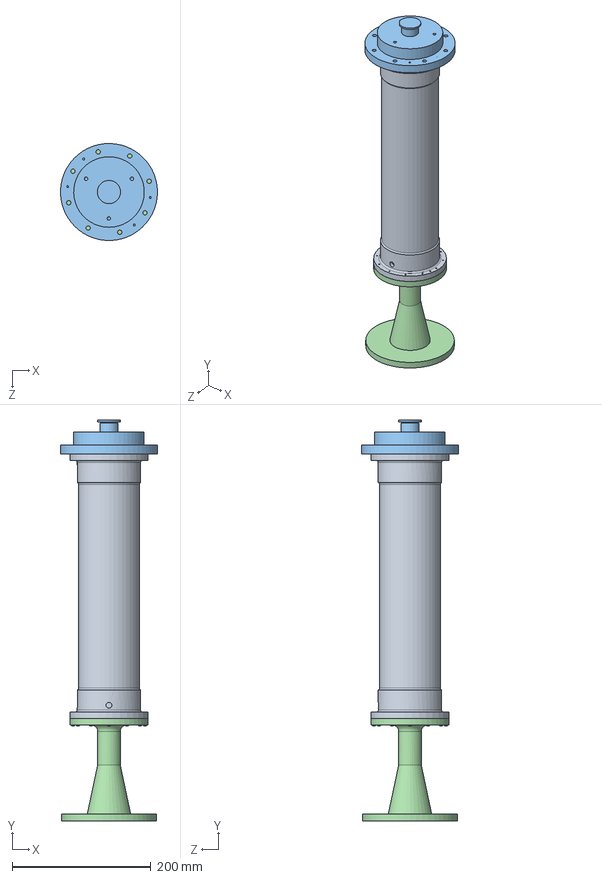
[picture p346: CAD file, 2021-02-04]
Engineering/2021-2022_EUROPA/Propulsion/Banshee V1/Banshee V1 Assembly w showerhead.SLDASM
139.6 x 577.4 x 139.6 mm
Combustion Chamber w Insert
Glass Insert 13 inch
Injector EXP9A with holes for slide hammer mount
Nozzle Base
Throat Insert
4-40 Bolt x 24
Dowel Pin x 4
Graphite Insert Top
Graphite Insert Bottom
HTPB Fuel Grain
Injector EXP9A Gas Director
