Maeswoon/UNHSEDS/Engineering/2021-2022_EUROPA/Propulsion/Banshee V1/Banshee V1 Assembly w injectioncylinder.SLDASM

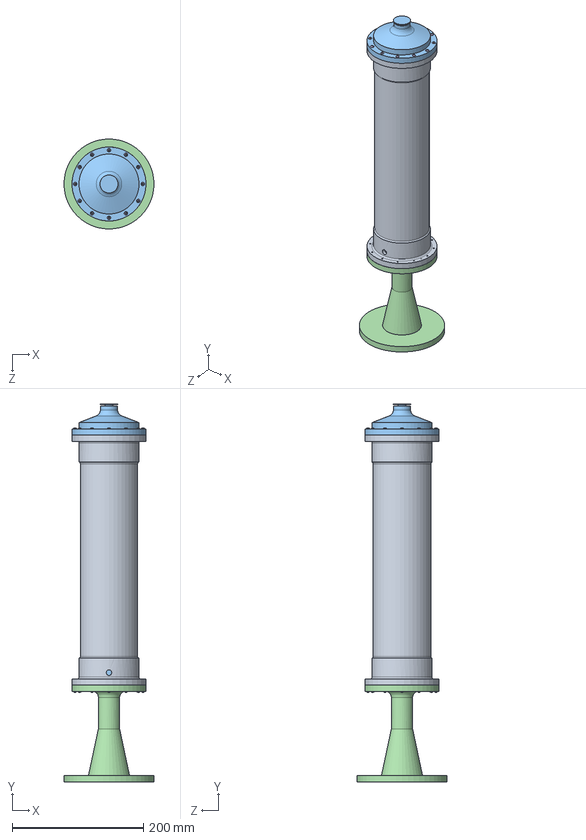
[picture p347: CAD file, 2021-02-04]
Engineering/2021-2022_EUROPA/Propulsion/Banshee V1/Banshee V1 Assembly w injectioncylinder.SLDASM
137.1 x 575.9 x 137.1 mm
Combustion Chamber w Insert
Glass Insert 13 inch
Injector Port
Nozzle Base
Throat Insert
4-40 Bolt x 24
Dowel Pin x 4
Swirl Atomizer
Oxidizer Plate - Copy
Graphite Insert Top
Graphite Insert Bottom
HTPB Fuel Grain
