Maeswoon/UNHSEDS/Engineering/2019-2020_USURPER/Frame/SOLIDWORKS/Parts/Misc Parts/CompositeFrameExteriorFull36in.SLDPRT

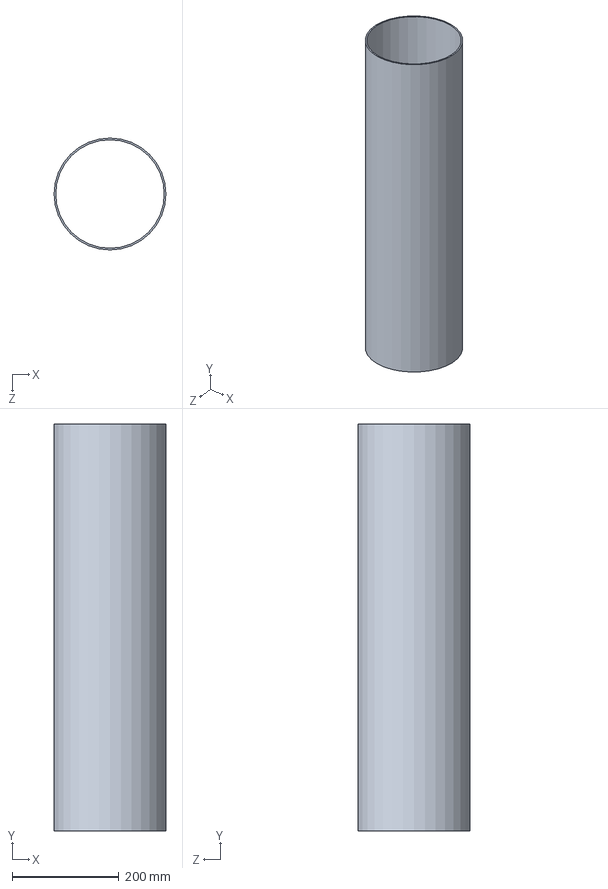
[picture p348: CAD file, 2019-09-09]
Engineering/2019-2020_USURPER/Frame/SOLIDWORKS/Parts/Misc Parts/CompositeFrameExteriorFull36in.SLDPRT
209.5 x 762.0 x 209.5 mm
