Maeswoon/UNHSEDS/Engineering/2020-2021_PHANTOM/Frame/Cornelis Frame V1/Coupler_Assembly_V2.SLDASM

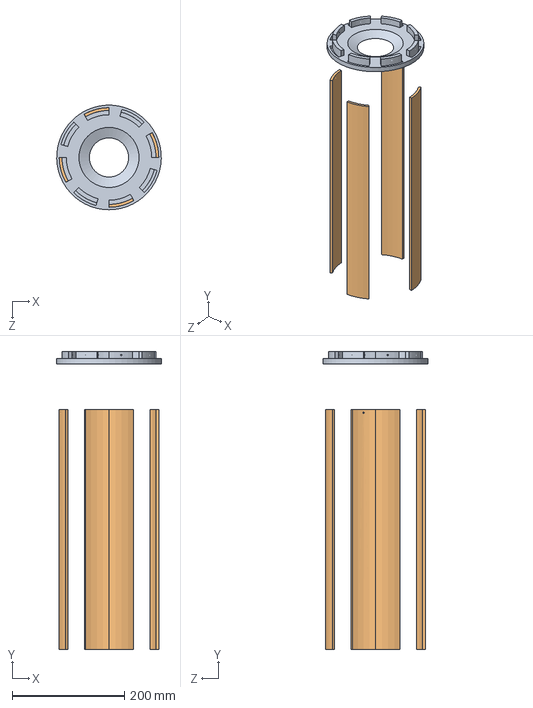
[picture p349: CAD file, 2020-11-23]
Engineering/2020-2021_PHANTOM/Frame/Cornelis Frame V1/Coupler_Assembly_V2.SLDASM
186.6 x 531.7 x 186.5 mm
NOS_tank_support_coupler
Combustion Chamber Frame
