Maeswoon/UNHSEDS/Engineering/2020-2021_PHANTOM/Frame/Cornelis Frame V1/Frame Combustion Chamber.SLDASM

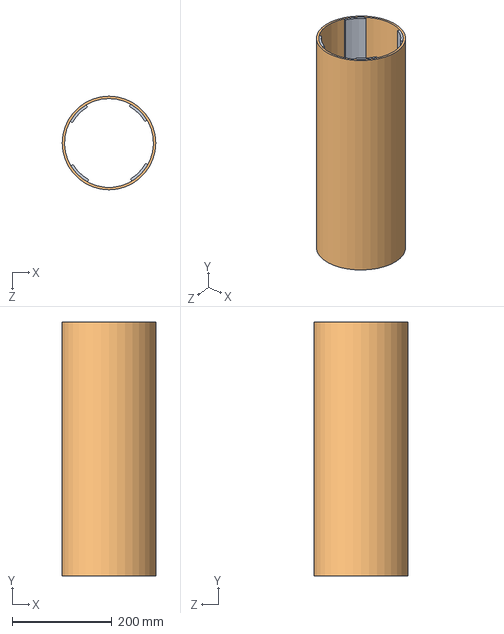
[picture p351: CAD file, 2020-11-23]
Engineering/2020-2021_PHANTOM/Frame/Cornelis Frame V1/Frame Combustion Chamber.SLDASM
187.3 x 508.0 x 187.3 mm
Internal Frame Combustion CHamber
PVC Shell Combustion Chamber
