Maeswoon/UNHSEDS/Engineering/2019-2020_USURPER/Avionics/Board Files/8-PIN TINY85 Unit.SLDASM

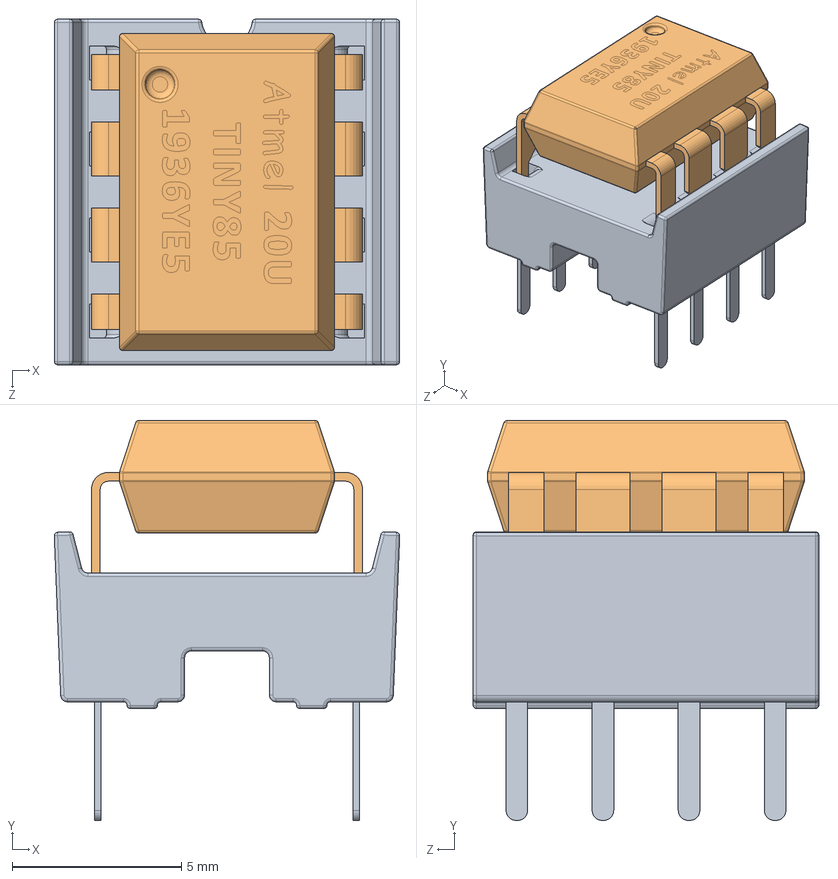
[picture p352: CAD file, 2020-03-05]
Engineering/2019-2020_USURPER/Avionics/Board Files/8-PIN TINY85 Unit.SLDASM
10.2 x 11.8 x 10.2 mm
DIP IC Socket 8-Pins
ATTINY85-20PU
