Maeswoon/UNHSEDS/Engineering/2019-2020_USURPER/Avionics/Board Files/28-PIN ATMEGA328-PU Unit.SLDASM

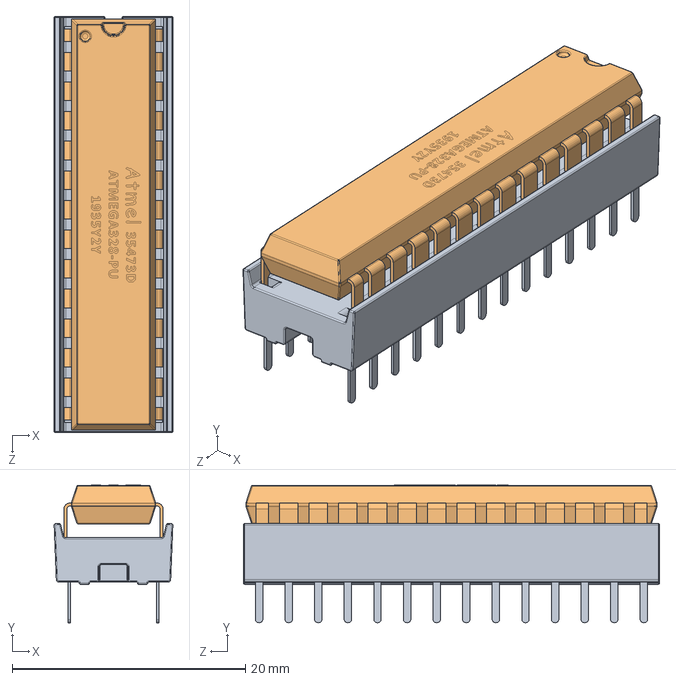
[picture p353: CAD file, 2020-03-05]
Engineering/2019-2020_USURPER/Avionics/Board Files/28-PIN ATMEGA328-PU Unit.SLDASM
10.2 x 11.8 x 35.7 mm
DIP IC Socket 28-Pins
ATMEGA328-PU
