Maeswoon/UNHSEDS/Engineering/2019-2020_USURPER/Avionics/Board Files/Arduino Top Bottom NANO 33 BLE SENSE.SLDASM

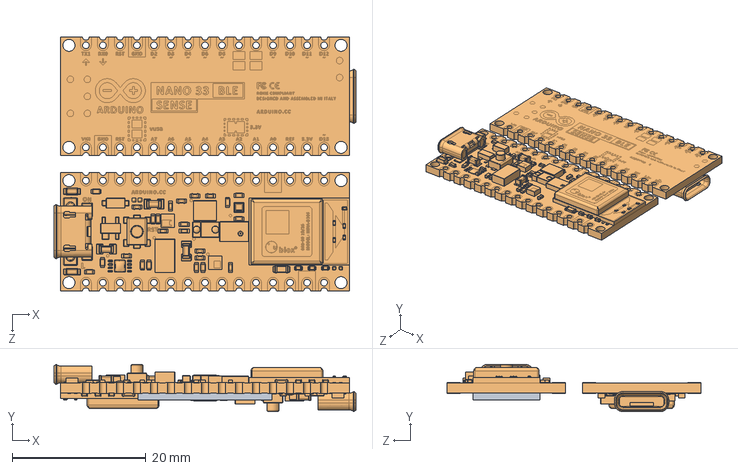
[picture p354: CAD file, 2020-03-05]
Engineering/2019-2020_USURPER/Avionics/Board Files/Arduino Top Bottom NANO 33 BLE SENSE.SLDASM
45.1 x 7.05 x 37.9 mm
000 Center Rectangle
Arduino NANO 33 SENSE BLE x 2
