Maeswoon/UNHSEDS/Engineering/2018-2019/Engine Specifics/Current Engine Design/Combustion Chamber.SLDPRT

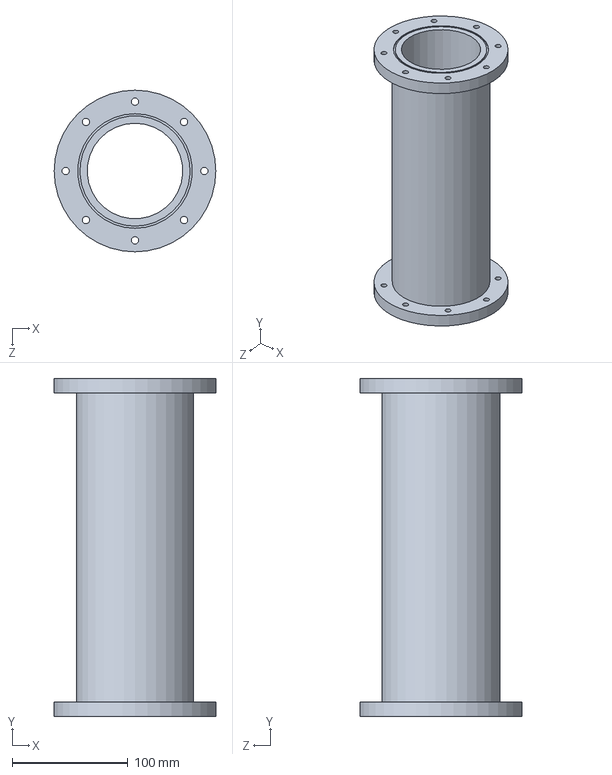
[picture p355: CAD file, 2019-04-03]
Engineering/2018-2019/Engine Specifics/Current Engine Design/Combustion Chamber.SLDPRT
139.7 x 292.1 x 139.7 mm
