Maeswoon/UNHSEDS/Engineering/2018-2019/Gimbal 4-2-2019/Mounting Bracket 3.SLDPRT

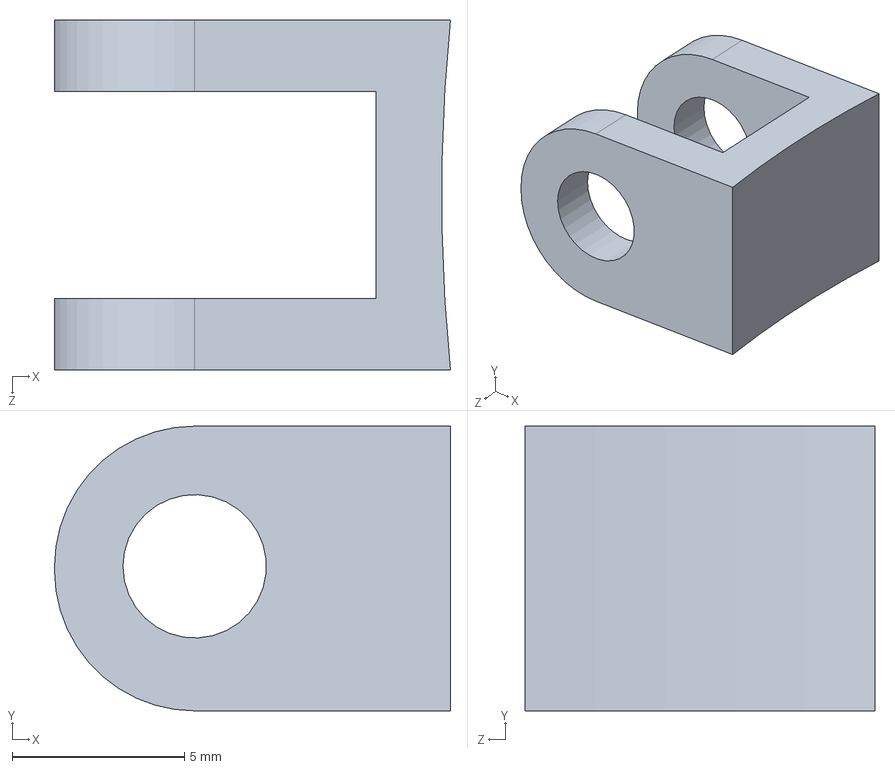
[picture p356: CAD file, 2019-04-05]
Engineering/2018-2019/Gimbal 4-2-2019/Mounting Bracket 3.SLDPRT
11.5 x 8.26 x 10.2 mm
