Maeswoon/UNHSEDS/Engineering/2018-2019/Project Gimbal/Gimbal 3-27-2019/Injector EXP9A with holes for slide hammer mount.SLDPRT

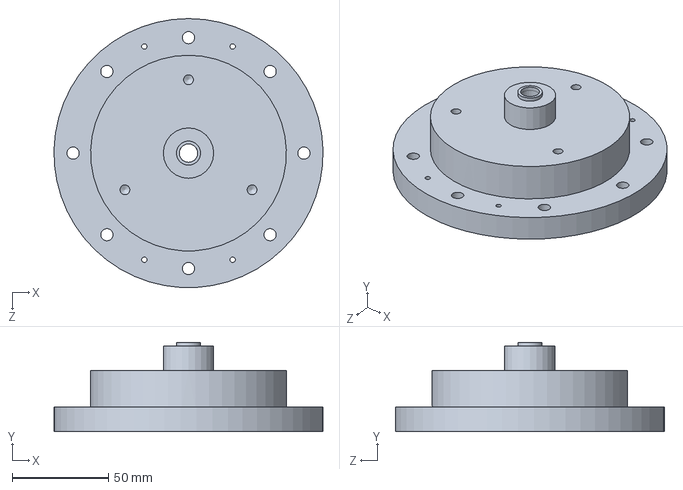
[picture p357: CAD file, 2019-04-03]
Engineering/2018-2019/Project Gimbal/Gimbal 3-27-2019/Injector EXP9A with holes for slide hammer mount.SLDPRT
139.6 x 46.4 x 139.6 mm
