Maeswoon/UNHSEDS/Engineering/2018-2019/Project Gimbal/Gimbal 3-30-2019/Injector EXP9A Gas Director.SLDPRT

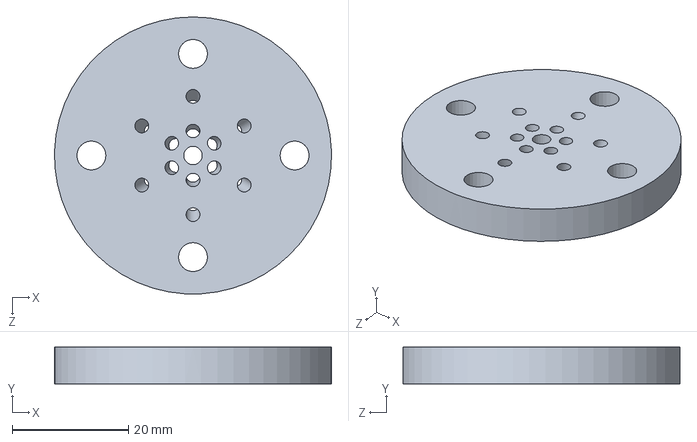
[picture p358: CAD file, 2019-04-03]
Engineering/2018-2019/Project Gimbal/Gimbal 3-30-2019/Injector EXP9A Gas Director.SLDPRT
47.6 x 6.35 x 47.6 mm
