Maeswoon/UNHSEDS/Engineering/2018-2019/Project Gimbal/Gimbal 32919/Combustion Chamber TST1.SLDPRT

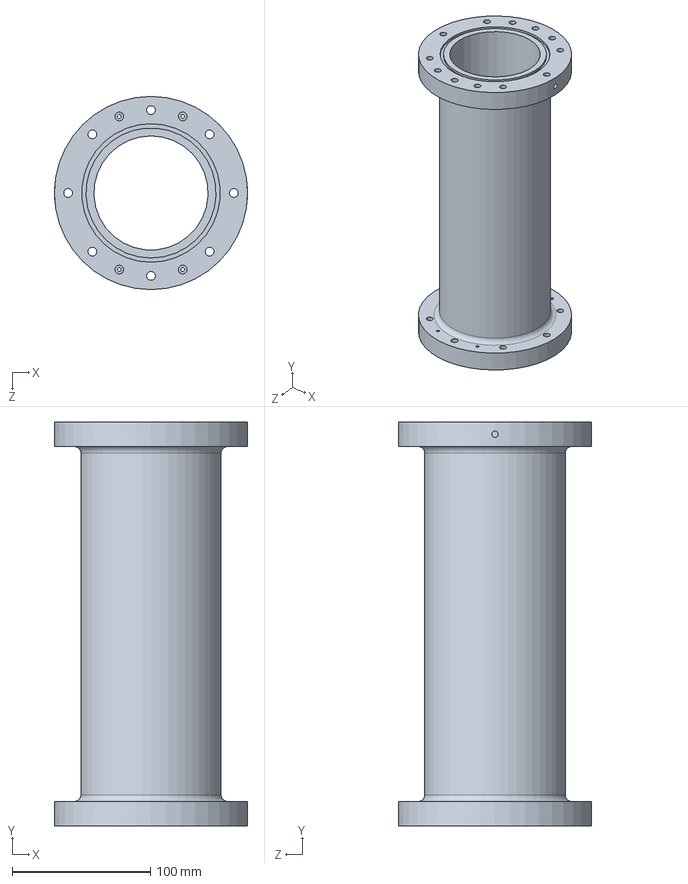
[picture p359: CAD file, 2019-04-03]
Engineering/2018-2019/Project Gimbal/Gimbal 32919/Combustion Chamber TST1.SLDPRT
139.7 x 292.1 x 139.7 mm
