Maeswoon/UNHSEDS/Engineering/2018-2019/Project Gimbal/Gimbal 4-10-2019/Nozzle.SLDPRT

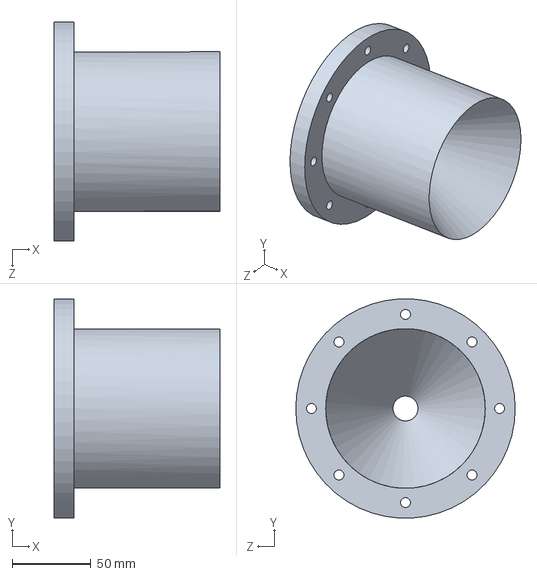
[picture p361: CAD file, 2019-04-03]
Engineering/2018-2019/Project Gimbal/Gimbal 4-10-2019/Nozzle.SLDPRT
105.4 x 139.4 x 139.7 mm
