Maeswoon/UNHSEDS/Engineering/2018-2019/Project Gimbal/Gimbal Master - 3-27-2019/Real actuator/p16_200mm_out.stp

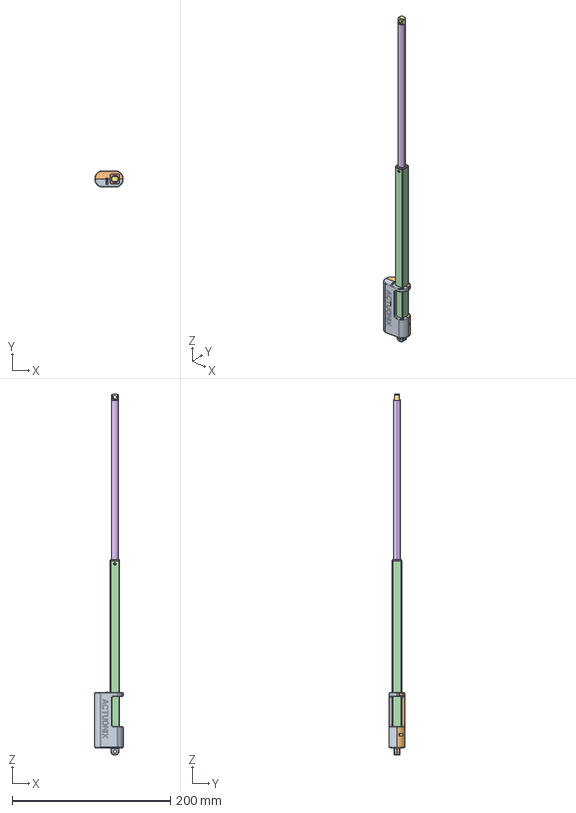
[picture p364: CAD file, 2019-02-26]
Engineering/2018-2019/Project Gimbal/Gimbal Master - 3-27-2019/Real actuator/p16_200mm_out.stp
36.0 x 20.0 x 455.9 mm
CLAM_P16_BOT_10541
CLAM_P16_TOP_10542
FASTENER_10427 x 5
EXTENSION_10578_200MM
GUIDE_10429
SHAFT_10688_200MM
PLUG_10428
GROMMET_3_HOLE
