Maeswoon/UNHSEDS/Engineering/2018-2019/Project Gimbal/Gimbal Master/Mounting Bracket.SLDPRT

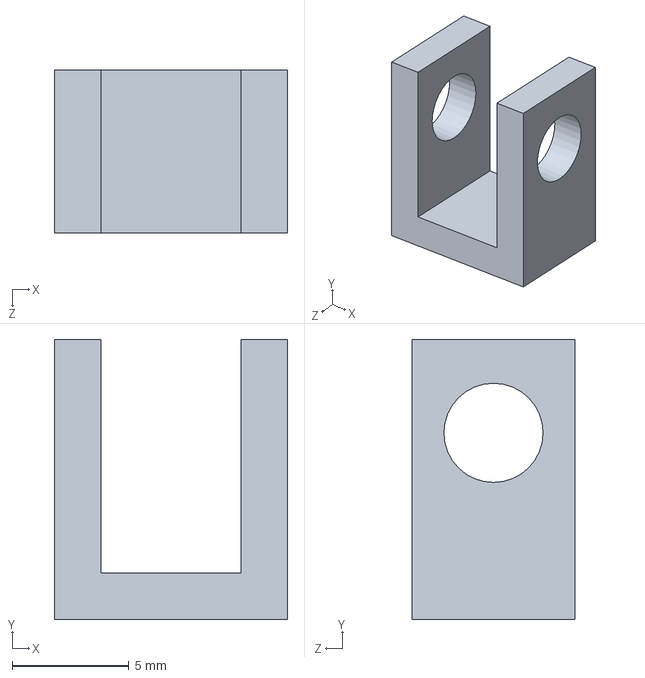
[picture p365: CAD file, 2019-04-03]
Engineering/2018-2019/Project Gimbal/Gimbal Master/Mounting Bracket.SLDPRT
10.0 x 12.0 x 7.00 mm
