Maeswoon/UNHSEDS/Engineering/2018-2019/Project Gimbal/Gimbal Master/Real actuator/p16_150mm_out.stp

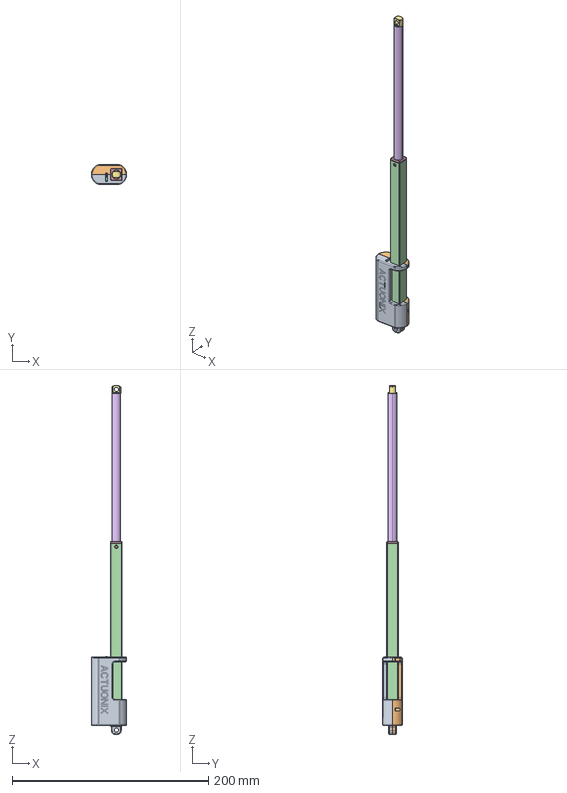
[picture p366: CAD file, 2019-02-26]
Engineering/2018-2019/Project Gimbal/Gimbal Master/Real actuator/p16_150mm_out.stp
36.0 x 20.0 x 355.9 mm
CLAM_P16_BOT_10541
CLAM_P16_TOP_10542
FASTENER_10427 x 5
EXTENSION_10577_150MM
GUIDE_10429
SHAFT_10687_150MM
PLUG_10428
GROMMET_3_HOLE
