Maeswoon/UNHSEDS/Engineering/2019-2020/Frame/SOLIDWORKS/Parts/Frame V2/No2 Tank Structure Parts/.143D rod.SLDPRT

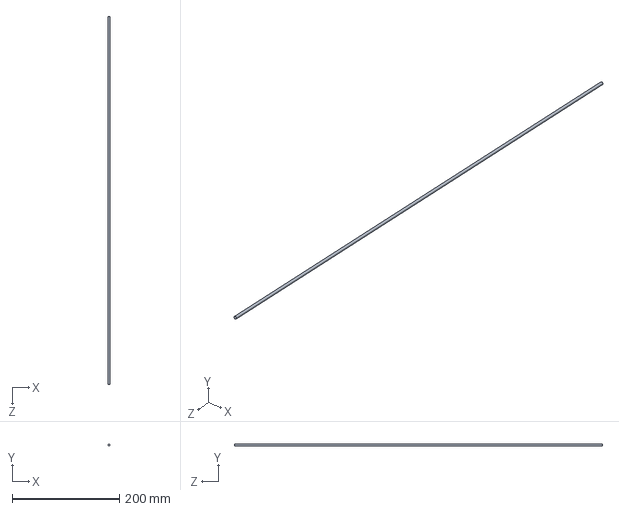
[picture p367: CAD file, 2019-10-02]
Engineering/2019-2020/Frame/SOLIDWORKS/Parts/Frame V2/No2 Tank Structure Parts/.143D rod.SLDPRT
3.63 x 3.63 x 685.8 mm
