Maeswoon/UNHSEDS/Engineering/2019-2020_USURPER/Avionics/Board Files/LED Small RED.SLDPRT

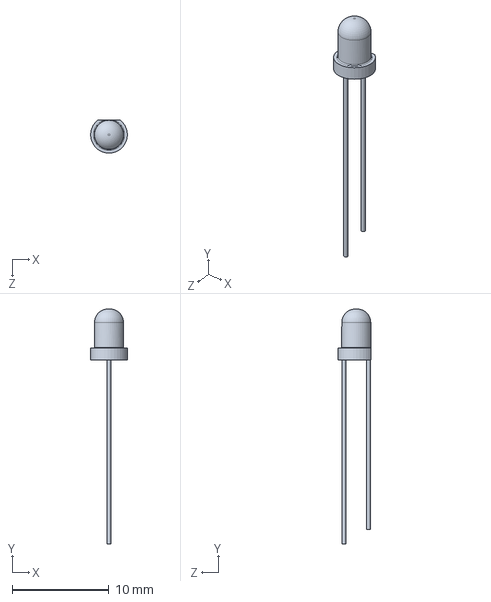
[picture p368: CAD file, 2020-03-05]
Engineering/2019-2020_USURPER/Avionics/Board Files/LED Small RED.SLDPRT
3.80 x 24.2 x 3.42 mm
