Maeswoon/UNHSEDS/Engineering/2019-2020_USURPER/Avionics/Launch Control Module/Top2.sldprt

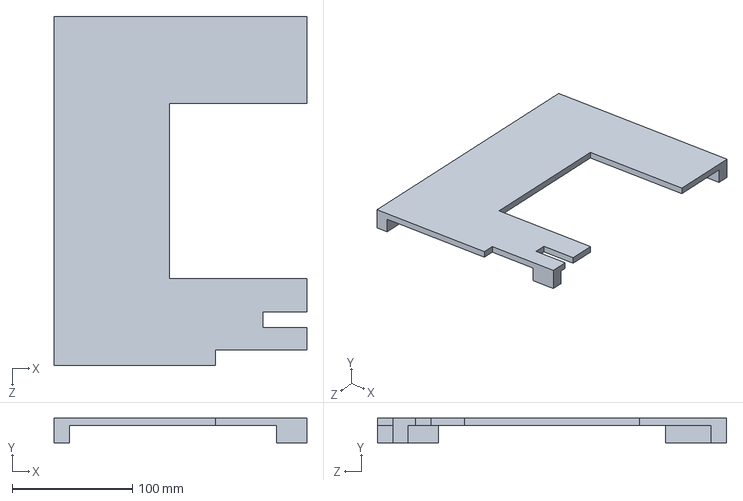
[picture p369: CAD file, 2019-12-05]
Engineering/2019-2020_USURPER/Avionics/Launch Control Module/Top2.sldprt
210.3 x 20.6 x 290.5 mm
