Maeswoon/UNHSEDS/Engineering/2019-2020_USURPER/Avionics/Recovery Bulkhead.SLDPRT

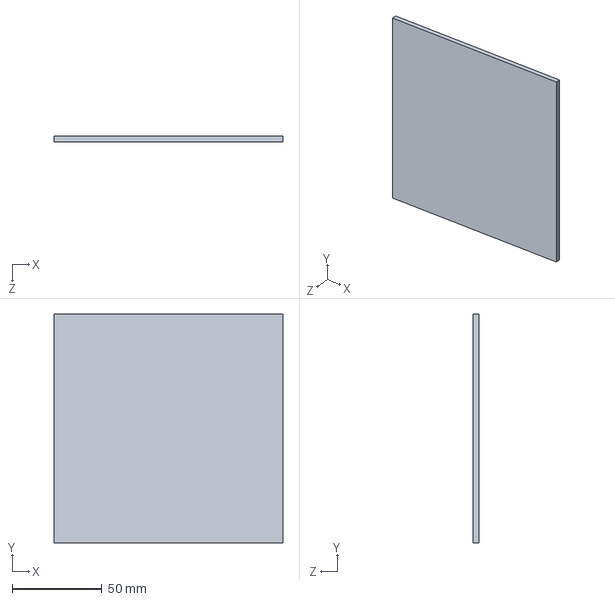
[picture p370: CAD file, 2020-02-04]
Engineering/2019-2020_USURPER/Avionics/Recovery Bulkhead.SLDPRT
127.8 x 127.8 x 3.17 mm
