Maeswoon/UNHSEDS/Engineering/2019-2020_USURPER/Frame/CATO_Hybrid Files/Frame/SOLIDWORKS/Parts/Frame V3/Tank Endcap Flanges.SLDPRT

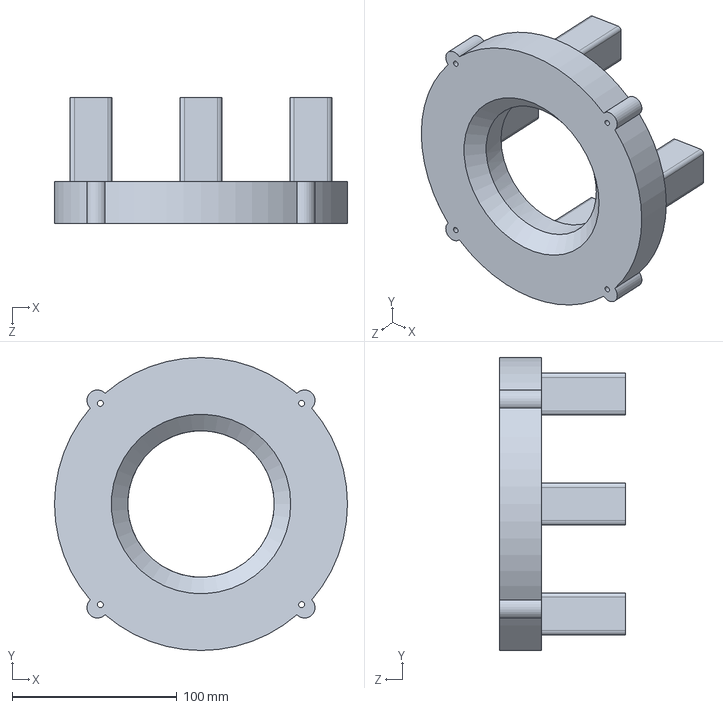
[picture p371: CAD file, 2019-11-21]
Engineering/2019-2020_USURPER/Frame/CATO_Hybrid Files/Frame/SOLIDWORKS/Parts/Frame V3/Tank Endcap Flanges.SLDPRT
177.8 x 177.8 x 76.2 mm
