Maeswoon/UNHSEDS/Engineering/2019-2020_USURPER/Frame/SOLIDWORKS/Parts/Frame V4/2.16.2020/2_56 Pin FEA.SLDPRT

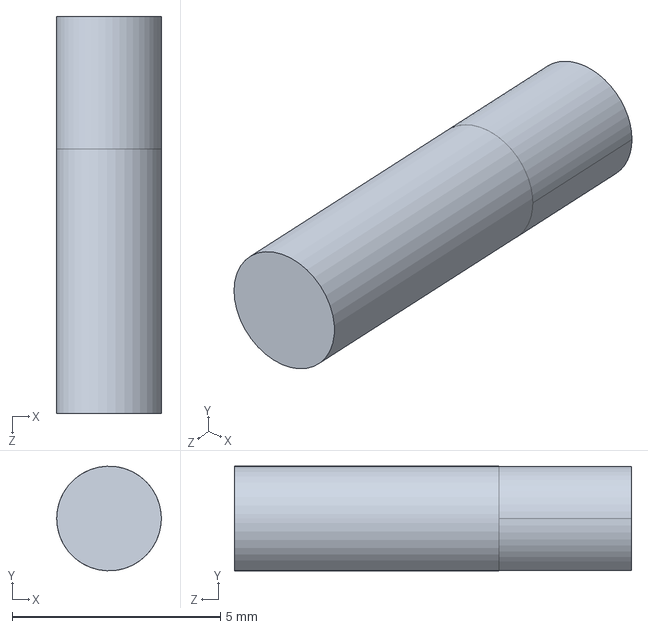
[picture p372: CAD file, 2020-02-18]
Engineering/2019-2020_USURPER/Frame/SOLIDWORKS/Parts/Frame V4/2.16.2020/2_56 Pin FEA.SLDPRT
2.51 x 2.51 x 9.53 mm
