Maeswoon/UNHSEDS/Engineering/2019-2020_USURPER/Frame/SOLIDWORKS/Parts/Frame V4/2.7.2020/Square Injection Plate Support.SLDPRT

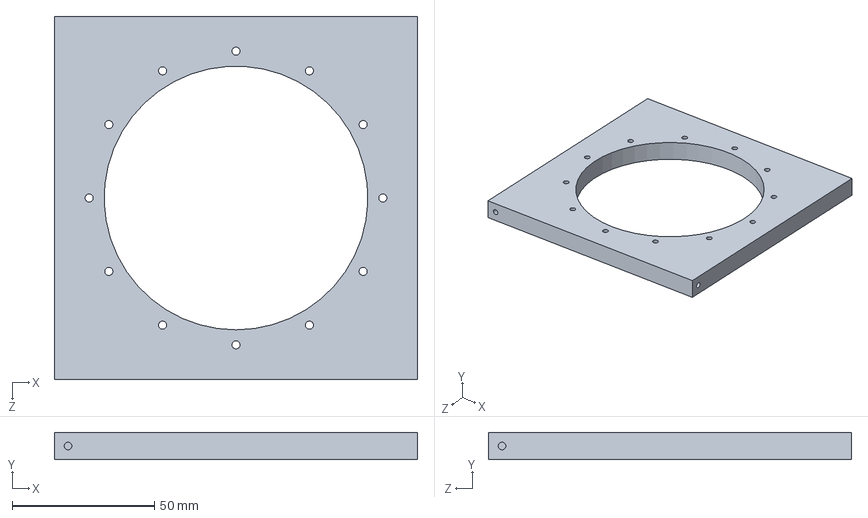
[picture p373: CAD file, 2020-02-21]
Engineering/2019-2020_USURPER/Frame/SOLIDWORKS/Parts/Frame V4/2.7.2020/Square Injection Plate Support.SLDPRT
127.6 x 9.53 x 127.6 mm
