Maeswoon/UNHSEDS/Engineering/2019-2020_USURPER/Frame/SOLIDWORKS/Parts/Frame V4/3.3.2020/Tapered base mold.SLDPRT

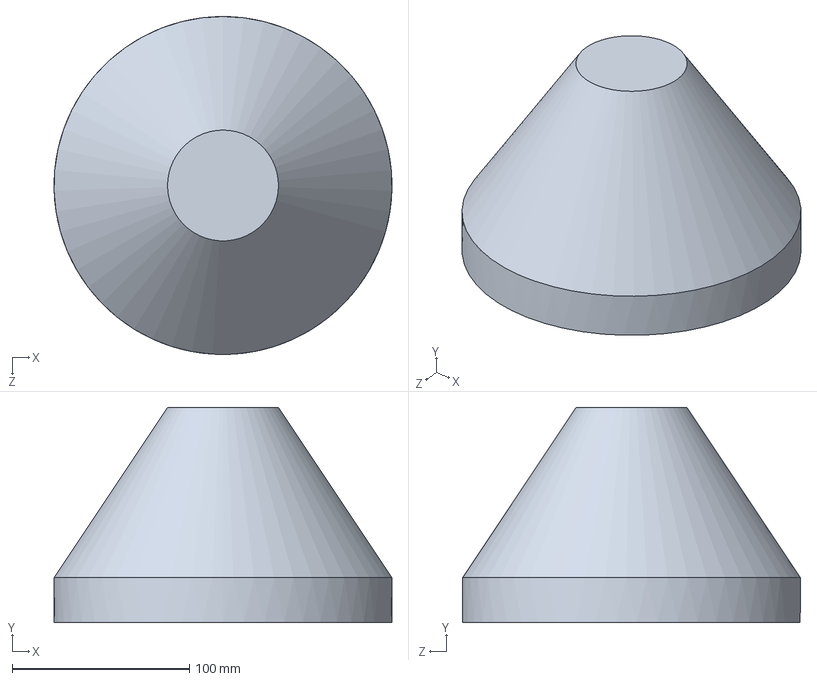
[picture p374: CAD file, 2020-11-16]
Engineering/2019-2020_USURPER/Frame/SOLIDWORKS/Parts/Frame V4/3.3.2020/Tapered base mold.SLDPRT
190.8 x 121.6 x 190.9 mm
