Maeswoon/UNHSEDS/Engineering/2019-2020_USURPER/Frame/SOLIDWORKS/Parts/Misc Parts/RaptorMockup.SLDPRT

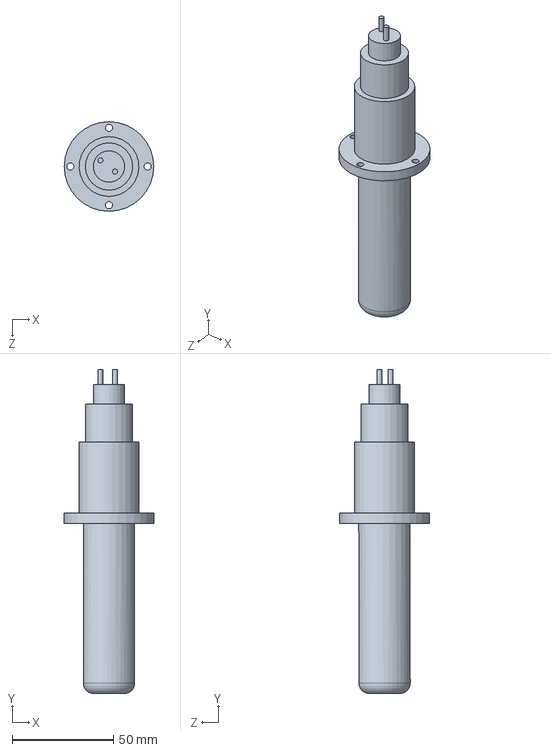
[picture p375: CAD file, 2020-11-24]
Engineering/2019-2020_USURPER/Frame/SOLIDWORKS/Parts/Misc Parts/RaptorMockup.SLDPRT
44.2 x 159.8 x 44.2 mm
