Maeswoon/UNHSEDS/Engineering/2022-2023 Rocket/Frame/Current Assembly/RocketAssembly.SLDASM

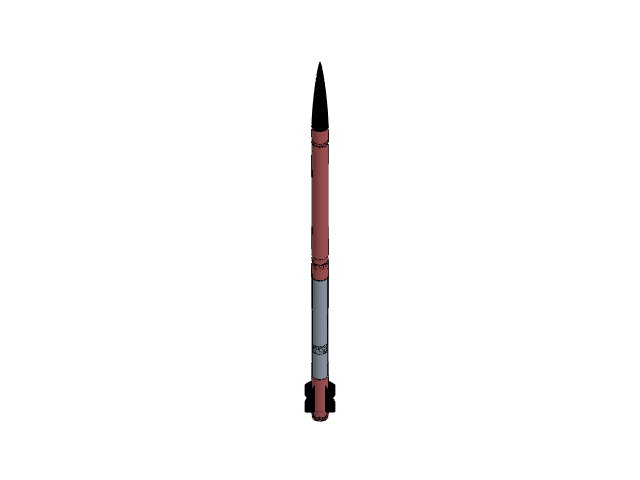
[picture p376: CAD file, 2024-04-02]
Engineering/2022-2023 Rocket/Frame/Current Assembly/RocketAssembly.SLDASM
UpperBodyTube
Casing
Bulkhead
ForwardClosure
GrainInsulation
FuelGrain
Nozzle
NozzleCarrier
ChambersafeEnd
MixingPlate
ChambersafeFore
Von_Karman_Nose_Cone
Fin_Can
Tail_Cone
Fin x 4
RecoveryPlate
RaptorMockup x 2
TenderDescenderMount
2936T480_GALV STL MCMASTER 3_8ths U-BOLT (1) (1)
