Maeswoon/UNHSEDS/(list of files, cad)

Other CAD files:
Engineering/2020-2021_PHANTOM/Frame/Cornelis Frame V1/Frame Recovery.SLDASM
Engineering/2020-2021_PHANTOM/Frame/Active Frame V2/Frame Recovery.SLDASM
Engineering/2019-2020_USURPER/Frame/SOLIDWORKS/Parts/Misc Parts/Fin stuff/Fin.DWG
Archive/Engineering/2017-2018/2017-2018 Projects/Launch Pad/LAUNCHPADDRAFT1.SLDASM
Archive/Engineering/2017-2018/2017-2018 Projects/Launch Pad/Part1.SLDPRT
Archive/Engineering/2017-2018/2017-2018 Projects/Launch Pad/SIDEPANELS.SLDPRT
Archive/Engineering/2017-2018/2017-2018 Projects/Launch Pad/SIDEPANELS2.SLDPRT
Archive/Engineering/2017-2018/2017-2018 Projects/Launch Pad/TOPPLATE.SLDPRT
Archive/Engineering/2017-2018/2017-2018 Projects/Launch Pad/launch rod.SLDPRT
Archive/Engineering/2017-2018/2017-2018 Projects/Launch Pad/legs.SLDPRT
Archive/Engineering/2017-2018/2017-2018 Projects/SEDS USA Competition/Rocket Aero Team/SW/Basic Rocket Model/Fins.SLDPRT
Archive/Engineering/2017-2018/2017-2018 Projects/SEDS USA Competition/Rocket Aero Team/SW/Basic Rocket Model/Fuselage.SLDPRT
Archive/Engineering/2017-2018/2017-2018 Projects/SEDS USA Competition/Rocket Aero Team/SW/Basic Rocket Model/NoseCone.SLDPRT
Archive/Engineering/2017-2018/2017-2018 Projects/SEDS USA Competition/Rocket Aero Team/SW/Basic Rocket Model/Rocket.SLDASM
Archive/Engineering/2017-2018/2017-2018 Projects/SEDS USA Competition/Rocket Aero Team/SW/Buckling Sim/bucklingSim.SLDPRT
Archive/Engineering/2017-2018/2017-2018 Projects/SEDS USA Competition/Rocket Aero Team/SW/Conical Mk1/ConicalMk1.SLDASM
Archive/Engineering/2017-2018/2017-2018 Projects/SEDS USA Competition/Rocket Aero Team/SW/Conical Mk1/Fins (1).SLDPRT
Archive/Engineering/2017-2018/2017-2018 Projects/SEDS USA Competition/Rocket Aero Team/SW/Conical Mk1/FuselageCF.SLDPRT
Archive/Engineering/2017-2018/2017-2018 Projects/SEDS USA Competition/Rocket Aero Team/SW/Conical Mk1/NoseConeCF.SLDPRT
Archive/Engineering/2017-2018/2017-2018 Projects/SEDS USA Competition/Rocket Aero Team/SW/Fluid Sim/Fins (1).SLDPRT
Archive/Engineering/2017-2018/2017-2018 Projects/SEDS USA Competition/Rocket Aero Team/SW/Fluid Sim/FluidSim.SLDASM
Archive/Engineering/2017-2018/2017-2018 Projects/SEDS USA Competition/Rocket Aero Team/SW/Fluid Sim/FuselageCF.SLDPRT
Archive/Engineering/2017-2018/2017-2018 Projects/SEDS USA Competition/Rocket Aero Team/SW/Fluid Sim/fluidNoseCone.SLDPRT
Archive/Engineering/2017-2018/2017-2018 Projects/SEDS USA Competition/Rocket Engine Team/motor casing 1.SLDPRT
Archive/Engineering/2017-2018/2017-2018 Projects/SEDS USA Competition/Solidworks Rocket/29mmEngineTube.SLDPRT
Archive/Engineering/2017-2018/2017-2018 Projects/SEDS USA Competition/Solidworks Rocket/BodyTube.SLDPRT
Archive/Engineering/2017-2018/2017-2018 Projects/SEDS USA Competition/Solidworks Rocket/BoosterFin.SLDPRT
Archive/Engineering/2017-2018/2017-2018 Projects/SEDS USA Competition/Solidworks Rocket/BoosterStageAssem.SLDASM
Archive/Engineering/2017-2018/2017-2018 Projects/SEDS USA Competition/Solidworks Rocket/CenteringRing.SLDPRT
Archive/Engineering/2017-2018/2017-2018 Projects/SEDS USA Competition/Solidworks Rocket/ConicalNoseCone.SLDPRT
Archive/Engineering/2017-2018/2017-2018 Projects/SEDS USA Competition/Solidworks Rocket/Coupler.SLDPRT
Archive/Engineering/2017-2018/2017-2018 Projects/SEDS USA Competition/Solidworks Rocket/CouplerAssem.SLDASM
Archive/Engineering/2017-2018/2017-2018 Projects/SEDS USA Competition/Solidworks Rocket/CouplerBodyTube.SLDPRT
Archive/Engineering/2017-2018/2017-2018 Projects/SEDS USA Competition/Solidworks Rocket/E-Bay.SLDASM
Archive/Engineering/2017-2018/2017-2018 Projects/SEDS USA Competition/Solidworks Rocket/ForwardBodyTube.SLDPRT
Archive/Engineering/2017-2018/2017-2018 Projects/SEDS USA Competition/Solidworks Rocket/FullAssembly.SLDASM
Archive/Engineering/2017-2018/2017-2018 Projects/SEDS USA Competition/Solidworks Rocket/LargeCouplerBulkPlate.SLDPRT
Archive/Engineering/2017-2018/2017-2018 Projects/SEDS USA Competition/Solidworks Rocket/SmallCouplerBulkPlate.SLDPRT
Archive/Engineering/2017-2018/2017-2018 Projects/SEDS USA Competition/Solidworks Rocket/SustainerAssembly.SLDASM
Archive/Engineering/2017-2018/2017-2018 Projects/SEDS USA Competition/Solidworks Rocket/SustainerBodyTube.SLDPRT
Archive/Engineering/2017-2018/2017-2018 Projects/SEDS USA Competition/Solidworks Rocket/SustainerCouplerOpenEnd.SLDASM
Archive/Engineering/2017-2018/Electrical/electronics/DansShit3.DXF
Archive/Engineering/2017-2018/Electrical/electronics/Engine Casing.SLDPRT
Archive/Engineering/2017-2018/Electrical/electronics/Gimble Chassis.SLDPRT
Archive/Engineering/2017-2018/Electrical/electronics/Gimble Chassisv2.SLDPRT
Archive/Engineering/2017-2018/Electrical/electronics/Gimble assm (2).SLDASM
Archive/Engineering/2017-2018/Electrical/electronics/Gimble assm.SLDASM
Archive/Engineering/2017-2018/Electrical/electronics/casing mount Gimble.SLDDRW
Archive/Engineering/2017-2018/Electrical/electronics/casing mount Gimble.SLDPRT
Archive/Engineering/2017-2018/Electrical/electronics/y ring gimble.SLDPRT
Archive/Engineering/2017-2018/ME Senior Deliverables/ME 756 Final Report/Booster Fins.SLDDRW
Archive/Engineering/2017-2018/ME Senior Deliverables/ME 756 Final Report/Sustainer_Fins.SLDDRW
Archive/Engineering/2017-2018/ME Senior Deliverables/ME 756 Final Report/VonKarmanNoseCone.SLDDRW
Archive/Engineering/2017-2018/Manufacturing/Conical Mk1/Fins.SLDDRW
Archive/Engineering/2017-2018/Manufacturing/Conical Mk1/Fins.SLDPRT
Archive/Engineering/2017-2018/Manufacturing/Conical Mk1/FuselageCF.SLDDRW
Archive/Engineering/2017-2018/Manufacturing/Conical Mk1/FuselageCF.SLDPRT
Archive/Engineering/2017-2018/Manufacturing/Conical Mk1/FuselageForm.SLDDRW
Archive/Engineering/2017-2018/Manufacturing/Conical Mk1/FuselageForm.SLDPRT
Archive/Engineering/2017-2018/Manufacturing/Conical Mk1/NoseConeCF.SLDPRT
Archive/Engineering/2017-2018/Manufacturing/Conical Mk1/NoseconeForm.SLDDRW
Archive/Engineering/2017-2018/Manufacturing/Conical Mk1/NoseconeForm.SLDPRT
Archive/Engineering/2017-2018/Manufacturing/FinAligner3_30_18.DXF
Archive/Engineering/2017-2018/Manufacturing/Launch Circuit Housing/Launch circuit housing Assem.SLDPRT.SLDASM
Archive/Engineering/2017-2018/Manufacturing/Launch Circuit Housing/Launch circuit housing shell.SLDPRT
Archive/Engineering/2017-2018/Manufacturing/Launch Circuit Housing/Launch circuit housing shell.STL
Archive/Engineering/2017-2018/Manufacturing/Launch Circuit Housing/Launch circuit housing top plate.SLDPRT
Archive/Engineering/2017-2018/Manufacturing/Launch Circuit Housing/Launch circuit housing top plate.STL
Archive/Engineering/2017-2018/Manufacturing/Launch circuit housing Assem.SLDPRT.SLDASM
Archive/Engineering/2017-2018/Manufacturing/Launch circuit housing shell.SLDPRT
Archive/Engineering/2017-2018/Manufacturing/Launch circuit housing top plate.SLDPRT
Archive/Engineering/2017-2018/Manufacturing/fin aligner.DXF
Archive/Engineering/2017-2018/Manufacturing/fin aligner.SLDPRT
Archive/Engineering/2017-2018/Manufacturing/fin alignerAETHER4v2.DXF
Archive/Engineering/2017-2018/Manufacturing/fin alignerAETHER4v2.SLDPRT
Archive/Engineering/2017-2018/Manufacturing/leg adapter.DXF
Archive/Engineering/2017-2018/Solidworks/Aether4Solidworks/Booster Fins.DXF
Archive/Engineering/2017-2018/Solidworks/Aether4Solidworks/Booster Fins.SLDPRT
Archive/Engineering/2017-2018/Solidworks/Aether4Solidworks/BulkPLATECoupler.DXF
Archive/Engineering/2017-2018/Solidworks/Aether4Solidworks/BulkPLATECoupler.SLDPRT
Archive/Engineering/2017-2018/Solidworks/Aether4Solidworks/CouplerInnerRing.DXF
Archive/Engineering/2017-2018/Solidworks/Aether4Solidworks/CouplerInnerRing.SLDPRT
Archive/Engineering/2017-2018/Solidworks/Aether4Solidworks/CouplerOuterRing.DXF
Archive/Engineering/2017-2018/Solidworks/Aether4Solidworks/CouplerOuterRing.SLDPRT
Archive/Engineering/2017-2018/Solidworks/Aether4Solidworks/EngineCenteringRings.DXF
Archive/Engineering/2017-2018/Solidworks/Aether4Solidworks/EngineCenteringRings.SLDPRT
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
