Maeswoon/UNHSEDS/Business/Organization/Book Club/Rocket Manual for Amateurs.docx

Forward:

1. After Sputnik, there was an influx in youngsters wanting to build rockets, for the first year it seemed almost every single one of them was inspired and pushed to pursue space exploration
2. Safety manuals were released to help students experiment safely, but accidents happened, even fatal ones.
3. People tried to ban it saying it is unsafe, and that amateurs will never discover something the professionals couldn’t
  a. Things are unsafe, but accidents happen due to carelessness and uneducated attempts
  b. A medical student dissects a hand for a final exam at a top medical school… could tell him that he would not learn anything that could not be found in texts. He is doing it physically as some thing must be learned by physically doing something, lifting out blood vessels and muscles to find something new for others
  c. If the first generation of rocket scientists began as amateurs, what do they expect the next generation of rocket engineers to do? Learn to draw parts without any knowledge on what they do, where they fit, and why they exist?

Chapter 1

1. Why do you want to experiment with rockets?
  a. It shouldn’t be for the fire… that is looking for a hobby. It should be about the power of the industry, what it can do for humanity as a steppingstone.
2. What do you hope to achieve by it?
  a. It shouldn’t be to get entertained, etc. It is about gaining the knowledge and experience to expand your work into more powerful rockets capable of more to humanity.
3. Are you willing to make the sacrifices and take the elaborate precautions necessary?
  a. If not, then go somewhere else, cause this shit can hurt and kill people.
4. The major aspects of amateur rocketry
  a. Organization
  b. Safety
  c. Scientific Method
5. Organization
  a. This is a group effort, not just for one or two people.
  b. Most productive comes from smaller (5-15) people that are WELL organized.
  c. A group needs financial backing... things can be expensive and to do what you want you need to be able to purchase the appropriate hardware.
  d. Groups can fill up with ‘too many cooks’ that can weigh down a group… bottom third, must be handled well
    i. Avoid people with the tendency to always argue about things that are small, or someone who is always unhappy with how things are run and reject all cultural change from the current leadership.
  e. Consists of ‘7-8 bright young men’ lol sexist, it was the 60’s from a military officer
  f. Wide range of the basic sciences… i.e. many majors and years with a large network of knowledge
  g. Should have a common pursuit to expand their knowledge in the subject with the contribution of their experience.
    i. Mechanical, electrical, pure science, radio etc
  h. As a group grows, there should be leads in each particular side of the rocket project to lead the people under, helps disperse knowledge and pull from the rest of the team in experience and time
  i. A technical advisor is important, tag-up with professors and other experts constantly to check in on designs
  j. The importance of a constitution
    i. Keeps everyone with a good understanding of how the organization is run
    ii. Helps with future intense conversations on leadership changes
    iii. Aligns the mission of the club and transfers to each members of the club
  k. Any notes on the constitution he attached into his book?
  l. Safety code? UNH SEDS should make a safety code with the election of the next safety advisors
  m. Sponsorship is very important to any agency, allows you to buy the equipment needed
  n. Rocket make news, and rocket enthusiasts hit the papers easily.
  o. Nearly every person is impressed by young people who show initiative and the enterprise that is not expected of them… an impressive rocket program is a sweet spot of becoming huge and important and known quick
  p. Must show a community what you are capable of, and the publicity to come from that will bring waves over the next year, allowing the next accomplishment.
    i. We haven’t had a big win yet that caused this… but its coming
  q. Make friends with the reporters in the area… they need to be pulled and told about the progression of the club so they want to stay involved and writing when something bigger comes up
  r. People can be impressed when students talk about a subject that is over their head, makes them want to contribute as they want to be a part of greatness and enabling future leaders in something that sparks everyone mind when young.
    i. FOLLOW-UP IMMEDIETLY
  s. Get to know the city officials, they will help you make moves for things that require city or official attention such as high impact tests
  t. People aren’t interested in supporting a fireworks team, but they WILL be interested if your work is leading to something greater then yourself, or just that year. Not a fad
  u. Don’t bother people for technical advice with a whim. Schedule formal recurrent meeting to ask about flushed out ideas/problems. Need to maintain a good relationship to continue to use their support
  v. A somewhat simple idea can turn into a pipe dream just a week later of thought.. happens all the time
6. Safety
  a. We weren’t at the moon when this book was written…
  b. You don’t want to lose an appendage… safety critical
  c. Must be a primary thing that every member practices and thinks about constantly
  d. A rocket propellant can be an explosive real quick…
  e. Not really a difference between a rocket and a bomb… the only difference is that there is a hole
  f. A rocket flies fast enough to kill
  g. Most accidents happen when people are doing something they did a thousand times and became to used to the action that they skip steps and draw blanks and don’t notice
  h. Establish a by the number procedure, follow checklists when you can when you are doing something over and over
  i. Personal and group safety practices
    i. Safety rules are for you
    ii. Research before building… its experimental, do your due diligence
    iii. Never work alone
    iv. Don’t hide activities
    v. get an adult supervisor
    vi. safety lies in orderliness and neatness
    vii. be prepped for emergencies
    viii. listen to advice always
    ix. organize work before starting
    x. consider the safety of others
    xi. prepare for the worst, always
7. Safety thru scientific procedure
  a. Adopting a scientific procedure to your projects also helps with safety… makes it more intelligent collectively
  b. Plan a good working procedure that makes sense for your project
    i. Research
    ii. Experimental design
    iii. Preliminary design
    iv. Building your full-scale mockup
    v. Test models and working scale models
    vi. Final design
    vii. Prototype construction
  c. Doing the above proves that you have developed a rocket, not just built one.
  d. Once you get to hotfire test and launches, must see the law. Work with the city.
  e. There are rules now for launching, but hotfires are really with your city and communicating with them
  f. Never take a chance with the law

Chapter 2 – Basic Rocket Design

1. The rocket motor, although very modern looking, is the oldest motor known to man
  a. Seven centuries
2. It been in the 30s and 40s that man started to put it to practical use
  a. The tech and materials needed to actually put it to use only came in the last 7 decades, which is why it began to be developed for more practical use as we evolved as human
3. Great discoveries are often not utilized until long after the discovery (centuries) as it needs other technologies to be developed for the proper use of the discovery useful to humans
  a. The steam engine took 200 years to be used from the mind of newton when Welsh though to use the new steam beams as the rail that tit could ride on
  b. Needed cylinder and pistons to be made to handle the internal pressure of the engine too!
4. Rocket prop is on newtons third law
  a. Every action there is an equal and opposite reaction produced.
  b. If you lift someone that weight 200 lbs one foot above the ground, you are exerting 200 foot lbs on the earth. Earth should move, but is so heavy it isn’t measurable
  c. Firing a gun
  d. Throwing something heavy on an ice rink
5. Rocket engine, hot gases are produced by means of rapidly burning some chemical substance called a propellant
  a. No two props will burn efficiently by itself, but together they produce a lot of hot gases used for newtons third law
6. The gases produce a pressure inside the chamber that is used as the driving force of forcing the gases out of the engine in the direction that is wanted
7. Part of an engine
  a. Injector (if liquid)
  b. Combustion chamber
  c. Nozzle (escape port)
8. Other main parts of a rocket are:
  a. The nose cone
  b. The fins
9. Achieves forward motion by expelling the gases in one direction to accelerate the rocket in the other direction
  a. Must not burn so fast to cause an explosion but enough to have a stable combustion for acceleration
  b. The hot gases don’t physically hit anything, it is just their apparent velocity and their mass that cause the change in momentum following newtons laws
10. Talk about page 43
11. The chamber cannot over pressurize
  a. A matter of engineering design of the engine
  b. Burning temperature
  c. Burning rate
  d. Size of chamber
  e. Composition and thickness of chamber wall
  f. Diameter of throat
  g. Length of nozzle
12. Solids can burn unevenly if not prepped right
  a. Causes variation in thrust and nozzle output direction, bad flight trajectory
13. It is advisable that amateur rockets:
  a. Be overbuilt to FOS
  b. Be tested with ultimate safety achieved
14. They are free flight rockets, meaning it can go in any direction and should be assume it will go horizontal immediately
15. Rule of thumb nozzle designs, diameter to diameter, common for solids and especially ones that burn very quickly
  a. Attach them with machine screws with oring
  b. Can thread! Just got to be careful for preop prep etc
  c. Nozzle must be aligned with the center line of the rocket to ensure straight flight
  d. Must be a strong, corrosion resistant material
16. The rocket body must be strong and temp resistant!
  a. Bulkhead is for solid, injector acts as the top of a rocket engine that uses a oxidizer liquid
  b. Can be brazed instead of using oring
17. Nose cone balances the rocket and cuts into the flow path of the rocket
  a. Different designs can be used to better traverse the atmospheric air
  b. Should be tight into the rocket, no wobble!
  c. CG must be forward of the CP, forward of fin surface for sure, CP can now be calculated
18. Fins give stability to a rocket when you need to move the CP back more to get behind CG. More aero surface that adds pressure vectors on the under side of the rocket
  a. Three is common, gives all modes of movement
  b. Aluminum is common, machine screws
  c. Design can be made perfect now with computes lol
  d. Always good to go larger then cut fins smaller
19. Diaphragm and igniter
  a. Diaphragm is like a burst cap, hold pressure to support ignition and startup to get fast initial speed
  b. Should be fired from a distance away
20. Much more is learned from failure then success. Foster that feeling to pursue success, we all need it sometime to verify we are going in the right direction
  a. Causes of failure can usually be determined by a good test procedure and analysis after. Cherish that experience and LEARN from it

Chapter 3 – Rocket Propellants

1. Fuel is propellant
  a. There is a fuel (reducer)
  b. And an oxidizer
  c. Both must be present to support desired combustion
2. Old school fuel ox is JPL-4 (high kero) and fuming nitric acid
3. Liquids and solids
  a. Lol to saying that these are just the beginning, will invent better methods for getting off earth
4. Some auto combust, some need help
5. Mono prop is one liquid that pumps into the chamber and combusts with the help of ignition
  a. Minimizes the amount of plumbing and tanks
6. Single base and double base for solid
  a. Just has to deal with chemistry composition, not too important
7. Liquids
  a. Liquid has an oxidizing agent, and a fuel from the hydrocarbon family
    i. Easily oxidizble for combustion
  b. The specific impulse details the ability of a prop combination to produce thrust and it is expressed in seconds
    i. The higher, the more efficient the fuel is to produce thrust
    ii. Specific thrust sometimes is used for liquids to also factor in the amount of propellant getting pumped into the chamber
  c. Dangerous
  d. Expensive compared to solids
  e. Advantages
    i. High energy yield
    ii. Available chemicals
    iii. Combustion temp lower and less combustion pressure, helping with weight of motor
    iv. Fuel flow can be controlled
    v. Not really affected from changes in temp pressure humidity
  f. Disadvantages
    i. Elaborate plumbing
    ii. Dangerous
    iii. Toxic
    iv. Moving is hard, and fueling can be tricky
    v. Low density creates a bulk displacement
  g. Combustion performance
    i. Fed into motor under pressure
    ii. Nitrogen and/or a solid pump used to increase pressure from storage tanks to motor
    iii. Will learn more in the motor systems chapter
    iv. Mono prop is the same methods
    v. Ignition timing very important!
    vi. Entered into the chamber in helical pattern to help cool as well before combusting all of it
    vii. Shock waves are very important, must design dampers to deal with this
    viii. When temp and pressure builds, thrust is strong enough to lift the system
    ix. How much thrust produced is tons of factors
      1. Injector, chamber, propellant, nozzle design
    x. Goal to accelerate the particles as fast as possible out of the nozzle
    xi. The higher the temp in chamber, and lower molec weight (gaseous) the faster the particles will be moving
    xii. Not possible in 60’s to model what will actually happen
      1. Possible now to do this, but stil cant model completely what actually will happen
      2. Especially shock waves and best way to dampen
    xiii. The molec weight of the exhaust products is what is important
      1. Relationship lies with flame temp, molec weight and specific impulse exists
    xiv. Specific impulse with more fundamental constant is on page 62
    xv. Another way is from measuring average exhaust velocity and normalizing to gravity
    xvi. Thrust is produced from the chamber to the nozzle exit, NOT AT THE NOZZLE EXIT
    xvii. Goal is to allow the gas to dissipate as fast as possible to atmospheric pressure
      1. Would create a back pressure if it doesn’t do this fast that would slow the rocket down
    xviii. it’s the difference of zero speed in chamber to a high speed which creates thrust. The change is what matters!!!
    xix. Impulse is the measurement of the speed with which a given velocity is reached
    xx. No such things as a safe oxidizer, all are bad for humans
    xxi. Some oxidizers boil at very low temps, they need to be kept at near vacuum and a relatively low temp to keep it from boiling off. That’s why rocket vent to maintain most liquid and continuously vent off the liquid to gas products to fill with more liquid
    xxii. A bunch of info on certain oxidizers used
  h. Solids
    i. Lower ratings of specific impulse but easier and better well kept, etc.
    ii. Don’t experiment here.. use what is known and only if you have the facilities to do it
    iii. Advantages
      1. Low toxic
      2. High density which saves space and weight in rocket airframe
      3. Ease of handling
      4. Lower cost
      5. Easier to ignite cause one spark can set it off, technically
    iv. Disadvantages
      1. Lower performance
      2. Can decompose over time
        a. Liquids don’t really if stored well
      3. Cracking can occur when making, which can cause burst of combustion, hard to predict and design for
    v. Danger and Hazards
      1. Can blow up in your face
      2. Powder form solids can be violent… must be aware and carefully handle
      3. Some combust spontaneously when exposed to air…. Never use that shit
    vi. Propellant grain shapes and methods of forming
      1. Cast or molded same size of combustion chamber
      2. Molded into or onto an insert that then gets put into the chamber
    vii. Restrict burning on certain sections of grains
    viii. Burning rate
      1. Chamber pressure affects the burn rate
      2. Determined empirically from tests after test
      3. Burns perpendicular to the surface
      4. Many different grain types, each with a different thrust curve that will be produced
      5. Inch per second
      6. The larger the burning surface, the faster the burning rate will be
        a. because more heat and larger pressures produced
      7. Burning time is simple, linear inch / second compared to how many total linear inches it has
    ix. Always take what has done before as rule of thumb, but when safe, experiment for yourself if you want to learn more in depth on why
    x. Classic propellant is potassium nitrate and sugar!
    xi. Zinc and sulfur are also used and can produce rocket that go up high enough for basically any rocketeer
    xii. Density of packing can greatly change the burning rate of a powder grain
    xiii. Purity, particle size, density, amount of air present, conductivity of the chamber walls
    xiv. He used zinc and sulfur as a guide to prepare a mixture for an engine, with all the calculation, etc
    xv. Talks about loading propellant into the chamber for casting
    xvi. Funnel, any end, mold
    xvii. Igniter should be inserted on the stand as solid are easy to ignite
    xviii. Safety
      1. Read this, but a lot of it is common sense!

Chapter 4 – Rocket Motor Systems

1. Principals of Propulsion
  a. Rule of thumb calculation argument… good sometimes but bad practice in advanced topics for sure
  b. Propulsive force is from the rapid expansion of the gases which is produced with the propellant burning
  c. More efficient in space is there is no push back, it actually makes it worst to a rocket engine and performance of a rocket
  d. Every action there is an equal and opposite reaction
  e. The 1atm is hitting the propellant pressure, back pressure slowing it down
  f. Referred to as ambient pressure
  g. Objective of a good motor design
    i. Burn for maximum amount of gases and highest pressure
    ii. Enable them to flow out opposite of desired direction of motion and with least obstruction
  h. The speed of which a gas get to max velocity is what is important
  i. Nozzle converging and diverging sections
    i. De Laval, as tube decreases, gets faster, and reached min diameter at the throat
    ii. Increase speed as they reach the sonic velocity
    iii. Hose analogy
    iv. Diverging gives opportunity for the gas to expand rapidly and get to atmospheric pressure so no back pressure is created
    v. It gains speed from this diverging because it is expanding a the same time, and designed right gets to max speed at the end of the nozzle
    vi. Be built of the right material to handle stress and heat and corrosion
    vii. Maximize kinetic energy must be obtained
    viii. Allow gases to expand and reach atmosphere at the end of the nozzle
2. Rocket Design for Amateurs
  a. Pressure is a function of flame temp and burning rate of propellant which is a result of the burning surface getting burnt
  b. Burning surface is from the design of the grain and the chamber
  c. Figure on 106 is good to talk about
  d. Rule of thumb for nozzle dimensions of around 1/3 nozzle throat D to ID
  e. 30 degrees converging and 15 degree diverging
  f. Cross sectional area of nozzle exit should be 7-8 times bigger then the nozzle throat
  g. With rule of thumb, nozzle exit wll always be slightly smaller then the combustion chamber ID
3. More Advanced Rocket Trust Chamber Calcs
  a. Determined from the propellant used
  b. You get a k, ratio of specific heats, and R, the gas constant.
  c. Hard to calc, got to take the research word for it from tables!
  d. At the throat, the velocity is M=1 when designed correctly
  e. Will expand and increase to super sonic after the throat during gas expansion rapid
  f. Goes thru all the equations on nozzle stuff pages 111-118
4. Features of Liquid Motor Systems
  a. Drawing page 123
  b. Regen cooling to cool walls rapidly, helps with mass and also increases temp of propellant to support combustion
  c. Different thrust control features for mag and direction with gimbal, aux jets, deflectors
5. Other systems
  a. Nuclear power
  b. Ion
  c. Direct particle accelerator

More Advanced Rocket Design

1. The purpose of a rocket defines the process of design
  a. Types of design specifications
2. Exhaust velocity determines how fast the rocket can get!
3. Methods of manufacturing nozzles
  a. Easiest to hardest but reducing weight
  b. Can cast if you are making a bunch!
  c. Machining usual as they are usually one offs for improving design over time
  d. Ceramics great for nozzles
4. Fin Design
  a. Must use fins that are proper for your particular rocket
  b. Not only be experimentation
  c. Better to have larger
  d. Easy area of fin calculator for need surface area
    i. Rough, not needed we can more accurately calculate
  e. At least .0175 inches thick, alum or steel
  f. Fin flutter
  g. Strength in fillet for landing if extended out
  h. Different fin design shown on page 146
  i. Just 2 degrees off can fuck up the flight
  j. Delicate process to attach, must be done delibaretly so its rugged and strong, not fragile
  k. Can do band attachment around the body tube
  l. Direct attachment of the fin to the body
  m. Clamp attachment of two or 4 section and squeeze them together
5. Nose cones
  a. Light press is all necessary to body tube below, shoulder goes in
  b. Already defined in curve for below mach 1 as the von karmen design
  c. Can be made from variety materials
  d. Can be used for electronics inside, etc
6. Diaphragms and igniters
  a. Electrical current heating up material to make a small explosive spark is usual ignition sequence and is easy/reliable
  b. Diaphragm seals nozzle until it has enough pressure/temp for combustion and is designed to fracture brittle.
  c. Both usually combined into one assembly known as the ignition assembly
  d. Nice diagrams page 155 and 156
7. Combustion chamber
  a. Know strength of materials, what can go wrong with a pressurized vessel
  b. Table of aluminum and steel
  c. The number system for steels, says percent stuff
  d. Material you use should be 4 times stronger than the expected pressure, good rule of thumb but we have fea now and design to 2-4 FOS
  e. Bulkhead/injector and nozzle must be just as strong if not stronger as they have forces on it too!
8. Some amateur rockets you can build
  a. 4 different ones with increasing difficulty

Chapter 6 – Rocket Instrumentation

1. Everything that isn’t part of the rocket structure, the motor system, or payload when it is a delivery item
2. Can b data collection, very important for many rockets
3. Uses
  a. To control flight
  b. To measure of monitor performance
  c. To measure record and transmit back to earth
4. Types
  a. Altimeters
  b. Accelerometers
  c. Parchute ejection
  d. Second stage ignition
  e. Tracking
  f. Temperature
  g. Pressure
  h. Gyro
  i. Camera
  j. Gravity switches
5. Radio interference, gps tracking interference
6. Rules on radio transmission and gps license
7. Instruments are sensitive, sgould be handled with care and calibrated before flight
8. Should be mounted to materials that can handle many g’s of force that can be seen during flight
  a. Can use shocks, spring, dampers to facilitate high g’s at launch and flight
9. Can have flashing lights for night launches

Chapter 7 – Preflight Testing

1. Nearly everything is tested
2. Imperative to discover the flaws in a system
3. Foolish to do elaborate prep and have a failure that could have easily been caught
  a. Rocketry mistakes usually ends with fire, so why make your part be destroyed?
4. Why have a systematic testing process
  a. To prove or improve design
  b. To establish material specifications
  c. To ensure proper performance of mechanical devices
  d. To determine performance characteristics of propellants and motor designs
  e. To avoid costly mistakes or disasters
5. Every component of the rocket can be tested
  a. Motor
  b. Fins
  c. Diaphragms
  d. Mechanisms
  e. Igniters
  f. Propellants
  g. Bulkheads
  h. Launching rack
  i. electrical components day of for sure!
6. Testing required ingenuity, mercury astronauts all those testing stuff was very new and creative!
7. Static hot fire is the most important
  a. Goes over a basic hot fire test stand
  b. Should be very safe to explosions, etc.
8. Thrust measuring devices
  a. Load cells, strain gauges
  b. Must be restrained so it cant run away from the stand no matter what!
  c. Can push or pull on something that registers force
9. A rocket centrifuge, lol
  a. Shows how it performs if it is accelerating
10. Measuring chamber wall temp and stress
  a. Attaching leads to the wall for strain or temperature
  b. These work by measuring the produced current or voltage produced from the strain gauges or the temp wires reacting to the situation
11. Test stand to determine strength of chamber, basically a hydrostat!
12. Wind tunnels to determine drag and optimize shapes of airframe
13. Static testing bay is basically a safe hot fire test stand
  a. An angled view with mirror of the test
14. Tests on figuring out flight path
  a. MATLAB helps, and basically an iterative calculation with time increments
15. Talks about some equations needed using engine characteristics to calculate height.
  a. Some basic kinematics
  b. Doesn’t include much drag even tho that is huge sometimes!

Chapter 8 – Layout and Construction of the Launching Site

1. The launch is the ultimate test of a rocket
  a. It shows everything together, the system test
  b. But not the goal, the goal is to study the path, analyze and learn to keep moving forward for a better rocket
2. Thank about the dangers of launch site
  a. The legal implication, permissions etc
  b. For a static test fire, we are good for our area in Lee sand pit, just need police and fire always on board with each planned test date.
3. Safety elements
  a. Remoteness
  b. Cover
  c. Limited observation
  d. Assignment of tasks
  e. One-man control
  f. Fire fighting and first aid
  g. Routine
  h. Layout of a launching site
4. If actually launching in air, know the trajectory and if your field is suitable, if not add weight to lower the height.
5. Common position of people and places on a launch site are listed in 218
6. Launching site structures and locations
  a. Launching put
  b. Firing bunker
  c. Fueling pit
  d. Observation bunkers
  e. Range guard shelters
  f. Spectator shelters
7. Should all be safe for impact
8. Sandbag construction
  a. We need to make this shit at the field once the snow is gone and get a project lead on it to complete by late April
9. Roof construction with large pieces of wood and sandbags thrown on top
10. Explains the importance of overhead strength from high heights
  a. For us we don’t really launch heavy dangerous rocket, but just static test them, so our stuff doesn’t have be to as rigorous but still must be sturdy.
11. Goes over the types of buildings and how to usually design them, etc on pages 228 to 260
12. Positions during a test
  a. For us, it’s the safety officer and the range officer. There are also leads on each of our systems, but it is very similar to what he details
13. Don’t have pointless regulations, keep things to the point when on the field. Should be made culturally as when on the field, it is BUSINESS.
14. Different Procedures
  a. Preflight
    i. Briefing
    ii. Firing stations – scouts out
    iii. First reports
    iv. All clear in the launching area
    v. Fueling
    vi. Positioning
    vii. Take cover
  b. Firing
    i. Safety check – second reports
    ii. Ready on the right 0 ready on the left
    iii. Prepare to fire
    iv. Safety officer clears
    v. Countdown
  c. In-Flight
    i. Maintain cover – open firing switch
    ii. Observation and tracking
    iii. Impact observation
  d. Post firing
    i. Nominal test
      1. All clear
      2. Reset safety devices
      3. Reporting of data
      4. Recovery of rocket
    ii. For unsuccessful
      1. Handling a misfire or dud rocket
        a. Steps to wait for a misfire and do not approach for like 3min
      2. All clear
      3. Reset safety devices
      4. Reporting of data
      5. Critique and evaluation

Chapter 10 – How to track your rocket and how to evaluate its performance

1. Rockets go fast, and you can lose sight of them very easily if going higher then a few thousand feet.
2. Many techniques back in the day to keep sight and determining actual height achieved without todays electronics. Still great to understand
3. You can train yourself to track better, but many people don’t see enough to really gain that experience like people back then in military.
4. At peak alt, measure angle. Then with multiple observers, can use trig to identify height given the distances between the people observing
5. More on old school methods to getting data on a launch
6. 301 is a pic of a cool tool to keep tracking the rocket and the angle It hits - max angle is the max height
7. Tip on how to better use your eyes to focus on a object
8. Calculate total distance rocket has fallen can be with .5gt^2
9. Use camera to get video!
10. Can now track GPS
11. Use of smoke or something bright that comes out during apogee, etc is used!
12. Stripes help a lot
13. Something that reflect light to make it beam, or glows in dark
  a. A vapor generator with a specific color
