Maeswoon/UNHSEDS/Business/Finance/Budgets, Packets and Templates/Templates/Guide to Visiting Companies.docx

Guide to Visiting Companies

1. Find a front desk or someone to talk to near the entrance of the business
2. Introduce yourself, that you are here with UNH SEDS, a rocketry organization at UNH, and say you would like to speak with someone regarding club sponsorship for the 2018-2019 school year.
3. If they say no right away, offer to leave the PDF packet and say the contact is on the 3rd page if you change your mind
4. If they direct you to the right person, introduce yourself again and explain UNH SEDS a bit, how last year we spent the time learning the aerodynamic theory and simulation, and now we are manufacturing our own hybrid engine. Seeking monetary support for the school year, and direct them to the PDF with what we can do for them if they help. Point out contact, and how there is more information in the packet on us. Tell them to not hesitate to contact me with any questions.
5. Be natural, don’t be nervous!
