Maeswoon/UNHSEDS/Archive/Engineering/2019-2020_USURPER/Frame/SOLIDWORKS/Assemblies/Frame Assembly/Frame Assembly V2/Frame Assembly V2-Static 1-BenchMark.txt

Host = 

CPU = Intel(R) Core(TM) i7-8750H CPU @ 2.20GHz 10000MHz

Number of CPU = 12

Physical Memory = 8GB

OS = Windows 10 18362

SWVersion = SOLIDWORKS 2018_SP3.0

User = Darren

Mesher Type = CB

Max ElemSize =  0m

Min ElemSize =  0m

Number of Segments =  8

Mesh 0.000 CreateMesh-Start 0 0 0 0 0 0 0 0 0 0 0 0 0 0 0 0 0 0 0 0 0 0 0 0 0 0 0 0

Mesh 0.000 MeshPreprocessing-Start 0 0 0 0 0 0 0 0 0 0 0 0 0 0 0 0 0 0 0 0 0 0 0 0 0 0 0 0

Mesh 0.000 MeshPreparation-Start 0 0 0 0 0 0 0 0 0 0 0 0 0 0 0 0 0 0 0 0 0 0 0 0 0 0 0 0

Mesh 0.247 MeshPreparation-End 0 0 0 0 0 0 0 0 0 0 0 0 0 0 0 0 0 0 0 0 0 0 0 0 0 0 0 0

Mesh 0.247 JointContactCheck-Start 0 0 0 0 0 0 0 0 0 0 0 0 0 0 0 0 0 0 0 0 0 0 0 0 0 0 0 0

Mesh 0.247 JointContactCheck-End 0 0 0 0 0 0 0 0 0 0 0 0 0 0 0 0 0 0 0 0 0 0 0 0 0 0 0 0

Mesh 0.247 MeshPreprocessing-End 0 0 0 0 0 0 0 0 0 0 0 0 0 0 0 0 0 0 0 0 0 0 0 0 0 0 0 0

Mesh 0.248 SolidMesh-Start 0 0 0 0 0 0 0 0 0 0 0 0 0 0 0 0 0 0 0 0 0 0 0 0 0 0 0 0

Mesh 0.743 SetMemoryCopySolid-Start 0 0 0 0 0 0 0 0 0 0 0 0 0 0 0 0 0 0 0 0 0 0 0 0 0 0 0 0

Mesh 6.669 SolidMesh-End 0 0 0 0 0 0 0 0 0 0 0 0 0 0 0 0 0 0 0 0 0 0 0 0 0 0 0 0

Mesh 6.675 BeamMesh-Start 0 0 0 0 0 0 0 0 0 0 0 0 0 0 0 0 0 0 0 0 0 0 0 0 0 0 0 0

Mesh 6.675 BeamMesh-End 0 0 0 0 0 0 0 0 0 0 0 0 0 0 0 0 0 0 0 0 0 0 0 0 0 0 0 0

Mesh 10.843 CreateMesh-End 0 0 0 0 0 0 0 0 0 0 0 0 0 0 0 0 0 0 0 0 0 0 0 0 0 0 0 0

Solver 46.182 Solver-Start 0 0 0 0 0 0 0 0 0 0 0 0 0 0 0 0 0 0 0 0 0 0 0 0 0 0 0 0

Start FileTime = 13215930946751
