Maeswoon/UNHSEDS/Engineering/2019-2020_USURPER/Frame/Reports/FEA Setup.JPG

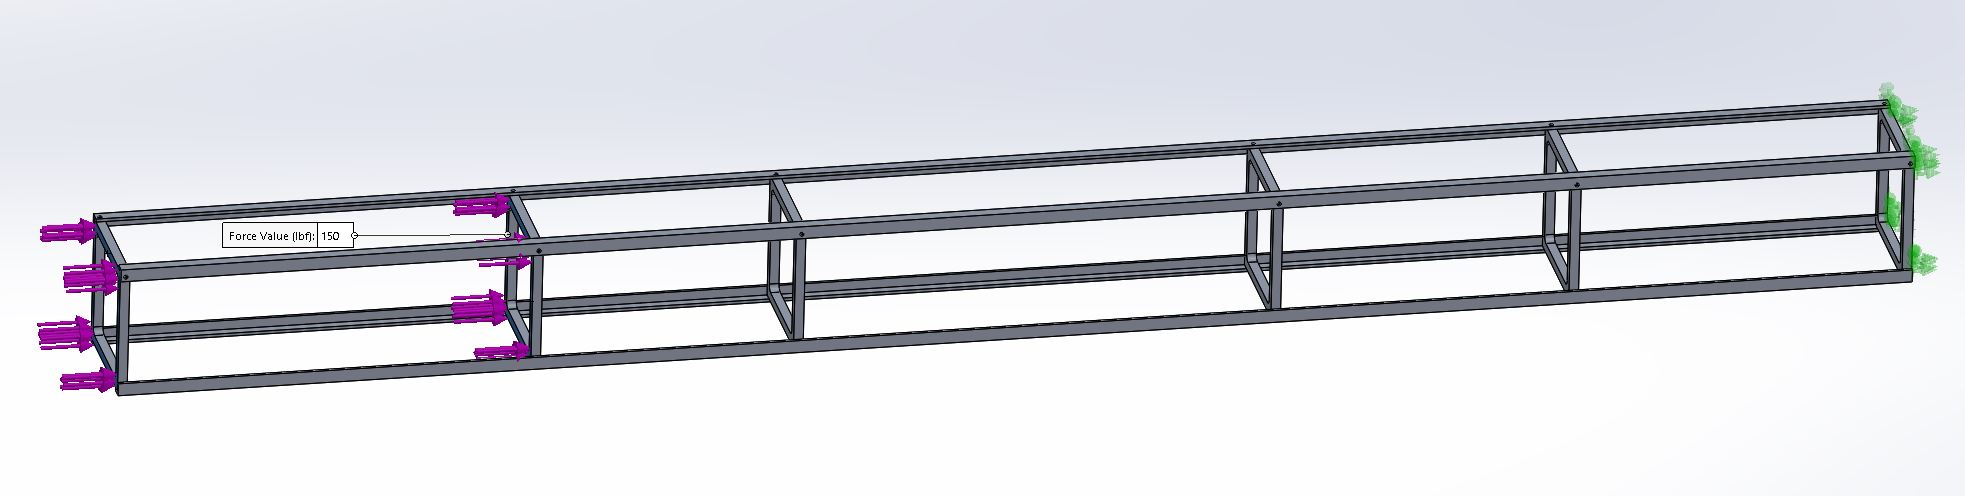
Engineering/2019-2020_USURPER/Frame/Reports/FEA Setup.JPG
