Maeswoon/UNHSEDS/Engineering/2022-2023 Rocket/Propulsion/Simulations/PerformanceLog.txt

Number of Contacts: 4
Number of contact data: 2808
