Maeswoon/UNHSEDS/Engineering/2021-2022_EUROPA/Propulsion/New Engine Components/Nozzle Thermal Analysis/PerformanceLog.txt

Number of Contacts: 6
Number of contact data: 1911
