Maeswoon/UNHSEDS/Engineering/2020-2021_PHANTOM/Propulsion/Banshee V1/NEWSIM/PerformanceLog.txt

Number of Contacts: 2
Number of contact data: 187
