Maeswoon/UNHSEDS/Engineering/2019-2020_USURPER/Frame/SOLIDWORKS/Assemblies/Frame Assembly/Frame Assembly V4/V4 Frame Support Strucutre Test-Static 1-BenchMark.txt

Host = S172-3

CPU = Intel(R) Core(TM) i7-4790S CPU @ 3.20GHz 10000MHz

Number of CPU = 8

Physical Memory = 16GB

OS = Windows 10 18362

SWVersion = SOLIDWORKS 2018_SP4.0

User = Student

Mesher Type = STD

Element Size =  0.00795189m

Tolerance =  0.000397594m

Mesh 0.000 CreateMesh-Start 0 0 0 0 0 0 0 0 0 0 0 0 0 0 0 0 0 0 0 0 0 0 0 0 0 0 0 0

Mesh 0.000 MeshPreprocessing-Start 0 0 0 0 0 0 0 0 0 0 0 0 0 0 0 0 0 0 0 0 0 0 0 0 0 0 0 0

Mesh 0.000 MeshPreparation-Start 0 0 0 0 0 0 0 0 0 0 0 0 0 0 0 0 0 0 0 0 0 0 0 0 0 0 0 0

Mesh 0.091 MeshPreparation-End 0 0 0 0 0 0 0 0 0 0 0 0 0 0 0 0 0 0 0 0 0 0 0 0 0 0 0 0

Mesh 0.091 JointContactCheck-Start 0 0 0 0 0 0 0 0 0 0 0 0 0 0 0 0 0 0 0 0 0 0 0 0 0 0 0 0

Mesh 0.091 JointContactCheck-End 0 0 0 0 0 0 0 0 0 0 0 0 0 0 0 0 0 0 0 0 0 0 0 0 0 0 0 0

Mesh 0.092 MeshPreprocessing-End 0 0 0 0 0 0 0 0 0 0 0 0 0 0 0 0 0 0 0 0 0 0 0 0 0 0 0 0

Mesh 0.092 SolidMesh-Start 0 0 0 0 0 0 0 0 0 0 0 0 0 0 0 0 0 0 0 0 0 0 0 0 0 0 0 0

Mesh 0.257 SetMemoryCopySolid-Start 0 0 0 0 0 0 0 0 0 0 0 0 0 0 0 0 0 0 0 0 0 0 0 0 0 0 0 0

Mesh 1.089 SetMemoryCopySolid-End 0 0 0 0 0 0 0 0 0 0 0 0 0 0 0 0 0 0 0 0 0 0 0 0 0 0 0 0

Mesh 1.089 ImprintAndSplit-Start 0 0 0 0 0 0 0 0 0 0 0 0 0 0 0 0 0 0 0 0 0 0 0 0 0 0 0 0

Mesh 2.210 ImprintAndSplit-End 0 0 0 0 0 0 0 0 0 0 0 0 0 0 0 0 0 0 0 0 0 0 0 0 0 0 0 0

Mesh 2.210 TransferMeshControl-Start 0 0 0 0 0 0 0 0 0 0 0 0 0 0 0 0 0 0 0 0 0 0 0 0 0 0 0 0

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

Pre 20.471 TransferDataToSolver-End 0 0 0 0 0 0 0 0 0 0 0 0 0 0 0 0 0 0 0 0 0 0 0 0 0 0 0 0

Solver 20.471 Solver-Start 0 0 0 0 0 0 0 0 0 0 0 0 0 0 0 0 0 0 0 0 0 0 0 0 0 0 0 0

Start FileTime = 13226798104748
