Maeswoon/UNHSEDS/Engineering/2019-2020_USURPER/Frame/SOLIDWORKS/Assemblies/Frame Assembly/Frame Assembly V4/V4 Frame Support Strucutre Test-Static 2-BenchMark.txt

MeshAndRun BenchMark 

Host = S172-3

CPU = Intel(R) Core(TM) i7-4790S CPU @ 3.20GHz 10000MHz

Number of CPU = 8

Physical Memory = 16GB

OS = Windows 10 18362

SWVersion = SOLIDWORKS 2018_SP4.0

User = Student

Mesher Type = STD

Element Size =  0.00795225m

Tolerance =  0.000397612m

Mesh 0.000 CreateMesh-Start 0 0 0 0 0 0 0 0 0 0 0 0 0 0 0 0 0 0 0 0 0 0 0 0 0 0 0 0

Mesh 0.000 MeshPreprocessing-Start 0 0 0 0 0 0 0 0 0 0 0 0 0 0 0 0 0 0 0 0 0 0 0 0 0 0 0 0

Mesh 0.000 MeshPreparation-Start 0 0 0 0 0 0 0 0 0 0 0 0 0 0 0 0 0 0 0 0 0 0 0 0 0 0 0 0

Mesh 0.104 MeshPreparation-End 0 0 0 0 0 0 0 0 0 0 0 0 0 0 0 0 0 0 0 0 0 0 0 0 0 0 0 0

Mesh 0.104 JointContactCheck-Start 0 0 0 0 0 0 0 0 0 0 0 0 0 0 0 0 0 0 0 0 0 0 0 0 0 0 0 0

Mesh 0.104 JointContactCheck-End 0 0 0 0 0 0 0 0 0 0 0 0 0 0 0 0 0 0 0 0 0 0 0 0 0 0 0 0

Mesh 0.104 MeshPreprocessing-End 0 0 0 0 0 0 0 0 0 0 0 0 0 0 0 0 0 0 0 0 0 0 0 0 0 0 0 0

Mesh 0.104 SolidMesh-Start 0 0 0 0 0 0 0 0 0 0 0 0 0 0 0 0 0 0 0 0 0 0 0 0 0 0 0 0

Mesh 0.259 SetMemoryCopySolid-Start 0 0 0 0 0 0 0 0 0 0 0 0 0 0 0 0 0 0 0 0 0 0 0 0 0 0 0 0

Mesh 1.089 SetMemoryCopySolid-End 0 0 0 0 0 0 0 0 0 0 0 0 0 0 0 0 0 0 0 0 0 0 0 0 0 0 0 0

Mesh 1.089 ImprintAndSplit-Start 0 0 0 0 0 0 0 0 0 0 0 0 0 0 0 0 0 0 0 0 0 0 0 0 0 0 0 0

Mesh 2.188 ImprintAndSplit-End 0 0 0 0 0 0 0 0 0 0 0 0 0 0 0 0 0 0 0 0 0 0 0 0 0 0 0 0

Mesh 2.188 TransferMeshControl-Start 0 0 0 0 0 0 0 0 0 0 0 0 0 0 0 0 0 0 0 0 0 0 0 0 0 0 0 0

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

!Phase,Wall,Mark,UCPU,SCPU,WSP,WS,CPU,QPPP,QPP,QNPPP,QNPP,PF,PPF,HNDL,VB,PVB,PID,0,FP,MaxFP,Read,Write,Sim_Read_Calls,Sim_Read_Time,BulkReadBytesReq,Sim_Read_Bytes,Sim_Write_Calls,Sim_Write_time,BulkWriteBytesReq,Sim_Write_Bytes  

!Only Phase, Wall, Mark are valid output.
