Maeswoon/UNHSEDS/Engineering/2019-2020_USURPER/Avionics/TestLaunch_10k.xlsx

time | height (ft)
-0.59 | -5.74147
-0.56 | -5.74147
0 | -5.74147
0 | -5.74147
0.42 | 2.66404208
0.45 | 2.66404208
1 | 2.66404208
1.14 | 3.444882
1.18 | 3.444882
1.24 | 20.25590616
1.27 | 20.25590616
1.35 | 35.597114
1.38 | 35.597114
1.46 | 65.82021208
1.49 | 65.82021208
1.49 | 65.82021208
1.57 | 93.79265392
1.6 | 93.79265392
1.6 | 93.79265392
1.68 | 128.2874057
1.71 | 128.2874057
1.79 | 186.2532868
1.82 | 186.2532868
1.9 | 295.0656262
1.93 | 295.0656262
2 | 295.0656262
2.01 | 468.9632696
2.04 | 468.9632696
2.12 | 392.1194351
2.15 | 392.1194351
2.23 | 341.6404309
2.26 | 341.6404309
2.34 | 485.544635
2.37 | 485.544635
2.45 | 569.8753463
2.48 | 569.8753463
2.56 | 629.9081566
2.59 | 629.9081566
2.59 | 629.9081566
2.67 | 875.8727314
2.7 | 875.8727314
2.78 | 871.1876919
2.81 | 871.1876919
2.89 | 1123.536781
2.92 | 1123.536781
3 | 1114.120771
3 | 1114.120771
3.03 | 1114.120771
3.11 | 1022.211319
3.14 | 1022.211319
3.22 | 1521.122096
3.25 | 1521.122096
3.33 | 1547.946244
3.36 | 1547.946244
3.44 | 1136.81106
3.47 | 1136.81106
3.55 | 1027.263812
3.58 | 1027.263812
3.66 | 1180.354368
3.69 | 1180.354368
3.69 | 1180.354368
3.77 | 1076.135205
3.8 | 1076.135205
3.88 | 1179.573529
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
