Maeswoon/UNHSEDS/Engineering/2019-2020_USURPER/Propulsion/Hot fire Data/MarchTestData.xlsx

Sheet: Thermocouple - Dev1_ai3
Date | 2020-03-06
Time | 13:55:19
Y_Unit_Label | Temperature (deg C)
X_Dimension | Time (s)
X0 | 13:55:19
Delta_X | 0.05
***End_of_Header***
X_Value | Thermocouple - Dev1_ai3 | Comment
0 | 25.7125
0.05 | 26.853133
0.1 | 30.916854
0.15 | 32.861902
0.2 | 26.853133
0.25 | 27.829849
0.3 | 27.341603
0.35 | 36.418627
0.4 | 27.341603
0.45 | 28.805667
0.5 | 24.080932
0.55 | 29.942985
0.6 | 27.829849
0.65 | 30.267708
0.7 | 26.364439
0.75 | 29.293239
0.8 | 32.537976
0.85 | 30.105359
0.9 | 30.754605
0.95 | 31.727726
1 | 33.83309
1.05 | 30.430032
1.1 | 29.780586
1.15 | 31.727726
1.2 | 25.875522
1.25 | 31.079078
1.3 | 32.861902
1.35 | 26.69026
1.4 | 24.407441
1.45 | 28.968216
1.5 | 31.889825
1.55 | 31.565601
1.6 | 31.403452
1.65 | 29.293239
1.7 | 32.21395
1.75 | 34.156622
1.8 | 32.537976
1.85 | 31.889825
1.9 | 24.733853
1.95 | 24.407441
2 | 27.829849
2.05 | 27.829849
2.1 | 27.667125
2.15 | 29.942985
2.2 | 33.023828
2.25 | 27.178804
2.3 | 32.0519
2.35 | 36.741386
2.4 | 26.853133
2.45 | 25.223287
2.5 | 29.293239
2.55 | 30.267708
2.6 | 25.875522
2.65 | 29.942985
2.7 | 21.956275
2.75 | 26.527362
2.8 | 33.023828
2.85 | 30.592331
2.9 | 33.994868
2.95 | 33.671286
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
