Maeswoon/UNHSEDS/Business/President Achrives/SEDS Matlab/STFR/test_booster.xlsx

Date | 2018-03-26
Time | 17:39:08
Y_Unit_Label | Voltage (V)
X_Dimension | Time (s)
X0 | 17:39:08
Delta_X | 0.004
***End_of_Header***
X_Value | Voltage - Dev11_ai0 | Comment
0 | 0.37249
0.004 | 0.373476
0.008 | 0.374462
0.012 | 0.370189
0.016 | 0.373147
0.02 | 0.373147
0.024 | 0.372161
0.028 | 0.373147
0.032 | 0.371175
0.036 | 0.374791
0.04 | 0.372161
0.044 | 0.373147
0.048 | 0.373147
0.052 | 0.373805
0.056 | 0.373805
0.06 | 0.371504
0.064 | 0.372161
0.068 | 0.373476
0.072 | 0.371504
0.076 | 0.374791
0.08 | 0.373476
0.084 | 0.373147
0.088 | 0.373147
0.092 | 0.37512
0.096 | 0.374134
0.1 | 0.373147
0.104 | 0.372161
0.108 | 0.373147
0.112 | 0.372819
0.116 | 0.372161
0.12 | 0.376434
0.124 | 0.373476
0.128 | 0.373476
0.132 | 0.370846
0.136 | 0.372819
0.14 | 0.374134
0.144 | 0.37512
0.148 | 0.371504
0.152 | 0.36986
0.156 | 0.374134
0.16 | 0.371504
0.164 | 0.374134
0.168 | 0.373476
0.172 | 0.374462
0.176 | 0.376106
0.18 | 0.36986
0.184 | 0.371175
0.188 | 0.371833
0.192 | 0.373805
0.196 | 0.373476
0.2 | 0.372819
0.204 | 0.373147
0.208 | 0.373147
0.212 | 0.370189
0.216 | 0.373805
0.22 | 0.370518
0.224 | 0.373476
0.228 | 0.373476
0.232 | 0.371175
0.236 | 0.372819
0.24 | 0.373147
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
