Maeswoon/UNHSEDS/Business/President Achrives/SEDS Matlab/STFR/test_sustainer.xlsx

Date | 2018-03-26
Time | 17:30:39
Y_Unit_Label | Voltage (V)
X_Dimension | Time (s)
X0 | 17:30:40
Delta_X | 0.004
***End_of_Header***
X_Value | Voltage - Dev11_ai0 | Comment
0 | 0.378407
0.004 | 0.377749
0.008 | 0.375777
0.012 | 0.37512
0.016 | 0.377092
0.02 | 0.379064
0.024 | 0.376434
0.028 | 0.376763
0.032 | 0.378078
0.036 | 0.377421
0.04 | 0.374462
0.044 | 0.375777
0.048 | 0.378078
0.052 | 0.37512
0.056 | 0.377092
0.06 | 0.378407
0.064 | 0.378407
0.068 | 0.379064
0.072 | 0.378407
0.076 | 0.377092
0.08 | 0.37512
0.084 | 0.376106
0.088 | 0.378407
0.092 | 0.378078
0.096 | 0.377421
0.1 | 0.378735
0.104 | 0.376763
0.108 | 0.377749
0.112 | 0.378735
0.116 | 0.379064
0.12 | 0.379393
0.124 | 0.377421
0.128 | 0.375777
0.132 | 0.377092
0.136 | 0.379064
0.14 | 0.378407
0.144 | 0.379064
0.148 | 0.377421
0.152 | 0.377092
0.156 | 0.377749
0.16 | 0.376106
0.164 | 0.377421
0.168 | 0.379722
0.172 | 0.378407
0.176 | 0.379722
0.18 | 0.37512
0.184 | 0.377749
0.188 | 0.378407
0.192 | 0.378078
0.196 | 0.378407
0.2 | 0.378078
0.204 | 0.377749
0.208 | 0.380379
0.212 | 0.379722
0.216 | 0.375448
0.22 | 0.378078
0.224 | 0.378407
0.228 | 0.376106
0.232 | 0.376106
0.236 | 0.375777
0.24 | 0.378078
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
