Maeswoon/UNHSEDS/Archive/Engineering/2018-2019/Project Runaway/Hot Fire Test Files/Hybrid Engine Mass.xlsx

Mass of Rocket Engine (GRAMS)
5011 | injector and chamber
1143 | nozzel
78
122
35
6389
