Maeswoon/UNHSEDS/Archive/Engineering/2019-2020_USURPER/Propulsion/Runaway V2/Accessories/Cold Flow Testing/250calsheet.xlsx

Sheet: Voltage - Dev1_ai0
Date | 2020-02-09
Time | 13:51:15
Y_Unit_Label | Voltage (V)
X_Dimension | Time (s)
X0 | 13:51:16
Delta_X | 0.5
***End_of_Header***
X_Value | Voltage - Dev1_ai0 | Comment
0 | -0.092843
0.5 | -0.093172
1 | -0.0935
1.5 | -0.093172
2 | -0.092514
2.5 | -0.092843
3 | -0.0935
3.5 | -0.060625
4 | -0.043859
4.5 | -0.026435
5 | -0.021503
5.5 | -0.019202
6 | -0.021175
6.5 | -0.019202
7 | -0.018545
7.5 | -0.020188
8 | -0.020188
8.5 | -0.020846
9 | -0.019531
9.5 | -0.019202 |  |  |  |  |  | y = 0.0161x - 0.0195
10 | -0.019531
10.5 | 0.042604
11 | 0.063644
11.5 | 0.061671 |  | 0 | -0.02
12 | 0.062 |  | 5 | 0.062 |  | 1.98757764
12.5 | 0.062 |  | 10 | 0.141
13 | 0.062
13.5 | 0.061343 |  |  |  | 0.0158 | per pound
14 | 0.061343
14.5 | 0.062
15 | 0.061671
15.5 | 0.062329
16 | 0.062329
16.5 | 0.088301
17 | 0.143531
17.5 | 0.140901
18 | 0.140901
18.5 | 0.141888
19 | 0.141888
19.5 | 0.140901
20 | 0.141888
20.5 | 0.141888
21 | 0.14123
21.5 | 0.142545
22 | 0.14123
22.5 | 0.141559
23 | 0.142216
23.5 | 0.141888
24 | 0.14123
24.5 | 0.140572
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
