Maeswoon/UNHSEDS/Archive/Engineering/2018-2019/Project Runaway/Cold Test/First2Tests22419.xlsx

Sheet: Impinging Inward
Date | 2019-02-24
Time | 19:02:53
Y_Unit_Label | Voltage (V)
X_Dimension | Time (s)
X0 | 19:02:54
Delta_X | 0.001
***End_of_Header***
X_Value | Voltage - Dev3_ai0 | Comment
0 | 2.215486
0.001 | 2.218117
0.002 | 2.20595
0.003 | 2.208252
0.004 | 2.208252
0.005 | 2.206608
0.006 | 2.210225
0.007 | 2.206608
0.008 | 2.212856
0.009 | 2.221406
0.01 | 2.20891
0.011 | 2.213184
0.012 | 2.207265
0.013 | 2.214171
0.014 | 2.218446
0.015 | 2.218446
0.016 | 2.211869
0.017 | 2.213513
0.018 | 2.214829
0.019 | 2.204963
0.02 | 2.213842
0.021 | 2.20595
0.022 | 2.203319
0.023 | 2.207594
0.024 | 2.212198
0.025 | 2.215815
0.026 | 2.210883
0.027 | 2.215158
0.028 | 2.218446
0.029 | 2.218775
0.03 | 2.216802
0.031 | 2.208581
0.032 | 2.222392
0.033 | 2.214829
0.034 | 2.20891
0.035 | 2.216802
0.036 | 2.207923
0.037 | 2.201017
0.038 | 2.215815
0.039 | 2.217788
0.04 | 2.217459
0.041 | 2.212527
0.042 | 2.214171
0.043 | 2.214171
0.044 | 2.20891
0.045 | 2.214171
0.046 | 2.217788
0.047 | 2.210883
0.048 | 2.215158
0.049 | 2.212527
0.05 | 2.217788
0.051 | 2.208252
0.052 | 2.216473
0.053 | 2.213842
0.054 | 2.213184
0.055 | 2.215486
0.056 | 2.221406
0.057 | 2.221077
0.058 | 2.215486
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
