Maeswoon/UNHSEDS/Archive/Engineering/2018-2019/Project Runaway/Cold Test/LastTest22419.xlsx

Date | 2019-02-24
Time | 19:24:04
Y_Unit_Label | Voltage (V)
X_Dimension | Time (s)
X0 | 19:24:05
Delta_X | 0.001
***End_of_Header***
X_Value | Voltage - Dev3_ai0 | Comment
0 | 1.906046
0.001 | 1.895194
0.002 | 1.897825
0.003 | 1.906046
0.004 | 1.898811
0.005 | 1.894208
0.006 | 1.899469
0.007 | 1.909334
0.008 | 1.898811
0.009 | 1.886315
0.01 | 1.893879
0.011 | 1.886644
0.012 | 1.897825
0.013 | 1.89355
0.014 | 1.888288
0.015 | 1.891577
0.016 | 1.886315
0.017 | 1.900127
0.018 | 1.894536
0.019 | 1.90769
0.02 | 1.903415
0.021 | 1.908348
0.022 | 1.912623
0.023 | 1.908019
0.024 | 1.896509
0.025 | 1.896838
0.026 | 1.895194
0.027 | 1.891577
0.028 | 1.889933
0.029 | 1.886315
0.03 | 1.878094
0.031 | 1.885329
0.032 | 1.893879
0.033 | 1.877108
0.034 | 1.897167
0.035 | 1.895194
0.036 | 1.903415
0.037 | 1.908019
0.038 | 1.905717
0.039 | 1.902429
0.04 | 1.888288
0.041 | 1.903415
0.042 | 1.903415
0.043 | 1.887302
0.044 | 1.896838
0.045 | 1.885329
0.046 | 1.878752
0.047 | 1.882369
0.048 | 1.900127
0.049 | 1.896181
0.05 | 1.888288
0.051 | 1.897825
0.052 | 1.894208
0.053 | 1.902429
0.054 | 1.897496
0.055 | 1.909005
0.056 | 1.906375
0.057 | 1.891906
0.058 | 1.890261
0.059 | 1.883027
0.06 | 1.897167
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
