Maeswoon/UNHSEDS/Archive/Engineering/2018-2019/Project Runaway/Cold Test/Actual cold test and cslibration data.xlsx

Sheet: test 3
Date | 2019-02-07
Time | 19:33:53
Y_Unit_Label | Voltage (V)
X_Dimension | Time (s)
X0 | 19:33:54
Delta_X | 0.01
***End_of_Header***
X_Value | Voltage - Dev3_ai0 | Comment
0 | 1.867243
0.01 | 1.860008
0.02 | 1.876779
0.03 | 1.863625
0.04 | 1.857377
0.05 | 1.876779
0.06 | 1.862968
0.07 | 1.874148
0.08 | 1.855404
0.09 | 1.865269
0.1 | 1.857377
0.11 | 1.860666
0.12 | 1.851787
0.13 | 1.876779
0.14 | 1.866914
0.15 | 1.869544
0.16 | 1.860337
0.17 | 1.86231
0.18 | 1.861981
0.19 | 1.874477
0.2 | 1.862968
0.21 | 1.859679
0.22 | 1.868229
0.23 | 1.873162
0.24 | 1.865269
0.25 | 1.864612
0.26 | 1.852773
0.27 | 1.876121
0.28 | 1.860666
0.29 | 1.863954
0.3 | 1.860008
0.31 | 1.857048
0.32 | 1.866585
0.33 | 1.863954
0.34 | 1.85376
0.35 | 1.865598
0.36 | 1.865927
0.37 | 1.864612
0.38 | 1.874477
0.39 | 1.871189
0.4 | 1.860666
0.41 | 1.85376
0.42 | 1.878094
0.43 | 1.850472
0.44 | 1.873162
0.45 | 1.863296
0.46 | 1.858364
0.47 | 1.874477
0.48 | 1.859679
0.49 | 1.868887
0.5 | 1.860995
0.51 | 1.865269
0.52 | 1.865927
0.53 | 1.867243
0.54 | 1.864941
0.55 | 1.869544
0.56 | 1.863625
0.57 | 1.855404
0.58 | 1.867243
0.59 | 1.875792
0.6 | 1.867243
0.61 | 1.857706
0.62 | 1.867571
0.63 | 1.870202
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
