Maeswoon/UNHSEDS/Archive/Engineering/2019-2020_USURPER/Propulsion/Runaway V2/Accessories/Cold Flow Testing/sedsswagetest full flow.xlsx

Sheet: Voltage - Dev1_ai0
Date | 2020-02-07
Time | 20:31:32
Y_Unit_Label | Voltage (V)
X_Dimension | Time (s)
X0 | 20:31:32
Delta_X | 0.1
***End_of_Header***
X_Value | Voltage - Dev1_ai0 | Comment
0 | 0.452889
0.1 | 0.451574
0.2 | 0.45256
0.3 | 0.451574
0.4 | 0.453875
0.5 | 0.45256
0.6 | 0.45256
0.7 | 0.452231
0.8 | 0.45256
0.9 | 0.452889
1 | 0.45256
1.1 | 0.453547
1.2 | 0.452231
1.3 | 0.45256
1.4 | 0.45256
1.5 | 0.452889
1.6 | 0.45256
1.7 | 0.451574
1.8 | 0.45256
1.9 | 0.454204
2 | 0.453218
2.1 | 0.452889
2.2 | 0.452231
2.3 | 0.452231
2.4 | 0.454533
2.5 | 0.453218
2.6 | 0.453218
2.7 | 0.452889
2.8 | 0.451903
2.9 | 0.454862
3 | 0.453218
3.1 | 0.453547
3.2 | 0.452889
3.3 | 0.45256
3.4 | 0.454204
3.5 | 0.45256
3.6 | 0.454204
3.7 | 0.452231
3.8 | 0.452889
3.9 | 0.453875
4 | 0.452231
4.1 | 0.453218
4.2 | 0.452889
4.3 | 0.453218
4.4 | 0.453547
4.5 | 0.453547
4.6 | 0.451903
4.7 | 0.45256
4.8 | 0.452889
4.9 | 0.452889
5 | 0.454533
5.1 | 0.454204
5.2 | 0.452231
5.3 | 0.454204
5.4 | 0.453218
5.5 | 0.453547
5.6 | 0.451574
5.7 | 0.453547
5.8 | 0.453875
5.9 | 0.451245
6 | 0.452889
6.1 | 0.45256
6.2 | 0.452889
6.3 | 0.452889
6.4 | 0.452889
6.5 | 0.45256
6.6 | 0.451574
6.7 | 0.45256
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
