Maeswoon/UNHSEDS/Business/President Achrives/Simulations/verification.png

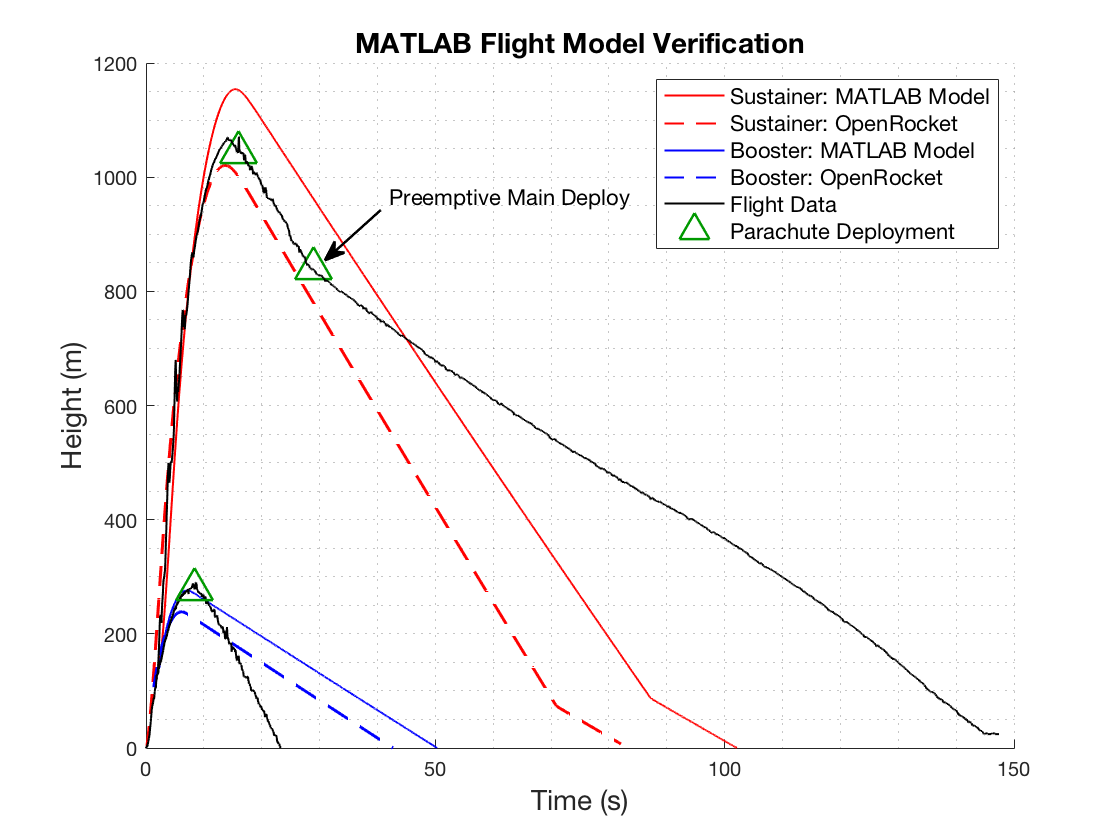
Business/President Achrives/Simulations/verification.png
