Maeswoon/UNHSEDS/Engineering/2020-2021_PHANTOM/Propulsion/Banshee V1/simulation_results2.JPG

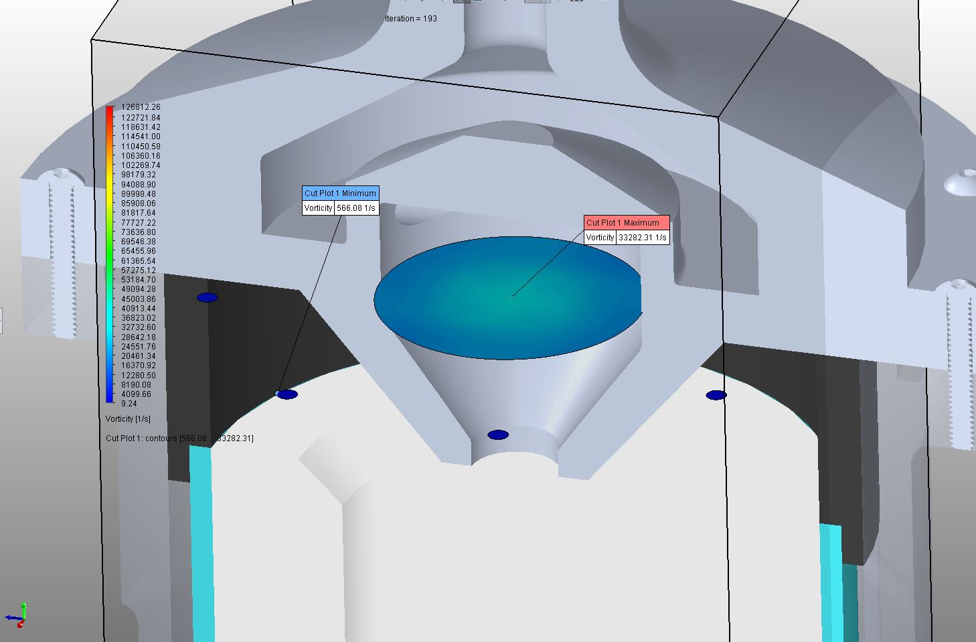
Engineering/2020-2021_PHANTOM/Propulsion/Banshee V1/simulation_results2.JPG
