Maeswoon/UNHSEDS/(threads)

Thread 1 (2020-07-29):

Glass Insert did not fit to the inside of chamber

RThyne1015, 2020-07-29:
- 6/26/20 Justin (Seneca) said "Glass is not cylindrical, both taper about 0.010" from one end to the other
- 7/6/20 Joseph (Technical glass products) said "We will need more specific tolerance information, we may be able to rework
              existing tubes

- [ ] Reference engineering drawings and glass order to understand the situation in more detail

RThyne1015, 2020-07-29:
- 6/26/20 Justin (Seneca) said "Glass is not cylindrical, both taper about 0.010" from one end to the other
- 7/6/20   Joseph (Technical glass products) said "We will need more specific tolerance information, we may be able to rework
                existing tubes

- [ ] Reference engineering drawings and glass order to understand the situation in more detail

RThyne1015, 2020-07-29:
- [ ] Reference engineering drawings and glass order to understand the situation in more detail

Closed 2023-09-01.

Thread 13 (2020-08-16):

New Team Photos

2023AliceWade, 2020-08-16:
- [ ] Request and compile team member's headshots
- [ ] Format photos to same size
- [ ] Replace and update current team member and leadership photos
- [ ] Link team member's LinkedIn profiles to their names

Closed 2023-09-01.
