Maeswoon/UNHSEDS/Engineering/2019-2020_USURPER/Propulsion/Runaway V3/Combustion Chamber.PDF

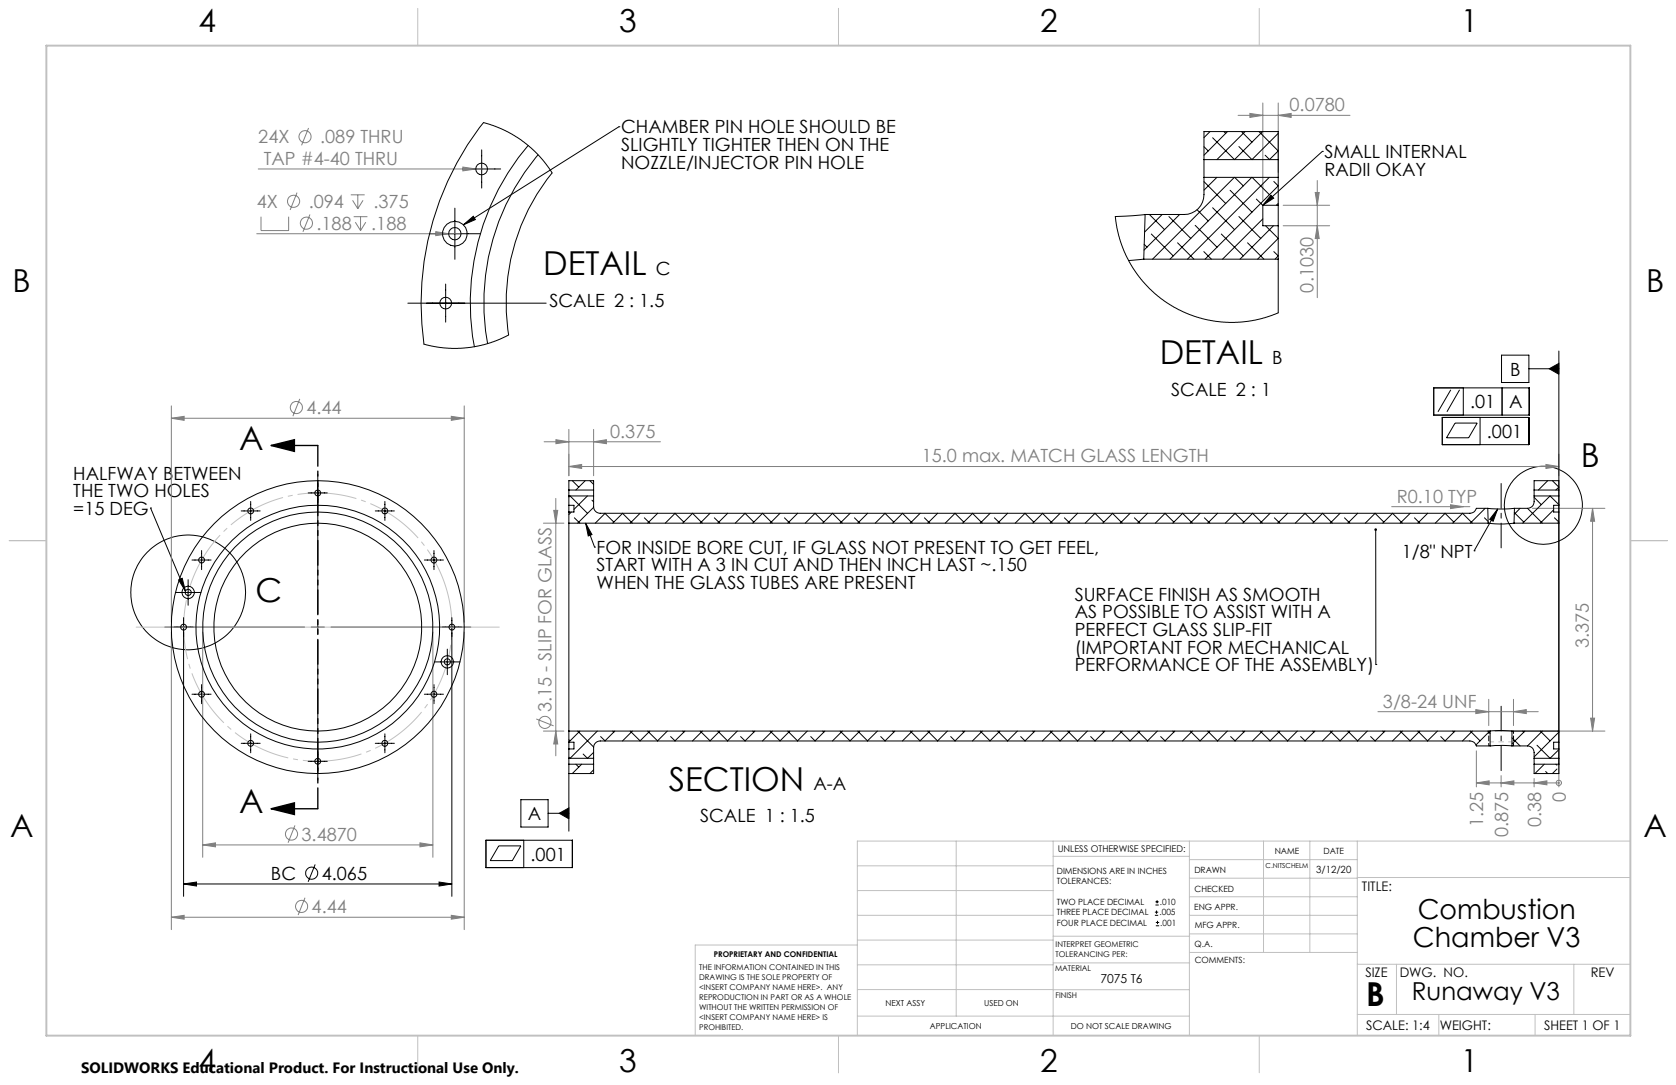
[picture p403: page 1]
R0.10 TYP; 3/8-24 UNF; SECTION A-A; SCALE 1 : 1.5; WHEN THE GLASS TUBES ARE PRESENT; SURFACE FINISH AS SMOOTH; 1/8" NPT; DETAIL B; SCALE 2 : 1; SMALL INTERNAL RADII OKAY; .089 THRU; TAP #4-40 THRU; DETAIL C; SCALE 2 : 1.5

CHAMBER PIN HOLE SHOULD BE
SLIGHTLY TIGHTER THEN ON THE
NOZZLE/INJECTOR PIN HOLE

15.0 max. MATCH GLASS LENGTH

HALFWAY BETWEEN
THE TWO HOLES
=15 DEG

3.15 - SLIP FOR GLASS
FOR INSIDE BORE CUT, IF GLASS NOT PRESENT TO GET FEEL,
START WITH A 3 IN CUT AND THEN INCH LAST ~.150

AS POSSIBLE TO ASSIST WITH A
PERFECT GLASS SLIP-FIT
(IMPORTANT FOR MECHANICAL
PERFORMANCE OF THE ASSEMBLY)

UNLESS OTHERWISE SPECIFIED:

DIMENSIONS ARE IN INCHES TOLERANCES: TWO PLACE DECIMAL .010 THREE PLACE DECIMAL .005 FOUR PLACE DECIMAL .001 | DRAWN | 3/12/20 C.NITSCHELM

CHECKED | | TITLE: Combustion Chamber V3

ENG APPR.
MFG APPR.

INTERPRET GEOMETRIC TOLERANCING PER: | Q.A.
MATERIAL 7075 T6 | | SIZE B | DWG. NO. Runaway V3 | REV

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

NEXT ASSY | USED ON | FINISH

APPLICATION | DO NOT SCALE DRAWING | | SCALE: 1:4 | WEIGHT: | SHEET 1 OF 1

SOLIDWORKS Educational Product. For Instructional Use Only.
