Maeswoon/UNHSEDS/Engineering/2020-2021_PHANTOM/Propulsion/Banshee V1/PDF Drawing's/Combustion Chamber Easy Machining.pdf

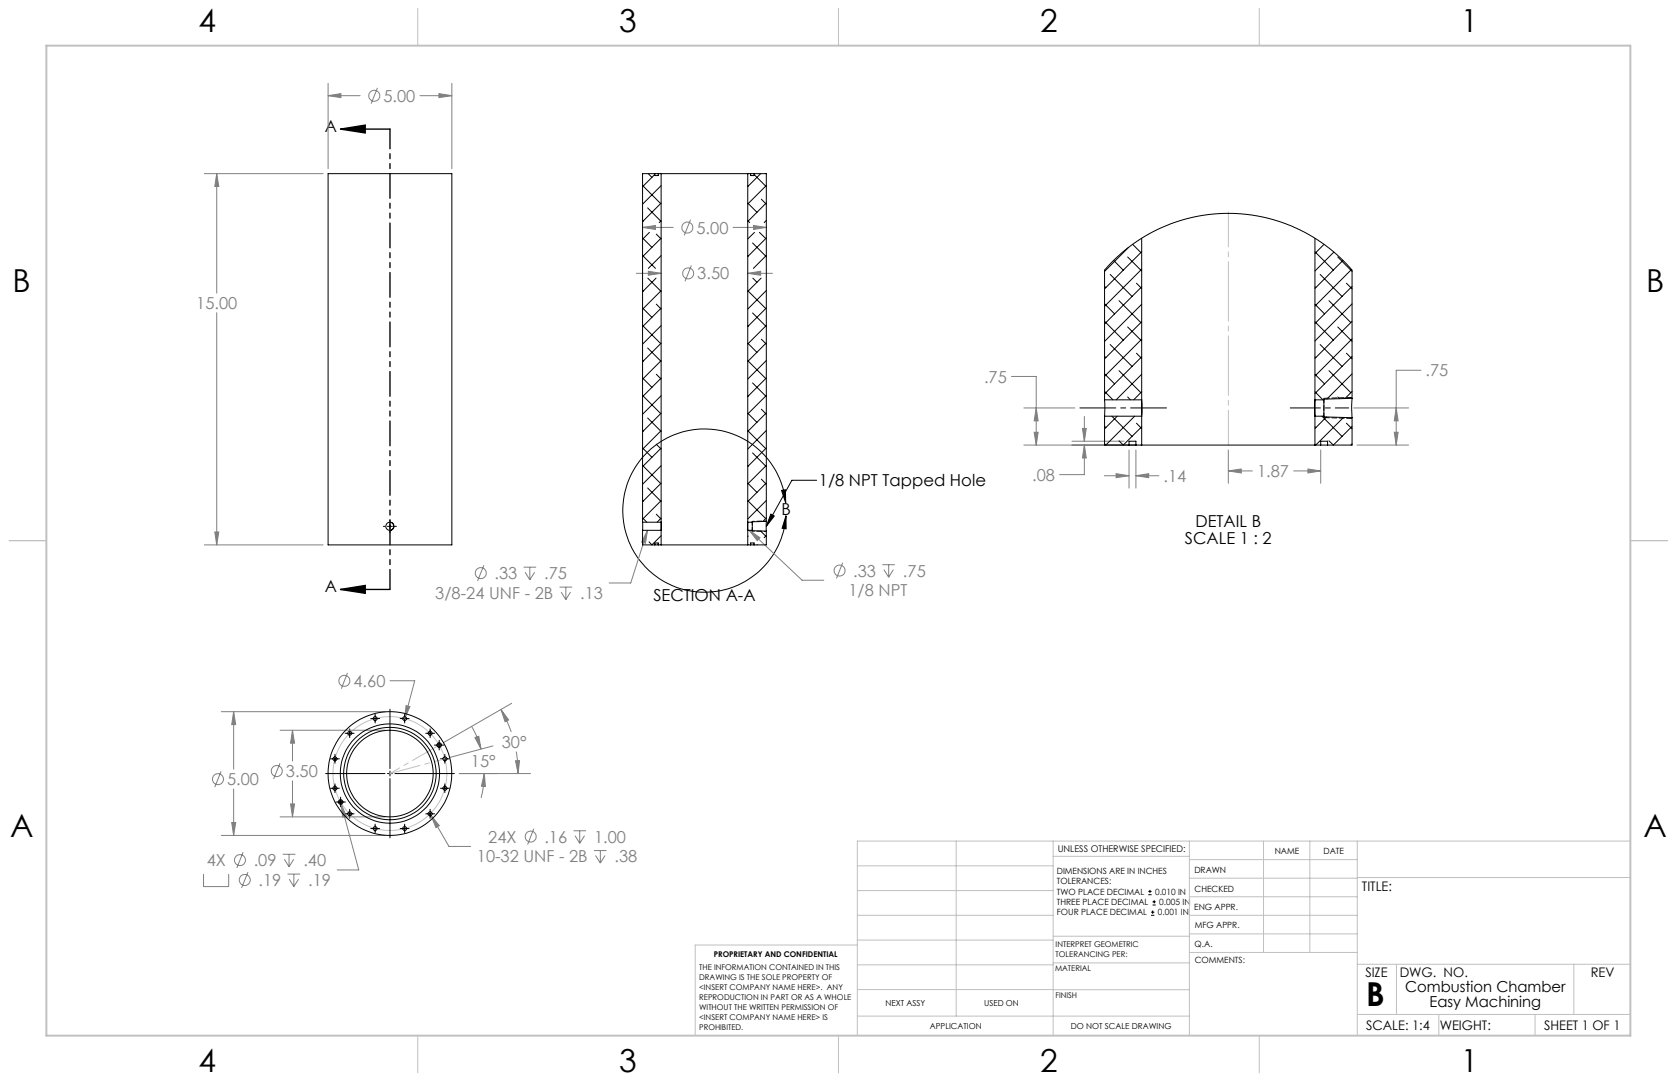
[picture p404: page 1]
.33 .75 3/8-24 UNF - 2B .13; .33 .75 1/8 NPT; SECTION A-A; 10-32 UNF - 2B .38; DETAIL B SCALE 1 : 2

1/8 NPT Tapped Hole

UNLESS OTHERWISE SPECIFIED: | | NAME | DATE
DIMENSIONS ARE IN INCHES TOLERANCES: TWO PLACE DECIMAL 0.010 IN THREE PLACE DECIMAL 0.005 IN FOUR PLACE DECIMAL 0.001 IN | DRAWN

CHECKED | | | TITLE:

ENG APPR.
MFG APPR.

INTERPRET GEOMETRIC TOLERANCING PER: | Q.A.
MATERIAL | | SIZE B | DWG. NO. Combustion Chamber Easy Machining | REV

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

NEXT ASSY | USED ON | FINISH

APPLICATION | DO NOT SCALE DRAWING | | SCALE: 1:4 | WEIGHT: | SHEET 1 OF 1
