Maeswoon/UNHSEDS/Engineering/2020-2021_PHANTOM/Propulsion/Banshee V1/PDF Drawing's/Injector Port Easy Machining.pdf

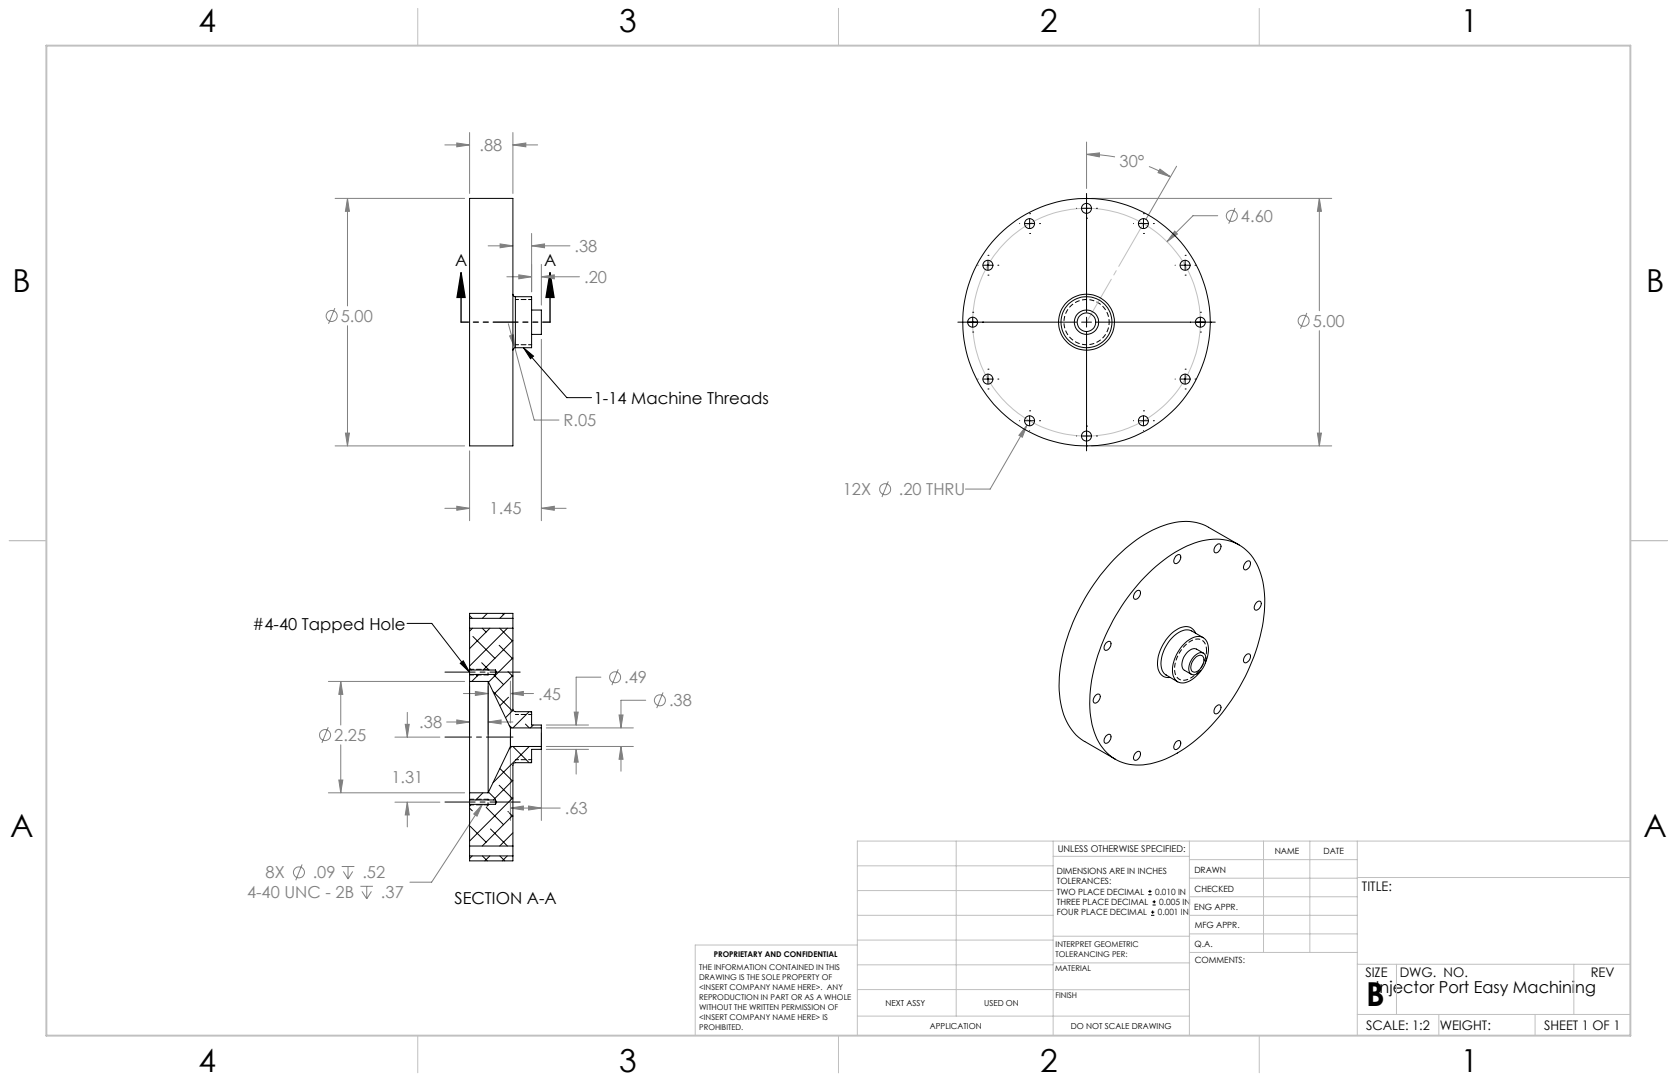
[picture p405: page 1]
1-14 Machine Threads; .20 THRU; 4-40 UNC - 2B .37; #4-40 Tapped Hole; SECTION A-A

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

CHECKED | | | TITLE:

ENG APPR.
MFG APPR.

INTERPRET GEOMETRIC TOLERANCING PER: | Q.A.
MATERIAL | | SIZE B Injector Port Easy Machining | DWG. NO. | REV

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

NEXT ASSY | USED ON | FINISH

APPLICATION | DO NOT SCALE DRAWING | | SCALE: 1:2 | WEIGHT: | SHEET 1 OF 1
