Maeswoon/UNHSEDS/Engineering/2020-2021_PHANTOM/Propulsion/Banshee V1/PDF Drawing's/Combustion Chamber NEW MARCH.pdf

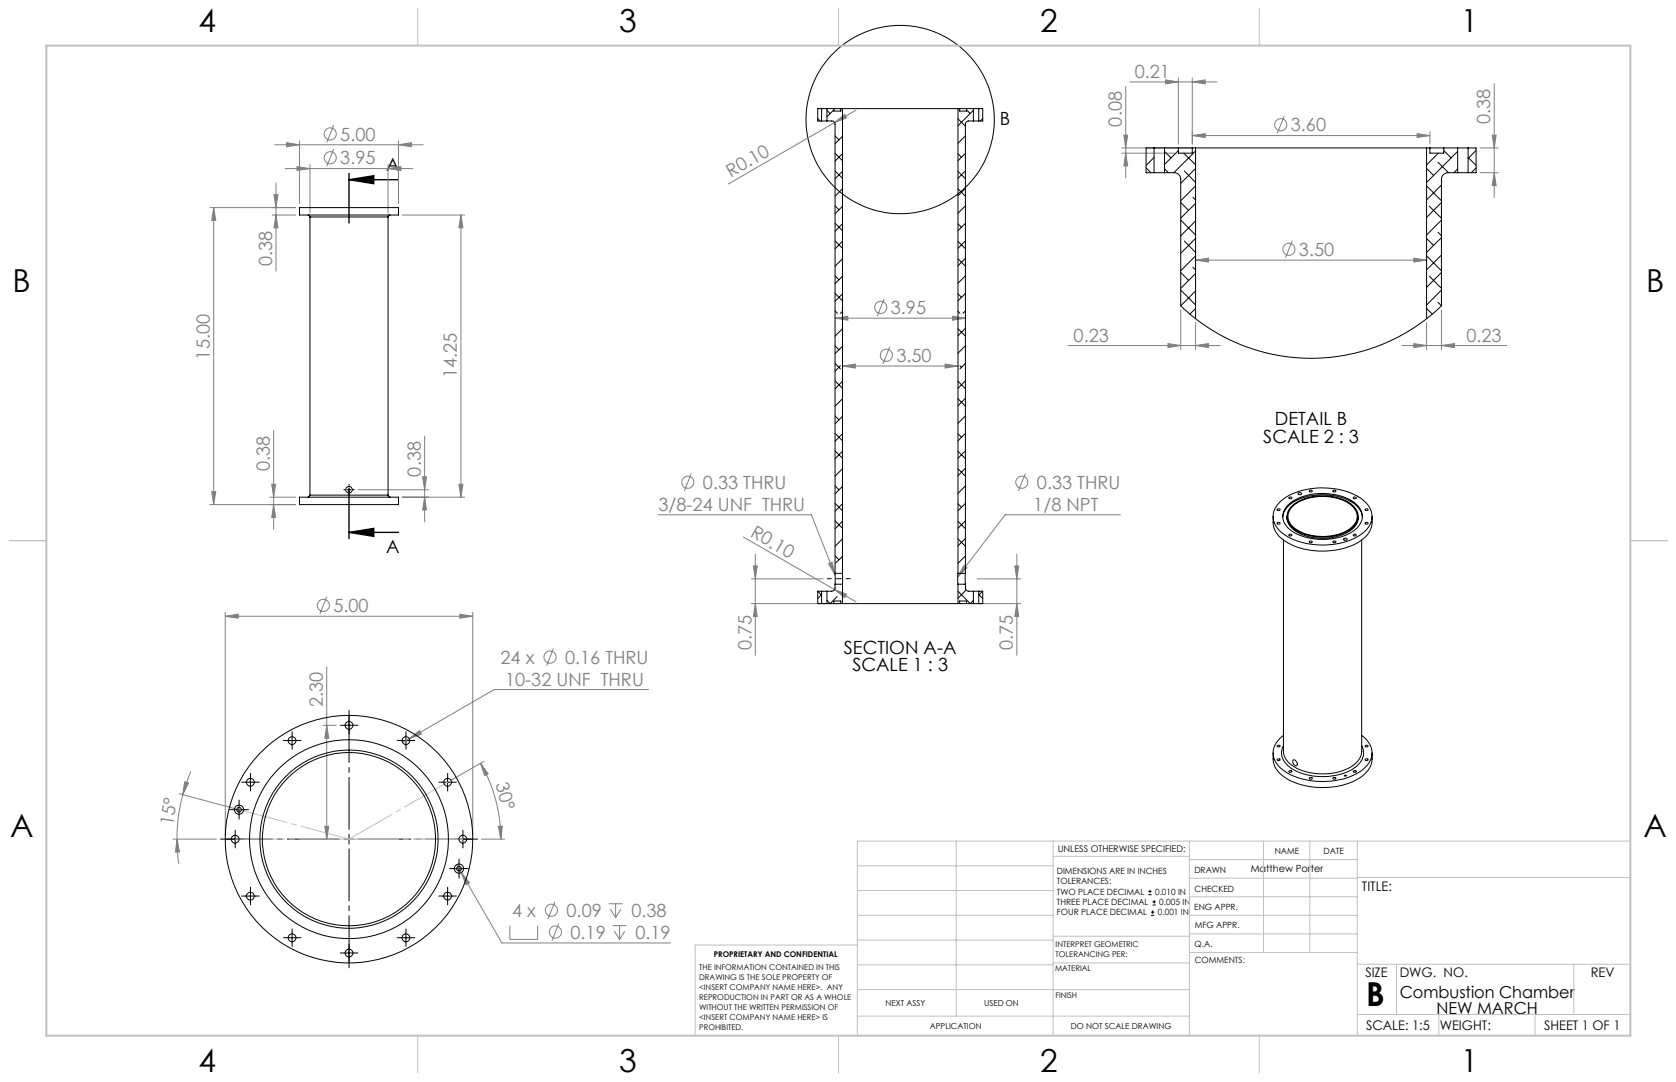
[picture p406: page 1]
0.16 THRU; 10-32 UNF THRU; 0.33 THRU 3/8-24 UNF THRU; 0.33 THRU 1/8 NPT; SECTION A-A SCALE 1 : 3; DETAIL B SCALE 2 : 3

UNLESS OTHERWISE SPECIFIED: | | NAME | DATE
DIMENSIONS ARE IN INCHES TOLERANCES: TWO PLACE DECIMAL 0.010 IN THREE PLACE DECIMAL 0.005 IN FOUR PLACE DECIMAL 0.001 IN | DRAWN Matthew Porter

CHECKED | | | TITLE:

ENG APPR.
MFG APPR.

INTERPRET GEOMETRIC TOLERANCING PER: | Q.A.
MATERIAL | | SIZE B | DWG. NO. Combustion Chamber NEW MARCH | REV

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

NEXT ASSY | USED ON | FINISH

APPLICATION | DO NOT SCALE DRAWING | | SCALE: 1:5 | WEIGHT: | SHEET 1 OF 1
