Maeswoon/UNHSEDS/Engineering/2020-2021_PHANTOM/Propulsion/Banshee V1/PDF Drawing's/ThroatInsert.pdf

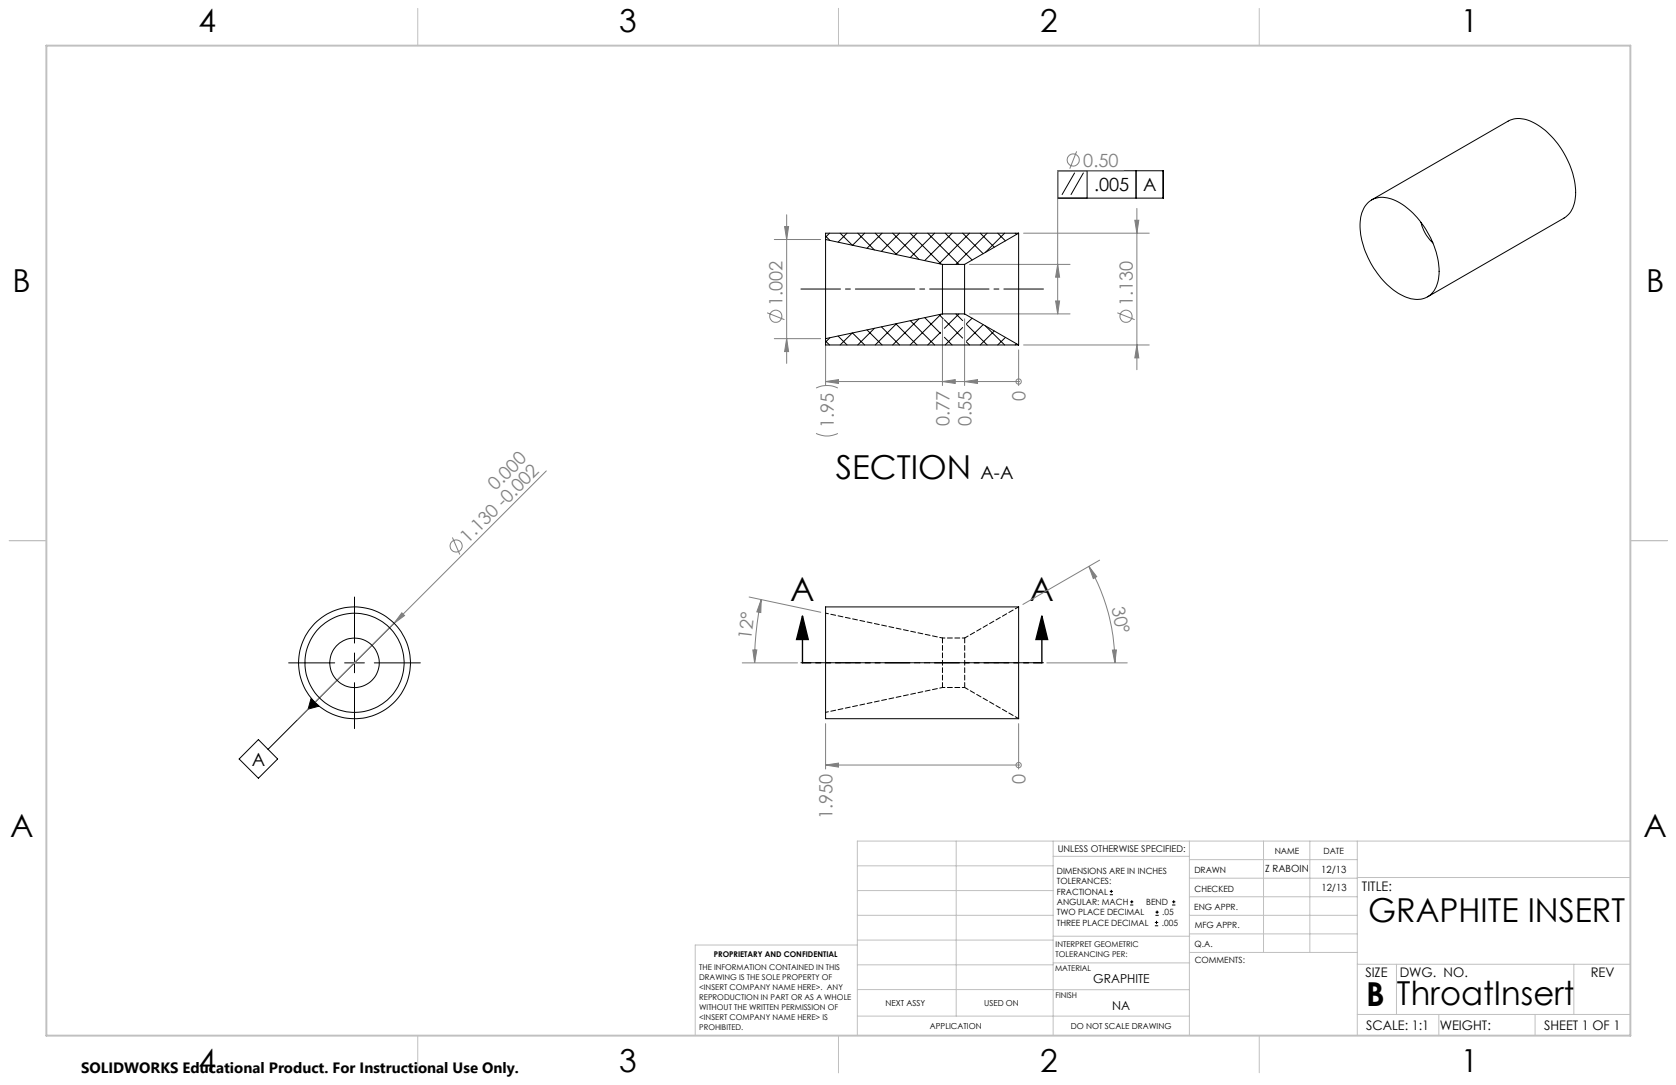
[picture p407: page 1]
SECTION A-A

UNLESS OTHERWISE SPECIFIED: | | NAME | DATE
DIMENSIONS ARE IN INCHES TOLERANCES: FRACTIONAL ANGULAR: MACH BEND TWO PLACE DECIMAL .05 THREE PLACE DECIMAL .005 | DRAWN | Z RABOIN | 12/13

CHECKED | | 12/13 | TITLE: GRAPHITE INSERT

ENG APPR.
MFG APPR.

INTERPRET GEOMETRIC TOLERANCING PER: | Q.A.
MATERIAL GRAPHITE | | SIZE B | DWG. NO. ThroatInsert | REV

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

NEXT ASSY | USED ON | NA FINISH

APPLICATION | DO NOT SCALE DRAWING | | SCALE: 1:1 | WEIGHT: | SHEET 1 OF 1

SOLIDWORKS Educational Product. For Instructional Use Only.
