Maeswoon/UNHSEDS/Engineering/2020-2021_PHANTOM/Propulsion/Banshee V1/PDF Drawing's/Swirl Atomizer.pdf

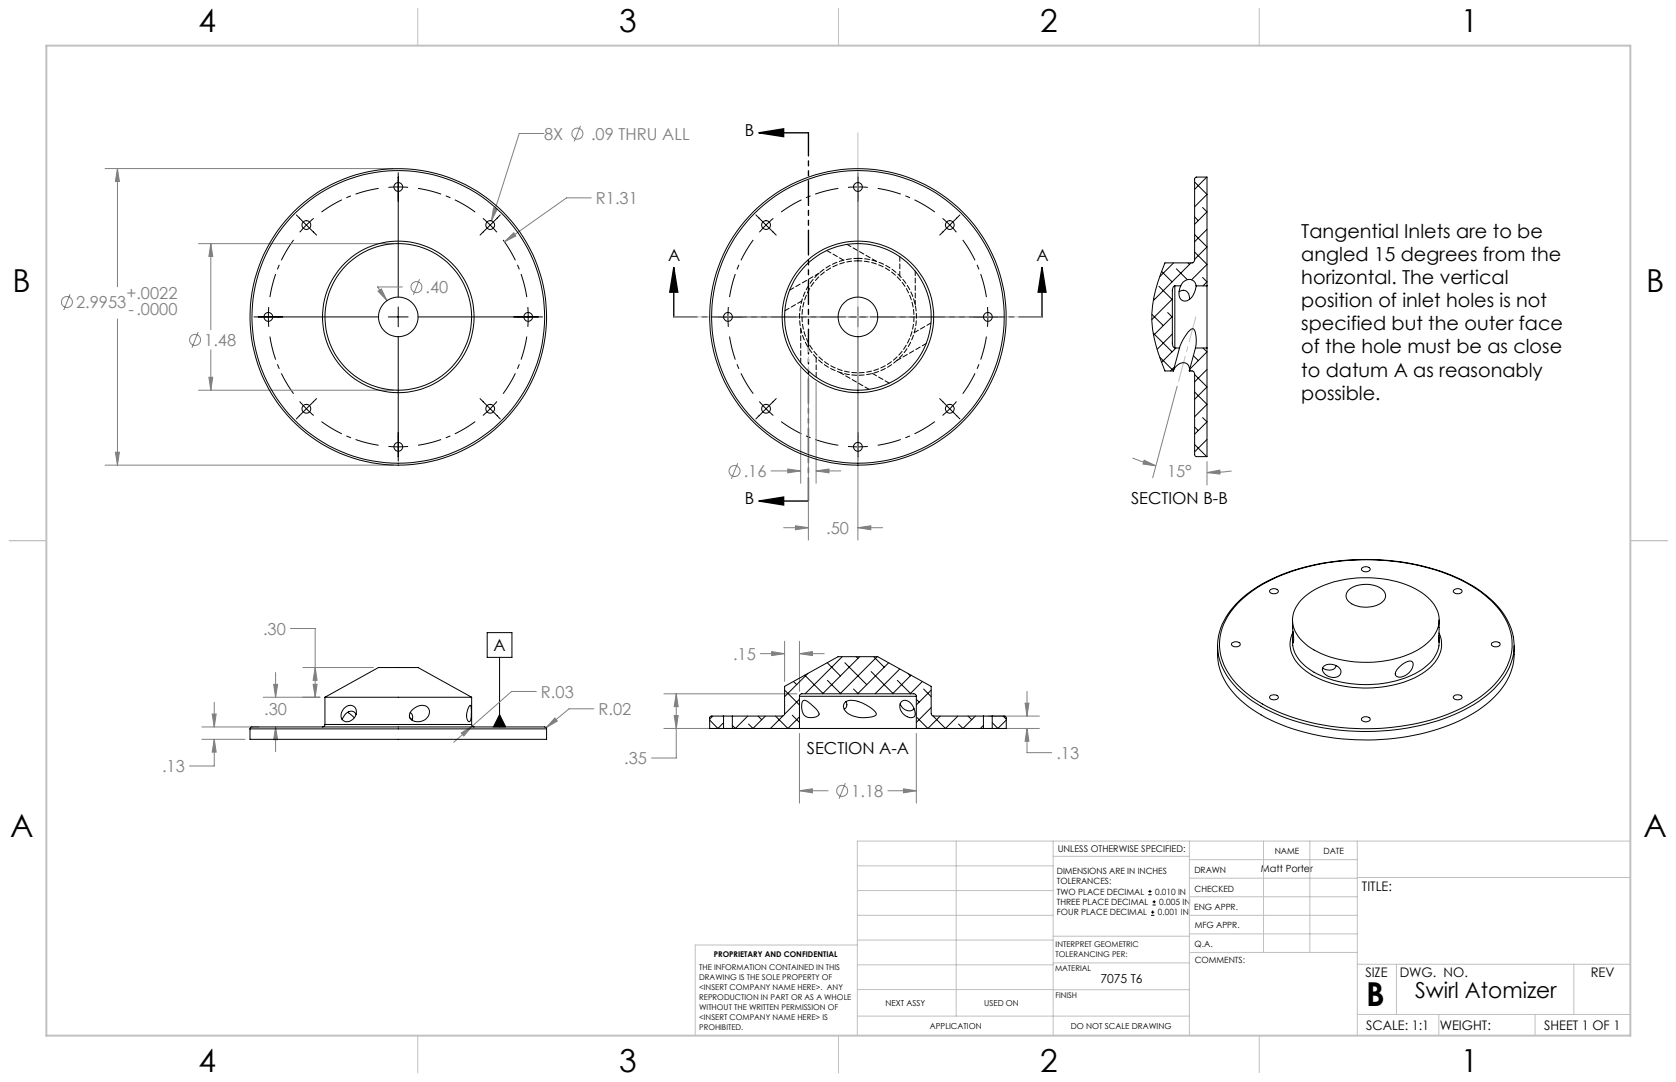
[picture p408: page 1]
.09 THRU ALL; SECTION B-B; .13 SECTION A-A

Tangential Inlets are to be
angled 15 degrees from the
horizontal. The vertical
position of inlet holes is not
specified but the outer face
of the hole must be as close
to datum A as reasonably
possible.

UNLESS OTHERWISE SPECIFIED: | | NAME | DATE
DIMENSIONS ARE IN INCHES TOLERANCES: TWO PLACE DECIMAL 0.010 IN THREE PLACE DECIMAL 0.005 IN FOUR PLACE DECIMAL 0.001 IN | DRAWN | Matt Porter

CHECKED | | | TITLE:

ENG APPR.
MFG APPR.

INTERPRET GEOMETRIC TOLERANCING PER: | Q.A.
MATERIAL 7075 T6 | | SIZE B | DWG. NO. Swirl Atomizer | REV

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

NEXT ASSY | USED ON | FINISH

APPLICATION | DO NOT SCALE DRAWING | | SCALE: 1:1 | WEIGHT: | SHEET 1 OF 1
