Maeswoon/UNHSEDS/Engineering/2020-2021_PHANTOM/Propulsion/Banshee V1/PDF Drawing's/Combustion Chamber w Insert.pdf

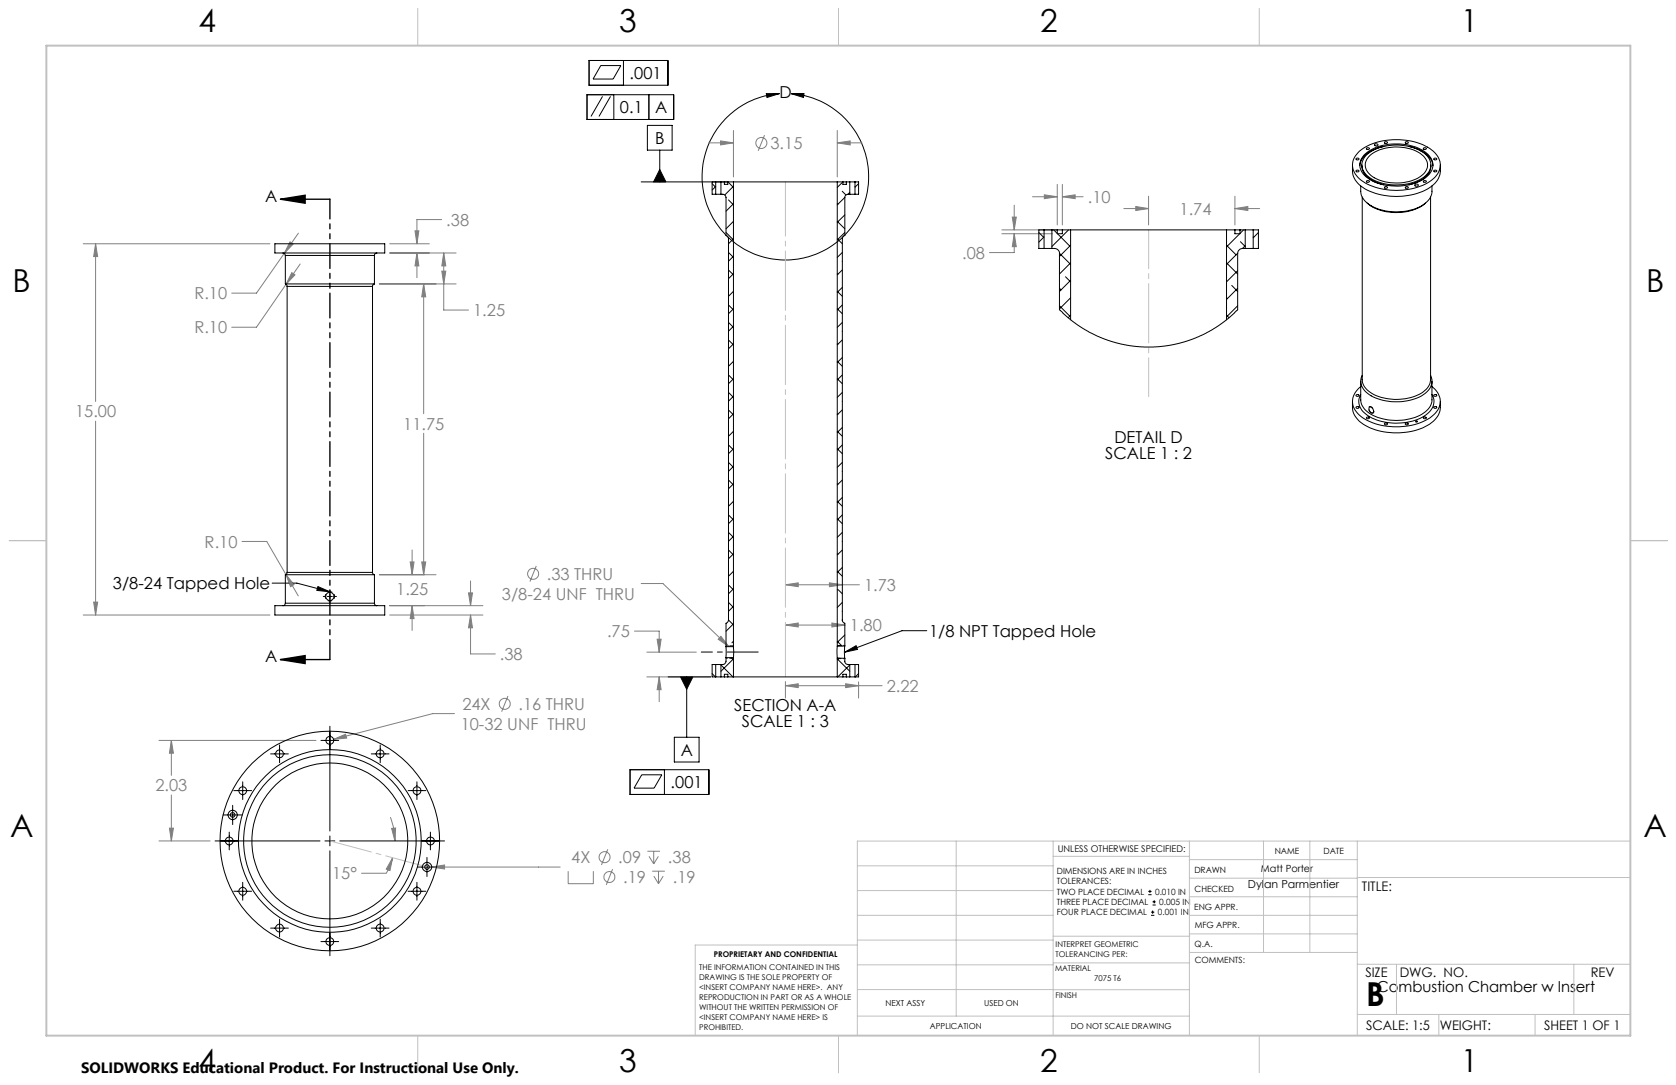
[picture p409: page 1]
3/8-24 Tapped Hole; .16 THRU; 10-32 UNF THRU; .33 THRU 3/8-24 UNF THRU; SECTION A-A SCALE 1 : 3; DETAIL D SCALE 1 : 2

1/8 NPT Tapped Hole

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

Dylan Parmentier CHECKED | | | TITLE:

ENG APPR.
MFG APPR.

INTERPRET GEOMETRIC TOLERANCING PER: | Q.A.
MATERIAL 7075 T6 | | SIZE B Combustion Chamber w Insert | DWG. NO. | REV

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

NEXT ASSY | USED ON | FINISH

APPLICATION | DO NOT SCALE DRAWING | | SCALE: 1:5 | WEIGHT: | SHEET 1 OF 1

SOLIDWORKS Educational Product. For Instructional Use Only.
