Maeswoon/UNHSEDS/Engineering/2019-2020_USURPER/Frame/SOLIDWORKS/drawings/Recovery Interface Bulk Plate.PDF

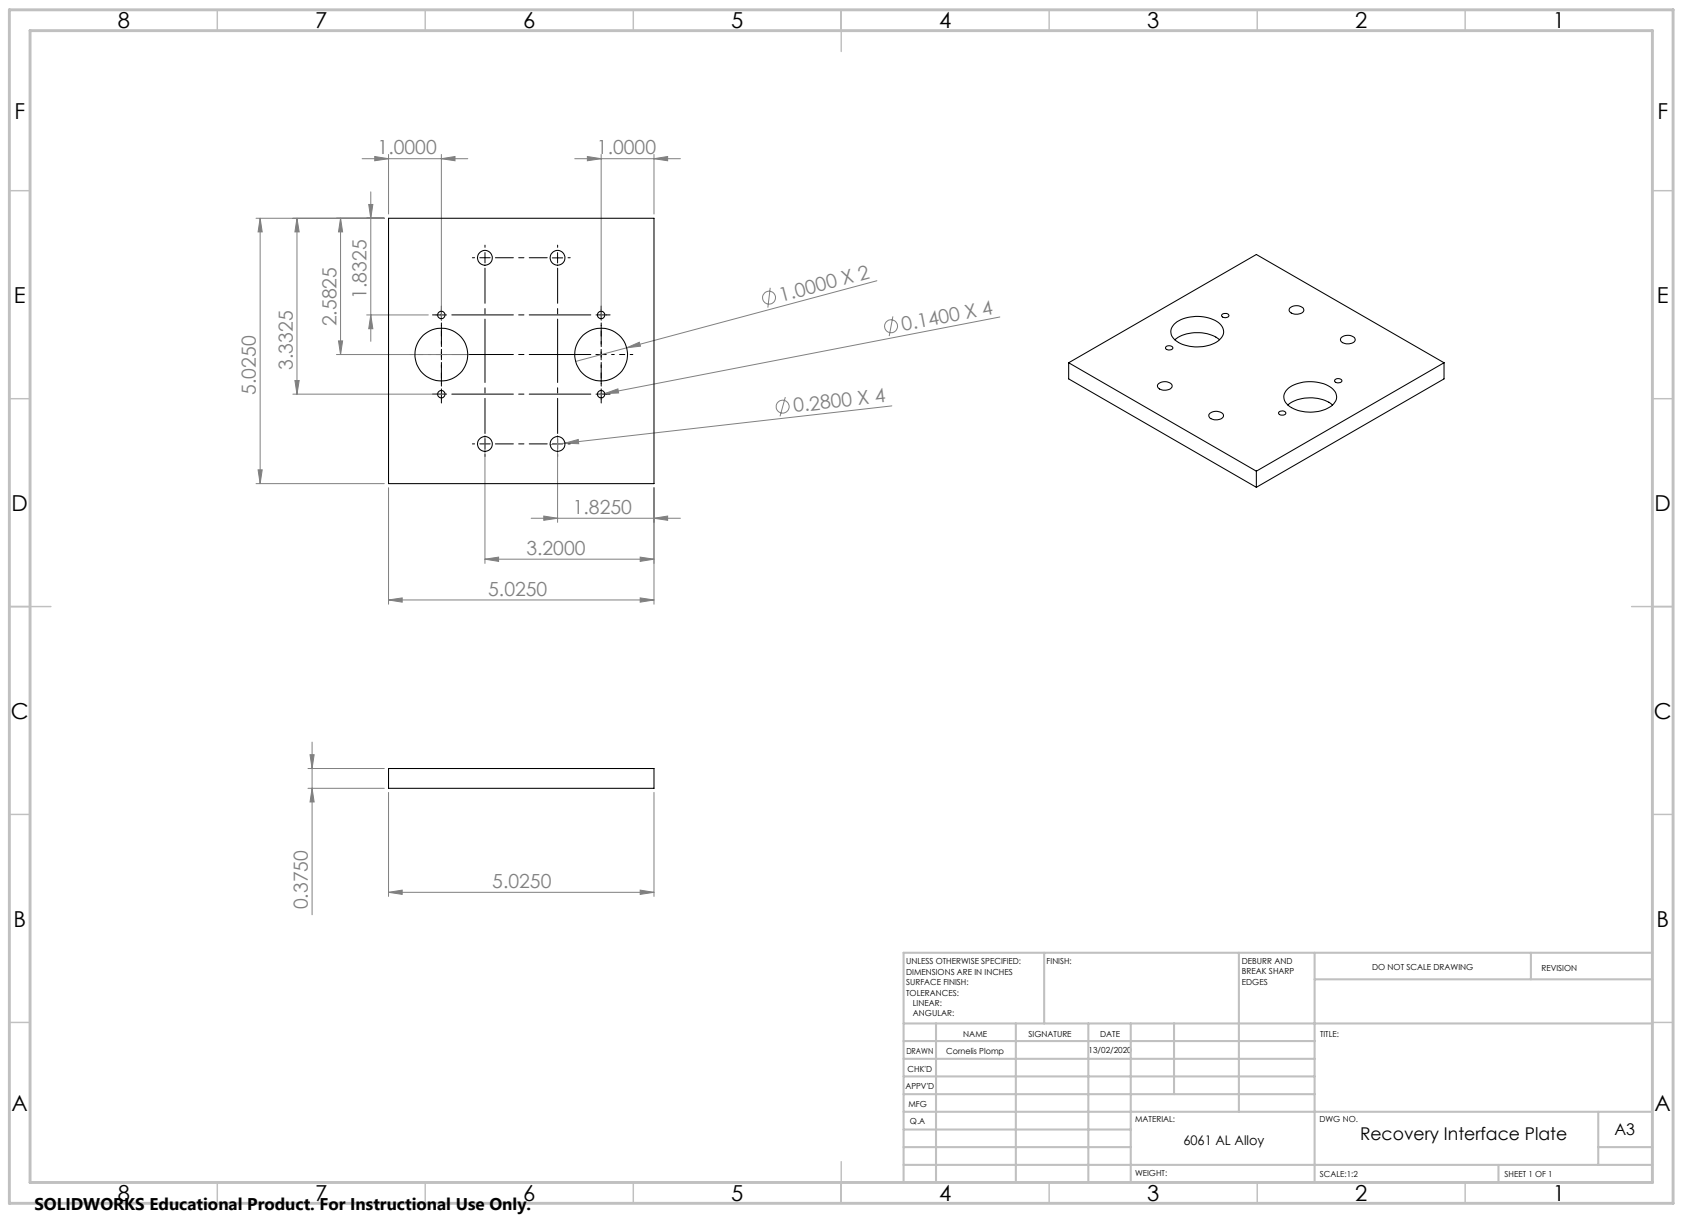
[picture p411: page 1]
FINISH:; DEBURR AND; BREAK SHARP; DO NOT SCALE DRAWING; REVISION; SCALE:1:2; SHEET 1 OF 1

UNLESS OTHERWISE SPECIFIED:
DIMENSIONS ARE IN INCHES
SURFACE FINISH:
TOLERANCES:
LINEAR:
ANGULAR:

NAME | SIGNATURE | DATE | | | | TITLE:

DRAWN | Cornelis Plomp | | 13/02/2020
CHK'D
APPV'D
MFG
Q.A | | | | MATERIAL: | DWG NO. Recovery Interface Plate | A3 6061 AL Alloy

SOLIDWORKS Educational Product. For Instructional Use Only.
