Maeswoon/UNHSEDS/Engineering/2019-2020_USURPER/Frame/SOLIDWORKS/drawings/Recovery Interface Plate.PDF

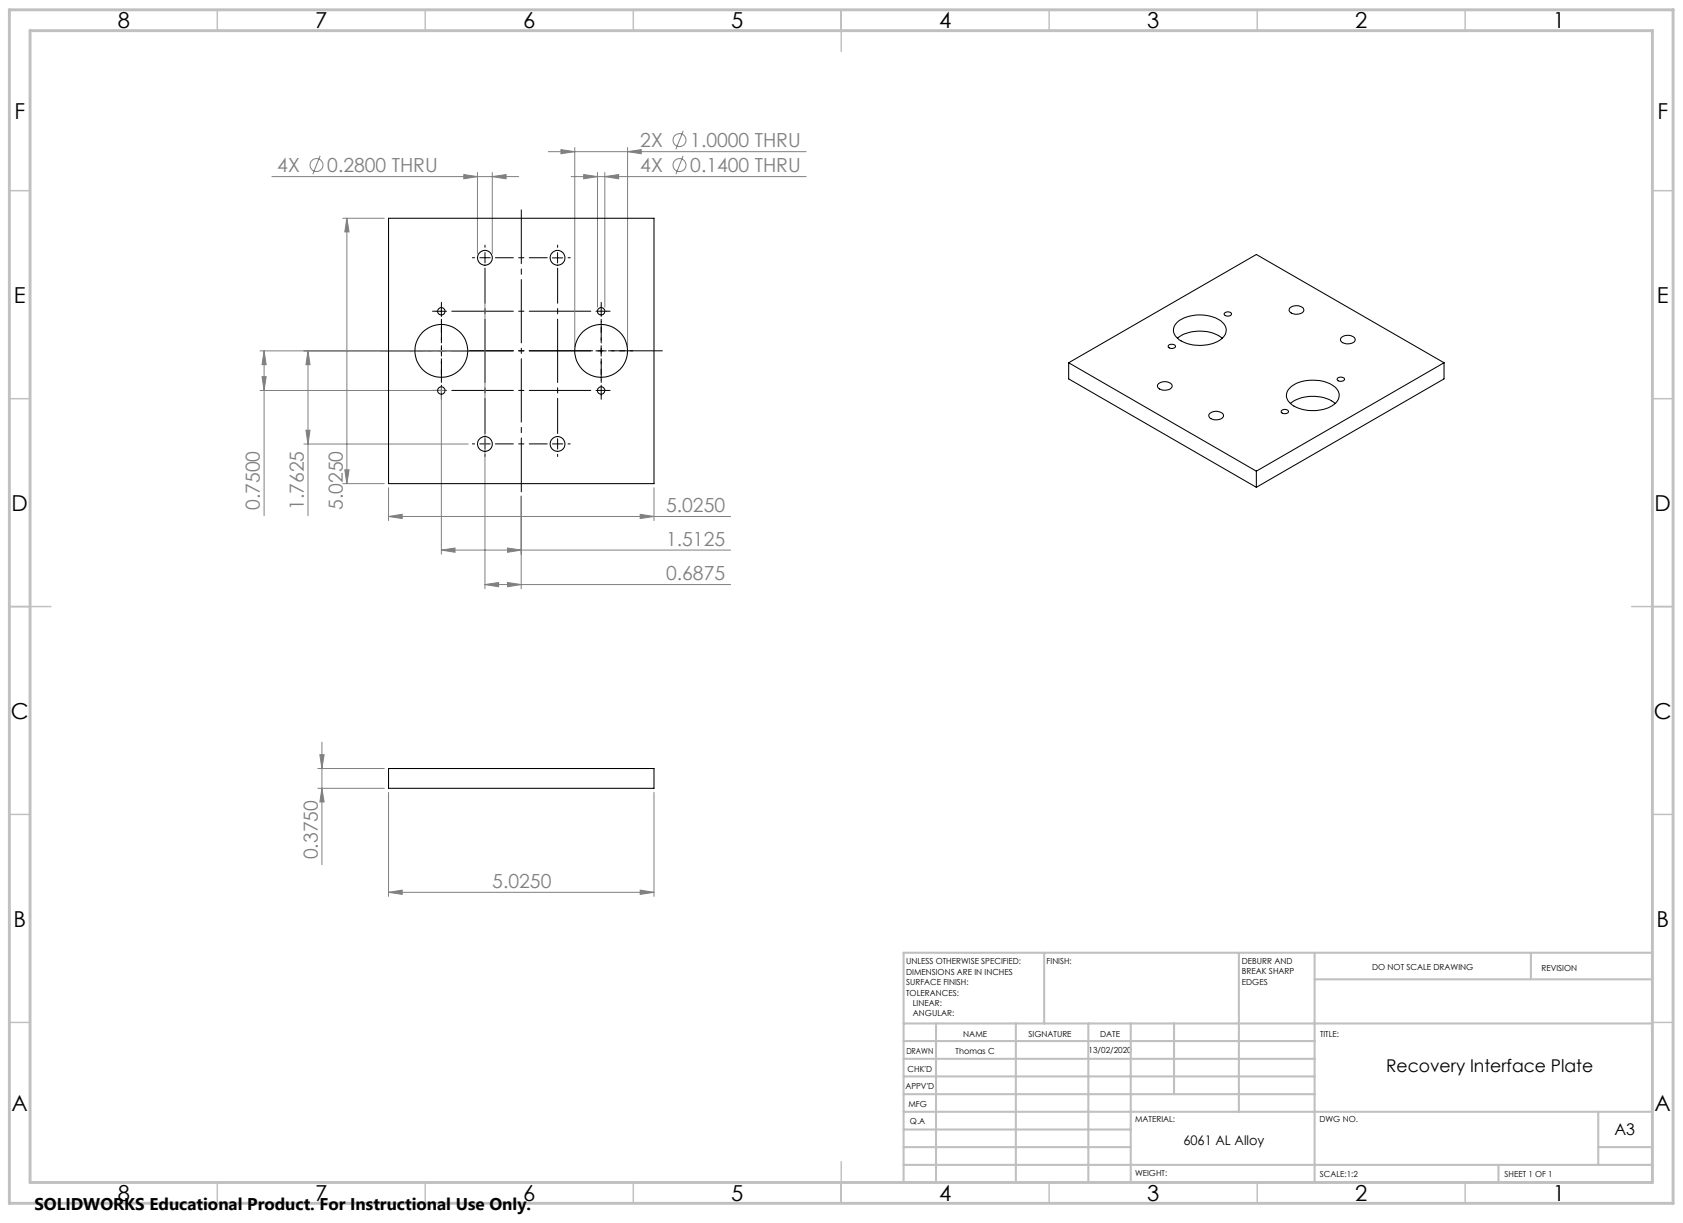
[picture p412: page 1]
2X 1.0000 THRU; 4X 0.2800 THRU; 4X 0.1400 THRU; FINISH:; DEBURR AND; BREAK SHARP; DO NOT SCALE DRAWING; REVISION; SCALE:1:2; SHEET 1 OF 1

UNLESS OTHERWISE SPECIFIED:
DIMENSIONS ARE IN INCHES
SURFACE FINISH:
TOLERANCES:
LINEAR:
ANGULAR:

NAME | SIGNATURE | DATE | | | | TITLE: Recovery Interface Plate

DRAWN | Thomas C | | 13/02/2020
CHK'D
APPV'D
MFG
Q.A | | | | MATERIAL: | DWG NO. | A3 6061 AL Alloy

SOLIDWORKS Educational Product. For Instructional Use Only.
