Maeswoon/UNHSEDS/Engineering/2019-2020_USURPER/Frame/SOLIDWORKS/Parts/Misc Parts/Fin stuff/Fin.PDF

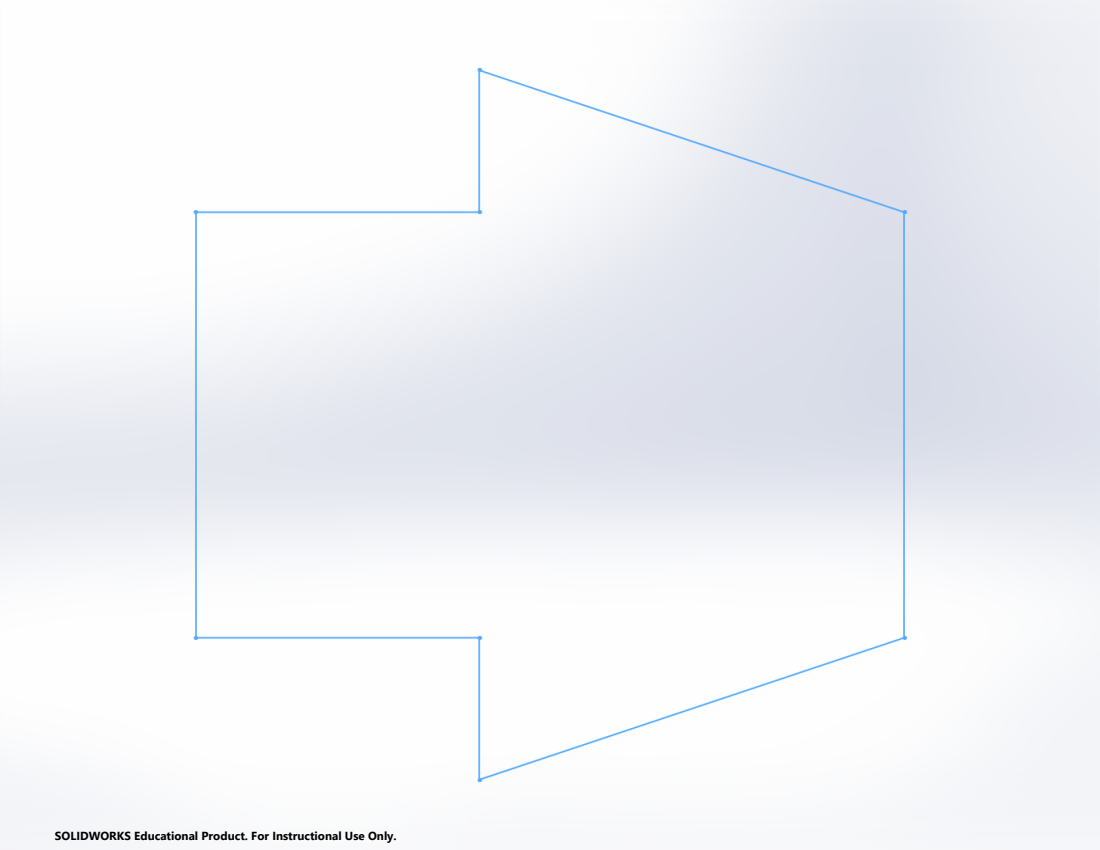
[picture p413: page 1]

SOLIDWORKS Educational Product. For Instructional Use Only.
