Maeswoon/UNHSEDS/(list of files, drawings)

Other design files:
Archive/Engineering/2019-2020_USURPER/Propulsion/Avionic Propulsion/Flow Regulation/Switching Circuit.ms14
Engineering/2019-2020_USURPER/Propulsion/Avionic Propulsion/Flow Regulation/Switching Circuit.ms14
