Maeswoon/UNHSEDS/Engineering/Avionics/Io-v2/Io-v2-Board/Io-v2-Board.kicad_pcb

## KiCad design Engineering/Avionics/Io-v2/Io-v2-Board/Io-v2-Board.kicad_pcb (2024-02-23)

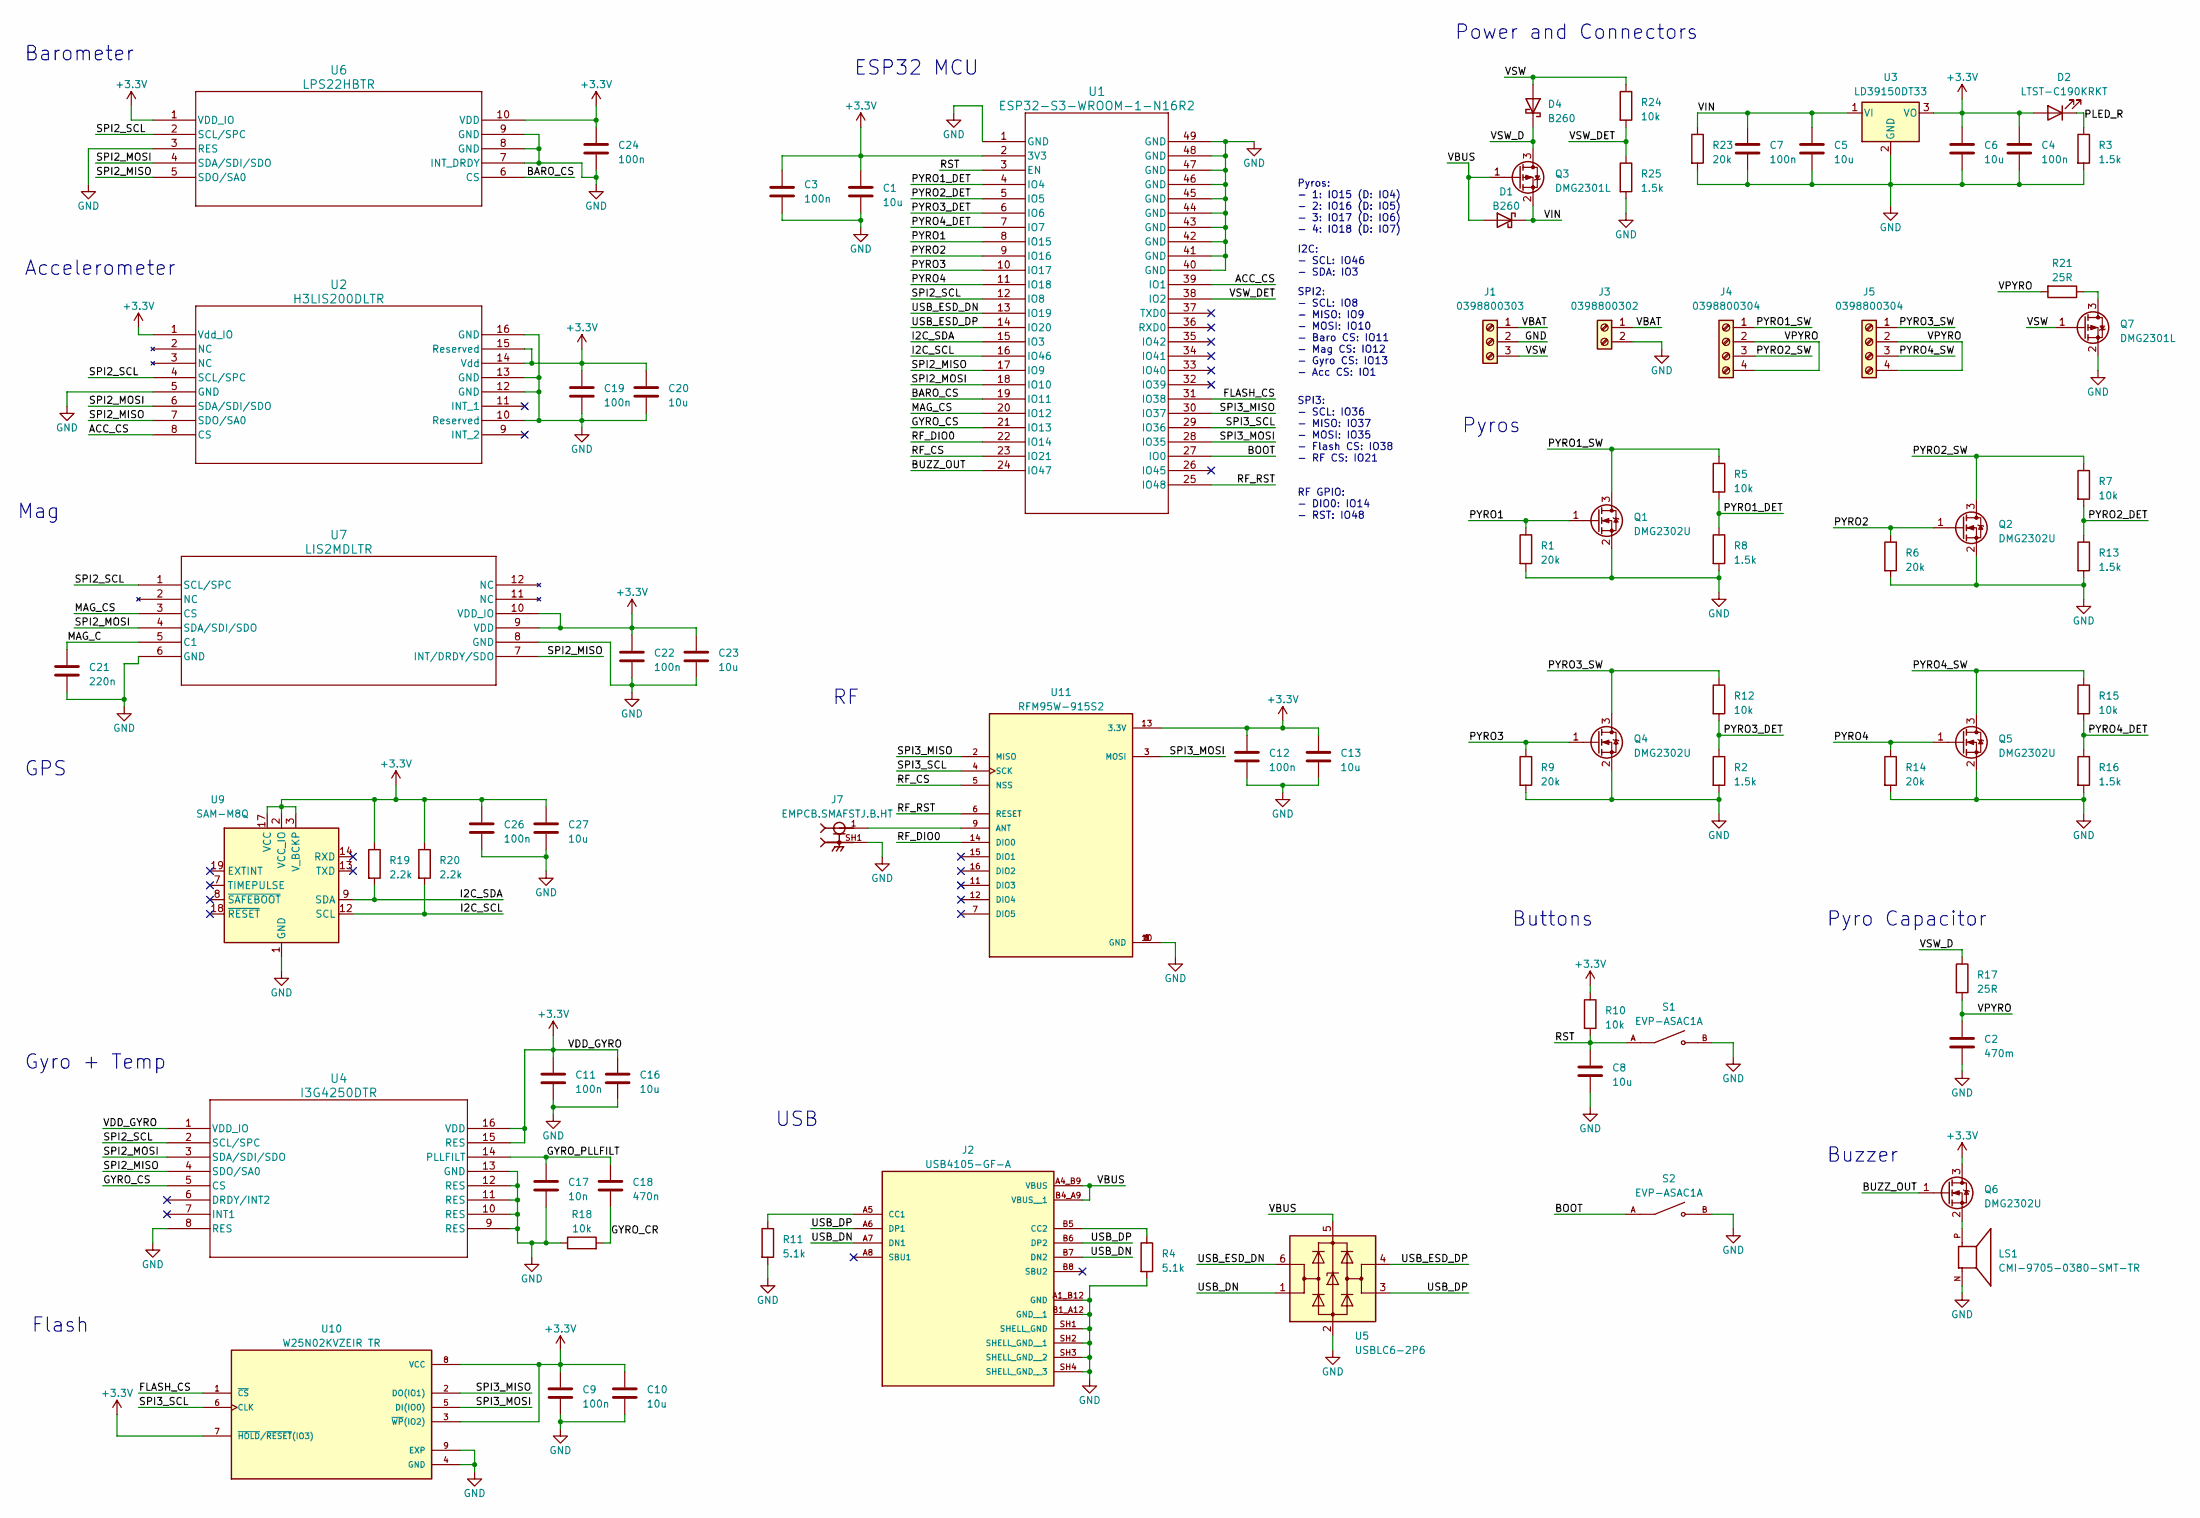
[picture p414: schematic Io-v2-Board.kicad_sch]

Parts:
C1, C5, C6, C8, C10, C13, C16, C20, C23, C27: 10u; C_0805_2012Metric
C2: 470m; PHV-5R4H474-R
C3, C4, C7, C9, C11, C12, C19, C22, C24, C26: 100n; C_0603_1608Metric
C17: 10n; C_0603_1608Metric
C18: 470n; C_0603_1608Metric
C21: 220n; C_0603_1608Metric
D1, D4: B260; D_SMB
D2: LTST-C190KRKT; LED_0603_1608Metric
J1: 0398800303
J2: USB4105-GF-A; GCT_USB4105-GF-A; PARTREV B3
J3: 0398800302
J4, J5: 0398800304
J7: EMPCB.SMAFSTJ.B.HT; TAOGLAS_EMPCB.SMAFSTJ.B.HT
LS1: CMI-9705-0380-SMT-TR; CUI_CMI-9705-0380-SMT-TR; PARTREV 1.0
Q1, Q2, Q4, Q5, Q6: DMG2302U; SOT-23
Q3, Q7: DMG2301L; SOT-23
R1, R6, R9, R14, R23: 20k; R_0402_1005Metric
R2, R3, R8, R13, R16, R25: 1.5k; R_0402_1005Metric
R4, R11: 5.1k; R_0402_1005Metric
R5, R7, R10, R12, R15, R18, R24: 10k; R_0402_1005Metric
R17, R21: 25R; R_0603_1608Metric
R19, R20: 2.2k; R_0402_1005Metric
S1, S2: EVP-ASAC1A; SW_EVP-ASAC1A; PARTREV 2022.4
U1: ESP32-S3-WROOM-1-N16R2; ESP32-S3-WROOM-1_EXP
U2: H3LIS200DLTR; TFLGA_S200DL_STM
U3: LD39150DT33; TO-252-3_TabPin2
U4: I3G4250DTR; LGA-16_4X4X1_STM
U5: USBLC6-2P6; SOT-666
U6: LPS22HBTR; HLGA10_2X2_STM
U7: LIS2MDLTR; LGA-12_2X2X1_STM
U9: SAM-M8Q; ublox_SAM-M8Q
U10: W25N02KVZEIR TR; WSON-8-1EP_8x6mm_P1.27mm_EP3.4x4.3mm; PARTREV G
U11: RFM95W-915S2

Connections:
+3.3V: C1.1, C3.1, C4.1, C6.1, C9.1, C10.1, C11.1, C12.1, C13.1, C16.1, C19.1, C20.1, C22.1, C23.1, C24.1, C26.1, C27.1, D2.2 (A), Q6.3 (D), R10.1, R19.1, R20.1, U1.2 (3V3), U2.1 (Vdd_IO), U2.14 (Vdd), U2.15 (Reserved), U3.3 (VO), U4.1 (VDD_IO), U4.15 (RES), U4.16 (VDD), U6.1 (VDD_IO), U6.10 (VDD), U7.9 (VDD), U7.10 (VDD_IO), U9.2 (VCC_IO), U9.3 (V_BCKP), U9.17 (VCC), U10.3 (~WP(IO2)), U10.7 (~HOLD/~RESET(IO3)), U10.8 (VCC), U11.13 (3.3V)
/ACC_CS: U1.39 (IO1), U2.8 (CS)
/BARO_CS: U1.19 (IO11), U6.6 (CS)
/BOOT: S2.A, U1.27 (IO0)
/BUZZ_OUT: Q6.1 (G), U1.24 (IO47)
/FLASH_CS: U1.31 (IO38), U10.1 (~CS)
/GYRO_CR: C18.2, R18.2
/GYRO_CS: U1.21 (IO13), U4.5 (CS)
/GYRO_PLLFILT: C17.1, C18.1, U4.14 (PLLFILT)
/I2C_SCL: R20.2, U1.16 (IO46), U9.12 (SCL)
/I2C_SDA: R19.2, U1.15 (IO3), U9.9 (SDA)
/MAG_C: C21.1, U7.5 (C1)
/MAG_CS: U1.20 (IO12), U7.3 (CS)
/PLED_R: D2.1 (K), R3.1
/PYRO1: Q1.1 (G), R1.1, U1.8 (IO15)
/PYRO1_DET: R5.2, R8.1, U1.4 (IO4)
/PYRO1_SW: J4.1, Q1.3 (D), R5.1
/PYRO2: Q2.1 (G), R6.1, U1.9 (IO16)
/PYRO2_DET: R7.2, R13.1, U1.5 (IO5)
/PYRO2_SW: J4.3, Q2.3 (D), R7.1
/PYRO3: Q4.1 (G), R9.1, U1.10 (IO17)
/PYRO3_DET: R2.1, R12.2, U1.6 (IO6)
/PYRO3_SW: J5.1, Q4.3 (D), R12.1
/PYRO4: Q5.1 (G), R14.1, U1.11 (IO18)
/PYRO4_DET: R15.2, R16.1, U1.7 (IO7)
/PYRO4_SW: J5.3, Q5.3 (D), R15.1
/RF_CS: U1.23 (IO21), U11.5 (NSS)
/RF_DIO0: U1.22 (IO14), U11.14 (DIO0)
/RF_RST: U1.25 (IO48), U11.6 (RESET)
/RST: C8.1, R10.2, S1.A, U1.3 (EN)
/SPI2_MISO: U1.17 (IO9), U2.7 (SDO/SA0), U4.4 (SDO/SA0), U6.5 (SDO/SA0), U7.7 (INT/DRDY/SDO)
/SPI2_MOSI: U1.18 (IO10), U2.6 (SDA/SDI/SDO), U4.3 (SDA/SDI/SDO), U6.4 (SDA/SDI/SDO), U7.4 (SDA/SDI/SDO)
/SPI2_SCL: U1.12 (IO8), U2.4 (SCL/SPC), U4.2 (SCL/SPC), U6.2 (SCL/SPC), U7.1 (SCL/SPC)
/SPI3_MISO: U1.30 (IO37), U10.2 (DO(IO1)), U11.2 (MISO)
/SPI3_MOSI: U1.28 (IO35), U10.5 (DI(IO0)), U11.3 (MOSI)
/SPI3_SCL: U1.29 (IO36), U10.6 (CLK), U11.4 (SCK)
/USB_DN: J2.A7 (DN1), J2.B7 (DN2), U5.1 (I/O1)
/USB_DP: J2.A6 (DP1), J2.B6 (DP2), U5.3 (I/O2)
/USB_ESD_DN: U1.13 (IO19), U5.6 (I/O1)
/USB_ESD_DP: U1.14 (IO20), U5.4 (I/O2)
/VBAT: J1.1, J3.1
/VBUS: D1.2 (A), J2.A4_B9 (VBUS), J2.B4_A9 (VBUS__1), Q3.1 (G), U5.5 (VBUS)
/VIN: C5.1, C7.1, D1.1 (K), Q3.2 (S), R23.1, U3.1 (VI)
/VPYRO: C2.1, J4.2, J4.4, J5.2, J5.4, R17.2, R21.2
/VSW: D4.2 (A), J1.3, Q7.1 (G), R24.1
/VSW_D: D4.1 (K), Q3.3 (D), R17.1
/VSW_DET: R24.2, R25.1, U1.38 (IO2)
GND: C1.2, C2.2, C3.2, C4.2, C5.2, C6.2, C7.2, C8.2, C9.2, C10.2, C11.2, C12.2, C13.2, C16.2, C17.2, C19.2, C20.2, C21.2, C22.2, C23.2, C24.2, C26.2, C27.2, J1.2, J2.A1_B12 (GND), J2.B1_A12 (GND__1), J2.SH1 (SHELL_GND), J2.SH2 (SHELL_GND__1), J2.SH3 (SHELL_GND__2), J2.SH4 (SHELL_GND__3), J3.2, J7.SH1, J7.SH2, J7.SH3, J7.SH4, LS1.N, Q1.2 (S), Q2.2 (S), Q4.2 (S), Q5.2 (S), Q7.2 (S), R1.2, R2.2, R3.2, R4.2, R6.2, R8.2, R9.2, R11.2, R13.2, R14.2, R16.2, R18.1, R23.2, R25.2, S1.B, S2.B, U1.1 (GND), U1.40 (GND), U1.41 (GND), U1.42 (GND), U1.43 (GND), U1.44 (GND), U1.45 (GND), U1.46 (GND), U1.47 (GND), U1.48 (GND), U1.49 (GND), U2.5 (GND), U2.10 (Reserved), U2.12 (GND), U2.13 (GND), U2.16 (GND), U3.2 (GND), U4.8 (RES), U4.9 (RES), U4.10 (RES), U4.11 (RES), U4.12 (RES), U4.13 (GND), U5.2 (GND), U6.3 (RES), U6.7 (INT_DRDY), U6.8 (GND), U6.9 (GND), U7.6 (GND), U7.8 (GND), U9.1 (GND), U9.4 (GND), U9.5 (GND), U9.6 (GND), U9.10 (GND), U9.11 (GND), U9.15 (GND), U9.16 (GND), U9.20 (GND), U10.4 (GND), U10.9 (EXP), U11.1 (GND), U11.8 (GND), U11.10 (GND)
unnamed: J2.A5 (CC1), R11.1
unnamed: J2.B5 (CC2), R4.1
unnamed: LS1.P, Q6.2 (S)
unnamed: Q7.3 (D), R21.1
unnamed: J7.1, U11.9 (ANT)

Notes on the sheet:
SPI2: - SCL: IO8 - MISO: IO9 - MOSI: IO10 - Baro CS: IO11 - Mag CS: IO12 - Gyro CS: IO13 - Acc CS: IO1
Flash
RF GPIO: - DIO0: IO14 - RST: IO48
Mag
GPS
Accelerometer
Pyros: - 1: IO15 (D: IO4) - 2: IO16 (D: IO5) - 3: IO17 (D: IO6) - 4: IO18 (D: IO7)
USB
Buttons
Pyro Capacitor
I2C: - SCL: IO46 - SDA: IO3
Buzzer
ESP32 MCU
SPI3: - SCL: IO36 - MISO: IO37 - MOSI: IO35 - Flash CS: IO38 - RF CS: IO21
Barometer
Power and Connectors
Pyros
Gyro + Temp

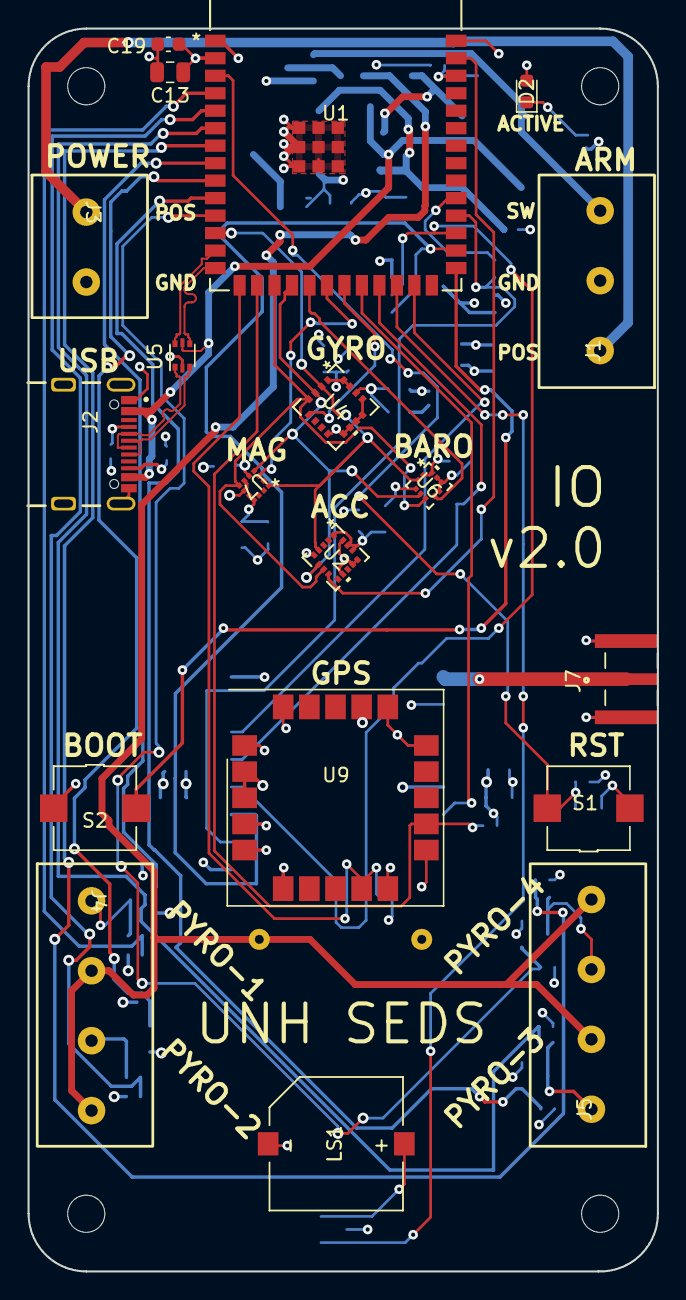
[picture p415: board Io-v2-Board.kicad_pcb from above]

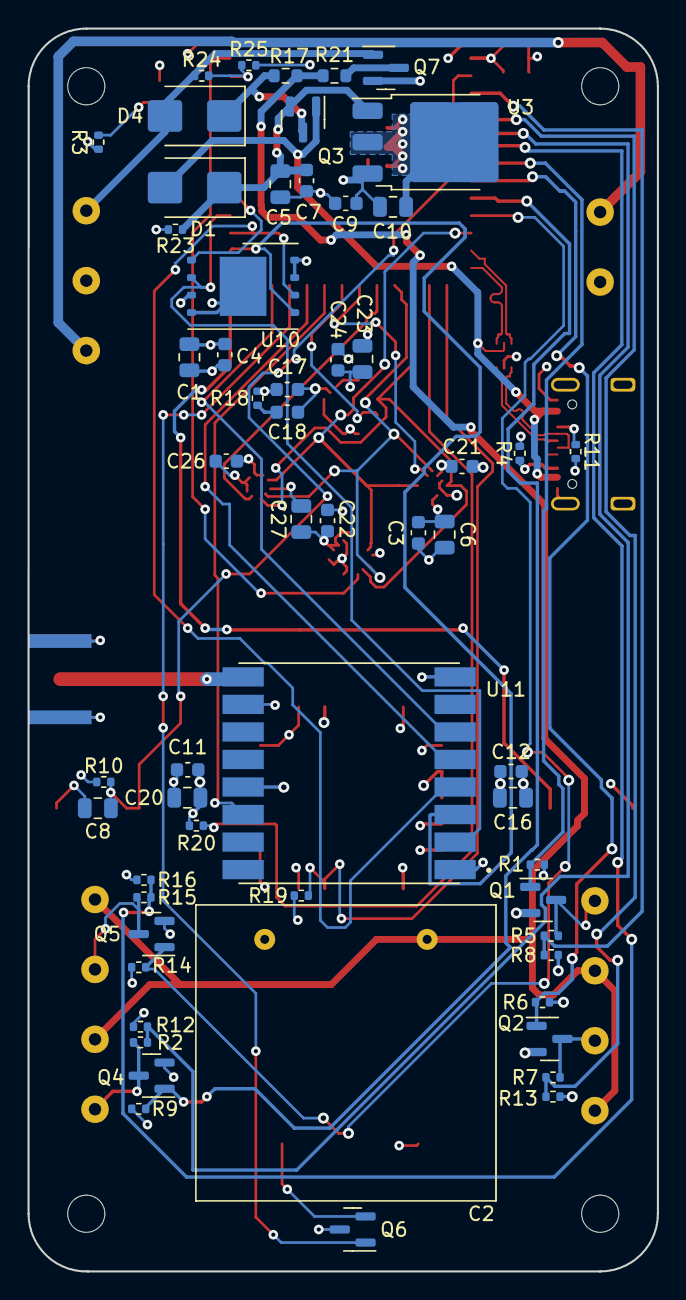
[picture p416: board Io-v2-Board.kicad_pcb from below]

Board: 4 copper layers, 45.7 x 90.3 mm, 81 parts (58 on the bottom side), 53 nets.

Other parts of the board:
H1, H2, H3, H4: MountingHole_2.7mm_M2.5_DIN965
