Maeswoon/UNHSEDS/Engineering/2022-2023 Rocket/Avionics/Io_Design/Io.kicad_pcb

## KiCad design Engineering/2022-2023 Rocket/Avionics/Io_Design/Io.kicad_pcb (2023-03-27)

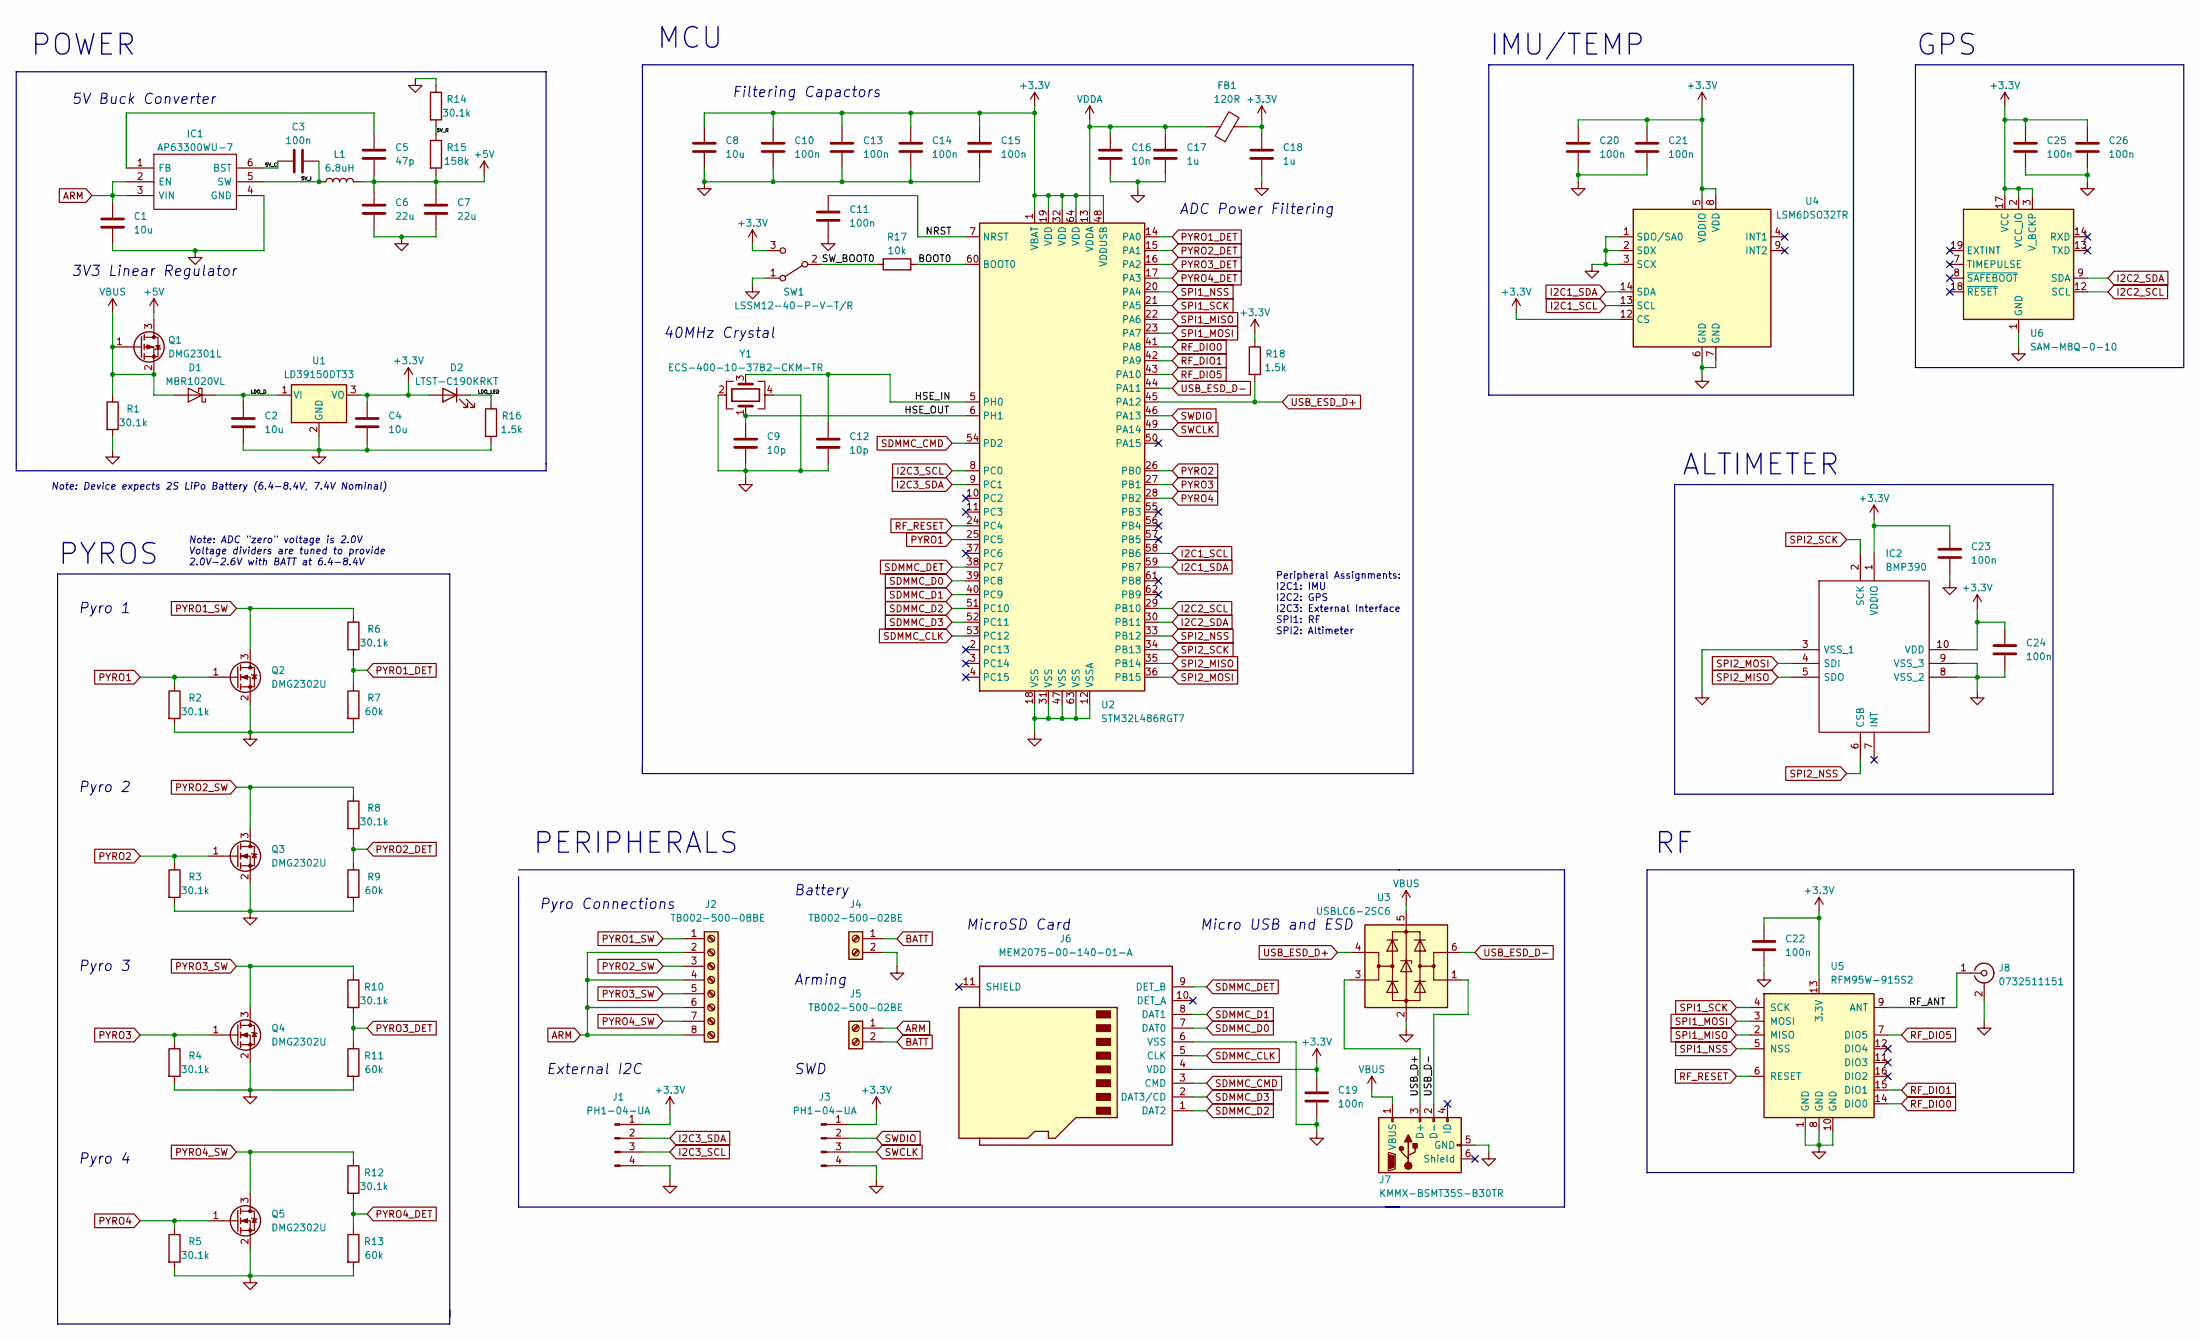
[picture p417: schematic Io.kicad_sch, Io Flight Computer]

Parts:
C1, C2, C4, C8: 10u; C_0603_1608Metric
C3, C10, C11, C13, C14, C15, C19, C20, C21, C22, C23, C24, C25, C26: 100n; C_0402_1005Metric
C5: 47p; C_0402_1005Metric
C6, C7: 22u; C_0603_1608Metric
C9, C12: 10p; C_0402_1005Metric
C16: 10n; C_0402_1005Metric
C17, C18: 1u; C_0402_1005Metric
D1: MBR1020VL; D_SOD-123F
D2: LTST-C190KRKT; LED_0603_1608Metric
FB1: 120R; L_0201_0603Metric
IC1: AP63300WU-7; TSOT-23-6; Mouser Part Number 621-AP63300WU-7
IC2: BMP390; Mouser Part Number 262-BMP390
J1, J3: PH1-04-UA; PinHeader_1x04_P2.54mm_Vertical
J2: TB002-500-08BE; TerminalBlock_TE_282834-8_1x08_P2.54mm_Horizontal
J4, J5: TB002-500-02BE; TerminalBlock_TE_282834-2_1x02_P2.54mm_Horizontal
J6: MEM2075-00-140-01-A
J7: KMMX-BSMT35S-B30TR; KMMXBSMT35SB30TR
J8: 0732511151; SMA_Molex_73251-1153_EdgeMount_Horizontal
L1: 6.8uH; L_Bourns_SRR1260
Q1: DMG2301L; SOT-23
Q2, Q3, Q4, Q5: DMG2302U; SOT-23
R1, R2, R3, R4, R5, R6, R8, R10, R12, R14: 30.1k; R_0402_1005Metric
R7, R9, R11, R13: 60k; R_0603_1608Metric
R15: 158k; R_0805_2012Metric
R16, R18: 1.5k; R_0402_1005Metric
R17: 10k; R_0402_1005Metric
SW1: LSSM12-40-P-V-T/R; LSSM1240PVTR
U1: LD39150DT33; TO-252-3_TabPin2
U2: STM32L486RGT7; LQFP-64_10x10mm_P0.5mm
U3: USBLC6-2SC6; SOT-23-6
U4: LSM6DSO32TR; LGA-14_3x2.5mm_P0.5mm_LayoutBorder3x4y
U5: RFM95W-915S2
U6: SAM-M8Q-0-10; ublox_SAM-M8Q
Y1: ECS-400-10-37B2-CKM-TR; Crystal_SMD_2016-4Pin_2.0x1.6mm

Connections:
+3.3V: C4.1, C8.1, C10.1, C13.1, C14.1, C15.1, C18.1, C19.1, C20.1, C21.1, C22.1, C23.1, C24.1, C25.1, C26.1, D2.2 (A), FB1.2, IC2.1 (VDDIO), IC2.10 (VDD), J1.1, J3.1, J6.4 (VDD), R18.1, SW1.3 (C), U1.3 (VO), U2.1 (VBAT), U2.19 (VDD), U2.32 (VDD), U2.48 (VDDUSB), U2.64 (VDD), U4.5 (VDDIO), U4.8 (VDD), U4.12 (CS), U5.13 (3.3V), U6.2 (VCC_IO), U6.3 (V_BCKP), U6.17 (VCC)
+5V: C5.2, C6.1, C7.1, L1.2, Q1.3 (D), R15.2
/5V_C: C3.2, IC1.6 (BST)
/5V_I: C3.1, IC1.5 (SW), L1.1
/5V_R: R14.2, R15.1
/BOOT0: R17.2, U2.60 (BOOT0)
/HSE_IN: C12.1, U2.5 (PH0), Y1.3
/HSE_OUT: C9.1, U2.6 (PH1), Y1.1
/LDO_D: C2.1, D1.1 (K), U1.1 (VI)
/LDO_LED: D2.1 (K), R16.1
/NRST: C11.1, U2.7 (NRST)
/RF_ANT: J8.1 (In), U5.9 (ANT)
/SW_BOOT0: R17.1, SW1.2 (B)
/USB_D+: J7.3 (D+), U3.3 (I/O2)
/USB_D-: J7.2 (D-), U3.1 (I/O1)
ARM: C1.1, IC1.2 (EN), IC1.3 (VIN), J2.2, J2.4, J2.6, J2.8, J5.1
BATT: J4.1, J5.2
GND: C1.2, C2.2, C4.2, C6.2, C7.2, C8.2, C9.2, C10.2, C11.2, C12.2, C13.2, C14.2, C15.2, C16.2, C17.2, C18.2, C19.2, C20.2, C21.2, C22.2, C23.2, C24.2, C25.2, C26.2, IC1.4 (GND), IC2.3 (VSS_1), IC2.8 (VSS_2), IC2.9 (VSS_3), J1.4, J3.4, J4.2, J6.6 (VSS), J7.5 (GND), J8.2 (Ext), Q2.2 (S), Q3.2 (S), Q4.2 (S), Q5.2 (S), R1.2, R2.2, R3.2, R4.2, R5.2, R7.2, R9.2, R11.2, R13.2, R14.1, R16.2, SW1.1 (A), U1.2 (GND), U2.12 (VSSA), U2.18 (VSS), U2.31 (VSS), U2.47 (VSS), U2.63 (VSS), U3.2 (GND), U4.1 (SDO/SA0), U4.2 (SDX), U4.3 (SCX), U4.6 (GND), U4.7 (GND), U5.1 (GND), U5.8 (GND), U5.10 (GND), U6.1 (GND), U6.4 (GND), U6.5 (GND), U6.6 (GND), U6.10 (GND), U6.11 (GND), U6.15 (GND), U6.16 (GND), U6.20 (GND), Y1.2, Y1.4; also elsewhere on the board
I2C1_SCL: U2.58 (PB6), U4.13 (SCL)
I2C1_SDA: U2.59 (PB7), U4.14 (SDA)
I2C2_SCL: U2.29 (PB10), U6.12 (SCL)
I2C2_SDA: U2.30 (PB11), U6.9 (SDA)
I2C3_SCL: J1.3, U2.8 (PC0)
I2C3_SDA: J1.2, U2.9 (PC1)
unnamed: C5.1, IC1.1 (FB)
PYRO1: Q2.1 (G), R2.1, U2.25 (PC5)
PYRO1_DET: R6.2, R7.1, U2.14 (PA0)
PYRO1_SW: J2.1, Q2.3 (D), R6.1
PYRO2: Q3.1 (G), R3.1, U2.26 (PB0)
PYRO2_DET: R8.2, R9.1, U2.15 (PA1)
PYRO2_SW: J2.3, Q3.3 (D), R8.1
PYRO3: Q4.1 (G), R4.1, U2.27 (PB1)
PYRO3_DET: R10.2, R11.1, U2.16 (PA2)
PYRO3_SW: J2.5, Q4.3 (D), R10.1
PYRO4: Q5.1 (G), R5.1, U2.28 (PB2)
PYRO4_DET: R12.2, R13.1, U2.17 (PA3)
PYRO4_SW: J2.7, Q5.3 (D), R12.1
RF_DIO0: U2.41 (PA8), U5.14 (DIO0)
RF_DIO1: U2.42 (PA9), U5.15 (DIO1)
RF_DIO5: U2.43 (PA10), U5.7 (DIO5)
RF_RESET: U2.24 (PC4), U5.6 (RESET)
SDMMC_CLK: J6.5 (CLK), U2.53 (PC12)
SDMMC_CMD: J6.3 (CMD), U2.54 (PD2)
SDMMC_D0: J6.7 (DAT0), U2.39 (PC8)
SDMMC_D1: J6.8 (DAT1), U2.40 (PC9)
SDMMC_D2: J6.1 (DAT2), U2.51 (PC10)
SDMMC_D3: J6.2 (DAT3/CD), U2.52 (PC11)
SDMMC_DET: J6.9 (DET_B), U2.38 (PC7)
SPI1_MISO: U2.22 (PA6), U5.2 (MISO)
SPI1_MOSI: U2.23 (PA7), U5.3 (MOSI)
SPI1_NSS: U2.20 (PA4), U5.5 (NSS)
SPI1_SCK: U2.21 (PA5), U5.4 (SCK)
SPI2_MISO: IC2.5 (SDO), U2.35 (PB14)
SPI2_MOSI: IC2.4 (SDI), U2.36 (PB15)
SPI2_NSS: IC2.6 (CSB), U2.33 (PB12)
SPI2_SCK: IC2.2 (SCK), U2.34 (PB13)
SWCLK: J3.3, U2.49 (PA14)
SWDIO: J3.2, U2.46 (PA13)
USB_ESD_D+: R18.2, U2.45 (PA12), U3.4 (I/O2)
USB_ESD_D-: U2.44 (PA11), U3.6 (I/O1)
VBUS: D1.2 (A), J7.1 (VBUS), Q1.1 (G), Q1.2 (S), R1.1, U3.5 (VBUS)
VDDA: C16.1, C17.1, FB1.1, U2.13 (VDDA)

Notes on the sheet:
Battery
Pyro Connections
Pyro 2
3V3 Linear Regulator
Filtering Capactors
5V Buck Converter
MicroSD Card
Micro USB and ESD
Pyro 1
MCU
PYROS
ADC Power Filtering
ALTIMETER
40MHz Crystal
GPS
Arming
PERIPHERALS
Peripheral Assignments: I2C1: IMU I2C2: GPS I2C3: External Interface SPI1: RF SPI2: Altimeter
Pyro 3
Note: ADC "zero" voltage is 2.0V Voltage dividers are tuned to provide 2.0V-2.6V with BATT at 6.4-8.4V
Note: Device expects 2S LiPo Battery (6.4-8.4V, 7.4V Nominal)
External I2C
POWER
IMU/TEMP
Pyro 4
SWD

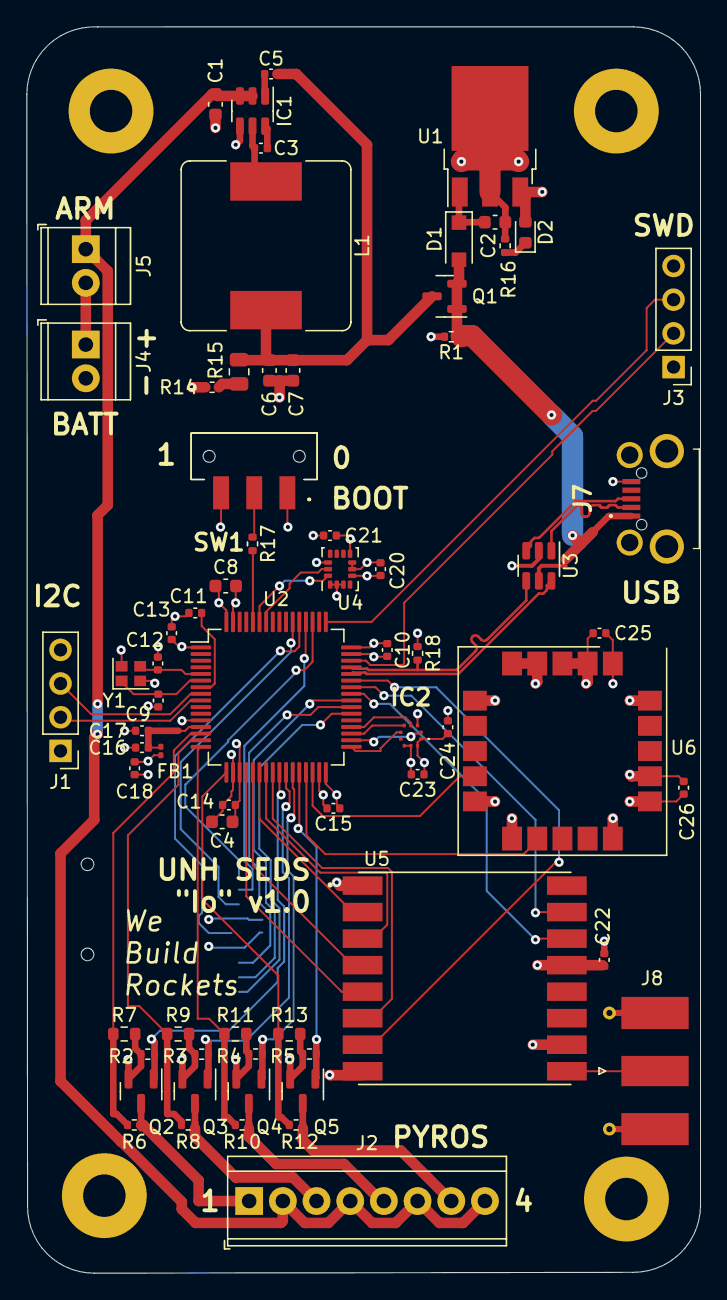
[picture p418: board Io.kicad_pcb from above]

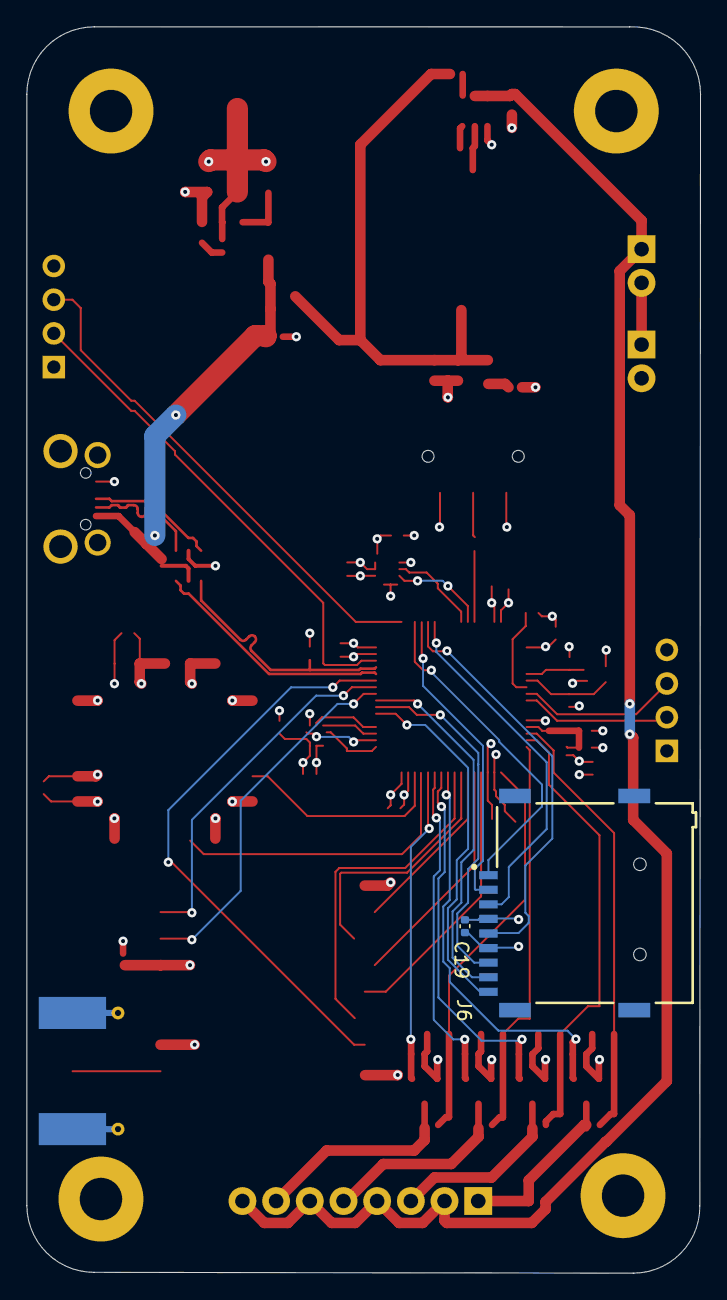
[picture p419: board Io.kicad_pcb from below]

Board: 4 copper layers, 50.8 x 94.0 mm, 75 parts (2 on the bottom side), 62 nets.

Other parts of the board:
H1, H2, H3, H4: MountingHole_3.2mm_M3_Pad

Their connections:
GND: H1.1, H2.1, H3.1, H4.1; also elsewhere on the board
