Maeswoon/UNHSEDS/Engineering/2022-2023 Rocket/Avionics/Io_Development/Core/Src/main.c

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
/* Includes ------------------------------------------------------------------*/
#include "main.h"
#include "fatfs.h"

ADC_HandleTypeDef hadc1;
DMA_HandleTypeDef hdma_adc1;

I2C_HandleTypeDef hi2c1;
I2C_HandleTypeDef hi2c2;

UART_HandleTypeDef hlpuart1;

SD_HandleTypeDef hsd1;

SPI_HandleTypeDef hspi1;
SPI_HandleTypeDef hspi2;

PCD_HandleTypeDef hpcd_USB_OTG_FS;

/* USER CODE BEGIN PV */
uint32_t pyro_adc[4] = {0};
uint32_t gps_lat = 0, gps_lon = 0;
uint32_t imu_yaw = 0, imu_pitch = 0, imu_roll = 0;
/* USER CODE END PV */

void SystemClock_Config(void);
void PeriphCommonClock_Config(void);
static void MX_GPIO_Init(void);
static void MX_DMA_Init(void);
static void MX_I2C1_Init(void);
static void MX_I2C2_Init(void);
static void MX_SDMMC1_SD_Init(void);
static void MX_SPI1_Init(void);
static void MX_SPI2_Init(void);
static void MX_USB_OTG_FS_PCD_Init(void);
static void MX_ADC1_Init(void);
static void MX_LPUART1_UART_Init(void);
/**
  * @brief  The application entry point.
  * @retval int
  */
int main(void)
{
  /* MCU Configuration--------------------------------------------------------*/

  /* Reset of all peripherals, Initializes the Flash interface and the Systick. */
  HAL_Init();

  /* Configure the system clock */
  SystemClock_Config();

/* Configure the peripherals common clocks */
  PeriphCommonClock_Config();

  /* Initialize all configured peripherals */
  MX_GPIO_Init();
  MX_DMA_Init();
  MX_I2C1_Init();
  MX_I2C2_Init();
  MX_SDMMC1_SD_Init();
  MX_SPI1_Init();
  MX_SPI2_Init();
  MX_FATFS_Init();
  MX_USB_OTG_FS_PCD_Init();
  MX_ADC1_Init();
  MX_LPUART1_UART_Init();
  /* Infinite loop */
  /* USER CODE BEGIN WHILE */
  const char telemetry_msg[100] = {0};
  HAL_ADC_Start_DMA(&hadc1, pyro_adc, 4);
  while (1) {
	  HAL_Delay(1000);
  	  HAL_ADC_Start_DMA(&hadc1, pyro_adc, 4);
    /* USER CODE END WHILE */

    /* USER CODE BEGIN 3 */
  }
  /* USER CODE END 3 */
}

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
/* USER CODE BEGIN 4 */
void HAL_ADC_ConvHalfCpltCallback(ADC_HandleTypeDef* hadc)
{

}

void HAL_ADC_ConvCpltCallback(ADC_HandleTypeDef* hadc)
{
  HAL_ADC_Start_DMA(&hadc1, pyro_adc, 4);
}
/* USER CODE END 4 */
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
