Maeswoon/UNHSEDS/Engineering/2022-2023 Rocket/Avionics/Io_Development/Core/Inc/main.h

#define PYRO1_DET_Pin GPIO_PIN_0
#define PYRO1_DET_GPIO_Port GPIOA
#define PYRO2_DET_Pin GPIO_PIN_1
#define PYRO2_DET_GPIO_Port GPIOA
#define PYRO3_DET_Pin GPIO_PIN_2
#define PYRO3_DET_GPIO_Port GPIOA
#define PYRO4_DET_Pin GPIO_PIN_3
#define PYRO4_DET_GPIO_Port GPIOA
#define PYRO1_Pin GPIO_PIN_5
#define PYRO1_GPIO_Port GPIOC
#define PYRO2_Pin GPIO_PIN_0
#define PYRO2_GPIO_Port GPIOB
#define PYRO3_Pin GPIO_PIN_1
#define PYRO3_GPIO_Port GPIOB
#define PYRO4_Pin GPIO_PIN_2
#define PYRO4_GPIO_Port GPIOB
#define SDMMC1_DET_Pin GPIO_PIN_7
#define SDMMC1_DET_GPIO_Port GPIOC
#define RF_DIO0_Pin GPIO_PIN_8
#define RF_DIO0_GPIO_Port GPIOA
#define RF_DIO1_Pin GPIO_PIN_9
#define RF_DIO1_GPIO_Port GPIOA
#define RF_DIO5_Pin GPIO_PIN_10
#define RF_DIO5_GPIO_Port GPIOA
#define USB_OTG_FS_DP_Pin GPIO_PIN_12
#define USB_OTG_FS_DP_GPIO_Port GPIOA
