Maeswoon/UNHSEDS/(commit log)

2018-06-08 aether stuff
    [Booster Fins.DXF, Booster Fins.SLDPRT, BulkPLATECoupler.DXF, BulkPLATECoupler.SLDPRT, CouplerInnerRing.DXF, CouplerInnerRing.SLDPRT, CouplerOuterRing.DXF, CouplerOuterRing.SLDPRT]
2018-06-08 some othe engineering
    [29mmEngineTube.SLDPRT, BodyTube.SLDPRT, BoosterFin.SLDPRT, BoosterStageAssem.SLDASM, CenteringRing.SLDPRT, ConicalMk1.SLDASM, ConicalNoseCone.SLDPRT, Coupler.SLDPRT]
2018-06-08 senior div
    [Booster Fins.SLDDRW, Sustainer_Fins.SLDDRW, VonKarmanNoseCone.SLDDRW]
2018-06-08 organized engineering
    [29mmEngineTube.SLDPRT, Aether2FLightData.csv, Aether2FLightData.xlsx, Aether3opendata.csv, Aether3opendataboost.csv, Aether4 Flight Data.csv, Aether4 Flight Data.xlsx, BodyTube.SLDPRT]
2018-06-08 organize and add missing things
    [Booster Fins.DXF, Booster Fins.SLDPRT, BulkPLATECoupler.DXF, BulkPLATECoupler.SLDPRT, CouplerInnerRing.DXF, CouplerInnerRing.SLDPRT, CouplerOuterRing.DXF, CouplerOuterRing.SLDPRT]
2018-06-08 organization more
    [29mmEngineTube.SLDPRT, BodyTube.SLDPRT, Booster Fins.SLDPRT, BoosterStageAssem.SLDASM, CenteringRing.SLDPRT, Coupler.SLDPRT, CouplerBodyTube.SLDPRT, E-Bay.SLDASM]
2018-06-08 More oranization
    [29mmEngineTube.SLDPRT, Aether2FLightData.csv, BodyTube.SLDPRT, BoosterFin.SLDPRT, BoosterStageAssem.SLDASM, CenteringRing.SLDPRT, ConicalMk1.SLDASM, ConicalNoseCone.SLDPRT]
2018-06-10 engineering archives
    [DecisionMatrixTemplate.xls, EngineAssemblyWeigh.xlsx, bodtube.SLDPRT, casing mount Gimble.SLDDRW, fins.SLDPRT, motor casing 1 (1).SLDPRT]
2018-06-10 more archives
    [29mmEngineTube.SLDPRT, Aether2FLightData.xlsx, Aether4 Flight Data.xlsx, BodyTube.SLDPRT, Booster Fins.DXF, Booster Fins.IGS, Booster Fins.SLDPRT, BoosterFin.SLDPRT]
2018-06-10 last commit from charlie personal computer archive
    [Budget Sheet.xlsx, SEDS Book.xlsx]
2018-06-10 sorted and organized files
    [29mmEngineTube.SLDPRT, Aether1 Flight Data.csv, Aether2FLightData.xlsx, Aether3opendata.csv, Aether3opendataboost.csv, Aether4 Flight Data.csv, Aether4 Flight Data.xlsx, BodyTube.SLDPRT]
2018-08-14 Competition Rocket Ebay
    [E-Bay Assembly.SLDASM, E-Bay Board.SLDPRT, E-Bay BodyRing.SLDPRT, E-Bay InnerRing.SLDPRT, E-Bay OuterRing.SLDPRT, E-Bay Ring Assembly.SLDASM, E-Bay Ring and Board Assembly.SLDASM, E-Bay Tube and Ring.SLDASM]
2018-08-28 powerpoint update, all caps
2018-08-28 solidworks nose cone mold and matlab final
    [Mold_A.SLDPRT, Mold_B.SLDPRT]
2018-08-31 molds for 3d
    [Mold_A.STL, Mold_B.STL]
2018-09-03 solidworkjs and sponsorship
    [BodyTube.SLDPRT, Booster Fins.SLDPRT, BoosterStageAssem.SLDASM, Companies_Final.xlsx, E-Bay Assembly.SLDASM, E-Bay BodyRing.SLDPRT, E-Bay Ring Assembly.SLDASM, E-Bay Tube and Ring.SLDASM]
2018-09-08 update to competition rocket files for cutting
    [Booster Fins.SLDPRT, Booster Fins.STL, BoosterStageAssem.SLDASM, CenteringRing.SLDPRT, CenteringRing.STL, CenteringRingLaser.DXF, FullAssembly.SLDASM, LargeCouplerBulkPlate.DXF]
2018-09-09 second fins and nosecone print
    [Booster Fins2.SLDPRT, Booster Fins2.STL, Sustainer_Fins2.SLDPRT, Sustainer_Fins2.STL, VonKarmanNoseCone.SLDPRT, VonKarmanNoseConenosled.SLDPRT, VonKarmanNoseConenosled.STL]
2018-09-09 final print edits
    [VonKarmanNoseConenosled.SLDPRT]
2018-09-14 mid afternoon update, startied build process validation
    [CenteringRing.SLDPRT, VonKarmanNoseConenosled.SLDPRT]
2018-09-18 final sponsorship letter and cleaning list
    [Companies_Final.xlsx]
2018-09-18 added notes on excel sheet
    [Companies 2018-2019.xlsx]
2018-09-19 sponsorship update notes and pdf final. Need to print double sided 40 copies
    [Companies 2018-2019.xlsx]
2018-09-19 work for charles
    [Companies 2018-2019.xlsx]
2018-09-20 final sponsoship list
    Need more emails in distant companies, and can maybe find a few more local companies to ask
    [Companies 2018-2019.xlsx]
2018-09-25 went to two companies
    need to email goss to set up an appointment
    [Companies 2018-2019.xlsx]
2018-09-27 deans work
    [Budget 2018-2019.xlsx]
2018-09-30 Competition rocket flight data
    [2018-09-29-serial-4225-flight-0018-via-2910.csv]
2018-10-03 forms for SAFC
    [SAFC_UNH_SEDS_Proposal_Outreach.xlsx, SAFC_UNH_SEDS_Proposal_SpaceVision.xlsx]
2018-10-04 last update
    [SAFC_UNH_SEDS_Proposal_SpaceVision.xlsx]
2018-10-15 cleaning and sorting
    [2018-09-29-serial-4225-flight-0018-via-2910.csv, 29mmEngineTube.SLDPRT, Aether2FLightData.csv, Aether2FLightData.xlsx, Aether3opendata.csv, Aether3opendataboost.csv, Aether4 Flight Data.csv, Aether4 Flight Data.xlsx]
2018-10-15 Update Engineering/2018-2019/Hybrid Engine Development/Possible materials.xlsx
    [Possible materials.xlsx]
2018-10-22 solidworks hybrid first draft
    [Budget 2018-2019.xlsx, Combustion Chamber.SLDPRT, Companies 2018-2019.xlsx, EngineAssembly.SLDASM, Nozzle.SLDPRT]
2018-10-22 Update Business/Finance/Sponsorship/Deans/Budget 2018-2019.xlsx
    [Budget 2018-2019.xlsx]
2018-10-24 solidworks hybrid engine
    [Combustion Chamber.SLDPRT, EngineAssembly.SLDASM, Nozzle2.SLDPRT]
2018-10-24 Desicion matrix for materials
2018-10-26 launch report and code
    [CR_OP_Booster.csv, CR_OP_Sustainer.csv, USRC_TeleMega_Flight_Data.csv]
2018-10-28 end of report update
    [BoosterStageAssem.SLDASM, E-Bay.SLDASM, FullAssembly.SLDASM, SustainerAssembly.SLDASM, SustainerCouplerOpenEnd.SLDASM]
2018-10-30 drawing for engine
    [Combustion Chamber Drawing.SLDDRW, Combustion Chamber.SLDPRT, EngineAssembly.SLDASM, Nozzle2.SLDDRW, Nozzle2.SLDPRT]
2018-11-06 more on solidworks
    [Combustion Chamber.SLDPRT, EngineAssembly.SLDASM]
2018-11-07 added voyager plaque audio
    [EngineAssembly.SLDASM]
2018-11-08 more engine added injector
    [Combustion Chamber.SLDPRT, EngineAssembly.SLDASM, Injector.SLDPRT, Nozzle2.SLDPRT]
2018-11-08 more on staqtic rig
    [EngineAssembly.SLDASM, Full Assembly.SLDASM, Leg.SLDPRT, Ring Constraint.SLDPRT, Vertical Rod Constraint.SLDPRT]
2018-11-09 seds push friday
    [Combustion Chamber.SLDPRT, EngineAssembly.SLDASM, Entry_Form_UNHSEDS.xlsx, Injector.SLDPRT, Nozzle2.SLDPRT, Nozzle3.SLDPRT]
2018-11-10 stuff on solidworks staztic rig
    [Full Assembly.SLDASM, SAFC_UNH_SEDS_PostReport_SpaceVision.xlsx, Vertical Pole.SLDPRT]
2018-11-12 Updated Spaceport entry form
    [Entry_Form_UNHSEDS.xlsx]
2018-11-12 more solidworks
    [Combustion Chamber Drawing TURBOCAM.SLDDRW, Combustion Chamber.SLDPRT, EngineAssembly.SLDASM, Injector.SLDPRT, Nozzle Drawing TURBOCAM.SLDDRW, Nozzle2.SLDDRW]
2018-11-12 Update Reports and Presentations/Reports/Spaceport/Fall 2018/Entry_Form_UNHSEDS.xlsx
    [Entry_Form_UNHSEDS.xlsx]
2018-11-12 final injector
    [Injector.SLDPRT]
2018-11-26 mold stl
    [MoldForRubber.SLDPRT, RubberFormation.SLDASM, RubberMold.STL]
2018-11-27 one stage
2018-11-30 more update, openrocket
    [Engine Arm Constraint.SLDPRT, Full Assembly.SLDASM, Injector Drawing.SLDDRW, Injector.SLDPRT, Load Cell Plate.SLDPRT]
2018-12-05 Updates to adapter and housing
    [adapter1.SLDPRT, adapter2.SLDPRT, motor.SLDPRT, valve housing.SLDPRT]
2018-12-05 chase updates
    [Engine Arm Constraint.SLDDRW, Engine Arm Constraint.SLDPRT]
2018-12-05 Update valve housing.SLDPRT
    [valve housing.SLDPRT]
2018-12-05 updates collin
    [adapter1 Drawing.SLDDRW, adapter1.SLDPRT, adapter2 Drawing.SLDDRW, adapter2.SLDPRT]
2018-12-11 adapter work for scott
    [adapter1 Drawing.SLDDRW, adapter1.SLDDRW, adapter1.SLDPRT]
2018-12-17 bracket work
    [Assem1.SLDASM, L-Bracket.SLDDRW, L-Bracket.SLDPRT]
2019-01-25 added scott files
    [Combustion Chamber Drawing TURBOCAM.SLDDRW, Combustion Chamber TST1.SLDDRW, Combustion Chamber TST1.SLDPRT, Combustion Chamber.SLDDRW, Combustion Chamber.SLDPRT, Injector Assembly1.SLDASM, Injector Drawing.SLDDRW, Injector EXP1.SLDPRT]
2019-01-28 updates engine assembly
    [Engine Arm Constraint.SLDPRT, EngineAssembly.SLDASM, Full Assembly.SLDASM]
2019-01-29 changes to powerpoint
2019-01-29 Update Costs.xlsx
    Updated cost spreadsheet
    [Costs.xlsx]
2019-01-31 field work and constitution final
    [Sandbag.SLDPRT, Shelter Assembly.SLDASM, roof pillars.SLDPRT]
2019-02-01 changes to presentation - costs
    [Costs.xlsx]
2019-02-04 more on finance spring grant seds
2019-02-04 more alumni
    [Budget.xlsx]
2019-02-08 after cold test
    [116'' frame.SLDPRT, 12'' frame.SLDPRT, Actual cold test and cslibration data.xlsx, SHelter Assembly 2.SLDASM, window.SLDPRT]
2019-02-08 board stuff
2019-02-12 hos and blatti work
    [FEA pressure analysis.SLDASM, Temperature_Analysis.SLDASM]
2019-02-22 gimbal work
    [Assem1.SLDASM, Body Tube.SLDPRT, Combustion Chamber TST1.SLDPRT, Enforcement Ring.SLDPRT, Entire Engine.SLDASM, Full Assembly.SLDASM, Gimbal Ring.SLDPRT, Injector EXP9A Gas Director.SLDPRT]
2019-02-25 updates to gimbal
    [Assem1.SLDASM, Body Tube Pin.SLDPRT, Enforcement Ring.SLDPRT, Firgelli L16 50mm Assembly.IGS, Firgelli L16 50mm Assembly.SLDASM, Firgelli L16 50mm Assembly.x_t, Firgelli L16 50mm as.SLDPRT, Firgelli L16 50mm body.SLDPRT]
2019-02-25 gimbal and rpes
    [Assem1.SLDASM, Body Tube.SLDPRT, Enforcement Ring.SLDPRT]
2019-02-27 ppt gimbal and injector
    [Assem1.SLDASM, disk_design_4.SLDPRT, disk_design_4_drawing.SLDDRW, disk_design_5.SLDPRT, disk_design_5_drawing.SLDDRW]
2019-02-27 wednesday work, ppt, injector
    [AngledMember.SLDPRT, BaseLegs.SLDPRT, CrossBar.SLDPRT, CrossMember.SLDPRT, P1026.SLDPRT, P1034.SLDPRT, P1035.SLDPRT, P1036.SLDPRT]
2019-03-28 Updated Gimbal Assembly
    [Assem1.SLDASM, Body Tube.SLDPRT, Body tube 2.SLDPRT, Enforcement Ring.SLDPRT, Gimbal Ring.SLDPRT, Gimbal assembly 2.SLDASM, Motion Study Assembly.SLDASM, Peg2.SLDPRT]
2019-03-31 part and masses
    [Control Box.SLDASM, Hybrid Engine Mass.xlsx, Top control box.STL, base contol box.STL, final base.SLDPRT, final top.SLDPRT]
2019-04-02 Thomas Collins Engineering Update
    [AB Copper Holder.SLDPRT, Allen Bradley.SLDPRT, Cooldown Data.xlsx, Copper Coil Attempt #2.SLDPRT, Copper Coil Part.SLDPRT, Copper Coil [In Progress].SLDPRT, Fridge Assembly.SLDASM, Fridge Plate.SLDPRT]
2019-04-02 Thomas Engineering Update
    [AB Copper Holder.SLDPRT, Allen Bradley.SLDPRT, Assem1.SLDASM, Body Tube Peg 2.SLDPRT, Body Tube Pin.SLDPRT, Body Tube.SLDPRT, Body tube 2.SLDPRT, CLAM_P16_BOT_10541.sldprt]
2019-04-04 Update New Microsoft PowerPoint Presentation.pptx
2019-04-05 thomas idiot
    [AB Copper Holder.SLDPRT, Allen Bradley.SLDPRT, Assem1.SLDASM, Cooldown Data.xlsx, Copper Coil Attempt #2.SLDPRT, Copper Coil Part.SLDPRT, Copper Coil [In Progress].SLDPRT, Fridge Assembly.SLDASM]
2019-04-07 Collins organizational skill
    [Alternate Nozzle Design.SLDPRT, Assem1.SLDASM, Body Tube Peg 2.SLDPRT, Body Tube Pin.SLDPRT, Body Tube.SLDPRT, CLAM_P16_BOT_10541.sldprt, CLAM_P16_TOP_10542.sldprt, CURRENT Nozzle Design.SLDPRT]
2019-04-08 gimbal and abstract
    [Body Tube Peg 2.SLDPRT, Body Tube Peg Drawing.SLDDRW, Engine Assembly.SLDASM, Gimbal to Engine Pin Drawing.SLDDRW, Gimbal to Engine Pin.SLDPRT, NEW Only RIngs Assembly.SLDASM, Peg.SLDDRW, gimbal ring 2 Drawing.SLDDRW]
2019-04-09 Updated Gimbal Pin in Assembly
    [001-20.SLDPRT, Body Tube Peg 2 - Drawing.SLDDRW, Body Tube Peg 2.SLDPRT, Body Tube Pin.SLDPRT, Body Tube.SLDPRT, Body tube 2.SLDPRT, Current Combustion Chamber Design.SLDPRT, Enforcement Ring.SLDPRT]
2019-04-10 Updated Gimbal System & Drawings
    [001-20.SLDPRT, Body Tube - Enforcement Ring.SLDDRW, Body Tube Peg 2 - Drawing.SLDDRW, Body Tube Peg 2.SLDPRT, Body Tube Pin (edit GrabCAD).SLDDRW, Body Tube Pin (edit GrabCAD).SLDPRT, Body Tube Pin.SLDPRT, Body Tube.SLDPRT]
2019-04-11 Some STL
    [001-20.SLDPRT, Body Tube - Enforcement Ring.SLDDRW, Body Tube Peg 2.SLDPRT, Body Tube Pin (edit GrabCAD).SLDDRW, Body Tube Pin (edit GrabCAD).SLDPRT, Body Tube Pin (edit GrabCAD).STL, Body Tube Pin.SLDPRT, Body Tube.SLDPRT]
2019-04-11 New STLs
    [Actuator Stroke Rod.STL, Actuator moving shaft - Copy.SLDASM, Actuator moving shaft - Copy.SLDDRW, Actuator moving shaft.SLDASM, Body Tube Peg 2.SLDPRT, Body Tube Pin (For 3D Print).SLDPRT, Body Tube Pin (For 3D Print).STL, Body Tube Pin.SLDPRT]
2019-04-12 actuator stuff
    [Actuator moving shaft - Copy.SLDDRW]
2019-04-12 Final STL Files
    [001-20.SLDPRT, Actuator (3D).SLDPRT, Actuator (3D).STL, Actuator Rod (For 3D Printed).SLDPRT, Actuator Rod (For 3D Printed).STL, Actuator Rod Top (For 3D Printed).SLDPRT, Actuator Rod Top (For 3D Printed).STL, Actuator Stroke Rod.STL]
2019-04-12 half actuator
    [Actuator (3D) half.SLDPRT]
2019-04-12 half stl
    [Actuator (3D) half.STL]
2019-04-13 Gimbal Stuff
    [001-20.SLDPRT, Actuator (3D) half.SLDPRT, Actuator (3D) half.STL, Actuator (3D).SLDPRT, Actuator (3D).STL, Actuator Rod (For 3D Printed).SLDPRT, Actuator Rod (For 3D Printed).STL, Actuator Rod Top (For 3D Printed).SLDPRT]
2019-04-13 Update NEW Only RIngs Assembly.SLDASM
    [NEW Only RIngs Assembly.SLDASM]
2019-05-16 ece dump
    [project.cfg]
2019-05-16 pic of engine temperature
2019-06-23 organization 1
    [CR_OP_Booster.csv, CR_OP_Sustainer.csv, Entry_Form_UNHSEDS.xlsx, USRC_TeleMega_Flight_Data.csv]
2019-06-23 Organization 2
    [Book.xlsx, Budget Sheet.xlsx, Budget.xlsx, Parents Purchases.xlsx, SWAG.xlsx]
2019-06-23 Organization 3
    [Budget 2018-2019.xlsx, Budget Sheet.xlsx, Budget.xlsx, Companies 2018-2019.xlsx, Companies_Interested.xlsx, Parents Purchases.xlsx, SAFC_UNH_SEDS_PostReport_SpaceVision.xlsx, SAFC_UNH_SEDS_Proposal_Outreach.xlsx]
2019-06-23 Organization 4
    [Book.xlsx, Budget 2018-2019.xlsx, Budget Sheet.xlsx, Budget.xlsx, Company Brainstorm.xlsx, Parents Purchases.xlsx, SAFC_UNH_SEDS_PostReport_SpaceVision.xlsx, SAFC_UNH_SEDS_Proposal_Outreach.xlsx]
2019-06-29 start of gimbal 29mm
    for grace for sunday
    [Assembly.SLDASM, BodyTube.SLDPRT, Bolt.SLDPRT, EngineCasing.SLDPRT, GimbalRing.SLDPRT, p16_50mm_in.SLDPRT]
2019-06-30 Gimbal Fashoners and Assembly
    [Assembly.SLDASM, Fastening Quarter 20 bolt general design - Copy.SLDPRT, GimbalRing.SLDPRT, Quarter 20 bolt - Body Tube to Gimbal Ring - Copy.SLDPRT, Quarter 20 bolt - Gimbal Ring to Engine Casing.SLDPRT]
2019-07-04 Actuator Fastenings
    [Actuator to gimbal ring idea 1 (not nearly finished).SLDPRT, Assembly.SLDASM, p16_50mm_in(Actuator).SLDPRT, p16_50mm_in.SLDPRT]
2019-07-06 Gimbal Actuator Assembly
    [Actuator Fastoning pin.SLDPRT, Actuator to gimbal ring connector (Left).SLDPRT, Actuator to gimbal ring connector (Right).SLDPRT, Actuator to gimbal ring idea 1 (not nearly finished).SLDPRT, Assembly With Actuator.SLDASM, Assembly.SLDASM, Fastening Quarter 20 bolt general design - Copy - Copy.SLDPRT, Gimbal Actuator Assembly.SLDASM]
2019-07-06 First Actuator Incorporation
    [Actuator Fastener BodyTube.SLDPRT, Actuator Fastener Gimbal.SLDPRT, Actuator Fastoning pin.SLDPRT, Assembly.SLDASM, BodyTube.SLDPRT, Gimbal Actuator Assembly.SLDASM, GimbalRing.SLDPRT, Quarter 20 bolt - Body Tube to Gimbal Ring - Copy.SLDPRT]
2019-07-06 Assembly updats (not completed)
    [Assembly.SLDASM]
2019-07-07 V2 work
    [Aluminum Combustion Chamber.SLDPRT, Impinging Plate.SLDPRT, Injector Plate.SLDPRT, Nozzle.SLDPRT]
2019-07-07 work with nozzle
    [Impinging Plate.STL, Nozzle.SLDPRT]
2019-07-08 Actuator 1 & 2 addition
    [Actuator 1 Fastener Engine Casing.SLDPRT, Actuator 2 Fastener Engine Casing.SLDPRT, Actuator 2 Fastoner to Gimbal Ring.SLDPRT, Actuator 2 pivot pin.SLDPRT, Actuator Fastener BodyTube.SLDPRT, Actuator Fastener Gimbal.SLDPRT, Actuator Fastoning pin.SLDPRT, Actuator to gimbal ring connector (Left).SLDPRT]
2019-07-09 Assembly Update
    [Actuator 2 Fastener Engine Casing.SLDPRT, Actuator 2 pivot pin.SLDPRT, Assembly.SLDASM, Quarter 20 bolt - Body Tube to Gimbal Ring - Copy.SLDPRT, Quarter 20 bolt - Gimbal Ring to Engine Casing.SLDPRT]
2019-07-10 Pivot Pin Attachment
    [Assembly.SLDASM]
2019-07-15 moved it down
    [Assembly.SLDASM]
2019-08-19 Working shit.
    Arduino scrips for the flow regulator.
2019-08-20 assembly drawings
    [Actuator 2 Fastener Engine Casing(#2).SLDDRW, Actuator 2 Fastener Engine Casing(#2).SLDPRT, Actuator 2 Fastener Engine Casing.SLDPRT, Actuator 2 Fastoner to Gimbal Ring.SLDDRW, Actuator 2 pivot pin - Copy.SLDPRT, Actuator 2 pivot pin drawing.SLDDRW, Actuator Fastener BodyTube.SLDDRW, Actuator Fastener Gimbal.SLDDRW]
2019-08-28 more companies for board outside
2019-08-28 media for board
2019-08-29 Added Hot Fire List Draft
    placed in engineering management
    [HFTList.xlsx]
2019-08-30 updaate to management
    [Companies_To_Contact.xlsx, Company Brainstorm.xlsx, SEDS_Companies.xlsx]
2019-09-04 thomasd work
    [Budget 2019-2020.xlsx]
2019-09-04 more work on budget
    [Budget 2019-2020.xlsx, Budgets 2019-2020.xlsx]
2019-09-04 Update Budgets 2019-2020.xlsx
    [Budgets 2019-2020.xlsx]
2019-09-04 final push
    [Budgets 2019-2020.xlsx]
2019-09-07 thomas work
    [CompositeFrameExteriorStructure.SLDPRT, Frame.SLDASM, FrameSupportStructure.SLDPRT, SeperationPlate.SLDPRT]
2019-09-09 Frame Rocket
    [428501.SLDASM, 428501_01.SLDPRT, 428501_02.SLDPRT, 428501_03.SLDPRT, CompositeFrameExteriorFull24in.SLDPRT, CompositeFrameExteriorFull36in.SLDPRT, CompositeFrameExteriorStructure.SLDPRT, CompositeFrameExteriorStructure24in.SLDPRT]
2019-09-10 Frame CAD Update
    [Frame Assembly.SLDASM]
2019-09-14 Update Frame Assembly.SLDASM
    [Frame Assembly.SLDASM]
2019-09-19 Update Aluminum Combustion Chamber.SLDPRT
    [Aluminum Combustion Chamber.SLDPRT]
2019-09-23 Create V1 Flow Regulation Ignition Circuit.PNG
2019-09-25 Turbocam Sponsorship package
    C:\Users\Student\Desktop\UNHSEDS\Business\Finance\Budgets, Packets and Templates\Packets\TURBOCAM Sponsorship Packet
    [Budgets 2019-2020.xlsx, UNH SEDS Company Sponsorship Contact.xlsx]
2019-09-25 updates from charlie
    [Budgets 2019-2020.xlsx]
2019-09-28 solidworks update
    [Tank Endcap Flanges.SLDPRT]
2019-09-29 updates to runawayv2
    [Aluminum Combustion Chamber.SLDPRT, Assembly.SLDASM, PTD25-20-1000H.STEP, PressureTap.SLDPRT, SPT25-20-1000A.STEP]
2019-09-29 updates to chamber
    [Aluminum Combustion Chamber.SLDPRT, Assembly.SLDASM]
2019-09-30 frame shit
    [.2 Steel Rod.SLDPRT, Budgets 2019-2020.xlsx, Frame Assembly.SLDASM, SAFC_UNH_SEDS_Proposal_SpaceVision.xlsx, Tank Endcap Flanges.SLDPRT]
2019-09-30 more for v2
    [Aluminum Combustion Chamber.SLDPRT, Assembly.SLDASM]
2019-10-02 more on sw
    [.143D rod.SLDPRT, 10-32 STAINLESS STEEL FLANGE NUT.SLDPRT]
2019-10-02 Frame v2
    [.143D rod.SLDPRT, .2 Steel Rod.SLDPRT, 10-32 STAINLESS STEEL FLANGE NUT.SLDPRT, 428501.SLDASM, 428501_01.SLDPRT, 428501_02.SLDPRT, 428501_03.SLDPRT, Combustion Chamber TST1.SLDPRT]
2019-10-02 Prefrme update
    [Basic Aluminum Rod.SLDPRT, Frame Assembly V2.SLDASM, Joined Nut and Bolt 0.190 Rod.SLDPRT, No2 Tank Support Structure Assmebly.SLDASM]
2019-10-03 postframe update
    [Basic Aluminum Rod.SLDPRT, Frame Assembly V2.SLDASM, No2 Tank Support Structure Assmebly.SLDASM, Tank Endcap Flanges.SLDPRT]
2019-10-07 engineering / usurper update
    [Fins and Base Exterior.SLDPRT, Frame Assembly V2.SLDASM, No2 Tank Support Structure Assmebly.SLDASM, Payload Block.SLDPRT, SupportRod.SLDPRT]
2019-10-07 more solidworks and pres
    [Aluminum Combustion Chamber.SLDPRT, ChamberAssembly.SLDASM, Flow Trajectories 1.xlsx, disk_design_5.SLDPRT, global_parameters.txt]
2019-10-09 frame I guess?
    [428501.SLDASM, 428501_01.SLDPRT, 428501_02.SLDPRT, 428501_03.SLDPRT, Avionics Disk Mount Test - Alice.SLDPRT, CompositeFrameExteriorFull36in.SLDPRT, CompositeFrameExteriorStructure.SLDPRT, CompositeFrameExteriorStructure24in.SLDPRT]
2019-10-10 Flow Regulation
    New Flow Regulation script, IN1 port failed.
    [Debugg.ino]
2019-10-18 move for org
    [428501.SLDASM, 428501_01.SLDPRT, 428501_02.SLDPRT, 428501_03.SLDPRT, CompositeFrameExteriorFull36in.SLDPRT, CompositeFrameExteriorStructure.SLDPRT, CompositeFrameExteriorStructure24in.SLDPRT, DumbassBase.SLDPRT]
2019-10-19 to the old shit
    [Current Combustion Chamber.SLDPRT, global_parameters.txt]
2019-10-19 Fin Updates
    [Fin System V3.SLDPRT]
2019-10-19 from hackathon
    [92949A116_18-8 SS BUTTON HEAD HEX DRIVE SCREW.SLDPRT, Aluminum Combustion Chamber.SLDPRT, Assembly1.SLDASM, Impinging Plate 1.SLDPRT, Impinging Plate 1.STL, Impinging Plate Blank.SLDPRT, Injector Plate.SLDPRT, SS-43GXEF4-51C (2).stp]
2019-10-19 Fin FEA
    [Fin System V3.SLDPRT]
2019-10-19 Update Fin System V3.SLDPRT
    [Fin System V3.SLDPRT]
2019-10-29 pres and burst disks
    [BurstDisk1.STL, BurstDisk10.STL, BurstDisk2.STL, BurstDisk3.STL, BurstDisk4.SLDPRT, BurstDisk4.STL, BurstDisk5.STL, BurstDisk6.STL]
2019-10-31 updates to disks for printing
    [BurstDisk1.STL, BurstDisk2.STL, BurstDisk4.SLDPRT, BurstDisk4.STL, BurstDisk5.STL, BurstDisk6.STL, BurstDisk7.STL]
2019-11-01 changes and things
    [10.5in Tube Stock.SLDPRT, Little Bitch Boy Tube.SLDPRT, Square Tubing Adapter v1.SLDPRT, Tube v2 FEA.SLDASM]
2019-11-02 .5in support rods and plates
    [.5 in support rod.SLDPRT, Aluminum Plate.SLDPRT, Extruded aluminum tube 5x5x0.125.SLDPRT, Rods and Plates.SLDASM]
2019-11-02 hack 2.2 2.5 hr in
    [Aluminum Combustion Chamber.SLDPRT, Assembly1.SLDASM, ChamberAssembly.SLDASM, Combustion Chamber Assembly.SLDASM, Impinging Plate Blank.SLDPRT, Impinging Plate.SLDPRT, Injector Assembly.SLDASM, Injector Plate.SLDPRT]
2019-11-02 11/2/19 Fin Design
    [finDesignNovember2nd.SLDPRT]
2019-11-02 Rods and Plates simulation
2019-11-02 rod and plate assembly
    [Rods and Plates.SLDASM]
2019-11-14 Rod support SW simulation
    [Aluminum Plate.SLDPRT, Rods and Plates.SLDASM]
2019-11-14 Rods and plates
    [Rods and Plates.SLDASM]
2019-11-18 bust cap data and frame stuff
    [1935N110_CARBON FIBER SLIP-ON RAIL.SLDPRT, plug3.csv, plug5.csv, plug6.csv, plug7.csv]
2019-11-18 trying out nozzle
    [Aluminum Combustion Chamber.SLDPRT, Nozzle.SLDPRT, TestNozzle.SLDPRT]
2019-11-18 new caps
    [BirstCap10.SLDPRT, BirstCap10.STL, BirstCap8.SLDPRT, BirstCap8.STL, BirstCap9.SLDPRT, BirstCap9.STL, plug6-calcforrest.csv]
2019-11-20 new burst disks
    [Aluminum Combustion Chamber.SLDPRT, BirstCap10.SLDPRT, BirstCap10.STL, BirstCap11.SLDPRT, BirstCap11.STL, BirstCap8.SLDPRT, BirstCap9.SLDPRT, BirstCap9.STL]
2019-11-20 estes plug update
    [Avionics Bay Block.SLDPRT, Carbon Fiber 1ft Square Rod.SLDPRT, Combustion Chamber Ring.SLDPRT, Combustion Chamber TST1.SLDPRT, Entire Engine.SLDASM, Estesplug1.csv, Estesplug1.xlsm, Estesplug2.csv]
2019-11-21 frame reorganization
    [Avionics Bay Block.SLDPRT, Carbon Fiber 1ft Square Rod.SLDPRT, Combustion Chamber Ring.SLDPRT, Combustion Chamber TST1.SLDPRT, Entire Engine.SLDASM, Estesplug1.csv, Estesplug1.xlsm, Estesplug2.csv]
2019-11-22 more caps
    [BurstCap1.SLDPRT, BurstCap1.STL, BurstCap2.SLDPRT, BurstCap2.STL, BurstCap3.SLDPRT, BurstCap3.STL, BurstCap4.SLDPRT, BurstCap4.STL]
2019-11-26 mroe caps~!
    [BurstCap10.SLDPRT, BurstCap10.STL, BurstCap11.SLDPRT, BurstCap11.STL, BurstCap12.SLDPRT, BurstCap12.STL, BurstCap8.SLDPRT, BurstCap8.STL]
2019-11-26 SolidWorks LCM
    [Launch Control Module Bottom.SLDPRT, Launch Control Module Top.SLDPRT]
2019-11-30 for LCM
    [Bottom1.sldprt, Bottom2.sldprt, Launch Control Module Bottom.SLDPRT, Launch Control Module Top.SLDPRT, Top1.sldprt, Top2.sldprt]
2019-12-05 seds room comp
    [Frame Assembly V2.SLDASM]
2019-12-06 Update Von Karman NoseCone.SLDPRT
    [Von Karman NoseCone.SLDPRT]
2019-12-06 drawig for chamber
    [Aluminum Combustion Chamber.SLDDRW, Aluminum Combustion Chamber.SLDPRT, Combustion Chamber Assembly.SLDASM]
2019-12-07 more runaway updates
    [Aluminum Combustion Chamber.SLDDRW, Assembly1.SLDDRW, Injector Plate.SLDDRW]
2019-12-07 Added smaller filezise version of oxide tank. Does not include head assembly, just tank shape.
    [NOS tank no cap.SLDPRT]
2019-12-07 First version of tank cap, still needs some work
    [NOS tank cap.SLDPRT]
2019-12-07 frame redo
    [12in Carbon Fiber Rod. 0.456OD.SLDPRT, NO2 Test.SLDPRT, NOS Bottle_PatchedModel Top model.SLDPRT, No2 Tank Coupler.SLDPRT, Ring Test.SLDPRT, Rod Cap Test.SLDPRT, Test Assembly.SLDASM, V2.SLDASM]
2019-12-08 Frame V3
    [24in Carbon Fiber Rod. 0.456OD.SLDPRT, Aluminum Combustion Chamber.SLDPRT, Cap Screw Left Hand.SLDPRT, Cap Screw Right Hand.SLDPRT, Combustion Chamber Support Structure Coupler Bottom.SLDPRT, Combustion Chamber Support Structure Coupler Test.SLDPRT, Combustion Chamber Support Structure Coupler Top.SLDPRT, Injector Assembly.SLDASM]
2019-12-08 Frame lunch break
    [1-72 1-8th.SLDPRT, 12in Carbon Fiber Rod. 0.456OD.SLDPRT, 1556A540_BRACKET.SLDPRT, 4-40 3-4 or 6-8.SLDPRT, 4-40 9-8th.SLDPRT, 92196A118_18-8 STAINLESS STEEL SOCKET HEAD CAP SCREW.SLDPRT, BLACK-OXIDE ALLOY STEEL SOCKET HEAD SCREW.SLDPRT, CC Top Screw T2.SLDPRT]
2019-12-08 Finished modeling the NOS tank. Made some guesses on the material and threading, so if you have info feel free to update those.
    [NOS tank cap.SLDPRT, NOS tank no cap.SLDPRT, NosTank.SLDASM]
2019-12-08 frame bbe
    [1-72 1-8th.SLDPRT, 12in Carbon Fiber Rod. 0.456OD.SLDPRT, 3D Printed Tab.SLDPRT, 4-40 1-2.SLDPRT, 4-40 3-4 or 6-8.SLDPRT, 4-40 9-8th.SLDPRT, Aluminum Combustion Chamber.SLDPRT, Avionics Bay Block.SLDPRT]
2019-12-09 Create Switching Circuit.ms14
    [Switching Circuit.ms14]
2019-12-11 birs cap
    [BirstCap1.SLDDRW, BirstCap1.SLDPRT, BirstCap4.SLDPRT]
2019-12-14 runaway finals
    [Aluminum Combustion Chamber.SLDDRW, Aluminum Combustion Chamber.SLDPRT, Assem2.SLDASM, ConvergingInsert1.SLDPRT, DivergingInsert1.SLDPRT, Injector Plate.SLDDRW, Injector Plate.SLDPRT, ModularNozzeAssy.SLDASM]
2019-12-15 frame redo.
2019-12-16 drawing updates
    [Aluminum Combustion Chamber.SLDDRW, Injector Plate.SLDDRW, NozzleBase.SLDDRW, NozzleBase.SLDPRT]
2020-01-15 update for seneca
    [Aluminum Combustion Chamber.SLDDRW, NozzleBase.SLDDRW, NozzleBase.SLDPRT]
2020-01-15 seneca and imping
    [Impinging Plate Blank.SLDDRW, Impinging Plate Blank.SLDPRT]
2020-01-18 orgnaiz and board succession
    [29mmEngineTube.SLDPRT, Aether1 Flight Data.csv, Aether2FLightData.xlsx, Aether3opendata.csv, Aether3opendataboost.csv, Aether4 Flight Data.csv, Aether4 Flight Data.xlsx, BodyTube.SLDPRT]
2020-01-20 winter break final update
    [12in Carbon Fiber Rod. 0.456OD.SLDPRT, Assem1.SLDASM, Assembly1.SLDASM, Body tube test.SLDPRT, Combustion Chamber Assembly.SLDASM, Connector test.SLDPRT, Fin Base.SLDPRT, Fin.SLDPRT]
2020-01-24 impinging plates
    [Impinging Plate 1.SLDPRT, Impinging Plate Blank.SLDPRT, Impinging Plate spiraling.SLDPRT, ImpingingPlate Shower Head.SLDPRT]
2020-01-25 SAFC things
    [SAFC_UNH_SEDS_PPR_SpaceVision_2018.xlsx, SAFC_UNH_SEDS_PPR_SpaceVision_2019.xlsx, SAFC_UNH_SEDS_Proposal_SpaceVision_2019.xlsx]
2020-01-28 for hydrostat
    [Hydrostat Clog Plate.SLDPRT, Hydrostat Endcap Female.SLDPRT]
2020-01-28 frame push
    [NO2 Tank Assembly.SLDASM, V4.SLDASM]
2020-01-28 cold fire
    [Injector Plate.SLDPRT, cold flow test mount.SLDPRT]
2020-01-31 update to injector mount
    [Injector Plate.SLDPRT, cold flow test mount.SLDPRT]
2020-02-03 Impinging plate fix
    [Impinging Plate spiraling.SLDPRT, ImpingingPlate_Alex1.SLDPRT]
2020-02-04 shower head
    [ImpingingPlate Shower Head.SLDPRT, ImpingingPlate_Alex1.SLDPRT]
2020-02-04 shower time
    [ImpingingPlate Shower Head.SLDPRT]
2020-02-04 Create Impinging Plate Small Center.SLDPRT
    [Impinging Plate Small Center.SLDPRT]
2020-02-04 Imping mods
    [Impinging Plate Small Center (Chamfer).SLDPRT, Impinging Plate Small Center.SLDPRT]
2020-02-04 Imping Mod
    [Impinging Plate Small Center (Counter Sink).SLDPRT]
2020-02-04 Update ImpingingPlate Shower Head.SLDPRT
    [ImpingingPlate Shower Head.SLDPRT]
2020-02-06 Added parts for the recovery bay. Will combine with main assembly tomrrow at the hackathon, assuming no objections.
    [8896T103_304 SS MCMASTER U-BOLT.SLDPRT, LargeRecoveryPlate.SLDPRT, LargeRecoveryPlateWireHole.SLDPRT, RaptorMockup.SLDPRT, Recovery Interface Plate.SLDPRT, RecoveryPlate.SLDASM, RecoveryTopPlate.SLDPRT, SmallRecoveryPlate.SLDPRT]
2020-02-07 YEET AGAIN
    [PressureSensorAdaptor.SLDDRW]
2020-02-07 frame hackathon start
    [6061 1.8 Full Frame Test.SLDPRT, Nozzle.SLDASM, Part1.SLDPRT, Square Support.SLDPRT, Support Square.SLDDRW, Support Structure.SLDASM, V4.SLDASM, Von Karman Assembly.SLDASM]
2020-02-07 Imping update
    [Impinging Plate Small Center (Counter Sink).SLDPRT, Impinging Plate Small Center.SLDPRT]
2020-02-07 BLANK WORK
    [Impinging Plate Blank.SLDDRW, Impinging Plate Blank.SLDPRT]
2020-02-07 Imping draw
    [Impinging Plate Small Center (Counter Sink).SLDDRW, Impinging Plate Small Center (Counter Sink).SLDPRT]
2020-02-08 revised recovery assembly and added to main assembly. Still needs math on dimensions!
    [LargeRecoveryPlate.SLDPRT, LargeRecoveryPlateWireHole.SLDPRT, Recovery Interface Plate.SLDPRT, RecoveryPlate.SLDASM, RecoveryTopPlate.SLDPRT, V4.SLDASM]
2020-02-08 Changed diameter on holes for recovery interface. Also removed temp files/Small recovery plate (uneeded)
    [LargeRecoveryPlate.SLDPRT, LargeRecoveryPlateWireHole.SLDPRT, Recovery Interface Plate.SLDPRT, RecoveryPlate.SLDASM, SmallRecoveryPlate.SLDPRT, V4.SLDASM]
2020-02-09 model updates
    [6061 1.8 Full Frame Test.SLDPRT, Recovery Interface Plate.SLDPRT, RecoveryPlate.SLDASM, Square Support.SLDPRT, Support Structure.SLDASM, V4.SLDASM, frame bolt hole static test.SLDASM]
2020-02-09 more updates
    [6061 1.8 Full Frame Test.SLDPRT, frame bolt hole static test.SLDASM]
2020-02-09 Added mockups for the parachutes.
    [DrogueChute.SLDPRT, LargeRecoveryPlate.SLDPRT, LargeRecoveryPlateWireHole.SLDPRT, MainChute.SLDPRT, RaptorMockup.SLDPRT, RecoveryPlate.SLDASM, V4.SLDASM]
2020-02-13 Create Frame Clip.SLDPRT
    [Frame Clip.SLDPRT]
2020-02-13 Added drawing for recovery plate, and some static analyses of stresses.
    [Recovery Interface Plate.SLDDRW, Recovery Interface Plate.SLDPRT]
2020-02-17 More work on the recovery bay plate/bolts
    [8896T103_304 SS MCMASTER U-BOLT.SLDPRT, Recovery Interface Plate.SLDPRT]
2020-02-17 One last change to plate
    [Recovery Interface Plate.SLDDRW, Recovery Interface Plate.SLDPRT, RecoveryPlate.SLDASM]
2020-02-17 modeling updates
    [6061 1.8 Full Frame Test.SLDPRT, Aluminum Combustion Chamber.SLDPRT, Injector Plate.SLDPRT, NozzleBase.SLDPRT, RecoveryPlate.SLDASM, Square Injection Plate Support.SLDPRT, Square Nozzle Plate Support.SLDPRT, Square Support.SLDPRT]
2020-02-18 models and drawing updates
    [6061 1.8 Full Frame Test.SLDPRT, Injector Plate.SLDDRW, Nozzle.SLDASM, NozzleBase.SLDDRW, NozzleBase.SLDPRT, RecoveryPlate.SLDASM, Square Injection Plate Support.SLDPRT, Square Nozzle Plate Support.SLDPRT]
2020-02-18 frame 2.17
2020-02-18 FEA models
    [2_56 Pin FEA.SLDPRT]
2020-02-19 Added the U-Bolts to the assembly.
    [8896T103_304 SS MCMASTER U-BOLT.SLDPRT, Recovery Interface Plate.SLDPRT, RecoveryPlate.SLDASM, V4.SLDASM]
2020-02-19 Changed dimension of taper shell, added to v4 assembly.
    [Taper Shell.SLDPRT, V4.SLDASM]
2020-02-20 yeet reilly
    [Impinging Plate 1_16 angle.SLDPRT]
2020-02-21 Frame redo 2212020
    [6-32BoltAssembly.SLDPRT, 6061 1.8 Full Frame Test.SLDPRT, 7.51in Brown Kraft Paper.SLDPRT, 8896T103_304 SS MCMASTER U-BOLT.SLDPRT, Base plate.SLDDRW, Base plate.SLDPRT, RaptorMockup.SLDPRT, Recovery Interface Plate.SLDDRW]
2020-02-21 darrren frame work
2020-02-22 Swagelok Solidworks
    Nathan Gunter
    [SS-600-1-6RT-SwagelokCompany-3D-02-21-2020.stp, SS-600-3-SwagelokCompany-3D-02-21-2020.stp, SS-600-9-SwagelokCompany-3D-02-21-2020.stp, SS-600-A-6ANF-SwagelokCompany-3D-02-21-2020.stp, SS-HBS6-C-SwagelokCompany-3D-02-21-2020.stp, SwagelokAssem.SLDASM, SwagelokElbow.SLDPRT, SwagelokTee.SLDPRT]
2020-02-22 Added rail button, 6_32 bolt
    [91251A157_BLACK-OXIDE ALLOY STEEL SOCKET HEAD SCREW 6_32.SLDPRT, RailButton.SLDPRT]
2020-02-24 Mold Update
    [MoldInsert.SLDPRT]
2020-02-25 Analyses for the rail button, nose cone STLs
    [Von Karman NoseCone Mold pt1.STL, Von Karman NoseCone Mold pt2.STL]
2020-02-26 Modified rail button to fit bolt head, added galvanized U-bolt
    [2936T480_GALV STL MCMASTER 3_8ths U-BOLT.SLDPRT, RailButton.SLDPRT]
2020-02-26 Impinging PLate 1/16 desighns
    [Impinging Plate 1_16 Pattern 1.SLDPRT, Impinging Plate 1_16 Pattern2.SLDPRT]
2020-02-27 yaaa yaaa yaaa YEET yaaa
    bunch of shit
    [0.91 Inch OLED Display Module I2C.SLDPRT, 0.96 Inch OLED Display Module I2C.SLDPRT, 000 Center Rectangle.SLDPRT, 28-PIN ATMEGA328-PU Unit.SLDASM, 50mA Analog Meter.SLDPRT, 555 Timer NE555.SLDPRT, 8-PIN TINY85 Unit.SLDASM, 9-Volt Battery Connector.SLDPRT]
2020-02-27 frame popst meeting
2020-03-01 frame uodate
    [V4.SLDASM]
2020-03-02 Silicon Ring insert
    [Silicon Ring Insert.SLDDRW, SiliconRing.SLDPRT, V4.SLDASM]
2020-03-02 Si Insert drawing
    [Silicon Ring Insert.SLDDRW]
2020-03-04 Added a fin model
    [Fin.SLDPRT]
2020-03-07 Updated recovery plate to .5 inch thickness and larger U-Bolts
    [2936T480_GALV STL MCMASTER 3_8ths U-BOLT.SLDPRT, 8896T103_304 SS MCMASTER U-BOLT.SLDPRT, RaptorMockup.SLDPRT, Recovery Interface Plate.SLDDRW, Recovery Interface Plate.SLDPRT, RecoveryPlate.SLDASM, V4.SLDASM]
2020-03-07 FEA for the recovery plate U-bolt and 6-32 bolts.
    [2936T480_GALV STL MCMASTER 3_8ths U-BOLT.SLDPRT, 91251A157_BLACK-OXIDE ALLOY STEEL SOCKET HEAD SCREW 6_32.SLDPRT, Recovery Interface Plate.SLDPRT]
2020-03-09 rail button model updates
    [.25-20 90 degree nut.SLDPRT, 6061 1.8 Full Frame Test.SLDPRT, Rail.SLDPRT, RailButton.SLDPRT, Support Structure.SLDASM, V4.SLDASM]
2020-03-09 New IMping
    [Impinging Plate 1_0.SLDPRT, Impinging Plate 1_1.SLDPRT, Impinging Plate Blank.SLDPRT, MoldInsert.SLDPRT]
2020-03-09 Ne plate
    [Impinging Plate 1_0.SLDPRT, Impinging Plate 1_1.SLDPRT, Impinging Plate 1_2.SLDPRT]
2020-03-09 Added fin and holder assembly
    [Fin Assembly.SLDASM, Fin.DWG, Fin.SLDPRT, FinHolder.SLDPRT, FinHolderPin.SLDPRT, FinHolderPinHole.SLDPRT, Tapered base mold.STL]
2020-03-09 Added test fin to main assembly
    [Nozzle.SLDASM, V4.SLDASM]
2020-03-09 Rocket Analysis
    [March6Analysis.xlsx, MarchTestData.xlsx]
2020-03-09 Added Fin models
    [Fin Assembly1.SLDASM, Fin attachment bracket.SLDPRT, Fin attachment plate.SLDPRT, Fin plate.SLDPRT]
2020-03-13 more plates
    [Combustion Chamber.SLDPRT, Impinging Plate 32 Shower.SLDPRT, Impinging Plate 64 Shower.SLDPRT, Impinging Plate Blank.SLDDRW, Impinging Plate Blank.SLDPRT]
2020-08-20 Filepath Updates
    [.138 pin for FEA.SLDPRT, .143D rod.SLDPRT, .2 Steel Rod.SLDPRT, .25-20 90 degree nut.SLDPRT, .5 in support rod.SLDPRT, 0.91 Inch OLED Display Module I2C.SLDPRT, 0.96 Inch OLED Display Module I2C.SLDPRT, 000 Center Rectangle.SLDPRT]
2020-09-18 Updating Old Solidworks Files to New Solidworks
    [4-40 Bolt.SLDPRT, 9017K123_LOW-CARBON STEEL 90 DEGREE ANGLE.SLDPRT, Combustion Chamber.SLDPRT, Dowel Pin.SLDPRT, Glass Insert.SLDPRT, Injector Plate.SLDPRT, Nozzle Base.SLDPRT, Payload.SLDASM]
2020-09-25 Moving to 2020-2021 folder and rough modeling swirl injector system
    [Combustion Chamber.SLDPRT, Dowel Pin.SLDPRT, Glass Insert.SLDPRT, Injector Plate.SLDPRT, Nozzle Base.SLDPRT, Runaway V1 Assembly.SLDASM, Runaway V3 Assembly.SLDASM, Swirl Injector Convergance.SLDPRT]
2020-09-30 Swirl Injector
    [Injector Plate.SLDPRT, Runaway V1 Assembly.SLDASM, Swirl Injector Convergance.SLDPRT, Swirl Injector Plate.SLDPRT]
2020-10-05 Update Runaway V1 Assembly.SLDASM
    [Runaway V1 Assembly.SLDASM]
2020-10-08 Banshee V1
    [Banshee V1 Assembly.SLDASM, Combustion Chamber.SLDPRT, Dowel Pin.SLDPRT, Glass Insert.SLDPRT, Injector Plate.SLDPRT, Nozzle Base.SLDPRT, Runaway V1 Assembly.SLDASM, Swirl Injector Convergance.SLDPRT]
2020-10-11 Update Banshee V1 Assembly.SLDASM
    [Banshee V1 Assembly.SLDASM]
2020-10-12 Swirl Injection System
    [Banshee V1 Assembly.SLDASM, Swirl Injector Convergance.SLDPRT, Swirl Injector Plate.SLDPRT]
2020-10-28 Banshee Flow Simulation
    [Banshee V1 Assembly.SLDASM, Injector Port.SLDPRT]
2020-10-29 Banshee V1 w/ Fused Quartz Insert and Fuel
    [Banshee V1 Assembly w Glass Insert.SLDASM, Banshee V1 Assembly.SLDASM, Combustion Chamber w Insert.SLDPRT, Dowel Pin - Copy.SLDPRT, Glass Insert 13 inch.SLDPRT, Graphite Insert Bottom.SLDPRT, Graphite Insert Top.SLDPRT, HTPB Fuel Grain.SLDPRT]
2020-11-03 Chamber updates
    [Banshee V1 Assembly w Glass Insert.SLDASM, Glass Insert 13 inch.SLDPRT, Graphite Insert Bottom.SLDPRT, Graphite Insert Top.SLDPRT]
2020-11-12 Injection System Updates
    [Banshee V1 Assembly w Glass Insert.SLDASM, Banshee V1 Assembly w injectioncylinder.SLDASM, Banshee V1 Assembly.SLDASM, Injector EXP9A Gas Director.SLDPRT, Injector EXP9A with holes for slide hammer mount.SLDPRT, Injector Port.SLDASM, Oxidizer Plate - Copy.SLDPRT]
2020-11-13 Oxidizer Flow Simulations
    [Banshee V1 Assembly w Glass Insert.SLDASM, Banshee V1 Assembly w injectioncylinder.SLDASM, Banshee V1 Assembly w showerhead.SLDASM, Graphite Insert Bottom.SLDPRT, Injector EXP9A with holes for slide hammer mount.SLDPRT, Injector Port.SLDASM, Injector Port.SLDPRT, Nozzle Base.SLDPRT]
2020-11-15 Frame Attempt
    [Alternative Frame Design 1.SLDASM, Bouchon.SLDPRT, Bouteille Nitro Corps.SLDPRT, Circle Nozzle Plate Support.SLDPRT, Combustion Chamber TST1.SLDPRT, Coupler 2.SLDPRT, Coupler.SLDPRT, Embout.SLDPRT]
2020-11-15 Suppressed Files
    [Avionics.SLDPRT, Circle Injection Plate Support.SLDPRT, Nos Tank Plate Support Valve.SLDPRT, nosecone.SLDPRT, tube.SLDPRT]
2020-11-16 Exploded View
    [Alternative Frame Design 1.SLDASM, Circle Nozzle Plate Support.SLDPRT, DrogueChute.SLDPRT, Fin.SLDPRT, Injector Plate.SLDPRT, MainChute.SLDPRT, NO2 Tank Assembly.SLDASM, NO2_Tank GoogleDrive.SLDPRT]
2020-11-21 Grace Alternate Design
    [94435A515_ALUMINUM THREADED ROD.SLDPRT, Alternative Frame Design 1.SLDASM, Avionics.SLDPRT, Banshee V1 Assembly.SLDASM, Circle Injection Plate Support.SLDPRT, Circle Nozzle Plate Support.SLDPRT, Comb Shoulder bottome.SLDPRT, Comb Shoulder top.SLDPRT]
2020-11-22 Added new coupler design
    [Alternative Frame Design 1.SLDASM, Avionics.SLDPRT, Bouchon.SLDPRT, Bouteille Nitro Corps.SLDPRT, Circle Injection Plate Support.SLDPRT, Circle Nozzle Plate Support.SLDPRT, Combustion Chamber TST1.SLDPRT, Cornelis Frame Design.SLDASM]
2020-11-23 Redid frame coupler design, still checking effectiveness
    [91251A157_BLACK-OXIDE ALLOY STEEL SOCKET HEAD SCREW 6_32.SLDPRT, Alternative Frame Design 1.SLDASM, Alternative Frame Design Updated Combustion chamber.SLDASM, Circle Injection Plate Support.SLDPRT, Circle Nozzle Plate Support.SLDPRT, Cornelis Frame Design 1.SLDASM, Cornelis Frame Design.SLDASM, Cornelis_Coupler_V2.SLDPRT]
2020-11-24 added placeholder payload
    [Payload.SLDPRT]
2020-11-24 Finished new coupler design
    [Alternative Frame Design 1.SLDASM, Alternative Frame Design Updated Combustion chamber.SLDASM, Banshee V1 Assembly.SLDASM, Circle Injection Plate Support.SLDPRT, Circle Injection Plate Support_Cornelis.SLDPRT, Circle Nozzle Plate Support.SLDPRT, Circle Nozzle Plate Support_Cornelis.SLDPRT, Cornelis Frame Design 1.SLDASM]
2020-11-24 Alternative Frame Design Refined
    [2936T480_GALV STL MCMASTER 3_8ths U-BOLT.SLDPRT, Avionics.SLDPRT, Circle Recovery Interface Plate.SLDPRT, Gimbal MockUp.SLDPRT, Internal Frame Assembly Comb.SLDASM, Internal Frame Assembly NOS.SLDASM, NOS Split1.SLDPRT, NOS Split2.SLDPRT]
2020-11-24 Revert "Finished new coupler design"
    This reverts commit a7b2bcf52f03682dffc53320e57199f14b449c5c.
    Unfuck grace/my merge
    [Alternative Frame Design 1.SLDASM, Alternative Frame Design Updated Combustion chamber.SLDASM, Banshee V1 Assembly.SLDASM, Circle Injection Plate Support.SLDPRT, Circle Injection Plate Support_Cornelis.SLDPRT, Circle Nozzle Plate Support.SLDPRT, Circle Nozzle Plate Support_Cornelis.SLDPRT, Cornelis Frame Design 1.SLDASM]
2020-11-24 Revert "Redid frame coupler design, still checking effectiveness"
    This reverts commit bca682a15d1be5d211a9640f86429e38745c3809.
    as above
    [91251A157_BLACK-OXIDE ALLOY STEEL SOCKET HEAD SCREW 6_32.SLDPRT, Alternative Frame Design 1.SLDASM, Alternative Frame Design Updated Combustion chamber.SLDASM, Circle Injection Plate Support.SLDPRT, Circle Nozzle Plate Support.SLDPRT, Cornelis Frame Design 1.SLDASM, Cornelis Frame Design.SLDASM, Cornelis_Coupler_V2.SLDPRT]
2020-11-24 Revert "Added new coupler design"
    This reverts commit 3546c552df17cca951d07fd456a30e03a0c089d3.
    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
    [Alternative Frame Design 1.SLDASM, Avionics.SLDPRT, Bouchon.SLDPRT, Bouteille Nitro Corps.SLDPRT, Circle Injection Plate Support.SLDPRT, Circle Nozzle Plate Support.SLDPRT, Combustion Chamber TST1.SLDPRT, Cornelis Frame Design.SLDASM]
2020-11-24 Refined Frame
    [Banshee V1 Assembly.SLDASM, Coupler 2.SLDPRT, Frame Combustion Chamber.SLDASM, Frame NOS.SLDASM, Frame Recovery.SLDASM, Internal Frame Combustion CHamber.SLDPRT, Internal Frame NOS.SLDPRT, Internal Frame Recovery.SLDPRT]
2020-11-24 Redid new frame design, ready for Sunday
    [2936T480_GALV STL MCMASTER 3_8ths U-BOLT.SLDPRT, 91251A157_BLACK-OXIDE ALLOY STEEL SOCKET HEAD SCREW 6_32.SLDPRT, Avionics.SLDPRT, Banshee V1 Assembly.SLDASM, Bouchon.SLDPRT, Bouteille Nitro Corps.SLDPRT, Circle Injection Plate Support.SLDPRT, Circle Injection Plate Support_Cornelis.SLDPRT]
2020-11-25 Revised new coupler assembly
    [Frame_Support_Avionics_2.SLDPRT, Frame_Support_NOS_tank_2.SLDPRT, PVC_shell_NOS_tank_V2.SLDPRT, Payload Window_Cornelis.SLDPRT]
2020-11-29 Modified the new coupler based on Grace's feedback
    [Circle Injection Plate Support_Cornelis_V3.SLDPRT, Cornelis_Coupler_V3.SLDPRT, Frame_Support_Avionics_2.SLDPRT, Frame_Support_Avionics_V3.SLDPRT, Frame_Support_Combustion_Chamber_V3.SLDPRT, Frame_Support_NOS_tank_V3.SLDPRT, Window_tube.SLDPRT]
2020-11-29 Added exploded view to frame V3
    [Banshee V1 Assembly.SLDASM]
2020-12-01 Flow Simulations and Comparisons
    [Banshee V1 Assembly w Glass Insert.SLDASM, Graphite Insert Bottom.SLDPRT, Oxidizer Plate.SLDPRT, Swirl Atomizer.SLDPRT]
2020-12-02 Shortened Coupler (Grace's Design)
    [Banshee V1 Assembly.SLDASM, Coupler 2.SLDPRT, Frame Recovery.SLDASM, No2 Support Assy.SLDASM]
2020-12-02 Added Kangli Folder
    [Avionics.SLDPRT, Bouchon.SLDPRT, Bouteille Nitro Corps.SLDPRT, Circle Injection Plate Support.SLDPRT, Circle Nozzle Plate Support.SLDPRT, Circle Recovery Interface Plate.SLDPRT, Combustion Chamber TST1.SLDPRT, Coupler 2.SLDPRT]
2020-12-03 Oxidizer Injection Simulations
    [Banshee V1 Assembly w Glass Insert.SLDASM, Oxidizer Plate.SLDPRT, Swirl Atomizer.SLDPRT]
2020-12-06 moar heat
2020-12-08 Oxidizer Simulations Complete
    [Banshee V1 Assembly w Glass Insert.SLDASM, Oxidizer Plate.SLDPRT, Swirl Atomizer.SLDPRT]
2020-12-09 Flow stuffs
    [Banshee V1 Assembly w Glass Insert.SLDASM]
2020-12-09 Final Flow Calc
    [Banshee V1 Assembly w Glass Insert.SLDASM, Graphite Insert Bottom.SLDPRT, Injector Port.SLDPRT, Nozzle Base.SLDPRT]
2020-12-11 First Draft of the Final Frame Design (Needs Optimization)
    [2936T480_GALV STL MCMASTER 3_8ths U-BOLT.SLDPRT, 90920A113_ZINC-PLATED STL FLAT HEAD TORX MACHINE SCREW.SLDPRT, 91251A157_BLACK-OXIDE ALLOY STEEL SOCKET HEAD SCREW 6_32.SLDPRT, ARRD.SLDPRT, Active Frame V2 SIM.SLDASM, Active Frame V3 SIM.SLDASM, Avionics.SLDPRT, Banshee V1 Assembly Frame.SLDASM]
2021-01-09 most recent
    [Active Frame V2 SIM.SLDASM, Active Frame V3 SIM.SLDASM, Banshee V1 Assembly Frame.SLDASM, Circle Injection Plate Support V2 SIM.SLDPRT, Circle Nozzle Plate Support V2 SIM.SLDPRT, Circle Nozzle Plate Support V3 SIM.SLDPRT, Circle Recovery Interface Plate V2 SIM.SLDPRT, Comb Frame V2 SIM.SLDASM]
2021-01-13 Update Banshee V1 Assembly w Glass Insert.SLDASM
    [Banshee V1 Assembly w Glass Insert.SLDASM]
2021-01-14 Updating Graphite Inserts
    [Banshee V1 Assembly w Glass Insert.SLDASM, Graphite Insert Bottom.SLDPRT, Graphite Insert Top.SLDPRT]
2021-01-29 Updating screws to 10-32 for a FOS of 3.2
    [10-32 92949A269 18-8 SS BUTTON HEAD HEX DRIVE SCREW.SLDPRT, Banshee V1 Assembly w Glass Insert.SLDASM, Combustion Chamber w Insert.SLDPRT, Injector Port.SLDPRT, Nozzle Base.SLDPRT]
2021-02-02 Creating Drawing for Combustion System
    [Banshee V1 Assembly w Glass Insert.SLDASM, Banshee V1 Assembly w injectioncylinder.SLDASM, Banshee V1 Assembly w showerhead.SLDASM, Combustion Chamber w Insert.SLDDRW, Combustion Chamber w Insert.SLDPRT, Glass Insert 13 inch.SLDPRT, Glass Insert 310 mm.SLDDRW, Glass Insert 310 mm.SLDPRT]
2021-02-04 Initial Drawing PDF
    [Glass Insert 310 mm.SLDDRW, Graphite Insert Bottom.SLDDRW, Graphite Insert Top.SLDDRW, Injector Port.SLDDRW, Oxidizer Plate.SLDDRW, Swirl Atomizer.SLDDRW]
2021-02-08 Frame Reduction and FOS
    Look at SIMULATIONS -> Optimization V2 -> Active Frame V2 -> Active Frame V2 AlumOpt and Avtice Framve V2 AlumOpt2
    [10-32 92949A269 18-8 SS BUTTON HEAD HEX DRIVE SCREW.SLDPRT, 2936T480_GALV STL MCMASTER 3_8ths U-BOLT.SLDPRT, 90920A113_ZINC-PLATED STL FLAT HEAD TORX MACHINE SCREW.SLDPRT, 91251A157_BLACK-OXIDE ALLOY STEEL SOCKET HEAD SCREW 6_32.SLDPRT, 94435A515_ALUMINUM THREADED ROD.SLDPRT, ARRD.SLDPRT, Active Frame V2 SIM.SLDASM, Active Frame V2_AlumOpt.SLDASM]
2021-02-11 Alum Frame Screw Hole Sizes
    [Active Frame V2_AlumOpt2.SLDASM, Banshee V1 Assembly w Glass Insert_FrameAssy.SLDASM, Circle Injection Plate Support V2.SLDPRT, Circle Nozzle Plate Support V2.SLDPRT, Circle Recovery Interface Plate V2.SLDPRT, Comb Frame V2.SLDASM, Internal Frame Comb V2.SLDPRT, Internal Frame NOS V2.SLDPRT]
2021-02-21 Added screws to assembly
    [Banshee V1 Assembly w Glass Insert_FrameAssy.SLDASM, Circle Injection Plate Support V2.SLDPRT, Circle Nozzle Plate Support V2.SLDPRT, Comb Frame V2.SLDASM, Internal Frame Comb V2.SLDPRT, NOS Frame V2.SLDASM, NOS Split2 V2.SLDPRT, No2 Support Assy V2.SLDASM]
2021-02-22 Changing Graphite sizes for machining
    [Banshee V1 Assembly w Glass Insert.SLDASM, Combustion Chamber w Insert.SLDDRW, Glass Insert 310 mm.SLDDRW, Graphite Insert Bottom.SLDDRW, Graphite Insert Bottom.SLDPRT, Graphite Insert Top.SLDDRW, Graphite Insert Top.SLDPRT, Injector Port.SLDDRW]
2021-03-05 3/5 Drawings Update
    [Combustion Chamber w Insert.SLDDRW, Combustion Chamber w Insert.SLDPRT, Injector Plate.SLDDRW, Injector Plate.SLDPRT, Injector Port.SLDDRW, Swirl Atomizer.SLDDRW]
2021-03-16 Gimbal assembly and parts
    [CameraMount.SLDPRT, GimbalMockup.SLDASM, RollMotor.SLDPRT, TiltMotorMount.SLDPRT, TopPlate.SLDPRT]
2021-03-18 Tolerance Update 3/18
    [Banshee V1 Assembly w Glass Insert.SLDASM, Oxidizer Plate.SLDPRT, Swirl Atomizer.SLDPRT]
2021-03-18 Adding Tolerance Class II fit to injector
    [Injector Port.SLDDRW, Oxidizer Plate.SLDDRW, Oxidizer Plate.SLDPRT, Swirl Atomizer.SLDDRW, Swirl Atomizer.SLDPRT]
2021-03-24 Thermal Sim
    Thermal Simulation Files
    [Assem1.SLDASM, NEWSIM_Chamber.SLDPRT, NEWSIM_Fuel.SLDPRT, NEWSIM_GAP.SLDPRT, NEWSIM_Insulator.SLDPRT]
2021-03-28 Updating Assembly w New Insulation
    [Banshee V1 Assembly w Glass Insert.SLDASM, Banshee V1 Assembly.SLDASM, HTPB Fuel Grain.SLDPRT, Oxidizer Plate.SLDPRT, Silica Insulator.SLDPRT, Swirl Atomizer.SLDPRT]
2021-03-29 asdf
    asdf
    [Assem1.SLDASM]
2021-03-29 NEW MARCH
    BAD LARRY
    [Combustion Chamber NEW MARCH.SLDPRT]
2021-03-29 Update
    er
    [Combustion Chamber NEW MARCH.SLDPRT]
2021-03-29 New Combustion Chamber Geometry
    [Banshee V1 Assembly.SLDASM, Combustion Chamber NEW MARCH.SLDPRT, Combustion Chamber.SLDPRT, HTPB Fuel Grain.SLDPRT, Injector Port.SLDPRT, Nozzle Base.SLDPRT, Silica Insulator.SLDPRT]
2021-03-29 Redid nozzle and injector
    [Banshee V1 Assembly w Glass Insert.SLDASM, Banshee V1 Assembly.SLDASM, Combustion Chamber.SLDPRT, Injector Port.SLDPRT, Nozzle Base.SLDPRT]
2021-04-01 700 PSI rated Chamber
    [Combustion Chamber NEW MARCH.SLDPRT]
2021-04-01 Revert "Revert "700 PSI rated Chamber""
    This reverts commit a690d4d72faa396d0ad42c5a72117073b7279554.
2021-04-01 asd
    asd
    [Combustion Chamber NEW MARCH.SLDPRT]
2021-04-01 Updating Prop Drawings
    [Banshee V1 Assembly.SLDASM, Combustion Chamber NEW MARCH.SLDDRW, Combustion Chamber NEW MARCH.SLDPRT, Combustion Chamber w Insert.SLDDRW, Injector Port.SLDDRW, Injector Port.SLDPRT, Throat Insert.SLDPRT, ThroatInsert.SLDDRW]
2021-04-02 sdf
    sdf
    [Banshee V1 Assembly.SLDASM, Combustion Chamber NEW MARCH.SLDPRT]
2021-04-05 New Sim 3
    3
    [Assem2.SLDASM, Assem3.SLDASM, NEWSIM_Chamber.SLDPRT, NEWSIM_Fuel.SLDPRT, NEWSIM_Insulator.SLDPRT]
2021-04-06 big boy
    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
    [Adapter Plate.SLDPRT, Banshee V1 Assembly.SLDASM, HTPB Fuel Grain.SLDPRT, Silica Insulator.SLDPRT, Support Insulator.SLDPRT]
2021-04-06 sdf
    sdfg
    [NEWSIM_Fuel.SLDPRT]
2021-04-17 New Assembly w/ Easily Machinable Combustion Chamber
    [Banshee V1 Assembly Easy Machining.SLDASM, Banshee V1 Assembly.SLDASM, Combustion Chamber Easy Machining.SLDPRT, HTPB Fuel Grain.SLDPRT, Injector Port Easy Machining.SLDPRT, Injector Port.SLDPRT]
2021-04-22 Easily Machineable System Drawings
    [Combustion Chamber Easy Machining.SLDDRW, Combustion Chamber Easy Machining.SLDPRT, Injector Port Easy Machining.SLDDRW, Injector Port Easy Machining.SLDPRT]
2021-05-12 clearing out sterf
    [IgniterMold.SLDPRT, IgniterMold.STL]
2021-06-20 Organizing 1
    [Entry_Form_UNHSEDS.xlsx, USRC_TeleMega_Flight_Data.csv]
2021-06-20 Organizing 2
    [CR_OP_Booster.csv, CR_OP_Sustainer.csv]
2021-06-20 Organizing 3
    [Impinging Plate 1_0.SLDPRT, Impinging Plate 1_1.SLDPRT, Impinging Plate 1_16 Pattern 1.SLDPRT, Impinging Plate 1_16 Pattern2.SLDPRT, Impinging Plate 1_16 angle.SLDPRT, Impinging Plate 1_16&1_32 Pattern 1.SLDPRT, Impinging Plate 1_16&1_32 Pattern2.SLDPRT, Impinging Plate Blank.SLDDRW]
2021-06-20 Organizing 4
    [LAUNCHPADDRAFT1.SLDASM, Part1.SLDPRT, SIDEPANELS.SLDPRT, SIDEPANELS2.SLDPRT, TOPPLATE.SLDPRT, launch rod.SLDPRT, legs.SLDPRT]
2021-06-20 Organizing 5
    [001-20.SLDPRT, 2018-09-29-serial-4225-flight-0018-via-2910.csv, 29mmEngineTube.SLDPRT, Actuator (3D) half.SLDPRT, Actuator (3D) half.STL, Actuator (3D).SLDPRT, Actuator (3D).STL, Actuator Rod (For 3D Printed).SLDPRT]
2021-06-20 Organizing 6
    [001-20.SLDPRT, 116'' frame.SLDPRT, 12'' frame.SLDPRT, 29mmEngineTube.SLDPRT, Actual cold test and cslibration data.xlsx, Actuator (3D) half 1.SLDPRT, Actuator (3D) half 2.SLDPRT, Actuator (3D) half 2.STL]
2021-06-20 Organizing 7
    [.138 pin for FEA.SLDPRT, .143D rod.SLDPRT, .2 Steel Rod.SLDPRT, .25-20 90 degree nut.SLDPRT, .5 in support rod.SLDPRT, 0.91 Inch OLED Display Module I2C.SLDPRT, 0.96 Inch OLED Display Module I2C.SLDPRT, 000 Center Rectangle.SLDPRT]
2021-06-20 Organizing 8
    [.138 pin for FEA.SLDPRT, .143D rod.SLDPRT, .2 Steel Rod.SLDPRT, .25-20 90 degree nut.SLDPRT, .5 in support rod.SLDPRT, 0.91 Inch OLED Display Module I2C.SLDPRT, 0.96 Inch OLED Display Module I2C.SLDPRT, 000 Center Rectangle.SLDPRT]
2021-06-30 Updates 6/30
    [Nozzle.SLDPRT, p16_100mm_in.stp, p16_50mm_in.stp]
2021-06-30 Updating Shop Computer
    [Adapter Plate.SLDPRT, p16_50mm_in.stp]
2021-09-27 Added new folder for the new year, moved all the 2021 stuff over. Started cleaning up frame mess.
    [10-32 92949A269 18-8 SS BUTTON HEAD HEX DRIVE SCREW.SLDPRT, 2936T480_GALV STL MCMASTER 3_8ths U-BOLT.SLDPRT, 4-40 Bolt.SLDPRT, 90920A113_ZINC-PLATED STL FLAT HEAD TORX MACHINE SCREW.SLDPRT, 91099A222_Passivated 18-8 Stainless Steel Phillips Flat Head Screw.SLDPRT, 91251A157_BLACK-OXIDE ALLOY STEEL SOCKET HEAD SCREW 6_32.SLDPRT, 94435A515_ALUMINUM THREADED ROD.SLDPRT, ARRD.SLDPRT]
2021-09-27 Added new year folder, started cleaning up frame
    [Banshee V1 Assembly w Glass Insert_FrameAssy.SLDASM, Comb Frame V2.SLDASM, Internal Frame Comb V2 Reduced.SLDPRT, Internal Frame Comb V2.SLDPRT, Internal Frame NOS V2.SLDDRW, Internal Frame NOS V2.SLDPRT, Internal Frame Sawge V2.SLDPRT, Internal Frame Swage V2.SLDPRT]
2021-09-28 Added frame drawings
    [Coupler_bottom.SLDDRW, Coupler_top.SLDDRW]
2021-10-02 More cleanup, removed a lot of old design study files and STLs. Parts are all there if we need to recreate them.
    [001-20.SLDPRT, 2936T480_GALV STL MCMASTER 3_8ths U-BOLT.SLDPRT, 428501.SLDASM, 428501_01.SLDPRT, 428501_02.SLDPRT, 428501_03.SLDPRT, 90920A113_ZINC-PLATED STL FLAT HEAD TORX MACHINE SCREW.SLDPRT, 91251A157_BLACK-OXIDE ALLOY STEEL SOCKET HEAD SCREW 6_32.SLDPRT]
2021-10-08 Some frame stress sims, a little cleanup
    [2936T480_GALV STL MCMASTER 3_8ths U-BOLT.SLDPRT, 90920A113_ZINC-PLATED STL FLAT HEAD TORX MACHINE SCREW.SLDPRT, 91251A157_BLACK-OXIDE ALLOY STEEL SOCKET HEAD SCREW 6_32.SLDPRT, ARRD.SLDPRT, Active Frame V2 SIM.SLDASM, Active Frame V2_AlumOpt.SLDASM, Active Frame V2_AlumOpt2.SLDASM, Active Frame V3 SIM.SLDASM]
2021-10-10 Redid internal frame in preparation for machining
    [91099A222_Passivated 18-8 Stainless Steel Phillips Flat Head Screw.SLDPRT, Banshee V1 Assembly w Glass Insert_FrameAssy.SLDASM, Comb Frame V2.SLDASM, External Frame Combustion.SLDPRT, External Frame NOS.SLDPRT, External Frame Recovery.SLDPRT, External Frame Valves.SLDPRT, Internal Frame Comb V2.SLDPRT]
2021-10-17 Added more guide parts, updated openrocket engine
    [Banshee V1 Assembly w Glass Insert_FrameAssy.SLDASM, External Frame Valves.SLDPRT, Internal Frame Valves V3.SLDPRT, No2 Support Assy V2.SLDASM, bolt guide tab.SLDPRT, bolt guide tab.STL, tab_1.SLDPRT, tab_1.STL]
2021-10-20 Added recovery plate
    [Recovery base_Same design as last year.SLDPRT]
2021-11-04 Create Circle Recovery Interface Plate V2.SLDPRT
    [Circle Recovery Interface Plate V2.SLDPRT]
2021-11-15 Create Circle Recovery Interface Plate V4_lightweight.SLDPRT
    [Circle Recovery Interface Plate V4_lightweight.SLDPRT]
2021-11-17 Renamed rocket, frame folders
    [10-32 92949A269 18-8 SS BUTTON HEAD HEX DRIVE SCREW.SLDPRT, 2936T480_GALV STL MCMASTER 3_8ths U-BOLT.SLDPRT, 4-40 Bolt.SLDPRT, ARRD.SLDPRT, Adapter Plate.SLDDRW, Adapter Plate.SLDPRT, Assem1.SLDASM, Assem2.SLDASM]
2021-11-17 Cleaned up folder structure, added Alex's spacer
    [.138 pin for FEA.SLDPRT, .143D rod.SLDPRT, .2 Steel Rod.SLDPRT, .25-20 90 degree nut.SLDPRT, .5 in support rod.SLDPRT, 0.91 Inch OLED Display Module I2C.SLDPRT, 0.96 Inch OLED Display Module I2C.SLDPRT, 000 Center Rectangle.SLDPRT]
2021-11-19 Create Circle Recovery Interface Plate V5_ultra_lightweight (1).SLDPRT
    [Circle Recovery Interface Plate V5_ultra_lightweight (1).SLDPRT]
2021-11-19 Revert "merge with remote"
    This reverts commit fca2d8e6741030dc038f4086bfdff9b68113572c.
    [.5 in support rod.SLDPRT, 10-32 92949A269 18-8 SS BUTTON HEAD HEX DRIVE SCREW.SLDPRT, 1935N110_CARBON FIBER SLIP-ON RAIL.SLDPRT, 2 Part Stand-Body Support.SLDPRT, 2 Part Stand-Nozzle Support.SLDPRT, 250calsheet.xlsx, 2936T480_GALV STL MCMASTER 3_8ths U-BOLT.SLDPRT, 3867T550_HIGH-PRESSURE ALUMINUM THREADED PIPE FITTING.SLDPRT]
2021-11-23 Moved a few missing files to this year's frame
    [Banshee V1 Assembly w Glass Insert_FrameAssy.SLDASM, DrogueChute.SLDPRT, MainChute.SLDPRT, NO2 Tank Assembly.SLDASM, NO2_Tank GoogleDrive.SLDPRT, NOS tank cap.SLDPRT, No2 Support Assy V2.SLDASM, SS-600-1-6RT-SwagelokCompany-3D-02-21-2020.stp]
2021-12-12 Redid several couplers to better fit NOS tank
    [Internal Frame Recovery V3.SLDPRT, NOS Support Plate.SLDPRT, Nos Top V2.SLDPRT]
2021-12-12 Modified nose cone to add frame insert
    [Banshee V1 Assembly w Glass Insert_FrameAssy.SLDASM, External Frame Recovery.SLDPRT, nosecone V2.SLDPRT]
2021-12-17 Added fins to rocket assembly
    [Banshee V1 Assembly w Glass Insert_FrameAssy.SLDASM, nosecone V2.STL]
2022-01-13 Added many guides, aluminum nose cone tip, new fin holder design
    [Banshee V1 Assembly w Glass Insert_FrameAssy.SLDASM, Circle Recovery Interface Plate V4_lightweight.SLDPRT, Circle Recovery Interface Plate V4_lightweight.STL, Circle Recovery Interface Plate V5_ultra_lightweight.SLDPRT, Concentric Frame Clamp.SLDPRT, Concentric Frame Clamp_V2.SLDPRT, Concentric Frame Clamp_V2.STL, Concentric Frame Clamp_V3.SLDPRT]
2022-01-13 Parafin Changes
    [Parafin mold-delrin.SLDPRT, Pressure adapter.SLDPRT]
2022-01-31 Design Adjustments
    [Adapter Plate.DXF, NOS Support Plate.SLDDRW, NOS Support Plate.SLDPRT]
2022-02-09 Update Circle Recovery Interface Plate V4_lightweight.SLDPRT
    [Circle Recovery Interface Plate V4_lightweight.SLDPRT]
2022-02-09 New Nozzle
    [Banshee V1 Assembly Easy Machining.SLDASM, Combustion Chamber Nozzle Ext.SLDPRT, New Nozzle.SLDPRT, Nozzle Extension.SLDASM]
2022-02-10 MORE NOZZLE
    [Combustion Chamber Nozzle Ext.SLDPRT, Graphite Ring.SLDPRT, New Nozzle.SLDPRT, Nozzle Extension.SLDASM, Steel Retaining Ring.SLDPRT]
2022-02-24 fixed NOS plate thickness
    [Banshee V1 Assembly w Glass Insert_FrameAssy.SLDASM, Circle Recovery Interface Plate V4_lightweight.STL, NOS Support Plate.SLDPRT]
2022-02-25 Nozzle thermal analysis
    [Circle Recovery Interface Plate V4_lightweight.SLDPRT, Circle Recovery Interface Plate V4_lightweight.STL, Graphite_Ring.SLDPRT, New_Nozzle.SLDPRT, New_Nozzle_Step_Down.SLDPRT, Nozzle_Assm_Thermal_Test.SLDASM, Steel_Retaining_Ring_step_down.SLDPRT, nosecone tip.SLDPRT]
2022-03-29 Spacer, OpenRocket files
    [FinAttachmentRing.SLDPRT, frame spacer.SLDPRT, nosecone V2.SLDPRT, nosecone V2.STL]
2022-04-01 Updated coupler drawings
    [NOS Support Plate.SLDDRW, Nos Top V2.SLDDRW, Nos Top V2.SLDPRT]
2022-04-06 Create Dummy Payload Fixture.SLDPRT
    Payload fixture
    [Dummy Payload Fixture.SLDPRT]
2022-04-06 Redid payload/avionics bays, added many small parts
    [Avionics_BasePlate.SLDPRT, Avionics_BottomWall1.SLDPRT, Avionics_BottomWall2.SLDPRT, Avionics_TopWall1.SLDPRT, Avionics_TopWall2.SLDPRT, Avionics_bay.SLDASM, Banshee V1 Assembly w Glass Insert_FrameAssy.SLDASM, CC_top_mold.SLDPRT]
2022-04-11 Updated prop assembly
    [BANSHEE_V2.SLDASM]
2022-04-11 Added misc parts, dummy new valve
    [Avionics_BasePlate_4_10_2022.SLDPRT, Avionics_BottomWall1_4_10_2022.SLDPRT, Bolt_Holder_Hook.SLDPRT, Dummy Payload Lower Fixture.SLDPRT, NOS_cap_molds.SLDASM, Nos Top Mold.SLDPRT, Valve Fixture.SLDPRT, swirl_holder.SLDPRT]
2022-04-11 Replaced base plate, fixed valve plate
    [Avionics_bay.SLDASM, BANSHEE_V2.SLDASM, New Nozzle_Step Down.SLDPRT, Nozzle base.SLDPRT, SwagelokTube.SLDPRT, Valve Fixture.SLDPRT, fake_nos_cap.SLDPRT]
2022-04-12 added nozzle base drawing
    [Injector Port.SLDDRW, Injector Port.SLDPRT, Nozzle base.SLDDRW]
2022-04-12 Render Changes
    [Avionics_BasePlate_4_10_2022.SLDPRT, Avionics_BottomWall1_4_10_2022.SLDPRT, BANSHEE_V2.SLDASM, Bolt_Holder_Hook.SLDPRT, Injector Port.SLDDRW, NOS_cap_molds.SLDASM, New Nozzle_Step Down.SLDPRT, Nos Top Mold.SLDPRT]
2022-04-12 Small updates to fit CC plates
    [Nozzle base.SLDDRW, Nozzle base.SLDPRT]
2022-04-13 Updated valve plate
    [Avionics_bay.SLDASM, BANSHEE_V2.SLDASM, Bolt_Holder_Hook.SLDPRT, Valve Fixture.SLDPRT]
2022-04-14 Updated nozzle base drawing
    [Nozzle base.SLDDRW]
2022-04-15 Added wide-tolerance nozzle base for 3d printing
    [fake_nozzle_base.SLDPRT]
2022-04-29 quick updates to assembly
    [Avionics_bay.SLDASM, BANSHEE_V2.SLDASM, Bolt_Holder_Hook.SLDPRT, FinAttachmentRing.SLDPRT, Internal Frame Comb V3.SLDPRT, coupler holder.SLDPRT]
2022-05-19 Last bits, OpenRocket update
    [Bolt_Holder_Hook_thin.SLDPRT, Injector_Mod_4-13-22.SLDPRT, Nose cone mount long.SLDPRT, Nose cone mount.SLDPRT, coupler holder long.SLDPRT]
2022-06-16 Reorganized for next year
    [Parafin mold-delrin.SLDPRT, Pressure adapter.SLDPRT]
2022-10-11 New Engine Rough Draft
    [Engine Assebly.SLDASM, Engine Shell.SLDPRT, Impinging plate.SLDPRT, Insulation.SLDPRT, Nozzle Retainer.SLDPRT, Nozzle.SLDPRT]
2022-10-14 Open Rocket start
    [2936T480_GALV STL MCMASTER 3_8ths U-BOLT.SLDPRT, 4-40 Bolt.SLDPRT, Avionics_BasePlate.SLDPRT, Avionics_BottomWall1.SLDPRT, Avionics_BottomWall2.SLDPRT, Avionics_TopWall1.SLDPRT, Avionics_TopWall2.SLDPRT, Avionics_bay.SLDASM]
2022-10-17 Frame Components and Rocket Assembly
    [AvionicsPayload.SLDPRT, EG.IJ.Coupler.SLDPRT, Engine Segment.SLDPRT, Fins.SLDPRT, Injector Segment.SLDPRT, Nosecone tip.SLDPRT, Nosecone.SLDPRT, RocketAssemblyV1.SLDASM]
2022-11-10 updated engine model to use old nozzle
    [92620A413_Zinc Yellow-Chromate Plated Hex Head Screw.SLDPRT, Engine Assebly.SLDASM, Engine Shell.SLDPRT, Impinging plate.SLDPRT, New_Nozzle.SLDPRT, Nozzle Retainer.SLDPRT]
2022-11-16 Frame Assembly
    [Avionics.SLDPRT, NO2 Tank Assembly.SLDASM, NOS tank cap.SLDPRT, NOS tank capV3.STL, RocketAssemblyV1.SLDASM]
2022-11-21 Engine bolt patter
    [9396K124_High-Temperature High-Purity Silicone O-Ring.SLDPRT, Engine Assebly.SLDASM, Engine Shell.SLDPRT, Impinging plate.SLDPRT, Insulation.SLDPRT, Nozzle Retainer.SLDPRT]
2022-11-21 added oxidizer plate compatibility
    [Engine Assebly.SLDASM, Impinging plate.SLDPRT, Oxidizer Plate.SLDPRT]
2022-11-30 engine go brrr
    [Engine Assebly.SLDASM, Engine Shell.SLDPRT, Impinging plate.SLDPRT, Nozzle Retainer.SLDPRT, Swirl Atomizer.SLDPRT]
2022-11-30 engine go brr
    [Engine Assebly.SLDASM, Impinging plate.SLDPRT, Nozzle Retainer.SLDPRT]
2022-11-30 engine go even more brrr
    [Engine Assebly.SLDASM, Impinging plate.SLDPRT, Insulation.SLDPRT]
2022-12-25 Added Avionics schematics
    [Io.csv, Io.kicad_pcb, Io.kicad_sch]
2023-01-18 Updated Frame Rocket Assembly
    V2 of rocket assembly
    [RocketAssemblyV2.SLDASM]
2023-01-24 Avionics MCU switched to STM32
    [Io.kicad_sch]
2023-01-25 Added 5V Regulator to schematic
    [Io.kicad_sch]
2023-01-27 Added STM32 development code and power supply
    [Io.kicad_sch]
2023-01-30 engine update
    [9396K124_High-Temperature High-Purity Silicone O-Ring.SLDPRT, 9396K302_High-Temperature High-Purity Silicone O-Ring.SLDPRT, 9396K92_High-Temperature High-Purity Silicone O-Ring.SLDPRT, Engine Assebly.SLDASM, Engine Shell.SLDPRT, Impinging plate.SLDPRT, New_Nozzle.SLDPRT, Nozzle Retainer.SLDPRT]
2023-02-04 Finished schematic
    [Io.kicad_sch, RFM95W-915S2.step]
2023-02-04 Schematic adjustments
    [Io.kicad_sch]
2023-02-10 full asem 2
    [AvionicsPayload.SLDPRT, CouplerTestPrint.SLDPRT, CouplerTestPrint.STL, CustomNosTank-Assembly.SLDASM, CustomNosTank-BlkhdBottom.SLDPRT, CustomNosTank-BlkhdTop.SLDPRT, CustomNosTank-Tube.SLDPRT, EG.IJ.Coupler.SLDPRT]
2023-02-10 Assem full 3
    [CustomNosTank-BlkhdTop.SLDPRT]
2023-02-10 Final test Assem
    [AvionicsPayload.SLDPRT, CustomNosTank-Assembly.SLDASM, CustomNosTank-BlkhdTop.SLDPRT, Engine Assebly MC_fix.SLDASM, Engine Segment.SLDPRT, Fins.SLDPRT, Injector Segment.SLDPRT, New_Nozzle.SLDPRT]
2023-02-16 Nozzle and engine coupler
    [EG.IJ.Coupler.SLDPRT, Nozzle coupler MC.SLDPRT, RocketAssemblyV2.SLDASM]
2023-02-17 Started PCB design
    [Io.kicad_pcb, Io.kicad_sch]
2023-02-17 added wax to engine model
    [Engine Assebly.SLDASM, Parafin Wax Model.SLDPRT]
2023-02-17 engine rebuild
    [Engine Assebly.SLDASM, Engine Shell.SLDPRT, Nozzle Retainer.SLDPRT]
2023-02-22 fixed bolt pattern
    [Engine Assebly.SLDASM, Engine Shell.SLDPRT]
2023-02-22 Fins and Hole tool
    [Fins.SLDDRW, Fins.SLDPRT, Top hole alignment.SLDPRT]
2023-02-26 Major engine changes
    [Engine Assebly.SLDASM, Engine Shell.SLDPRT, Impinging plate.SLDPRT, Insulation.SLDPRT, Nozzle Retainer.SLDPRT, Parafin Wax Model.SLDPRT]
2023-02-26 more engine changes and forgotten details
    [Engine Assebly.SLDASM, Engine Shell.SLDPRT]
2023-02-28 Intermediate avionics update
    [Io.kicad_sch]
2023-02-28 Lots of stuff
    Assembly update, alignment fixes, folder organization
    [Bottomhole alignment.SLDPRT, Camera Mounting Plate.STL, Electronics Housing.STL, Engine Assebly MC_fix.SLDASM, Engine Segment.SLDPRT, Housing Base.STL, Injector Segment.SLDPRT, Nozzle coupler MC.SLDPRT]
2023-03-01 First PCB draft done. p a i n
    [Io.kicad_pcb]
2023-03-02 Create Fin Spacer.SLDPRT
    Attempt at a fin spacer. Information on fin dimensions is needed to determine proper dimensions for spacer (especially circumference).
    [Fin Spacer.SLDPRT]
2023-03-03 Coupler and material edit
    [AvionicsPayload.SLDPRT, CouplerTestPrint.STL, EG.IJ.Coupler.SLDPRT, Engine Segment.SLDPRT, Fin Slot alignment.SLDPRT, Fin Slot alignment.STL, Injector Segment.SLDPRT, Nosecone.SLDPRT]
2023-03-05 Final engine
    [9396K92_High-Temperature High-Purity Silicone O-Ring.SLDPRT, Engine Assebly.SLDASM, Engine Shell.SLDPRT, Impinging plate.SLDPRT, Nozzle Retainer.SLDPRT, NozzleSimSemi.SLDPRT]
2023-03-05 added pressure tap holes
    [Engine Assebly.SLDASM, Engine Shell.SLDPRT]
2023-03-06 Engine fix
    [Engine Assebly.SLDASM, Nozzle Retainer.SLDPRT]
2023-03-06 Created drawing for tapping specs
    [Engine Shell.SLDDRW, Impinging plate.SLDDRW, Nozzle Retainer.SLDDRW]
2023-03-06 o ring changes
    [Engine Assebly.SLDASM, Impinging plate.SLDPRT, NozzleSimSemi.SLDPRT]
2023-03-07 thread finalization
    [Engine Assebly.SLDASM, Impinging plate.SLDDRW, Impinging plate.SLDPRT]
2023-03-08 drawing finalization
    [Engine Assebly.SLDASM, Impinging plate.SLDDRW, Impinging plate.SLDPRT]
2023-03-10 Fin Holder Push
    Uploaded bracket to be printed four times to hold fins in place during attachment to rocket. Designed by Anthony, refined and updated by me.
    [Fin Holder.SLDPRT]
2023-03-12 Redesigned with 4-layer board
    [Io.kicad_pcb, Io.kicad_sch]
2023-03-12 Alignment tools update
    [Fin Alignment.SLDPRT, Fin Alignment.STL, Fin HolderV1.SLDPRT, Fin Slot alignment.SLDPRT, Fin Slot alignment.STL, Top hole alignment.SLDPRT, Top hole alignment.STL, bottom alignment.SLDPRT]
2023-03-12 Started avbay work
    [AvBayBottomPlate.SLDPRT]
2023-03-12 Assem Update
    [Engine Segment.SLDPRT, RocketAssemblyV2.SLDASM]
2023-03-12 Avbay drafted
    [AvBay.SLDASM, AvBayBottomPlate.SLDPRT, AvBaySled.SLDPRT, AvBayTopPlate.SLDPRT]
2023-03-12 AvBay assembly now 30% less sus
    [AvBay.SLDASM, AvBayTopPlate.SLDPRT]
2023-03-13 assem update2
    [AvionicsPayload.SLDPRT, CustomNosTank-Assembly.SLDASM, CustomNosTank-BlkhdBottom-Vers2.SLDPRT, CustomNosTank-BlkhdTop-Vers3.SLDPRT, CustomNosTank-Tube.SLDPRT, Custom_Nos_Tank_Assy.SLDASM, EG.IJ.Coupler.SLDPRT, Nozzle coupler MC.SLDPRT]
2023-03-13 Fixed AvBay sled
    [AvBay.SLDASM, AvBayBottomPlate.SLDPRT, AvBaySled.SLDPRT, AvBayTopPlate.SLDPRT]
2023-03-14 Updated avbay sled for M3 inserts
    [AvBay.SLDASM, AvBaySled.SLDPRT]
2023-03-14 Added proposed bulkhead
    [SingleBulkhead.SLDPRT]
2023-03-21 thread confirmation
    [Engine Assebly.SLDASM, Impinging plate.SLDDRW, Impinging plate.SLDPRT, Nozzle Retainer.SLDDRW]
2023-03-22 Nosecone and tip changes
    [Nosecone tip.SLDPRT, Nosecone.SLDPRT, RocketAssemblyV2.SLDASM]
2023-03-22 Impinging plate updates for frame
    [Engine Assebly.SLDASM, Impinging plate.SLDPRT]
2023-03-22 Impinging plate drawing change
    [Impinging plate.SLDDRW]
2023-03-23 Nozzle Coupler
    [CustomNosTank-BlkhdBottom-Vers2.SLDPRT, CustomNosTank-BlkhdTop-Vers3.SLDPRT, Custom_Nos_Tank_Assy.SLDASM, Engine Segment.SLDPRT, Nozzle coupler MC.SLDPRT]
2023-03-23 impinging plate
    [Engine Assebly.SLDASM, Impinging plate.SLDDRW, Impinging plate.SLDPRT]
2023-03-23 Prop Folder
    [92620A413_Zinc Yellow-Chromate Plated Hex Head Screw.SLDPRT, 9396K302_High-Temperature High-Purity Silicone O-Ring.SLDPRT, CustomNosTank-Assembly.SLDASM, CustomNosTank-BlkhdBottom-Vers2.SLDPRT, CustomNosTank-BlkhdBottom.SLDPRT, CustomNosTank-BlkhdTop-Vers3.SLDPRT, CustomNosTank-BlkhdTop.SLDPRT, CustomNosTank-Tube.SLDPRT]
2023-03-23 Please don't fuck the git up
    [CustomNosTank-Tube.SLDPRT, EG.IJ.Coupler.SLDPRT, Engine Assebly MC_fix.SLDASM, Engine Shell.SLDPRT, Impinging plate.SLDPRT, Injector Segment.SLDPRT, NozzleSimSemi.SLDPRT]
2023-03-23 Assembly Fixes
    [CustomNosTank-BlkhdBottom-Vers2.SLDPRT, CustomNosTank-BlkhdTop-Vers3.SLDPRT, Custom_Nos_Tank_Assy.SLDASM, Engine Assebly MC_fix.SLDASM, Engine Assembly V2.SLDASM, Engine Shell.SLDPRT, Impinging plate.SLDPRT, Insulation.SLDPRT]
2023-03-23 Why no work
    [CustomNosTank-BlkhdBottom-Vers2.SLDPRT, CustomNosTank-BlkhdTop-Vers3.SLDPRT, CustomNosTank-Tube.SLDPRT, Custom_Nos_Tank_Assy.SLDASM, EG.IJ.Coupler.SLDPRT, Engine Assebly.SLDASM, Engine Assembly V2.SLDASM, Engine Segment.SLDPRT]
2023-03-23 Bolt Pattern Fixes
    [CustomNosTank-BlkhdBottom-Vers2.SLDPRT, CustomNosTank-BlkhdTop-Vers3.SLDPRT, CustomNosTank-Tube.SLDPRT, Custom_Nos_Tank_Assy.SLDASM, EG.IJ.Coupler.SLDPRT, Engine Assembly V2.SLDASM, Engine Segment.SLDPRT, Injector Segment.SLDPRT]
2023-03-23 tap updates
    [Engine Shell.SLDDRW, Impinging plate.SLDDRW, Nozzle Retainer.SLDDRW]
2023-03-23 Nozzle Drawing
    [NozzleSimSemi.SLDDRW, NozzleSimSemi.SLDPRT]
2023-03-24 removed wrong oring and crew models for engine
    [92620A413_Zinc Yellow-Chromate Plated Hex Head Screw.SLDPRT, 9396K302_High-Temperature High-Purity Silicone O-Ring.SLDPRT]
2023-03-24 Fin, Engine coupler, Fin alignment updates
    [Camera Mounting Plate.SLDPRT, EG.IJ.Coupler.SLDPRT, EG.IJ.CouplerhalfCut2.STL, Electronics Housing.SLDPRT, Fin Alignment.SLDPRT, Fin Alignment.STL, Fin Slot alignment.SLDPRT, Fin Slot alignment.STL]
2023-03-24 payload assembly fix
    [AvionicsPayload.SLDPRT, RocketAssemblyV2.SLDASM]
2023-03-24 Finalized PCB design
    [Io-3_3V.gbr, Io-B_Cu.gbr, Io-B_Mask.gbr, Io-B_Paste.gbr, Io-B_Silkscreen.gbr, Io-Edge_Cuts.gbr, Io-F_Cu.gbr, Io-F_Mask.gbr]
2023-03-27 hole Alignment stuff
    [Fin Slot alignment.SLDPRT, Fin Slot alignment.STL, Fin Slot alignmentNew.STL, Top hole alignment.SLDPRT, Top hole alignment.STL]
2023-03-27 final check
    [Impinging plate.SLDDRW]
2023-03-28 payload assem, noz coupler
    [Camera Mounting Plate.SLDPRT, Camera Mounting Plate.STL, Electronics Housing.SLDPRT, Electronics Housing.STL, Engine Segment.SLDPRT, Final_Assembly_Payload.SLDASM, Housing Base.SLDPRT, Housing Base.STL]
2023-03-28 Payload Bay
    [Back Cushion.SLDPRT, Back Rubber Seal.SLDPRT, Back of Case.SLDPRT, Black Rubber Washer.SLDPRT, Button Fastening Washer.SLDPRT, Button Spring.SLDPRT, Button.SLDPRT, Camera Mounting Plate.SLDPRT]
2023-03-28 fin slots and payload
    [AvionicsPayload.SLDPRT, Fin Slot alignment.SLDPRT, Fin Slot alignmentV2.STL, Final_Assembly_Payload.SLDASM, Housing Base.SLDPRT, Housing BaseV2.SLDPRT, Housing BaseV2.STL, Housing BaseV3.STL]
2023-03-28 Bulkhead Update
    [SingleBulkhead.SLDPRT]
2023-03-29 new impinging plate
    [Impinging plate simplified.SLDPRT]
2023-03-30 insulation and nose cone
    [Engine Segment.SLDPRT, EngineCouplerInsulation.SLDPRT, NoseconeBottomHalf.SLDPRT, NoseconeBottomHalf.STL, NoseconeTopHalf.SLDPRT, NoseconeTopHalf.STL, RocketAssemblyV2.SLDASM]
2023-03-30 Recovery plate for raptor system and u-hooks
    solidworks part and .stl files
    [Raptor MountPlate.SLDPRT, Raptor MountPlate.STL]
2023-03-31 Updated single bulkhead design
    [SingleBulkhead.SLDPRT]
2023-03-31 nosecone tip holder
    [Nosecone TipSecurity.SLDPRT, Nosecone TipSecurity.STL, Nosecone.SLDPRT]
2023-04-01 top hole allign
    [Top hole alignment.SLDPRT, Top hole alignment.STL, Top hole alignmentV2.STL, Top hole alignmentV3.STL]
2023-04-01 Updated AvBay
    [AvBayBottomPlate.SLDPRT, AvBayBottomPlate.STL, AvBaySled.SLDPRT, AvBaySled.STL, AvBayTopPlate.SLDPRT, AvBayTopPlate.STL]
2023-04-04 o ring groove tolerance fix
    [Engine Assebly.SLDASM, Impinging plate simplified.SLDDRW, Impinging plate simplified.SLDPRT, Impinging plate.SLDPRT, NozzleSimSemi.SLDDRW, NozzleSimSemi.SLDPRT]
2023-04-05 Coupler stl and fins
    [EG.IJ.Coupler.SLDPRT, EG.IJ.CouplerFinal.STL, EG.IJ.CouplerFinalActual.STL, Fins.SLDPRT, RocketAssemblyV2.SLDASM]
2023-04-05 fin fillet
    [AvBay.SLDASM, Engine Assembly V2.SLDASM, Fin Fillet tool.SLDPRT, RocketAssemblyV2.SLDASM]
2023-04-07 Pipe Fittings
    [Engine Assembly V2.SLDASM, JICEngineTankTubing.SLDPRT, Size8JIC_FemaletoMaleFitting.SLDPRT, Size8JIC_MaletoMaleFitting.SLDPRT]
2023-04-11 Model Changes
    [AvBayBottomPlate.SLDPRT, AvBayTopPlate.SLDPRT, Button Spring.SLDPRT, Final_Assembly_Payload.SLDASM]
2023-04-11 Render Updates
    [EG.IJ.Coupler.SLDPRT, Electronics_HousingV2.SLDPRT, Final_Assembly_Payload.SLDASM]
2023-04-11 old nosecone
    [nosecone V2 Bottom.SLDPRT, nosecone V2 Bottom.STL, nosecone V2 Top.SLDPRT, nosecone V2 Top.STL]
2023-04-11 Changed Impinging plate
    [9396K303_High-Temperature High-Purity Silicone O-Ring.SLDPRT, Engine Assebly.SLDASM, Impinging plate simplified.SLDPRT]
2023-04-14 Updated development files
    [MCU Debug.cfg]
2023-04-15 Updated avionics
    [AvBoardSubstitute.SLDPRT, BatteryModel.SLDPRT]
2023-04-28 Final impinging plate
    [Impinging plate simplified.SLDPRT]
2023-05-03 o ring
    [Impinging plate.SLDDRW, Impinging plate.SLDPRT, NozzleSimSemi.SLDDRW, NozzleSimSemi.SLDPRT]
2023-05-04 finalization check
    [Engine Assebly.SLDASM, Impinging plate simplified.SLDPRT]
2023-07-13 Reorganized files for AY2023-2024
    [.138 pin for FEA.SLDPRT, .143D rod.SLDPRT, .2 Steel Rod.SLDPRT, .25-20 90 degree nut.SLDPRT, .5 in support rod.SLDPRT, 0.91 Inch OLED Display Module I2C.SLDPRT, 0.96 Inch OLED Display Module I2C.SLDPRT, 000 Center Rectangle.SLDPRT]
2023-07-13 Added concept designs
    [Bulkhead.SLDPRT, BulkheadInsulation.SLDPRT, Casing.SLDPRT, EngineAssembly.SLDASM, EngineInternals.SLDASM, ForwardClosure.SLDPRT, FuelGrain.SLDPRT, GrainInsulation.SLDPRT]
2023-07-16 Fixing up nozzle
    [Nozzle.SLDPRT, NozzleAssembly.SLDASM, NozzleCarrier.SLDPRT, RetainingRing.SLDPRT]
2023-07-17 Converted back to safe casing thickness, finalized tentative dimensions, and added part drawings
    [Bulkhead.SLDDRW, Bulkhead.SLDPRT, BulkheadInsulation.SLDDRW, BulkheadInsulation.SLDPRT, Casing.SLDPRT, EngineAssembly.SLDASM, EngineInternals.SLDASM, ForwardClosure.SLDDRW]
2023-07-19 Final commit before review
    [Bulkhead.SLDDRW, BulkheadInsulation.SLDDRW, ForwardClosure.SLDDRW, Nozzle.SLDDRW, NozzleCarrier.SLDDRW, RetainingRing.SLDDRW]
2023-07-20 Tentative final concept revision
    [Bulkhead.SLDDRW, Bulkhead.SLDPRT, BulkheadInsulation.SLDDRW, BulkheadInsulation.SLDPRT, EngineAssembly.SLDASM, EngineInternals.SLDASM, ForwardClosure.SLDDRW, ForwardClosure.SLDPRT]
2023-09-26 Updated Concept designs
    [Bulkhead.SLDDRW, Bulkhead.SLDPRT, BulkheadInsulation.SLDDRW, BulkheadInsulation.SLDPRT, Casing.SLDPRT, EngineAssembly.SLDASM, EngineInternals.SLDASM, ForwardClosure.SLDDRW]
2023-10-10 Updated with new insulation and tapers
    [Bulkhead.SLDDRW, Bulkhead.SLDPRT, Casing.SLDPRT, EngineAssembly.SLDASM, EngineInternals.SLDASM, ForwardClosure.SLDDRW, ForwardClosure.SLDPRT, FuelGrain.SLDPRT]
2023-10-10 Fixed bulkhead dimensions
    [Bulkhead.SLDDRW, Bulkhead.SLDPRT, EngineAssembly.SLDASM, EngineInternals.SLDASM, ForwardClosure.SLDDRW, ForwardClosure.SLDPRT, GrainInsulation.SLDPRT, Nozzle.SLDPRT]
2023-11-05 Updated concept
    [ChambersafeEnd.SLDPRT, ChambersafeFore.SLDPRT, EngineAssembly.SLDASM, EngineInternals.SLDASM, ForwardClosure.SLDDRW, ForwardClosure.SLDPRT, FuelGrain.SLDPRT, GrainInsulation.SLDPRT]
2024-02-09 Added frame folder and rocket assembly
    [Fin.SLDPRT, Fin_Can.SLDPRT, Nose Cone.SLDPRT, RocketAssembly.SLDASM, Tail_Cone.SLDPRT, UpperBodyTube.SLDPRT]
2024-02-14 Updated fins and rocket assembly
    [Fin.SLDPRT, Fin_Can.SLDPRT, RocketAssembly.SLDASM]
2024-02-23 Added new avionics design
    [Io-v2-Board-+3_3V.gbr, Io-v2-Board-B_Cu.gbr, Io-v2-Board-B_Mask.gbr, Io-v2-Board-B_Paste.gbr, Io-v2-Board-B_Silkscreen.gbr, Io-v2-Board-Edge_Cuts.gbr, Io-v2-Board-F_Cu.gbr, Io-v2-Board-F_Mask.gbr]
2024-02-25 Modified tail cone and fin can. Update rocket assembly
    [Fin_Can.SLDPRT, RocketAssembly.SLDASM, Tail_Cone.SLDPRT]
2024-03-27 Updated fin mates on rocket assembly
    [RocketAssembly.SLDASM]
2024-03-27 updated upper frame and assembly
    [RocketAssembly.SLDASM, UpperBodyTube.SLDPRT]
2024-04-01 Updated part drawings and simulations
    [Bulkhead.SLDDRW, Bulkhead.SLDPRT, Casing.SLDDRW, Casing.SLDPRT, FlightSimData.csv, ForwardClosure.SLDDRW, ForwardClosure.SLDPRT, HRAP_SimData_v1.0.csv]
2024-04-02 Updated assembly
    [2936T480_GALV STL MCMASTER 3_8ths U-BOLT (1) (1).SLDPRT, Fin.SLDPRT, RaptorMockup.SLDPRT, RecoveryPlate.SLDPRT, RecoveryPlateAssembly.SLDASM, RocketAssembly.SLDASM, TenderDescenderMount.SLDPRT, UpperBodyTube.SLDPRT]
2024-04-14 Add files via upload
    Av-Bay v1
    [avbay.SLDASM, avbayplate.SLDPRT, avbaysled.SLDPRT]
2024-06-25 Added fin alignment files
    [Fin.SLDPRT, Fin_Alignment_Assembly.SLDASM, Fin_Alignment_Base.SLDPRT, Fin_Alignment_Corrected.SLDPRT, Fin_Alignment_Corrected_Bottom.SLDPRT, Fin_Can.SLDPRT, Nose_Cone_Tip.SLDPRT, Tail_Cone.SLDPRT]
