Maeswoon/UNHSEDS/(notices)

Notices in the files:
Engineering/2022-2023 Rocket/Avionics/Io_Development/Core/Src/main.c:
Copyright (c) 2023 STMicroelectronics.
All rights reserved.
This software is licensed under terms that can be found in the LICENSE file
