Maeswoon/UNHSEDS/Business/Finance/Budgets, Packets and Templates/Packets/PicturesForFinancePacket/20190306_182116380_iOS.jpg

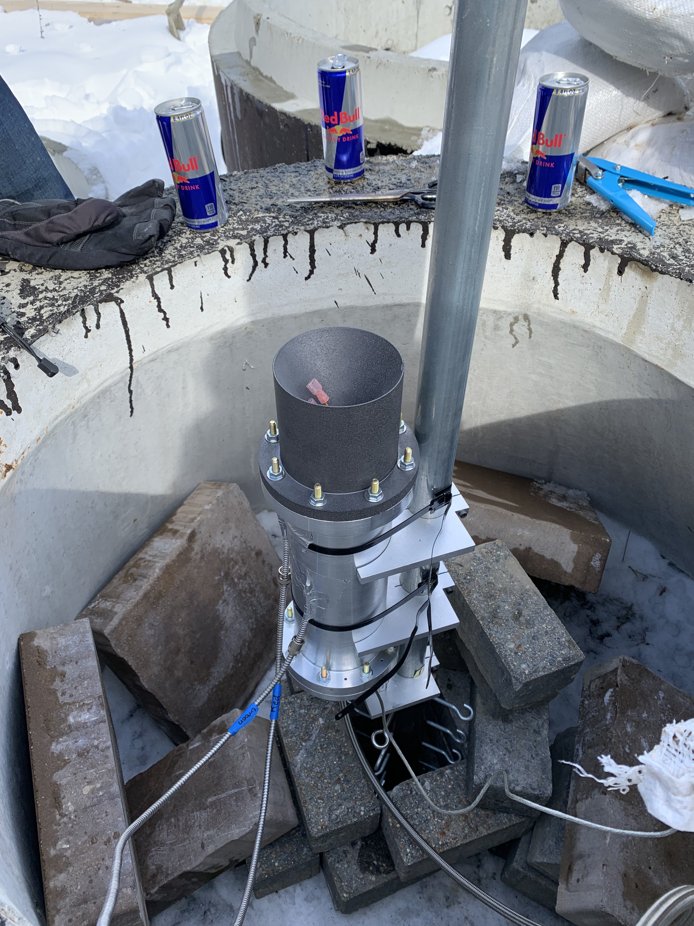
Business/Finance/Budgets, Packets and Templates/Packets/PicturesForFinancePacket/20190306_182116380_iOS.jpg
